oppry12102/WIFI7-TX/06_layout_design_notes/deckfix_备料报告_2026-10-18.md

# deck-fix 备料报告 — 我侧端子锚定同源 bug 修复 + 六判据审计台

**b7e7** · 2026-10-18 12:2x 本地 · 状态：备料完成，候 deck 修复版（备而不发）

## 一、deck bug 第四受害面实锤：我侧提取链端子锚定同源 bug（已修）

**诊断**（diag_terminal_anchor.py，31/31 全查）：
pex_extract.py 旧端子 attach 循环对**所有**端子按固定层序 (M2,M1,M3,M4,M5,TOPM1,TOPM2)
取第一个命中域——npn13G2 的 C/B pin 在 M1、E pin 在 M2，但循环 M2 优先：只要上覆金属
（E 回流条带/馈电塔）几何覆盖 C/B pin 块，C/B 就被抢进上层域 → b=e/c=b=e 粘连。
**实测修复前 15/31 粘连**（mix 8 / drv1 1 / drv2 6）——与 deck 的 31/31 b=e 同机制
（不按端子自身 pin 层归属，按「谁盖住锚点谁收」），属组长信 89 行 §三「同一机制」的第四受害面。

**修法**（已落 pex_extract.py）：端子按 pin 自身层固定挂域
`{C:M1, B:M1, E:M2, P1/P2:M1, TOP:TOPM1, BOT:M5}`，首选层未命中才回落跨层搜索并记 warn。
**修复后 13/31**（mix 8→8? 实为 mix 8、drv1 1、drv2 4→见下）——残留逐管证据
（diag_stuck_v2.py）：**全部落在在案三网异常域，非新伤**：
- mix 8 只：镜像区落 `gnd|nsens|ntaila` 65 域、gm dummy 落 `lond|lopd|nswa|rfon|rfop` 42 域
- drv1 1 只（参考管 $2）：`nref|gnd` 27 域（C=B=nref 二极管接法为意图，E=gnd 被并为伤）
- drv2 4 只：ccas1 五名域（v19 修复实证，裁定②不动）
- 另 3 只 nx=1/6 小管：**顶层板级 0.3µm M1 竖条真压过其 B/C/E 三条 M1 引脚带**
  （例：mix $2@(52,118)，重叠 0.4665/0.072/0.036µm²，桥孔 2×2 @(51.8~52.2,121.1)）
  ——这是**版图几何真连**候选，与 deck「修复后 b==e 仍在 = 版图真短 → 回改流程」的
  验尸判据直接相关：deck 修复重提后若这 3 只 b=e 仍在，即版图回改项（数量少、坐标已定位）。

## 二、六判据审计台建成（pex_cdl_audit.py，重提自检可对表）

判据①②③④⑤⑥全部机检：cdl 层查 ①b≠e ②R 零自环 ③WARNING 清零 ⑥端口序（逐字锚
v015.1）；+pex JSON 查 ③gnd 独立专项 ④被并没网回归（mix 8/drv1 2/drv2 4 名单内置）
⑤nref 溯源（nref 域须带 XBI*/nref 原名——实测 nref 域名单=`[XBI1/nref, gnd]`，改名可溯 ✓）。

**对当前 GDS 的演练结果**（deckfix_rehearsal/ 三件，未动在册）：
- ①：mix 6/15 b≠e（违例 Q5-Q10/Q15=ntaila 域呈现 + Q11/Q12=lond 域呈现）；
  drv1 2/4（Q3/Q4=nref|gnd 域呈现）；drv2 10/12（ccas 域呈现）
- ②：零自环 ✓（三件全过——粘连只在 Q）
- ③：mix 2 条 WARNING（在案）；drv1/drv2 0 条 ✓
- ④：三件全 FAIL=在案三网异常如实呈现（正是 deck 修复要消散的对象）
- ⑤：nref 溯源三件全 ✓
- ⑥：端口序三件全 ✓

## 三、deck 修复版到货后的我侧动作（顺序与耗时）

1. GDS 重提（8510 新 GDS×3 或×2）→ pex_extract 修复版全链复跑（~21s/件）
2. pex_cdl_audit 对表：①违例若仅剩 3 只板级 M1 竖条真压管 → 转版图回改流程；
   三网异常若消散 → ④PASS → 与你侧 LVS×v3 PASS 互为印证，双线闸门同闭
3. cdl 重出升版 + 层次1声明 v1.1 刷表（连裁定四 perim 一并随窗）→ 投 8510

## 五、修复副产物：R P2 端子孤域 = deck 修复版将暴露的新断路点（版图回改候选）

端子层序修复后 diff 三件 cdl：mix Q1-Q4 的 B 端子修回原理图真值名
（na1p/nb1p/nb2n/na2n——对照 `XQ1a nswa na1p e1a` 逐字吻合）、mix R1-R4 P2 修回
ntaila/ntailb ✓；**但 drv1/drv2 各 2 条 R 的 P2 显出无名孤域**（`R1 e1  rsil` 空网名）。
**本节已升全档（13:2x），详见《R_P2_断路根因与普查报告_2026-10-18.md》（同批投 8510）**：

- **根因**：emitpath 的 P2 引脚距公式 `y_p1+1.56` 只对 rppd 档成立；rsil 档 PCell
  实测 1.40 → stub 锚点高 0.16、悬在焊盘顶上方 **0.03µm**。gen 调用序先 chain 后
  mkres，PCell 真值从未回填（emitpath.py L200/L205）。
- **坐标/缝宽**：drv1 ±(14.15, y144.56 stub 底 / 144.53 盘顶)；drv2 ±(24.15, y172.56/172.53)。
- **原理图对照行**：`RRe1 e1 ntail 4` / `RRe2 e2 ntail 4`（drv1 LVS输入_v1）+
  `RRe1 e1 ntail 1.5` / `RRe2 e2 ntail 1.5`（drv2 v3）——P2 应 ntail，版图实际断。
- **普查结果**：三件全部 R 逐只对原理图——缺陷面=emitpath 公式锚定，**唯一受害=
  Re1/Re2 ×2 件共 4 条**；Rin/Rb/RL/mix 全部 R 物理连通（凡 mkres 真值画线的零缺陷）。
  ⚠ 连带发现：drv2 v3 原理图 `RRin1 inp XBI1/nref` / `RRin2 inn XBI2/nref` 两行是
  真短并域化石，v20 修真短后须回改 `inp 0`（v1 原稿正确）。
- **与 E 回流 0.085µm 缝**：同族不同根因（同为 emitpath 对 PCell 几何的预估偏差型
  断路；0.085=via 焊盘 enclose 认知差、**v19 已修**；0.03=P2 引脚距档位错、**未修进 v20**）。
- **DRC 归属**：0.03µm 缝=M1.b（5.16 space/notch 0.18µm）桶内成员，v14/v13 轮
  坐标逐位在案（DRC明细 L307/309/L378/380），已在备案残留。
- **旧 cdl `R1 e1 e1` 自环**=双错相抵：P2 真断 + M2 抢层把 P2 错挂 e1 的 M2 域。

**含义**：deck 幻影焊修复版重提后，LVS 侧也会看到这批 R 断路（如 deck 端子识别同样
修复）——届时「R 自环消散但出现悬空/分网 FAIL」是预期现象，属版图回改项，非修复版
回归。建议与 E 断路（0.085µm）一并进 place_emit_chain/电阻出脚的几何修复单。

## 六、件清单（本侧，未投 8510，候窗）

- `dryrun/pex/pex_extract.py` — 端子锚定修复版（TERM_LAYER）
- `dryrun/pex/pex_cdl_audit.py` — 六判据审计台
- `dryrun/pex/diag_terminal_anchor.py` / `diag_stuck_v2.py` / `diag_intra_bridge.py` — 诊断三件
- `dryrun/pex/deckfix_rehearsal/` — 演练件（cdl×3 + json×3；sha 与在册不同 =
  端子修复可见效应，属重提窗预期；在册 v1.0 三 sha 未动复核：33e9e754/ae4feb76/1f5e0cd8）
- 补充（§五）：drv1/drv2 的 R P2 断路 0.03µm 缝（各 2 条，坐标已定位）——**版图回改候选**，
  与 E 断路同族，候 deck 修复版重提后一并定谳

—— b7e7 · 2026-10-18
