oppry12102/WIFI7-TX/06_layout_design_notes/drv1_pwell接地tap回改纪要_v21_2026-10-19.md

# drv1 偏置支路 pwell 接地 tap 回改 · v2.1 出件纪要

**b7e7** · 2026-10-18 23:3xZ / 本地 07:3x · 响应 **裁定二十七 §三 交办第 ① 项**（组长 #206）
并**顺带结清**同件 §一② 交办的「顶层名随下一版改正」。

---

## 一、交办原文与我的兑现对照

| 组长要求（裁定二十七 §三） | 本件兑现 | 证据 |
|---|---|---|
| 在 **XQo / XQr 所在 pwell 岛内**放 `ptap1` | 两只，各一岛一只 | §三 落点表 |
| 以**金属通路**并入既有 gnd 干线 | M1 垫 → via_stack → M4 立管 → 同层压 gnd 干线 | §四 逐环取证 |
| **禁止**依赖 label 命名代替电学连接 | label 只作命名，接通靠金属；走线形态与 §7 的 E 脚下引**同款** | §四 |
| **禁区** `M1 (-39,121)-(39,136)` 不得落 tap | 两只 tap 距板下沿 **21µm**；且写成硬断言 | §五 断言④ |
| 随件给：**落点坐标** | `XQo (14.0,100.0)` / `XQr (42.0,100.0)` | §三 |
| 随件给：**gnd 接入的 via 链证据** | 三环逐环 bbox 实测 | §四 |
| 随件给：**DRC（M1.b/e、cont 密度）自检** | 间距本机可测项已测；cont 密度/tap 密度须代跑终裁（如实标注） | §六 |
| 随件给：**「每块每岛均有接地 tap」自检断言**（零断言即停线） | 5 条 × 2 岛 = 10 条断言，**已做断链测试证明有牙** | §五 |

§一② 另一条交办：「你的 v2 网表名滞后于你 v19 版图……**请把顶层名随下一版改正**」
⇒ 版图顶层 cell `V20 → V21`，网表 `.subckt/.ends` `V16 → V21`，两处逐字一致（§七）。

---

## 二、根因复述（为什么是「加 tap」而不是「改线」）

组长定谳的三块对照表里，**只有 drv1 的 `40/0 substrate_drw` = 0、`ptap1` 实例 = 0**：

| 块 | `40/0` | `ptap1` | 衬底 |
|---|---|---|---|
| mix v29 | 16 | 有 | 已接地 |
| drv2 v20 | 16 | 有（6） | 已接地 |
| **drv1 v20** | **0** | **0** | **XQo/XQr 岛浮空** |

`pwell_allowed = CHIP.not(pwell_block)` 被 `npn_exclude`（trans_drw / res_drw / salblock_drw…）
切成多岛，**每岛各自需要接地通路**。drv1 的四只 HBT + 九只电阻衬底端子同挂孤立网 `$1`
（E0 实测 8M/8X）。

**为什么 §7 的 E 脚下引救不了它**：§7 把 E 脚（M2）经 via_stack 拉到 M4 gnd 干线，
但那只是**金属**的接通；deck 的接地链是
`pwell ─connect(pwell,ptap)─ ptap=pactiv∩pwell ─cont_drw─ metal1_con─ M1`，
缺了 **ptap 接触**这一环，浮空岛照样浮空。Q2/Q3 所在岛之所以接地，靠的是 npn13G2
**PCell 自带**的 pwell/ptap 图形恰好与该岛连通；drv1 这两只管的岛没有这条路。

---

## 三、落点与选点依据

| 岛 | 器件 | tap 落点 | 到管身 | 到 ntail 禁区板 | 到最近异处 M1 |
|---|---|---|---|---|---|
| XQo | `XBI_XQo` Nx=8，管身 x∈[−7.45,+7.45] | **(14.0, 100.0)** | 出管身 6.55µm | 21.0µm | **16.649µm** |
| XQr | `XBI_XQr` Nx=1，管身 x∈[33.05,34.95] | **(42.0, 100.0)** | 出管身 7.05µm | 21.0µm | **9.553µm** |

选点三原则（逐条对真值核过，非拍脑袋）：

1. **禁区零距离** — y=100 距 ntail 汇集板下沿 121 有 21µm。
   E3 实测 ptap 落 (−39.5,127.6) ⇒ `gnd–ntail` 短路，本件不重蹈。
2. **不落 HBT 排除区、且同属该 pwell 岛** — y∈[86,126] 带内我逐层点过
   （顶层自画 M1/M2/M3/M4/M5 + 全部嵌套实例）：x∈[8,20] 与 x∈[36,48] 两块**全空**，
   且其间无任何 `npn_exclude` 图形。两点都落在两只管**同一片 pwell** 内，
   一只 tap 即足以把该岛接出去；放两只是为了对冲「万一被切成两岛」。
3. **柱下中空层无异网** — 走 `cross()` 的 **M1→M4 单 via_stack**，焊盘只在两端层，
   M2/M3 不留盘。nref 的 M3 立管在 x=0 与 x=34，本件落点 x=14/42 远在两处之外。

---

## 四、gnd 接入的 via 链证据（逐环 bbox 实测，非声明）

deck 的接地链一环不缺：

```
pwell ──[ptap1 PCell: 1/0 Activ + 14/0 pSD + 4×6/0 cont + 40/0 substrate_drw]──
      ──cont_drw↔metal1_con── 8/0 M1 垫 ──via_stack── M4 立管 ──同层相接── M4 gnd 干线
```

本机实测（仿真层逐环 dump）：

| 环 | XQo 岛 | XQr 岛 |
|---|---|---|
| ① M1 接地垫 | `DBox(13.600, 99.600, 14.400, 100.400)` | `DBox(41.600, 99.600, 42.400, 100.400)` |
| ② via_stack 实例 | `DTrans(d=(14,100))` ✓ 在图 | `DTrans(d=(42,100))` ✓ 在图 |
| ③ M4 立管 | `DBox(13.850, 82.000, 14.150, 100.000)` | `DBox(41.850, 82.000, 42.150, 100.000)` |
| ④ 与干线相接 | 干线 `DBox(−56,80,56,84)`，立管 y=82 起 ⇒ **重叠 2µm** | 同左 |
| ⑤ 网名标注 | M4 `labels(8/25)` = `gnd` | 同左 |

> **环① 的形状说明**：本机仿真层不建 `ptap1` PCell（塞假体会污染间距判定），
> 故我在**仅仿真层**补了 0.80µm 见方的 M1 替身，好让自检台第⑳项能验完整条链。
> **真跑不进 GDS** —— 真几何由 ptap1 自带的 `8/0 M1 tie` 承担（那才是 PDK 的正规图形）。
> 代码里以 `_SIM_ONLY_TIE` + `PTAP_SKIPPED` 一行 NOTES 明示，不靠注释暗示。

---

## 五、自检断言「每块每岛均有接地 tap」（交办：零断言即停线）

本机跑不了 deck 的 pwell 连通域分析，所以断言**不落在「连通域」这种跑不动的判据上**，
而落在五条**可证伪的几何事实上**。任一条为假即 `AssertionError` 停线：

| # | 断言 | 判据 |
|---|---|---|
| ① | tap 在「能下引到 gnd 干线、又没进禁区」的区间里 | `−56 ≤ x ≤ 56`（干线跨度） ∧ `GND_Y ≤ y ≤ NT_Y0` |
| ② | tap 处**有 M1 接地垫** | 顶层 M1 形状命中 `(x,y)` |
| ③ | tap 处**有 via_stack 实例** | 实例原点逐位命中 `(x,y)` |
| ④ | tap 处**有 M4 立管**，且立管**真压** gnd 干线 | 两条独立 bbox 命中判定 |
| ⑤ | **禁区内零 tap** | 不落 `M1(−39,121)-(39,136)` |

**有牙验证**（在临时副本上做故意破坏，断言逐条当场抓住）：

| 破坏动作 | 断言反应 |
|---|---|
| `XQr` 的 y 改 100 → **125**（落进禁区） | `AssertionError: TAP-ASSERT ①：XQr 的 tap y=125.0 不在 (GND_Y=82.0, NT_Y0=121.0) 下引区间内` |
| `XQr` 的 x 改 42 → **100**（超出干线跨度） | `AssertionError: TAP-ASSERT ①：XQr 的 tap x=100.0 在 gnd 干线跨度 [-56,56] 之外` |
| 删掉 `b.wire_v(GND_LAYER, …)`（接地链断在第三环） | `AssertionError: TAP-ASSERT ③：XQo 的 tap (14.0,100.0) 处没有 M4 立管金属` |

断言取图助手（`_inst_origins` / `_iter_shapes`）**仿真层与真 KLayout 双通**
（仿真层 `Trans.dx/dy` vs 真 KLayout `DTrans.x/y` 都取）——
写死仿真层 API 会让组长的真 KLayout 代跑当场 `AttributeError` 停线。

---

## 六、DRC 自检：本机能测的与不能测的（如实分开）

**本机已测（全绿）**：

- **M1 间距**：两只 tap 落点处**只有自垫一块 M1**，到最近异处 M1 净距
  **16.649µm / 9.553µm**，对 PDK `M1.b 0.18` / `M1.e 0.22` 与我自设保守 0.63 都有
  **两个数量级余量**。
- **M4 立管**：与既有 E 脚下引同款（W=0.30 竖线），同层无异网；中空层 M2/M3 该处无金属。
- **自检台全 21 项**：`check_layout_gen(gen_M3_drv1_v21.py)` → **ok=true，issues=[]**。
- **网名闭合**：版图 13 / 网表 13，幽灵名 0、漏标 0 —— 加 tap **未新增任何网名**。
- **净距/带金属**：⑮ 两两最小边缘净距 2.80µm；㉒ 余量 +16.17µm；㉓ 异网 6 处中
  疑似 DRC 违规 **0** —— 与 v20 **逐位相同**。

**本机测不了、须代跑终裁的**（与 mix v27 / drv2 v18 同款，本机无 PDK）：

- `cont_drw` **密度**（两只 tap 各 4 个 cont）；
- `psd` **间距**条款（ptap 的 Activ/pSD 对邻图形）；
- ptap1 PDK 默认参数自身的合规性（drv2 v18 代跑已终裁「全绿」，同款参数）。

---

## 七、顶层名对齐（裁定二十七 §一② 交办）

| | 原 | 现 |
|---|---|---|
| 版图顶层 cell | `TX5G_M3_DRV1_V20` | **`TX5G_M3_DRV1_V21`** |
| 网表 `.subckt` / `.ends` | `TX5G_M3_DRV1_V16` | **`TX5G_M3_DRV1_V21`** |

网表 `drv1_subckt_LVS输入_v3.sp` 相对 v2 **正文仅 2 行改动**（`.subckt` / `.ends`），
拓扑与 D1–D4 形态逐字零改动。形态体检：
`lvs_source_audit(audit=v3)` → **ok，issues 0**（R9/Q4）；
`pair(v2,v3)` **拓扑等价断言 PASS**；`check_netlist_dc` → **ok**。

---

## 八、v20 → v21 变更清单（逐位，便于你 gdsdiff 对拍）

| 项 | v20 | v21 |
|---|---|---|
| `ptap1` PCell 实例 | 0 | **+2**（(14,100) / (42,100)；真跑才落） |
| via_stack 实例 | 19 | **21**（+2，M1→M4） |
| M4 矩形 | — | **+2** 立管（0.30 宽） |
| 顶层 M1 标注 | 32 | **34**（+2 个 M4 `gnd`） |
| 顶层 cell 名 | `…_V20` | **`…_V21`** |
| 其余全部几何 | — | **零改动** |

自检台输出逐行对拍：⑮ / ㉒ / ㉓ / 网名闭合 / 引脚极性 / 过孔短路嫌疑
**与 v20 逐位一致**，唯一 delta 就是上表这 5 行。

---

## 九、请你代跑时**先看这一条**（本件唯一的真实未知）

**`ptap1` 的 `8/0 M1 tie` 是否以实例原点为中心。**

我的 via_stack 打在实例原点上，依据是 mix v27 / drv2 v18 的既成用法 ——
两件都把 tap 中心摆在**自己画的 M1 圈中心线**上，注释明写「中心线正落 M1 圈上」，
说明 tie 就在原点。若真 PDK 的 tie 带偏移，代跑会出现「via 底端 M1 档无金属」，
**一眼可见**，改落点即可（§五 断言②③ 就是为这条准备的）。

**LVS 预期**：E0 的 8M/8X 应收敛 —— `Q$1/Q$4`（= XQo/XQr）衬底由 `$1` 变 `gnd`，
九只电阻的衬底端子随之并入 gnd。**若仍出 `gnd$1`，就是 tap 没真正落在浮空岛内**
（而非命名问题），请把 dump 的 MK 层给我，我按岛重选落点。

**另请注意（我方主动提示，非你交办）**：在飞的 27 角提取若用的是 drv1 **v20** 的 GDS，
则**不含**本次 tap 的接地效果；加 tap 会改变衬底网提取结果，
`pex_drv1_v2x.cdl` 需要按新 GDS 重提。这是回改的固有代价，不是回归。

---

## 十、件与 sha

| 件 | sha256 | 说明 |
|---|---|---|
| `gen_M3_drv1_v21.py` | `0b0eb034174a99865077c58597f65366926bab1057d690bb76fc026e0afe6b95` | 1153 行（v20 1015 行） |
| `drv1_subckt_LVS输入_v3.sp` | `44a7615c5928122b836ada3deeff4ddaadf5c4e20f9003e53681baf1e475973d` | 正文仅 2 行改动 |
| `gen_M3_drv1_v20.py` | `7f978a29c4d0ad456df1d149685e7868a55a9fb392b86268e27aa69bc81fb33e` | 旧件，仅作 gdsdiff 基准 |
