oppry12102/WIFI7-TX/06_layout_design_notes/drv2_sch_v4_证据三件套_2026-10-18.md

# drv2 sch v4 随件证据三件套（裁定十六 ③④）· b7e7 · 2026-10-18

**裁定十六执行件**：`drv2_subckt_LVS输入_v4.sp`（486f6558，已随 v20 gen 三件同批投 8510）。
时机说明：裁定十六 ② 说「v20 GDS 到货同批出 v4」——本件与 v20 gen **同批先走**（GDS 待你侧
代跑），LVS 标准输入对「v20 GDS + v4 sch」在 GDS 到货后即成立，不违时机本意。

## ① v1→v3 两行演化对照（证化石非新意图）

| 版本 | RRin1 | RRin2 | 依据 |
|---|---|---|---|
| v1（2026-10-17 午） | `Rin1 inp 0 1k` | `Rin2 inn 0 1k` | 源锚 chain_top_tb_v015_1.sp 行 242-243 逐字（`Rin1 inp 0 1k $ v015[2]`）|
| v2 | `inp 0`（未动） | `inn 0`（未动） | v2 行 27/28 = `RRin1 inp 0` / `RRin2 inn 0` **实存** |
| v3（正式件化） | `inp XBI1/nref` | `inn XBI2/nref` | v3 头 §变更2「版图真值，照 v2 §2 nref 独立网口径」——**把并域呈现当版图真值烙进原理图，即化石点** |
| v4（本件） | `inp 0` | `inn 0` | 回 v1 原稿口径；裁定十六 ② 批准 |

演化链自证：v2 行 27/28 在案（`inp 0`/`inn 0`），v3 才改成 nref——**改动方向是 v1→v3，
不是 v1 原意**；v4 = 恢复 v1。

## ② v3 全量并域化石普查（涉并域名呈现行全列）

v3 全部含 `/` 并域名形态（`XBI<k>/nref`）的器件行 14 行，逐行定性：

| 行 | 内容 | 定性 |
|---|---|---|
| **38** | `RRin1 inp XBI1/nref` | **化石**（Rin.P2 版图真值=gnd 轨，nref 是真短并域呈现；v20 修真短后二网分离）|
| **39** | `RRin2 inn XBI2/nref` | **化石**（同上）|
| 56/59/62/65 | `QXBIk_XQr XBIk/nref XBIk/nref 0 0` | 合法（XQr C=B 二极管接法，原理图网本来就是 nref，与真短无关——真短是它**多连到了 gnd**，修真短不改变原理图）|
| 57/60/63/66 | `QXBIk_XQo ntail XBIk/nref 0 0` | 合法（XQo.B=nref 镜像管本意）|
| 58/61/64/67 | `RXBIk_Rref vcc XBIk/nref` | 合法（Rref.P2=nref 本意）|

**结论：化石恰为 2 行（38/39），与裁定十六预期「仅此两行」一致**；其余 12 行的 nref 是
镜像组原理图本意，不动。全文再无其他并域形态网名（`gnd|xx`、`ntail|xx` 之类 v3 本就没有）。

## ③ 电路意图注记（Rin 端接 = gnd 依据）

`Rin1 inp 0 / Rin2 inn 0`：源锚 `design/chain_top_tb_v015_1.sp` 行 242-243
`Rin1 inp 0 1k  $ v015[2]: 50->1k (M1 实测锚; 隐藏 DC 负载 50mA->2.5mA)`——spec v015[2]
明文输入端接 1k 到 **0**（gnd），1k 即 SOW 的 M1 实测锚链级 +8.1dB 那条；版图侧 gen §8
「inp/inn → gnd」同口径。v4 恢复的正是这条 spec 意图，未引入任何新语义。

## ④ drv1 侧核对声明（裁定十六 ④）

`drv1_subckt_LVS输入_v1.sp` 行 25-26 现值 = `RRin1 inp 0 1000 rhigh l=1.000u w=1.360u` /
`RRin2 inn 0 1000 …`——**v1 已是 inp/inn 0**，声明即毕，无需修。

## ⑤ 附：收敛纲领一处精化建议（v2.0 实操所得）

裁定十六纲领「①一律 pin 真值锚定（**mkpc_at 返回值**，禁公式预估）」——方向完全正确，
但实操发现 **mkpc_at 的 P2 返回值本身就是公式锚点**（resgeom 真值表 §2 拟合式
0.72+0.84·l），它不是焊盘：rsil l=1 时锚点比盘顶高 0.03µm（Re 断路死法）、l=4.2857 时
在盘下方 0.236µm（ntaila 断路死法）。v2.0 的锚定对象是**焊盘真值**
（`resgeom.res_pad2(model,l)`，锚相对系，pex 五点逐位验证）——即纲领①的「真值」落到
焊盘层而非引脚标记层。建议纲领①精化为：「一律**焊盘真值**锚定（resgeom.RES_PAD*，
禁公式预估、禁引脚标记盒）」；M4 设计输入收录时用精化版。盘真值表全文见
`v20回改执行报告_2026-10-18.md` §四。

## ⑥ v20 判读预期对接（裁定十六 + DRC 增列）

- DRC M1.b 桶 **−4**（drv1 ±14.15,144.56 / drv2 ±24.15,172.56 四条 0.03µm 缝随 R P2
  出脚缝合）——对拍时按你侧增列核销 ✓。
- sim 侧预期修复项全收：Rin.P2 网名 nref→gnd 归位、Re P2 接 ntail、真短 8 案断开、
  **另加**：ccas↔nbcas/e 断开（N1/N2）、rfop↔lopd/lond 断开（N3）、Re1a/Re2a.P2 接
  ntaila（N4）——pex 五名域若仍现 = 对应 N 项未生效信号。

—— b7e7 · 2026-10-18
