oppry12102/WIFI7-TX/06_layout_design_notes/drv2_子电路对拍报告_2026-10-17.md

# drv2 子电路网表抽取 · LVS 配套 · 对拍报告 · 2026-10-17

**抽取人**：b7e7 · 对应组长 Q12 闭环信「LVS 配套（候你 drv2 子电路网表抽取）」+ Q11 纪要裁定③（LVS 候办）

## 交付件

| 件 | 说明 |
|---|---|
| `design/sow6/drv2_subckt_LVS输入_v1.sp`（2708B sha d221226f3fd804ec） | `.subckt hbt_mirror` + `.subckt drv2` 两段**逐字拷贝**自 chain_top_tb_v015_1.sp（sha 16 前缀见件头锚注），零改动、零删注 |

## 三层对拍（schematic 抽取件 ↔ gen_M3_drv2_v17.py 的 DEV_NETS/NET_DECL）

**全 PASS**：

1. **器件逐只**：12 HBT（XQ1~4 nx=10 + XBI1~4 展开 XQr nx=1/XQo nx=8）+ 12 R（8 顶层 + 4 Rref rr=1.62k）+ 4 C（Cin1/2 10p + Ct1/2 1.2p）+ 2 L（Lt1/2 0.7n）——两侧一致。
2. **引脚↔网名逐条**：HBT 按 C/B/E、两针按 P1/P2，逐只一致；版图 `gnd` ↔ schematic `0` 映射已计。
3. **网连通性逐网**：NET_DECL 全 15 网（outp/outn/ccas1/ccas2/bin/bb1/e1/e2/ntail/XBIk__nref×4/vcc/nbias/nbcas/inp/inn/gnd）与 schematic 网成员集合逐一相等。

## 边界注记（LVS 跑前须知）

- **独立源 Vb(nbias 0 1.25V) / Vbcas(nbcas 0 2.05V)**：版图不画（理想偏置源非器件），LVS deck 口径应忽略；忽略后 `nbias`/`nbcas` 网两侧成员一致（Rb1/Rb2 P2；XQ3/XQ4 B）。
- **hbt_mirror 参数**：XBI1~4 调用未传参 → 缺省 nx=8 rr=1.62k（与 DEV_NETS 展开口径一致）。
- **vcc 网预查（裁定①口径）**：vcc 网两侧成员一致 = RL1/RL2 P1 + XBI1~4_Rref P1 + Lt1/Lt2 p1 共 8 引脚 + 端口。**无任何 M5 馈电桶（via_stack17）残留引用**——桶本就从未在网表/DEV_NETS 注册（版图自愿冗余非器件），v17 撤除即净，版图侧悬空 0（㉑）与 gdsdiff 唯一 delta=桶消失已证。
- **自检**：抽取件经 check_netlist_dc（借临时 tb `.include` + X1 实例化）DC 拓扑静态自检 **fail=0**。

## 与 fde9 PEX 双门的衔接

CG 锚 `+17.4465 dB` 对应 v015.1 仿真基线 = 本抽取件同源网表跑出（chain_top_tb_v015_1.sp 未因桶撤改动——桶不在网表）。PEX 后双门（A0′≤1e-5 + |CG−17.4465|≤0.05）可比性成立。

—— b7e7 · 2026-10-17
