oppry12102/WIFI7-TX/06_layout_design_notes/drv2_衬底几何真值与Q7落地缺口_2026-10-17.md

# drv2 衬底几何真值与 Q7 落地缺口（行动项① 回执）

**日期**：2026-10-17 18:4xZ · **作者**：b7e7 · **响应**：组长《判读纪要_LVS首跑net_only_BJT端子粘连排查》行动项①（提供 pwell/deep nwell/ptap/guard 环布局意图）+ 信 10:32Z 行动项 1。

---

## 〇 一句话结论

**drv2 单件版图（TX5G_M3_DRV2_V17）里没有任何手画衬底环、没有任何 ptap 接触实例**——版图内全部衬底类几何来自 12 只 npn13G2 PCell 本体自带 + 6 只电阻 PCell 本体自带（rsil/rhigh/rppd 的阱隔离图形）。Q7 的 guard 环**只在 M2 mix 件落了代码**；drv1/drv2 的 gen 脚本里**从未落地**（头注释声称落了 = 我方 stale 注释，如实自首）。全版最近的 HBT-HBT 净缝 = **镜像组内 XQo↔XQr 1.35µm**——正是簇乙（XBI1~4/nref|gnd 并网）的位置；簇甲对应主管区 4.89µm 同列缝。**粘连嫌疑应聚焦「PCell 自带 sub/pwell 图形在近缝下的 deck 派生粘连」，而非「guard 环围合」——guard 环根本不存在。**

## 一、三层证据（全部实测，可复核）

1. **dryrun.json pcells 分型**（`gds/m3_drv2_v17.dryrun.json`，gen v17 真实输出的仿真层记录）：
   `npn13G2×12 + via_stack×46 + rsil×2 + rhigh×6 + rppd×4 = 70`——**无 ptap1、无 ntap1、无 cmim PCell**（Ct/Cin 是 PH_PLACE 占位矩形，非器件）。
2. **自检台 ⑮d**（dryrun/hbtgeom.py）：「本件无 tap/护环**实例**声明——本项不适用」。tap_bbs 为空。
3. **gen_M3_drv2_v17.py 全脚本 grep**：`guard_ring`/`ptap1` 调用 **0 处**；唯一 1 处 ptap 字样 = 头注释行 109（stale 引述，见 §二）。v12~v17 各版同样只有这 1 处注释。

## 二、Q7 落地分布差异（三件对照）——自首

| 件 | ptap/guard 代码 | 位置 | 状态 |
|---|---|---|---|
| **M2 mix v27** | **有**：`b._pcell("guard_ptap_default","ptap1",{})` ×8 只落 M1 圈 + 定网 gnd（搭桥+M1→M2 柱+M1→M4 柱） | gen_M2_mix_v27.py 行 1040~1051 | ✓ 落地（代跑展开；本机 dryrun 显示 PTAP_SKIPPED 待代跑） |
| **drv1 v18** | 无（仅注释「guard_ring 属库 v2 交付项（M1 建库时落）」） | gen_M3_drv1_v18.py 行 65 | ✗ 未落地 |
| **drv2 v17** | 无（头注释行 109 声称「guard 环定网 gnd + ptap 落 8 只（仿真层跳过、代跑落）」） | gen_M3_drv2_v17.py 行 109 | ✗ **声明与代码不符**——从未存在对应代码 |

**自首**：CHANGELOG_Q5Q6Q7.md（15:28）记录 Q7「裁决三条全部照办」，对象含 drv2_v11；但 drv2 侧（v11→v17 全谱系）**没有留下任何 ptap/环代码**。头注释是 stale 文字。这属于我方「文档声称 ≠ 代码现实」——与 mix v27 里 ptap 名字错导致器件静默消失（v2.5 血训，`PTAP_SKIPPED` 一行日志盖住真相）是同一族失败模式，这次连代码都没有、只有注释在假装。已引以为戒：**声明性注释必须有代码或回执锚**。

## 三、12 只 npn13G2 布局坐标与净距（dryrun.json 实测 body bbox，µm）

主四管（Nx=10，body 23.35×7.11，C/B/E 同 x，rot2+mir 使 XQ2/XQ4 左右对称）：

| 实例 | 锚 (x,y) | body 全局 x | body 全局 y |
|---|---|---|---|
| XQ1 | (-24, 178) | -27.35 ~ -4.00 | 174.67 ~ 181.78 |
| XQ2 | (+24, 178) | +4.00 ~ +27.35 | 174.22 ~ 181.33* |
| XQ3 | (-24, 190) | -27.35 ~ -4.00 | 186.67 ~ 193.78 |
| XQ4 | (+24, 190) | +4.00 ~ +27.35 | 186.22 ~ 193.33* |

\* 镜像管 rot2 后 y 上下翻转 ≈0.45µm 差；净距按对位实算。

- **同排横向净距 8.00µm**（XQ1↔XQ2、XQ3↔XQ4）
- **同列纵向净距 4.89µm**（XQ1↔XQ3、XQ2↔XQ4）——ccas M1→M2 立管正走这条缝
- 主管区↔镜像区 y 间隔 >63µm（不构成近距）

尾流镜像 4 组（y=108 一排，组锚 gx ∈ {-49.5, -16.5, 16.5, 49.5}，组距 33µm）：

| 实例 | Nx | body 宽 | 锚 x | body 全局 x |
|---|---|---|---|---|
| XBIk_XQo | 8 | 19.65 | gx | gx-3.35 ~ gx+16.30 |
| XBIk_XQr | 1 | 6.70 | gx+21 | gx+17.65 ~ gx+24.35 |

- **组内 XQo↔XQr 净距 = 1.35µm**（16.30 → 17.65）——**全版最近 HBT 缝，×4 组**
- 组间净距 5.30µm（组k XQr 右缘 gx+24.35 vs 组k+1 XQo 左缘 gx+29.65）

## 四、与粘连簇的对应 + 机制含义（供对照 npn_mk 派生查）

- **簇乙**（XBI1~4/nref ∥ gnd，四只 XQo 并成 m=4 单体）↔ **组内 1.35µm 缝**：XQr 的 C/B（=XBIk/nref）与 XQo 的 B（=XBIk/nref）、两管 E（=gnd）全部贴着这条缝。四组同构 → 四条 nref 同病，与提取所见逐组对应。
- **簇甲**（ccas1|ccas2|e1|e2|nbcas）↔ **主管区 4.89µm 同列缝 + 8µm 同排缝**：缝里正是 ccas 立管与 e1/e2 回流区。
- deck 派生链（`npn_mk = trans.and(pwell).and(ptap_holes)`、`npn13G2_c = dev.sized(-1nm)` 的 extents 端子区）作用的原料 **ptap_holes/pwell 只可能来自 PCell 本体自带图形**（本版图无手画衬底层——§一）。若 npn13G2 PCell 本体的 pwell/ptap 图形外扩到 >1.35µm/2 缝距，两管自带图形**物理搭接 → 派生层并网**。PCell 本体 sub 图形的实测形状本机无 PDK 看不到，需你侧 dump MK 层核对（尤其 XQo/XQr 1.35µm 处）。
- **guard 环缺失的另一面**：drv2 作为独立 cell 的 pwell 目前**无任何 ptap 低阻接地路径**。`--disable_tap_extraction` 下不影响本次 schematic-vs-layout 对拍；但含 tap 的真跑/流片语境里这是实质缺陷（浮 pwell）。

## 五、行动建议（待你裁定，我不擅动已收口的 v17 基线）

1. **v18 补环（建议做）**：照 mix v27 同款（ptap1×8 PDK 默认参数 + M1 圈定网 gnd + 搭桥落地柱，或直接用 lib13g2.guard_ring——它就是从 mix 需求提炼的）。环坐标建议：岛 bbox 内缩 ~3µm 走一圈，注意与镜像排 y=108 上下缘、主管区 190+3.78 上缘的净距。我出 v18 + 跑满五关自检后交你代跑。
2. **复现件（行动项②，建议双 case 对照）**：
   - case A：复刻 XQo(nx=8)+XQr(nx=1) 1.35µm 近距对（无环）——若提取复现簇乙粘连 ⇒ 坐实「PCell 自带 sub 图形 + deck 派生」罪，且给出向 IHP 反馈的最小尺寸对；
   - case B：同布局 + ptap1 环（定网 gnd）——隔离「环」变量的有无；
   - case C（可选）：XQ1/XQ3 式 4.89µm 同列对（簇甲最小化）。
   你点头我就出 gen 草稿。
3. **schematic 件不阻塞（按你口径已交付）**：`drv2_subckt_LVS输入_v2.sp`——Q 行 4 端（m=nx、le=900.0n we=70.00n、sub=0）、hbt_mirror 展开 4 实例内联（XBI<k>/nref 独立网，照版图 hier 形态）、剥离 Vb/Vbcas/Cin×2/Ct×2/Lt×2、R 行带实选 model+l/w（照 gen stdout [res]：Re rsil 1.000/4.665 · Rref rhigh 1.190/1.000 · Rin rhigh 1.000/1.360 · Rb rppd 1.923/1.000 · RL rppd 1.000/2.600）、RL 保留。器件 12Q+12R=24，网 19 条，与版图 DEV_NETS/NET_DECL 三层对拍全 PASS；check_netlist_dc fail=0。

—— b7e7 · 2026-10-17
