oppry12102/WIFI7-TX/06_layout_design_notes/M3_drv级版图设计稿_v1.5_2026-10-17.md

# M3-a/M3-b drv 级版图设计稿 v1.4

**日期**：2026-10-17 · **作者**：b7e7 · **脚本**：`gen_M3_drv1_v16.py`（drv1）+ `gen_M3_drv2_v15.py`（drv2）
**状态**：自检台 **20 项 + 库版本闸 全 PASS**，待组长代跑 GDS + DRC/LVS
**作废**：v1.0 ~ v1.3（v1.3 → v1.4 = Q10 轮的 T 交外延 / Slt 真开槽 / 占位落地）

---

## 0. 一句话

v1.1 只改了一行：`bb1` 的 M5 底段横线原来画到 `ch=24`，而回流竖管在 `x=50` ——
**差 8µm 没接上**，bb1 在版图上断成两截。岛尺寸、发射极回流核算、
器件数、阻值全部未变。

---

## 1. 勘误：bb1 断线

```python
# v1.1
b.wire_h(BIAS_LAYER, y_lo, min(px, ch), max(px, ch))   # y_lo=-2, px=42, ch=24
...
b.wire_v(BIAS_LAYER, 50.0, y_hi, y_lo)                 # 竖管在 x=50
```

几何结果（`inspect.py --shapes=M5` 实测 v1.1）：

```
x[ +24.00, +42.00] y[  -2.15,  -1.85] ['未标注']   ← 死头段（Rb2.P1 → x=24 就断了）
x[ +49.85, +50.15] y[  -2.00, +110.00] ['bb1']     ← 竖管在这一半
```

`bb1` 断成两截：`Rb2.P1 → 一条死头横线` 与 `x=50 竖管 → XQ2.B`。
**LVS 必失配**（一条网拆成两条）。

**为什么 v1.1 的 11 项自检没看见**：

- ⑤b「同名分裂」只数**带标注**的连通分量 —— `'bb1'` 只标了一处（M5 立管上 + B 脚上，
  都在连通的那一半），另一截**无标注**，于是断线隐形；
- ⑤c/⑤d 判的是短路，不管断线；
- ⑦「引脚↔网名」比的是 `DEV_NETS` **声明**，不验版图实际接到哪只脚。

## 2. v1.2 的改法

把该横段的终点改成**真正接得上竖管的那个 x**：

```python
land_x = ch if y_hi is None else 50.0
b.wire_h(BIAS_LAYER, y_lo, min(px, land_x), max(px, land_x))
```

- `bin`（`y_hi is None`）落点仍是 `ch=−24`，一根立管直通 B 脚 —— 行为不变；
- `bb1` 落点改成 `50.0`，与 `wire_v(50.0, y_hi, y_lo)` 的竖管同 x，接上。

复核：v1.2 的 M5 成员全部落在 `bb1` 一个连通分量内（含 x=42 的柱头焊盘）。
bin 路径不受影响（M5 y=4 的横段在 x≤35，bb1 的 y=−2 横段在 x∈[42,50]，两条不交叉）。

## 3. 为什么是新加的第 ⑫ 项抓到的

自检台新增「⑫ 引脚极性（几何取证）」：拿 PCell 真实引脚坐标 + 过孔感知连通分量，
验「网表给这个脚的网名」是否真在这一脚的连通分量上。它对本件报：

```
[FAIL] 引脚极性 Rb2.P1@42.00,8.00：网表该脚是 bb1，版图该脚所在连通分量上是「无标注」
```

即 `Rb2.P1` 那一侧的连通分量上根本没有 `bb1` 这个名字 → 断线。
同一条注入已进 `teeth_v11.py`（注入 8 那条同族的 Rd 接反，以及 drv1 自身的两条）。

## 4. 未变的部分（复核过）

| 项 | v1.1 | v1.2 |
|---|---|---|
| 岛尺寸 | 130.0 × 224.3 µm | **同** |
| 发射极回流核算 | 196.1 mΩ ≤ 250 mΩ | **同**（`emitpath.py` 逐位相同）|
| 器件 / 标注 | 32 / 32 | **同** |
| netname 口径 | `xbi/nref`（NESTED_STYLE=hier） | **同** |
| 占位标注 | 只进 NOTES | **同** |

## 5. 仍未解决（与 v1.1 相同，等回执）

cmim PCell 名/参数（4 只耦合电容占位）、`via_stack` 跨厚金属组合口径、
镜像语义判别、`NESTED_STYLE` 分隔符（`/` vs `.`）、Rsheet 真值。

---

## 附：Q5 修订（2026-10-17，据组长 reply_v12）

> 与上文冲突处以本节为准；理由见 `CHANGELOG_2026-10-17_Q5Q6Q7.md`。

按 cornerRES 三档真值取 typ（rsil 6.02/**7**/7.98 · rppd 234/**260**/286 ·
rhigh 1160/**1360**/1560 Ω/□），并启用自动选型（面积最小、l/w ≥1µm）：

| 器件 | 阻值 | 旧几何(15Ω/□) | 新几何 | 型号 |
|---|---|---|---|---|
| Re1/Re2 | 4Ω(drv1)/1.5Ω(drv2) | l=1 w=3.75 / w=10 | l=1 w=1.75 / w=4.667 | rsil |
| Rin1/Rin2 | 1k | l=66.7 w=1 | l=1 w=1.36 | **rhigh** |
| Rb1/Rb2 | 1k(drv1)/500Ω(drv2) | l=66.7 / l=33.3 w=1 | l=1 w=1.36 / l=1.923 w=1 | rhigh / **rppd** |
| RL1/RL2 | 100Ω | l=6.667 w=1 | l=1 w=2.6 | **rppd** |
| XBI_Rref | 1620Ω | l=108 w=1 | l=1.191 w=1 | rhigh |

**1kΩ 从 66.7µm 长条缩到 1.36µm**。金属方阻改 techlef 真值后，
drv2 发射极回流合计 163.3 → **109.6 mΩ**（200 mΩ 档，余量 1.22×→1.82×）；
drv1 合计 201.1 mΩ（250 mΩ 档）✓。

连带修掉两处几何 bug：
1. **输出轨与 RL 引脚脱钩** —— 100Ω 换型后 P1→P2 间距 6.32→1.56µm，
   老常数 `Y_CP−6.32` 让轨从引脚上方 4.76µm 掠过（LVS 悬空）。
   改法：间距由 `res_auto` 真 l 现算 + `assert` 钉死 P2 落在轨上。
2. **drv2 bin 引线碾过 nbias 的 P2 焊盘** —— Rb 缩到 l=1.92µm 后 P1→P2 只差
   2.34µm，从 P1 竖上去的 M1 引线从 P2 焊盘正上方穿过 → bin/nbias 真短
   （仿真层不画电阻 M1 焊盘，看不见，只有真 DRC 才炸）。
   改法：P1 处先横插到专属竖列（35→31.5、42→38.5）再竖上去落柱。
   并为此新增自检项 ⑬b「穿顶判据」，反向注入验证有牙。

---

## 追加（2026-10-17 07:5xZ）· Slt.c.M1 开槽方案（纪要 §4.2 真几何族最后一条）

**问题**：`Slt.c.M1` = 「M1 无开槽最大宽度 30µm」。drv2 的 ntail 汇流轨是一块
150 × 32.3µm 的 M1 大平面（x∈[−62,88]，y∈[117.7,150]），最窄边 32.3µm > 30µm → 违规。

**口径澄清**：组长纪要把它记成「150µm 宽」。DRC 里 `width` 取 bbox 的**最窄边**，
所以真正超限的是 32.3µm 那一侧。这一点在投信里一并问了（若 deck 实为「任一边 >
30 即违规」，则本方案还须沿 x 再切，请裁定）。

**方案**：**两条 16.15µm 的轨 + 右端 5µm 搭桥**（净槽宽 2.3µm）

| 件 | 形状 | 最窄边 | 判据 |
|---|---|---|---|
| 下轨 | x∈[−62,88], y∈[115.4,131.55] | 16.15 | <30 ✓ |
| 上轨 | x∈[−62,88], y∈[133.85,150] | 16.15 | <30 ✓ |
| 搭桥 | x∈[83,88], y∈[131.55,133.85] | 2.3 | <30 ✓ |

- **EM 一步不减**：2 × 16.15 = 32.3µm = 原 W_NT。ntail 29.28mA @ M1 的 1mA/µm
  ⇒ 仍 0.976 mA/µm（与开槽前同值，未拿 EM 换 DRC）。
- **为什么必须有搭桥**：槽横切一刀，平面断成两片 ⇒ 版图上 ntail 变成两个连通分量，
  LVS 判该网多段（自检台第 ⑤b 项「同名分裂」当场报）。搭桥在**右端 5µm**，
  远离左端的 Rin（x=−46/−39）与右侧的 Rb（x=35/42）的引脚列。
- **对上下行的影响**：镜像组 XQo.C 从下方 y≈109 上来、Re1/Re2.P2 从上方 y=172.56 下来，
  两者原本分别落在平面**下边**与**上边** —— 开槽后这两条接触路径**一字未改**
  （下轨下边仍在 115.4、上轨上边仍在 150）。整体下移 2.3µm 是槽宽的代价。
- **待代跑校准**：槽自身的最小宽/最小间距规则本机查不到（无 PDK）。2.3µm 是按
  「> M1 间距 0.18 且给电流留路」取的；若 deck 另有 `Slt.a`（槽宽下限）要求更大，
  按回执调。

---

## 附录 B（2026-10-17 15:5xZ · 对应 gen_M3_drv1_v15 / gen_M3_drv2_v14）· lib v2.2 与 TopVia1 钉档

依据：组长 b7a0 07:45:29Z 回执 ① 与 `probe_viastack_array_v22_2026-10-17.md`（sha e44d63e2…）。

### B1 库版本闸升 v2.2（canonical = 8510 `design/sow6/lib13g2.py`）
- v2.2 / 539 行 / 27592B / sha `02ecbfb95b3b4cee51a01a0cae1dde90776acff96271de533cce931fb4b8fbe4`。
- 变更**仅** `Board.via` 一处（vt1 透传 + 缓存键含 vt1 档位）；薄金属堆与既有调用逐位不变
  ⇒ 三件除下列钉档外，几何零变化（器件/标注计数 82/66、32/32、71/53 与 v25/v14/v13 相同）。
- 顺带更正一条旧账：我曾据纪要样本坐标反推「via_stack 顶层焊盘 ≈0.98µm < TM1.a 的 1.64 ⇒
  落柱处必有残留 min-width 项」。实测 **TopVia1 1×1 的 TM1 平台 = 1.64 见方**（外扩 0.61/侧），
  恰好等于最小宽、不违规 —— 该疑点**关闭**。

### B2 TopVia1 档位钉 1×1（两件各自的调用点）
- **drv1**：vcc 干路 `VCC_LAYER=TOPM1`，两处 `cross(..., VCC_LAYER)` → `b.via(..., "Metal1",
  "TopMetal1")` 默认 2×2 ⇒ v2.2 下静默变 2×2 阵列；显式钉 1×1（TM1 平台 1.64 / M5 0.62）。
- **drv2**：R-VIA-01 的 vcc 顶层馈电桶 `b.via(TVX, TVY, "Metal5", "TopMetal1", cols=37, rows=1)`。
  意图是 **37 列 TopVia1 阵列**（37 × 1.4mA = 51.8mA ≥ 实际 ~30mA），但 v2.1 及更早把 vt1
  硬编码 1×1 ⇒ **实际只落了一颗 TopVia1**；v2.2 起会继承 cols=37 变 37×1 阵列，而该档
  **无实测平台真值**。本版显式钉 1×1：与 v1.3 已代跑的那份逐位相同。
- **由此摆上台面的口径问题（请组长裁定）**：官方 TopVia1 **4.0Ω/件** ⇒ 桶现在只有 1 颗
  就是 4Ω 串在 vcc 馈电上（~30mA 下约 120mV 压降）。备选（**实测档，不外推**）：
  `vt1_cols=3, vt1_rows=2` = 6 颗并行 ⇒ 0.67Ω，TM1 平台 2.94×2.10 / M5 平台 2.30×1.46。
  本机自检第 ⑲ 项实测：**把 drv2 全部 TopVia1 栈改成 3×2 后，平台-走线间距 FAIL=0**
  （纪要规则值口径），即 3×2 档在我这版图里放得下。要不要改 = 一个数字的裁定。
- 自检台第 ⑲ 项本轮新增：TopVia1 端点平台（实测档）vs 我画的同层金属净距；
  drv1 = 3 处平台 / drv2 = 11 处平台，两件 **FAIL=0**；未实测档位只报「不量」，绝不外推。

---

## 附录 C（v1.4 · Q10 轮 08:0xZ）：T 交外延 · Slt 真开槽 · 占位落地

### C1 drv2 四处 TOPM2 T 交半搭接（官方 TM2.a×8）
病根同 M2：横轨端点 = 竖条中心。改法只外延横轨端点 1.0µm（= TOPM2 半宽），并让
x=56 那根竖条**贯通**到 `y_hi+1.0`（不留「竖条顶停在横轨中心」的半搭接台阶）：

| 网 | 原写法 | 新写法 | 官方逐条坐标 |
|---|---|---|---|
| bin | `wire_h(BIAS_RISER, y_lo, min(jx,riser), max(jx,riser))` | 左端 −1.0（立管在 −36） | `(-36,13.268~14)|(-35,15.732~15)` |
| bb1 下横轨 | `wire_h(..., min(jx,56), max(jx,56))` | 右端 +1.0 | `(56,-2|-2.732)|(55,-1|-0.268)` |
| bb1 上横轨 | `wire_h(..., min(56,riser), max(56,riser))` | 左 −1.0 / 右 +1.0 | `(41.732,183)|(41,182.268)|(40,184)…`、`(55,182.268~183)|(56,184.732~184)` |
| bb1 竖条 | `wire_v(BIAS_RISER, 56.0, y_hi, y_lo)` | 顶 `y_hi+1.0`（贯通） | 同上 |

### C2 ntail 汇流轨的 Slt.c.M1 真开槽（「只进注释没进代码」的翻车现场）
官方：`Max. Metal1 width without requiring a slit = 30.00`，polygon `(−62,117.7)-(88,150)`
（150×32.3，最窄边 32.3 > 30）。v1.3 的文首已写「两条 15.15 轨 + 缝 2.0 + 右端桥」，
**代码却仍是一整块 `b.rect`** —— 组长实测照报。本版代码真开：

```
下轨  y∈[117.70,132.85]   上轨 y∈[134.85,150.00]   缝 2.00   右端桥 x∈[78,88] 宽 10.0
```

- 轨最窄边 15.15 < 30 ✓、桥最窄边 2.0 < 30 ✓、缝 2.0 > M1.b 的 0.18 ✓
- EM 截面 2×15.15 = 30.3 ≥ 29.28mA @1mA/µm ⇒ 0.966 mA/µm，裕 1.03
- 桥宽由 5.0 提到 10.0（5.0 时桥内 2.93 mA/µm 过薄；10.0 时 1.46）
- 断言进代码：`_rail_h ≤ 30` 且 `2·_rail_h ≥ 29.28`，改宽高时会自己炸
- 搭桥放**右端**：左端 x=−62 那侧紧贴器件区，桥压上去会盖到别的金属

### C3 drv1 占位件落地（组长五裁）+ 一处必须他裁的硬阻塞
机制全落地：`land_cmim()`（先量后摆 → `b.mim_cap` 落位 → `Dev.p` 自证 → 不过就**精确摘掉**
那只实例回落）+ `cmim_fits()` 面积/净距闸（核 bbox 内 / 与我画金属净距 ≥3µm / 边长 ≤30µm）；
tank L1 两只改走 `b.keepout()`（(235,5)，库 v2.2 `_KEEPOUT` 备案，非制造）。

**但四只 cmim 一只都落不下**（按官方密度 1.5 fF/µm²）：

| 件 | 网表值 | 见方边长 | 撞上什么 |
|---|---|---|---|
| Cin1/Cin2 | 10p | **81.65µm** | 越出核 bbox（drv1 岛 130×224µm） |
| Ct1 | 0.84p | 23.66µm | 与 vcc 顶层横轨 `TOPM1 [−60,200]~[28,204]` **重叠** |
| Ct2 | 0.84p | 23.66µm | 同上，净距 0.17µm |

且当前占位三行行距只有 14µm（y=176/190/204），23.66 见方连行距都放不下。
⇒ 全部回落为 (235,5) 上的预留区（**对裁定②的同口径外延**：占位是预留标记、不是金属），
尺寸账逐只进 stdout 的 NOTES。**请裁**：改面积规划 / 换电容型号 / 接受 81.65µm 大电容。

### C4 自检台新增两项（⑳ / ⑯b）与三颗牙
- ⑳ 并集相向平行边最小宽：官方 v25 轮逐条坐标校准 —— M2 TOPM1 4 + TOPM2 8 / drv1 0 /
  drv2 TOPM2 8 = 与官方 TM1.a/TM2.a 逐项一致；drv2 本轮 8 → 0。
- ⑯b 无开槽最大宽度（Slt.c.M1）：M2 0 / drv1 0 / drv2 v14 1、v15 0 = 与官方一致。
- teeth 11 → 14 条（新增 ⑳ 的两条 T 交 + 一条 Slt 整块），全部有牙。
- `teeth_label/gen_teeth.py` 的 SRC 改成 glob 取最高版（写死 v13 会让第 ⑭ 项在代跑目录里
  FileNotFoundError，而「teeth 全有牙」照旧报 PASS）。

## 附录 D（v1.5 · Q11 轮 09:0xZ · 对应 gen_M3_drv2_v16）：馈电桶落点与 13×3 阵列

### D1 桶档位：1×1 → **13×3 = 39 颗**（组长 08:26Z 裁定 Q-A）

| 档 | 颗数 | TM1 平台 | M5 平台 | 取舍 |
|---|---|---|---|---|
| 3×2 | 6 | 2.94×2.10 | 2.30×1.46 | **否决**：EM 5mA/件 = 3.6× 超 Jmax；0.67Ω ≫ 60mΩ |
| **13×3** | **39** | **11.34×2.94** | **10.70×2.30** | **本件采用**：最紧凑，装得进上环右段 |
| 19×2 | 38 | 16.38×2.10 | 15.74×1.46 | 16.38 > 上环右段宽 15.2，放不下 |
| 37×1 | 37 | 31.50×1.64 | 30.86×0.62 | 同上；已获官方 deck 零新增实证 |

平台律（组长勘误后）：TM1 `0.84(n−1)+1.26`（单行钳 1.64）、M5 `0.84(n−1)+0.62`、pitch 0.84。
上轮的 `0.84(n−1)+1.64` **作废**（把 1×1 钳值误当截距：37×1 旧律给 31.88、实测 31.50）。

电阻：官方 TopVia1 4.0Ω/件 ⇒ 39 并联 ≈ **0.10Ω**（v1.4 的 1×1 是 4Ω 串在 vcc 馈电，
~30mA 下约 120mV）。EM：39 × 1.4mA = 54.6mA ≥ 实际 ~30mA。
薄金属堆仍走 `vn_*`（`cols=37, rows=1`）—— TopVia1 档位与薄堆档位是两套键，显式分开钉。

### D2 ⚠ 落点：原坐标让整根落柱**两端悬空**（不是「4Ω 太贵」，是 ∞）

    原：TVX = CX + X_C + 10.0 = 34.0,  TVY = Y_VCC_HI − VCC_W = 206
    vcc 上环矩形：x ∈ [−70, 40]，y ∈ [209, 215]

1×1 的 TM1 平台 1.64 见方，中心在 y=206 ⇒ 顶边只到 **206.82**，比环低 **2.18µm**；
M5 侧 y≈206 一带全空。**两端都不落金属 ⇒ 整根 via_stack 是浮岛**，
R-VIA-01 想要的顶层馈电从来就没接过电。旧坐标还正好压在 outp/outn 的 M1 走线上
（x=34 那条 L 形 M1，从发射极臂到 Y_CP=206）。

**官方 DRC 不报**（没有管浮空金属的规则），自检 ⑯⑰⑱⑲⑳ 五族全绿也照样漏，只有 LVS 会炸。
这是自检台第 6 个「恒过的检查」（前三个：⑯b、⑳、㉑）。

### D3 v16 的落点：平移到上环中心线

    新：TVX = CX + X_C + 9.0 = 33.0,  TVY = Y_VCC_HI = 212

13×3 的 TM1 平台 11.34 宽 ⇒ x 27.33~38.67（上环右缘 x=40，余量 1.33µm）、
y 210.53~213.47（环 209~215，内缩）。与 RL1/RL2 接入柱（x 右缘 24.82）横向间距
2.51µm > TM1.b 1.64，过 ⑲（逐轴取严口径）。纯平移，网名与拓扑不动。

### D4 仍开着：M5 端接到哪张网（待组长裁）

M5 平台 10.70×2.30 悬在 y 210.85~213.15。查 drv2 全片：**那一带除上环外没有 M5 金属** ——
drv2 的 vcc 分配全在 TOPM1（Rref.P1→下环 / RL.P1→上环 / TOPM2 立管串上下两环），
M5 那一层是 nref1..4 与偏置网。M5 端该接哪张网是**电路决定**，版图侧猜错就是静默
断路或短路，故 v16 的自检 ㉑ 项如实报 1 条 FAIL，不自欺成全绿。
