oppry12102/WIFI7-TX/06_layout_design_notes/ntaila同域之争_三件套实测与丙案建议_2026-10-19.md

# ntaila / nref 同域之争 · 三件套第一手实测报告（裁定五十五 §四① 的裁决尺）

日期：2026-10-19（b7e7）　触发：裁定五十五 §四①「`XBI1/nref` 与 `ntaila` 同域，怎么收？甲案 / 乙案二择一」
口径：全部数字在**真 GDS** 上现量，工具与日志随件，**不引用官方提取结论、也不引用我方既有结论**。

---

## 一、争议的两把尺，结论相反

| 尺 | 谁 | 读数 |
|---|---|---|
| 官方 KLayout deckfix_v3 提取 | b7a0（真 KLayout 0.30.0 实跑） | v29 ≡ v31；`ntaila` 与 `XBI1/nref` **同一网**（端口名 `XBI1/nref\|ntaila`） |
| 我方端子锚定提取器 | b7e7（`pex_mix_v31.json`） | M1:6 = `XBI1/nref` **单标签** 15.77 µm²；M1:19 = `ntaila` **单标签** 34.81 µm² ⇒ **两域分离** |

同一 GDS（`m2_mix_v31.gds` `ef034d51`）、两种结论 ⇒ 必有一方把某个**非几何接触**的东西当成了连接。

---

## 二、三件套探针（随件，可复现）

| 探针 | 口径 | 作用 |
|---|---|---|
| `probe_m1_dom_b7e7.py` | M1(8/0) 单层，**含器件焊盘**（flatten 后 282 片），标注 8/25 | 单层尺：短接在不在 M1 上 |
| `probe_stack_dom_b7e7.py` | **提取忠实**全栈：同导电组相接才并；via cut 被某层包含才跨层桥；**跨层 XY 重叠不算连接** | 全栈尺：M1 之上有没有桥 |
| `ntaila同域三件套实测_v31_2026-10-19.log` | 两探针 × 三面（v28/v29/v31）全量输出 | 留痕 |

复现（注意：`dryrun/inspect.py` 会遮蔽标准库 `inspect`，numpy 必须先 import）：

```
python3 -c "import numpy,sys; sys.path.insert(0,'design/sow6/dryrun'); \
  import probe_stack_dom_b7e7 as P; P.probe('inbox_replies/m2_mix_v31.gds')"
```

---

## 三、实测结果（三面，真 GDS）

### 3.1 M1 单层尺（含焊盘）

| 面 | GDS sha | M1 多边形 | 连通域 | `ntaila` | `XBI1/nref` | 判定 |
|---|---|---|---|---|---|---|
| v28 | — | 282 | 119 | dom 2 | dom 2 | **同域（短接成立）** |
| v29 | `8f6da23d` | 282 | 119 | dom 2 | dom 2 | **同域（短接成立）** |
| v31 | `ef034d51` | 282 | **121** | dom 3 | dom 9 | **两域分离** |

v31 两域最近边到边间距 = **1.8250 µm**
（`ntaila` 侧 M1 多边形 bbox (−29.250, 31.020)−(−10.750, 31.460)，229 顶点；
　`nref` 侧 M1 多边形 bbox (−32.925, 31.010)−(−31.075, 31.250)，4 顶点）
1.825 µm ≫ M1.b 规则 0.22 µm ⇒ **净距充足，不是「勉强擦边」**。

### 3.2 提取忠实全栈尺

| 面 | 参与多边形 | 导电域 | `ntaila` | `XBI1/nref` | `XBI2/nref` | 判定 |
|---|---|---|---|---|---|---|
| v28 | 1842 | **36** | 域 0 | 域 0 | 域 17 | 同域 |
| v29 | 1842 | **36** | 域 0 | 域 0 | 域 17 | 同域 |
| v31 | 1848 | **43** | 域 0 | **域 7** | 域 17 | **分离** |

v28/v29 的合并域 = 30 片、只跨 `M1` + `M1.pin`（纯 M1 面接触）。
v31 多出 7 个域，正是短接断开后分裂出来的。**M1 之上经 via 也无桥。**

### 3.3 附一条：`XBI1/nref` 与 `XBI2/nref` 在三面上都是**两个独立域**

v31：dom 7 vs dom 17；v28/v29：域 0 vs 域 17。⇒ **版图侧不存在「两个参考网并在一起」的金属短。**

---

## 四、由此得到的四条事实（都可复算）

**事实 1**：裁定四十的修复 `QR_L 8.7→12.0` **在连接层真的生效了**——
v29→v31，`ntaila` 与 `XBI1/nref` 从同一金属域变成两个独立域，M1 净距 1.8250 µm。

**事实 2**：官方提取侧看到的「同网」**不是几何事实**。若官方那一网真是几何合并，
它的多边形集合必须与 `ntaila` 域有相接的两片；而 v31 的 M1 面上不存在这样的两片。

**事实 3（这一条在我侧，且是硬伤）**：**`pex_mix_v31.cdl`（`f6ba9560`）把两个参考网并成了一个节点。**
该件头写「网名策略: 原名·**众数优先**」，体内容器只有**一个** `nref`：

```
Q7  ntaila nref gnd npn13G2 NX=10      ← XBI1 簇
Q8  nref   nref gnd npn13G2 NX=1
R5  nvtop  nref    rhigh
Q9  ntailb nref gnd npn13G2 NX=10      ← XBI2 簇
Q10 nref   nref gnd npn13G2 NX=1
R6  nvtop  nref    rhigh
```

而 `pex_mix_v31.json`（同一提取的**域级原始输出**）里它们是两个独立域：
`net 22 = ['M1',69] ['XBI2/nref'] 19.77 µm²`、`net 25 = ['M1',6] ['XBI1/nref'] 15.77 µm²`。

⇒ **`json`（域级）正确、`cdl`（配名级）错误**：`_resolve_net` 的「众数优先」把
`XBI1/nref` 与 `XBI2/nref` 的共有尾词 `nref` 选成了网名，**两个独立域在 SPICE 层成了同一节点**。

**事实 4**：**我照抄 cdl 的 `mix_subckt_LVS输入_v1b.sp` 继承了这条并网**（v1b 里
`QXBI1_XQr` / `QXBI2_XQr` / `RXBI1_Rref` / `RXBI2_Rref` 全挂同一个 `nref`），
**这是我的网表缺陷，不是版图缺陷。** v1 / v2 / v3 未中此条（它们的 XBI1 簇用 `ntaila`）。

---

## 五、结论与建议（答 裁定五十五 §四①）

**甲案 / 乙案二择一的前提不成立** —— 版图已经把它们分开了（事实 1）。
所以我给的是**丙案**，并说明为什么它优于甲、乙：

- **甲案（改版图再拆一次）**：**不必要**。v31 的几何已分离（1.8250 µm），
  再动版图会把一个已解决的问题变成新的几何风险（且要重出 v32 面 + cdl + 网表，F14 重登记）。
- **乙案（改网表承认 `nref ≡ ntaila` 同网）**：**不可取**。它会把**我方命名缺陷**
  （事实 3/4）追认成设计意图，等于在台账上把两个不同参考网焊死；
  且官方那一网到底怎么并的仍未定位（事实 2），追认等于把一个**未定位的异常**写成结论。
- **丙案（我推荐）**：**先修 `_resolve_net` 的配名策略，再重生成 cdl 与网表，版图不动。**
  代价＝改一处命名规则 + 重生成 `pex_mix_v31.cdl` + 重出 `mix_subckt_LVS输入_v1c.sp`；
  好处＝版图零风险、F14 登记干净、并且顺手把 fde9 在 note227b §二 提的
  「A 版图短路 / B 命名并网」判别一次结清（**按本报告：读法 B 成立**）。

**同时向官方侧要一件东西（这是把事实 2 落地成结论的唯一路径）**：
请给出官方提取出的那一网（`XBI1/nref|ntaila`）的**多边形清单**
——哪几片、哪一层（layer/datatype）、世界坐标 bbox。
我这边两把尺已能定位到 ±0.001 µm，拿到清单即可逐片判定：
若清单里有一片真与 `ntaila` 域相接 ⇒ 官方对，我改我的尺（并交代我的盲区）；
若清单里没有 ⇒ 并网是提取/配置口径产物，请给那一条 `connect()` 的出处，我配合改正。

---

## 六、本报告的已知盲区（如实登记）

1. **我的尺不含 PCell 内部语义**：我把 HBT / via_stack 的 M1 pin（datatype 2）
   当作 M1 本体的一部分。若官方 npn 提取器对 C/B 焊盘另有并网规则（例如
   同一器件的 C、B 在某层被 tie），我的尺量不到。这正是「官方对、我错」的唯一可能路径。
2. **我的尺不含 keepout / 禁区层**（如 `235/5`），也不含 MIM 板；
   若某非导电层在官方 deck 里被误当连接，也会造成我量到分离、官方量到并网。
3. `probe_stack_dom_b7e7.py` 的 via 桥接判据是「via cut 被某层多边形**包含**」；
   若官方 deck 用的是「焊盘相接」而非「cut 包含」，边界情形可能差一片。
   —— 上述三条都指向同一个动作：**拿官方那一网的形状清单来对，而不是各自坚持尺子。**

---

## 七、入册建议

- **法 B 成立**：`XBI1/nref` 与 `XBI2/nref` 在 GDS 里是两个独立域，
  cdl 里的同节点是 `_resolve_net` 配名所致（首例：`pex_mix_v31.cdl` `f6ba9560`）。
- **待销的账**：`mix_subckt_LVS输入_v1b.sp`（`c7e107b5`）继承了那处并网，
  已由本口 `mix_subckt_LVS输入_v1c.sp`（`e3cb4a32`）修正。
