oppry12102/WIFI7-TX/06_layout_design_notes/R_P2_断路根因与普查报告_2026-10-18.md

# R P2 断路根因与普查报告 — 回应 b7a0 L92 四项请办

**b7e7** · 2026-10-18 13:1x 本地 · 状态：技术定谳，候 deck 修复版重提

---

## 一、根因定位（L92 ①）

**1.1 机制：emitpath 的 P2 引脚距公式与 rsil PCell 真值不符**

- **emitpath 公式**：`y_p2 = y_p1 + 1.56`（resgeom 真值表拟合 0.72+0.84·l，l=1µm）
- **PCell 实测真值**（GDS 逐位）：**rppd 档 P1P2 中心距=1.56**（焊盘 y[−0.430,−0.130]/[1.130,1.430]
  → 中心差 1.56，公式对该档成立）；**rsil 档（w=1.75/4.665）P1P2 中心距=1.40**
  （焊盘 y[−0.330,−0.070]/[1.070,1.330] → 中心差 1.40）——**引脚距随 model/w 档变化，公式只对 rppd 成立**
- **后果**：emitpath 的 P2 stub 从公式点 y_p1+1.56 起画，rsil 真值 P2 焊盘顶在 y_p1+1.53
  → stub 底悬在焊盘顶**上方 0.03µm**（0.16 偏差 − 0.13 半盘高），全同层无 via 跨接 → 直流断路

**1.2 根因代码段**（emitpath.py L200/L205 + gen 调用顺序）：
```python
y_p2 = y_p1 + 1.56                       # 公式预估 P2 pin 中心（仅 rppd 档成立）
b.wire_v("M1", x_col, y_p2, y_p2 + 1.3)  # stub 从公式点向上画
```
gen 里 `place_emit_chain(...)`（画 stub）在 `mkres("Re1",...)`（放 PCell）**之前**调用——
画线时 Re 实例尚不存在，只能用公式预估；mkres 返回的 `Re1.p["P2"]` 真值从未回填校正。
**修法（v20）**：调换调用顺序（先 mkres 后 place_emit_chain，把 `p2_y=Re.p["P2"][1]` 真值传入），
stub 从 pin 真值中心起画；或 place_emit_chain 增加 p2_y 必填参数、断言 |公式−真值|<0.005。

**1.3 与 E 回流 0.085µm 缝：同族不同根因**
- 同族：均为 emitpath 对 PCell 内部几何的**预估偏差型断路**（数字不同）
- 不同根因：0.085µm = via PCell M2 焊盘 enclose 认知差（外沿+0.005/边 vs 外接+0.09/边），
  **v19 已修**（lap=0.6 臂-桶重叠，gen v19 CHANGELOG 在案）；0.03µm = P2 引脚距公式档位错，
  **未修，进 v20 修复单**

**1.4 为什么只有 Re 中招（普查互证）**：mix R1-R4 P2 全连通——**mix gen 不走 emitpath**
（自己从 pin 真值画线）；drv1/drv2 的 Rin/Rb/RL 也连通——它们的 stub 方向朝 P1/焊盘内部
（gen §8 `stub(..., -3.0)` 向下、与焊盘重叠）或由主脚本从 pin 真值画。**唯一受影响面 =
走 emitpath 且 stub 向上离开焊盘的 Re1/Re2 ×2 件 = 4 条**。

---

## 二、同族普查（L92 ②）

**2.1 三件 R P2 连通性对比**

| 件 | R 类型 | 原理图 P2 | cdl P2 | 状态 | 备注 |
|---|---|---|---|---|---|
| **drv1 v19** | Re1/Re2 (rsil) | ntail | 空 | **断路** | P2 缝 0.03µm，×2 只 |
| | Rin1/Rin2 (rhigh) | 0(gnd) | nref | **物理连通** | cdl 名 nref = nref\|gnd 并域呈现（真短案 4 桥接），v20 修真短后归位 gnd |
| **drv2 v19** | Re1/Re2 (rsil) | ntail | 空 | **断路** | P2 缝 0.03µm，×2 只 |
| | Rin1/Rin2 (rhigh) | XBI1\|2/nref | nref | **物理连通** | P2 真值接 gnd 轨（gen §7 cross+M4），cdl 名=并域呈现——**⚠ v3 原理图 `inp XBI1/nref` 把并域名烙进了原理图**，v20 修真短后 nref‖gnd 分离，v3 此两行须回改 `inp 0`（v1 原稿是对的） |
| | Rb1/Rb2 (rppd) | nbias | nbias | **连通** | P2 用 mkres 真值+cross ✓ |
| **mix v27** | R1-R4 (rsil) | ntaila/b | ntaila/b | **连通** | mix gen 不走 emitpath，从 pin 真值画线 |

**2.2 结论**：
- **drv1/drv2 Re P2 断路**：共 4 只，均为 emitpath 公式锚点机制，与原理图意图不符
- **其余 R 全连通**：凡用 mkres 真值画线的（Rin/Rb/RL/mix 全部）零缺陷——
  **缺陷面=emitpath 公式锚定，唯一受害=Re1/Re2 ×2 件**
- **⚠ 连带发现（v20 前瞻）**：drv2 LVS 输入 v3 的 `RRin1 inp XBI1/nref` 两行是
  真短并域的化石——真短修复后须回改，否则 LVS 会拿「原理图也错」的基准对拍

---

## 三、关联疑点（L92 ③）

**3.1 R P2 竖 stub vs nx 小管竖条是否同件/同族？**

**结论：同族（同为 0.30µm 板级 M1 竖条布线产物），不同件、不同根因。**

| 维度 | R P2 竖 stub | nx 小管「C=B 竖线」 |
|---|---|---|
| 来源 | emitpath `wire_v("M1", x_col, y_p2, y_p2+1.3)`（w=0.30 Board 默认） | gen 布线 `wire_v("M1", rbx, rby, rcy)` / `b.wire_v("M1", XQs.p["B"][0], ..., +2.0)`（w=0.30 同默认） |
| 意图 | 有（P2→ntail 引出） | 有（C=B 二极管实连） |
| 缺陷 | 锚点公式错（P2 距档位错 0.16）→ 悬空 0.03µm | **无缺陷**——走线本身正确，是**途经位置**压了 E 指列（通道律缺「避 E 指 x 列」约束） |
| 后果 | 断路（P2 悬空） | 短路（nref/nsens↔gnd） |
| 修法 | gen 源码级：mkres 真值回填（先 mkres 后 chain） | 布线律级：绕 E 指 x 列 ±0.35 外走 |
| 同点 | **均为 Board.wire_v 缺省 w=0.30 的板级 M1 竖线** | 同左 |

**3.2 收敛判断**：两案可收敛为同一根因家族——「**gen 板级 M1 竖线类布线对 PCell 端子
几何的真值脱钩**」：一档脱钩在 y（P2 引脚距公式），一档脱钩在 x（E 指列位置 awareness）。
v20 修复单可合并为一个纲领：**板级竖线一律从 mkpc_at 返回的 pin 真值锚定 + 布线律
避让清单（E 指 x 列 ±0.35）**。回改候选 15 项不必再细分，按此纲领统一出修复件。

---

## 四、DRC 基线归属（L92 ④）

**4.1 0.03µm 缝对应规则**

- **规则名**：M1.b（5.16 Metal1 space or notch: 0.18 µm）
- **基线轮次**：drv1 v14 ×2 + drv2 v13 ×2，坐标逐位在案
  - drv1：`(±14.15,144.56)`（L307/309）
  - drv2：`(±24.15,172.56)`（L378/380）
- **归属结论**：**已在备案残留**，不新增 DRC 项，属基线内已知成员。

**4.2 0.085µm E 缝**：via PCell M2 焊盘外沿 +0.005/边 vs 外接 +0.09/边 → 臂底悬空，已在案（PEX报告）。

---

## 五、修复方向与 v20 回改单

**5.1 统一修复策略**
- **emitpath 修正（v20）**：先 mkres 后 place_emit_chain，P2 stub 从 `Re.p["P2"]` pin 真值画；
  增加断言 |公式 y_p2 − 真值|<0.005 防回归（fix 后 cdl 重出升版）
- **版图回改**：所有竖线（R P2 stub/C=B 竖线）绕开 E 指 x 列（±0.35 外走）
- **自证判据**：v20 重提后「同普查脚本零命中」（gm dummy/$3 dummy 三端同网除外）

**5.2 回改候补清单 v2（15 项）**
- nx 小管 3 只（mix XBI1.XQr $2@(−28.7,30) 等）
- R P2 断路 4 只（drv1 Re1/Re2 + drv2 Re1/Re2）
- C=B 竖线真短 8 只（mix 3【XQr×2 + XQs×1】 + drv1 1 + drv2 4）
- 连带复核 1 只（mix XBI1.XQo $1 擦碰，不计入 15）

---

## 六、待办

1. ~~drv2 4 只镜像主管修正重跑~~ **已毕（本口）**：4 只全部无真短——XQ1/XQ2 零重叠
   （ccas 外折成功）；XQ3/XQ4 B 带压块 = nbcas cross M1 底盘同网合法（diag_mirror_q.py
   三方法交叉：gdstk flatten 权威变换 + pex terms 真值重建 + 域号核对）。真短定谳 §四已补订。
2. **真短定谳名单 + 本报告投 8510**（L93 ⑩ + L92 回执）
3. **deck 修复版 ETA**：补丁稿已到（组长侧落码），我侧备料全齐候重提窗——见回信

—— b7e7 · 2026-10-18
