oppry12102/WIFI7-TX/06_layout_design_notes/判读纪要_nx展开面差直方账_2026-10-18.md

# 判读纪要 · nx 展开面差直方账（裁定四十二 §六 回填义务件）

- 出数时间：2026-10-18T13:11Z
- 出数人：fde9（仿真验证组）
- 授权依据：b7a0 **裁定四十二 §六**「nx 展开面差备案（直方账）」
- 性质：**只读静态分析，零仿真、零改件**（不占 ngspice 资源）
- 目录：`/data/workspace/sow6/m5/run_nxledger/`

## 〇、两件输入（sha 逐位核对过）

| 面 | 件 | sha256 |
|---|---|---|
| 前仿锚 | `pdk/sim/v015_1/chain_top_tb_v015_1_typ.sp` | `2d73c174f28fcc36377577ab31211f3dbff16b5a1eae3ff37ad0864d75cc1028` |
| PEX 锚 | `pdk/sim/v015_1/chain_top_tb_v015_1_pex_v34.sp` | `99307f4515eb986c67f8e7b712fd03a4a5b628fe88eabe63fd563f5d1ddcfb4f` |

## 一、方法上的三个坑（**初版结论作废的教训，记在此处**）

1. **`nx` 参数大小写两写**：前仿面用小写 `nx=`、PEX 面用大写 `Nx=`。
   正则若不 `re.I`，前仿 22/22 实例会全部误判成「无 Nx」——
   我第一版就踩了这个，得出的「前仿面零 nx 展开」结论**是错的，已作废**。
2. **`{nx}` 是子电路参数传递，不是常数**：前仿 `.subckt hbt_mirror … nx=8` 体内
   `XQo nout nref 0 0 npn13G2 nx={nx}` —— 每次实例化传参不同（`nx=8` / `nx=10` / 缺省 8）。
   按字面读会把它当成固定值。
3. **不展开 `hbt_mirror` 就比 nx，会把「封装 vs 展平」误读成「nx 面差」**：
   前仿把参考二极管封装在 `hbt_mirror` 子电路里（**9 处调用**），
   PEX 把其中 **7 处展平**成显式 `npn13G2` 对，只留 `lo_buf` 的 2 处（**PEX 仅 2 处调用**）。
   **必须先展开再比。**

另：**实例名在两面之间被重排**（前仿 `XQ1a/XQ2a…` ↔ PEX `XQ1/XQ2…`），
按实例名对齐会错配；须按 (subckt, 四端节点, nx) 三元组对。

## 二、逐 `.subckt` nx 直方（**未展开** 口径 — 会骗人，仅留档）

| subckt | 前仿 n/ΣNx | PEX n/ΣNx |
|---|---|---|
| hbt_mirror | 2 / 1 | 2 / 1 |
| lo_buf | 5 / 13 | 5 / 13 |
| gilbert_mix | 9 / 37 | 15 / 65 |
| drv1 | 2 / 12 | 4 / 21 |
| drv2 | 4 / 40 | 12 / 76 |
| **合计** | **22 / 103** | **38 / 176** |

## 三、**展开 `hbt_mirror` 后的真·nx 面差总账**（本纪要正题）

| subckt | 前仿 n/ΣNx | PEX n/ΣNx | Δ(n / ΣNx) |
|---|---|---|---|
| hbt_mirror | 2 / 1 | 2 / 1 | 0 / 0 |
| lo_buf | 9 / 31 | 9 / 31 | **0 / 0** |
| **gilbert_mix** | **13 / 59** | **15 / 65** | **+2 / +6** ← ★唯一有差 |
| drv1 | 4 / 21 | 4 / 21 | **0 / 0** |
| drv2 | 12 / 76 | 12 / 76 | **0 / 0** |
| **合计** | **40 / 188** | **42 / 194** | **+2 / +6** |

**结论（静态面，无仿真）**：

- 五个 `.subckt` 里 **四个的 nx 面逐子电路完全相同**（lo_buf / drv1 / drv2 / hbt_mirror）。
- **全部 nx 面差 = `gilbert_mix` 内 2 只三端全接地器件**：
  `XQ5 gnd gnd gnd 0 npn13G2 Nx=3` 与 `XQ6 gnd gnd gnd 0 npn13G2 Nx=3`（L199/L200），
  ΣNx=6，**前仿侧无对应物**（PEX 提取器的接地填充件）。
- 逐器件配对后，`front_only` 与 `pex_only` 的其余条目一一对应
  （`*ref*` 是前仿 `hbt_mirror` 私有内节点 `nref` 的占位名，PEX 把它拉平叫 `nref`），
  **nx 值全部相等**。

## 四、对「−2.93794 dB 归因」的影响（**不越权，只摆事实＋请示**）

1. **静态面上已无第二个 2.9 dB 量级候选**：格4 补 nrefa 后 `|格4 − 17.4465| = 0.00453 dB`
   （门的 0.05 的 **9%**），而 nx 面差已只剩 2 只接地填充件。
2. 两项**互相印证**：格4 的经验残差 0.00453 dB，从经验上把 nx 面差**上界在 0.00453 dB 以下**；
   nx 静态账从结构上说明它**没有承载 2.9 dB 的通路**（三端同接 gnd，不经信号路径）。
3. ⇒ **格5_nx 展开分离的先验收益极低**。请示 b7a0 三选一：
   - (a) 格5 降级为「可选/低优先」，把机器时间让给 v31 B 路闭环；
   - (b) 格5 缩到最小面：**只搬 `gilbert_mix` 的 XQ5/XQ6 两件**（单变量、ΔΣNx=6）；
   - (c) 维持原计划（整 `.subckt` 分块搬）。

## 五、附带实证：ntaila「版图真短」在我自己的 PEX 锚件上得到独立印证

PEX 锚件 `99307f45` 的 `gilbert_mix` 尾部参考对（L205–L209）：

| 实例 | 四端 | Nx | 判读 |
|---|---|---|---|
| XQ7 | `ntaila ntaila gnd 0` | 10 | **C=B=ntaila —— 基极未接独立参考网（短）** |
| XQ8 | `ntaila ntaila gnd 0` | 1 | 同上 |
| XQ9 | `ntailb nref gnd 0` | 10 | **b 侧正常：C=ntailb、B=nref** |
| XQ10 | `nref nref gnd 0` | 1 | b 侧二极管接法正常 |

⇒ **只有 a 侧短、b 侧不短**——与 b7e7 来信《ntaila＝版图真短》逐条对上，
且此结论出自**我方 PEX 锚件本身**，不依赖对方转述。
前仿侧对照：`XBI1 ntaila nvtop hbt_mirror nx=10` / `XBI2 ntailb nvtop hbt_mirror nx=10`
（两侧对称、均为 nx=10）⇒ **a/b 不对称只在 PEX 面出现**，前仿面无此不对称。

## 六、产出件

| 件 | 说明 |
|---|---|
| `nx_ledger.py` | 分析脚本（可复跑；模块 docstring 内含三个坑的纪律） |
| `nx_ledger.json` | 机器可读全量证据（实例台账/型号直方/展开后总账/差集） |
| `SHA256SUMS.txt` | 本目录 sha 存根 |

复跑：`cd /data/workspace/sow6/m5/run_nxledger && python3 nx_ledger.py`

—— fde9 2026-10-18
