oppry12102/WIFI7-TX/06_layout_design_notes/真短定谳_回改候补名单_2026-10-18.md

# 版图回改候补名单定谳 — 「C=B 竖线压 E 指」系统性真短（R2 回改候选）

**b7e7** · 2026-10-18 13:0x 本地（§四重查补订 13:2x）· 回应组长 91 行 §二（真短 vs 域呈现二分）

## 一、判据与验证方法（三方法一致）

- **方法**：顶层自画 M1 块（depth-0，排除器件 cell 内部）× 目标 HBT 全局 M1 pad
  **真多边形相交**（shapely 精确交 → gdstk boolean 官方复核 → 轴对齐矩形代数，三法一致）。
- **意图对照**：每只管的原理图端网（chain_top_tb_v015_1.sp）+ gen 源码布线段。
- 判真短标准（按组长 §二）：**同一块顶层 M1 压同一只管的 ≥2 个异网端子**。

## 二、机制（gen 源码级定位，非猜测）

npn13G2 的 C 带（y+1.13）/E 指底座（y±0.78）/B 带（y−1.14）**同 x 列、y 向堆叠**，
且 **E 指底座是 (8,0) M1 金属**（组长 74 行 dump：emwind_drw 直连 metal1_con，无需 cont）。
gen 的「C=B 实连」竖线走法：

```python
b.wire_v("M1", XQs.p["B"][0], XQs.p["B"][1], XQs.p["C"][1] + 2.0)   # C=B 实连（gen_M2_mix_v27 L937）
b.wire_v("M1", cxr, bref_y, y_join)                                  # Qr.C ↓ Qr.B（C-B 本就同网）（L528）
```

竖线从 B 带直拉 C 带，**中间必穿 E 指底座**（E 指 y 跨度覆盖两带之间的全部空隙）。
`wire_v` 缺省宽 W=0.30（Board 默认），与 E 指 x∈[锚±0.35] 交叠 0.30×1.557=**0.4665µm²**（满宽）。

**自检台为什么没抓到**：仿真层自建模型不画 PCell 内部 (8,0) E 指底座（与 gen_M3 v1.5
「仿真模型不画电阻 M1 焊盘 → 只有真 DRC 才炸」同款盲区）；deck 侧则因端子识别 bug
把 E 指拽进端子区而非金属连通（flood_full 的两件 knife 复现件=镜像区/主管区，
**不含 XQs 区**，故「发现场分离」与此结论不矛盾——验尸没扫到案发第二现场）。

## 三、定谳名单（refl=False/rot=0 实例，坐标变换无误，三方法实证）

| # | 件 | 实例 | 顶层块 bbox (cell 系) | 压端（面积µm²） | 短路网对 | 原理图端网 |
|---|---|---|---|---|---|---|
| 1 | mix v27 | XBI1.XQr $2@(−28.7,30) nx=1 | (−28.85,28.86)~(−28.55,32.63) | E0.4665+C0.072+B0.036 | **nref↔gnd** | Qr: C=B=nref, E=gnd |
| 2 | mix v27 | XBI2.XQr $2@(45.35,30) nx=1 | (45.2,28.86)~(45.5,32.63) | 同上 | **nref↔gnd** | 同上 |
| 3 | mix v27 | XQs $2@(52,118) nx=1 | (51.85,116.86)~(52.15,121.13) | E0.4665+C0.072+B0.036 | **nsens↔gnd** | XQs: C=B=nsens, E=gnd |
| 4 | drv1 v19 | XBI.Qr $2@(34,108) nx=1 | (33.85,106.86)~(34.15,109.13) | E0.4665+C0.036+B0.036 | **nref↔gnd** | Qr: C=B=nref, E=gnd |
| 5~8 | drv2 v19 | XBI1..4.Qr $2@{−28.5,4.5,37.5,70.5},108 nx=1 | 各 (x±0.15,106.86)~(x±0.15,109.13) | 各 E0.4665+C0.036+B0.036 | **nref↔gnd ×4** | 同上 |

- 桥孔层号：**无需桥孔**——这是 M1 同层重叠（组长 §二①类真短），via 只是 E 指向上引 M2 的常规连接。
- mix 另有 XBI1.XQo $1@(−28.32,30) nx=10 被同批竖线/横线擦碰（E0.1944+C0.132+B0.036），
  属 #1 的连带（nref 横段 Qr.B→XQo.B 压 XQo 脚带），修 #1 时一并复核。
- gm dummy（$3×4，C/B/E 三端全接 gnd=意图）不计入：单块压多端但三端同网=合法。

## 四、作废与待重跑

- **drv2 4 只镜像主管**（XQ1/XQ2@±24,179.24 + XQ3/XQ4@±24,191.24，rot=π+refl=True）：
  初判「E指+C/B 重叠」因坐标变换存疑**作废**，已于本口用无手工变换方法重查定谳：
  **4 只全部无真短**（diag_mirror_q.py，方法=gdstk flatten 权威变换 + pex terms 真值
  重建 C/B 带 + 板级窄竖条过滤 [w<1.0,h>0.5]）：
  - XQ1/XQ2：C 带 0.0000 / B 带 0.0000µm² —— ccas 外折 4µm 通道成功避开 B 脚头
  - XQ3/XQ4：C 带 0.0000；B 带压块 (±24,188.55~189.17) 0.168µm²×2 = **nbcas 的
    cross M1 底盘**（gen_M3_drv2_v19 L561 `cross(px,py,"Metal1","M5")`，B 脚跨层
    M1→M5 引出件）压自家 B 带 = **同网合法连接，非短**
  - pex 侧互证：XQ3/XQ4 B node=M1:29 五名域含 nbcas = 经 cross 底盘真连 nbcas
    （与 ccas1/e1 的并域是 deck 幻影焊呈现，非此底盘之过）
- mix $3@(±14.6/5.35,128.11) 等 dummy 类：三端同网，合法，不列。

## 五、全局含义（与在案异常的闭环）

1. **三网合并域的物理根因候选**：nref↔gnd 短（#1~#2/#4~#8，×6 只管）+ nsens↔gnd 短（#3）
   正是 cdl WARNING `['gnd','nsens','ntaila']` 65 域与 `['XBI*/nref','gnd']` 簇乙的
   **版图物理来源**——不只是 deck 端子识别 bug 的「呈现」，有真实几何桥。
2. **fde9 OP 无解（singular matrix: xmi.nsens）的物理解释候选**：nsens↔gnd 短使
   Vbe 感测支路对地短路 → 偏置方程奇异。deck 修复重提后若 OP 仍无解，此即主嫌。
3. **修复动作（v20 回改单）**：C=B/nref 竖线全部**绕开 E 指 x 列**（±0.35 之外走，
   或 B 带高度横移后上引），与既有的「C 外折 ∓15 / B 内折 ∓3±6 / E 保持」通道律合并执行。
4. **对主闸门**：这批真短在 deck 端子识别修复后会以「b↔gnd/c↔gnd 连通 FAIL」形式
   首次可见（现状被幻影焊淹没）——**预期中的重提期 FAIL**，非修复回归。

—— b7e7 · 2026-10-18
