oppry12102/WIFI7-TX/06_layout_design_notes/纪要_假管声明升级与CB标注互换勘误_2026-10-19.md

# 纪要 · 假管声明升级（裁定五十一 §五②）＋ 一处 C/B 标注互换的记录勘误

- 作者：b7e7（WiFi7-TX-电路设计）｜2026-09-19（本机 UTC 2026-10-19 00:2x）
- 起因：裁定五十一 §五②「四条 `gnd` 批准入册，**但建议把依据升级**——把这四只假管的 C/B 声明网
  补进 `NET_DECL`（或单列 `DUMMY_NET_DECL`），使它从「人工判读」变成「声明唯一解」。
  否则下一轮机械普查会反复把它们挑出来。**这是建议，不是门限。**」
- 结论先给：**升级做了，而且当场逮到一处真错**——v3.2 那四条标注的**依据文本 C/B 恰好互换**。
  标注本身仍在正确的 M1 簇上、网名仍是 `gnd` ⇒ **LVS/DRC 零影响，错的是「记录」**。
  本版把坐标与网名改为导出，这类错**结构上不可能再发生**。

---

## 一、实测证据（四条标注的落点究竟在哪）

`dd.p[pk]`（器件对象自报）与顶层 M1 连通簇归属回查，两条独立路径：

| 器件引脚 | 器件自报坐标 | 所属 M1 簇 bbox（µm） | 簇内 label | v3.2 依据文本 | 判定 |
|---|---|---|---|---|---|
| `d3L.C` | (−50.000, **+86.240**) | #39 `[−50.350,+85.929 ~ −49.650,+86.550]` | `gnd`@(−50, 86.24) | — | — |
| `d3L.B` | (−50.000, **+83.860**) | #38 `[−50.350,+83.550 ~ −49.650,+84.170]` | `gnd`@(−50, **83.87**) | 写着「假管 **d3L.C**」 | **Δ 2.37µm，且是 B 的垫** |
| `d3R.C` | (+50.000, **+86.240**) | #37 | `gnd`@(50, 86.24) | 写着「假管 **d3R.B**」 | **Δ 2.38µm，且是 C 的垫** |
| `d3R.B` | (+50.000, **+83.860**) | #36 | `gnd`@(50, 83.87) | 写着「假管 **d3R.C**」 | 同上 |

- 四个 C/B 焊盘各属**独立**的 M1 连通簇（0.70×0.62µm），每簇恰好一条 `gnd` 标注 ⇒
  补标在**覆盖上**是对的（㉓ 可判率 100%、异网对零硬档不变）。
- 错的是**记录**：任何人照 v3.2 的依据文本去查「d3L.C 的垫在哪」，会得到 83.87，
  而真值是 86.24。两条依据整体互换了一格。
- **为什么当年没被抓住**：自检台第 ⑦ 项比的是 `NET_DECL` **声明**（假管根本没声明），
  ⑬ 比的是「簇里有没有别的网名」（只有 `gnd`，通过），㉓ 比的是连通簇有无网名（有，通过）。
  **没有任何一项会去核对「依据文本说的是哪只脚」**——这正是「人工判读」的结构性盲区。

---

## 二、本版改动（`gen_M2_mix_v33.py`）

1. **新增 `DUMMY_NET_DECL`**（单列，不并进 `NET_DECL` 字典字面量）：

   ```python
   DUMMY_NET_DECL = {"gnd": [("d3L","C"),("d3L","B"),("d3L","E"),
                             ("d3R","C"),("d3R","B"),("d3R","E")]}
   for _net, _ts in DUMMY_NET_DECL.items():
       NET_DECL.setdefault(_net, []).extend(_ts)      # **按键**并入，不写死 gnd
   ```

   依据不是我的判断，是**网表逐字**：块级 LVS 输入网表里
   `QXd3L gnd gnd gnd 0 npn13G2 … $ cdl Q5` 与 `QXd3R … $ cdl Q6`。
   组长 2026-10-18 09:49Z §二已点名收编：「15Q（含 `QXd3L/QXd3R gnd gnd gnd` **补画**）…
   37/37 逐器件拓扑+参数全等」。

2. **`DEV_NETS` 增补 `"d3L"/"d3R": ("gnd","gnd","gnd")`** —— 让普查与 ⑬ 能给这六只脚定网。

3. **四条补标改为导出**：坐标取 `round(dd.p[pk], 3)`、网名取声明表，查不到唯一网名即 `assert`。

4. **新增 `_dummy_decl_assert()`**（三环）：
   ① 每脚声明网唯一且与 `NET_DECL` 一致；
   ② C/B 的补标坐标 **==** 器件自报引脚坐标；
   ③ 与**块级 LVS 输入网表**逐字对上（按 `.subckt` 行**内容**挑文件，不按文件名猜）。

5. **配套网表 `mix_subckt_LVS输入_v3.sp`**（`.subckt/.ends` 改 V33，余 83 行逐字不动）——
   律 F14：登记版本须同时登记配套 LVS 输入网表。**缺了它，第③环会当场报错**（已实测）。

---

## 三、零改动证明

| 项 | v3.2 | v3.3 | 判据 |
|---|---|---|---|
| 图形（drawing 矩形，含制造层/keepout） | 434 | 434 | 仅旧有 **0** / 仅新有 **0** ✅ |
| 文本（label，/1 与 /25 各一份） | 217 | 217 | 新增 4 / 删除 4 —— 全是同四条 `gnd` |
| 唯一位移 | — | y 83.87 → **83.86**（10nm） | 落回 B 引脚**真中心**（83.860） |
| `check_layout_gen` | ok=true | ok=true / issues=[] | 20 项全绿，㓂 82 标注 86 |
| `preflight` | PASS | PASS | 器件 82 / 标注 86，零短路、零悬空、零同名分裂 |
| `lvs_source_audit` v3 | — | ok / issues 0 | `pair(v2,v3)` 拓扑等价 PASS |
| ㉓ | 0 硬 / 2 软 / 0 不可判 | 同 | 带金属 30 × 顶层 M1 90 |

> 10nm 位移只影响**标注位置**，不涉及任何金属；两条 B 标注仍在本焊盘内（垫 y 83.550–84.170）。

**普查侧的独立印证**（`probe_nameless_m1_b7e7.py`，47 个 M1 簇）：

```
簇[-50.35,85.929,-49.65,86.55] names=['gnd'] pins=[['d3L.C', ['gnd'], -50.0, 86.24]]
簇[-50.35,83.550,-49.65,84.17] names=['gnd'] pins=[['d3L.B', ['gnd'], -50.0, 83.86]]
簇[ 50.35,85.929, 50.35,86.55] names=['gnd'] pins=[['d3R.C', ['gnd'],  50.0, 86.24]]
簇[ 50.35,83.550, 50.35,84.17] names=['gnd'] pins=[['d3R.B', ['gnd'],  50.0, 83.86]]
```

每簇的**标注网名**与**声明网**现已同源可查 —— 这就是「声明唯一解」的字面意思。

---

## 四、负向测试（断言有没有牙）

| # | 破坏方式 | 结果 |
|---|---|---|
| N1 | 把 `d3L.C` 的声明网改成 `nswa` | ✅ `AssertionError: d3L 与块级网表不符：网表 ('gnd','gnd','gnd') vs 声明 ('gnd','gnd','nswa')` |
| N2 | 复刻 v3.2 的手抄错（C 标注写到 83.87） | ✅ `AssertionError: d3L.C 补标坐标 (-50.0, 83.87) ≠ 引脚真坐标 (-50.0, 86.24)` |
| N3 | 删掉配套网表 v3（只剩 v1/v1b/v2） | ✅ 按内容挑不到 `.subckt == TX5G_M2_MIX_V33` ⇒ 大声 WARN 并跳过核对（不静默） |

**N2 就是本轮那个真错的复刻** —— 同样的手抄，在 v3.2 会静默通过，在 v3.3 当场炸。

### 自曝：合并时把键写死过一次

第一版我写成 `[t for _n, ts in DUMMY_NET_DECL.items() for t in ts]`（**丢掉了键**），
N1 立刻暴露：改 `DUMMY_NET_DECL` 的网名后两张表各说各话，而断言只在一边响。已改为按键并入。
教训与 v22 那次「静默兜底把错藏起来」同源：**能跑通 ≠ 口径对，负向测试才是判据。**

---

## 五、查实但**未**自行改动的一件事（只作提案）

`SP_ANCHOR = design/chain_top_tb_v015_1.sp :: gilbert_mix` 实测**只有 9 只 npn13G2**
（4 只 gm + XQs + XQ3..XQ6），**既无 `d3L/d3R`、也无 `XBI1/XBI2` 镜像组**，
且 `XQs` 的 B/E 写 `0`；而组长真跑 LVS 用的块级网表有 **15 只**。

⇒ `DUMMY_DEVICES = {"d3L","d3R"}` 这个排除**是锚的局限，不是声明缺失**（原注释只写「占位件」，
误导了本口一轮）。本版把理由查实写死在代码注释里，并另立 `DUMMY_NET_DECL` 补上声明缺口。

**提案（请裁定，本轮不动）**：把 ⑦ 的锚改到块级网表，即可让假管与镜像组也进 ⑦ 的逐器件核对。
**但我不自行做**，因为它同时会把下面第六节那条**已收编**的命名分歧翻成 FAIL。

---

## 六、留痕：一条**已收编**的命名分歧，请勿"顺手修"

对 15 只 npn 做三方对表（提取 cdl `pex_mix_v31.cdl` × 块级网表 × 版图 `DEV_NETS`）时，
只有 XBI1 组两行不一致：

| cdl Q | 器件 | 提取 cdl | 块级网表 | 版图声明 |
|---|---|---|---|---|
| Q7 | XBI1_XQo | `ntaila nref gnd` | `ntaila ntaila gnd` | `ntaila nref gnd` |
| Q8 | XBI1_XQr | `nref nref gnd` | `ntaila ntaila gnd` | `nref nref gnd` |

**这不是网表错**：版图上 XBI1 组 XQo/XQr 的 C=B 与 `ntaila` 同属**一个 M1 域**（域 M1:6 双标签），
sch 按轨名单名转录 = 组长 2026-10-18 09:49Z §二「**正确口径** · **不另开议题**」；
提取 cdl 取的是该域的局部名 `nref`。两者指的是**同一物理域**，不是拓扑分歧。
⇒ 我第一版对表脚本把它报成「网表行错」，**是我判据缺了这条已收编口径**；已撤销该判据，
并把口径写进 `gen_M2_mix_v33.py` 的 `NET_DECL` 注释里，**防止下一个人（包括我）去"修"它**。
（XBI2 组 Q9/Q10 三方全等，不在此列。）

---

## 七、件（sha256 前 16 位；已上 8510 `design/sow6/`，按名 GET 回读逐位一致）

| 件 | sha256 | 说明 |
|---|---|---|
| `gen_M2_mix_v33.py` | `159b316fb8adae49…` | 假管声明升级 + 导出补标 + 三环自证；取代 v32 |
| `mix_subckt_LVS输入_v3.sp` | `ffb1c9d17850d32a…` | `.subckt TX5G_M2_MIX_V33`；余 83 行与 v2 逐字相同 |

配套（不变）：`lib13g2` `3ab35cde…`（⓪ 库闸）、`resgeom`、`cbpath`、`emitpath`、`hbtgeom`。

## 八、请裁定/回件

1. **v33 无需单独跑**：图形零改动，只挪了 2 条标注 10nm ⇒ 可与下一轮 mix 复核合并跑。
2. **第五节提案**（⑦ 改锚到块级网表）：要不要做？我倾向做，但必须与第六节口径同时定。
3. mix v31/v32/v33 的**面锚**换不换（律 F14 配套登记已齐：v31→v1b、v32→v2、v33→v3）。
