oppry12102/WIFI7-TX/06_layout_design_notes/M5第六受害面真短判读分支_2026-10-18.md

# M5 第六受害面（版图系统性真短 8 案）· 判读分支立档 ＝ 裁定十二

- 立档人：fde9（WiFi7-TX-仿真验证）
- 立档时间：2026-10-18T04:57Z
- 来源：b7a0 来信 `2026-10-18T04:56:07Z`（inbox.jsonl 第 98 行）——知会件，**无请求项**
- 处置：**收讫落档，不回信**（知会无请求项；回信反成噪声）
- 性质：**过程件** ⇒ **不单独投 8510**，随下批夹具包同走（同 04:19Z 立档件处置口径）
- 前序：05 分钟前同源来信 `04:31:31Z`（第五受害面 R P2）已立档 → §3.1

## 一、对方原文要点（逐条留痕，不改写语义）

1. **定谳第六受害面 = 版图系统性真短 8 案**：C = B 竖线压 E 指底座，
   **M1 满宽 0.4665µm² 交叠 ×8**；对方已**独立复核 8/8 复现**。
2. **与我直接相关之一（物理释因）**：**nsens↔gnd 真短（mix `XQs @(52,118)`）**
   ＝ **我方 OP 无解 `xmi.nsens` 的物理解释候选**（nsens 对地短路 → 偏置奇异）。
   **M5 门 2 若因 nsens FAIL ＝ 物理真实，非链故障**，照常停线报告即可。
3. **与我直接相关之二（裁定十二 · deck 修复重提期判读增补）**：
   8 案真短会以 **b↔gnd / c↔gnd 连通 FAIL** 首次可见 ＝ **预期中间态，非回归**；
   门1/A0 FAIL 清单落在 **`nref`↔`gnd` ×7 + `nsens`↔`gnd` ×1 及 R P2 悬空** ＝ **预期项**。
4. **27 角点火顺延**：v19/v18 版图重提（deck 修复）双门 FAIL ＝ **预期不点火**；
   **v20 回改版（回改清单 15 项 ＝ nx3 + R P2×4 + 真短 8）重提后双门过才点火**；
   20:35:54Z 预授权**顺延至 v20**。
5. **判据器 ca38d0f3 仍不改**（真短不属六判据）；重提期 merged-domain 若现
   `nref|gnd`、`nsens|gnd` ＝ **真短呈现预期项**，判读记「**预期-真短**」**单独记账**。
6. **其余不变**：守候工人 `poll_pex_cdl_fix.py` 继续；cdl 到货流程（存锚 → 代入 → A0 → E）不变；
   九件包候窗随批投不变。

### 一.5 一致性自检（不推算，只核对对方明示数字）

- 回改清单：**上轮 7 项（nx3 + R P2×4）→ 本轮 15 项（nx3 + R P2×4 + 真短 8）**，差值 8 = 真短案数 ✅ 自洽。
- 真短 8 案 网别分布：`nref`↔`gnd` 7 条 + `nsens`↔`gnd` 1 条 ＝ **8 条** ✅ 自洽（无漏项/无计数歧义）。
- 五、八两案表述为 b↔gnd/c↔gnd 连通 FAIL，与 nref/nsens↔gnd 清单同族不矛盾 ✅。

## 二、我侧落档动作

| 项 | 动作 | 结果 |
|---|---|---|
| runbook | `runbook_v2.5.md` 新增 **§3.2 第六受害面·真短 8 案的判读分支**（含**预期 FAIL 分类表** 3 行）；版本抬头补 **v2.5.1** 行；§四 标题加点火版本门注 | ✅ 已落 |
| 点火门槛 | §3.2 内写死：**仅 v20 回改版**双门过才点火（取代「双门过即点火」）；v19/v18 **只取证不点火** | ✅ 已落 |
| 回执条款 | 预期项回执**单独记账**（「预期-真短」/「预期-R P2」）、附网名、**不写链故障措辞**；粘连案消散（判据①③④）**独立判定照常** | ✅ 已落 |
| 判据器 | **ca38d0f3 不改**（遵对方令；真短不属六判据） | ✅ 未动 |
| 现役脚本 | 本口**未改任何现役脚本**（轻活；停线期） | ✅ |
| 三 cdl | 只读，**未触碰** | ✅ |
| 回信 | **未回信** | ✅ |

## 三、我侧口径（两处我须自明的判断，均取保守侧）

1. **v19/v18 deck 修复版「即便双门意外 PASS 也不自点火」**——
   对方原文明写的条件是「双门 FAIL＝预期不点火」「v20 双门过才点火」，**未直写「v19 双门过如何」**。
   我按**预授权已顺延至 v20**这一明示事实取保守侧：**预授权只覆盖 v20**，
   v19/v18 即使双门过也属偏离预期 ⇒ **停线报 b7a0**，不由我自裁点火（不拿 6.3h/5.3GB 赌假设）。
2. **门2 nsens FAIL 的措辞**——对方定性为「物理真实非链故障」，
   回执据此写**物理真实**（并点明 nsens↔gnd 物理解释），**不写链故障措辞**，
   同时**不把它当作粘连案回归的证据**（粘连案消散独立判定）。

## 四、纪律对照（无歧义项自查）

- **不自行选口径**：真短处置（版图回改）由 b7e7/b7a0 走，我不预判、不自跑网表级短接 stub。
- **不调参**：真短/R P2 均不属参数面，27 角任何参数不动。
- **不自行点火**：点火顺延由对方明示，照办；我不提前、不并行、不抢窗口。
- **不自行扩归档范围**：本件与 §3.1 件同批投，不单投。
- **停线维持**：候件未到 ⇒ 门1/门2/27 角维持停线。

## 五、候件实查（本口 2026-10-18T04:56Z）

8510 `design/sow6/`：**602 件**（较上口 594 增 8 件，非 cdl）、**cdl 仍仅 3 件**，
三件 sha **全 = 基线冻结值**：
`pex_mix_v27.cdl` 2474B `33e9e754`｜`pex_drv1_v19.cdl` 939B `ae4feb76`｜`pex_drv2_v19.cdl` 1559B `1f5e0cd8`
⇒ **deck 修复版未到货**（v19/v18 与 v20 均未到）⇒ A0→E 不启动、27 角不点火。
守候工人 `poll_pex_cdl_fix.py` pid 4947 在跑 **1h50m**，3h 超时铃约 **06:06Z**。
资源：/data 余 **19 G**（29G/50G）；内存 available ≈ **2 G** ⇒ 点火期严禁并行重活（现为停线期）。

## 六、runbook 本次改动指纹

- 改后 `runbook_v2.5.md` = **21866 B**、sha256 `a7c278b6167595d18430e29da66e389c9b802a9fe02c897aa9931bbf484d2625`、275 行
- 改前 = 18420 B（§3.1 后）。本件与本 runbook 改动**随下批夹具包同投**，届时报前当场 sha256sum。
