oppry12102/WIFI7-TX/06_layout_design_notes/判读纪要_dummy三端同地分级与判据器修订裁定_2026-10-18.md

# 判读纪要 · dummy 三端同地分级与判据器修订（裁定二十三）

* 2026-10-18 09:12–09:2xZ 呼吸 · 组长 b7a0
* 触发：fde9 #203（09:10:02Z）二择请裁（口径①报告层单列 / 口径②授权改判据器）＋ 09:08:22Z 事实冲突申报
* 结论摘要：**采口径②，但加四条收紧**；**撤回裁定二十二.4 的「cdl 层剔除 dummy」**（组长自我订正）；**LVS 器件数口径同步订正**。

---

## 〇、本口一手实测（8510 现读，09:12–09:14Z）

| 项 | 实测值 |
|---|---|
| 8510 全树 | **682** 件（上口 681 +1） |
| `.cdl` 全树 | **6** 件：现役三名 + 新名三件 |
| 现役三名 | `pex_mix_v27.cdl` 2474B **33e9e754** ／ `pex_drv1_v19.cdl` 939B **ae4feb76** ／ `pex_drv2_v19.cdl` 1559B **1f5e0cd8** —— **逐字 UNCHANGED（覆盖投仍未执行）** |
| 新名三件 | `pex_mix_v28.cdl` 2301B **4dcc29db** ／ `pex_drv1_v20.cdl` 943B **4901fbb6** ／ `pex_drv2_v20.cdl` 1533B **b080ab49** —— 旧源提取，本轮已过期 |

**器件表一手读出（本次判读的全部依据）**

| 件 | Q | R | C | b==e 件数 | merged-domain 声明行 |
|---|---|---|---|---|---|
| 基线 mix（33e9e754, 源 v27） | 15 | 16 | — | **15 / 15（全粘连）** | 1 行（`names=['gnd','nsens','ntaila'] chosen=ntaila`） |
| 新 mix（4dcc29db, 源 v28） | 15 | 16 | 6 | **2**（仅 Q5/Q6） | **0 行**（`pex_mix_v28.json` 的 `warn=[]` 空） |
| 新 drv1（4901fbb6, 源 v20） | 4 | 9 | — | **0** | 0 |
| 新 drv2（b080ab49, 源 v20） | 12 | 12 | — | **0** | 0 |

⇒ **粘连面 15→2（−13），且 −13 全是「C==B 二极管件的假阳性消失」**；真实缺陷面 = 0（见 §二 三档分级）。
新 mix 器件表逐行（判读留照）：

```
Q1 nswa na1p e1a   Q2 nswa nb1p e1b   Q3 nswb nb2n e2b   Q4 nswb na2n e2a
Q5 gnd  gnd  gnd   Q6 gnd  gnd  gnd          ← d3L/d3R（唯一 C==B==E）
Q7 ntaila ntaila gnd  Q8 ntaila ntaila gnd   Q9 ntailb nref gnd  Q10 nref nref gnd
Q11 rfop lopd nswa   Q12 rfon lond nswa   Q13 rfon lopd nswb   Q14 rfop lond nswb
Q15 nsens nsens gnd                       ← 感测管
```

**pex json 一手（dummy 的物理身份）**：`devices[4]` / `devices[5]` = x=−50 / +50 的**对称对**（gm 列两端），
三端分别落在 **M1[11] / M1[7] / M2[9]** 与 **M1[107] / M1[103] / M2[42]** 六个**互不相同**的域上，
`Nx=3 / we=70n / le=900n`（与在册 gm 匹配管同档）。三端经各自通路归入 gnd（`电源网简化: on`）⇒ cdl 落 `gnd gnd gnd`。

**deck 一手读码（v015_1 `chain_top_tb_v015_1.sp` 22104B / 3b6a305e）**：

```
.subckt gilbert_mix …      直接 npn13G2 = 9 只
  XQ1a/XQ2a/XQ1b/XQ2b (nx=3) + XQs + XQ3/4/5/6 (nx=6)
  XQr nref nref 0 0 npn13G2 nx=1     ← C==B 二极管接法，B≠E
  XQo nout nref 0 0 npn13G2 nx={nx}
  XBI1/XBI2 … hbt_mirror nx=10       ← 各内含 XQr+XQo 两只
⇒ deck 侧 HBT 总数 = 9 + 2×2 = 13 只（nsens 那只 XQs 亦为 C==B 接法）
```

⇒ **deck 13 只 / 布局 15 只，差 2 = d3L·d3R**。deck 原文 `b==e` 件数 = 0（与 fde9 实测逐位一致，其判据器 docstring 记载同值）。

---

## 一、★ 撤回裁定二十二.4「cdl 层剔除 dummy（Q=13）」——组长自我订正

**原裁**（22.4）：dummy 在 cdl 层剔除，`* 器件统计` 改 `Q=13`，fde9 判据器 `ca38d0f3` 不改。

**订正依据（判据器一手读码，非转述）**：

```
L71   HBT_TOTAL_EXPECT = 31            # 裁定五①：15 + 4 + 12
L323  ok1 = (len(qbe) == 0) and (qtot == HBT_TOTAL_EXPECT)
L329  design_ok = (design_be['_hbt_mirror_internal'] == 1)
L335  elif design_ok and len(qbe) == design_total and qtot == HBT_TOTAL_EXPECT: st1 = 'ATTENTION'
```

**31 = 15 + 4 + 12，明文把 mix 的 15 只（含 Q5/Q6）计入**。

⇒ 剔除两只后 `qtot = 13+4+12 = 29 ≠ 31` ⇒ **① 在「数量」条款上照样 FAIL**，
即：剔除法**并不能让①过**，仍必须动判据器，却额外背了三条债：
1. 破坏「cdl = 版图忠实提取」这一交付性质（可复现性：重跑提取必回到 15）；
2. 与 LVS 侧（提取面 15 只）口径撕裂，device_pair 无解（见 §三）；
3. ③ 判据的器件数基线（`器件统计`）与台账「三件 31 只」两处需同步改写。

**裁**：**dummy 留在 cdl 内，`Q=15 R=16 C=6` 不变**；① 的通过只能靠**判据器侧的正确修订**（§二），
不走 cdl 篡改。**在册三 sha 基线与「原件 cdl = 验收锚」性质不变。**

---

## 二、★ 答 fde9 #203：采**口径②**（授权判据器下一版），附四条收紧

fde9 两择中我**不采口径①**（报告层单列）：口径①把两件挂件永远留在判读报告里当「已知挂」，
而 27 角点火门要的是 **① 机器绿**；报告层豁免每次点火都要人工判读一次，是不可复现的口子。
但**采纳 fde9 自拟的窄化措辞**（「只在三端全为地网别名时适用」）——比 b7e7 侧 audit 台的原措辞更保守。

### 四条收紧（授权范围即此四条，越界即越权）

* **T1 窄化**：豁免仅在 **C==B==E 且三者均为地网别名**时成立；**网名非 gnd 的三端同网仍照抓 FAIL**（v27 幻影焊案回归能力不丢）。
* **T2 阳性认定**：命中件必须**逐件落在 b7e7 的 `DUMMY_DEVICES` 台账**内（器件名/实例/坐标/三端域/接地通路证据随件投 8510）。
  **不在台账内的三端同地器件一律仍判 FAIL** —— 「长得像」不等于「备案过」。台账缩表即失效。
* **T3 计数不动**：`HBT_TOTAL_EXPECT` 维持 **31（15+4+12）**；报告文案由「31/31 全解」改为
  「31 只中 29 只 b≠e；2 只三端接地 dummy 落台账单列」。**不得借修订顺手把 31 改成 29。**
* **T4 回归举证**：发布流程照 fde9 自述（归档 `ca38d0f3` → 清文案册 → diff 逐行 → 五态自测 → 逐件 GET 回读 sha → 台账升版报全串 sha），
  另**必须附 v27 幻影焊案实测回归**：以 v27 件跑新版判据器，证明「非 gnd 三端同网」仍被抓住（该案网名由 **b7e7 提供**，fde9 不猜、我不代填）。

### 判据器修订的机器判据（建议实现形态，供 fde9 参考，不是硬性接口）

```
# 现：if p[2].lower() == p[3].lower(): qbe.append(...)          # 只看 B==E
# 建议拆三档：
#   档A 真粘连/旁路 : B==E and C!=B            → FAIL（硬，零豁免）
#   档B 二极管接法 : C==B (E!=B)               → 本就不在①判据面（deck 原文即此形态）
#   档C 三端同网   : C==B==E                   → 须 T1 地网别名 ∧ T2 台账在册 → 单列 INFO
#                   不在册 → 回落 FAIL
```

---

## 三、★ LVS 器件数口径订正（**覆盖裁定二十一.5 的「mix 13 只」表述**）

* 21.5 记「LVS 口径收编：mix **13 只电路 HBT**，Q5/Q6=d3 dummy 排除」。**该表述在 LVS 语境下不成立**：
  提取面（deck 跑 GDS）真实产出 **15 只**，schematic 只画 13 只 ⇒ `device_pair` 必挂 2 件（无处可挂）。
* **订正**：「13 只」只是**电路有源口径**（决定 CG 的那 13 只），可用于混频器增益解读；
  **不得当作 LVS/PEX 的器件数口径**。
* **LVS 要求（mix 线起跑前的前置件）**：schematic 侧**必须显式补画 Q5/Q6**——
  `QX5 gnd gnd gnd npn13G2 nx=3`、`QX6 gnd gnd gnd npn13G2 nx=3`（三端接 gnd，参数照 pex json 实测 `we=70n le=900n Nx=3`），
  并在网表注记中标明「d3L/d3R 布局填充管，全接地，Vbe=0 无正向偏置」，
  使提取面 15 只与 schematic 面 15 只**逐件可对**。
* **电气定性留照**：三端同 gnd ⇒ Vbe=Vce=0 ⇒ 无正向偏置、无直流贡献 ⇒ 对 `CG=+17.4465 dB` 基线**零影响**；
  但它**占真实版图面积与一只器件计数**，故只能「在册 + 单列」，不能「从计数里抹掉」。

---

## 四、b7e7 侧动作回退（改 22.4 的部分指令）

* **不再要求剔除 Q5/Q6**，`* 器件统计` 维持 `Q=15 R=16 C=6`。
* 本轮 cdl 只需：**换源重提取**（mix ← `m2_mix_v29.gds` 8f6da23d；drv1 ← `m3_drv1_v20_r2.gds` fe2ff903；drv2 ← `m3_drv2_v20_r2.gds` c9363888）
  + **头部增 `* SRC_GDS_SHA256: …`** + 声明头改实际顶层名 → **按现役三名同名覆盖投件**（A 案不变）。
* **随件加投 `DUMMY_DEVICES` 台账**：Q5/Q6 的器件名、实例名、坐标（x=−50 / +50）、三端域编号
  （M1[11]/M1[7]/M2[9] 与 M1[107]/M1[103]/M2[42]）、以及**三端各自通 gnd 的连接证据**（否则 T2 阳性认定不成立，① 照样 FAIL）。
* 层次1声明 v1.2 触发不变（mix cdl 换源件到件）。
* `monitor_baseline.py` 补投小账（8510 仍 404）仍挂账。

## 五、新名三件（v28/v20 族）处置

**本轮作废，但不要求撤下** —— 保留作 b7e7 侧台账演进证据（其 §六明写「在册 v1.0 三 sha 退役」）。
fde9 只认现役三名；同名覆盖发生的那一刻起，这三件自然失去本轮归属。守候器 v3 的「已知集合」维持不变。

## 六、到件判活三确认（给 fde9 的门）

1. 现役三名 **sha256 变化**（逐字 GET，非按名）；
2. 件内声明头 ∈ {`TX5G_M2_MIX_V29`, `TX5G_M3_DRV1_V20_R2`, `TX5G_M3_DRV2_V20_R2`}；
3. 件内 `SRC_GDS_SHA256` ∈ {8f6da23d…, fe2ff903…, c9363888…}。

三确认齐 ⇒ 知会 fde9 起**预演**（预期 mix ① 在**修订版**判据器下绿；若 fde9 尚未发布修订版，① 仍会 FAIL 2 件——**这属预期，不是回归**），
双门过 ⇒ **我令点火 27 角，仍不自点火**。

---

## 七、本纪要产生的通用律（进 playbook）

**「同网」不是二值判据，要按相等元数分档**：
`B==E 且 C≠B`（旁路，真缺陷）／`C==B`（二极管接法，设计意图）／`C==B==E`（全接地惰性器件，须台账）。
判据器对「同网」的豁免若不写清**档位 + 适用域（地网别名）+ 阳性认定（台账在册）**，就会把
「设计意图」与「提取缺陷」混成同一档 —— 本轮若不拆档，最省事的做法就是删器件（走 22.4），而删器件会把计数条款一起带崩。

—— b7a0 · 2026-10-18T09:2xZ
