oppry12102/WIFI7-TX/06_layout_design_notes/判读纪要_RP2根因定谳_镜像定谳收编_2026-10-18.md

# 判读纪要 · R P2 根因定谳 + 镜像定谳收编（裁定十六随附）

**b7a0（组长）** · 2026-10-18 06:4xZ · 收编来源：b7e7 #190 信三件（R_P2_断路根因与普查报告 a900d902 / 真短定谳_回改候补名单 §四补订版 19b46caa / deckfix_备料报告 67f39fc6＝上口同版重投，diff 空）· 组长侧独立细读后裁定

---

## 一、R P2 断路根因定谳（第五受害面收口）

- **机制**：emitpath P2 引脚距公式 `y_p2 = y_p1 + 1.56` 只对 rppd 档成立（GDS 逐位实测：rppd=1.56 / rsil=1.40）；rsil 件 stub 从公式点起画 → 悬在焊盘顶上方 **0.03µm**，同层无 via 跨接 → 直流断路。
- **调用序佐证**：place_emit_chain（画 stub）先于 mkres（放 PCell），`Re.p["P2"]` 真值从未回填——**公式锚定，非 enclose 漏算**（与上口疑点③「gen 电阻出脚漏算?」对上：是引脚距档位错，更precise的答案）。
- **修法（v20）**：先 mkres 后 place_emit_chain，stub 从 pin 真值锚定 + 断言 |公式−真值|<0.005 防回归。
- 与 E 回流 0.085µm 缝**同族不同根因**（同＝emitpath 预估偏差型断路；异＝0.085 是 via 焊盘 enclose 认知差、v19 已修；0.03 是 P2 引脚距档位错、进 v20）。
- **普查定谳：受害面＝Re1/Re2 ×2 件共 4 条，显形即全部**（mix 不走 emitpath 从 pin 真值画线＝天然免疫，反向印证；Rin/Rb/RL/mix 其余全连通）。

## 二、裁定十六：drv2 v3 网表 RRin 化石回改案

- **案情**：drv2 LVS 输入 v3 两行 `RRin1 inp XBI1/nref` / `RRin2 inn XBI2/nref` ＝ 真短并域化石——版图真值 Rin P2 接 gnd 轨（gen §7 cross+M4 直下，有意画到地）；并域时代 cdl 提取名 nref＝nref|gnd 同域呈现，v3 把并域名烙进了原理图。v1 原稿 `inp 0`（端接到地）＝设计意图正确。
- **裁定：批准回改，时机绑定 v20**——
  1. **现役 v3 不动**（v18/v19 并域现实下对拍自洽；v20 前擅动＝破坏对拍基准一致性）。
  2. **v20 GDS 到货同批出 drv2 sch v4**：两行回改 `inp 0`；LVS 标准输入对升「**v20 GDS + v4 sch**」。
  3. **随件证据三件套**：①v1→v3 两行演化对照（证 v3＝化石非新意图）；②v3 全量并域化石普查（涉 nref/并域名呈现的行全列，预期仅此两行）；③电路意图注记一行（Rin 端接＝gnd 设计依据：v1 原稿引文 + spec 对应节）。
  4. **drv1 侧核对**现役 sch 该两行当前值，随件声明（v1 已是 inp 0 则声明即毕；若 v3 也动过则同批修）。
  5. **sim 侧不受影响**：pex 提取件（验收锚三件）Rin P2 网名 nref→gnd 归位、Re P2 接上 ntail、真短 8 案断开——全部列入 **v20 重提判读预期（预期修复项）**，非判据器故障；A0→E 链与六判据不动。
- **理由**：原理图是对拍基准，基准回改必须全链路留痕；「原理图迁就版图」仅限**化石订正（恢复 v1 意图）**，不得引入新语义。

## 三、收敛纲领认可（v20 合并执行）

板级 M1 竖线（Board.wire_v 缺省 w=0.30 族）两律：
1. **pin 真值锚定**：一律从 mkpc_at 返回真值锚定，禁公式预估（P2 档位错教训）；
2. **避让清单**：布线律带 E 指 x 列 ±0.35 避让（C=B 竖线教训；一断路一短路，同一真值脱钩家族）。

15 项回改候选按纲领统一出修复件，不按案分修。**此律即日写入 M4 设计输入**（M4 顶层板级连线直接适用）。

## 四、镜像 4 只定谳收编（真短定谳 §四补订版 19b46caa）

- XQ1/XQ2 @±24,179.24：C/B 带 0.0000µm²——ccas 外折 4µm 通道避开 B 脚头，初判作废维持。
- XQ3/XQ4 @±24,191.24：C 带 0；B 带压块 0.168µm²×2 ＝ **nbcas cross M1 底盘**（gen L561 cross 件）压自家 B 带＝**同网合法连接非短**；pex 域号互证（B node=M1:29 五名域含 nbcas）。
- 方法论点名：diag_mirror_q.py 三重交叉（gdstk flatten 权威变换 + pex terms 真值重建 C/B 带 + 域号核对），规避手工变换——**镜像/旋转变换类检查一律照此配方**。
- **裁定十二清单 v2 维持 15 项数目不变**。

## 五、DRC 归属收编 + v20 判读预期增列

- 0.03µm 缝＝**M1.b（Metal1 space/notch 0.18）桶内成员**，基线 drv1 v14 ×2 + drv2 v13 ×2 坐标逐位在案，**非新增**；0.085µm E 缝同桶。组长上口「三疑点核」之 DRC 疑点就此销账。
- **v20 判读预期增列：DRC M1.b 桶 −4**（两缝缝合 ×2 件）——v20 DRC 对拍时核销。

## 六、现状同步（组内对表）

- **deckfix_v3 已落码现役**（05:3xZ，五局回归零 delta；PDK 原件 03fa1f8a 不动，patched 584ab4ea）——v20 GDS 到即跑 deckfix_v3 LVS×v4 对拍，粘连闭环判读＝合并域归零 + bulk 对上 v3/v4 + R$13/14 归位 + 六判据过 +（增列）M1.b −4。
- b7e7 待交三件：①重提 cdl 三件（pex_extract TERM_LAYER 修复版跑现有 GDS，主闸门）②v20 回改 GDS（15 项纲领统一出件）③cell 名升版计划（⑨承诺下一信附）。

—— b7a0 · 2026-10-18（本纪要即裁定十六正文载体）
