oppry12102/WIFI7-TX/06_layout_design_notes/判读纪要_裁定五十三_ntaila短接拓扑谱系断层_2026-10-19.md

# 判读纪要 · 裁定五十三 —— 「ntaila 短接拓扑」谱系断层（deck 内嵌副本与 mix LVS 网表都落后一面）

* 日期：2026-10-19 00:16–00:2xZ（UTC）
* 触发：我方在**执行律 F14（补 mix v31 的 LVS 配套网表）**时，撞上一个比「缺件」严重得多的问题
* 裁定人：b7a0（WiFi7-TX 组长）
* 一句话：**v31 面已修好 ntaila 短接，但链级 deck 的内嵌 mix 副本、以及 mix 的 LVS 输入网表，都还是修复前的 v29 拓扑。**

---

## 〇、结论（三层，逐层都要说清）

1. **正面确认**：裁定四十/四十二的「ntaila 修复」**在 v31 面上确已生效**——我方独立复核两份 cdl 的镜像簇节点：
   * v29 面（`8f6da23d` / cdl `ce97750b`）：`Q7 (ntaila ntaila gnd)`、`Q8 (ntaila ntaila gnd)`、`R5 (nvtop ntaila)`
     ⇒ **B=C=ntaila，真短接**
   * **v31 面（`ef034d51` / cdl `f6ba9560`）**：`Q7 (ntaila nref gnd)`、`Q8 (nref nref gnd)`、`R5 (nvtop nref)`
     ⇒ **短接解除、nref 独立成网** ✓ **修复确认生效**（与 `QR_L=12.0` 入 v31 的备案对得上）
2. **断层**：**链级 deck（`chain_top_tb_v015_1_pex_v34_wu_gate2_run.sp` `cb694761`，27 角族用的就是它）
   内嵌的 `gilbert_mix` 副本仍是 v29 面的短接拓扑。**
3. **连带**：mix 的 **LVS 输入网表 v1/v2 也是照 v29 面写的**（其头部自述：「版图真值 `m2_mix_v29.gds`
   （sha `8f6da23d`）→ `pex_mix_v29.json` → 换源件 `pex_mix_v27.cdl`」）⇒ **对 v31 版图跑 LVS 必然成片失配**。

---

## 一、我方实测（器件签名多重集比对，忽略器件名，只比 模型＋参数＋节点组）

| 比对 | 差异 | 差异内容 |
|---|---|---|
| deck 内嵌 mix vs **v29 面 cdl** | **6 条 / 39** | 全是 deck **保留件**替换：`RL1/RL2 45Ω`、`Lt1/Lt2 1nH`（及其 cdl 原件 `rsil l=6.429u`）⇒ **器件级同源** |
| deck 内嵌 mix vs **v31 面 cdl** | **12 条 / 39** | 上述 6 条 **＋ 镜像簇 6 条**：`Q7/Q8` 的 `(gnd,ntaila,ntaila)`↔`(gnd,nref,ntaila)`/`(gnd,nref,nref)`、`R5` 的 `(ntaila,nvtop)`↔`(nref,nvtop)` |

deck 关键行（`chain_top_tb_v015_1_pex_v34_wu_gate2_run.sp` 199–200 行区）：
```
XQ7 ntaila ntaila gnd 0 npn13G2 we=70n le=900n Nx=10     ← 短接拓扑（v29 面）
XQ8 ntaila ntaila gnd 0 npn13G2 we=70n le=900n Nx=1      ← 同上
```

---

## 二、mix v31 的 LVS：**首次真跑，且 FAIL**（附根因，不是 22 个独立缺陷）

### 2.1 先发现的**交付件缺陷**：mix 的 LVS 输入网表**从未通过官方 reader**

* 我方派生 `mix_subckt_LVS输入_v1b.sp`（V32→V31，其余不动）对 `m2_mix_v31.gds` 跑官方 deckfix_v3 配方 ⇒
  **报错**：`'Q' element must have three or four nodes … line 36`
* 逐行定位 ⇒ **根因不是节点数，是行尾注记**：该网表**每条器件行都带 `$ cdl QN` 行尾注记**，
  而 **KLayout 的 `Netlist::read` 不把 `$` 当行注释**（SPICE 行注释是 `*` / `;` / `//`）
  ⇒ `$ cdl Q1` 被当成**额外节点** ⇒ 报「节点数非法」。
* ⇒ **mix 的 LVS 输入网表（v1 与 v2）在官方 reader 下从未跑通过**。
  他的自检台（`lvs_source_audit` / `pair()` 拓扑等价）走的是**他自己写的 Python 解析器**，
  不经过官方 reader ⇒ 这类缺陷天然漏网。
  **⇒ 这是律 F15「交付件真跑背书」的网表版首例：有牙 ≠ 咬得着真件。**
* 派生件（我方，**未改他原件**）：`verify/mix_v31_lvs/v1b_nodollar.sp` —— 仅做两件事：
  **删 `$` 行尾注记（37 行）** ＋ **V32→V31**（`.subckt`/`.ends`）；器件行内容一字未改。

### 2.2 删 `$` 后：**官方 reader 解析通过，判读 FAIL**

| 项 | 值 |
|---|---|
| Status / Outcome | **FAIL**（`netlists do not match`） |
| net_pair | **34**：`Match 12` / **`Mismatch 22`** |
| device_pair | **36**：非 Match **23** |
| 版图侧提取 | `m2_mix_v31_extracted.cir` sha `c97aa381` |

### 2.3 失配主体已归因，**不是 22 个独立缺陷**

版图侧（v31 面）提取网表把 **`XBI1/nref`、`gnd`、`ntaila` 判为同一个电气节点**，
网名写成 `XBI1/nref|gnd|ntaila`（`/` 是 SPICE 层次分隔符）。
对照 schematic 侧（他的网表，写的是 **v29 面**）：

| 器件 | v31 面（版图侧，已修） | 网表侧（v29 面，未修） |
|---|---|---|
| Q7 | `(ntaila, nref, gnd)` | `(ntaila, ntaila, gnd)` |
| Q8 | `(nref, nref, gnd)` | `(ntaila, ntaila, gnd)` |
| R5 | `(nvtop, nref)` | `(nvtop, ntaila)` |

⇒ **22 条 Mismatch 的主体就是这一个结构性成因（镜像簇拓扑代差）＋ 网名/端口映射口径差**，
不是 22 处独立版图缺陷。**下一步应做 lvsdb 逐项归因，而不是按「22 个错」立案。**

---

## 三、影响界定（分清哪些结论不受影响、哪些不能混用）

| 结论 | 是否受影响 | 理由 |
|---|---|---|
| **裁定五十二：27 角族收口成立** | **不受影响** ✓ | 收口判据是**族内残差** `r = CG(corner) − CG(typ_t27_v2500)`，同族·同 deck·同拓扑 ⇒ 属同框架相减（律 F10 合规）。拓扑是全族共有的常量，在相减中消掉 |
| 27 角**族内相对结论**（温度/电压单调性、bcs 反向单调、中间温下陷） | **不受影响** ✓ | 同上 |
| **族内绝对值**（`CG_mix −27.38732467601408`、`CG_chain −6.77508964414243` 等） | **⚠ 对应「ntaila 短接」拓扑** | 它们是 deck 跑出来的，deck 用 v29 面副本 ⇒ **不得当作「v31 面锚（已修复拓扑）的链级性能」引用** |
| A1 基线 / B 批 / M5 各档 | **同上一行** | 同一 deck 家族 ⇒ 同属短接拓扑口径 |
| 现役 v31 面锚的**版图级**结论（DRC 225、cmim 全 775.202fF 等） | **不受影响** ✓ | 与拓扑无关 |

**⇒ 一句话**：**拓扑代差是全族共有的系统偏置，它不破坏「族内比较」，但会让任何「绝对值＝v31 面性能」的引用出错。**
**引用纪律（补入）**：凡引 deck 链级绝对值，必须写明「**ntaila 短接拓扑（v29 面副本）**」；
与 v31 面锚的数值**禁止跨拓扑相减**（律 F11 的面帽二维坐标要再加一维：**拓扑代**）。

---

## 四、裁定与交办

**裁定**：
1. **ntaila 修复在 v31 面确认生效**（正面结论，入册）。
2. **谱系断层登记入册**：链级 deck 内嵌 mix 副本 ＝ **v29 面（短接拓扑）**，落后现役面锚一面。
   **deck 不改**（它是 27 角族与各档基线的**装配凭据**，改了整族不可比）——
   **处置与裁定五十 A 档同型：冻结不换、补登记依赖**。
3. **mix LVS 输入网表族须按 v31 面重出**（不是补个名字就够）：
   请 b7e7 出一份**内容取自 v31 面**的 `mix_subckt_LVS输入_v1b.sp`（并**去掉全部 `$` 行尾注记**，
   或改用 `*` 独立注释行）。**在那之前 mix v31 的 LVS 状态如实标「未通过」**，不得引用任何 mix LVS 结论。
4. **M5 主基线**：若要代表**修复后**设计，须先把 deck 的 mix 副本更新到 v31 拓扑（Q7/Q8/R5 三只）
   并**重跑 A1 档**；**在此之前 M5 链件一概不动**（口径不变，本轮再次确认）。

**交办**：
* **b7e7**：①按 v31 面重出 mix LVS 网表（去 `$`）；②确认 deck 内嵌副本用 v29 面副本是**有意**还是**遗留**
  ——这是**意图问题**，我不替他裁；③`ptap1`/面锚等其余不变。
* **fde9**：①27 角族**收口不受影响**，照裁定五十二执行即可；②凡引族内**绝对值**，回执与报告加注
  「**ntaila 短接拓扑**」；③mix LVS 现状标「未通过」，勿引用。
* **配套登记（律 F13 的第三种形态）**：**deck 内嵌副本的源面必须随 deck 登记**——
  本轮若非我逐器件比对，`cb694761` 这个 deck 的「mix 段来自哪一面」在台账上是空白。

---

## 五、产出与留痕

| 件 | 说明 |
|---|---|
| 本纪要 | 已上 8510 `design/sow6/` |
| `verify/mix_v31_lvs/v1b_nodollar.sp` | 我方派生件（删 `$` ＋ V31 名），**他原件零改** |
| `run_v2/lvs/deckfix_v1/out_drv2v20_mixv31nodollar/` | mix v31 首次官方 LVS rundir（FAIL 留痕，`extracted.cir` sha `c97aa381`） |
| `run_v2/lvs/deckfix_v1/out_drv2v20_mixv31lvs/` | 首次尝试 rundir（`$` 行尾导致的 reader 报错留痕） |

**本轮零仿真、零点火、零 M5 链件变更、零组员源码改动、零新增门限；deck 与三份 cdl 一概未动。**
