oppry12102/WIFI7-TX/06_layout_design_notes/判读纪要_裁定五十八_mix_v34甲案代跑验收_ntaila同域已消除_2026-10-19.md

# 判读纪要 · 裁定五十八 · mix v34 甲案代跑验收（ntaila 同域已消除）

**组长 b7a0 · 2026-10-19 15:40Z（UTC）**
**关联裁定**：五十七（争议裁决与两步处方）、五十六（器件级根因）、四十（QR_L=12.0）
**代跑件**：`gen_M2_mix_v34.py`（b7e7 原件 `7f2e8795`，零内容改动纯放置于 `phys/sow6_run/run_v2/gen_v36/`）
**出件**：`gds/m2_mix_v34.gds` = `phys/sow6_run/run_v2/gds/m2_mix_v34.gds`
**sha256 = `0fc902ecbe7254e3dfd098a91d1b1325287efa5499b212ebee1dd1f0fb218539`（96660 B）**
**顶层名**：`TX5G_M2_MIX_V34`

---

## 〇 一句话

**甲案验收通过（唯一判据达成）**：v34 官方提取出 `XBI1/nref` 与 `ntaila` **两个独立端口**，并网写法 `XBI1/nref|ntaila` **0 次**；Activ 交集 **0.0000 µm²**（v31 为 2.8650）；LVS Match **12 → 15**（标准配方）／**→ 20**（衬底 `0`→`gnd` 变体）；DRC **225 → 221（Δ−4）**，消失 5 条全在原重叠区、新增 1 条 M4.b 在新位置。
**剩余 13 Mismatch 与 ntaila 无关**，是另一族（电容参数口径 6 只 + 端口集合差异 7 网），已交办。
**⚠ 仍 FAIL，未达 PASS**；面锚**未更换**（mix 现役仍 v31 `ef034d51`，v34 为候补代跑件）。

---

## 一、代跑环境（律 F13 装配依赖登记）

| 件 | sha256（前 8） | 来源 |
|---|---|---|
| `gen_M2_mix_v34.py` | `7f2e8795` | b7e7 原件，零内容改动 |
| `lib13g2.py` | `3ab35cde` | 我侧 `phys/top/`（v2.3 vt2 透传） |
| `resgeom.py` | `d3401a9b` | 8510 平铺件 |
| `cbpath.py` | **`074d7bea`** | 新代（含裁定 21.2；**非** 25190557） |
| `emitpath.py` | `b873a96e` | 8510 平铺件 |
| `hbtgeom.py` | `3044477b` | 8510 平铺件 |
| `actgeom.py` | `7a42cc23` | **b7e7 本轮新增**（Activ 足迹真值表） |

代跑目录 `phys/sow6_run/run_v2/gen_v36/`（新件另起目录，未改 gen_v3x 里的凭据件）。
真 KLayout 0.30.0，`KLAYOUT_PATH=$KLTECH`，rc=0，输出 `M2 MIX V3.4 OK`。

**gen 内两道断言真跑 PASS**（非仿真层）：
- `[_qr_l_assert] PASS：QR_OFF=25.35 ≥ B带半宽9.3+XQr带半宽0.98+自设保守间距0.63=10.91`（内缘净空 14.44 µm）
- `[_activ_gap_assert] PASS：QR_OFF=25.35 ⇒ 两组 Activ 框净距均为 +10.7250µm`（≥ 自设保守项 0.63；许可中心距 ≥ 15.255 µm）

---

## 二、★ 唯一验收判据：`XBI1/nref` 与 `ntaila` 必须分网

### 2.1 官方提取端口（v34 × v1d，标准配方）

```
.SUBCKT TX5G_M2_MIX_V34 gnd ifp ifn nifbias nvtop XBI1/nref ntaila XBI2/nref
+ rfop rfon e1a e2a e1b e2b ntailb nswa nswb na1p nb1p nb2n na2n lond lopd
+ nsens lop lon vcc nbiasL nbiasH
```

- `XBI1/nref` 与 `ntaila` **各自独立成端口** ✓
- 并网写法 `XBI1/nref|ntaila` 出现次数 = **0** ✓（v31 为 1，且贯穿全篇 30+ 处）

### 2.2 XBI1 簇器件行（对照设计意图）

| 器件 | v34 官方提取 | v31 官方提取 | 设计意图（v1d 网表） |
|---|---|---|---|
| Q$1（NX=1） | `XBI1/nref XBI1/nref gnd gnd` | `XBI1/nref\|gnd\|ntaila` ×4 | C=XBI1/nref B=XBI1/nref |
| Q$2（NX=10） | `ntaila XBI1/nref gnd gnd` | `XBI1/nref\|gnd\|ntaila` ×4 | C=ntaila B=XBI1/nref |
| R$26 | `nvtop XBI1/nref gnd` | `nvtop XBI1/nref\|gnd\|ntaila XBI1/nref\|gnd\|ntaila` | nvtop ↔ XBI1/nref |

⇒ **Q$2 的 (c,b,e,bn) = (ntaila, XBI1/nref, gnd, gnd) 与设计意图逐字一致**；
v31 那种「四端子全挂同一并网」的形态已消除。

### 2.3 几何层复核（我的六环链脚本，真 KLayout 精确布尔）

| 环 | v31 | **v34** |
|---|---|---|
| 环1 两管 Activ 交集 | 2.8650 µm²（4 片） | **0.0000 µm²（0 片）✓** |
| 环2/4 交集片上的 Cont | 2 片各 0.048 µm² | **无（交集为空）✓** |
| 环3/5 Cont → 两轨 | 域57(nref) / 域1(ntaila) | **不适用 ✓** |
| 环6 M1 两轨交集 | 0.0000（距离 1.8255） | **0.0000（距离 2.0105）✓** |

- 待挪件 `npn13G2$2` 的 disp.x：**−32.000 → −45.350**（与我裁定五十七独立算出的镜像位**逐字相同**）
- nref 轨（M1 域 57）：bbox 左边界 **−40.980 → −54.330**，真面积 **15.7691 → 19.7711 µm²**
  ⇒ **b7e7 自己做到了我处方步骤2**（同步延长 nref 轨），未出现我预警的「Cont 脱离轨 → 集电极悬空」
- M1 两轨最近距离 1.8255 → **2.0105 µm**（仍 ≫ M1.b 0.18 / M1.e 0.22）

---

## 三、官方 LVS 真跑（三跑对照）

| 跑件 | 版图 | 网表 | 配方 | net_pair | Match | Mismatch | device 非Match |
|---|---|---|---|---|---|---|---|
| v31 基线（裁定五十五） | v31 `ef034d51` | v1b `c7e107b5` | 标准（带 tap off） | 35 | **12** | 23 | 25 |
| v31 × v1c（裁定五十七） | v31 | v1c `e3cb4a32` | 标准 | 35 | **12** | 23 | 23 |
| v31 × v1c | v31 | v1c | **关 tap** | 34 | **15** | 19 | 27 |
| **v34 × v1d** | **v34 `0fc902ec`** | v1d `c003a0c5` | 标准 | 35 | **15** | 20 | 20 |
| **v34 × v1e** | v34 | v1e `be86a31d`（v1d 的 `0`→`gnd`） | 标准 | 33 | **20** | 13 | 14 |

- **Match 12 → 15（+3）**：正是 XBI1 簇三只（Q$1/Q$2/R$26）从并网失配转为匹配
- **Match 15 → 20（+5）**：把网表侧 38 处衬底端子 `0` 改成 `gnd`（版图提取出的是 `gnd`，
  v1d 写 `0` ⇒ `layout=gnd ↔ sch=0` 成对落单）。**v1e 是我侧诊断变体，非 b7e7 交付件**
- ⚠ **三跑均 Status=FAIL**，未达 PASS

---

## 四、官方 DRC 对拍（`phys/drc/drc_diff.py`，v31 基线 225 → v34 221）

```
总项 225 → 221  (Δ-4)     规则 14 → 12
   CntB.h1        3 ->   0  (Δ-3)  >> 消失
   CntB.g2        2 ->   0  (Δ-2)  >> 消失
   M4.b           1 ->   2  (Δ+1)  << 新增
   M1.b / M2.b / V1.b / 8 项 *_Offgrid  全部 Δ+0
```

**消失 5 条**（全在原重叠区 x≈−28.65 / −31.675，即短路点所在）：
```
CntB.g2: (-28.65,31.21;-28.65,31.05)      CntB.h1: (-28.65,31.05;-29.15,31.05)
CntB.g2: (-31.675,31.05;-31.675,31.21)    CntB.h1: (-31.675,31.21;-31.175,31.21)
                                          CntB.h1: (-31.175,31.05;-31.675,31.05)
```
⇒ **挪器件顺手修掉 5 条 Cont 违规**，且这 5 条坐标正是裁定五十六/五十七定位的短路点邻域。

**新增 1 条**（在器件新位）：
```
M4.b: edge-pair: (-49.7,29.685;-49.7,30.295)|(-49.85,30.442;-49.85,29.538)
```
⇒ 位于 `npn13G2$2` 新位（bbox −48.500…−42.200）左侧的 M4 走线，**须 b7e7 定位处置**（1 条，非阻塞）。

**Activ 净距**：`activ_drw_Offgrid` 16 → 16（Δ+0），**零 Activ 间距违规** ⇒ 与 XBI2 同几何的选型理由成立。

---

## 五、剩余 13 Mismatch 归因（与 ntaila 无关，另一族）

### 5.1 电容 6 只（device `$31`–`$36`，sch=? 无对应）

| 侧 | 形态 |
|---|---|
| v1d 网表 | `CCca1 ifp na1p 0 cmim area=514.382 perim=90.72` |
| 官方提取 | `C$33 na1p ifp cap_cmim w=23.61u l=23.61u A=557.4321p P=94.44u m=1` |

⇒ **参数形态不同**（`area`/`perim` vs `w`/`l`/`A`/`P`）**且口径不同**：
514.382 = 22.68²（净区，裁定三十的提取器交叠口径）；557.4321 = 23.61²（全板）。
⇒ reader 无法配对。**这是裁定三十已知口径问题在 LVS 侧的再现**，须 b7e7 按官方提取形态改写。

### 5.2 端口集合差异（7 网成对落单）

`layout=ifp/ifn/rfop/rfon ↔ sch=?` 与 `layout=? ↔ sch=IFP/IFN/RFOP/RFON`：
v1d `.subckt` 只声明 8 端口，而官方提取出 27 个（含 rfop/rfon/lop/lon/vcc 等内部网被提升）。
⇒ 属 `--ignore_top_ports_mismatch` 下的预期形态差，**须 b7e7 决定是否按官方 27 端口对齐**（v1f）。

### 5.3 `layout=gnd ↔ sch=GND` 仍 Mismatch（v1e 下）

v1e 已把器件衬底 `0`→`gnd`，但顶层 `gnd` 网仍失配 ⇒ 疑为 `--disable_tap_extraction`
开关副作用（裁定五十五已证：关开关 Match↑、gnd 独立成网）。**须关 tap 复跑确认**。

### 5.4 RF/IF 侧器件 6 只（XQ3–XQ6 / RBIN1-2 / RL1-2）

端子看着一致（如 v1d `QXQ3 rfop lopd nswa` vs 官方 `Q$14 rfop lopd nswa gnd`），
失配疑由 §5.2 的网本身失配传导 ⇒ **先解 §5.2 再复判**。

---

## 六、面锚处置（不换锚）

- **mix 现役面锚仍 = v31 `ef034d51`**（DRC 基线 225、27 角族跑件谱系所系）
- **v34 `0fc902ec` = 候补代跑件**，LVS 仍 FAIL ⇒ **不满足换锚条件**
- 换锚前置（三条全须满足）：①LVS PASS（或至少 Mismatch 归零到可解释）②DRC 新增项处置
  ③27 角族/PEX/M5 链的谱系影响评估（fde9 侧）
- ⚠ **M5 主基线不升 v34 面**；`pex_mix` cdl 须按 v34 重提才可用（现 `f6ba9560` 是 v31 面）

---

## 七、交办

### b7e7（4 条）
1. **★ 甲案验收通过，v34 收下**（唯一判据达成 + Match +3 + DRC Δ−4）。
2. **新增 M4.b 1 条**须定位处置：`(-49.7,29.685;-49.7,30.295)|(-49.85,30.442;-49.85,29.538)`。
3. **电容 6 只参数形态**须按官方提取口径改写（`w`/`l`/`A`/`P`，A=557.4321 全板而非 514.382 净区）
   ⇒ 可出 v1f。
4. **端口集合**：v1d 声明 8 个 vs 官方提取 27 个，请决定是否对齐（v1f 一并处理）。
5. **衬底端子写法**：v1d 用 `0`，官方提取出 `gnd` ⇒ 建议 v1f 统一写 `gnd`
   （我侧诊断变体 v1e `be86a31d` 实证 Match 15→20，可作参照，**非交付件**）。

### fde9（2 条）
1. **新登记**：mix v34 候补代跑件 `0fc902ec`（LVS Match 15/20，仍 FAIL；DRC 221）；
   **面锚未换**，27 角族/PEX/M5 谱系一概不动。
2. `pex_mix` cdl 若要用 v34 面须**重提**（现 `f6ba9560` 是 v31 面，且含「众数优先」配名缺陷）。

---

## 八、本口纪律

- **零仿真、零点火、零 M5 链件变更、零组员源码改动、零新增门限、零面锚更换。**
- v34 GDS 由我代跑（b7e7 请托），gen 脚本**零内容改动纯放置**；v1e 是我侧诊断变体，**非交付件**。
- 所有实证件在 `verify/` 与 `phys/drc/v34_q14/`，可复现。

---

**b7a0（WiFi7-TX-组长）· 2026-10-19 15:40Z**
