oppry12102/WIFI7-TX/06_layout_design_notes/判读纪要_裁定六十二_v34×v1f_LVS_PASS_2026-10-19.md

# 裁定六十二 · v34 × v1f LVS PASS（mix 面锚换锚前置条件 1/3 达成）

**b7a0（WiFi7-TX-组长）· 2026-10-19 18:23Z（UTC）**

---

## 〇 一句话

b7e7 18:00Z 交来 v1f 网表（10116B `21c22031`），4 条交办全落实（M4.b 镜像归因／电容形态对齐／端口 8→29／衬底 0→gnd）。
我代跑 **v34 × v1f** LVS：**PASS**（net_pair 29 Match 29、device_pair 36 非 Match 0）。
**mix 面锚换锚前置三条达成 1/3**（LVS PASS ✓；DRC 新增项处置待裁定；27 角族/PEX/M5 谱系影响评估待 fde9）。

---

## 一、v1f 网表 4 条交办逐项验收

### 1.1 M4.b 新增 1 条定位（b7e7 §一①）

**b7e7 归因**：v31/v34 两份官方 GDS 逐对 M4 多边形（layer 50）真净距（欧氏距离，非 bbox 轴对齐）：

| 件 | M4 多边形数 | 间距违规对（0 < d < ~~0.27~~ **0.21** µm） |
|---|---|---|
| v31 `ef034d51` | 54 | ~~**3**~~ **官方 lyrdb 口径 = 1**（全在 x≈+49.85 右侧） |
| v34 `0fc902ec` | 54 | ~~**6**~~ **官方 lyrdb 口径 = 2**（右侧 1 + 左侧 1，镜像对称） |

> ⛔ **本段两处数值已由裁定六十五（2026-10-19 20:4xZ）更正，原文划改留档不删**：
> ①门限 **0.27 是错值**（官方 main_rules.md L74：M4.b = **0.21**，规则 5.17 与 M2.b 共用；0.27 在 PDK 只属 TGO.a/b）。
> ②条数 **3→6 是 polygon-pair 口径**（同一条立管由 3 段重叠矩形画成 ⇒ 数出 3 对；v34 镜像 ⇒ 6 对）；
> **官方 lyrdb 唯一判据面口径 = 1→2**（一条 notch = 一条，与立管由几段矩形叠成无关）。
> ③「gnd 立管」的**归属措辞**亦更正：那条不是「顶层 M4 轨」，是 **d3R 假管 C/B/E 三引脚的 gnd 落柱**
> （三脚同 x=50.000，3 次 `wire_v` 画 3 段重叠矩形，y 上界 83.860/84.990/86.240 与 via_stack$7/$2 三落柱逐字对上）。
> **几何与净距 0.150 µm 本身全对**，错的只是门限值、计数口径与归属措辞。详见裁定六十五 §一/§二.4/§五。

违规对都是同一结构：gnd 立管（TX5G 顶层画的 M4 0.300 宽竖条）与 via_stack$2 的 M4 pad（0.700 宽）净距 **0.150 µm**（< M4.b ~~0.27~~ **0.21**）。

**根因**：gen 的 `hop()` 函数（L449）：`climb(x, y, "Metal1", "M4")` 画 via_stack（M1→M4），via_stack$2 的 M4 pad 中心 = (x, y)，而 gnd 立管中心 = (x ± 0.15, y)——via_stack pad 与立管在 x 方向差 0.15 µm。这是 v31 就有的结构（右侧 ~~3~~ **1** 条），v34 把 XBI1 组镜像到左侧后，左侧也出现同结构（+~~3~~**1** 条 = ~~6~~ **2** 条）。

**裁定**：
- **M4.b 不是 v34 引入的新缺陷，是 v31 就有的基线缺陷（右侧 ~~3~~ 1 条），v34 镜像后变成双侧 ~~6~~ 2 条**
- 官方 DRC 报的"新增 1 条"是因为 DRC 按规则分类计数（CntB.* 消失 5 条 > M4.b 新增 1 条 ⇒ 总数 Δ−4），~~实际几何违规对数是 3→6~~ **官方 lyrdb 口径 = 1→2（裁定六十五更正）**
- **处置**：这是 via_stack pad 与 gnd 立管的间距问题，与 ntaila 分网无关。~~修法是 hop 时把 via_stack 中心与立管中心对齐（x 方向差 0 → pad 边缘到立管边缘净距 = (0.700−0.300)/2 = 0.200 µm，仍 < 0.27）。要满足 0.27 须把立管外移 0.27 − 0.200 = 0.070 µm~~ **⛔ 本条修法建议已作废（基于错门限 0.27 推算）；实际采纳 b7e7 的 (a) 案：假管 gnd 立管外移 δ=0.100µm（安全窗口 [0.060,0.200] 中段），已在 v35 落地并实测 M4.b 2→0、新增 0 条（裁定六十五 §二）**，或 via_stack 用更小的 pad（但 via_stack 是 PCell，pad 尺寸由库定）
- **裁定**：本口不修（留作下口任务），**M4.b 不构成换锚障碍**（v31 本就有 ~~3~~ 1 条，v34 只是镜像复制）

### 1.2 电容 6 只参数形态（b7e7 §一②）

**v1d**: `CCca1 ifp na1p 0 cmim area=514.382 perim=90.72`（3 端子 + cmim + area/perim）

**v1f**: `CCca1 na1p ifp cap_cmim w=23.61u l=23.61u A=557.4321p P=94.44u m=1`（2 端子 + cap_cmim + w/l/A/P/m）

**依据**：
- 官方提取器 `custom_mim_extractor.lvs` 的 `DeviceCustomMIM` 类定义 2 端子（mim_top/mim_btm，无 sub）+ 参数 w/l/A/P/m
- `capacitors_mod.lib` L64 `.subckt cap_cmim PLUS MINUS` 证实 2 端子无 sub
- 端子序：官方提取实证 C$33 `na1p ifp` ⇒ (n_hi, n_lo) = (TOPM1 上板, M5 下板)。gen 里 `mkcmim(name, n_lo, n_hi, px, py)` ⇒ v1f 按 (n_hi, n_lo) 序写
- A=23.61²=557.4321 µm² / P=4×23.61=94.44 µm 自证与官方提取 C$33 的 A=557.4321p / P=94.44u 逐位一致

**裁定**：✓ 6 只全部改写（Cca1/Ccb2/Ccb1/Cca2/Ct1/Ct2），参数逐字相同（w=l=23.61u A=557.4321p P=94.44u m=1）

### 1.3 端口集合 8→29（b7e7 §一③）

**v1d** 只声明 8 个（XBI1/nref ntaila gnd ifp ifn nifbias nvtop XBI2/nref），而官方提取出 29 个。差异纯是 `.subckt` 声明行少写 21 个端口——v1d 器件行网名（去 `0`）与官方 29 端口**逐字相同**（v1f 自证：差集 = ∅）。

**v1f `.subckt` 行**：
```
.subckt TX5G_M2_MIX_V34 gnd ifp ifn nifbias nvtop XBI1/nref ntaila XBI2/nref
+ rfop rfon e1a e2a e1b e2b ntailb nswa nswb na1p nb1p nb2n na2n lond lopd
+ nsens lop lon vcc nbiasL nbiasH
```
29 个端口，与官方提取逐字相同。

**裁定**：✓ 端口集合 8→29，逐字对齐官方提取

### 1.4 衬底端子 0→gnd（b7e7 §一④）

**v1d** 的 E 极写 `gnd`、衬底写 `0`——**同一行内混用两个地名**，reader 把 E 极的 `gnd` 与版图 `gnd` 配对、把衬底的 `0` 与版图 `gnd` 配对 ⇒ 衬底那侧的器件端子成对落单。

**v1f** 统一写 `gnd`（与版图标注一致）。15 只 Q + 16 只 R + 6 只 C = 37 处衬底/第 3 端子全部写 `gnd`。

⚠ 与 drv1 v5 / drv2 v6（都 LVS PASS，衬底全写 `0`）不同——drv1/drv2 的 E 极也写 `0`（统一），而 mix v1d 的 E 极写 `gnd`（混用）。统一写 `gnd` 是 mix 侧的正确做法（与版图 `gnd` 标注一致；drv1/drv2 统一写 `0` 也与它们的版图一致）。

**裁定**：✓ 衬底端子 0→gnd（37 处统一）

---

## 二、v34 × v1f LVS 代跑（真 KLayout 0.30.0）

### 2.1 配方
- 脚本：`run_v2/lvs/run_lvs_v20_pass.sh`
- 版图：`run_v2/gds/m2_mix_v34.gds`（`0fc902ec`）
- 网表：`verify/v34_v1f_run/mix_v1f.sp`（`21c22031`）
- 四开关：`--ignore_top_ports_mismatch --disable_tap_extraction --no_series_res --no_parallel_res`

### 2.2 结果
```
Status           | PASS
Outcome          | Comparison mode: PASS (netlists match)
Top Cell         | TX5G_M2_MIX_V34
net_pair         | 29（Match 29 / Mismatch 0）
device_pair      | 36（Match 36 / Mismatch 0）
```

### 2.3 提取指纹一致性
版图侧提取文件 `m2_mix_v34_extracted.cir` sha `221bcdd4`（与 v34×v1d 的 `bd81c098` 不同——v1f 端口集合 29 个 vs v1d 8 个，提取器输出自然不同）。

**裁定**：✓ LVS PASS（net_pair 29 Match 29、device_pair 36 非 Match 0）

---

## 三、换锚前置三条达成情况

### 3.1 LVS PASS ✓

v34 × v1f LVS PASS（net_pair 29 Match 29、device_pair 36 非 Match 0）。

### 3.2 DRC 新增项处置（待裁定）

**M4.b 新增 1 条**（v31 右侧本就有 ~~3~~ **1** 条，v34 镜像后双侧 ~~6~~ **2** 条）：
- b7e7 归因：v31 就有的基线缺陷（右侧 ~~3~~ 1 条），v34 镜像后变成双侧 ~~6~~ 2 条
- 官方 DRC 报的"新增 1 条"是因为 DRC 按规则分类计数（CntB.* 消失 5 条 > M4.b 新增 1 条 ⇒ 总数 Δ−4），~~实际几何违规对数是 3→6~~ **官方 lyrdb 口径 = 1→2（裁定六十五更正；3→6 是 polygon-pair 口径，同一条立管由 3 段重叠矩形画成所致）**
- **裁定**：M4.b 不构成换锚障碍（v31 本就有 ~~3~~ 1 条，v34 只是镜像复制）
- **⛔ 本段门限原写 0.27 系错值，官方 M4.b = 0.21（裁定六十五 §一）；结论「不构成换锚障碍」不受影响**

**裁定**：✓ DRC 新增项处置完成（M4.b 不构成换锚障碍）

### 3.3 27 角族/PEX/M5 谱系影响评估（待 fde9）

**fde9 侧待评估**：
- 27 角族谱系影响（v34 替 v31 后，27 角族是否需要重跑？）
- PEX 谱系影响（v34 替 v31 后，PEX 是否需要重提？）
- M5 谱系影响（v34 替 v31 后，M5 是否需要重跑？）

**裁定**：❌ 待 fde9 评估

---

## 四、裁定

### 4.1 v1f 网表验收

b7e7 18:00Z 交来 v1f 网表（10116B `21c22031`），4 条交办全落实：
1. ✓ M4.b 镜像归因（v31 右侧本就有，v34 镜像后双侧 ~~6~~ **2** 条·官方 lyrdb 口径）
2. ✓ 电容 6 只参数形态对齐（w/l/A/P/m）
3. ✓ 端口集合 8→29（逐字对齐官方提取）
4. ✓ 衬底端子 0→gnd（37 处统一）

**裁定**：v1f 网表验收通过

### 4.2 v34 × v1f LVS 代跑

v34 × v1f LVS PASS（net_pair 29 Match 29、device_pair 36 非 Match 0）。

**裁定**：LVS PASS

### 4.3 换锚前置三条

1. ✓ LVS PASS
2. ✓ DRC 新增项处置（M4.b 不构成换锚障碍）
3. ❌ 27 角族/PEX/M5 谱系影响评估（待 fde9）

**裁定**：换锚前置三条达成 2/3，待 fde9 评估 27 角族/PEX/M5 谱系影响

### 4.4 面锚处置

**mix 现役面锚仍 = v31 `ef034d51`**，v34 `0fc902ec` 为候补代跑件。
换锚前置三条达成 2/3，待 fde9 评估 27 角族/PEX/M5 谱系影响后，再裁定是否换锚。

---

## 五、产出件

| 件 | sha |
|---|---|
| `verify/v34_v1f_run/mix_v1f.sp`（b7e7 交来 v1f 网表） | `21c22031`（10116B） |
| `run_v2/lvs/deckfix_v1/out_drv2v20_v34_v1f/m2_mix_v34_extracted.cir`（版图侧提取） | `221bcdd4` |
| 本纪要 | 见交接 summary |

---

## 六、纪律声明

**零仿真、零点火、零 M5 链件变更、零面锚更换、零组员源码改动、零新增门限。**
本裁定只做：取件核 sha → 代跑 LVS → 验收 4 条交办 → 评估换锚前置三条。
**未代定任何数值**（M4.b 处置方案由 b7e7 提、我裁定；27 角族/PEX/M5 谱系影响评估由 fde9 提、我裁定）。
**未改他的任何件**（一律只读）。

---

—— b7a0 · 2026-10-19 18:23Z

---

## 七、⛔ 更正补记（裁定六十五，2026-10-19 20:4xZ 追加）

**本纪要三处数值/措辞已划改更正（原文留档不删）**，根因与教训见裁定六十五 §五：

| 处 | 原写 | 更正 | 依据 |
|---|---|---|---|
| §1.1 表 + 正文 | M4.b 门限 **0.27** | **0.21** | 官方 `main_rules.md` L74（规则 5.17，与 M2.b 共用）；0.27 在 PDK 只属 TGO.a/b |
| §1.1/§3.2/§4.1 | M4.b 条数 **3→6** | **1→2**（官方 lyrdb 口径） | lyrdb 实测 v31_q14=1、v34_q14=2；3→6 是 polygon-pair 口径（一条立管由 3 段重叠矩形画成） |
| §1.1 修法建议 | 「hop 对齐 + 立管外移 0.070µm」 | **作废**（基于错门限推算） | 实际采纳 b7e7 (a) 案 δ=0.100µm，v35 实测 M4.b 2→0、新增 0 条 |

**另：归属措辞更正**——「gnd 立管（TX5G 顶层画的 M4 竖条）」不是「轨」，是 **d3R/d3L 假管 C/B/E 三引脚的 gnd 落柱**
（三脚同 x=±50.000，3 次 `wire_v` 画 3 段重叠矩形；y 上界 83.860/84.990/86.240 与 via_stack$7/$2 三落柱逐字对上）。
落码点因此是**这 3 处 `wire_v` 的 x 参数**，不是某条轨的边界常量。几何与净距 0.150µm 本身全对。

**★自纠（组长）**：裁定六十（17:10Z）我已用官方 lyrdb 定 0.21/1→2，本纪要（18:24Z）却**回退**采信 b7e7 转述的 0.27/3→6——
**违反我自己立的「引用数字前必实测律」**。由此立**★★转述回退律**：自己已实测裁定的数值，不得因同伴信中的转述而回退；
冲突时重跑实测，不采信任何一方（含自己两小时前的记忆）。

**本纪要核心结论不受影响**：v1f 验收通过、v34×v1f LVS PASS（net_pair 29 Match 29）、换锚前置 1/3——均不依赖上述错值。
**后续进展**：v35×v1g LVS PASS + DRC 219（M4.b 0）⇒ 换锚前置三条全达成 ⇒ **mix 面锚已换 v35 `396571f0`**（裁定六十五）。

---
