oppry12102/WIFI7-TX/04_netlists/behavior_tb_sow2/design_notes_v092.md

# SOW-2 · TX 链晶体管化（IHP SG13G2，5GHz 频段优先）— 设计说明

**b7e7 电路设计组员 · 2026-10-16 v0.91（组长 DC 诊断修正版，待代跑 tran+four）**

对应组长 SOW-2 派工信（2026-10-15 17:21Z）：Gilbert 混频器 + PA 驱动级 + LO 缓冲，
5.15–5.85 GHz 优先（设计中心 **5.5 GHz**），2.4G 复用架构说明，文本网表交付、组长 sg13g2_sim 代跑。

---

## 0.1 v0.91 变更记录（组长 2026-10-16 02:1xZ DC 诊断信四问逐条落实）

**原则：只动偏置数值，拓扑不动（唯一例外 lobuf B 项修复，组长批准路径）。**
校准基准（组长实测）：Vbe=0.88V@nx=6/Vce=1.2V→Ic=6.9mA，β≈570；**工作点 β 一律按 550–650 修正**（v0.9 用的 820 是 0.5mA 量级峰区值）。

| # | 组长诊断 | v0.91 动作 | 闭合核算（校准外推） |
|---|---|---|---|
| A1 | mixer Vifb=0.88V → ntail≈−0.11V 镜像塌 | Vifb 0.88→**1.2 V**（IF 源共模同步） | ntail=1.2−0.884−0.12≈**+0.20V**；gm Vce≈1.25V ✓ |
| A2 | LO CM=0.9V 撑不开开关对 | LO CM 0.9→**2.35 V**（mixer/lobuf 输出口/chain Vbcm 同步） | 开关基极 2.35→nswa≈1.46V，开关 Vce≈1.04V，gm Vce≈1.25V ✓（组长闭合点 1.5/0.95/1.2 同域） |
| B | lobuf EF 射极(~0.03V)直驱限幅对→常关、输出顶轨 | **EF 集电极改接 vcc**（v0.9 误接输出节点，Vbc 正偏饱和=B 项深层根因）+ EF 射极 **10pF 交流耦合** → 限幅对基极**独立偏置 1.25V**；EF 基极偏置 0.88→**1.05V**；输入源共模 0.9→1.05V | EF：efp≈0.18V、ntaila≈+0.12V 合规；限幅对：基极 1.25→ntailb≈+0.31V 合规；10p@5.5G≈2.9Ω 不衰摆，1k 低频角 16MHz |
| C | drv2 Vbcas=1.7V → ccas≈0.85V<CE 基极 → CE 饱和 | Vbcas 1.7→**2.05 V** | ccas≈1.16V，CE Vbc 反偏≈−0.2V，CB Vcb≈0.45V ✓，CB Vce≈1.34V |
| 自主 | （组长未列，偏置数值范畴）DRV1/DRV2 CE 基极 0.88V 在尾流/Re 下 ntail 贴地（DRV2 −0.03V、DRV1 ≈0） | CE 基极偏置 0.88→**0.95 V**（drv1/drv2） | DRV1 ntail≈+0.07V、DRV2 ntail≈+0.04V 合规；DRV2 CE Vbc 反偏 −0.2V ✓。**请代跑复核 ntail 实测** |
| D | （风险非阻塞）drv1 单管 Vce≈2.35V>1.6V | 数值不动，**带声明跑**（组长已批）；抬基极至 0.95V 后 Vce≈2.42V，裕量口径不变 | 基极经 1k 注入+50Ω 源=中低阻口径，有效击穿趋 BVCBO≈4.5V，裕≈2.1V；第二轮 cascode 化或降轨 |

**限幅对/EF 管 Vce 声明（同 D 项口径，首版带声明跑）**：lobuf 限幅管 Vce≈2.13V、EF 管 Vce≈2.32V（集电极接轨后）——均为单管无 cascode，>BVCEO 1.6V，基极偏置低阻（1k→理想源），有效击穿趋 BVCBO≈4.5V，裕 2.2–2.4V。第二轮处理（降轨/ cascode）。

## 0.2 v0.92 变更记录（组长 2026-10-16 02:4xZ op 实测反馈·结构修复）

**原则：只修结构，偏置一律不动。** v0.91 四板 op 实测：mixer/lobuf 偏置闭合全部成立（偏差 ≤40mV，ntail 全正合规）；
drv2/drv1 各一处**绘制遗漏级**结构问题（v0.91「只动偏置」未触到的存量错误，诊断与闭合表早已按正确拓扑做，网表漏画）：

| # | 组长 op 实测 | 根因 | v0.92 动作 |
|---|---|---|---|
| S1 | drv2 ccas 直流悬空（实测 0.015V），主管 vbc=+0.884 深饱和、ic≈0.01mA、尾流塌 0.2mA | **网表漏画共基管 XQ3/XQ4**（v0.9→v0.91 诊断/闭合表均按 CB 存在核算，绘制时遗漏；Vbcas 2.05V 只经 Cbc 10p 交流耦合） | 补 `XQ3/XQ4 vcc nbcas ccas1/2 0 npn13G2 nx=10`（组长四行案原样落）；修复后 ccas≈1.16V、主管 Vbc≈−0.2V 反偏、CB Vcb≈−0.45V/Vce≈1.34V，与闭合表一致 |
| S2 | drv1 outp/outn 端口悬空 → drv_tb na/nan、chain nd1p/nd1n 恒 0V，级联断 | tank 挂内部 cop/con，端口名在子电路 body 内零引用 | **端口直改 cop/con**（组长案 a）；tb 侧调用按位置映射零改动；drv_tb 与 chain_top_tb 同步 |

**尾流 quasi-sat 税全链备案（v0.92 不动，第二轮统一标定）**：镜像输出管 Vce=ntail 贴地（mixer +0.21V / lobuf +0.16~0.34V / drv1 +0.145V / drv2 +0.05V）→ 电流打折是系统性的：mixer 尾 14.09/16mA（−12%）、lobuf EF −6%/限幅 −10%、drv1 6.05/8mA（−24%）、drv2 预测 20–25/32mA。
**第二轮预案**（等全链 tran/four 实测定夺，候选按代价排序）：① 逐块抬偏置 Vb +0.10~0.15V（ntail→0.2V+， mixer Vifb 1.2→1.35V 等）；② 镜像拓扑改造（输出管加 cascode / PNP 高边）；③ nx 阵列精确配流（drv2 4 组 nx=8=32mA→精确 30mA）。电流税同步压 CG/OP1dB 预算，实测回来后与 §4 表一起对账。

**出厂自检补丁（流程沉淀）**：本次两 bug 均为直流拓扑级，已沉淀 `check_netlist_dc` 静态自检技能（电容开路口径：连通悬浮 / 端口零引用 / 单管脚节点三级 FATAL）。
回归验证：v0.91 备份两板 FAIL 精确复现 4 处（与组长 op 实测一致），v0.92 四板全 PASS（mixer/lobuf 顺带复查无同类问题）。**此后每版交组长前必跑。**

---

## 0. 交付物清单

| 文件 | 内容 |
|---|---|
| `sow2_tx5g/mixer_tb.sp` | Gilbert double-balanced 上变频混频器 子电路 + tb（CG / OIP3 双音 / LOFT） |
| `sow2_tx5g/drv_tb.sp` | PA 驱动级（2 级：CE 简并 → CASCODE）+ tb（.ac 增益 + foreach 扫 P1dB） |
| `sow2_tx5g/lobuf_tb.sp` | LO 缓冲（EF + 限幅差分对）+ tb（摆幅/限幅扫描） |
| `sow2_tx5g/chain_top_tb.sp` | MIX→DRV 链级联 top（含 LO_BUF），全链 CG 验证 |
| `sow2_tx5g/design_notes.md` | 本文档 |

**网表口径（组长实测核 verified，v0.91 已按此写死）：**
- 有源器件全部 PDK 模型：HBT 实例 `XQ… c b e bn npn13G2 Nx=N`（**第 4 端=埋层 bn，接 0，非衬底**；参数名 Nx，大小写不敏感，有效域 1–10）；偏置 HBT 电流镜 + 理想电压基准，**不引入 MOS**（第二轮评估）。
- 无源 R/L/C 首版理想元件，注释标材料与版图建议（rsil/rppd、cmim、电感版图阶段）。
- corner 引用 `.lib '../models/cornerHBT.lib' hbt_typ`（**段名 hbt_typ 实测确认**，七段无温度段，温度走 .temp；路径为网表落 pdk/sim/sow2/ 的相对口径——v0.9 曾写 '../../' 组长已代改，v0.91 出厂即对）。VBIC 模型含自热节点（内部，无需外部连接）。

---

## 1. 系统链路衔接（与 design_circuit v1.4 预算表的映射）

旧链口径（40nm CMOS，v1.4 §2）：链入 −5 dBm → VGA 0dB 档 → 混频器净 0dB → 驱动 +6dB → PA 输入 +1dBm → PA +17dB → 6G 输出 +18 dBm。

组长指定 **Gilbert 有源混频**（替代原「gm 级+25% 无源正交」），典型 CG +2~+6 dB。增益重分配两案（首版网表按**模块最优**做，链路定案等代跑数据）：

| 方案 | MIX CG | DRV 增益 | 说明 |
|---|---|---|---|
| A（默认） | +2 dB（gm 对大简并换取 OIP3，RL 压低） | +4 dB（DRV1 +8 → 级间 π 衰减 4dB → DRV2 +6，或 DRV1 直接做 +2dB 缓冲档） | 链路总增益与旧链一致，VGA 档位/分配表**零改动** |
| B | +4 dB（模块 CG 最优） | DRV 需求降为 +2 dB；级间衰减器加 2dB | 多 2dB 混频线性度压力换驱动电流 |

**判据**：混频器带内 IM3 直接入 EVM（IF 双音 9/11 MHz → IM3 落 LO±(7,13) MHz，信道内），按旧分配 VGAMIX −46 dB 反推要求 **OIP3 ≥ +15 dBm**（三次方口径近似，双音每音 S=−8 dBm）。这是 gm 对尺寸的主导约束——**OIP3 优先于 CG**，缺的增益由 DRV1 补（HBT 高 gm，代价小）。

## 2. 供电轨声明（**已裁决，组长 2026-10-16 02:1xZ 信**）

- **裁决：2.5V 内部轨 = v0.9/首版收敛口径（架构决定）**——1.8V 下双 Vbe 堆叠无解。来源 3.3V IO→LDO→2.5V 记 architecture §0。
- **功耗按 201 mW 包络（含双 LO buf）入账**。1.8V 双轨省 21 mW **第二轮再议**（等 tran 实测 + PA 落地一起对账）。
- 3.3V IO 轨只给偏置 LDO/带隙（版图阶段）。
- npn13G2 BVCEO≈1.6V；开关对/限幅对截止管 Vce 瞬时高，基极低阻驱动下有效击穿趋 BVCBO≈4.5V（安全口径），tb 复核 Vce(t) max。

## 3. 模块设计

### 3.1 上变频混频器 MIX（Gilbert double-balanced）

```
         VCC 2.5V
      ┌───┬───┐
     RL   RL   (45Ω/边 + L tank 5.5G，首版 R+tank 简化)
      out+ │  out−   ← RF 差分输出（LO+IF 边带）
   ┌──swQ3┬swQ4┐      开关对 Q3-Q6 nx=4，LO 差分驱动
   └──┬───────┬──┘
   gmQ1═gmQ2           跨导差分对 nx=6，Re=15Ω/边（8/15/22Ω 三档预留）
      │  IF+ / IF−（0–160MHz，基极偏置 1.2V 经高阻）
     I_tail 16mA（HBT 电流镜，Vbe 基准）
```

| 项 | 值 | 说明 |
|---|---|---|
| gm 对 | npn13G2 nx=6，Ic_pair=16 mA（8mA/边），Re=15 Ω/边（rsil） | 简并系数 1+gm0·Re≈4.6 → IIP3 半电路单音 ~+15 dBm 量级；gm_eff≈50 mS/边 |
| 开关对 | Q3–Q6 nx=4，LO 差分 0.4 Vpp | 全切换需 ~4Vt=103 mV/管，裕量足；Vce 稳态 ~0.8 V |
| 负载 | R=45 Ω/边 + L(1 nH 理想)//C(0.8 pF) tank @5.5 GHz | 抑制 LO 泄漏/IF 谐波；电感版图阶段换 PDK 电感（Q~15） |
| 偏置 | 尾流 16 mA HBT 镜像；gm 对基极 **1.2 V** 高阻注入（理想 V 源+2 kΩ）——ntail≈+0.20V 镜像合规 | 版图阶段换带隙+温度补偿 |
| **目标** | **CG +2 dB（方案 A）/ OIP3 ≥ +15 dBm / LO-RF 隔离 ≥ 35 dB / LOFT ≤ −40 dBc** | tb 双音 IF 9/11 MHz @ −8 dBm/音 |
| 功耗 | 16 mA × 2.5 V = **40 mW**（旧预算 33 mW，超 7 mW 换 OIP3，待对账） | |

### 3.2 PA 驱动级 DRV（2 级）

| 项 | DRV1（CE+简并） | DRV2（CASCODE 输出级） |
|---|---|---|
| 结构 | npn13G2 CE，Re=4 Ω/边；级间 π 衰减 4 dB（预留） | CE(nx=10) + 共基 CB(nx=10)，Re=1.5 Ω/边 |
| 偏置 | Ic=8 mA（4mA/边，1.33mA/unit），基极 **0.95 V** 经镜像（v0.91：0.88V 时 ntail 贴地）；单管 Vce≈2.4V 声明口径 | Ic=30 mA（15mA/边，3mA/unit 近 fT 峰区），CE 基极 **0.95V**；**Vbcas=2.05V**→ccas≈1.16V，CE Vbc 反偏 ✓ |
| 负载 | tank @5.5G，RL 差分 50 Ω 口（半电路 25 Ω） | tank @5.5G（L~0.7 nH 理想）→ 输出差分 50 Ω（tb 口；版图阶段换变压器 1:1） |
| 增益 | ~+8 dB（gm_eff 96 mS × 25 Ω） | ~+6~8 dB（30 mA 强驱动） |
| **目标** | OP1dB ≥ −4 dBm，OIP3 ≥ +8 dBm | **OP1dB ≥ +10 dBm**（PA 输入 +1 dBm 留 9 dB 回退），OIP3 ≥ +18 dBm |
| 功耗 | 20 mW | **75 mW**（1.8V 轨可降到 ~54 mW） |

fT 富余：全链工作频率 5.5 GHz 仅为 fT（>380 GHz）的 **1.4%**——电流密度可自由偏向线性度/效率，不构成约束。关键参数是 fmax 与击穿（cascode 后 C-B 反偏最大 ~2.3V < BVCBO 4.5V ✓，tb 复核）。

### 3.3 LO 缓冲 LO_BUF（v0.91 B 项修复后定案）

| 项 | 值 |
|---|---|
| 结构 | 输入射随（EF nx=2, 3 mA, **集电极接 vcc**, 基极偏置 1.05V）→ 射极 **10pF 交流耦合** → 差分限幅对（nx=4, 10 mA, **基极独立偏置 1.25V**, tank @LO 频点）→ 输出 |
| 输入 | 50 Ω 口，源共模 **1.05V**（=EF 基极偏置）；0.1–0.6 Vpp 差分均可（限幅→输出恒定） |
| 输出 | tank 经 L 直流挂 2.5V（输出共模 2.5V），驱动开关对经隔直 + 2.35V 共模拉偏置（=mix 开关对基极闭合点） |
| **数量定案** | **I/Q 两路各一只（LO_BUF×2）**——正交上变频（VCO÷2 正交→I/Q 单边带调制，镜像抑制口径）需要 I/Q 两路 LO；§4 功耗 201 mW 包络即按 ×2 计（66 mW）。chain_top_tb 为单路复用 tb 口径，板上两路相同 |
| **目标** | 输出差分 0.4 Vpp 恒定（隔直后直驱开关对基极）；反隔离 ≥40 dB；相位噪声恶化 ≤1 dB（限幅对噪声） |
| 功耗 | 13 mA × 2.5 V = 33 mW/路，两路 **66 mW** |
| 声明 | 限幅管 Vce≈2.13V、EF 管 Vce≈2.32V（单管无 cascode，低阻基极口径→BVCBO 4.5V 裕 2.2V+，第二轮处理） |

## 4. 每级指标预算表（首版目标，代跑后回填实测列）

| 级 | 增益/dB | OIP3/dBm | OP1dB/dBm | 电流/mA | 功耗/mW@2.5V | NF/dB(参考) |
|---|---|---|---|---|---|---|
| MIX | +2（方案A） | ≥+15 | —（上变频口径双音测） | 16 | 40 | ≤12（SSB，TX 参考不进 EVM） |
| DRV1 | +8 | ≥+8 | ≥−4 | 8 | 20 | ≤6 |
| （级间衰减） | −4 | — | — | — | — | — |
| DRV2 | +6~8 | ≥+18 | **≥+10** | 30 | 75 | ≤5 |
| LO_BUF×2 | —（限幅） | — | — | 13×2 | 66 | — |
| **合计（方案A链）** | +12~14（MIX→DRV2 输出） | 级联受 MIX 主导 | 链 OP1dB=+10（DRV2 限制） | 80 | **201 mW（含双 LO buf）/ 135 mW（单 LO 分配）** | |

链路验证点（chain_top_tb）：−5 dBm 进 → MIX+2 → DRV1+8 → π衰4 → DRV2+7 ≈ **+8 dBm 输出**（比 PA 输入需求 +1 dBm 高 7 dB——级间衰减改 10 dB 或 DRV1 降档即对齐；首版 tb 按模块最优，链路定案在代跑数据回来后做）。

## 5. tb 说明（组长代跑指引）

| tb | 仿真类型 | 看什么 |
|---|---|---|
| mixer_tb | tran 200 ns（稳态后 50 ns 起窗）+ `.four` | ① 单音 IF=10 MHz：CG = Pout@5.51G − Pin；② 双音 9/11 MHz：OIP3（IM3@LO±7/13 MHz）；③ 不加 IF：LOFT/LO-RF 隔离 |
| drv_tb | `.ac` 1–20 G（增益/带宽/稳定性）+ foreach 幅度扫描 tran → P1dB | OP1dB @5.5G（50Ω 差分口）；Vce(t) max 复核击穿 |
| lobuf_tb | tran，扫输入摆幅 0.1–0.8 Vpp | 输出摆幅平坦度、限幅起点 |
| chain_top | tran + `.four` | 全链 CG、带内平坦度（5.15/5.5/5.85 三点）、级间摆幅衔接 |

所有 tb 输入源均为**理想差分源**（首版不做片外匹配网络，接口 50Ω 口径）；偏置理想源+HBT 镜像。

## 6. 组长确认闭环记录（v0.9 §6 四问 → 2026-10-16 02:1xZ 信全部答复）

1. ~~模型引用写法~~ **已答**：`.lib '../models/cornerHBT.lib' hbt_typ`；`XQ1 c b e bn npn13G2 Nx=4`（第 4 端=埋层 bn 接 0 正确）；Nx 大小写不敏感、域 1–10；v0.91 已写死。
2. ~~corner 段名~~ **已答**：`hbt_typ` 即组长环境段名（七段无温度段，温度走 .temp）。
3. ~~电源树裁决~~ **已裁**：2.5V 直供=首版收敛口径（见 §2）。
4. corner 顺序 **已批**：typ 先行、corner 第二轮（fde9 三层栈 V2；我第二轮挂 HBT 三段全网格+MOS corner）。

**当前待代跑**：v0.91 全四板 op（应真解收敛）→ tran+four，数据按 §4 表回填。
第二轮既有清单：PDK 无源替换（电感 Q~15、cmim、rsil）、DRV1 cascode 化/降轨、lobuf 限幅管 Vce 处理、2.4G tank 切换 tb、MOS 偏置链（如需）、corner 全网格。

## 7. 2.4G 复用架构说明（任务书要求，简要）

- **同一模拟链路复用**，分带靠三处切换：① LO 频率（6G 直通 5.5G / 2.4G 由 VCO 4.8G÷2，沿用 architecture 方案）；② 各级 tank 电容阵列切换（5.5G：L 1nH/C 0.8pF；2.4G：L 1nH 需 C≈4.2pF，cmim 开关位 4 bit 覆盖 0.8–5 pF）；③ DRV2 电流档位（2.4G 增益需求高 5dB → 电流 +20% 或 tank Q 提升补偿）。
- HBT 器件本身 2.4–5.85 GHz 宽带可用（fT 比 5.5G 高 70 倍），无需双链路。带宽切换的 S 参数/平坦度在第二轮网表加 2.4G tb 验证。

## 8. 风险与边界

| 风险 | 缓解 |
|---|---|
| OIP3 +15 dBm 目标对 16 mA Gilbert 偏紧（经验公式边界） | Re 三档 8/15/22Ω 预留 + 尾流可加到 24 mA；代跑双音数据回来定案 |
| 理想电感/无源 → 首版指标系统性偏乐观（Q 无限） | 定性明确：首版看**拓扑正确性+工作点+相对比较**，绝对指标第二轮（PDK 电感 Q~15、cmim）收敛 |
| HBT 击穿裕量（BVCEO 瞬时） | drv_tb/mixer_tb 加 Vce(t) max 测量点 |
| MOS 模型未用 → 偏置全 HBT+理想源 | 第二版按组长模型卡确认后补 MOS 偏置链（如需） |
