oppry12102/WIFI7-TX/04_netlists/behavior_tb_sow2/task_v011_brief.md

# v0.11 轮任务书（组长 b7a0 发布 · 2026-10-16）

**收件**：b7e7（出图投件）/ fde9（判据与 M8 复验备查）
**授权依据**：fde9 B1 硬验收（2026-10-16 06:46Z）：L8 PASS / M8 有条件 PASS（混合模 Sdd 口径为准）
/ M1-M7+L1+L7 全收 → L2 块级稳定性正式闭环。本任务书即 v0.11 出稿授权。
**出图基线**：mixer_tb_v011_draft.sp（b7e7 勘误信 2026-10-16T07:00 为准，sha256 14f58be5…4c30，
A 案镜像 nx=10 rr=718、尾流 44.6 mA、Vifb 1.50 V 整套基准）+ mixer_v011_预案.md。

---

## 1. 变体表（一板三臂 + 一对照，同轮同网格同激励同探针）

| 臂 | 内容 | 判别目的 | 仿真负荷 |
|----|---|---|---|
| **A** | 勘误 A 案：44.6 mA 尾流，Vifb 1.50 V，其余=v0.10 | 45 mA 净收益（读数①，含 Cπ 负载打折） | 重型 tran 2.5µs ×typ + OP 27 角 + sp 27 角 |
| **B** | A + LO 斜率三件套（lobuf Re12→4Ω + 尾流 16 mA + EF Re 40→20 Ω） | LO 斜率找回量（读数②） | 同 A |
| **C** | A + **LO 口平衡去耦**：开关对基极走线每边串联阻尼 **10 Ω**（中值单点） | **M8 复验臂**：全口径稳定性 vs 线性度代价 | sp 27 角 + 600n 双音对照（免重型） |
| **v010p** | v0.10 + 探针行 + tran 2.5µs（镜像 nx=8 rr=1.62k、Vifb 1.35 不动） | 16 mA 锚（ntail@2MHz 基准、IM3 基准） | 重型 tran ×typ |

**纪律**：
- 三臂各自 diff 相对 v0.10 仅允许本臂结构变更，无夹带；每臂附 diff 清单（行级）。
- 判别臂 A/B 与 C 严格分离：C 的去耦件不得混入 A/B（fde9「去耦并入 v0.11」由 C 臂独立承担，
  b7e7「第三重压负载线」关切由「C 独立臂」消解——归因不受污染）。
- C 臂首版 10 Ω 不达（M8 复验仍字面 FAIL 或 IM3 恶化 >0.5 dB）→ 备选 5/15 Ω 两点补扫或
  RC snubber（R20~50Ω+C≤1pF），**默认留 v0.12**，本轮不自动扩臂。

## 2. 仿真矩阵（组长代跑，管线复用 ml_batch B1 批 gen/run/extract）

| 项 | 网格 | 臂 | 说明 |
|----|---|----|---|
| OP | 27 角全 | A/B/C | 三臂全角；A 臂 OP 回填后 rr 微调一次机会（44.6→45.0），微调后 OP 复跑 A 臂 |
| tran 重型 | typ（t27/v2500） | A/B/v010p | `.tran 1p 2.5u 60n`（maxstep 1p 不变），稳态窗 [60n, 2.5µ]≈4.9 个包络周期；探针 wrdata 全程（ntaila/ntailb 必选；vifb/lo 口摆幅/vce3_max 建议同存）；IM3 双音从稳态后段窗提取，窗位由 extract 定、报告注明 |
| tran 对照 | typ | C | 600n 双音对照（IM3 vs A 同窗对比，查去耦线性度代价） |
| sp 稳定性 | 27 角 × 61 点（与 L8 同网格） | A/B/C | M8 复验：混合模 Sdd 口径为主判，单端口对全口径并报（C 臂关注 LO 对改善量） |

磁盘预算：重型 3 版 ×~250 万点，wrdata 抽样后单版 <300 MB（33 G 充足）；跑批 cwd=pdk/sim，
.lib "models/cornerHBT.lib"，重型版手动跑落 logs/。

## 3. 投件包清单（b7e7 → 组长，/files 投递附 list=1 核过的精确 name）

1. `mixer_tb_v011_A.sp` / `_B.sp` / `_C.sp` / `v010p.sp`（各附 .sha256）
2. 每臂 diff 清单（vs v0.10 行级）+ check_netlist_dc 自检输出
3. OP 预填表更新（若有，mixer_v011_预案.md 增补）
4. 参考支路口径声明（hbt_mirror 2 路 2.26 mA 是否已含；若改共享 subckt 须前置声明）

## 4. 判读字段（extract 输出约定，三方共用）

- **M3 双字段**（§8 审计口径）：①测试点直读（IF −23 dBm/音 OIP3 / IM3 低边 dBc）②斜率标定
  （三点电平 s 值 dB/dB，禁压缩区外推）。
- **ntail@2MHz 幅度**：A/B/v010p 三方对比（判据：缩 ~2.8×≈−9 dB 且 IM3 同步降 → 尾流包络坐实；
  本在噪声底 → 证伪 → LO 斜率 lever 优先级升）。
- **IM3 低边 dBc 同窗对比**：A/B/C/v010p。
- **重锚字段**：链内 LO 口摆幅实测（lo_in_amp=113m ↔ Vpp），45mA/解挂后锚漂修正。
- **vce3_max**：A/B 盯 45 mA 摆幅 ×2.81。
- **OP 回填表**：每臂 ntail / Vifb / i_vcc / rr 微调建议。
- **M7 若复测**：extract 脚本补 `onoise_total` 字段（fde9 审计缺口；本轮准入档以信文 4.02e-7 V²）。

## 5. 判读决策树（组长 + fde9 双签，出 v0.11 判读纪要）

- 读数①（A vs v010p IM3 降幅）≥7 dB 且 ntail@2MHz 缩 ≥2× 且 IM3 同步降 ≥3 dB → **尾流包络坐实**，
  v0.12 视读数②决定是否叠加 LO 斜率三件套（叠加则按「换向窗口缩短」口径重判 tank RL）。
- 读数① <5 dB → Cπ 负载打折严重 → 读数②（B 找回量）为 v0.12 主依据；若读数② ≥3 dB 则三件套
  进 v0.12，否则 tank RL（drv 轮）优先级最高。
- C 臂：M8 复验**全口径过**且 IM3 恶化 ≤0.5 dB → v0.12 采 LO 去耦（全口径绝对稳定达标）；
  否则 M8 维持「混合模口径有条件 PASS」归档，去耦作罢（留痕）。
- 45 mA 线本身：标称点合规仍走 §8 三级闭环（①45 mA + ②v0.12 drv 轮电平重配 + ③fde9 波形级终审），
  本轮判读不替代标称点合规结论。

## 6. 节奏

b7e7 出图 3+1 版投件 → 组长代跑（重型 ×3 + C 对照 + sp 批）→ extract → 判读双签 →
fde9 M8 复验（挂新 sha）→ v0.12 定方向（LO 斜率 / tank RL / 收口）。

—— 组长 b7a0，2026-10-16（UTC 23:0x）
