oppry12102/WIFI7-TX/06_layout_design_notes/README.md

# 墟寻射频知识库 · README

> 生成：2026-10-17 ｜ 作者：墟寻（LLM 子代理起草 + 墟寻审核）
> 用途：射频（RF）工程知识体系，面向 Wi-Fi/物联网射频工程师与项目协作（当前对接 b7a0「Wi-Fi 7 TX 模组」项目）。
> 篇幅：九篇共约 10 万字 ｜ 全部 status=completed，已过结构完整性与坏损扫描。

## 目录

| 篇 | 文件 | 内容 | 字数 |
|---|---|---|---|
| 01 | 01_基础_频段与单位.md | 电磁波与射频、dB/dBm/dBc 单位体系、频段划分、噪声底 | ~12k |
| 02 | 02_传输线与S参数.md | 传输线思维、Z₀ 与 50 Ω、反射/驻波/回损、S 参数与史密斯圆图 | ~8k |
| 03 | 03_阻抗匹配与无源器件.md | 匹配原理、寄生模型、L/T/π 网络、巴伦/耦合器/滤波器 | ~14k |
| 04 | 04_有源射频电路.md | LNA（NF/Friis/K 因子）、PA（P1dB/IP3/AM-AM/AM-PM）、混频器、PLL/VCO | ~10k |
| 05 | 05_收发机架构与链路预算.md | 超外差/零中频/低中频、镜像抑制、级联 NF/IP3、EVM 预算 RSS | ~8.5k |
| 06 | 06_天线.md | 方向图/增益/效率制约、极化、带宽-Q 天花板、匹配与净空 | ~8k |
| 07 | 07_无线标准与协议速览.md | 802.11 家族演进、Wi-Fi 6/6E/7 增量、蓝牙/蜂窝底座、SEM 掩模 | ~9.5k |
| 08 | 08_测试测量与EMC.md | VNA/SOL(R) 校准、频谱仪/RBW、EVM/ACPR 测量、EMC 整改 | ~10k |
| 09 | 09_工程实战问答手册.md | 13 问 PCB/选型/排障 FAQ（50 Ω、地平面、净空、谐波、调试第一小时…）+ 快问快答 | ~13k |

## 阅读建议

- **入门**：01 → 02 → 06，建立"波与阻抗"的物理直觉。
- **电路设计**：03 → 04 → 05，匹配、有源、架构三连。
- **项目落地**：07（标准约束）→ 08（怎么测）→ 09（实战坑）。
- **速查**：09 篇按问题索引，快问快答 10 条覆盖高频疑问。

## 项目对接

- `对表_b7a0_WiFi7TX项目.md`：九篇知识 ↔ b7a0 Wi-Fi 7 TX 模组项目的落点映射（含数字锚点、方法论、三问作答）。
- 本知识库随 b7a0 的把关邀约投递至其共享盘 `design/sow6/`，供校验其 DPD/EVM/相噪工程典型值。

## 版本

- v1.0（2026-10-17）：首版九篇。01–08 一次生成通过审核；09 篇首生成遇长文截断（长文生成上限），已拆两半重生成合并修复。
