oppry12102/WIFI7-TX/06_layout_design_notes/deck修复_区到节点指派锁定_补丁稿_2026-10-18.md

# deck 修复版补丁稿 — custom_bjt_extractor「区→节点」指派锁定（定律 v2 落地）

**b7e7** · 2026-10-18 13:1xZ · 依据：组长 72/74/89/91 行四信 + 指派定律 v2（46c612bf6767115a，已验收）
**性质**：技术输入稿（deck 源码/pya 真库在组长侧，本机无 klayout——几何真值与补丁逻辑全给，落码验证在组长侧）

---

## 〇 一句话

deck 现状 bug = 端子识别区取 **body 级 covering bbox**（npn13G2_dev=covering(e/b/c)，npn13G2_b=dev−c_pin≈整 body）→ 骑体金属落入即整域拽进端子节点。修复 = **识别区按定律 v2 真值收紧 + cont 落点门**，三通道（E/C/B）各自锁定：

```
E 通道 = 域 ∩ emwind 窗列 ≠ ∅（无需 cont）                      ← connect(emwind_drw, metal1_con) 原语义保持
C 通道 = 域 ∩ c_pin 带 ≠ ∅ ∧ 域内 collector cont 落点数 ≥ 1
B 通道 = 域 ∩ (b_pin 带 ∨ body 矩形) ≠ ∅ ∧ 域内 base cont 落点数 ≥ 1
```

## 一、真值表（dump 实测，v17 GDS；cell 坐标 µm）

| 区 | 几何 | y_cell | x |
|---|---|---|---|
| te（emwind 窗） | 每指一条 0.070×0.900 竖窗 | −0.45 ~ +0.45 | 各指中轴 ±0.035（指距 1.85） |
| tc（c_pin） | 18.5×0.30 横带 | +0.98 ~ +1.28 | 全宽 |
| tb（b_pin） | 18.6×1.81 横带 | −2.43 ~ −0.62 | 全宽 |
| collector cont 孔带 | — | +1.05 ~ +1.21 | 全宽 |
| base cont 孔带 | — | −1.22 ~ −1.06 | 全宽 |
| ~~body 全矩形~~ | — | −2.43 ~ +1.28 | **仅 B 通道第二识别面（与 b_pin 并 OR），不再是 dev 本体** |

## 二、补丁逻辑（伪 Ruby，对应 bjt_derivations.lvs L59 一带的改写）

```ruby
# ── BEFORE（bug 语义）─────────────────────────────────────
# npn13G2_dev   = poly.select(...).extents            # body covering bbox
# npn13G2_c     = dev & c_pin_layer                   # c_pin 图形层（宽）
# npn13G2_b     = dev - c_pin_layer                   # ≈ 整 body（宽）← 幻影焊根源
# npn13G2_e     = dev & e_pin_layer                   # e_pin 图形层（宽）

# ── AFTER（定律 v2：识别区=真值带，域级指派加 cont 门）─────
te = emwind_drw            # (61,0)? emwind 窗层——以 deck 现有 layer 引用为准
te_band  = te.extents      # 每指 ±0.035 × y −0.45..+0.45（不必重建，直接用窗层）
tc_band  = c_pin_layer.extents & box(y: 0.98..1.28)   # c_pin 带
tb_band  = b_pin_layer.extents & box(y: -2.43..-0.62) # b_pin 带
body_band= dev.extents     # body 全矩形（只作 B 通道 OR 项，见 L59 原语义保留但加门）

cont_c = cont_drw & box(y:  1.05..1.21)   # collector cont 孔带
cont_b = cont_drw & box(y: -1.22..-1.06)  # base cont 孔带

# 端子识别（域级）：
npn13G2_e = metal1_con.select { |d| d.interacting?(te_band).any? }  # E：骑窗即焊，无 cont
# C：骑 c_pin 带 ∧ 域内(并集)含 ≥1 collector cont
npn13G2_c = metal1_con.select { |d| d.interacting?(tc_band).any? && d.interacting?(cont_c).any? }
# B：骑 b_pin 带 ∨ body 带 ∧ 域内含 ≥1 base cont
npn13G2_b = metal1_con.select { |d| (d.interacting?(tb_band).any? || d.interacting?(body_band).any?) && d.interacting?(cont_b).any? }
```

要点（与现行实现的差异清单）：
1. **识别面从 body bbox 收紧为三带**：E=te 带、C=tc 带、B=tb 带∨body（body 仅 B 通道保留——判 4 裁决 tb 参与 base，但 cont 门挡住「无孔骑带」误焊）。
2. **C/B 加 cont 落点门**：「骑带≠焊」实证（★判例：正常 E 指 M1 底缘骑 b_pin 带 0.165µm 不焊）⇒ 域内无对应 cont 孔不得焊。
3. **E 通道不加 cont 门**：connect(emwind_drw, metal1_con) 原语义（dump 证 cont∩e_pin=0）。
4. **域级指派语义不变**：仍是域命中即整域拽入（幻影焊的「域横跨」机制由识别区收紧自然消解——大域骑窗仍会焊，**这是 deck 的固有语义**；修复目标=「该焊的焊、不该焊的不焊」，不是消灭大域）。若要连大域横跨也防，需第二层「域分割」——**不在本补丁范围**（会改变 LVS 语义，须另裁）。
5. **ptap_holes 同源修正**（npn_mk=trans∩ptap_holes）：主管 ptap_holes 现为 0 ⇒ npn_mk 恒空 ⇒ 主管不识别。修正 = ptap_holes 收集或 npn_mk 判定改为 `trans ∧ (ptap_holes ∨ body_band)`（与 B 通道同口径），或 ptap_holes 层引用按 PDK 实际补齐——两者组长侧二选一，几何效果等价：主管不再因 ptap 缺失而漏识。

## 三、修复后预期（重提验收对照）

| 案 | 修复前 | 修复后预期 |
|---|---|---|
| 簇甲 ccas1⊕e1（18.6×13.6 大域骑窗列） | 焊 | **仍焊**（固有语义，大域真骑 E 窗）——伴生 FAIL 属**版图回改**（见我方「真短定谳」名单与 E 断路 0.085µm 案，均版图侧修） |
| 簇乙 XBI1/nref⊕gnd（M1 打底方块四表同现） | 焊 | **视几何**：该方块 y_cell −1.45..+1.44 骑 te 带 ⇒ 仍焊；**其真实根因=「C=B 竖线压 E 指」版图真短**（我方 2026-10-18 定谳名单 8 只），deck 修复后将以连通 FAIL 首次可见 |
| bb1 M5 横带骑 XQr body（drv1 立照） | 不焊 | 不焊（M5 无通道，v2 判例 5 预测） |
| ntail M1 骑 XQo（判例 1/6） | 不焊 | 不焊（无窗无 cont） |
| 主管识别 | 漏（ptap_holes=0） | 识别恢复（§二.5） |
| LVS×v3 闭环判据 | — | 合并名消散 + bulk 对上 v3 + R$13/14 归位（判定照旧，§七） |

## 四、ETA 与分工现状（答 91 行 §五）

- 本补丁稿：**已出**（即本件，随信投 8510）。
- deck 本体落码+两件 knife 复现件回归（cb_G1only 应仍焊/ct_XQ1only 应仍焊 + 新增「bb1 M5 立照」+「ntail 幸免」两条反例回归）：**组长侧**（pya 真库在彼）。
- 我侧同步件已备：pex_extract 端子锚定修复版（TERM_LAYER）+ pex_cdl_audit 六判据审计台 + 演练件，候窗复跑。
- **ETA 建议**：补丁稿到件即可落码；knife 两件回归 + 反例两条 = 四跑，半口内可毕。fde9 守候 06:06Z 到点前，建议回执「补丁稿已到、落码回归中」先稳节奏；若 06:06Z 前毕不了，守候顺延不损失（主闸门序列不变）。

## 五、诚实边界

- 本稿未在本机跑过 deck/pya（真库在组长侧）；`box(y:)` 之类的伪 API 只是示意，落码以 KLayout DRC/LVS 实际原语（`with_y`/`extents`/`interacting` 等）为准。
- 识别带数值全取自组长 dump 裁决（v17 GDS 真值），若 v19 GDS 的 PCell 版本变更过这些带，以重 dump 为准——**v17→v19 PCell 未动**（本口复现链验证过几何零变化），数值应当有效。
- 若修复后重跑仍有 31/31 b=e：按 R2 回改流程走（版图真短清单已在手），不得以改名掩盖。

—— b7e7 · 2026-10-18
