oppry12102/WIFI7-TX/06_layout_design_notes/drv2_suspicious_w4_outlier2.md

# §4.1-A 逐角 drv2_suspicious 判读表（tag=w4_outlier2）

- 台账：`/data/workspace/sim_report/pex_jia_20261018/pkg_v1/extracted/archive_pkg_fixture_v1/selftest_pvt27/outlier2/pvt27_ledger.json`（sha256 `629a7cb0bcf43beb`）
- 可判角 **27** / 总 27（error 0）；ΔCG 全网格 median=+0.00003 dB，MAD=0.00031 dB
- 硬置位（|ΔCG|>0.050 dB）**0** 角；候选置位（**并集**：臂A≥0.010 dB **或** 臂B z≥3.0，**裁定九已预授权**）合计 **1** 角；typ 角置位：**否**
- 置位口径出处：**裁定九（b7a0 2026-10-18T03:34:34Z）** —— 两臂并集，abs=0.010 dB + k=3.0；硬置位角**停该角判读**回组长裁 C 层
- **相邻档位跳变敏感性（机读自算）**：`jump_any = False`；预授权点并集计数 = **1** 角 → 无敏感跳变 → 裁定九预授权参数（abs=0.010 dB + k=3.0 并集）转正式

| 角 | lib | T(℃) | Vcc | ΔCG(dB) | CG_mix | CG_drv1 | CG_drv2 | z_glob | z_lib | z_nb | 邻角离散(dB) | PASS | 标志 | 依据 |
|---|---|---|---|---|---|---|---|---|---|---|---|---|---|
| hbt_bcs_t-40_v2250 | hbt_bcs | -40 | 2.25 | +0.00042 | — | — | — | 0.02 | 0.23 | 0.57 | +0.00029 | True | — | none |
| hbt_bcs_t-40_v2500 | hbt_bcs | -40 | 2.50 | +0.00013 | — | — | — | 0.02 | 0.23 | 0.29 | +0.00057 | True | — | none |
| hbt_bcs_t-40_v2750 | hbt_bcs | -40 | 2.75 | -0.00015 | — | — | — | 0.02 | 0.23 | 0.31 | +0.00003 | True | — | none |
| hbt_bcs_t125_v2250 | hbt_bcs | 125 | 2.25 | -0.00010 | — | — | — | 0.02 | 0.23 | 0.31 | +0.00003 | True | — | none |
| hbt_bcs_t125_v2500 | hbt_bcs | 125 | 2.50 | -0.00039 | — | — | — | 0.02 | 0.23 | 0.86 | +0.00057 | True | — | none |
| hbt_bcs_t125_v2750 | hbt_bcs | 125 | 2.75 | +0.00052 | — | — | — | 0.02 | 0.23 | 0.63 | +0.00029 | True | — | none |
| hbt_bcs_t27_v2250 | hbt_bcs | 27 | 2.25 | -0.00044 | — | — | — | 0.02 | 0.23 | 0.86 | +0.00052 | True | — | none |
| hbt_bcs_t27_v2500 | hbt_bcs | 27 | 2.50 | +0.00047 | — | — | — | 0.02 | 0.23 | 0.60 | +0.00031 | True | — | none |
| hbt_bcs_t27_v2750 | hbt_bcs | 27 | 2.75 | +0.00018 | — | — | — | 0.02 | 0.23 | 0.29 | +0.00063 | True | — | none |
| hbt_typ_t-40_v2250 | hbt_typ | -40 | 2.25 | -0.00060 | — | — | — | 0.02 | 0.23 | 0.63 | +0.00029 | True | — | none |
| hbt_typ_t-40_v2500 | hbt_typ | -40 | 2.50 | +0.00031 | — | — | — | 0.02 | 0.23 | 0.86 | +0.00057 | True | — | none |
| hbt_typ_t-40_v2750 | hbt_typ | -40 | 2.75 | +0.00003 | — | — | — | 0.02 | 0.23 | 0.31 | +0.00003 | True | — | none |
| hbt_typ_t125_v2250 | hbt_typ | 125 | 2.25 | +0.00008 | — | — | — | 0.02 | 0.23 | 0.31 | +0.00003 | True | — | none |
| hbt_typ_t125_v2500 | hbt_typ | 125 | 2.50 | -0.00021 | — | — | — | 0.02 | 0.23 | 0.29 | +0.00057 | True | — | none |
| hbt_typ_t125_v2750 | hbt_typ | 125 | 2.75 | -0.00049 | — | — | — | 0.02 | 0.23 | 0.57 | +0.00029 | True | — | none |
| hbt_typ_t27_v2250 | hbt_typ | 27 | 2.25 | -0.00026 | — | — | — | 0.02 | 0.23 | 0.29 | +0.00063 | True | — | none |
| hbt_typ_t27_v2500 | hbt_typ | 27 | 2.50 | -0.00055 | — | — | — | 0.02 | 0.23 | 0.60 | +0.00031 | True | — | none |
| hbt_typ_t27_v2750 | hbt_typ | 27 | 2.75 | +0.00037 | — | — | — | 0.02 | 0.23 | 0.86 | +0.00052 | True | — | none |
| hbt_wcs_t-40_v2250 | hbt_wcs | -40 | 2.25 | +0.00024 | — | — | — | 0.02 | 0.23 | 0.03 | +0.00031 | True | — | none |
| hbt_wcs_t-40_v2500 | hbt_wcs | -40 | 2.50 | -0.00005 | — | — | — | 0.02 | 0.23 | 0.34 | +0.01971 | True | — | none |
| hbt_wcs_t-40_v2750 | hbt_wcs | -40 | 2.75 | +0.02000 | — | — | — | 0.02 | 0.23 | 20.02 | +0.00003 | True | **置位** | candidate |
| hbt_wcs_t125_v2250 | hbt_wcs | 125 | 2.25 | -0.00028 | — | — | — | 0.02 | 0.23 | 0.29 | +0.00057 | True | — | none |
| hbt_wcs_t125_v2500 | hbt_wcs | 125 | 2.50 | -0.00057 | — | — | — | 0.02 | 0.23 | 0.86 | +0.00057 | True | — | none |
| hbt_wcs_t125_v2750 | hbt_wcs | 125 | 2.75 | +0.00034 | — | — | — | 0.02 | 0.23 | 0.63 | +0.00029 | True | — | none |
| hbt_wcs_t27_v2250 | hbt_wcs | 27 | 2.25 | +0.00058 | — | — | — | 0.02 | 0.23 | 0.34 | +0.00052 | True | — | none |
| hbt_wcs_t27_v2500 | hbt_wcs | 27 | 2.50 | +0.00029 | — | — | — | 0.02 | 0.23 | 0.31 | +0.00060 | True | — | none |
| hbt_wcs_t27_v2750 | hbt_wcs | 27 | 2.75 | +0.00000 | — | — | — | 0.02 | 0.23 | 0.34 | +0.01966 | True | — | none |

## 置位口径二维灵敏度网格（裁定九附条件用数据；本脚本不作决定、不据此改参）

| 臂A abs(dB) | 臂B k | 臂A 命中 | 臂B 命中 | 并集 | 并集(除硬置位) | 角名(除硬置位) |
|---|---|---|---|---|---|---|
| 0.005 | 0.005,k | 1 | 1 | 1 | 1 | hbt_wcs_t-40_v2750 |
| 0.005 | 0.005,k | 1 | 1 | 1 | 1 | hbt_wcs_t-40_v2750 |
| 0.005 | 0.005,k | 1 | 1 | 1 | 1 | hbt_wcs_t-40_v2750 |
| 0.010 | 0.010,k | 1 | 1 | 1 | 1 | hbt_wcs_t-40_v2750 |
| 0.010 | 0.010,k | 1 | 1 | 1 | 1 | hbt_wcs_t-40_v2750 |
| 0.010 | 0.010,k | 1 | 1 | 1 | 1 | hbt_wcs_t-40_v2750 |
| 0.020 | 0.020,k | 1 | 1 | 1 | 1 | hbt_wcs_t-40_v2750 |
| 0.020 | 0.020,k | 1 | 1 | 1 | 1 | hbt_wcs_t-40_v2750 |
| 0.020 | 0.020,k | 1 | 1 | 1 | 1 | hbt_wcs_t-40_v2750 |
| 0.050 | 0.050,k | 0 | 1 | 1 | 1 | hbt_wcs_t-40_v2750 |
| 0.050 | 0.050,k | 0 | 1 | 1 | 1 | hbt_wcs_t-40_v2750 |
| 0.050 | 0.050,k | 0 | 1 | 1 | 1 | hbt_wcs_t-40_v2750 |

## 下一步（不自决）

- 按 §4.1-C 再议触发：置位角 1（阈值 ≥3 或 typ 角置位）—— **本脚本不自动执行任何后续动作**，等组长裁定
- 若置位成立，B 层事后诊断（§4.1-B，单角追加 save 五向量 + 1ns 零 unknown-node 验证）由 `m5_drv2_bias_probe.py` 执行；是否执行等组长裁定。
