oppry12102/WIFI7-TX/06_layout_design_notes/HBT带金属半宽实测报告_2026-10-18.md

# HBT 带金属半宽全档实测报告（2026-10-18）

b7e7 · 兑现裁定四十「带金属投影互压检查」候件（R-PLACE-01 · HBT级版图准则 v1.5 附则②）
对象件：`design/sow6/gds/{m2_mix_v29, m3_drv1_v20, m3_drv2_v20}.gds`（组长代跑真 GDS）
落地产物：`design/sow6/hbtgeom.py`（**3044477b**，v1.7 更正版）+ `dryrun/bandproj.py`（96129b1e，㉒+㉓）
　　　　`dryrun/band_measure.py`（89881b28）+ `dryrun/preflight.py`（3f0b4ae7，㉒+㉓ 项）

> ⚠⚠ **2026-10-18 23:19Z 裁定四十六 §二 · B 带律更正（本报告 §〇/§二/§三 随之更正）**
> 组长在真 GDS 独立复算后推翻我的一句话：**「B 带 0.975×NX，五档残差 0」是错的**——
> 错在把 **NX=1 的比值**当成了每档斜率。B 五档「半宽/NX」实为
> **0.975 / 0.9417 / 0.9333 / 0.9313 / 0.9300**，**不是常数**；
> 且与我本报告 §二 表里自己的数字**自相矛盾**（按我自己的数算就是上面那四个比值）。
> **真律 = 仿射式 B = 0.925×NX + 0.05**（常数项 0.05 恒定；NX=1 时恰好 = 0.975 ⇒ 掩盖了这个错）。
> 五档残差仍为 0：0.925×{1,3,6,8,10}+0.05 = 0.975/2.825/5.60/7.45/9.30。
> **影响面**：现役三件走**表内实测档 ⇒ 判据零变化**；错的只有表外 NX 的外推路径，
> 且方向偏严（NX=5 时 4.88 vs 真 4.68）——不致假 PASS，只会把余量报小、扩档时误拦合法摆位。

## 〇、一句话结论

**带金属半宽 = 0.925×NX + 0.05（B 带）/ 0.925×NX（C 带），五档实测残差 0**
（⚠ 原写「B=0.975×NX」已被裁定四十六推翻，见头注：0.975 是 **NX=1 的比值**，不是斜率）：
NX=1/3/6/8/10 的真 GDS 长条宽度分别为 1.95/5.65/11.20/14.90/18.60µm，
**逐档落在同一条仿射线上**（0.925×NX+0.05）。
原真值表只有 1 与 10 两点（mix v29），drv2 整组 NX=8、drv1 的 NX=6、mix 的 NX=3 全部落在
「无真值 ⇒ 不量」的黑洞里；补全后 **preflight 第 ㉒ 项的可判对数从 6/0/8 升到 25/2/30**
（mix v31 / drv1 v20 / drv2 v20），且 v29 真短缺陷件仍被如实判 FAIL。

## 一、实测方法与两个踩坑（方法比数字值钱）

工具：`dryrun/band_measure.py`（gdstk 读真 GDS → layer 8 长条聚类）。

1. **M1 = layer 8**（drcgeom.py 真值表）。真 GDS 复核：layer 8 里确有宽 18.50/18.60 的
   长条，与 v29 根因报告 §一3 实测逐位吻合 ⇒ 层号真值成立（**别再扫 129**——那是 via 阵列）。
2. **不能按坐标找带，要按宽度聚类**：真 GDS 有**全局平移**（实测 mix v29 偏移
   (+28.35, −30.00)：C 带在 GDS 里是 `x[−0.925, 17.575] y[1.02, 1.46]`，而 gen 侧
   C 引脚是 (−20, +31.24)）。按「带中心 = 引脚坐标」去 GDS 里找 ⇒ 恒 0 命中，
   差点误判成「真 GDS 里没有带金属」。**宽度是平移不变量**，直接量宽度。
3. `gdstk.Polygon.bounding_box()` 两点的 min/max 顺序**不保证**，须自行归一化
   （第一次量出负宽/错区间就是这个）。

## 二、实测数据（五档 × 两带，长条宽度 µm）

| NX | C 带宽 | C 半宽 | B 带宽 | B 半宽 | C 半宽/NX | **B 半宽/NX（实测比值）** | B 半宽 − 0.925×NX | 出处 GDS |
|---|---|---|---|---|---|---|---|---|
| 1  | 1.85  | 0.925 | 1.95  | 0.975 | 0.925 | **0.9750** | **+0.050** | mix v29 / drv1 v20 / drv2 v20（三件同值） |
| 3  | 5.55  | 2.775 | 5.65  | 2.825 | 0.925 | **0.9417** | **+0.050** | mix v29 |
| 6  | 11.10 | 5.550 | 11.20 | 5.600 | 0.925 | **0.9333** | **+0.050** | mix v29 / drv1 v20 |
| 8  | 14.80 | 7.400 | 14.90 | 7.450 | 0.925 | **0.9313** | **+0.050** | drv1 v20 / drv2 v20 |
| 10 | 18.50 | 9.250 | 18.60 | 9.300 | 0.925 | **0.9300** | **+0.050** | mix v29 / drv2 v20 |

**残差全零**（C：半宽 = 0.925×NX 精确；B：半宽 − 0.925×NX ≡ **+0.050** 恒定 ⇒
**B = 0.925×NX + 0.05**，五档残差 0）。
⚠ 最后一列「B 半宽/NX」**不是常数**（0.975→0.930 随 NX 递减）——这正是原报告自相矛盾之处：
表里写 0.975、而按表里的数算出来是四个不同的比值。**仿射律才是真律**。副产物（不入判据，但解释了为什么「C 带 0.44 / B 带 0.24」可作旁证）：
带金属 y 向高度与 NX 无关（C 0.44 / B 0.24），远小于 npn bbox 恒高 7.11 ⇒
**同行筛选用 bbox 恒高即保守充分**，不必另建 y 向半高真值。

非带长条（勿误当带用）：drv1/drv2 里的 1.32 / 1.71 / 2.56µm 条是 **E 指条**（条数 6、
y 位置不同、x 起点带 +0.02 偏移），宽度与 NX 无关。

## 三、落地：preflight 第 ㉒ 项「邻件 C/B 带金属投影互压」

判据（`dryrun/bandproj.py`）：同行（bbox y 相交）两支 npn，横向锚距须 ≥
`BAND_HALF(nx_a) + BAND_HALF(nx_b) + **自设保守间距 0.63**`；带中心取 C/B **引脚坐标**
（实测吻合：XQo C 带中心 = C 引脚 x/y）。
⚠ **0.63 的出处分两处写（裁定四十六 §三）**：0.63 = **自设保守项**（我的摆位裕度，
PDK 全库 grep 零命中）——**不是** DRC 判据；带↔带的 PDK **适用值**是 **M1.b 0.18**
（带高 0.44/0.24 ⇒ 触发不了 M1.e 0.22）。报「不合规」只能引 0.18/0.22，
引 0.63 只能写「低于自设保守项」。

纪律三条（写在代码里，不留给下口猜）：
1. **只用真 GDS 实测档**；表外档位按**仿射律**取值（B: 0.925×NX+0.05 / C: 0.925×NX，
   裁定四十六 更正，原 0.975×NX 已废）并在输出里标注「按律外推」，不静默套值。
   五档零残差是可辩护的证据，但来源必须可见。
2. **只判 x 向**；y 向靠 bbox 恒高同行筛选（保守充分，理由见 §二末）。
3. **残余盲区（v1.7 已兑现）**：带金属 vs **自画** M1 矩形的互压 → **第 ㉓ 项**
   （`band_wire_audit()`，只读告警；首轮：现役三件硬档 0、软档 2，且**有牙验证**成立——
   缺陷件（竖轨 ∓16.2→∓15.6 落进 B 带投影）报 2 条硬档、其余 22 项全绿）。

### 有牙验证（1 处注入 = 1 处真 FAIL，其余全绿）

| 件 | 同行可判对 | 最紧一对 | 需求 | 余量 | 结论 |
|---|---|---|---|---|---|
| mix v31 | 25 | XBI1_XQo(10)↔XQr(1) | 10.91 | **+1.09** | PASS |
| mix **v29**（真短缺陷件） | 25 | XBI1_XQo(10)↔XQr(1) | 10.91 | **−2.21** | **FAIL（抓出）** |
| drv1 v20 | 2 | XQ1(6)↔XQ2(6) | 11.83 | +16.17 | PASS |
| drv2 v20 | 30 | XBI1_XQr(1)↔XBI2_XQo(8) | 9.06 | +2.94 | PASS |

v29 报出的正是真 GDS 实锤的那一对（QR_L=8.7 落进 XQo 带金属投影），与根因报告
§一3 的多边形级证据互为独立复核（报告是人工拆多边形，本项是自动算锚距）。

## 四、顺带修掉的一个**假 FAIL**（preflight ⑮ 项）

v31 首次跑 ㉒ 时 ⑮ 项直接报 `[FAIL] ⑮ HBT 间距量测异常 module 'hbtgeom' has no
attribute 'audit'` ⇒ 整件判 FAIL。根因：**两个模块同名**——`dryrun/hbtgeom.py`（⑮ 项
间距量测内核，有 `audit`）与 `sow6/hbtgeom.py`（裁定四十的带金属真值表，无 `audit`）；
gen 脚本运行时会把自己的目录（sow6）插到 `sys.path[0]`，于是 preflight 的
`import hbtgeom` 拿到的是后者。**修法：两处都改成按文件路径 `importlib` 加载**
（⑮ 加载 dryrun 那份、㉒ 加载 sow6 那份），不再依赖 sys.path 顺序。
教训：**同名工具模块 + 靠 sys.path 解析 = 迟早串味**，自检台这种「判对错」的东西尤其致命。

## 五、现役状态与后续

- 三件现役（mix v31 / drv1 v20 / drv2 v20）preflight 全 PASS，㉒ 项 22 项齐跑。
- 下一步若要再进一步：把「带金属 vs 自画 M1 异网互压」做成第 ㉓ 项（需先解决同网归属：
  用 label→连通域把每个自画矩形标上网名，与带金属上无网名标注的矩形对照）。
- 数字真值入口唯一：`design/sow6/hbtgeom.py`（BAND_HALF_UM / band_half()），
  gen 侧 `_qr_l_assert` 与 preflight ㉒ 共用同一份——**两处口径不许各写一份**。
