oppry12102/WIFI7-TX/06_layout_design_notes/HBT档位设计依据_we70n_le900n与Nx配比_2026-10-18.md

# HBT 档位设计依据：we=70n / le=900n 与 Nx 配比（组长裁定四十 §三 形式补档）

b7e7 · 2026-10-18 12:4xZ · 承裁定四十「请补一段设计文档依据（为何 HBT 按 70n/900n 设计、Nx 配比意图），形式补档不阻塞，随下版交付」

> **〔v1.1 修订 2026-10-18 · 裁定四十二收编（纪要 9806c534）〕**：本文写于裁定四十二之前，三处口径按下修订（原文保留，档案完整性）：
> ① 「不是疏漏/缺口闭合」——档位**电学惰性**成立后，显式写档与裸挂默认档**电学等价**（fde9 (i) 单变量跑 136MB 载荷逐字节恒等、Δ=0.000000 dB）；「补显式参数」的价值=**网表忠实记录版图实物（忠实性/审计面）**，非电学修正。裁定四十「前仿裸挂默认档=疏漏」**作废**。
> ② 「17.4465 降级『默认档前仿基线』留档」——**作废**：17.4465 **恢复为基线 v2 正锚**（语义=档位恒等已实证：显式 70/900 与默认档数值恒等）。
> ③ 本文三锤依据（官方 PCell 默认档/全链只传 Nx/PEX 实证）与 Nx 配比表**全部照旧成立**——版图侧纪律不受裁定四十二影响（XQ 显式写 70/900 仍正确）。

## 〇、结论一句话

**设计档位 = we 70nm × le 900nm，出处 = SG13G2 官方 npn13G2 PCell 默认档**：全链 gen 只传 `Nx`、从不传 `we/le`，器件几何保持官方原语默认——这是**设计纪律**（版图侧器件几何零自由化），不是疏漏；前仿裸挂落 120/960 是 PDK 两处默认**不同源**造成的缺口，补显式参数即闭合（裁定四十 §三已定谳：版图实物=设计真理）。

## 一、三锤依据

1. **官方 PCell 默认值（源头实证）**：`npn13G2_code.py`（IHP-Open-PDK@main，`ihp-sg13g2/libs.tech/klayout/python/sg13g2_pycell_lib/ihp/`，git blob sha `81f643366f8e39949a6e8da4290933ba0f070569`，Apache-2.0）：
   ```python
   specs('Nx', 1, 'x-Multiplier', RangeConstraint(1, 10))
   specs('le', '0.9u', "Emitter Length")
   specs('we', '0.07u', "Emitter Width")
   ```
   默认 **we=70n / le=900n**，且 `Nx` 是官方唯一的倍乘自由度（上限 10）。
   官方件已留档：`design/pdk_sg13g2_ref/official_klayout/ihp/npn13G2_code.py`（留档说明 sha `cd7b9ce9…`，全文按路径+blob sha 可复取）。
2. **全链代码事实**：`gen_M2_mix_v31.py / gen_M3_drv1_v20.py / gen_M3_drv2_v20.py` 的 `mkhbt` 全部只传 `{"Nx": nx}`（lib13g2 `mkpc_at(name, "npn13G2", params, …)` 同），we/le 从未出现在任何 gen 交付件——版图实物档由官方默认唯一决定。
3. **PEX 实证**：pex cdl 全部 31 条 XQ 行 `we=70n le=900n`（fde9 note / 组长裁定三十八、四十 均已独立核）——提取器忠实反映版图实物，三方自洽。

## 二、与前仿默认 120/960 的关系（缺口定责）

- 前仿网表（`chain_top_tb_v015_1.sp` 等）XQ 裸挂 `npn13G2 nx=N` → 落 `sg13g2_hbt_mod.lib` subckt 默认 `le=960n we=120n`（组长实锤 lib:43）。
- **PDK 内部两处默认不同源**（PCell 70/900 vs 模型卡 subckt 120/960，发射极面积比 54.5%）。这是 PDK 层面的事实，不是设计错误；缺口在「前仿未显式声明档位」——**前仿 deck 补显式 `we=70n le=900n`**（组长已令 fde9 跑格2 ⇒ `CG_typ_baseline_v2`），17.4465 降级「默认档前仿基线」留档。
- 设计文档自此记录：**TX5G 链全部 HBT 的器件档位 = 官方 npn13G2 PCell 默认档（70/900），Nx 为唯一设计变量**。

## 三、Nx 配比表与意图（TX5G 全链，版图 gen 现役版逐一登记）

| 级 | 器件 | Nx | 意图 |
|---|---|---|---|
| gilbert_mix | XQ1a/XQ1b/XQ2a/XQ2b | 3 | IF 跨导对（gm 块 4 管，差分对称）；d3L/d3R Nx=3 为**在册有意填充管**（台账 DUMMY_DEVICES_mix_Q5Q6，电学惰性） |
| gilbert_mix | XQ3~XQ6 | 6 | LO 开关对（4 管；v015 前仿「开关对 nx 4→6」EVM −1.1dB 优化后的定案档） |
| gilbert_mix | XBI1/XBI2 镜组 | XQo **10** / XQr **1** | 尾电流镜 10:1（XQr 参考支路 Rref 680Ω 定基准，XQo 输出 10 份给 ntail）——10 恰为官方 Nx 上限，10:1 是上限内最大镜比 |
| gilbert_mix | XQs | 1 | 感测支路（Is0=400µA，1 份=参考支路同型） |
| drv1 | XQ1/XQ2 | 6 | 共发驱动对 |
| drv1 | XBI 镜组 | XQo **8** / XQr **1** | 尾镜 8:1 |
| drv2 | XQ1/XQ2 + XQ3/XQ4 | 各 **10** | 共发+共基 cascode（本级电流最大，取上限档） |
| drv2 | XBI1~XBI4 镜组 | XQo **8** / XQr **1** ×4 路 | 尾镜 8:1 四路共用 nref（同型并联，等效 32:4=8:1 不变） |

配比设计规则（入档）：
- **参考管恒 Nx=1**（与 XQs 同型——基准电流一份），输出管 Nx=输出/参考电流比；
- **电流比 >10 时并联多路镜组**（官方 `RangeConstraint(1,10)` 上限所迫），各路同型（drv2 四路范式）；
- **开关/跨导对取偶数大档**（6/3）兼顾 gm、开关 Rp 与版图指列排布；PA 级电流需求最大处顶格 Nx=10。

## 四、单位量纲备忘

- 单指发射极面积 Ae = 0.07 × 0.9 = **0.063 µm²**；版图任一 HBT 实物发射极面积 = Nx × 0.063 µm²。
- 前仿默认档 Ae′ = 0.1152 µm²（1.829 倍）——CG_typ_baseline_v2 补显式参数后，仿真/版图两面的「电路」才重新是同一个。

—— b7e7（WiFi7-TX-组员）2026-10-18 · 形式补档完，随 v31 交付
