oppry12102/WIFI7-TX/06_layout_design_notes/HBT级版图准则_v1.8_b7e7.md

# HBT 级版图准则 · 发射极路径与地轨回流（v1.8 裁定六十补充追记版）

> **执笔**：WiFi7-TX-组员 b7e7　**日期**：2026-10-16（v1.5 修订 2026-10-18；v1.6 补录 2026-10-18；v1.7 裁定四十六更正 2026-10-18 23:19Z；**v1.8 裁定六十补充追记 2026-10-19**）　**状态**：**v1.8 现行版**
>
> ⚠ **版本号说明（组长 2026-10-18 23:20Z §二.2 律：取件请认准版本号）**：同版本号两份不同 sha 是本组明文点过的高危形态。
> v1.7（**414c3e73**）已被组长登记 ⇒ 本版**另立 v1.8**，是 v1.7 的**超集**（v1.7 全文逐字保留 + 本版追记段 〇·O），
> 无删改、无回退风险。取件请以本件 sha 为准；v1.6（dcd7c368）已加「⛔ 历史件」横幅（含 0.975 错律，不得作设计依据）。
> ⚠ **v1.8 追记的五件事（全部来自裁定六十/六十补充 + 本口实测自曝）**：
> ① **律 F15 条款正文**（交付件真跑背书）——组长两次交办（裁定五十一立律、裁定六十补充 §一 维持），本版落地；
> ② **DRC 门限真值回填**：M2.b/M4.b = **0.21**（官方原文 5.17），我 drcgeom 表里原写 0.27 是**凭同族类推编的**；
> ③ **DRC 计数按并集域、不按 polygon**（裁定四十六 §六.2 去重律的升级）——M4.b 我数 3/6、官方 1/2 的根因；
> ④ **㉓ 已升硬闸**（前置对表完成：官方 8 条 M1.b 全归 PCell 内部，㉓ 抓不到 ⇒ 不假报）；
> ⑤ **LVS 源网表三条形态律**：衬底写法一致性（D2）/ cap_cmim 官方 2T 形态（D1-C）/ 端口集合逐字对齐。
> ⚠ **v1.7 三处实质更正（全部来自裁定四十六，本版照留）**：① B 带律 0.975×NX → **0.925×NX+0.05**（真 GDS 独立复算推翻，原写法把 NX=1 的比值当成了斜率）；② 间距 0.63 **标源**＝自设保守项，PDK 适用值是 M1.b 0.18（0.63 与 0.18 分两处写，不许混写）；③ 新增第 ㉓ 项（带金属 × 顶层自画 M1，v1.7 时为只读告警，**v1.8 已升硬闸**）。
> **升版依据**：组长 2026-10-16T14:12Z 信裁决点——① via_stack 按层分别给出升硬要求；② R-EMIT-02 修订；**③ 2026-10-17 E 回流链断路案（v18 物理断路实锤）→ 新增 R-VIA-01 族准则：凡按 PCell 外接尺寸推内部形状位置一律禁止，必须用实际块坐标。**
> **数据源**：SG13G2 PDK 官方文档真值（回填纪要 `design/回填_SG13G2_via_EM_20261016.md`，
> 原件落盘 `design/pdk_sg13g2_ref/` 4 文件、blob sha 在案，可复现；IHP-Open-PDK-docs main@f79c1aa6，取数 2026-10-16T12:00Z）。
> **证据链**（沿 v1.1 不变）：① SOW-3 v2.0/v2.1 版图实证；② v2.2 v014 定稿板 .op 实测工作点（`phys/gilbert/sim/opcheck_drv2.py`）；
> ③ DRV2 发射极回流电阻全链 tran 扫描（`emit_scan_drv2.py`）。
> **适用范围**：本项目所有 npn13G2 HBT 共射/共基级（混频 gm 对、LO BUF、DRV1/DRV2、PA）。

## 〇、v1.2 的四处修订（先把话说清楚）

| # | v1.1 的说法 | v1.2 实测后（SG13G2 PDK 真值） | 性质 |
|---|---|---|---|
| 1 | R-VIA-01 单 via 电阻用**假设值** 0.15~1Ω 一张表（7 倍跨度），阵列 5×5~13×13 | 真值分层：**contact 17Ω/件、Via1~4 9Ω/件（target）、TopVia1 2.2Ω、TopVia2 1.1Ω**——假设值与真值差 **7~60 倍**，原表阵列规模结论反转（13×13 → 千级；或改 stack 减层结构，见 R-VIA-01 v1.2 表） | **数据回填 + 结论改写** |
| 2 | R-EMIT-02 用 **1 A/µm 保守工程值**（「Black 方程参数待 b7e7 版图侧确认后回填」） | PDK **Jmax 真值（基准 = 11 年寿命 @105°C 结温，Black 已内化）**：M1 1 mA/µm、M2~M5 2 mA/µm、TM1 15、TM2 16 mA/µm；Contact 0.3 mA/件、Via1~4 0.4 mA/件、TV1 1.4、TV2 10 mA/件。双层并联处方改为 **M2+M3 各 ≥8µm**；M1 段若在回流链 **≥15µm** | **参数回填 + 条款改写** |
| 3 | 「gm 实测比 Ic/VT 小 → 预算**放宽** ~15~20%」（§〇.2 因果表述） | gm 高估 → 1/gm **低估** → Ze **低估** → 预算**更紧**。与「签核取小」最终结论一致，但方向照抄会误导后人 | **勘误** |
| 4 | R-VIA-01 表行「1.0Ω → 24 个（5×5）」 | 按 23mΩ 预算应为 **44 个**（该行整体随 #1 新表作废） | **勘误 + 表替换** |

## 〇·5 v1.4（2026-10-17，E 回流链断路案）

| # | 修订项 | 内容 | 性质 |
|---|---|---|---|
| 1 | **R-VIA-01 族新增：PCell 外接尺寸禁令** | 凡按 PCell 外接尺寸推内部形状位置一律禁止，必须用**实际块坐标**（同 R-VIA-01 族教训）。根因：v18 place_emit_chain 的 arm_bot 按 via 外接高（+0.09/边）推，而 via_stack PCell 的 M2 焊盘实际只外沿 +0.005/边 → 臂底悬在焊盘顶之上 0.085µm → **直流断路**（v18 实锤：e1/e2 各裂两簇，四方独立验证闭合）。修复：emitpath.place_emit_chain 新增 `lap` 参数（默认 0.6µm），臂底延伸使臂与桶 M2 焊盘重叠 ≥0.5µm（验收线）。只延 0.09 剩 5nm 形同虚设，不收。 | **新准则** |
| 2 | R-VIA-01 补充：焊盘顶 = 孔阵顶 + 0.005/边（实测），非外接高 + 0.09/边 | via_extent 返回的是孔阵+0.09/边的"外接"尺寸，不是真实焊盘平台。真实平台按层分别量取（TopVia1 七档实测：1×1→TM1 1.64/M5 0.62、3×2→2.94×2.10、13×3→11.34×2.94、37×1→31.50×1.64，平台律 TM1=0.84(n−1)+1.26 单行钳 1.64、M5=0.84(n−1)+0.62）。 | **数据回填** |

> 机制层面的结论（33.5dB 落差来自发射极小信号阻抗失配，而非直流漂移）**不变**，仍由 v2.0/v2.1 的
> 归零实验与单因子实验支撑。v1.2 只把「via 与 EM 两块最后的不确定项」换成 PDK 真值口径。
> v1.1 的三处修订（Re=1.5Ω/边、gm 实测口径、M2 可做性）继续有效。

## 〇·6 v1.5 附则三件套（2026-10-18，ntaila 塌陷案＋Q 档位案；裁定四十/四十二收编）

> **升版依据**：组长 2026-10-18T12:32Z 信（M4 v3 收口信 §二）「HBT级版图准则 v1.5 附则请一并写入：①档位 70/900 入册 ②裁定四十新律 ③preflight 三盲区备案」；口径按裁定四十二（Q 档位证伪收编，纪要 8510 `design/sow6/判读纪要_裁定四十二_Q档位证伪收编_2026-10-18.md`，4506B sha 9806c534）。

### R-NX-01（v1.5 新增）　HBT 版图档位入册与档位电学惰性

> **npn13G2 版图实物档位 = we=70nm / le=900nm（官方 PCell 默认档），gen/网表/文档三面对齐、显式写档；镜像比一律由 Nx 表达（参考管恒 1、输出管=电流比、Nx>10 并联多路），we/le 不作设计变量。**
> **档位电学惰性（裁定四十二）**：we/le 在 `sg13g2_hbt_mod.lib` L41–49 `.subckt npn13G2` 内为**哑参数**（声明后零引用；模型唯一电学尺寸旋钮 = Nx，cbeo='8.00E-16·(Nx·0.25)^0.975'）。fde9 (i) 单变量跑实证：31 条 XQ 行 70n/900n ↔ 120n/960n 回填，136MB 载荷**逐字节恒等**、CG 16 位有效数字恒等、**Δ=0.000000 dB**。

- **XQ 显式写 70/900 属版图忠实性要求**（PEX 提取忠实记录版图实物，tank 结案同款方法论），**非电学变量**；
- 前仿裸挂默认档（120/960）与显式 70/900 **电学等价**——裁定四十「前仿裸挂默认档=疏漏」**作废**；PCell 默认（70/900）与模型卡 subckt 默认（120/960）不同源仍是 PDK 层面事实，但无电学后果；
- **基线 v2 = typ＋显式 70/900，数值 ≡ 17.4465 dB**（「17.4465 降级留档」说法作废，17.4465 恢复为基线 v2 正锚）；
- 依据件：官方 `npn13G2_code.py` specs 默认 `we=0.07u/le=0.9u`＋`Nx` RangeConstraint(1,10)（blob sha 81f64336，留档说明 cd7b9ce9）；全链 gen `mkhbt` 只传 Nx（we/le 零出现）；PEX 31 条 XQ 实证；设计依据全文 `design/sow6/HBT档位设计依据_we70n_le900n与Nx配比_2026-10-18.md`（6b70f66a，v1.1 已按裁定四十二加修订注记）。

### R-PLACE-01（v1.5 新增）　邻管摆位按带金属实测半宽验距（裁定四十新律①②）

> **镜像/邻管摆位按「邻件带金属实测半宽」验距，不得按 PCell bbox 锚距；带金属半宽入 hbtgeom 真值表（NX=1: 0.98µm / NX=10: 9.30µm，真 GDS 实测）；gen 侧 `_qr_l_assert` 类运行时断言必检、触发即打 PASS 自证。**

- **案例（mix v29 XBI1 镜组真短）**：npn13G2 的 C/B 带金属是横跨全管宽的长条（NX=10 实测 B 带半宽 9.30µm，XQo C 带 x[−29.25,−10.75] w=18.5 / B 带 x[−29.30,−10.70] w=18.6）；旧 QR_L=8.7 < 9.30+0.98 ⇒ XQr(NX=1) 整管落进 XQo(NX=10) C/B 带金属投影 ⇒ 参考网与尾轨 M1 真短、ntaila 二极管化塌陷（PEX 双标签面积账 49.18≈19.77+29.4µm²，XBI2 干净 19.77 对照）——CG −2.93794 dB 的 PEX 面差头号候选（v1 起就在，版图设计缺陷，裁定四十定责）。
- **修复处方**：QR_L=12.0（v31 起，内缘净空 1.72µm ≥ M1 同层净距 0.63 富余）；`_qr_l_assert`：QR_L ≥ 9.30＋0.98＋0.63=10.91。
> 术语脚注（v1.6，组长 §一.3）：1.72µm＝**带端净距**（XQr C/B 带金属边到 XQo 带金属边的内缘间隙）；
> 1.09µm＝1.72−0.63，即减 M1 同层净距后的**实际富余**——与 hbtgeom `assert_neighbor_clear()` margin 口径（返回 1.09）一致。
- **反面教训同源**：PCell bbox 是外接框，不反映带金属真实投影——与 R-VIA-01 族「按外接尺寸推内部位置」教训（v18 断路案）同根，此处升格为**摆位正律**。
- **hbtgeom 真值表实体**：`design/sow6/hbtgeom.py`（**3044477b**，v1.7 更正版；原 fcea395c 含 0.975 错律）：
  `BAND_HALF_UM={1:0.98, 3:2.83, 6:5.60, 8:7.45, 10:9.30}`＝**B 带 0.925×NX + 0.05**、
  C 带 0.925×NX，**五档残差 0**（0.925×{1,3,6,8,10}+0.05 = 0.975/2.825/5.60/7.45/9.30）；
  `band_half(nx)` 对表外档按律取值并标「按律外推」；另 `assert_neighbor_clear()` 供 gen 侧复用。
  ⚠ **B 带律更正（裁定四十六 §二）**：我原写「B 带 0.975×NX，五档残差 0」——错在把 **NX=1 的比值**当成了每档斜率
  （B 五档「半宽/NX」实为 0.975/0.9417/0.9333/0.9313/0.9300，非常数），且与同报告 §二 表内自己的数字自相矛盾。
  真律是仿射式 **B = 0.925×NX + 0.05**（常数项 0.05 恒定；NX=1 时恰好 = 0.975 ⇒ 掩盖了这个错）。
  影响面：现役三件走**表内实测档 ⇒ 判据零变化**；错的只有表外 NX 的外推路径，且方向偏严（NX=5 时 4.88 vs 真 4.68）。

### preflight 三盲区备案（v1.5；裁定四十收档）

check_layout_gen 现行 21 项对「邻件带金属投影互压」存在三处盲区（均抓不到 R-PLACE-01 案例）：

1. **e-pad 审计**——只审计引脚 pad 自身覆盖/极性/金属覆盖，不查邻件带金属投影；
2. **⑱ 同层间距（自画矩形）**——只对 gen 显式画的独立矩形按同层间距规则查，PCell 内部长条带金属不展开成独立图形；
3. **真值表 bbox 建模粗筛（器件间距）**——按 bbox 验距，bbox 相邻≠带金属投影相交；真凶恰是「bbox 相距不远不近、带金属长条伸出实体投影压到邻件」。

⇒ **备案收档**；「带金属投影互压检查」候件补进 preflight 清单（**不设期限**，裁定四十备案；下版 gen 一并交）。

### ✅ 收档后续（2026-10-18 兑现：三盲区的检查已落地为 preflight 第 ㉒ 项）

- **第 ㉒ 项「邻件 C/B 带金属投影互压」**已进 `dryrun/preflight.py`（**3f0b4ae7**，v1.7 版：㉒+㉓），内核
  `dryrun/bandproj.py`（**96129b1e**，v1.7 版：㉒+㉓ 内核）＋真值 `sow6/hbtgeom.py`（**3044477b**，v1.7 更正版）。
  判据：同行（bbox y 相交）两 npn 横向锚距 ≥ `band_half(nx_a)+band_half(nx_b)+M1 净距 0.63`，
  带中心取 C/B 引脚坐标（真 GDS 实测吻合）。
- **半宽真值全档补全**（原表仅 1/10 两点）：从真 GDS layer 8 长条聚类量得
  NX=1/3/6/8/10 的 B 带宽 1.95/5.65/11.20/14.90/18.60 ⇒ **B=0.925×NX+0.05（v1.7 更正，见上）**。
  量测工具 `dryrun/band_measure.py`（**89881b28**，v1.7 版：加 TX5G_ 顶层点名 + 形状去重），报告
  `design/sow6/HBT带金属半宽实测报告_2026-10-18.md`。**方法坑两条**：真 GDS 有全局平移
  （mix v29 偏移 (+28.35, −30.00)）⇒ 按坐标找带恒 0 命中，须按宽度聚类；
  `gdstk.bounding_box()` 两点 min/max 顺序不保证，须自行归一化。
- **有牙验证**：mix **v29** 真短缺陷件被判 FAIL（横向 8.70 vs 需 10.91，互压 2.21µm，
  与根因报告 §一3 多边形级证据互为独立复核）；mix v31 / drv1 v20 / drv2 v20 全 PASS，
  同行可判对数 25/2/30（补全前只有 6/0/8）。
- **顺带修掉一个假 FAIL**：preflight ⑮ 项曾因 `dryrun/hbtgeom.py` 与 `sow6/hbtgeom.py`
  **同名**、gen 脚本把 sow6 插到 `sys.path[0]` 而串味（`no attribute 'audit'` ⇒ 整件判 FAIL）。
  现两处均改为按文件路径 `importlib` 加载。教训：同名工具模块 + 靠 sys.path 解析 = 迟早出事。
- **残余盲区（v1.7 已兑现）**：带金属 vs **自画** M1 矩形的互压 → **第 ㉓ 项**（见 〇·N）。

## 〇·7 v1.6 补录说明（2026-10-18，版本分叉事故修复）

> **升版依据**：组长 b7a0 2026-10-18T13:09Z 信 §二令——结构对账（v1.5 vs design_circuit/HBT级版图准则_v1.3_b7a0注记.md）发现 **v1.4 从 v1.2 底稿出发，未收编 v1.3 注记版（2026-10-17 Q1/Q4 裁决收编）的新增内容**（协作版本管理事故，非内容问题）：R-RES-01/R-ANNO-01 在 v1.5 全文零命中（连正文引用都没有）、变更史从 v1.2 直接跳 v1.4。**知识不能丢**，令补录升 v1.6。
> **补录范围（组长令）**：① R-RES-01、R-ANNO-01 两节**以 v1.3 注记版为真值源原文收回**（一字未动；真值源 design_circuit/HBT级版图准则_v1.3_b7a0注记.md，8510 `design/sow6/HBT_layout_guideline_v1.3_b7a0_annotated.md` 同文）；② 变更史补 v1.3 条目＋本补录说明；③ R-PLACE-01 加内缘净空术语脚注（组长 §一.3）。
> **补录执行者追加（报组长追认）**：执行对账另发现 v1.3 注记版还有**两处注记块**在 v1.5 同样零命中——R-EMIT-02 后「回流金属 Rsheet 真值收编」注记（M1 0.135/M2-M5 0.103/TM1 0.021/TM2 0.0145 Ω/□，15Ω/□ 旧假设作废）与 R-VIA-01 后「via_stack 拓扑口径（Q1 实测定案）」注记（全栈单颗 pycell＋柱下零异网 keepout 必需＋逐层铺栈禁用）——同属 v1.3 新增真值，已按同一「原文收回」原则一并收回至 v1.3 原位；§四 旧估值处方**原文未动**（注记已声明方向安全）。如组长判读补录范围仅限点名两条款，此两块可回退。
> **裁定链**（v1.6 时点）：R-PLACE-01 案例归因已由**裁定四十三落槌收口**（格4 单变量补丁 CG 17.45103071，+2.94247 dB 全额回、残余 +0.00453 门内，ntaila 全额唯一主因；纪要 8510 phys/top/ 双发）；R-NX-01 档位惰性口径不变（裁定四十二）；R-VIA-01 拓扑口径即 Q1 实测定案（收回块在位）。

---

## 一、为什么要有这条准则（不变）

TX5G_AMP2（两级 HBT 放大级，39×21µm，DRC 零违规、LVS PASS）实测：前仿真 **+30.43 dB** / 后仿真 **−3.04 dB**，落差 **33.5 dB**；
把 PEX 网表所有串联电阻归零后增益**逐位回到 +30.43 dB**。机理 = **发射极节点的小信号阻抗 Ze 只有零点几欧姆，
版图回流路径的几欧姆金属电阻直接进分母**；直流只漂 3.4%、Vce 全程 >1.2V，不是直流偏置问题。

> **在 HBT 共射级里，「几欧姆」不是小数目。**

## 二、六条强制准则

### R-EMIT-01（v1.1 沿用）　发射极路径电阻预算

> **发射极回流路径的串联电阻总和（金属 + via + 地轨）≤ 0.1 × Ze，其中 Ze = Re ∥ 1/gm，
> gm 取模型实测小信号值；签核按最冷角（−40℃）并与理想公式口径取小。**

实测曲线背书（`emit_scan_drv2.py`，v014 网表，AC@5.51GHz 测 DRV1→DRV2 级联增益 Gdd，每边发射极支路串入 Rp）：

| Rp/边 | 0 | 0.05 | **0.078（签核线）** | 0.2 | 0.35 | 0.6 | 1.0 | 2.0 Ω |
|---|---|---|---|---|---|---|---|---|
| **ΔGdd** | 0 | −0.060 | **−0.093 dB** | −0.236 | −0.409 | −0.690 | −1.122 | −2.118 dB |
| drv2 Ic | 14.643 | 14.640 | 14.639 | 14.634 | 14.628 | 14.617 | 14.600 | 14.553 mA |

- **0.078Ω 的实测代价只有 −0.093 dB**（链级无损）；按 −0.5dB 判据可用到 **0.35Ω**，余量 4.5 倍。
- **直流侧几乎不动**：Rp 从 0 加到 2Ω（4000 倍），Ic 只掉 0.6%、gm 掉 0.5%、Vce 不变 → 「小信号分压，非直流漂移」再次坐实。
- **反例换算**：amp2 实测那种 1.75Ω/边的发射极 M2 长线，放到 drv2 尺度约值 **−1.7dB**。

实测表（`opcheck_drv2.md`，v014 定稿板 .op 实测）——v1.1 沿用，零变更：

| 级 | Ic/边 | Re | gm 实测 | Ze(27℃) | **预算 27℃** | **预算 −40℃** | 签核取严 |
|---|---|---|---|---|---|---|---|
| **DRV2 / PA**（cascode nx=10） | 14.64 mA | 1.5 Ω | 385.5 mS | 0.950 Ω | ≤0.095 Ω | ≤0.087 Ω | **≤0.078 Ω** |
| **LO_BUF 限幅对**（nx=4） | 7.99 mA | 4 Ω | 176.5 mS | 2.344 Ω | ≤0.234 Ω | ≤0.212 Ω | **≤0.160 Ω** |
| **DRV1**（nx=6） | 3.72 mA | 4 Ω | 110.4 mS | 2.774 Ω | ≤0.277 Ω | ≤0.259 Ω | **≤0.250 Ω** |
| MIXER gm 对（nx=3） | 9.52 mA | 15 Ω | 209.6 mS | 3.620 Ω | ≤0.362 Ω | ≤0.300 Ω | ≤0.300 Ω |
| LO_BUF EF 输入级（nx=2） | 1.72 mA | 20 Ω | 48.2 mS | 10.180 Ω | ≤1.018 Ω | ≤0.898 Ω | ≤0.898 Ω |

- 「签核取严」= 本表实测 gm 口径与 `gm=Ic/VT` 口径**取小者**（后者偏保守）。
  因果方向（v1.2 勘误）：Ic/VT **高估** gm → 1/gm 低估 → **Ze 低估 → 预算更紧**，故取小。
- 限幅对若按导通相单边电流（≈2× 对称点）折算，预算再紧一档 —— PA 级按导通相校核。
- 预算公式对 Re 不敏感（Re≥5/gm 时 Ze≈0.83~0.9×1/gm），**对 gm 极其敏感**（实测 gm 比 Ic/VT 小 15~45%）。

### R-EMIT-02（v1.2 修订）　发射极回流金属的 EM 承载

> **DRV2/PA 级发射极回流金属按 SG13G2 Jmax 真值（基准 = 11 年寿命 @105°C）核算：
> 双层并联推荐 M2+M3（各 2 mA/µm），单层宽度 ≥ 8µm
> （14.64 mA 需 7.32µm/层——**按单层独立承载全电流的保守口径，不依赖双层数流**；
> 理想均流口径仅 3.66µm/层，但版图不承诺均流、且须覆盖单层失效模式，签核一律按保守口径；7.32 × 1.1 裕量 → 8µm）；
> 若回流链含 M1 段（1 mA/µm），M1 段 ≥ 15µm 或与 M2 并联分流后各自核算；
> TM1/TM2（15/16 mA/µm）对 PA 电流天然富余，仅作汇流平面使用。**

- v1.1 的「1 A/µm 保守工程值」作废：对 M1 恰好等于真值，对 M2~TM **系统性偏严 2~16 倍**（双重保守）。
- **Black 温度外推缺省不做**：PDK 表已按 11y@105°C 反推，105°C 覆盖本组全温区工况角；
  如需外推（如 27°C 放宽），按 J(T2)=J(T1)·[exp(Ea/k·(1/T2−1/T1))]^(1/n) 且**标注假设**
  （Al-Cu 文献典型 n=2、Ea=0.5 eV，**非 PDK 数据**；105→27°C 约 ×7.4 载流）。
- 层厚（Target，周长/截面换算用）：M1 0.42µm、M2~M5 0.49µm、TM1 2.0µm、TM2 3.0µm。

> **v1.3 注记（组长，2026-10-17）——回流金属 Rsheet 真值收编**：方阻按 techlef 真值
> （libs.ref/sg13g2_stdcell/lef/sg13g2_tech.lef，开源 PDK 唯一金属 RC 出处）：
> **M1 0.135 / M2-M5 0.103 / TM1 0.021 / TM2 0.0145 Ω/□**；过孔单件 22/20/4.0/2.2 Ω（max 档，见 R-VIA-01 表）。
> 版图侧旧假设 Rsheet=15Ω/□（A1）**作废**（非 poly 亦非金属，两头皆非）；
> 回流电阻核算一律按上列真值重算归档——方向安全：真值≪15，既有 199.3/162.0 mΩ 数字系大幅保守高估，
> 门（250/200 mΩ）与宽度条款不动。

### R-VIA-01（v1.2 修订）　via_stack 按层分别抽出、按层分别签核

> **PA 级与限幅对的 via_stack：PEX/版图侧按 stack 实际层级分别给出各层单层电阻与件数，逐层签核；
> 每层并联件数 N_layer = R_layer单件 / R_layer预算；stack 各层对齐时全桶 N ≥ ΣR_layer / R_预算。**

**SG13G2 单件电阻真值（target / max，V=1V 大链实测）**：

| 层级 | 符号 | Min | **Target** | Max | Jmax（件级，11y@105°C） |
|---|---|---|---|---|---|
| M1→有源硅化物 | RCM1NSD/PSD | 8 | **17 Ω** | 22 Ω | 0.3 mA/件 |
| Via1（M2−M1） | RVIA1 | 5 | **9 Ω** | 20 Ω | 0.4 mA/件 |
| Via2（M3−M2） | RVIA2 | 5 | **9 Ω** | 20 Ω | 0.4 mA/件 |
| Via3（M4−M3） | RVIA3 | 5 | **9 Ω** | 20 Ω | 0.4 mA/件 |
| Via4（M5−M4） | RVIA4 | 5 | **9 Ω** | 20 Ω | 0.4 mA/件 |
| TopVia1（TM1−M5） | RTV1 | 1 | **2.2 Ω** | 4 Ω | 1.4 mA/件 |
| TopVia2（TM2−TM1） | RTV2 | 0.5 | **1.1 Ω** | 2.2 Ω | 10 mA/件 |

**阵列规模换算（drv2 每边 via 桶预算：签核档 23mΩ / 0.2Ω 档 60mΩ / 0.35Ω 档 105mΩ，均按金属 55%·via 30%·地轨 15% 分配）**：

| 方案（target/max） | 23mΩ（签核档） | 60mΩ（0.2Ω 档） | 105mΩ（0.35Ω 档） |
|---|---|---|---|
| Via1 单层 | 392 / 870 | 150 / 334 | 86 / 191 |
| TopVia1 单层 | 96 / 174 | 37 / 67 | 21 / 39 |
| TopVia2 单层 | 48 / 96 | 19 / 37 | 11 / 21 |
| **全 stack（Via1~4+TV1 五层串联 Σ=38.2Ω t / 84Ω max）** | **1661 / 3653** | **637 / 1400** | **364 / 800** |
| **减层 stack（M1/M2 横向汇流，仅 Via1+TV1 两层 Σ=11.2Ω t）** | **487 / 1080** | **187 / 411** | **107 / 236** |

- v1.1 假设表（0.15Ω→13×13 等）作废：真值是假设值的 **7~60 倍**，签核档在真值下需**千级阵列**——
  这不是版图努力问题，是 PDK 单件电阻量级问题。
- **收口裁决（组长 b7a0 2026-10-16T14:5xZ 信：拍板方案 2）**：
  1. 签核档（23mΩ）硬扛——千级 via 阵列，面积代价大（**未采纳**）；
  2. **【已采纳】放宽到 0.2Ω 档**（实测背书：Rp=0.2Ω→−0.236dB，距 −0.5dB 判据仍留 2× 余量）+ 减层 stack → **187 件/边**；
  3. 保持签核档但减层（487 件/边）+ M1 段 ≥15µm（**未采纳**，保留为回退终点）。
  **执行条款（随裁决生效）**：① PA/DRV2 版图落图后 PEX 实测 ≤0.2Ω 方可签核（R-CHK-01 逐网纪律覆盖 via 桶）；
  ② 实测超 0.2Ω 的回退预案：先局部加密到 0.105Ω 档（107 件/边），仍超则回方案 3（487 件/边）；
  ③ 三档换算表在本准则中保留（即上表）。
- EM 校核永远并行做一遍：电阻是主导约束时 EM 全被覆盖（如 Via1~4 需 ≥37 件/层 ≪ 电阻需求），
  但 M1 段是例外（EM 需 15µm 宽 ≫ 电阻需求宽度），见 R-EMIT-02。

> **v1.3 注记（组长，2026-10-17）——via_stack 拓扑口径（Q1 实测定案）**：
> 官方 via_stack(lo,hi) = **全栈单颗 pycell，中间层焊盘全留**（五组合 KLayout pycell 实跑互证，
> 见 8510 design/sow6/probe_viastack_truth_2026-10-17.md）；「焊盘只在两端层」不成立。
> 连带纪律：①**逐层铺栈（旧 cross()/climb()）禁用**——中间层焊盘压他网即真短路（组自检 ⑤c 跨层短路）；
> ②柱下中间层零异网 keepout **必需非保守**（真根因面；组自检 ⑤d 过孔柱压异网，逐柱点名）；
> ③拍板方案 2（0.2Ω 档 + 减层 stack = 187 件/边）与 PEX ≤0.2Ω 签核门**维持不变**。

### R-GND-01（不变）　地轨回流压降预算

> **每一级的地轨回流压降 I×R ≤ 5mV**（发射极电位抬升改 Vbe→Ic；各发射极电位不齐引入共模误差）。

TX5G_AMP2 反例：vss 网 4 个引脚各 R/2=3.82Ω → 两级发射极合计抬高 **35mV**；只把这一条地轨归零，增益回收 **12.2 dB**。
- 就近打地，不要用一条细长地轨串起全块；
- 回流电流按 **max(I_peak)×2** 估（正弦峰值可达均值 2 倍以上，PA 级尤其）；
- 地轨过孔阵列 ≥ 发射极过孔阵列。
- **对 DRV2 的换算**：14.64 mA 下地轨电阻上限 = **341 mΩ**（≈0.34 □ @0.125Ω/□），
  分配给地轨的 12 mΩ 只产生 0.18 mV —— **地轨不是 DRV2 的瓶颈，via 才是。**

### R-CHK-01（不变）　PEX 敏感度必须逐网实测

> **任何多级有源块，PEX 提取后必须做逐网归零敏感度扫描，并入设计签核。禁止用「几欧姆可以忽略」推断。**

v2.1 实测的非单调性：在「地轨+发射极已归零」的基础上**继续**归零集电极 `rc`/供电 `vcc` 的串联电阻，
增益**反而再掉 5dB**。即：增益由**发射极退化 + 级间耦合 + 共用供电**的反馈环路支配，
**各网贡献不可相加，渐进归零的顺序会改变结论**。这条对任何多级有源电路都成立，不限于 HBT。

### R-PEX-01（不变）　周长法 PEX 不得用于评估宽金属

> **评估厚金属/宽金属方案时，电阻一律按 R = RSH × L/W 计算；第一阶「周长法」提取脚本只适用于窄线。**

| 线宽 | 长度 | 真值 RSH·L/W | 周长法 | 高估 |
|---|---|---|---|---|
| 0.5 µm | 14 µm | 3.50 Ω | 3.63 Ω | 1.04×（v2.0/v2.1 结论有效） |
| 6 µm | 7.5 µm | 0.156 Ω | 1.69 Ω | **10.8×** |
| 10 µm | 5 µm | 0.063 Ω | 1.88 Ω | **30×** |

### R-RES-01（v1.3 新增）　器件 poly 电阻真值（cornerRES.lib 官方三档）

| 类型 | bcs | typ | wcs | 局部 1σ(mismatch) |
|---|---|---|---|---|
| **rhigh（高阻 poly）** | 1160 | **1360 Ω/□** | 1560 | 5.0% |
| rppd（精密 poly） | 234 | 260 | 286 | 2.0% |
| rsil（硅化 poly） | 6.02 | 7.0 | 7.98 | 1.7% |

- 本组 2k 器件电阻一律 **rhigh typ 1360 Ω/□** 落图与核算（bcs/wcs 按 27 角跑角自动代入）。
- cmim：PCell 名 **"cmim"+Calculate=w&l**；0.84pF→23.66µm 见方（M2 回执判定口径）。
> v1.6 注（防混读）：本组 mix cmim 实落 **w=l=23.610µm**（Offgrid 5nm 硬纪律，组长 2026-10-18 批准；
> PEX/cdl 口径 w=l=23.610、六只 C=775.202fF 各）；上表「0.84pF→23.66µm 见方」为 M2 回执判定口径，留档。

### R-ANNO-01（v1.3 新增）　注释层纪律（Q4 裁决：官方 deck 无自由注释层）

> 实证（lvs/rule_decks/）：**/25 文本层被 connect(metal*_con, metal*_text) 接进金属网络=次级 label
> 通道**，写非网名必生幽灵网名；**63/0（TEXT.drawing）被器件模式匹配使用**
> （varicap 端口 / ntap·ptap well_patt / isolbox / rfnmos / IND 匹配），任意注释有误识别风险。
> 条款：①占位件/说明类文本**只进 stdout + 设计稿，不回 GDS**；②网名 label 一律打官方 label purpose **/1**
> 层；③金属 drawing /0 禁非网标注；④确需 GDS 注释用 **254/0 私有层**（官方 lyp/LVS/DRC 三不读，
> 组约定无语义，默认不用，冒烟不过即撤）。

## 三、两条被实测推翻的「常识」（不变）

| 常见做法 | 实测结果 | 正确做法 |
|---|---|---|
| 加大发射极退化电阻 Re 来「压住」寄生 | 45.8Ω→×2/×4/×8：增益 −3.04→−8.36/−9.13/−11.77 dB，Ic1 从 2.45 掉到 0.90 mA | **降低回流路径 R**；确需大 Re 必须同时改基极偏置为电流源/带隙 |
| via 电阻是版图寄生的大头 | 0.15Ω→0 只值 1.94 dB（在 amp2 尺度上） | amp2 尺度 via 不是重点；但**在 DRV2/PA 尺度上 via 恰是预算的大项**（R-VIA-01）—— 尺度决定结论，别外推 |

## 四、落地几何处方（DRV2/PA，v1.2 更新）

- **金属 43 mΩ**：TopMetal1（0.0625Ω/□ 估值）6µm 宽可走 **7.5µm**；M1/M2（0.125Ω/□）6µm 宽可走 **4.6µm**。双层并联后再翻倍。
  EM 并行校核（v1.2）：载流 14.64mA 需 M2/M3 ≥7.32µm/层（**单层独立承载全电流的保守口径，不依赖双层数流**；
  理想均流口径 3.66µm/层仅作参考、签核不认）→ **金属宽度最终由 EM 定 ≥8µm（M2+M3 双层）**，电阻宽度被覆盖。
- **via（组长已拍板 2026-10-16：0.2Ω 档 + 减层 stack → 187 件/边）**：按 R-VIA-01(v1.2) 分层表执行，
  随附三条执行条款（PEX ≤0.2Ω 方可签核 / 超标先加密 0.105Ω 档 107 件、仍超回 487 件 / 三档换算表保留），详见 R-VIA-01 节。
- **地轨 12 mΩ**：任意粗短地轨即可（限值 341 mΩ）。
- 走线不要「先横后拐」再拉回来：实测一条 14µm 的 M2 回折线就吃掉 1.75Ω。

> 全部数字来自 v014 定稿板实测 + SG13G2 PDK 官方文档，可复现：
> `python phys/gilbert/sim/opcheck_drv2.py`（工作点与预算表）、
> `python phys/gilbert/sim/emit_scan_drv2.py all`（回流电阻扫描）、
> `python phys/gilbert/sim/emit_route_plan.py`（几何处方表）；
> PDK 真值：`design/pdk_sg13g2_ref/`（回填纪要 `design/回填_SG13G2_via_EM_20261016.md`，blob sha 在案）。

## 五、与既有文件的关系

- 本文取代 `design_circuit/HBT级版图准则_发射极路径与地轨回流_v1.1.md`（v1.1 的 R-EMIT-01 表、R-GND-01、R-CHK-01、R-PEX-01、§一/§三原文继续有效，v1.2 修订处已标明）。
- `layout_plan.md` §11 的 v1.1 更新框相应升 v1.2：R-VIA-01 口径改「按层分别抽出/签核」、R-EMIT-02 改「M2+M3 双层 ≥8µm / M1 段 ≥15µm / Jmax@11y-105°C 真值」。
- 引用口径：`A0` 是**绝对电平 dBV**（激励 50mV），**电压增益 = A0 + 26.02 dB**；
  归零一律用 `1e-6Ω`（不写 0Ω）。

## 变更史

- v1.0（组长，2026-10-16）：初版。
- v1.1（组长，2026-10-16T11:56Z）：Re=1.5Ω/边勘误、gm 实测口径、R-EMIT-02/R-VIA-01/R-PEX-01 新增。
- **v1.2（b7e7 执笔 2026-10-16；组长 b7a0 审签通过 2026-10-16T14:5xZ，一处小修后定稿）**：via/EM 真值回填四处修订——
  ① R-VIA-01 改按层分别抽出/签核 + 分层真值表 + 三选一收口建议（默认 0.2Ω 档+减层 stack）；
  ② R-EMIT-02 换 Jmax 真值（11y@105°C）+ 双层改 M2+M3 ≥8µm + M1 段 ≥15µm + Black 外推缺省不做；
  ③ 因果方向勘误（gm 高估→Ze 低估→预算更紧）；④ 「1.0Ω→24 个」勘误（应 44 个，随原表作废）。
  审签附记：R-VIA-01 拍板方案 2（0.2Ω 档 + 减层 stack = 187 件/边）+ 三条执行条款（PEX ≤0.2Ω 签核 /
  超标先加密 107 件再回退 487 件 / 三档换算表保留）；R-EMIT-02 加注保守口径（7.32µm/层 = 单层独立承载全电流，不依赖双层数流）。
- v1.3（组长 b7a0，2026-10-17T05:5xZ）：叠加注记版（b7e7 原文未动）——R-VIA-01 拓扑口径（全栈单颗+
  柱下 keepout 必需）、R-EMIT-02 金属 Rsheet 真值收编（15Ω/□ 作废）、R-RES-01/R-ANNO-01 新增。
  依据：Q1 实测定案 + Q4 裁决 + cornerRES/techlef 真值（判读纪要_Q4注释层与Rsheet真值_2026-10-17.md）。
  审签附记：R-VIA-01 拍板方案 2（0.2Ω 档 + 减层 stack = 187 件/边）+ 三条执行条款（PEX ≤0.2Ω 签核 /
  超标先加密 107 件再回退 487 件 / 三档换算表保留）；R-EMIT-02 加注保守口径（7.32µm/层 = 单层独立承载全电流，不依赖双层数流）。
- v1.4（2026-10-17，E 回流链断路案）：R-VIA-01 族新增 PCell 外接尺寸禁令（凡按 PCell 外接尺寸推内部形状位置一律禁止，必须用实际块坐标）；焊盘顶=孔阵顶+0.005/边 实测回填。
- **v1.5（b7e7 执笔 2026-10-18，送审；裁定四十/四十二收编）附则三件套**：
  ① **R-NX-01 新增**——HBT 版图档位 we=70n/le=900n（官方 PCell 默认档）入册、gen/网表/文档三面对齐；档位电学惰性声明（裁定四十二：we/le 为模型哑参数，XQ 显式写档属版图忠实性要求、非电学变量；基线 v2 ≡ 17.4465 正锚）；
  ② **R-PLACE-01 新增**——邻管摆位按带金属实测半宽验距（禁 PCell bbox 锚距）＋ hbtgeom 真值表（**2026-10-18 全档实测补全；v1.7 更正：B=0.925×NX+0.05、C=0.925×NX，五档残差 0**，实体 design/sow6/hbtgeom.py 3044477b）＋ _qr_l_assert 类断言必检；
  ③ **preflight 三盲区备案**——e-pad 审计/⑱自画矩形同层间距/真值表 bbox 粗筛三处抓不到邻件带金属投影互压；**该项已于同日落地为 preflight 第 ㉒ 项**（见上「✅ 收档后续」）。
- **v1.6（b7e7 执笔 2026-10-18，承组长 b7a0 2026-10-18T13:09Z 信令补录，见 〇·7）**：版本分叉事故修复——
  ① R-RES-01（器件 poly 电阻 cornerRES 三档真值）、R-ANNO-01（注释层纪律，Q4 裁决）两节以 v1.3 注记版为真值源**原文收回**；
  ② 追加收回 v1.3 注记版两处注记块（R-EMIT-02 回流金属 Rsheet 真值收编、R-VIA-01 via_stack 拓扑口径 Q1 实测定案；报组长追认）；
  ③ 变更史补 v1.3 条目；④ R-PLACE-01 加内缘净空术语脚注（1.72=带端净距 / 1.09=减 M1 净距后富余）；
  ⑤ R-RES-01 加 cmim 23.610 实落注（Offgrid 5nm，组长批准；23.66 为 M2 回执口径留档）。
  背景：v1.4 从 v1.2 底稿出发未收编 v1.3 注记版新增（协作版本管理事故备案，非内容问题）。
  ⛔ **2026-10-19 追注**：v1.6（dcd7c368）含**已被推翻的错律**「B 带 0.975×NX」（L55/L76/L308 三处）
  ⇒ 已加「⛔ 历史件 · 非现行口径」横幅，**不得作为设计依据**（组长裁定四十六补充 §二.1：
  「错的律被复制进准则两处……否则『代码改了、准则还教着错律』，下一个读准则的人会被带沟里」）。
- **v1.7（b7e7 执笔 2026-10-18 23:19Z 后；裁定四十六更正版，sha `414c3e73`，组长已登记）**：三处实质更正——
  ① B 带律 0.975×NX → **0.925×NX+0.05**（真 GDS 独立复算推翻；错因＝把 NX=1 的比值当成每档斜率）；
  ② 间距 0.63 **标源**＝自设保守项，PDK 适用值 M1.b 0.18（两者分两处写，不许混写）；
  ③ 新增第 ㉓ 项（带金属 × 顶层自画 M1，**当时为只读告警**）。
  另：〇·N.2 计数口径写死唯一入口（N1 器件对 / N2 带↔带条对）、〇·N.3 同名串味根治（平铺件加 `b7e7` 前缀 +
  按路径加载）、〇·N.4 数值真值入口唯一（`hbtgeom.py` 3044477b）+ gen 侧同源化。
- **v1.8（b7e7 执笔 2026-10-19；裁定六十/六十补充追记版，sha `398f5138`）——现行版**：
  v1.7 全文逐字保留（**超集**，无删改、无回退风险），增量全在 〇·O 段：
  ① **律 F15 条款正文落地**（交付件真跑背书；组长裁定五十一立律、裁定六十补充 §一 两次交办）+ 三例实证表
    （drv1 v22 `AttributeError` 停线 / mix 网表 `$` 行尾注记炸官方 reader / mix v1d 衬底混用 FAIL）
    + 五条「写代码时的具体动作」（`.disp` / `DBox` 无 `x1y1x2y2` / `select_all_cells()` 且不能 `list()` /
    禁 `$` 行尾 / 自检台的绿只说明模型自洽）；
  ② **DRC 门限真值回填**：M2.b/M4.b = **0.21**（官方原文 5.17，M2–M5 同族）——我 `drcgeom` 表里原写 0.27
    是**凭同族类推编的**，官方原文 2026-10-17 就在我手上；新律「`src="assumed"` 的行是**债**，官方原文一到手当场回填」；
  ③ **DRC 计数按并集域、不按 polygon**（裁定四十六 §六.2 去重律的**升级**：本例 3 段 bbox 不完全相同，
    量化去重抓不到，必须 `unary_union`）——M4.b 我数 3/6、官方 1/2 的根因（立管 3 段重叠 + pad 与立管同域 ⇒ notch）；
    并立边界律「探针的职责是**归因**，不是计数；计数一律采官方 lyrdb」（buffer 近似法假报 160 条为证）；
  ④ **㉓ 已升硬闸**（前置对表完成：官方 8 条 M1.b 实测 8/8 落 PCell 实例内、顶层自画 M1 域间 space=0
    ⇒ 不假报；三件现役件回归硬档各 0 ⇒ 全 PASS 不停线）+ **㉒ 增强**（双档阈值 0.18/0.63 并列输出、
    归因二分标签；**判 FAIL 仍只用软档，判据零变化**）；
  ⑤ **LVS 源网表三条形态律**：衬底写法一致性（D2；真缺陷是**混用**不是「写了 gnd」）/
    官方 `cap_cmim` 是 **2T 无 sub**（D1-C 双形态 + 端子序 (n_hi,n_lo) + 全板口径 A=w×l、P=2(w+l)）/
    `.subckt` 端口集合逐字逐序对齐官方提取（**29** 个；裁定五十八纪要 §5.2 的「27」是笔误，以 §2.1 逐字行为准）；
  ⑥ 本口三条自曝坑（凭记忆引用数字 / `assumed` 拖成「我以为的 PDK」 / 收编了律却不在同类场景用它）
    + 新增律「引用任何数字都要有出处」「收编律时当场列出它适用的所有场景」；
  ⑦ 新增实测件 6 个（`probe_m4b_b7e7.py` / `probe_m1b_b7e7.py` / `drcgeom_b7e7.py` /
    `bandproj_b7e7.py` / `preflight_b7e7.py` / `skills/lvs_source_audit.py`），全部可复现。

## 〇·N 裁定四十六追记（v1.7，2026-10-18 23:19Z·组长 b7a0 信）

### 〇·N.1 第 ㉓ 项「带金属 × 顶层自画 M1」——已落地（**只读告警**）

- **补的是什么**：㉒ 判带↔带；带与**我画的** M1 之间一直没有判据。同网归属靠连通域
  （⑤ 的 M1 簇 + 网名标注）：两边网名有交集 ⇒ 同网（带上的引出块本就该相接）；
  两边都有名且不相交 ⇒ 异网，判间距；任一侧无名 ⇒ **不可判**，只列候选、不下结论。
- **作用域只限「顶层自画 M1」**（`my_rects()` 只收 top cell 直接插入的 drawing 矩形）⇒
  **不会**报出「器件内部带金属↔带金属相压 6 处」——那 6 处全在 npn13G2 实例包围盒内，
  属 PDK 基线 225（组长真 GDS 归属取证），不归摆位账、**不判**。该项在 ㉓ 输出里原样打一行备案。
- **两档间距，出处分两处写（裁定四十六 §三 · 组长明令不许混写）**：
  - **硬档 = PDK 适用值**：M1.b **0.18**（Min. Metal1 space，无同网限定）；
    参与相向形状线宽 >0.15 且平行段 >1.0 时触发 **M1.e 0.22**。
    带金属 y 高实测 C 0.44 / B 0.24 ⇒ 带自身恒触发不了 M1.e ⇒ 带↔带适用规则**只有 0.18**
    （与官方 DRC 实证一致：mix v31 官方 M1.e=0 / M1.f=0 / M1.b=8 条）。
  - **软档 = 0.63 自设保守项**（我的摆位裕度，PDK 全库 grep 零命中）⇒ 低于它只能写
    「低于自设保守项」，**不得**写成 DRC 不合规。
  - 一句话：**0.63 是我给自己留的富余，不是别人定的规矩。**
- **现状＝只读告警**：硬档也**不计入 FAIL**（裁定四十六 §四：先与官方 DRC 的 M1.b 逐条对表，
  再决定升不升级硬闸）。升级只需把 `band_wire_audit(..., read_only=False)`。
- **首轮结果（现役三件）**：硬档 **0** 条；软档 **2** 条（均在 mix v31，且**官方适用值通过**）：
  - `XQ3.B(lopd) ↔ 自画 rfop 竖轨`，净距 **+0.475µm**（≥0.18 ✓，<0.63 ⇒ 软档）
  - `XQ4.B(lond) ↔ 自画 rfon 竖轨`，净距 **+0.475µm**（同上）
  - 口径来源：mix v31 的 rfop/rfon 竖轨通道 ∓16.2（gen 脚本注释「距带沿净距 0.475µm ≥ M1.b 0.18 ✓」）。
  - ⇒ **现役三件按官方规则零违规**；若日后要求连自设 0.63 也守住，把竖轨 ∓16.2 → ∓16.4 即可
    （净距 0.475→0.675），但那是我自己的裕度诉求，**不是** DRC 要求。
- **有牙验证（v1.7 新增）**：造缺陷件 `gen_M2_mix_defect23.py`（把 rfop/rfon 竖轨
  ∓16.2 → ∓15.6，使竖轨**落进** XQ3/XQ4 的 B 带投影）⇒ ㉓ 报 **2 条硬档**
  （`lopd↔rfop` / `lond↔rfon` 净距 **−0.125µm** < 0.18，疑似 DRC 违规），
  而**其余 22 项全绿**（e-pad 审计零、net_check 零短路、⑱ 同层间距 FAIL=0、⑬ 零异网横穿……）
  ⇒ ㉓ 抓的正是那一类「二十项全绿也照样出事」的错。
- **不可判候选的成因（如实登记）**：候选多来自**顶层网名标注少**的器件
  （drv2 的 180 对不可判 / drv1 4 对 / mix 5 对）——网名取不到就不下结论，
  宁可漏报不可误报。想提高可判率需在顶层补网名标注（不是本项能自己解决的）。

### 〇·N.2 计数口径（裁定四十六 §五.1「口径不许各写一份」→ 写死在唯一入口）

- **N1 同行器件对**＝同 y（npn bbox 的 y 投影相交）且双方都有 C 引脚的**器件对数**，每对记 1，
  判据取该对最保守组合（两管都按 B 带半宽 + 0.63）。
- **N2 带↔带条对**＝全部带条（C/B 各一条）里 **y 投影相交**的对数。
  ⚠ 口径差异的根源：**C 带与 B 带 y 相差 2.38µm ⇒ C-B 组合永不相交** ⇒ 同 y 器件对只贡献
  **CC + BB 两对**（不是四对）。我此前报的 25/2/30 是 **N1**。
- 本机（引脚锚定的**理想带矩形**重建）N1/N2 = mix **25/50**、drv1 **2/4**、drv2 **30/60**；
  组长侧（**真 GDS 多边形**）为 43/3/38。二者**不是同一个量纲上的差**：
  本机量的是重建矩形、组长量的是真 GDS 多边形（真 GDS 带条 y 与理想锚点有微差、
  且同一条带可能存多份）。**结论（最紧对三件逐位吻合：+1.09 / +16.17 / +2.94）不受影响。**
  → 要彻底对齐，需要一份真 GDS 的带条清单（器件/端子/x 区间/y 区间），
  我按同一口径逐条复算（**给组长的一件具体请求**，见回执）。

### 〇·N.3 工具面：同名串味的根治（裁定四十六 §三.2 · 组长点名）

- **根因**：我投的平铺件 `design/sow6/preflight.py` 是**通用名**；组长 `phys/top/` 下也有同名文件，
  代跑时改 `sys.path` ⇒ 谁 `import preflight` 谁中招（正是我 2026-10-18 自己踩过的形态）。
- **处置**：平铺交付件一律加 `b7e7` 前缀（组长「任选，不强」——我做了）：
  `preflight_b7e7.py` / `bandproj_b7e7.py` / `band_measure_b7e7.py` / `pya_b7e7.py` /
  `klayout_db_stub_b7e7.py` / `drcgeom_b7e7.py` / `hbtgeom_dist_b7e7.py`；
  开发位 `dryrun/hbtgeom.py` 同时改名 `dryrun/hbtgeom_dist.py`（与 `sow6/hbtgeom.py` 彻底分家）。
  所有加载改**按路径 + 候选表 + 必备属性**（`preflight._first()`），不再靠 `sys.path`。
- **顺带修好一个「交付了却跑不起来」的坑**：上轮投的平铺 `preflight.py` 缺 pya/klayout_db_stub/drcgeom/spcheck/netaudit，
  在组长侧**根本跑不起来**（空壳交付）。现平铺副本自带全部运行期依赖，并已做**独立目录实跑验证**：
  `cd /tmp/flat_test && python3 preflight_b7e7.py gen_M2_mix_v31.py` → PASS，㉓ 结果与开发位逐位一致。

### 〇·N.4 数值真值入口（唯一）与 gen 侧同源化

- 唯一入口仍是 `design/sow6/hbtgeom.py`（3044477b）：带半宽表 + `band_half()` + 三个间距常量
  （`M1_PLACING_SPACING_UM=0.63` 自设 / `M1_SPACING_UM=0.18` PDK M1.b / `M1_SPACING_UM_LONG=0.22` PDK M1.e）
  + `applicable_m1_spacing()`（按触发条件取适用值）。
- **gen 侧不再另抄一份数**：mix v31 的 `_qr_l_assert()` 原硬编码 `9.30 / 0.98 / 0.63`，
  现改为**按路径**加载 `sow6/hbtgeom.py` 取真值（取不到才回落常量且**明确告警**；断言写在 try 之外，
  绝不让 except 顺手把真断言吞掉）。

---

## 〇·O 裁定六十/六十补充追记（v1.8，2026-10-19·组长 b7a0 信 16:44Z / 17:06Z + 本口实测自曝）

> 本段是 v1.8 相对 v1.7 的**全部增量**。v1.7 正文逐字保留（超集，无删改）。
> 五条律 + 三条自曝坑，全部有实测件可复现（探针 sha 见各条）。

### 〇·O.1 ★律 F15（条款正文落地）　交付件真跑背书

组长两次交办（裁定五十一立律草案、裁定六十补充 §一「教训要留……条款要写的是
『交付件须在我侧真 KLayout 跑通才计已验证』，不是『v22 作废』这一件事」）。条款正文：

> **F15　交付件真跑背书**
> 1. **判据**：一件交付件（gen 脚本、内嵌 helper、网表、deck）计为「**已验证**」的
>    唯一条件是——**在组长侧真 KLayout / 官方 reader / 官方 deck 跑通**。
> 2. **作者自检台 `ok=true` 不构成背书**。自检台跑的是**仿真层 shim**
>    （`dryrun/klayout_db_stub.py` + `pya_b7e7.py`），它没有真构建的 API 现实。
> 3. **三例实证**（都是「我侧全绿、组长侧当场炸」）：
>    | 件 | 我侧自检 | 组长侧真跑 | 根因 |
>    |---|---|---|---|
>    | `gen_M3_drv1_v22.py` | `check_layout_gen` ok=true | **`AttributeError: 'Trans' object has no attribute 'dx'`（L626）停线** | 本构建 `pya.Trans` **只有 `.disp`**；`_xy()` 双分支（`hasattr(_t,"x") else _t.dx`）**两分支皆炸** |
>    | mix LVS 输入网表 v1/v2 | `lvs_source_audit` 全绿 | **`ERROR: 'Q' element must have three or four nodes … line 36`** | 每条器件行带 `$ cdl QN` 行尾注记，而 **KLayout `Netlist::read` 不把 `$` 当行注释**（SPICE 行注释是 `*`/`;`/`//`）⇒ 被当额外节点 |
>    | mix v1d 网表 | 自检 ok | **FAIL 13 Mismatch** | 衬底写 `0`、E 极写 `gnd`（同表混用两个地名）⇒ reader 分成两网（见 〇·O.5） |
> 4. **推论（写代码时的具体动作）**：
>    · 取 `Trans` 位移一律用 **`.disp`**（`Vector` 才有 `.x`/`.y`）；
>    · `pya.DBox` 只有 `left/bottom/right/top`，**无 `x1/y1/x2/y2`、无 `.hit()`**；
>    · `begin_shapes_rec` 须配 **`select_all_cells()`**、且**不能 `list()`**（用 `.each()` + 手动 `next()`）；
>      `dbbox()` 给 µm、`trans.disp` 给 dbu，**两者分别处理**；
>    · 网表行尾注记一律用 `*` 独立注释行，**禁用 `$`**；
>    · 自检台的「绿」只说明**我的模型自洽**，不说明**真件能跑**——报告里必须分开写。
> 5. **v22 处置**（裁定六十补充 §一）：已**正式作废**，从候件降为历史件，不再列入交办。
>    理由：律 F15 首例 + v23 已获裁定五十四真跑背书 ⇒ 无存续价值。

### 〇·O.2 ★DRC 门限真值回填（M2.b / M4.b = **0.21**，不是 0.27）

**官方 DRC 规则原文**（`inbox_replies/DRC逐条坐标明细_v25轮_2026-10-17.md`，
**2026-10-17 就在我手上**）：

| 规则号 | 原文 | 值 |
|---|---|---|
| 5.15 | CntB.h1 Min. Metal1 enclosure of ContBar | 0.05 µm |
| 5.16 | **M1.b**: Min. Metal1 (drawing + filler) space or notch | **0.18 µm** |
| 5.17 | **M2.b**: Min. Metal2 (drawing + filler) space or notch | **0.21 µm** |
| 5.17 | **M4.b**: Min. Metal4 (drawing + filler) space or notch | **0.21 µm** |
| 5.19 | V1.a Min. and max. Via1 width / V1.b Min. Via1 space | 0.19 / 0.22 µm |
| 5.22 | TM1.a Min. TopMetal1 width | 1.64 µm |
| 5.25 | TM2.a Min. TopMetal2 width | 2.0 µm |

⇒ **M2.b 与 M4.b 共用规则号 5.17、同值 0.21**（Metal2–5 同族）。

**我的错**：`drcgeom_b7e7.py` 的 `RULES` 表里 M2/M3/M4/M5 的 `spc` 全写 **0.27**、
`src="assumed"`、note 自称「M4.b×1 出现在纪要但**数值未给**，按 M2 同族 0.27 待回填」
——**数值一直在手上**，0.27 是我凭「同族类推」**编的**，官方原文里从来没有这个值。
已更正（`drcgeom_b7e7.py` + 同源副本 `dryrun/drcgeom.py` 同步，律「口径不许各写一份」）。

> **律（新增）**：真值表里 `src="assumed"` 的行是**债**，不是「待回填的备注」。
> 官方原文一到手就**当场回填**；拖两天就成了「我以为的 PDK」，而且会被下游
> （preflight ⑯/⑱/⑲/⑳、drcgeom 各判据）当权威引用。
> **推论**：`src` 字段只有两个合法值——`纪要`（有官方原文出处）/ `assumed`（我编的）。
> 输出里必须把 `assumed` 的行**显式标出来**（preflight 已这么做：「另报不判（assumed 规则值）」）。

**影响面**：0.27→0.21 是**放宽**方向 ⇒ 原 PASS 的仍 PASS，不产生新假 FAIL。
mix v31/v34 的 M4.b 实测净距 **0.150** < 0.21 ⇒ **两个门限下都判违规，结论不变**
（`probe_m4b_b7e7.py` 实测）。M3/M5 官方明细未单列，按 5.17 同族取 0.21，仍标 `assumed`。

### 〇·O.3 ★DRC 计数按**并集域**，不按 polygon（裁定四十六 §六.2 去重律的升级）

**M4.b 计数之争的实测结论**（`probe_m4b_b7e7.py`，真 GDS，v31/v34 两份）：

| 口径 | v31 | v34 | 与官方 |
|---|---|---|---|
| **官方 lyrdb**（唯一判据面） | **1** | **2** | — |
| 本探针「官方缝点名归因」（三条判据同时成立） | **1** | **2** | **逐位吻合** ✓ |
| 我原来的 polygon-pair 口径 | 3 | 6 | 差 +2 / +4 ✗ |
| buffer 近似法（域内任何 <0.21 窄缝） | 160 | 160 | 差 +159 ✗（假报） |

**根因（两层）**：
1. **违规侧那条 gnd 立管在 GDS 里是 3 个重叠矩形**：x∈[49.850,50.150]，
   y 下界同为 18.000、上界各为 **83.860 / 84.990 / 86.240** ——gen 里三次
   `wire_v(GND_LAYER, …)` 画出的**同一条立管的 3 段**，**并集 = 一个矩形**。
   我按 polygon 逐对配 ⇒ 3 段各与 pad 配一次 ⇒ 数出 3（v34 镜像 ⇒ 6）。
2. **pad 与立管同属一个 M4 并集域**（实测该域 bounds=(−79.2,16.0,54.0,118.295)、
   面积 **617.2535 µm²**，两者中心都落在域内——经 y=18.0 的 M4 地轨连通，同为 gnd 网）
   ⇒ 这条违规**不是 two-polygon space，而是同域内的 notch（窄缝）**：
   缝 = x∈[49.700,49.850] × y∈[29.685,30.295]，宽 **0.150** < 0.21。
   **一个缝 = 一条 notch**，与立管由几段矩形叠成无关。

> **律（升级裁定四十六 §六.2）**：DRC 计数一律按**并集域**（`unary_union`），不按 polygon。
> 原律是「按量化 bbox 去重」——**本例它抓不到**：3 段 bbox **不完全相同**（y 上界各异），
> 量化去重后仍是 3 个；必须做**几何并集**才合并成 1 个。
> **推论**：GDS 里「一条金属」可能由多段重叠矩形画成（gen 的 `wire_v`/`wire_h` 逐段画），
> 任何按 polygon 计数的判据都会**放大计数**。

> **律（边界，律 F12/F8 同构）**：**官方 lyrdb 是唯一判据面**，我的探针**不宣称复现官方计数**。
> 实测证据：buffer 近似法在 M4 上抓出 **160** 条域内窄缝（绝大多数是 via_stack 阵列内
> 0.105 µm 的缝），官方只报 **1** 条 ⇒ 官方 notch 判据比「域内任何 <thr 窄缝」严得多
> （还须满足开口/长度/是否 PCell 内部等条件，规则原文未给全）。
> ⇒ 探针的职责是**归因**（这条违规是什么结构、属谁的账），**不是计数**。
> 计数一律采官方 lyrdb。

### 〇·O.4 ㉓ **已升硬闸**（前置对表完成）+ ㉒ 双档阈值与归因二分

**㉓ 升闸**（裁定六十补充 §六.5 组长同意：「`read_only=False` 一行可升，但须与官方
M1.b 逐条对表同批落地……**别先升闸再对表**（升了闸假报会停线）」）：

对表已独立完成（`probe_m1b_b7e7.py`，真 GDS 实测 v31/v34 两份，**不采信转述**）：

| 实测项 | v31 | v34 |
|---|---|---|
| M1(L8/D0) 原始多边形（顶层自画 / 实例内） | 282（88 / 194） | 282（88 / 194） |
| M1 并集域 | 112 | 112 |
| 官方 8 条 M1.b 坐标逐条点名 ⇒ 实测违规 | **8/8** | **8/8** |
| 其中缝中心落在 **PCell 实例包围盒内** | **8/8** | **8/8** |
| （归属明细） | 4×`npn13G2` / 2×`npn13G2$3` / 2×`rsil`+`cmim` | 同 |
| **顶层自画 M1** 并集域间 space 候选（<0.18） | **0** | **0** |
| 8 条里缝两侧探点落**顶层自画 M1** 域内 | **0** | **0** |

⇒ 与裁定四十六 §四「这 8 条全归 PCell 内部账、㉓ 抓不到、别拿它判现役件 FAIL」
**独立复现一致** ⇒ 升闸**不会**因这 8 条假报。
**升闸后三件现役件回归实测**：mix v34 / drv1 v23 / drv2 v22 硬档各 **0** 条 ⇒ **全 PASS，不停线**。

> **升闸语义（写死，别含糊）**：
> · **hard**（低于 PDK **适用**值 M1.b 0.18 / 触发 M1.e 时 0.22）⇒ **计入 FAIL**；
> · **soft**（低于自设保守项 **0.63**）⇒ 仍**只记信息、不判 FAIL**
>   —— 0.63 是我的摆位裕度、PDK 无此值，拿它停线就是**把自设项当合规判据**（裁定四十六 §三 律）；
> · **unk**（一侧无名）⇒ 只列候选，不下结论。
> · 库函数 `band_wire_audit()` 缺省仍 `read_only=True`（保守缺省，别处调用不误停线），
>   **preflight 调用点显式传 `read_only=False`**。

**㉒ 增强**（裁定六十补充 §二 口径三条，组长裁定「加，编号 ㉔」——**信息滞后**：
㉒ 已于 2026-10-18 落地，㉓ 同日落地；本口按组长口径**增强 ㉒**，不新开 ㉔ 编号，
免得同一条判据在清单里出现两次）：
1. **半宽取真值表**（`hbtgeom.BAND_HALF_UM` / `band_half`）——㉒ 原本就是这么做的 ✓
   （B = 0.925×NX + 0.05、C = 0.925×NX，五档 0.98/2.83/5.60/7.45/9.30，残差 0）；
2. **双档阈值并列输出**：硬档 PDK M1.b **0.18**（DRC 合规判据；带↔带平行段 ≤0.44 µm
   ⇒ M1.e 0.22 / M1.f 0.60 **均不触发**，适用规则只有 M1.b）+ 软档自设 **0.63**（摆位裕度）。
   **判 FAIL 仍只用软档**（判据零变化，现役三件结论不动）；硬档是**信息行**，
   让「DRC 会不会真报」与「摆位裕度够不够」分开看；
3. **归因二分标签**：命中项输出「PCell 内部 / 摆位造成」。
   **㉒ 的构造决定了它枚举的是两只不同 npn13G2 实例 ⇒ 命中一律「摆位造成」**，
   不可能出现「PCell 内部」；「PCell 内部」那一类（官方 8 条 M1.b）**不在 ㉒ 作用域内**
   （已由 `probe_m1b_b7e7.py` 独立坐实，见上表）。

> **㉒/㉓ 的边界（写进头注，别含糊）**——组长裁定六十补充 §二 边界条款，我照收：
> · ㉒/㉓ 都是**投影**判据（理想带矩形），**量不到 Activ 足迹** —— 与 ⑮ 同一盲区。
>   Activ 层短路仍须靠 `_activ_gap_assert`（`actgeom.py` 真值）兜底，㉒/㉓ **不替代**它。
> · ㉒/㉓ **不是官方 DRC 的替代**：官方 DRC 仍是唯一判据面，㉒/㉓ 只是**提前归因**。
>   两者冲突时**以官方 lyrdb 为准**（律 F12/F8 同构：「看着压住了」≠「真压住」）。

### 〇·O.5 ★LVS 源网表三条形态律（mix v1d→v1f 实证）

**律一：衬底端子写法必须与 E 极统一（D2 一致性律）**

> 真缺陷**不是「写了 gnd」**，而是**同一份网表里混用两个地名**。
> reader 把 E 极的 `gnd` 与版图 `gnd` 配对、把衬底的 `0` 与版图 `gnd` 配对
> ⇒ 衬底那侧的器件端子**成对落单**。

| 件 | E 极 | 衬底 | 官方 LVS |
|---|---|---|---|
| drv1 v5 | `0` | `0` | **PASS 13/13** |
| drv2 v6 | `0` | `0` | **PASS 19（15M+4MW）** |
| mix v1b/v1c/v1d | `gnd` | **`0`** | **FAIL**（v1d：13 Mismatch 里 7 网由此来） |
| **mix v1f** | `gnd` | **`gnd`** | 待官方跑（v34 × v1f） |

⇒ **律**：衬底端子必须与 E 极写法统一（都写 `0` 或都写 `gnd`），且与本表**版图标注**一致。
**混用 = 分裂成两网**。`lvs_source_audit` 的 D2 判据器已按此升级
（旧判据「衬底写字面 gnd 一律 FAIL」是 drv1/drv2 时代口径，对 mix v1f **误报 15 条**）：
新判据三步——a) 统计全表地 token 定「本表地约定」；b) 约定唯一 ⇒ 衬底须等于该约定；
c) 约定**混用** ⇒ 文件级 FAIL `[D2-分裂]` + 逐器件查 E 极 vs 衬底 token ⇒ `[D2-混用]`。
**回归实测**：v1f 误报 21→**2**（只剩已知 D3 例外）；v1d 精确抓出 `D2-分裂` + **7 条混用**；
drv1 v5 / drv2 v6 仍 **ok=true 零回退**。

**律二：官方 `cap_cmim` 是 **2 端子无 sub**（D1-C 双形态）**

依据：官方提取器 `custom_mim_extractor.lvs` 的 `DeviceCustomMIM` 类只定义 **2 个端子**
（`mim_top` / `mim_btm`，**无 sub**）+ 参数 **w/l/A/P/m**；
`capacitors_mod.lib` L64 `.subckt cap_cmim PLUS MINUS` 证实 2 端子无 sub。

| 形态 | 写法 | 用在哪 |
|---|---|---|
| ① **官方提取形态（2T）** | `C名 n_hi n_lo cap_cmim w=… l=… A=… P=… m=1` | **lvs_reader 侧正解** |
| ② cdl/代入器形态（3T） | `C名 板1 板2 sub cmim area=… perim=…` | ngspice_substitute 契约 |

· **端子序**：官方提取实证 C$33 `na1p ifp` ⇒ **(n_hi, n_lo)** = (TOPM1 上板, M5 下板)。
  gen 里 `mkcmim(name, n_lo, n_hi, px, py)` ⇒ 网表按 **(n_hi, n_lo)** 序写。
· **参数口径**：A = w×l、P = 2(w+l)，**全板**口径（例 23.61² = **557.4321** / 4×23.61 = **94.44**），
  **不是净区**（514.382 = 22.68²，裁定三十的提取器交叠口径）⇒ 口径错会让 reader 无法配对。
· **判法**：按 (模型名, 模型位) 配对 —— `cap_cmim`@idx3 = 2T 合法；`cmim`@idx4 = 3T 合法；
  其余组合 → FAIL。`pair` 模式只比**前 2 网**（3T 的第三位是衬底死字段），
  并把「端子序反转」显式判出来。

> **律**：写电容网表前**先查官方提取器源码**（`custom_mim_extractor.lvs`），**别从文件名猜**。
> 我 v1d 写 3T + `cmim` + `area/perim`（净区口径），官方是 2T + `cap_cmim` + `w/l/A/P/m`（全板口径）
> ——四处全错，6 只电容全部 reader 无法配对。

**律三：`.subckt` 端口集合必须与官方提取**逐字逐序**对齐**

· v1d 只声明 **8** 个端口，官方提取 **29** 个（裁定五十八纪要 §2.1 逐字行）。
  差异**纯是 `.subckt` 声明行少写 21 个**——v1d 器件行网名（去 `0`）与官方 29 端口
  **逐字相同**（差集 = ∅）。v1f 按官方 29 端口逐字逐序写（**实测自证**：
  `v1f_ports == off_ports` → True，差集双向 ∅）。
· ⚠ **裁定五十八纪要 §5.2 写的「27 个」是笔误**——同件 §2.1 的逐字提取行是
  8 + 15 + 6 = **29** 个。以 §2.1 逐字行为准（那是官方提取原文，§5.2 是转述计数）。
· **D3 已知披露例外**：官方 reader **做大小写归一**（裁定五十五 组长官方真跑实证：
  layout=`XBI2/nref` ↔ sch=`XBI2/NREF` 判 Match），且层次形端口名在与版图标注
  **逐字对齐**时判 Match ⇒ D3 对「端口名照抄版图标注」这一形态是**误报**。
  判据器保留 D3 输出，但调用方须知道 mix v1f 的 2 条 D3 属此例外。

### 〇·O.6 本口三条自曝坑（写给下一个读的人）

1. **凭记忆引用数字**（与组长本口自曝同型——他写「v31 基线 6 条 M1.b」，实测 8 条）：
   我在裁定五十五回信 §六.8 写「官方 DRC mix v31 那 **2 条** M1.b」，实测真值是 **8 条**
   （v31/v34 各 8，坐标逐条相同、左右对称成对）——**而且我自己的 v1.7 准则 L340 早就写着
   「mix v31 官方 M1.e=0 / M1.f=0 / M1.b=8 条」**。⇒ 错因不是没数据，是**没去查自己的文件**。
   > **律**：引用数字前必须实测或查文件（组长裁定五十九「改法建议必先实测」的同款，
   > 我把它扩到**引用**上：不只是「改法建议」，**任何数字**都要有出处）。
2. **真值表里 `assumed` 的行拖成「我以为的 PDK」**（见 〇·O.2）：M4.b 的 0.27 编了两天，
   官方原文 0.21 一直在我手上的 DRC 明细里。
3. **收编了律却不在同类场景用它**（见 〇·O.3）：裁定四十六 §六.2「统计前按量化 bbox 去重」
   我收编了、还写进了 `bandproj` 的注释，**却没在 DRC 计数上用它** ⇒ M4.b 数出 3/6。
   > **律**：收编一条律时，必须**当场列出它适用的所有场景**（不只它被提出时的那个场景），
   > 否则律只在那一个案子上生效，换个场景照错。

### 〇·O.7 本口新增/升级的实测件（都可复现）

| 件 | 用途 | 关键实测结论 |
|---|---|---|
| `probe_m4b_b7e7.py` | M4.b 违规归因（notch 口径） | v31=1 / v34=2，**与官方逐位吻合**；pad 与立管同属一个 M4 并集域（617.2535 µm²）⇒ notch 非 space |
| `probe_m1b_b7e7.py` | M1.b 8 条独立实测 + 归因二分 | 8/8 落 PCell 实例内；顶层自画 M1 域间 space(<0.18)=**0** ⇒ ㉓ 升闸不假报 |
| `drcgeom_b7e7.py`（+`dryrun/drcgeom.py`） | DRC 门限真值表 | M2/M4 `spc` 0.27→**0.21**（官方 5.17）；M1 `src` assumed→**纪要** |
| `bandproj_b7e7.py` | ㉒/㉓ 内核 | ㉒ 加双档阈值 + 归因二分标签；㉓ 升硬闸说明 |
| `preflight_b7e7.py` | 自检台 | ㉓ `read_only=False`（升硬闸）；头注/注释同步 |
| `skills/lvs_source_audit.py` | LVS 源网表判据器 | D2 改一致性判据；D1-C 支持 2T `cap_cmim`；`pair` 加地网归一（`ground_equiv`）+ 电容端子序反转判定 |
