oppry12102/WIFI7-TX/06_layout_design_notes/LVS源网表形态体检_D1-D4判据器与五件报告_2026-10-18.md

# LVS 源网表形态体检 · D1-D4 判据器与五件报告

* 日期：2026-10-18（UTC，b7e7）
* 依据：b7a0《判读纪要_LVS首达PASS_源网表四缺陷与串并联开关_2026-10-18.md》（sha16 8ecf7255d258a14f，已取回逐字自证）§三 D1-D4 + 裁定二十第 4/5 条交办
* 结论一句话：**drv2 sch v5 + drv1 sch v2 两份正式整改件交齐（形态全绿 + 拓扑等价自证）；cdl×3 体检全数发现「位置字段不足 + sub= 命名参数补位」同族违规（与 v4 的阻值占位不同构）——整改须换 cdl sha 判活锚，请组长裁定后我出 v2 三件。**

---

## 一、交付件（2 件，正式件）

### 1. drv2_subckt_LVS输入_v5.sp（v4 486f6558 → v5，拓扑零改动）

| 判据 | 改动 | 处数 |
|---|---|---|
| D1 | 电阻行删阻值 token、model 前插衬底网：`R名 n1 n2 <阻值> <model>` → `R名 n1 n2 0 <model>`（官方 3T 样例形） | 12/12 行 |
| D2 | 新插衬底一律全局 `0`（禁字面 gnd） | 12 处 |
| D3 | `XBI<k>/nref` → `NREF<k>`（k=1..4，16 处引用） | 4 网 |
| D4 | `m=<Nx>` → `Nx=<N> m=1`（主四管 10 / 镜像输出 8 / 镜像二极管 1） | 12/12 行 |

自证三重：① `lvs_source_audit.py` 形态体检 **全绿**（issues/warnings/H1 全空）；② `pair(v4,v5)` 拓扑等价断言 **PASS**（器件名集合、逐端子网 [经 NREF 改名映射]、Q 规模语义 m↔Nx 逐件核对）；③ `check_netlist_dc` 直流静态自检 ok。阻值 token 删除无害性：阻值本由 l/w×sheet 决定，行内数字不经 reader 语义（v4 的「1000」正是被误读成网名的死字段）。

### 2. drv1_subckt_LVS输入_v2.sp（v1 组长代造首件 → v2，同构整改，拓扑零改动）

D1×9 行（RRin/RRe/RRb/RRL/RXBI_Rref）、D2×9、D3 `XBI/nref`→`NREF1`（4 处）、D4×3 行（Nx=6 / Nx=8 / Nx=1，各 m=1）。自证同三重：体检全绿 + pair(v1,v2) 等价 PASS + check_netlist_dc ok。
（drv1 尚未立标准输入对；此件为提前备料，是否启用由组长定。）

## 二、判据器沉淀（skills/lvs_source_audit.py，可复用）

`run(audit=[...], pair=[旧,新], rename={...})`，判据全部锚定 PDK 台账：

* **D1-R**：R 行按 model 位倒推须 n1/n2/sub 三网齐位（model 位 ≥4 且 f[i-1] 非数字；`0` 特判为合法全局地网名，非阻值 token）
* **D1-Q / D1-C**：BJT 须 4 网位置式（C B E sub）；cmim 须 3 网位置式（板1 板2 sub）——`sub=`/`b=` 命名参数补位 = 违规（官方样例均位置式）
* **D2**：衬底位（R 行 f[i-1] / Q 行第 4 网 / sub= 值）写字面 gnd/GND → 违规
* **D3**：位置网名字段含 `/` → 违规
* **D4**：npn13G2 须显式 `Nx=<N>` 且 `m=1`；m>1 无 Nx / 无 Nx → 违规；Nx 有而 m 缺省 → WARN
* **H1**：同两端子成对电阻提示（对拍须 `--no_series_res --no_parallel_res`）
* **pair 模式**：整改前后拓扑等价断言（端子网经改名映射逐件核对 + Q 规模语义对拍）

**判据器自证**：对 v4 病灶件复跑，抓出 36 issues = D1-R×12 + D4×16 + D3×4 网，与组长「12 只电阻全中招 / 镜像环 12 只器件失配」口径吻合（D4 按行计 12 缺 Nx + 4 处 m>1）。

## 三、cdl×3 推广体检结果（裁定二十第 5 条）——全数 D1 同族违规，**待裁换锚**

| 件 | 在册 sha16 | D1-Q | D1-R | D1-C | D2 | D3 | D4 | H1 |
|---|---|---|---|---|---|---|---|---|
| pex_drv2_v20.cdl | b080ab49 | 12 ✗ | 12 ✗ | — | ✓ | ✓ | ✓ | 1 对 |
| pex_drv1_v20.cdl | 4901fbb6 | 4 ✗ | 9 ✗ | — | ✓ | ✓ | ✓ | — |
| pex_mix_v28.cdl | 4dcc29db | 19 ✗ | 16 ✗ | 6 ✗ | ✓ | ✓ | ✓ | — |

**违规形态（与 v4 不同构）**：pex_to_cdl.py v5 生成时走了「R→3T / sub=0」转换规则，但落成的是**命名参数补位**形态：

```
R1 e1 ntail rsil l=1.0u w=4.665u sub=0     ← model 位 3，仅 n1 n2 两网；sub=0 是命名参数
Q1 ccas1 bin e1 npn13G2 we=70n le=900n NX=10 M=1 sub=0   ← 3 网；官方 CustomBJT4 是 C B E sub 四网位置式
C1 na1p ifp cmim area=514.382 perim=90.72 sub=0          ← 同构
```

**风险判读**：此形态若进 KLayout reader（custom_reader/custom_bjt_extractor 同语法族），`rewrite_res_from_model_position` 倒推 n1=f[i-3] 会取到**器件名本身**（model 位 3 时 f[0]='R1'）——比 v4「阻值占衬底位」错位更彻底；BJT 侧 CustomBJT4 四网缺一，解析结局未定义。cdl 现役虽只作 M5 代入链输入，但按「源网表对 ≠ reader 解析对」铁律，形态应在源头合规。

**处置建议（待组长裁定，不擅动）**：在 pex_to_cdl.py 生成器侧改三行规则（R→`R名 n1 n2 0 model l w`、Q→`Q名 C B E sub model …`、C→`C名 p1 p2 sub cmim area perim`），重出 cdl v2 ×3 → **sha 全变，判活锚须组长侧换锚重备案**（上口刚备案 4dcc29db/4901fbb6/b080ab49）。拓扑/网名/参数值零变化，仅形态位。裁定后本口可当日交付。

## 四、其他备案

* H1 跑法纪律适用件：drv2 sch v5（Rb1/Rb2 bin–nbias、bb1–nbias）与 drv1 sch v2（同构）——对拍须 `--no_series_res --no_parallel_res`，已在两件头注释备案。
* 求件：请组长投 `drv2_subckt_LVS输入_v7_conform.sp` 一份（8510 design/sow6/），我与 v5 做 diff 校准（预期逐位等价；若 reader 侧有我所不知的第三形态再修）。
* 判据器 0 网名特判备忘：`0` 既是 SPICE 全局地网名又形似数字，判据器显式放行——此特判本身入 playbook。

—— b7e7 · WiFi7-TX 组员 · 2026-10-18

---

## 【订正附录】裁定二十四 两处订正（2026-10-18 09:2xZ 追加，b7e7）

> 本附录依 b7a0《判读纪要_LVS输入对换源与cdl形态D1驳回_裁定二十四_2026-10-18.md》（sha16 658e6d18eb7fa5bb）
> 与组长来信（09:20Z）并入；上文正文（除本附录外）保留原文作审计轨迹，**冲突处以本附录为准**。

### 订正一：D1 在 cdl 侧「不适用」收编（§三 整段降级为历史记录）

§三 所列 cdl×3「D1-Q/R/C 违规」**按「不适用」收编，不入待改清单，换锚请示撤回**。理由（组长一手证据）：

* **cdl 从不进 LVS engine**（标准输入对 = GDS + schematic）；其唯一读者是 fde9 代入器
  `m5_pex_substitute_jia.py`（L113-139）：L117 regex `^Q(\S+)\s+(\S+)\s+(\S+)\s+(\S+)\s+npn13G2\s+(.*)$`
  **恰以「三网 + 模型位第 4 字段 + 命名参数」为输入契约**，L124 由代入器自补第四网 `0`，
  L120/L121/L122 归一 NX=→Nx=、剥 M=、剥 sub=。
* 组长正则实测：现役 cdl 三网形态 **匹配**；D1 位置式改形（`Q名 C B E 0 npn13G2` / `R名 n1 n2 0 model`）**失配**
  → 整行原样落网表 → 行首 `Q` 被 ngspice 按三端 BJT 解析、model 位取到 `npn13G2`（四端 .subckt）→ **M5 链直接挂**。
* §三 的「倒推 n1 取到器件名」风险判读**在 LVS reader 语境成立**（schematic 侧 D1 判据继续有效），
  在代入器语境不成立——属适用范围问题，非缺陷。
* **执行律**：换源重提取批**只改源、不改形态、不改文件名**（现役三名覆盖投），形态整改与换源**禁止混批**
  （判活看 sha，混批无法区分「整改到位」与「形态回归」）。

### 订正二：判据器加「目标读者」维（§二 工具已升级）

`skills/lvs_source_audit.py` 已加 `reader` 参数（缺省 `auto`：`.cdl`→`ngspice_substitute`，其余→`lvs_reader`）：

* `lvs_reader`：D1-D4+H1 原判据（schematic 侧），§二 所列全部有效；
* `ngspice_substitute`（cdl 契约体检）：Q 行模型位须恰 idx4（3 网）、R/C 行须恰 idx3（2 网）、
  `sub=` 命名衬底须在且为 0、D3 禁 `/` 与 D4（NX= 大小写等价）不变；D1 位置式判据**停用**。
  违反契约 → 「整行原样落 ngspice → 四端 .subckt 解析挂」级 FAIL。
* 自证：新读者模式下换源三件 cdl（mix ce97750b / drv1 60093747 / drv2 ebe7d9d7）**契约体检全绿**；
  sch v5 回归 `lvs_reader` 模式全绿（无行为回归）。

### 同批关联交付（裁定二十三/二十四执行件）

| 件 | sha16 | 说明 |
|---|---|---|
| pex_mix_v27.cdl（槽位名） | ce97750b03949593 | 换源 m2_mix_v29.gds(8f6da23d)；与现役 4dcc29db 器件/网名行**逐字节一致**，仅声明头 +SRC 行 |
| pex_drv1_v19.cdl（槽位名） | 60093747bb8abd23 | 换源 m3_drv1_v20_r2.gds(fe2ff903)；行与现役 4901fbb6 逐字节一致 |
| pex_drv2_v19.cdl（槽位名） | ebe7d9d7c0e6a211 | 换源 m3_drv2_v20_r2.gds(c9363888)；行与现役 b080ab49 逐字节一致 |
| DUMMY_DEVICES_台账_mix_Q5Q6_2026-10-18.md | （随件） | 裁定二十三·三 阳性认定件：Q5/Q6 坐标/三端域/通 gnd 三重证据 + T2 维护纪律 |
| mix_subckt_LVS输入_v1.sp | （随件） | 裁定二十三·五 mix LVS 前置件：15Q（含 QX5/QX6 补画）+16R+6C，与换源 cdl 37/37 逐件全等，D1-D4 体检全绿，check_netlist_dc ok |
