oppry12102/WIFI7-TX/06_layout_design_notes/M2_mix级版图设计稿_v2.5_2026-10-17.md

# M2 gilbert_mix 级版图设计稿 v2.5

**日期**：2026-10-17 · **作者**：b7e7 · **脚本**：`gen_M2_mix_v27.py`
**状态**：自检台 **20 项 + 库版本闸 全 PASS**，待组长代跑 GDS + DRC/LVS
**作废**：v2.0 ~ v2.6（v2.6 已由 Q10 轮的 v27 取代：T 交半搭接三处外延）

---

## 0. 一句话

v2.2 自检台 ⑤c/⑤d 抓出 **15 处 FAIL**（4 处跨层短路 + 11 处过孔柱压异网金属），
返工后清零；返工过程中又挖出 **3 处 v2.2 一直存在的结构性 bug**（Rd 两端接反、
nbiasH/nbiasL 够不到竖条、guard 环压核），其中两处是**电气断线**，
一组要靠新加的自检台第 ⑫ 项才看得见。

---

## 1. 15 处 FAIL 的病根：npn13G2 的 C/B/E **同 x**

实测（`inspect.py` 取 PCell 真实引脚）：

| 器件 | C | B | E |
|---|---|---|---|
| npn13G2（任意 Nx） | y **+1.13** | y **−1.14** | y **−0.01**（居中） |

**C/B/E 全在同一个 x**。于是：只要某条网的竖直干路还走在这个 x 上，它必然竖穿同器件
的另外两只脚 —— 轻则过孔柱压住异网金属（⑤d），重则 M1/M2 直接短接（⑤c）。
**v2.2 的 15 处 FAIL 无一例外全是这一类**，所以本版不逐个打补丁，而是给三类脚
各划一条专属通道。

| 脚 | 原走法（v2.2） | v2.3 走法 | 通道 |
|---|---|---|---|
| 集电极 C | 竖轨直接走器件 x（∓9.975） | M1 上**向外**折，再上竖轨 | x = ∓15 |
| 基极 B | 过孔柱**直接压在 B 脚上** | M1 上**向岛心**内折，再上竖管 | x = ∓3 / ±6（四条立管四条通道）|
| 发射极 E | M2 竖线走器件 x | 保持不动（本来就在 M2 上） | — |

三条通道互不同 x；C/B 的插头都在 **M1**，E 的干路在 **M2** → 层与 x 双重错开。
柱头只落在自己的通道上，通道里 M2/M3/M4/M5 全空。

### 15 处 → 15 处处置对照

| 原 FAIL | 位置 | 处置 |
|---|---|---|
| 跨层短路 | M1→M3@(−21.98,136.67) lop vs lopd | 勘误 ②：Rd 两端接反改正 |
| 跨层短路 | M1→M3@(−9.98,126.97) rfop vs lopd | 集电极外折 ∓15 |
| 跨层短路 | M1→M5@(+9.98,126.97) rfon vs lond | 集电极外折 ±15 |
| 跨层短路 | M1→M5@(+21.98,136.67) lon vs lond | 勘误 ② |
| 柱压异网 | M1→M3@(∓10,64.20) M2 e1b/e2b | 勘误 ④：ntailb 柱向岛心插 5µm |
| 柱压异网 | M1→M3@(−9.98,126.97) M2 nswa | 基极内折 ∓3 |
| 柱压异网 | M1→M3@(+9.98,116.86) M2 nswb | 基极内折 +6 |
| 柱压异网 | M1→M5@(+9.98,126.97) M2 nswa | 基极内折 +3 |
| 柱压异网 | M1→M5@(−9.98,116.86) M2 nswb + M3 lopd | 基极内折 −6（lopd/lond 两条立管不同 x）|
| 柱压异网 | M1→TOPM1@(∓30/±10,83.86) M2 e1a/e1b/e2a/e2b | gm 基极柱挪到 RBA_X（竖条自己的 x），B 脚加 M1 插头 |

---

## 2. 三处结构性 bug（返工时挖出）

### 勘误 ②：Rd1/Rd2 两端接反（**电气错**）

网表：`Rd1 lop lopd 10` → **P1 = lop、P2 = lopd**。
v2.2 把 lopd 的 M3 立管接在 **P1**、把 `'lop'` 标注画在 **P2** 的 M1 短脚上
—— 版图上叫 "lop" 的那条网其实是网表的 lopd。

**为什么没人看见**（这才是要点）：

- 第 ⑦ 项「引脚↔网名」比的是 `DEV_NETS` **声明**，而声明是对的（比的是声明不是版图）；
- `NET_DECL` 只比**网名集合**，不比「哪个脚」，`lop=[(Rd1,P2)]` 与集合口径自洽；
- ⑤b 同名分裂看的是连通；⑤c 跨层短路看的是短路 —— 都管不了「接到了另一条网的脚上」。

处置：改正极性（P2→lopd 立管、P1→lop 下引），`NET_DECL` 同步改正；
并新增自检台**第 ⑫ 项「引脚极性（几何取证）」**：拿 PCell 真实引脚坐标 +
过孔感知连通分量，直接验「网表给这个脚的网名」是否真的在这一脚的连通分量上。
它当场复现了本 bug，也当场抓出了我在 v2.3 首版里改漏的一处（见 §4）。

### 勘误 ③：`RB_H` 算式套错 → nbiasH/nbiasL 够不到竖条（**电气断**）

```python
RB_H = 0.72 + 0.84 * RG.res_params(2000, "rhigh")["_geom"][0]   # v2.2
```

`_geom[0]` **已经是算式求出的长度**（112.69µm），再套一次 `0.72+0.84·L` 得 95.38；
而 PCell 的真实 P2 高度是 `0.72 + 0.84·133.3 = 112.69`。

后果：nbiasH/nbiasL 的 TOPM1/TOPM2 立管从 y=330.38（**电阻腰上**）起，
永远够不到 P2 引脚 y=347.692 —— 两条偏置网在版图上是断的。
⑤b 看不见（同一条网只标了一个名字，无标注的另一截隐形），⑫ 看得见。

处置：全岛一律用 `res.p["P2"][1]` 真引脚 y，不再用算式推。顺带修好
`NIF_Y`（原来也是 `IF_Y + RB_H + 14`）。

### 勘误 ⑤：guard 环几何骑在核内容上（**潜在真短**）

```python
RING_M = 6.0                       # 环到核边界
ring_w = 4.0
for (ly_name, inset) in (("M1", 0.0), ("M2", ring_w + 1.0)):   # M2 环 inset=5
```

M2 环落在 `x∈[CORE_X0−1, CORE_X0+3]`，而 CORE bbox **正是由最外侧那只器件定义的**
→ M2 环必然压在最外侧器件上。实测两处真碰：Rb1 的 M1→M3 柱脚整个踩在 M2 环上；
XBI2 的 nvtop 柱差 0.05µm 压上。

处置：环宽收到 2µm、`RING_M` 提到 8µm，M1 环贴 guard 边、M2 环嵌其内侧 1µm，
两环都退到核外 ≥3µm。岛宽 143.4 → 143.4µm（高 379.9 → 383.8µm）。
岛框从「环骑内容」变成「环在外、离核 3µm」。

---

## 3. 层分配（不变，但通道变了）

| 网 | 层 | 备注 |
|---|---|---|
| e1a/e1b/e2a/e2b | M2 | 器件 x 上竖下引到 Re.P1，M2→M1 柱 |
| ntaila | M1 | y=57.4 横轨 |
| ntailb | M3 | Re.P2 → M1 向岛心插 5µm → 柱在 (∓5,68) → M3 轨 y=65.4 |
| lopd | M3 | Rd1.**P2** → 柱；B 脚 M1 插头到 x=−3 / +6；轨 y=113.86 |
| lond | M5 | Rd2.**P2** → 柱；B 脚 M1 插头到 x=+3 / −6；轨 y=113.86 |
| lop/lon | M1 | Rd.**P1** 直接向下出岛 6µm |
| nswa/nswb | M2 | E 脚竖线下到轨，M2→M1 柱在 (∓20,124.11) / (±20,114) |
| rfop/rfon | M1 | C 脚外折到 x=∓15，竖轨上行到 Y_RF=164.665，再折到 RL.P2 |
| na1p/nb1p/nb2n/na2n | TOPM1 | B 脚 M1 插头到 RBA_X，柱在竖条自己的 x |
| nbiasH | TOPM1 | 竖条真 P2 → 立管 → y=359.7 横轨 |
| nbiasL | TOPM2 | 同上，y=369.7 |
| nifbias | M3 | Rb.P2 → 柱 → y=132.7 横轨 |
| gnd | M4 | 地轨 y=18 + 全部 E/C/B 立管；E 脚一律**外折 4µm** 再落柱 |
| nvtop | TOPM2 | Rref.P1 **横插 1.5µm** 再落柱（避 M2 环）|
| nsens | TOPM2 | XQs C=B |
| vcc | M1 | RL.P1 → 下折到 ∓30 通道 → 顶上横轨 |

---

## 4. 自检台第 ⑫ 项：引脚极性（几何取证）

```python
# netaudit.audit_pin_nets()
#   网表 pin 次序 → 每个脚的连通分量上的实际网名集合
```

不是比声明，是比**几何**：拿 PCell 实例的真实引脚坐标、在**该脚自己的金属层**上
取连通簇，再用**过孔感知的并查集**求电气连通分量，看网名在不在里面。
两个判据：

- 分量上**没有**该网名 → 接错脚 / 断线；
- 该脚所在层**没有金属** → 悬空脚。

**它当场抓出了我在 v2.3 首版里改漏的一处**：重写 gm 基极段时把竖条**底端**的
`climb(rx, RB_Y-1.2, …)` 漏掉了 → `Rba1.P1 所在连通分量「无标注」`（底端没接上 na1p）。
补回即 PASS。这条注入已进 `teeth_v11.py`（注入 9）。

---

## 5. 有牙验证（`teeth_v11.py`，11 注入 11 真 FAIL）

**先说一件必须说的事**：第三轮那版「7 注入 7 FAIL」是**假通过** ——
探针脚本放在 `dryrun/tmp_probes/` 下，gen 脚本里的 `import resgeom` 直接
`ModuleNotFoundError`，于是每条注入都是**崩**出来的 FAIL，不是被注入的缺陷抓到的。
已修：探针走 `PYTHONPATH`，且判 FAIL 前先确认输出里没有「执行异常」。

| # | 注入 | 抓到它的项 |
|---|---|---|
| 1 | bin 立柱回到 vcc 下环 | ⑤d |
| 2 | gnd 不外折（压自己的 nref 立柱） | ⑤d |
| 3 | ccas 沿引脚列直上 | ⑤c |
| 4 | 嵌套网名退回裸 nref | ⑧ |
| 5 | 占位件标注放回金属层 | ⑧ 幽灵名 |
| 6 | drv1 gnd 不外折 | ⑤d |
| 7 | drv1 nref 退回裸名 | ⑧ |
| 8 | **Rd1 两端接反**（v2.2 原样） | ⑫ |
| 9 | **gm 竖条底端漏过孔**（v2.3 首版我自己漏的） | ⑫ |
| 10 | **ntailb 插头横插到岛外**（柱头落出 M3 轨跨度） | ⑫ |
| 11 | gm 发射极竖线回到引脚列 | ⑤d |

---

## 6. 发射极回流核算（**一点没动**）

`emitpath.py` 三档全部重算，与 v2.2 逐位相同（路由返工不碰回流几何）：

| 档 | 单边电流 | 合计 | 档位 | 余量 |
|---|---|---|---|---|
| drv1 做法 A | 3.72 mA | 196.1 mΩ | ≤250 mΩ | 21.6% |
| drv2 做法 A | 14.64 mA | 155.9 mΩ | ≤200 mΩ | 22.1% |
| drv2 做法 B | 14.64 mA | 108.7 mΩ | ≤200 mΩ | 45.7% |

---

## 7. 假设与回执依赖（沿用 v2.0/v2.2，新增一条）

**假设 A1**：`R_SHEET = {rsil: 15, rhigh: 15} Ω/□`，`R = Rsheet·l/w`。
真值回执后只改 `resgeom.py` 一行，全岛几何自动重算。

**新增 Q5（块级岛 guard 环）**：环已按 §2⑤ 修正几何（不再压核），但
**它是什么网、要不要接 gnd、以及要不要放进块级岛**都没定 —— SOW-6 把
`pad ring / seal ring` 列在 **M4 顶层拼接**（组长职责）。现状：M1+M2 双金属环、
**无标注**（因此自检台报 5 处「柱下无标注金属」注记，均为**同一器件自己的 E 脚焊盘**
或 gnd 走线，不是短路）。等回执：① 标 gnd；② 独立 ring 网；③ 删掉，交给顶层。

其余回执依赖项同 v2.0 §6（镜像语义 / via_stack 跨厚金属组合 / cmim PCell /
Rsheet 真值 / hbt_mirror 落图口径 / 理想源端口化）。

---

## 8. 未做/挂起项（明说，不假装已实现）

- **6 只电容全部是占位矩形**，非 cmim（cmim PCell 名/参数待回执）。
- **2 只电感 Lt1/Lt2（1nH）**：按 SOW-6 备案为版图禁区，本版未画任何图形，
  **顶层拼接时需在此处留禁区**。
- **guard 环命名/归属**：见 §7 Q5。
- **2k 电阻未折叠**（单根直条 = 单只器件，折叠 = 多只 = 与网表实例数不符）。
- 本版**不含 DRC/EM/PEX 实测** —— 工具链在组长侧；自检台只查我能犯的结构错。

---

## 9. 岛尺寸

核 bbox = [−70.3, 2.0 ~ 57.0, 369.8] µm → **岛 143.4 × 383.8 µm**
（v2.2 为 143.4 × 379.9；Rb1 内移 4µm 抵消、环参数变化净高 +3.9µm）。

---

## 附：Q5/Q6/Q7 修订（2026-10-17，据组长 reply_v12）

> 本节与上文冲突处**以本节为准**；逐条理由见 `CHANGELOG_2026-10-17_Q5Q6Q7.md`。

### 电阻几何全部重算（Q5）
上文所有按「Rsheet=15Ω/□」反推的长宽**作废**，改 cornerRES 三档真值取 typ：
rsil 6.02/**7.00**/7.98 · rppd 234/**260**/286 · rhigh 1160/**1360**/1560 Ω/□。
新增自动选型 `resgeom.res_auto()`（面积最小、l/w 均 ≥1µm 实测下限）：

| 器件 | 阻值 | 旧几何 | 新几何 | 型号 |
|---|---|---|---|---|
| Re1a/Re2a/Re1b/Re2b | 30Ω | l=2 w=1 | l=4.286 w=1 | rsil |
| Rd1/Rd2 | 10Ω | l=1 w=1.5 | l=1.429 w=1 | rsil |
| RL1/RL2 | 45Ω | l=3 w=1 | l=6.429 w=1 | rsil（钉住，走线便利优先） |
| XBI1/2_Rref | 680Ω | l=45.33 w=1 | l=1 w=2 | **rhigh** |
| Rba1/Rbb1/Rbb2/Rba2 | 2k | l=133.33 w=1 | l=1.471 w=1 | rhigh |
| Rb1/Rb2（IF 偏置） | 2k | l=133.33 w=1 | l=1.471 w=1 | rhigh |

**2k 电阻从 133.3µm 长条缩到 1.47µm** —— 顺带消掉一个 DRC 长宽比隐患。
金属方阻亦改 techlef 真值（M1 0.135 / M2-5 0.103 / TM1 0.021 / TM2 0.0145），
发射极回流预算随之放宽。corner 区间：rsil ±14.0%、rppd/rhigh ±14.7%。

### nref 布线重做（几何缩小暴露的断线）
Rref 缩到 l=1.0µm 后，旧写法「从 Rref.P2 的 y 横拉到 Qr.C 再竖下」的竖线
够不到 Qr.C（15.6 vs 31.13），nref 断成两截。改法：不假设相对高低，
显式取 `y_join = max(P2.y, Qr.C.y) + 1.5` 再三段直连。

### cmim 六只换真件（Q6）
PCell `cmim`、参数 w&l、0.84p → 23.66µm 见方。引脚层**运行时自适应**（取 cell 里
恰有 2 pin 的金属层），`create_cell` 失败非致命回落占位。
**缺口如实记账**：两端落线待代跑回读真引脚坐标后接，本版只把真件放入 + 两端标网名。

### guard 环定网 + 补 tap（Q7）
事实题答案：v2.3 的环是**纯金属、无任何 tap 接触**。
现按裁决：环不删、标 `gnd`（M1 四边中点 + M2 上下边，datatype=25 只写网名）；
M2 内圈与 M1 外圈用 M1 搭桥 + M1→M2 柱短接，M4 地轨延到环边再落 M1→M4 柱
—— 环**真接进 gnd 网**（否则仍是浮空金属）；ptap 以 PDK 默认参数落 8 只，
`TAP_ENABLE` 可一键关。

### 自检
三件 12 项全 PASS（新增 ⑬ 引脚异网横穿 / ⑬b 穿顶判据，有牙已证）；
teeth 11 注入 11 真 FAIL；网名 29/13/19 全闭合、幽灵名 0、漏标 0。

---

## 附录 A（2026-10-17 15:5xZ · 对应 gen_M2_mix_v26）· mim_cap 化 + TopVia1 钉档

依据：组长 b7a0 07:45:29Z 回执 ②（cmim 改用 `mim_cap`，「确认，改」）与新投盘
`probe_viastack_array_v22_2026-10-17.md`（sha e44d63e2…）。

### A1 六只 cmim 的落位改为「库解 W/L + 端子锚定」
- **W/L 交给库**：`Board.mim_cap(name, C_fF, target)` 按官方密度 `cmim_caspec=1.5 fF/µm²`
  解方阵边长（840fF → **23.66 见方**）并做**相位 snap**（官方 cmim `generateVias`：
  `n=fix((w+0.12)/1.26)`、`xoffset=(w−(n·1.26−0.12))/2` 须落 0.005 网格；
  23.665 → 内部 Vmim 阵列 offgrid×1296、23.66 干净）。我在 v2.5 手算的 23.66 恰好
  落在干净相位，但相位规则应由库持有，不该在交付件里复刻。
- **锚定不变**：两端引脚（`Metal5.pin(67/2)` 与 `TopMetal1.pin(126/2)`，每层 1 枚、同心）
  与 **cell bbox 中心**重合 ⇒ `target` 直接给**顶层端子坐标**，§6 的四条通道约束
  （端子 y = 180/180/206/206，端子 x = 偏置通道 x / rfop·rfon 通道 x）一字不改。
- **先量后摆**：插入前先造一只同名 cell 量出「bbox 中心 − 引脚中心」真实偏移；若将来
  两者分离，用目标点反推 bbox 中心落点 —— 精确落位，且不留错位实例。落位后用 `Dev.p`
  自证端子坐标，偏差 > 1nm 即占位回落（不猜）。
- 口径勘误（组长 ②）：pin shape 的 datatype 是 **/2（pin purpose）**，**/1 是网名 label
  层（METAL_LNUM）**。本件一直按 `/2` 取脚（`Board.pin_centers` = DT_PIN），口径本就正确。
- 仿真层仍走占位（`hasattr(pya,"WARN")` 短路）⇒ 自检台第 ⑦b 项照旧核对 6 个占位件声明。

### A2 顶层柱的 TopVia1 档位钉 1×1（几何与 v2.5 逐位相同）
- lib v2.2 起 `Board.via(t_layer="TopMetal1")` 的 **vt1 阵列档位继承 cols/rows**
  （v2.1 及更早硬编码 1×1）。本件 §7 的 rfop/rfon 顶层柱默认 cols=2,rows=2 ⇒ 会静默
  变成 2×2 阵列，而 TM1 平台**非线性**（实测 1×1 = 1.64 见方、3×2 = 2.94×2.10；
  组长明令「按实测值取用，**勿自行外推**」）⇒ 2×2 无真值可依。
- 故所有 `t_layer=TopMetal1` 的 via 显式 `vt1_cols=1, vt1_rows=1`：M5 端平台 0.62、
  TM1 端平台 1.64（**实测档**），与我已代跑过的那份**逐位相同**。
- 自检台新增第 **⑲** 项（TopVia1 端点平台 vs 我画的同层金属）：本件 11 处 TopVia1 跨接栈
  （12 个端点平台）**FAIL=0**（纪要规则值口径；M5 的 assumed 规则值只报不判）。

---

## 附录 C（v2.5 · Q10 轮 08:0xZ）：T 交半搭接外延 + ⑳ 项

### C1 三处横轨端点的「外延半宽」改法（官方 TM1.a×4 / TM2.a×8 全部由此消除）

病根是**横轨端点正落在竖条中心**（半搭接）：两条各自恰好等于该层最小宽（**逐矩形量 ⑯ 全绿**），
并集却在端头留下一段半宽的台阶，官方 width 类规则按「同一形状两条**相向**平行边距离
< minw」判 FAIL。本轮一律只**外延横轨端点**，不挪网、不改拓扑、不动竖条：

| 轨 | 层/最小宽 | 原端点 | 新端点 | 官方逐条坐标（v25 轮） |
|---|---|---|---|---|
| nbiasH 横轨 | TOPM1 / 1.64 | `RBA_X["Rbb1"]`, `RBA_X["Rba2"]` | 各 **±0.82**（= 半宽） | `(1.42,254.21;0.82,254.21)|(-0.6,255.03;0,255.03)` + 镜像 @34.18 |
| nbiasL 横轨 | TOPM2 / 2.0 | `RBA_X["Rba1"]`, `RBA_X["Rbb2"]` | 各 **±1.0** | `(-19,264.03)|(-20,265.03)` + 镜像 `(19,263.298)|(20,265.762)` |
| nvtop 横连 | TOPM2 / 2.0 | `NVT_X["XBI1"][0]`, `NVT_X["XBI2"][0]` | 各 **±1.0** | `(-38.2,9.268~10)|(-37.2,11.732~11)`、`(55.582,10)|(53.118,11)` |

外延量写成 `MINW["TOPM1"]/2` / `MINW["TOPM2"]/2`（跟着层最小宽走，改规则值自动跟）。
外延端离最近异网金属 >4µm，⑱ 间距 FAIL=0；器件数 82、标注 66 与 v2.6 逐位相同（零拓扑改动）。

### C2 附录用的话：为什么「任意两条平行边 < minw」是错的
先按那个口径写过一版，drv1 的 vcc 直角拐角（两条**同侧**平行边相距 1.18µm）假报 1 条；
官方对那一处**不报**。同侧 = 材料不在两条边中间 ⇒ 是台阶不是窄腰。改成**相向**后为 0。
另：形态学开运算（W×W 正方）那套把官方报的这些判成**合格**，与 deck 口径不符 ⇒ 只留作对照打印。
详见 `drcgeom.facing_width_violations()` / `morph_width_violations()` 的注释与
`CHANGELOG_2026-10-17_Q10.md` §3。
