oppry12102/WIFI7-TX/06_layout_design_notes/M4顶层_v2走线定稿_2026-10-18.md

# M4 顶层 · v2 走线定稿（gen_M4_top_v2.py）

**b7e7** · 2026-10-18 19:3x 本地 · **状态：本机双形态自检通过（gdstk 断言 A1~A9 全 PASS + 自检台 20 项仅剩预期误报 ㉑×7），投 8510 候组长代跑 DRC + 全层 bbox/净距复核（裁定十九⑤d）**
依据：裁定十九五项①②③⑤ + 裁定 21.6 摆位候选值；草案 `M4顶层_v2走线草案_2026-10-18.md` 大部分被采纳，**两处拓扑错误被本版机检抓出并修正**（见 §2）——裁定⑤(c)「gen 内置断言治本」当场兑现。

---

## 1. 件与自检结论

- `gen_M4_top_v2.py`（30427B，sha `6cbf4972…`）：双形态。真环境（klayout+lib13g2）read_gds 三件进 Board → 核定摆位插入 → Board API 画走线/官方 via_stack PCell/label（含 R-ANNO-01② 官方 /1 补打）→ `gds/m4_top_v2.out.gds`（顶层 M4_TOP_V2）；本机仿真层 gdstk 全层断言 A1~A9 → `gds/m4_top_v2.dryrun.json`（sha `890a3949…`）。
- **A1 摆位 bbox 逐位** = 裁定十九甲核定值（±0.005）：mix (0,0)~(145.55,281.34)、drv1 (185.2,0)~(572.84,221.25)、drv2 (612.84,0)~(801.84,261.0)；envelope 801.84×281.34（**候选**，裁定 21.6——mix v29 gen 已投 `52959dc3` 候代跑定版）。
- **A4 岛内净空**（比 body keepout 更强）：走线 vs 三岛 GDS 全层既有图形，交叠=连接点窗口外一律 FAIL、近邻 <规则值 FAIL——全过。
- 自检台 20 项：短路嫌疑 0 / 间距违规 0 / ⑳ 并集小舌 0 / 官方 label 6 处 / 岛界 ✓。**剩 ㉑×7 全部为「stub 端框在走线-only Layout 无对端金属」预期误报**（落柱 M1 端对核内焊盘、下钻 M1 端对 cop/con 横条、转接 TOPM1 端对立管——走线-only 形态无三件核图形，真环境代跑即消）。

## 2. ★ 草案两处拓扑错误（机检抓出，gen v2 已修正）

1. **「同带+翻越段」存在同层重叠**：草案通道 1 的 rfop 出线带（x58→165）与 rfon 横段（x99→172）同 y 带，重叠区 x[99,165]；草案的翻越段只覆盖其右段——**左半仍短路**。gen v2 定案：**nmixn 立管顶即转 TopMetal2**（TopVia2 1×1 骑立管顶），TOPM2 段 x[99.2,172] y[241.13,243.5] 全程与 rfop 带（TOPM1）**异层**平行——交叉物理消除，比翻越更短更稳。转接1 TOPM1 端平台顶 243.13 对 rfop 带底 244.97 净距 1.84 ≥ TM1.a；TOPM2 段对既有 TOPM2 净距 6.84 ≥ TM2.b；段宽 2.37<5 ⇒ TM2.bR 不触发。
2. **nd1n 竖拐穿 nd1p 底横 / 岛内 gnd 干路**：草案 nd1n 竖拐 x596.34 下行必横穿 nd1p 底横（y[16,19] x→647.84）；若右移进岛又必穿 drv2 岛内 M4 gnd 干路（y[109,113] 横贯 631.84~781.84）。gen v2 定案：**nd1p 升上位** y172.81（错层净距 1.5 ≥ M4.e）、竖拐 x603.34（在 nd1n 横0 右端 597.84 右侧 4.0 下拐，交叉消除）；两竖拐均在通道 2 空地内（x572.84~612.84，无干路）。

## 3. 通道定稿几何（顶层系）

**通道 1** nmixp（deck 顶层网名，mix.rfop→drv1.inp）：
TOPM1 立管顶接竖线 x[58.38,60.02] y[242.31,247.34]（贯穿）→ 出线带 x[58.38,166.185] **y[244.97,247.34]**（裁定②窗口，宽 2.37）→ 下拐竖线 x[163.815,166.185] y[8.81,247.34] → via_stack(M2↔TOPM1) 下钻 (165,8.81) → M2 横段 y[7.31,10.31] x[165,205.3] → via1 2×2 落柱 inp (205.3,8.81)。

**通道 1** nmixn（mix.rfon→drv1.inn）：立管顶 TopVia2 转接 (99.2,242.20) → TOPM2 段 x[99.2,172] y[241.13,243.5] → TopVia2 转接 (172,242.315) → TOPM1 竖线 x[170.815,173.185] y[14.31,243.2] → 下钻 (172,14.31) → M2 错层横段 y[12.31,15.31] x[172,212.3]（对 nmixp 横段净距 2.0 ≥ M2.e）→ M2 竖 x[210.8,213.8] y[8.81,15.31] → 落柱 inn (212.3,8.81)。

**通道 2** nd1p（drv1.cop→drv2.inp）：via_stack(M1↔M4) 下钻 (228.2,168.31) → 竖连段 y[168.31,172.81] → 横1 y[171.31,174.31] x[228.2,603.34] → 竖拐 x[601.84,604.84] y[17.5,174.31] → 底横 y[16,19] x[603.34,647.84]（对 gnd M4 轨 y[20.56,111] 净距 1.56、对根部 pad 1.255 ≥ M4.e 0.24——组长③已核口径）→ 落柱 inp (647.84,17.5)。

**通道 2** nd1n（drv1.con→drv2.inn）：下钻 (266.2,168.31) → 横0 y[166.81,169.81] x[266.2,597.84] → 竖拐 x[594.84,597.84] y[12.5,168.31] → 底横 y[11,14] x[596.34,654.84]（对 nd1p 底横净距 2.0；对 gnd 轨 6.56）→ 竖升 x[653.34,656.34] y[12.5,17.5] → 落柱 inn (654.84,17.5)。

**净距要点**（全部规则真值复核，gdstk 实测）：M4 异网最小净距 1.5（nd1p 横1/nd1n 横0 错层）≫ 0.24；TOPM1 异网最小 1.84（转接1 平台/带）；M2 错层 2.0；nd1n 竖拐对 nd1p 底横 x 净距 4.0/2.66；对 gnd 轨 2.51。通道几何 gap 实测 39.65/40.0（名义 40 口径，组长甲条已核）。

## 4. label 与标注

级间四网名用 **deck 顶层真名**（`XMI/XD1/XD2` 端口映射）：nmixp/nmixn（Metal2+TOPM1/TOPM2 各一）、nd1p/nd1n（Metal4）——防网名分裂；官方 label purpose /1 补打（R-ANNO-01②，同 drv gen `relabel_official` 惯例），/25 次级同步。

## 5. 待组长代跑（⑤d）

1. DRC 全套（走线宽/间距/⑳ 并集/via 平台——TopVia2 1×1 平台为**未实测档**，官方 PCell 自洽，以代跑为准）。
2. 全层 bbox/净距复核（gdstk 全层口径）。
3. LVS（顶层 vs chain_top_tb_v015_1.sp XMI/XD1 级间——候 deck 修复闭环签核条款不变）。
4. envelope 定版仍候 mix gen v29（`52959dc3`，本口已投）代跑；mix bbox 若变 ⇒ A1 断言即抓，摆位随动重投。

## 6. 边界声明

本口未点火、未改任何链件/库件；三件核 GDS 逐字节未动（read-only）；走线全部在顶层坐标（未进子 cell 改几何）；sub 块 label 未重打。

—— b7e7 · WiFi7-TX 组员 · 2026-10-18
