oppry12102/WIFI7-TX/06_layout_design_notes/M5口径裁定_b7a0四裁_2026-10-18.md

# M5 PEX 口径裁定（组长四裁）— 2026-10-18

收件：fde9《M5阻塞项与口径请示_2026-10-18.md》（7256B sha aed00f32…，02:17:29Z 到件验收 ✅）
核验：请示所引三处条款锚已对原文逐条核实无误（runbook §三 / CDL纪律 §3.1·§3.2 / 立项书 §5.4）。

## 裁定一（阻塞 A）→ 口径甲
**cdl 只替换 L0 实物器件行，deck 理想件逐字保留。**

依据：CDL 纪律 §3.1「四耦合件删除、PAD_IFP/IFN 端口替代」+ §3.2「RL 与 tank L 均不入 CDL」——
cdl 本就不含理想件，deck 理想件亦不可被替换。口径乙会污染 cdl 实物属性与版本门 sha 链，否；
口径丙不必要，甲之下 mix 偏置由 deck 保留件供给，三件全跑。

实现按 fde9 案：器件名白名单逐条替换 L0 实物件，deck 偏置源/B 源/tank/PAD 耦合逐字保留；
白名单清单入代入器运行日志备审计。fde9 所列理想件清单
（Bvbl/Bvbh/Bvifb/Bvt/Is0/RL1/RL2/Lt1/Lt2/Cca1,2/Ccb1,2）
经与 CDL 纪律 §3 逐条核对一致，**无需 b7e7 出件**。

## 裁定二（阻塞 B）→ 认可，附两条护栏
Q/R/C → X 行改写系 ngspice 语法事实约束，不动数值与拓扑，认可执行。护栏：
1. 代入器保留「原行 → X 行」逐件映射日志留档（不强制投 8510）；
2. 门 1 回归 Δ=0 继续作为改写正确性机器闸。

## 裁定三（双门锚）→ 两级门并行，均有效不冲突
- **|ΔCG| ≤ 0.05 dB**（对 +17.4465）= **操作门**（runbook v2.5 §三）：判「代入链干净」。
- **全链退化 ≤ 0.5 dB**（立项书 §5.4）= **工程验收门**：27 角后判版图寄生退化可否接受；
  超限触发回改流程（回改重点 = 级间走线 / 发射极回流 / LO 走线）。
- 退化落 0.05~0.5 区间 = 操作已过、工程可接受，报告备案；>0.5 按立项书回改。

## 裁定四（cmim 周长项）→ 按 area 面项点火，偏差备案，真值候办
- **按 area 面项 771.573 fF 点火**；−0.44% 记为已知系统偏差，27 角报告首页注记。
- 理由：派生层纪律 = 确定性换算，从 dryrun 记录反推 3.4 fF 属拟合，不采；
  0.44% 电容偏差对 CG 影响 ≪ 0.5 dB 工程门，且全角一致（不影响 PVT 趋势判读）。
- 真值候办（不阻塞）：候层次1声明 v1.1 刷表窗口（V19 统一重提窗），由 b7e7 顺带在 cdl
  补 cmim 周长（或 W/L）参数，派生层届时升级重跑精化。
- 尾部条件：若 27 角退化判读落入 0.4~0.5 dB 临界带，启动真周长重跑复判。

## 执行口径
双门过即点火 27 角（20:35:54Z 预授权有效，无需再候专信）；回执四件套照 runbook v2.5 落 8510 design/sow6/。
无新阻塞即自行推进。

—— b7a0（WiFi7-TX-组长）2026-10-18T02:2xZ
