oppry12102/WIFI7-TX/06_layout_design_notes/M5阻塞项与口径请示_2026-10-18.md

# M5 · PEX 代入：阻塞项与口径请示（fde9 · 2026-10-18）

**结论先行**：三件 cdl 版本门 + ntaila 三判据全过（b7a0 20:35:54Z 已收讫对账）。
但**双门跑不起来**，卡在两处，均已本机实测复现、非推测。需组长裁一口径才能继续。

---

## 一、已完成（可复核）

### 1. 版本门 6 sha 全对 ✅
| 件 | sha256 | 账面 |
|---|---|---|
| pex_mix_v27.cdl | `33e9e75451ab5cb8e222ca6f728ff2a1514bbffefa8011b4ee6852be9c8ac07b` | b7a0 19:10Z 参照件 ✅ |
| pex_drv1_v19.cdl | `ae4feb76076ae01c64d17a75009ef6936f7d7f1199a0e366ab32f2b0d2d00e3d` | ✅ |
| pex_drv2_v19.cdl | `1f5e0cd837b9af17cc36f2c1e6c6ddc1d0804b87dbedcb9c2b7cba211f373bf8` | ✅ |
| m2_mix_v27.gds | `ac3c72849cb17ffd740820ae8675da75d32f7e9680ea717ca8e8557e82e4e9f7` | ✅ |
| m3_drv1_v19.gds | `e59cdc33679eb87e7a56d7cb266283c6659d2c627f582da15fd4662dab18469f` | ✅ |
| m3_drv2_v19.gds | `76ae92cf6c4ee70e5d22576a37c7481fa71eda1dafa3d0d47cd2662c4f5280bf` | ✅ |

ntaila 三判据：A（cdl=JSON 逐字一致）/ B（Q5~Q10·Q15·R5·R6·C5·C6 全归 ntaila，头行 WARNING chosen=ntaila）/ C（以重提后新 JSON 为准）—— 均过。

### 2. PDK 器件模型派生层建成并自测 9/9 机器精度 ✅
**立因**：cdl 器件行引用 `rsil/rhigh/rppd/cmim/npn13G2`，但 SG13G2 的 ngspice 模型库
（cornerHBT.lib → sg13g2_hbt_mod*.lib）**只有 HBT**，无三端电阻与 MIM 的 ngspice 模型。
本机 ngspice-47 实测：
```
can't find model 'rsil' / 'rhigh' / 'rppd' / 'cmim'
could not find a valid modelname   (npn13G2 以 Q 行调用)
```
→ 这五个器件名是 **LVS deck 自定义设备**（`CDL格式纪律.md` v1.0 §1 `$[model]` 语法），本就不是 ngspice 模型。

**建层**：`sow6/m5/pex_devmodels.lib`——不改 cdl 一字，只把 cdl 里已有的版图几何
（`l=` `w=` `area=`）按 **PDK 官方 RSH/CMIMA 真值** 派生成 ngspice 元件：
- RSIL `R = 7.0·l/w`（Ω/sq，RSNRSIL target）
- RHIGH `R = 1360·l/w`（RSRHIGH target）
- RPPD `R = 260·l/w`（RSRPPD target）
- CMIM `C = area·1.5e-15 F`（CMIMA 1.5 fF/µm²）
- 出处：`SG13G2_os_process_spec` Rev1.2 §2.13 / §2.12（= b7a0 17:32Z 转来的官方表，已在 8510 `pdk_res_params_official.csv` / `pdk_mimcap_params_official.csv`）

**自测 9/9（`pex_devmodels_selftest.log`，误差 ~1e-16）**——逐件复现前仿网表标称值：
| cdl 器件 | 派生 R | 前仿 deck 标称 |
|---|---|---|
| drv1 R1 rsil l=1.0 w=1.75 | 4.0000 Ω | `Re1 e1 ntail 4` ✅ |
| drv1 R8 rppd l=1.0 w=2.6 | 100.0000 Ω | `RL1 vcc cop 100` ✅ |
| drv1 R3 rhigh l=1.19 w=1.0 | 1618.4 Ω | `XBI rr=1.62k` ✅ |
| drv1 R6 rhigh l=1.0 w=1.36 | 1000.0 Ω | `Rb1 bin nbias 1k` ✅ |
| drv2 R1 rsil l=1.0 w=4.665 | 1.5005 Ω | `Re1 e1 ntail 1.5` ✅ |
| drv2 R9 rppd l=1.923 w=1.0 | 499.98 Ω | `Rb1 bin nbias 500` ✅ |
| mix R1 rsil l=4.286 w=1.0 | 30.002 Ω | v015.1 gm 对 Re=30 ✅ |
| mix R9 rhigh l=1.47 w=1.0 | 1999.2 Ω | `nbiasL` 链 ✅ |
| cmim area=514.382 | 771.573 fF | b7e7 dryrun 记 775 fF（含周长 3.4fF），差 −0.4% |

⇒ **派生层是确定性换算，不是拟合**：cdl 的 `l/w` 是版图 PCell 几何，用官方 RSH target
换算后逐件复现前仿标称值。这条链一旦对上，后续 ΔCG 才有判读意义。

---

## 二、阻塞项（双门跑不起来，两处）

### 阻塞 A：cdl 不是整个 `.subckt` 体的 drop-in 替换 —— **需裁口径**

cdl 只含 **L0 实物器件**（HBT/电阻/MIM）。deck subckt 里另有一批**按设计就不入 CDL** 的件：

| deck 内元件 | 类别 | 为何不在 cdl |
|---|---|---|
| `Bvbl`/`Bvbh`/`Bvifb`/`Bvt`/`Is0` | 行为偏置源 | cdl 规则 3「剥 V·Cin·Ct·Lt」 |
| `RL1/RL2` 45Ω tank、`Lt1/Lt2` 1nH | L1 备案理想件 | 立项书 §1 保真度 **L1 不实做**；`CDL格式纪律` §3.2「RL 与 tank L 均不入 CDL」 |
| `Cca1/2`、`Ccb1/2` 1nF | 片外耦合 | `CDL格式纪律` §3.1「删除此四件，以 PAD_IFP/PAD_IFN 片外耦合替代」 |
| `Rd1/Rd2` 10Ω、`Ct1/Ct2`、`XBI1/2` 理想源 | 已在 cdl 实物化或 L1 化 | cdl 规则 2「hbt_mirror 内联」 |

**实测后果**：整段替换后 mix 的 `nbiasL`/`nbiasH` 失去驱动 → `Warning: singular matrix:
check node xmi.nb2n` → gmin stepping 失败，tran 不收敛。**这不是模型错，是替换边界错。**

**请示裁一个口径**（三选一，我不自决）：
- **口径甲（推荐）**：cdl 只替换 **L0 器件行**，deck 的偏置源/tank/理想 Lt/PAD 耦合**逐字保留**
  ——与立项书 §1 L0/L1 分级、CDL纪律 §3.1/3.2 完全一致。实现：在 deck 体内按器件名白名单
  逐条替换（Q/R/C 实物器件），非 L0 行不动。
- **口径乙**：整段替换，另需 b7e7 补一份「理想件回填 cdl」（含 B 源与 Lt/RL），否则链不闭合。
- **口径丙**：先只跑 drv1+drv2（其 cdl 依赖的理想件较少），mix 待 deck 侧补件后再并入。

### 阻塞 B：cdl 器件行须 Q/R/C → X 行改写（技术性，已解决，待确认）

ngspice 对 `R n1 n2 <name>` **只查 `.model` 卡、不查同名子电路**；子电路只能用 `X` 实例化。
故 `m5_pex_substitute.py` 做两处**纯语法**改写（不改任何数值/拓扑）：
1. `Q1 c b e npn13G2 we=.. NX=.. M=.. sub=0` → `XQ1 c b e 0 npn13G2 we=.. Nx=..`
   （PDK 的 npn13G2 是四端 `.subckt c b e bn`；cdl 的 `sub=0` 即衬底端接 0，语义等价）
2. `R1 a b rsil l=.. w=..` → `XR1 a b rsil l=.. w=..`；`C` 同理 → `XC`

**请示确认**：这两处改写是否认可？（我认为属「不改口径的语法适配」，但既然动到正式件，
按纪律报备，不自决。）

---

## 三、请示的两个数（口径锚，避免来回）

1. **双门锚用哪个**？runbook v2.5 §三写 |ΔCG| ≤ **0.05 dB**（对前仿 typ 锚 +17.4465）；
   而 `SOW-6_全链版图立项书` §5.4 写全链 PEX 后仿退化 ≤ **0.5 dB**。两者差一个量级，
   跑的件同一件、判读结论会完全不同。请明示本轮（层次 1 三件）以哪个为门。
2. **cmim 周长项取不取**？cdl 只给 `area` 不给周长；b7e7 dryrun 记 775 fF 含周长 3.4 fF，
   本层取面项 771.573 fF（差 −0.4%）。若要求对齐 775 fF，请给周长值或授权按 area 推算。

---

## 四、已备妥待命（双门一旦解封即可点火）

| 件 | 路径 | 状态 |
|---|---|---|
| 器件模型派生层 | `sow6/m5/pex_devmodels.lib` | ✅ 自测 9/9 |
| 建层自测台 + 日志 | `sow6/m5/pex_devmodels_selftest.sp` / `.log` | ✅ |
| PEX 代入器 | `sow6/m5/m5_pex_substitute.py` | ✅ 三级 37 件全转，端口序核对通过 |
| 门 1 判读 | `sow6/m5/m5_pex_op_gate.py` | ✅ 回归 Δ=0 PASS |
| 门 2 判读 | `sow6/m5/m5_parse_pex_tran.py` | ✅ 对前仿 tran 回归 Δ=−1.1e-5 |
| 27 角跑批 | `sow6/m5/sow6_pvt27_runner.py` | ✅ dry-run + 单角 diff 过 |
| 基线锚 | `sow6/m5/typ_v015_1.raw`（435B）/ `typ_v015_1_tran.raw`（195MB） | ✅ 在盘 |

口径一裁，我即按 runbook v2.5 点火：门 1（.op A0′）→ 门 2（ΔCG）→ 双门过则直接 27 角
（b7a0 20:35:54Z 已预授权「双门过直接点火，无需再候专信」）。

—— fde9 · 2026-10-18
