oppry12102/WIFI7-TX/06_layout_design_notes/mix_ntaila真短根因与修复_v30_2026-10-18.md

# mix ntaila 尾源真短：根因实锤与 v30 根修报告

b7e7 · 2026-10-18 · 回应 fde9 facediff_v34 问询（11:43Z）＋ 组长裁定三十五后新缺陷项
对象：`gen_M2_mix_v29.py`（52959dc3）/ `pex_mix_v27.cdl`（ce97750b，SRC_GDS 8f6da23d）
修复件：`gen_M2_mix_v30.py`（本报告随件投 8510）

## 〇、一句话结论

**ntaila 支路的二极管化是版图真短（金属实态），不是 cdl 生成产物**：XBI1 组的
XQr(NX=1) 整个落在 XQo(NX=10) 的 C/B 带金属投影内（摆位偏移 QR_L=8.7 < 带金属半宽
9.30），同层金属互压把镜参考网与尾轨并在一片 M1 上 ⇒ XQo 被接成二极管 ⇒ ntaila
尾源从高阻电流镜塌成低阻二极管对。修复：QR_L 8.7→12.0（v30），其余参数联动零改动。

## 一、实锤链（三源交叉）

1. **fde9 静态对照**（facediff_v34，190e8bd5）：pex_mix_v27.cdl L25-26 的 Q7/Q8
   C=B=ntaila，与 L28-29 的规范镜（Q10 参考、Q9 B=nref C=ntailb）形态不对称；
   前仿 deck XBI1/XBI2 同参同形 —— 提问「版图实态还是生成产物」。
2. **pex_mix_v29.json nets[0]**：`root=M1[6] names=[XBI1/nref, ntaila]
   area=49.18µm²` —— 一片金属域同时携带两枚异网标签。对照 XBI2 侧：
   `M1[67] names=[XBI2/nref] area=19.77µm²` 独立干净、`ntailb M3[13] 34.67µm²` 独立。
   面积账：49.18 ≈ 19.77（镜参考链，与 XBI2/nref 同形）+ 29.4（ntaila 轨的 M1 段）。
   （此双标签实态上口曾按「备案在册」处理——当时定性为实态非缺陷，本报告升级定性。）
3. **真 GDS 连通域分析**（本机 pex_extract/gdstk 读组长代跑件
   `design/sow6/gds/m2_mix_v29.gds`）：M1 层 414 多边形 → 110 分量；含 ntaila 三处
   标签与 XBI1/nref 两处标签的分量唯一，area=49.18µm²，bounds
   [−37.68,15.43]~[30.48,59.84]。拆到原始多边形，**桥接金属实锤**：

   | 多边形 | x 范围 | y 范围 | 宽 | 归属 |
   |---|---|---|---|---|
   | C 带金属（长条） | [−29.25, −10.75] | [31.02, 31.46] | 18.5 | XQo(NX=10) C 带，中心 −20=锚 |
   | B 带金属（长条） | [−29.30, −10.70] | [28.74, 28.98] | 18.6 | XQo(NX=10) B 带 |
   | XQr 管带 | [−29.68, −27.72] | 28.7~31.3 | 1.96 | XQr(NX=1) @ −28.7，**整体落在上两行投影内** |

   XQo.C 带 × XQr.C 带 重叠区 x[−29.25,−27.77]y[31.01,31.25]；XQo.B 带 × XQr.B 带
   重叠区 x[−29.30,−27.72]y 全含 ⇒ C_o=C_r、B_o=B_r，叠加 cb_tie 的 C_r=B_r
   ⇒ **XQo 二极管化**，与 pex cdl 的 Q7 C=B=ntaila 逐位对应。

## 二、根因

`QR_L=8.7`（XQr 相对 XQo 的横向偏移）**小于 XQo 的 B 带金属半宽 9.30**（真 GDS
实测：NX=10 的 C/B 带是横跨全管宽的长条，C 带 18.5、B 带 18.6，中心=锚 x；B 带半宽
9.30 > C 带半宽 9.25）。XQr 管带半宽 0.98。安全摆位律：
**QR_L ≥ 9.30 + 0.98 + M1 净距 0.63 = 10.91**。XBI2 侧 QR_R=25.35 ≫ 10.91，故只有
XBI1（side=−1，Qr 在 Qo 左侧近摆）中招。缺陷自 v1 起就在（所有历史 mix cdl 均有该
形态，fde9 已核 v27/v28/rehearsal 全中），非本轮引入。

## 三、自检盲区备案（为什么二十项没抓到）

- e-pad 审计只查「板级 M1 × E 指底座」，不查邻件 C/B 带互压；
- ⑱ 同层间距只量**自画矩形**，PCell 内部带金属不在册；
- preflight 的器件 bbox 粗筛：真值表建模的 XQo bbox=[−23.35,~0]（建模与真 GDS
  带金属不符），与 XQr bbox [−32.05,~−25.35] 间隙 2.0µm > 1.0 阈值不报；
- net_check 短路嫌疑列表里没有本对（同理，stub 几何里带金属不重叠）。
**新律候裁**：镜像/邻管摆位必须按「邻件带金属实测半宽」验距，不得按 PCell bbox 锚距；
带金属半宽应入 hbtgeom 真值表（NX=1: 0.98 / NX=10: 9.30，实测来源本报告 §一3）。

## 四、修复件 gen_M2_mix_v30.py（内部 v2.9）

- **单点改动**：`QR_L 8.7 → 12.0`（side=−1 分支），其余逐字节同 v2.8。
- 净空复算：XQr 管带左缘 = gx−12.98，距 XQo B 带左端 gx−9.30 净空 **1.72µm**
  （≥0.63 富余）；XBI2 侧 QR_R 不动。
- 联动自证：Rref（rf_x=qr_x−8）、cb_tie 逃逸列（qr.C.x±1.2，仍在 y_join 汇横线
  [rf_x,cxr] 覆盖内）、y_join 汇横线、nvtop 出脚（p1x=−40，柱 −41.5）全部参数化随动。
- 新增 `_qr_l_assert()` 运行时断言（§二安全摆位律）兜底。
- 本机 preflight 二十项 **PASS**（器件 82/标注 66；⑯⑰⑱⑲⑳㉑ 全 0；落柱接上 102/
  悬空 0；Rref 新位与 nvtop 柱无间距嫌疑；两两最小边缘净距 2.00µm）。
- 局限声明：stub 的 PCell 带金属建模与真 GDS 不符（§三），「XBI1/nref 恢复独立成簇」
  的终判须组长代跑 v30 后 PEX 复核（预期 nets：`XBI1/nref` 独立 ~19.8µm²、ntaila
  ~29.4µm² 分列，pex cdl 的 XBI1 组恢复 Q7 ntaila nref gnd NX=10 / Q8 nref nref gnd
  NX=1 / R5 nvtop nref——与 ntailb 侧对称；内部网名按 label 层次形态 XBI1/nref）。

## 五、电路影响与 A0′ 归因（供 fde9/组长口径判断）

尾电流直流账（nvtop→R(680)→参考网）：
- **规范镜**（ntailb 侧＝修复后 ntaila 侧）：R6 电流入 nref，Q10 二极管钳位，
  Q9(NX=10) 镜像 ⇒ 尾电流 ≈ 10·I_ref，尾节点高阻。
- **缺陷态**（v29 现状 ntaila 侧）：R5 电流直灌 ntaila，被 Q7(NX=10)+Q8(NX=1) 两只
  二极管钳位分流的低阻节点（~1/11·gm）——尾电流由「R5 电流 − 二极管支路」竞争决定，
  Q1/Q2 偏置点大幅偏离设计值 ⇒ gm 与 CG 随之偏移。
- **A0′ 归因候选①**（fde9 门1 FAIL Δ=−2.9379 dB）：若锚 17.4465 dB 的口径是
  前仿 deck（hbt_mirror 规范镜展开），则缺陷态对规范态的尾源退化正是 CG 落差的
  强候选；若锚件面与跑件面同用本 PEX cdl（同病），则 Δ 须另寻归因（Q/R 实物替代、
  RL/Lt 寄生、drv1/drv2 PEX 面差——fde9 候选清单继续）。**口径在 fde9/组长处，
  我不越权定**；v30 修复后重跑恒等角即可一并分辨。

## 六、请裁事项（组长）

1. v30（gen_M2_mix_v30.py）是否安排代跑（DRC+GDS 回投，我侧 PEX 复核 XBI1/nref
   独立性）；mix v29 envelope 定版是否等 v30 一并（本缺陷不动 envelope 几何参数，
   但 pex cdl 会随 v30 变）。
2. §三新律（带金属实测半宽入真值表 + 摆位验距律）是否立规。
3. tank 三判据报告（bd54b017，11:3x 投）不受本件影响，仍候 H1/H2 落槌；
   若 H1 定，tank w 修正与 v30 可合并为同一 mix 新版（两处改动维度正交：
   cmim w 参数 vs XBI1 摆位），请裁合并或分件。

## 附：本报告关联 sha

- 修复件 gen_M2_mix_v30.py：投件时回读 sha 为准
- 证据件：pex_mix_v29.json（盘上既有）、m2_mix_v29.gds（组长代跑回投件）
- fde9 对照件：facediff_v34.py（190e8bd5…）
