oppry12102/WIFI7-TX/06_layout_design_notes/PEX复核_v31_判读纪要_2026-10-18.md

# PEX 复核判读纪要 — m2_mix_v31（b7e7 · 2026-10-18）

对象：`m2_mix_v31.gds`（组长代跑出件，95028B，sha256 `ef034d51202c2db8ebc8f78c74c798c55b90f984870181839d885d39985837c1`，GET 回读 MATCH）
产出：`pex_mix_v31.json` / `pex_mix_v31.seg.json` / `pex_mix_v31.cdl`（sha256 `f6ba956041d997bd4714fa3042a65c619d275a776d6851f7feae3ccda560bd77`）
工具链：`dryrun/pex/pex_extract.py`（现役版，产 dnode_net）→ `dryrun/pex/pex_to_cdl.py`（v5，revised _resolve_net）

## 一、工具链备案（先说坑）

`design/sow6/pex_extract.py`（2026-10-17 21:59，375 行）是**旧版**，不产 `dnode_net`——用它产 cdl 会得到**全部节点空白**的废件。现役版是 `dryrun/pex/pex_extract.py`（产 dnode_net，v29 json 即它所出）。本次首跑误踩旧版，已用现役版重跑；旧版已改名 `pex_extract.py.old_nodnode.bak` 防再踩。

## 二、结构性验证（ntaila 塌陷修复兑现）

几何域三分列（pex json nets，v29 → v31）：

| 网 | v29 | v31 | R_seg_sum |
|---|---|---|---|
| XBI1/nref + ntaila | **合并域 49.18µm²**（真短） | — | 0.1688Ω |
| XBI1/nref | — | **独立 15.77µm²** | 0.1920Ω |
| ntaila | — | **独立 34.81µm²** | 0.2327Ω |
| XBI2/nref | 19.77µm² | **19.77µm²（逐位同）** | 0.2766Ω（逐位同） |

- **修复兑现**：v29 的 A 侧合并域（塌陷病灶）在 v31 分裂为 XBI1/nref 与 ntaila 两个独立域。
- **零 collateral**：B 侧 XBI2/nref 面积与 R 与 v29 逐位同——改动严格限于 A 侧根修区（与 DRC「消失 33 条全落根修区」互证）。
- 面积对账：15.77+34.81=50.58 vs v29 合并 49.18，Δ+1.40µm² = XBI1 左移 3.3µm 后 nref/ntaila 布线再分布。
- **面积不对称备案**：A 侧 XBI1/nref 15.77 vs B 侧 19.77（−4.00µm²）。组长预期 ~19.8/~29.4 是「对称拆分假设」（49.18−19.77）；实测拆分不是对称的——A 侧 nref 走线域本就比 B 侧小。**R 级影响估算**：R5 馈电链 rhigh 本体 ~500Ω 量级（1.0×2.0µm），寄生 R 差 0.192 vs 0.277Ω 仅 ~0.085Ω ≈ 0.02%，远小于门2 判据 0.05dB 对应的电学分辨率 → **预期 B 批 CG 落回 17.4465±0.05 判据内**。

## 三、cdl 逐行 diff（v27 基线 → v31）

**全部差异恰三行**（其余逐字节一致，diff 铁证）：

```
Q7  ntaila ntaila gnd  →  Q7  ntaila nref  gnd   (NX=10)
Q8  ntaila ntaila gnd  →  Q8  nref   nref  gnd   (NX=1)
R5  nvtop  ntaila     →  R5  nvtop  nref  rhigh l=1.0u w=2.0u
```

- 与组长预期「Q7 ntaila nref／Q8 nref nref／R5 nvtop nref」**三条逐字兑现**。
- 与 fde9 gen 侧 hier 答复（XQ7=ntaila XBI1/nref 0 / Q8=XBI1/nref XBI1/nref 0 / R5=nvtop XBI1/nref，剥层名归一后即上表）一致。
- **= 乙 3 行补丁预测形态**：修复后 A 侧回挂 nref 网 → 与 fde9 格4 源网表实验互证，归因闭环的几何侧证据到手。
- cdl 六判据审计（pex_cdl_audit.py）：全 PASS（①b≠e 13/15 dummy 豁免 Q5/Q6 ②R 零自环 16 ③WARNING 0 ⑥端口序）。

## 四、cmim 口径（w=l=23.610 落格生效）

六只 cmim 全部 area=514.382µm² / C=775.202fF / perim=90.72，**与 v29 逐位同**。
口径备案：bbox 口径 w×l=23.610²=557.45µm²；提取交叠口径（上板∩下板）=514.382µm²——差值=上板周缘缩进，提取口径自 v27 以来一贯（非 v31 新差异）。C 按 pex 实物报 775.202fF（组长 128 信：以提取实物为准）。

## 五、监测

monitor_baseline 9 件×4 类网轮间对比：**报警 0 条**（v31 seg 已入监测）。

## 六、待办与移交

1. **B 批全链闭环**：v31 PEX cdl + typ 单角——tb 口径待与 fde9 对齐（其格点实验台为准）；断言器 check_v30_cdl_symmetry（fde9 侧 64ae84a4）对 pex_mix_v31.cdl 预期 4/4。
2. 双 sha 已报 fde9；本纪要＋四件（cdl/json/seg.json/extract.log）投 8510。
