oppry12102/WIFI7-TX/06_layout_design_notes/PEX提取链_dryrun报告_2026-10-17.md

# PEX 提取链 dryrun 报告（v0）· 2026-10-17

**b7e7** · SOW-6 PEX 备料（组长裁定「dryrun 备料可先行」当日产出）
脚本：`design/sow6/dryrun/pex/pex_extract.py`
几何源：8510 投件 GDS（sha 锁定：mix ac3c7284… / drv1 353e5a56… / drv2 d5747e44…），
与组长真 klayout 出品件零重建误差；层映射=lib13g2 LG 表同源。

---

## 一、提取链 v0 建成（三件全通）

| 件 | 顶层 cell | 器件 | 连通域 | via 连接 | 器件参数对拍 |
|---|---|---|---|---|---|
| mix v27 | TX5G_M2_MIX_V27 | 45（Q 14 / R 19 / C 6 / body 7…） | 21 | 1110 | rsil 4.286/1.429/6.429 ✓ rhigh 2.0/1.0·1.0/1.47 ✓ cmim 514.4µm²→775fF |
| drv1 v18 | TX5G_M3_DRV1_V16 | 13（Q4 R9） | 16 | 627 | **Q4 只全对**（Nx 8/6/6/1，we70n le900n 自 Ae 文本）；rsil 1.75/1.0 ✓ rhigh 1.0/1.19·1.36/1.0 ✓ rppd 2.6/1.0 ✓✓ 全对 LVS |
| drv2 v18 | TX5G_M3_DRV2_V14 | 32（Q 18 / R 8 / ptap 8） | 21 | 1504 | rsil 4.665/1.0 ✓（v3 真值）rppd 1.0/1.923·2.6/1.0 ✓ |

判定规则（本口实测钉死）：VIA1-4=0.19²孔、TOPVIA1(1×1)=0.42²；本批 GDS **无显式 contact
孔层** → 端电阻不单列（LVS 器件参数口径已含），端子=PCell pin 块锚定（(63,0) 文本只是
标记点不能当锚——本口踩过即改）；电阻 w=(5,0) 宽 / l=底盘内边距（合并相邻块后算）；
HBT we/le/Nx 直接解析 `Ae=Nx*m*we*le` 文本；本批 GDS 无 8/2 以外的 CNT 形孔。

## 二、重大发现 A：drv1 v18 E 回流链物理断路（实锤）

**XQ1.E/XQ2.E（M2 出脚）→ Via1 桶 → M1 焊盘 → Re1.P1 的链路在 M2 层断开**：

- 板级 M2 宽臂（e1）：bbox y∈[**142.470**, 149.99]，x∈[-19.7,-8.3]
- Via1 桶（via_stack 实例 @(-14.0,140.44)，50 孔）M2 焊盘块：y∈[138.495, **142.385**]
- **缝 = 0.085 µm，全同层、无任何 via 跨接** → e1 分裂两簇（臂+管 7 域 ∥ 桶焊盘 2 域），
  e2 对称同病（y 142.470/142.385）。XQ1.E 到 Re1.P1 直流断路。

**根因**（emitpath.place_emit_chain 公式）：
`arm_bot = y_b + VH/2` 且 `y_b = y_p1 − res_bot − VH/2` ⇒ `arm_bot = y_p1 − res_bot = 142.47`，
即臂底按 via **外接高** VH≈4.07 的半高推到 y_b；但 via PCell 的 M2 焊盘块只有
VH−2×0.09（**VIA1 的 M2 enclose=0.09/边**），块顶实为 142.385。漏了 enclose 的 0.09。

**三方对撞**：
1. 我方纯几何提取：断（0.085µm 缝）；
2. 组长 LVS deck（独立工具链）：e1 与 e1$1 **分家两网**——KLayout 也看到断口；
3. gen 源码公式：arm_bot 推导漏 enclose——断口可解析复现。

⇒ **LVS 判读修正建议**：drv1 立照信判读③「物理同一 E 回流网被 deck covering-bbox 切成
孤立小网」应改判为「**版图真断，deck 如实提取**」。deck 修复验证点若含「e1$1 并回 e1」，
修复版重跑**仍会 FAIL 且该 FAIL 是真的**。

## 三、发现 B：drv2 v18 同型断 + 大合并网形态

1. **同型断**：e1/e2 各有孤立 2 域小簇（桶焊盘，面积 102.2µm²，与 drv1 同构）——
   drv2 走同一 `place_emit_chain`，同根因。
2. **大网五名合并**：`ccas1|ccas2|e1|e2|nbcas` 43 域（M1×32…M5×1）——E 宽臂主段与
   cascode 管网拽通。LVS drv2 判决「E 拽进簇甲」与此同型，但**是真物理还是真断的另一
   投影，需对照 drv2 设计稿意图复判**（cascode 下管 C=cas 管 E 本是同节点，五名全并
   仍超出该节点的合理范围——nbcas 是 cas 管基极偏置，不该进回流网）。

## 四、发现 C：mix v27 三网异常（备案待判读）

1. `XBI1/nref|XBI2/nref|gnd|nsens|ntaila` 65 域——**ntaila（gm 对尾流）进 gnd 合并网**，
   超出已知「XBI/nref|gnd」簇乙形态；
2. `lond|lopd|nswa|rfon|rfop` 42 域 M1~TOPM1——**RF/LO 域大合并**，开关共源点若真与
   RF 输入/LO 驱动同网即 tank 失谐级 bug；
3. `vcc` 仅 1 域（76.7µm² M1）——mix 供电平面疑似在合并大网里或标签未落域，需对
   M2 设计稿供电架构复判。
（mix 的 e1a/e2a/e1b/e2b 五域小网各自独立 ✓ 未受 E 链断型影响；ifp/ifn 全栈 ✓）

## 五、PEX 时序影响与建议

- 层次 1 的门 1（.op A0′≤1e-5）在 E 断路直流下**必炸**（断路网 .op 无解/大偏离）；
  门 2（ΔCG）也无从谈起。
- **deck 修复版 LVS 重跑全绿救不了这个**：e1$1 分家是版图真断的如实呈现，全绿的前提
  本身包含「e1 并回」——而它不该并回（断是真的）。建议时序改为：
  **先修 place_emit_chain（臂底延伸 0.09 或臂底下移）出 v19/v28 → 再走 LVS → 再启 PEX**。
- 层次 1 口径已备好：RSH target M1 0.110 / M2~M5 0.088 / TM1 0.018 / TM2 0.011 Ω/□，
  via typ 9/9/9/9/2.2/1.1 Ω（PDK 官方表已入链）；层次 2 平行板估算口径备妥
  （ILD1-4 67.2 aF/µm² 等，声明注 estimate）。宽金属 R 用 RSH·L/W 禁周长法 ✓ 组长裁定口径。

## 六、提取设置声明（随件口径，层次 1 启闸时正式化）

- 几何源：8510 GDS（sha 锁）+ lib13g2 LG 层映射；端子=PCell pin 块锚定；无 CNT 层 ⇒
  端电阻不单列（器件参数口径）。
- 网名：datatype 25 文本落域；多网名同域如实双名（如 XBI/nref|gnd）。
- 电源网简化开关 on（组长裁定）；IR-drop 附注不入门。
- 层次 1 金属 R：域内逐段 RSH·L/W（bbox 口径，凸正交准确、L 形保守误差，声明注明），
  via 按只并联 typ；段间图=最短路聚合到锚点。
