oppry12102/WIFI7-TX/06_layout_design_notes/tank三判据实验报告_官方口径实证_2026-10-18.md

# tank −7.714% 三判据实验报告：官方全链路=参数口径，H1 成立，H2 数学不可行

b7e7 · 2026-10-18 11:5xZ · 裁定三十五 §二 交办件（三判据实验）

## 〇、结论先行

1. **三判据全部指向 H1（参数口径）**：官方 PCell 几何、模型卡、LVS 提取器三层证据一致——cmim 的官方电容口径是**用户参数 w&l（=MIM 层 36/0 全尺寸）**，非上板交叠净区。w=23.66 模型真值 **843.479 fF（vs 840 名义 +0.41%，良性）**。
2. **−7.714% 是自研提取器口径伪影**：775.202 fF 系把规格密度套在**上板交叠净区**（22.68²）上的估算口径；官方任何工具都不产这个数。
3. **「0.98 内缩」不是线性规则**：上板宽 = via 阵列量化值 `1.26·floor((w+0.12)/1.26+ε)`（xanz 只取整数档）。w=23.66 档内缩恰 0.98 是**巧合**；w=24.591 档内缩变 0.651。判据③问的线性性外推：**不成立，不可外推**。
4. **H2 数学不可行（新证据）**：交叠口径下 C 只能取 1.26 µm 档位值——n=18→775.20（−7.71%）、n=19→863.52（+2.80%），**840 fF 无档可达**。A 案及其变体（含 +0.98 回加）在交叠口径下永远落不进规格。
5. **H1 的 gen v30 影响面极小**：w 23.66→23.6110 后 xanz 仍=18，上板/下板 GDS **零变化**；仅 MIM 层框缩 0.049 µm + label 数值变。选型公式补周边项 `1.5w²+0.16w=840 → w=23.611046` 精确回 840.000。

## 一、判据① PCell 源码（`cmim_code.py` sha `53e19656`，Apache-2.0 官方件）

```python
caplayerBBox   = Box(0, 0, self.w, self.l)                    # MIM 层(36/0)＝参数 w×l 全尺寸
topMetalBBox   = Box(x1, y1, x2, y2)                           # TopMetal1 上板＝via 阵列包络外扩 TV1_d
bottomMetalBBox= Box(-Mim_c, -Mim_c, w+Mim_c, l+Mim_c)         # Metal5 下板＝四边外扩 Mim_c=0.6
```

via 阵列（pitch=cont_size+cont_dist=TV1_a+0.84=**1.26**）：
`xanz = fix((w−2·Mim_d+cont_dist)/1.26+ε)`，`Mim_d=0.36`，`TV1_a=TV1_d=0.42`（`sg13g2_tech.json` sha `193f2af3`）。
代数化简（GridFix 无损时）：

> **上板宽 = 1.26·xanz**，xanz = ⌊(w+0.12)/1.26+0.001⌋（整数档）

| w（µm） | xanz | 上板宽 | 内缩 | 名义 1.5w² | 模型卡口径 | 上板交叠口径 |
|---|---|---|---|---|---|---|
| 23.66（现役） | 18 | 22.680 | **0.980** | 839.693 | **843.479** | 775.202 |
| 23.6110（H1 参数） | 18 | 22.680 | 0.931 | 836.219 | **839.997** | 775.202 |
| 24.5910（H2 参数） | 19 | 23.940 | 0.651 | 907.076 | 911.010 | 863.516 |

- w=23.66：上板 22.68、内缩 0.98——与提取实测 area_um2=514.382 **逐位吻合**（提取器量的就是上板）；
- **MIM 层（=官方 LVS 识别层）=参数 23.66²，与 w 无量化、连续可调**。

## 二、判据② 模型卡（`capacitors_mod.lib` sha `ff9eb4cc` / `cornerCAP.lib` sha `4fc4a0f1`）

```spice
.model cmim_core C (TC1=3.6E-6 TC2=2E-9 TNOM=27 CJ=cap_carea CJSW=40E-18)
.subckt cap_cmim PLUS MINUS
  C1 1 MINUS cmim_core l=l/sf w=w/sf scale=1     ; w/l 为用户参数直传
```

- **C = CJ·w·l + CJSW·2(w+l)**，CJ=cap_carea=**1.5E-15**（typ corner，cornerCAP.lib L22）、CJSW=**40E-18**——**含周边项，且用参数 w/l**（非几何交叠）；
- w=23.66 ⇒ C = 1.5×559.7956 + 0.04×94.64 = **843.479 fF**；
- PCell UI 显示口径（`utility_functions.py` sha `49917455` CbCapCalc）再带 lwd=0.01 µm：`C=(w+lwd)²·caspec+2(w+lwd)·cpspec·2` ⇒ 844.191 fF——同族，差 0.08%；
- 工艺规范旁证（`pdk_mimcap_params_official.csv` sha `181a6256`，出自 os_process_spec §2.12）：CMIMA target=1.5 fF/µm²、**CMIMP=40 aF/µm（perimeter 项规格在案）**。

## 三、判据③ 官方 LVS 提取器（`custom_mim_extractor.lvs` sha `2e4a47be`；派生链 sha `2122ca99`/`ae5cd874`/`866c32c8`）

```ruby
# cap_derivations.lvs L36-45：
mim_drw  = polygons(36/0)                        # MIM 层
mim_top  = mim_drw.overlapping(topmetal1_con)    # ★ overlapping＝选择语义（整多边形选出，非交集）
cmim_top = mim_top.not(rf 排除)
# cap_extraction.lvs：'core' => cmim_top
# custom_mim_extractor.lvs calc_cmim_params：
dev_edges = dev.edges                            # dev＝core＝cmim_top
width  = get_uniq_length(水平边)                  # ＝ 23.66
length = get_uniq_length(垂直边)                  # ＝ 23.66
device.set_parameter('A', width*length)          # A＝559.7956 µm²
device.set_parameter('P', (width+length)*2)      # P＝94.64 µm
```

- **klayout pip 包（0.30.12）实证 overlapping 选择语义**：MIM(0,0,23.66,23.66).overlapping(TM1(0.49,0.49,23.17,23.17)).bbox() = **(0,0;23.66,23.66) 全框**（交集才是上板框 (490,490;23170,23170)）；
- ⇒ 官方 LVS 识别的 cmim 器件 **w=l=23.66、A=559.7956、P=94.64（参数口径）** → 传 cap_cmim 模型 ⇒ **843.479 fF**；
- **可证伪预言**：组长侧真环境官方 LVS 跑 mix v29 GDS，cmim 器件参数应报 w=l=23.66（非 22.68）；若报 22.68 则本报告判据③推翻，H2 重开。

## 四、H2 不可行证明（交叠口径量化档位）

交叠口径 C(s)=1.5s²+0.16s，s 只能取 1.26 的整数倍（上板=via 阵列量化）：

| 档 n | s（µm） | C（fF） | vs 840 |
|---|---|---|---|
| 17 | 21.42 | 691.65 | −148.35 |
| **18** | **22.68** | **775.20** | **−64.80（−7.71%）** |
| 19 | 23.94 | 863.52 | +23.52（+2.80%） |
| 20 | 25.20 | 956.59 | +116.59 |

840 落在 n=18/19 之间的空档，**任何 w 都无法使交叠口径=840**。H2（含 A 案 +0.98 回加变体——24.591 实际内缩 0.651、交叠 23.94、提取 863.52 ≠ 840）在数学上不可达。

## 五、判据实验对处置预案的落点（候组长落槌）

1. **H1 成立 ⇒ tank 规格偏离销案**：官方口径链（规格→模型卡→LVS→PCell 显示）全为参数口径，w=23.66 真值 843.479（+0.41%）；775.202 系自研提取器口径伪影。
2. **pex_extract.py cmim 段口径声明**（H1 预案原文）：建议措辞——「c_ff 系上板交叠净区估算（真实平行板重叠面），器件真值以参数 w&l 模型口径为准（×1.5 fF/µm²+40 aF/µm·周长）；两者差随 via 量化档位变化，w=23.66 档恒为 0.98 位移项」。
3. **gen v30 选型公式补周边项**（H1 预案原文，候裁）：`1.5w²+0.16w=840 → w=23.611046`；**GDS 上板/下板零变化**（xanz=18 不变），仅 MIM 层框 23.66→23.611（缩 0.049）+ label 数值——影响面极小，混净空地图/走线无扰动。
4. deck Ct=0.84p 不动；双计剔除照旧；门2 档乙 A0″=775.2018 fF（fde9 侧已裁）不回流——注意 A0″ 用的是提取实物值，若组长认 H1，门2 是否改用模型口径值 843.479 请一并裁定（个人建议：门2 档乙维持 A0″ 提取值不动，它测的是「提取器与版图的一致性」不是规格符合性）。

## 六、官方件留档（`design/pdk_sg13g2_ref/`，GitHub IHP-GmbH/IHP-Open-PDK@main 2026-10-18 抓取）

| sha256 前 8 | 文件 |
|---|---|
| 53e19656 | official_klayout/ihp/cmim_code.py（PCell 源码） |
| e9a45c12 | official_klayout/ihp/rfcmim_code.py |
| 49917455 | official_klayout/ihp/utility_functions.py（CbCapCalc） |
| 193f2af3 | official_klayout/sg13g2_tech.json（Mim_d/caspec/cpspec 等全参数） |
| ff9eb4cc | official_models/capacitors_mod.lib（cmim_core CJ/CJSW） |
| 4fc4a0f1 | official_models/cornerCAP.lib（cap_carea=1.5E-15 typ） |
| 2e4a47be | official_klayout/custom_mim_extractor.lvs（MIMCAPExtractor） |
| 2122ca99 | official_klayout/cap_derivations.lvs |
| ae5cd874 | official_klayout/cap_extraction.lvs |
| 866c32c8 | official_klayout/sg13g2.lvs |
| 09e1b004 | official_klayout/sg13_tech_info.py |
| adba1f9e | official_klayout/cap_connections.lvs |
| 050d57c9 | official_models/sg13g2_typ.itf |
| 181a6256 | pdk_mimcap_params_official.csv（既有档，§2.12 规格旁证） |

## 七、Appendix：本侧复现脚本（全部数值可一键复算）

```python
def cmodel(w, cj=1.5, cjsw=0.04): return cj*w*w + cjsw*4*w      # fF（正方形）
xanz = lambda w: int((w + 0.12)/1.26 + 0.001)                    # via 阵列档位
top  = lambda w: xanz(w)*1.26                                    # 上板宽（量化）
assert abs(cmodel(23.66) - 843.479) < 1e-2                       # 判据②参数口径
assert abs(cmodel(top(23.66)) - 775.202) < 1e-2                  # 提取器=上板口径（=pex_mix_v29.json 实测）
assert abs(cmodel(23.611046) - 840.0) < 1e-2                     # H1 gen v30 解
assert top(24.591) == 23.94 and abs(cmodel(23.94) - 863.516) < 1e-2   # H2 档位跳变
# klayout pip 实证（判据③语义）：
# Region(Box(0,0,23660,23660)).overlapping(Region(Box(490,490,23170,23170))).bbox()
#   = (0,0;23660,23660)  <- 选择语义，cmim_top=MIM 全框
```

—— b7e7（WiFi7-TX-组员）2026-10-18 · 三判据实验完，候组长落槌
