oppry12102/WIFI7-TX/06_layout_design_notes/tank规格偏离_口径链核查与裁决请求_2026-10-18.md

# tank 规格偏离 −7.714%：口径链核查与裁决请求（裁定三十 §一 / 裁定三十一 §六 回执）

b7e7 · 2026-10-18 18:4x 本地 · 回应裁定三十 §一「二选一落文字」

## 〇、结论先行

1. **认账**：提取口径 775.202 fF 属实（本侧三方数值链精确复现，见 §二）。
2. **拦截**：A 案**字面执行**（PCell 参数 w 23.66 → 23.6110 µm）会使提取口径**更小**（775.20 → 771.86 fF）——因为 514.382 µm² 不是 PCell 板面积，而是**上下板交叠净区**＝(w−0.98)²。数字证明见 §四⑦。
3. **新发现**：−7.714% 极可能是**提取口径伪影**而非实物缺陷——真件 w=23.66 µm 恰好＝mim_cap(840 fF) 的库解（组长真环境 NOTES 可查 `CMIM_REAL … w=23.66u 名义839.7fF`），板没有画小。
4. **二选一暂缓，先口径裁决**：两条出路在两个口径假说下动作相反，0.49 µm 内缩规则的官方出处本地无 PDK 无法单方确证。给三判据实验（§六），两组处置预案（§七），裁决后一版落地。

## 一、口径链全景（三方数值，全部精确闭合）

| 口径 | 公式 | 当前件（w=23.66） | 840 fF 对应参数 |
|---|---|---|---|
| ① 库选型/名义 | C = 1.5·w² | 839.69 fF | w = 23.664（库解 23.66，相位 snap） |
| ② PDK 模型（若含周边项） | C = 1.5·w² + 0.16·w | 843.48 fF（+0.41%） | **w = 23.6110** |
| ③ 提取器（交叠净区） | C = 1.5·(w−0.98)² + 0.16·(w−0.98) | **775.202 fF（−7.71%）** | w = 24.5910 |

几何关系（本侧复现，Appendix 脚本可跑）：
- 提取 area_um2=514.382 ⇒ 完美正方形 22.6800 µm，周长 90.72=4×22.68；
- 22.68 = **23.66 − 0.98**（每边内缩 0.49 µm）——即官方 cmim PCell 的 TOPM1 上板与 M5 下板交叠净区比参数 w 每边小 0.49；
- c_ff=775.202 = 1.5×514.382 + 0.04×90.72 精确（提取器系数即官方 1.5 fF/µm² + 40 aF/µm，乘的是交叠净区）。

## 二、认账部分（与裁定三十 §一 对齐）

- 提取器自算 c_ff=775.202 fF ✓（pex_mix_v29.json 六只 cmim 同值同参）；
- deck 标称 Ct1/Ct2 = 0.84p ✓；
- 比值 0.922860 ⇒ 谐振 5.4914 → 5.7163 GHz（+4.096%）、5.51 GHz 取点落左侧 3.6% ✓（Lt=1 nH 复算一致）；
- 双计（Ct1/Ct2 ↔ 片上 C5/C6 同一件两表述）与规格偏离是两件事，不合并 ✓。

## 三、为什么说「板没有画小」（H1 论据）

1. **w=23.66 不是任意值**：mim_cap(840 fF) 库解＝√(840/1.5)=23.664 → 相位 snap 23.66（组长实测 23.665 offgrid×1296、23.66 干净）。gen 的 CMIM_W/L 自查基准与库解一致 ⇒ 落图即 CMIM_REAL 真件（NOTES 行可查，真环境 run 日志第四条路径）。
2. 若实物板真画小了 7.7%，其边长不该**恰好**等于库解 23.66、交叠又恰好=23.66−0.98。
3. 提取器量的是 (126,0)∩(67,0) 交叠**图形**——PDK 官方 rcx 对 mim 器件通常按器件参数/模型提取，不按图形交叠。775.202 是**自研提取器的口径**，不是（尚未证明是）官方后仿口径。

## 四、对 A 案反解的校核意见

组长的 557.481 µm² / 23.6110 µm 反解算术完全正确，但它解的其实是**口径②**（1.5w²+0.16w=840 ⇒ w=23.611046，本侧复现 23.611046 精确）——即「让 PDK 模型值=840」的参数。把它套进口径③（交叠边长）则：

- ⑦ 字面执行 w→23.6110 ⇒ 交叠=(23.6110−0.98)²=512.162 µm² ⇒ 提取 771.86 fF（**更小，方向反了**）；
- ⑧ 若目的=提取口径=840（H2 世界观）⇒ 参数 w=23.6110+0.98=**24.5910** ⇒ 交叠 557.479 ⇒ 提取 839.997 ✓——但名义/模型口径冲到 907.1/911.0 fF（+8.0%），deck 标称反而失配。

**两个口径假说下，字面执行都达不到目的**——这是请求暂缓的直接原因。

## 五、还须注意：0.98 内缩规则本身待确证

「交叠=参数 w−0.98」目前是**单点数值反推**（一只尺寸档）。判据③实验同时可验证其线性性（换一只 w 提取，内缩仍 0.98 才可外推）。

## 六、三判据实验（请组长以 PDK 真值裁决）

| # | 实验 | 判什么 | 结果指向 |
|---|---|---|---|
| ① | 读官方 cmim PCell 源码：TOPM1/M5 板尺寸 vs 参数 w | 内缩 0.49 是否官方几何规则 | 有 ⇒ 提取口径伪影坐实（H1） |
| ② | 读 PDK 器件模型卡 cmim 段的 C 公式 | w/l 参数怎么进 C、含不含周边项 | 含周边且按 w ⇒ 真值 843.48，偏离=+0.41% 良性（H1） |
| ③ | 官方 rcx/klayout 提取跑同一 GDS 的 cmim 值 | 官方后仿口径=参数口径还是交叠口径 | =843 ⇒ H1 销案；=775 ⇒ H2 成立 |

## 七、裁决后的两组预案（一版落地）

- **H1（三判据任一指向参数口径）**：tank 规格偏离**销案**；pex_extract.py cmim 段加口径声明（「c_ff 系交叠净区估算，器件真值以 w&l 模型口径为准，两者恒差 0.98 位移项」）；deck Ct=0.84p 不动；5.51 GHz 取点不动。模型口径 843.48（+0.41%）若要精确压 840，可下版把选型公式补周边项（w 23.66→23.6110，**这才是 23.6110 的正确用法**）——列入 gen v30 候选项，由组长裁。
- **H2（官方 rcx 同为交叠口径）**：A 案变体执行——gen `CMIM_C_FF` 选型公式改 `1.5w²+0.16w=840` 解出 w=23.6110 后**加回 0.98**（参数 w=24.5910，交叠=23.6110）；重提取六只 c_ff=840.0；版图占位 +8%（23.66²→24.591²，电容区 bbox 复核随件）；deck 标称 0.84p 不动。
- 共通：双计剔除照裁定执行（Ct1/Ct2 与 C5/C6 只留一只），与本裁决无耦合。

## 八、Appendix：可复现数值脚本

```python
import math
A, P, c = 514.382, 90.72, 775.202          # pex_mix_v29.json 实测
assert round(1.5*A + 0.04*P, 3) == c       # 提取口径复现
s = math.sqrt(A)                            # 22.68 完美正方形
assert abs(4*s - P) < 1e-9                  # 周长自洽
w = 23.66                                   # mim_cap(840) 库解
assert abs((w - 0.98) - s) < 1e-9           # 0.98 内缩关系
D = 0.16**2 + 4*1.5*840
wm = (-0.16 + math.sqrt(D)) / 3             # 23.611046 = 口径②之解（=组长反解数）
wn = 23.6110 + 0.98                         # H2 正解 24.5910
print(1.5*wn**2 + 0.16*wn)                  # 口径② = 911.0（H2 副作用）
```

—— b7e7（WiFi7-TX-组员）2026-10-18
