oppry12102/WIFI7-TX/06_layout_design_notes/v20v28_cdl重提_M1e修复v29_补丁折进_执行报告_2026-10-18.md

# v20/v28 cdl 重提 + M1.e 修复(v29) + 补丁折进 执行报告

**b7e7** · 2026-10-18 17:0x 本地（08:5x~09:0xZ）· 对应组长 L96（裁定十七 + 代跑判读收编）

---

## 一、cdl 重提×3（GDS 到件即提，TERM_LAYER 链）

GDS ×3 fetch 回读 expect 全对（f4f59077 / b0670f4d / 87d41dba）→ `pex_extract.py` 三件重提 → `pex_to_cdl.py` 出件：

| 件 | cdl | sha256 前 8 | 器件 | 匿名网 |
|---|---|---|---|---|
| mix v28 | pex_mix_v28.cdl | 4dcc29db | Q15(含 dummy2) R16 C6 | 0 |
| drv1 v20 | pex_drv1_v20.cdl | 4901fbb6 | Q4 R9 | 0 |
| drv2 v20 | pex_drv2_v20.cdl | b080ab49 | Q12 R12 | 6（§7 备案形态同 v19） |

**判读预期的 cdl 级证据全部落袋**：
- v19→v20：`Q1 cop e1 e1`（B=C 短路假象）→ `Q1 cop bin e1`（三端异网）；`R4 inp nref` → `R4 inp gnd`（输入端接电阻回主 gnd）；net 14→13 匿名 2→0。
- v27→v28：merged-domain WARNING 2 条 → **0 条**；`Q5~Q8 ntaila ntaila ntaila`（幻影焊形态）拆解为真身；R1~R4 e1a→ntaila 异网。
- **六判据三件全 PASS**（pex_cdl_audit 全量复核，详见层次1声明 v1.1 §8）。

## 二、★Q5/Q6 定谳：d3L/d3R dummy，非缺陷

六判据①首跑曾 FAIL（Q5/Q6 B=E=gnd）。逐位核查：
- pex JSON：Q5/Q6 = x=∓50 的 Nx=3 管，C/B/E 三端**不同域**（M1[11]/M1[7]/M2[9]），解析后全进 gnd 网。
- gen_M2_mix_v28.py L505/506 `d3L/d3R = mkhbt(...,3, CX∓2.5*GM_COL, GM_Y)` + L1023~1029 **逐端子 hop+wire_v 落 GND_RAIL** + L1157 `DUMMY_DEVICES={"d3L","d3R"}` 台账 —— **设计意图：gm 列两端匹配 dummy 全接地**。
- v27 同款提取器复核：同域号模式 ⇒ **v27 已有几何**，v27 cdl 显示 ntaila 系 merged-domain 假象，v28 拆开后显真身。
- 处置：pex_cdl_audit 判据①加 dummy 口径（三端全 gnd → 豁免单列；网名非 gnd 的三端同网仍抓，v27 幻影焊案回归能力不丢；防呆=同层重叠判据兜底）。**LVS 对拍侧请按 DUMMY_DEVICES 排除 Q5/Q6**（mix 应 13 只 HBT 参与对拍）。

## 三、M1.e 修复（裁定十七）→ gen_M2_mix_v29.py

cbpath.py 内核三件套（非 gen 侧打点，普适回改）：
1. **cb_tie 下横线自动退让**：e_pad 给出时，净距 `ey0−(yb+w/2) ∈ [0,0.22)` 即沿 −y 退到 **0.225**（M1E_GAP 0.22 + M1E_MARGIN 0.005），带连接自证（退后仍与 B 带重叠）。mix 案落点 **28.86→28.84 = 组长给的「B 带心−0.02」逐位一致**；不触发案保持带心（复现实测）。
2. **assert_m1e_gap（盲区第五例）**：cb_tie 落线后自证全 segs × E 底座：触发条件（线宽>0.15 且平行段>1.0）成立时净距 ≥0.22。
3. **audit_board_e_pads 全板 M1.e 间距桶**：不重叠但净距 <0.22 且触发的板级 M1×E 窗 → FAIL 明细。

**gen_M2_mix_v29.py** = v28 唯一几何 delta：XQr/XQs 下横线 y −0.02（内核自动），其余逐位不动。本机自检：
- preflight PASS 器件=82 标注=66；pad-audit 16 只 ✓；e-pad-audit 15 HBT × **90 块**板级 M1 零真短 + **M1.e 桶零命中** ✓。
- drv1/drv2 v20 gen 复跑 PASS（32/32、73/59）——补丁零回归。

## 四、组长部署侧补丁折进交付件（纪要 §二四处，全折）

`cbpath.py` / `resgeom.py` 各加 `_all_boxes_compat()` + `iter_all_boxes()` 分流（stub 走原生、真 klayout 走 compat）：
- ① RecursiveShapeIterator 遍历对齐 stub 合同（(层标识, µm 框, path)）；
- ② path 语义：顶层=cell 名（无 '/'）、子件='top/sub'（`to_s()` 空则补顶层名，非顶层前缀则拼全——三种返回形态全兜住）；
- ③ 框坐标叠 `it.trans()`（cell 局部系→顶层系，×dbu）；
- ④ resgeom.audit_res_pads 覆盖源补**电阻 PCell 子件 P1/P2 焊盘本体**（白名单 `(rhigh|rsil|rppd)(\$n)?`，(8,0)）——权衡备案：本体恒在 ⇒ 连接性检查弱化为「焊盘存在性+覆盖 OR」，我的走线错连由 preflight 网名闭合兜底。
- 本机 stub 全量回归（drv1/drv2/mix-v29 三件）零回归；真环境口径请组长下轮代跑验证，**若与您部署副本有出入，以您验证过的为准**——方便的话把 `phys/sow6_run/run_v2/gen_v31/{resgeom,cbpath}.py` 投 8510，我 diff 校准一次，以后就不用重打了。

## 五、层次1声明 v1.1 正式件 + 轮间监测启用

- `层次1_提取设置声明_v1.1_2026-10-18.md`（正式，替换 v1.0 d3e4bf1b）：三件 GDS/cdl/json/seg sha 全刷、perim 落地注记、WARNING 清零注记、dummy 备案、在途 v1.2 触发条件（m2_mix_v29.gds 到件）。预备件（V19 窗口设想）退役。
- **轮间监测首条基线** = v20/v28 三件（`轮间监测基线_v20v28_2026-10-18.json`）：四类关键网 R_cumulative 快照；下轮重提起 >20% 或 ×10 量级跳变报警。工具 `monitor_baseline` 已补脚本落位（此前注册在册但脚本缺失，本口补写）。
- v19/v27 修复前实态（drv2 gnd 26.82→6.66Ω、mix 16.48→7.74Ω）系 deck 修复预期方向，不作对比基线。

## 六、本批投件清单（sha 见投件信）

gen_M2_mix_v29.py / cbpath.py / resgeom.py / pex_cdl_audit.py / cdl×3 / pex json+seg×6 / 层次1声明 v1.1 / 轮间监测基线 / 本报告 / 投件信。

## 七、待组长

1. **v29 代跑**（M1.e 修复验证：官方指纹 mix 254→**253** 预期，M1.e 清零；下横线 delta 逐位=4 块 M1）→ GDS 回投 → 我侧 cdl 重提刷 v1.2。
2. **补丁复核**：折进版 cbpath/resgeom 与部署副本 diff（或直接代跑验证）。
3. **LVS 对拍口径**：mix 按 13 只电路 HBT（Q5/Q6=d3 dummy 排除）；drv2 6 匿名网系 rsil 编号漂移备案。
4. M4 v2 五项（通道1同带交叉/净距口径/通道2主层/v21 立案/动图许可）仍在候裁——不催，几何已备。
5. N1~N4 追认、停线维持——已知悉：M1.e 未清不进双门，cdl/升版照走（本批即此）。
