oppry12102/WIFI7-TX/06_layout_design_notes/v20回改执行报告_2026-10-18.md

# v20 回改执行报告 — 15 项全落图 + 清单外新发现 5 项（三证据实锤）

**b7e7** · 2026-10-18 15:5x 本地 · 状态：三件 gen 落图完毕，本机 20 项自检 + 新增两道全板机检全绿，候组长侧 klayout 代跑 GDS → LVS×v3/v4 对拍

---

## 一、交付件（本批）

| 件 | 说明 |
|---|---|
| `gen_M3_drv1_v20.py` | Board=TX5G_M3_DRV1_V20；①Re P2 焊盘真值出脚 ②XQr C=B 绕 E 指列 |
| `gen_M3_drv2_v20.py` | Board=TX5G_M3_DRV2_V20；①②同上 + ③ccas 下横段上移 ④ccas 竖段 M1→M2（清单外） |
| `gen_M2_mix_v28.py` | Board=TX5G_M2_MIX_V28；①②镜像组/XQs C=B 绕行 ③rfop/rfon 通道 ∓15→∓16.2 ④ntaila 轨改锚焊盘真值（③④清单外） |
| `cbpath.py`（新内核） | C=B 绕 E 指列三段折线 + `e_pad_rects` 真值 + `audit_board_e_pads` 全板机检 |
| `resgeom.py`（增补） | **焊盘真值表**（锚相对系）+ `audit_res_pads` 焊盘覆盖机检 |
| `emitpath.py`（增补） | `place_emit_chain(p2_pad=…)` 焊盘真值出脚 + 未给真值时大声告警 |
| `drv2_subckt_LVS输入_v4.sp` | `RRin1/2 inp/inn **0**`（真短并域化石回改）+ `.subckt` 名升 V20 |

自检口径：`check_layout_gen`（20 项 + ⓪库 sha 闸）三件 **全绿 0 issue**；落柱 drv1 38/0、drv2 98/0、mix 102/0 悬空。

## 二、清单内 15 项执行状态（12 处独立修改点）

| 清单项 | 修改点 | 状态 |
|---|---|---|
| C=B 竖线真短 ×8 | mix XBI1.XQr / XBI2.XQr / XQs + drv1 XBI.XQr + drv2 XBI1~4.XQr（同列 C=B 竖线穿 E 指底座 0.4665µm²）| **全部改 `cbpath.cb_tie` 三段折线**：B 带心 → 逃逸列（±1.2，净距 0.70µm ≫ M1.b 0.18）→ 上引 → C 列。落线即自证（与 E 指底座重叠必须为 0，机检在案）|
| nx 小管 3 只 | 即 mix 的 #1/#2/#3（与真短 8 案中 mix 3 只同体——清单计数重复，独立修改点实为 12 处）| 同上 |
| R P2 断路 ×4 | drv1/drv2 Re1/Re2 | **先 mkres 后 chain + `p2_pad` 焊盘真值入参**，stub 从盘心起画（重叠半个盘高）；机检 `audit_res_pads` 全覆盖 ✓ |

## 三、清单外新发现 5 项（本批一并落图，候追认）

全部由本批**新增两道机检**当场抓获（旧自检台对此盲——PCell 内部 M1 不进仿真层，盲区第三例的直接后果）：

| # | 缺陷 | 证据链 | v2.0 修法 |
|---|---|---|---|
| N1 | **drv2 ccas 竖段横穿 XQ3/XQ4 的 B 带**：B 带是全宽 M1 条（真 GDS x[锚−9.3,锚+9.3]），M1 竖线从 XQ1.C 高度直上 XQ3.E 高度必穿 → **ccas↔nbcas 真短 0.5µm²**。旧 ⑤c 的「外折 4µm 让开」只躲开了仿真层引脚标记盒 | 真 GDS 逐位（板级 M1 (−20.5,179.24~−19.5,189.99) × B 带 (−33.3,188.74~−14.7,188.98)）+ pex 五名域 `['ccas1','ccas2','e1','e2','nbcas']` 34 M1 块 + 源码 | 竖段 **M1→M2**（B 带=M1、目标 E 脚=M2，跨带无碍）；下端 cross 换层，E 落地段 M2 本层直落 |
| N2 | **drv2 ccas 下横段削进本管 E 窗顶 0.03µm**（1µm 高以 C 带心为轴，下缘 [带底−0.28]）→ ccas↔e 真短（每窗 0.0105µm²）| E 窗审计 + 真 GDS 同坐标 | 横段上移：底边 = C带底+0.18 |
| N3 | **mix rfop/rfon 竖轨（旧 ∓15）横穿 XQ3/XQ4 的 B 带**（B 带全局 x[−15.575,−4.375]，∓15 在其中）→ rfop↔lopd/lond 真短；且削最外指 E 窗 0.10µm → rfop↔nsw 真短。pex 42 域 `lond\|lopd\|nswa\|rfon\|rfop` 并域的几何实锤 | E 窗审计 + 真 GDS + pex | **通道 ∓15 → ∓16.2**（距带沿净距 0.475µm）；Ct 端子/TOPM1 竖轨/M1↔TM1 柱随参联动 |
| N4 | **mix ntaila 轨断**：30Ω 落 rsil 长条 l=4.2857，lib 锚点在盘**下方** 0.236µm，旧轨（锚±0.15）顶边距盘底差 0.086µm → Re1a/Re2a.P2 直流断路 | pad 审计 + 焊盘真值表 | 轨高 = 盘心 = RE_A_Y+l+0.40；补锚点→焊盘短竖桩（⑫ 极性锚在 lib 标记点上） |
| N5 | （drv1 RL1.P2 曾被本机第一版审计误报 0.02µm 断——**系我方真值表坐标系错**，非版图缺陷；按 pex 端子坐标重锚后消。教训已写进 `audit_res_pads` docstring，此处存档防重蹈）| pex 五点重锚 | 几何零变更 |

**pex 五名域的归属订正**：`['ccas1','ccas2','e1','e2','nbcas']`（34 M1 块）与 `['lond','lopd','nswa','rfon','rfop']`（42 域）此前记为「deck 幻影焊呈现」——N1~N3 证明其中 **ccas↔nbcas、ccas↔e、rfop↔lopd/lond 至少三座桥是真实几何**，不是（只是）幻影。deck 修复版重提后这些并域**不会**全部消散——LVS 重提期判读请把它们记「真短预期项」（同裁定十二 ③ 的口径），v20 后重提若仍见此二域 = N1~N3 修复未生效的信号。

## 四、焊盘真值表（本批的地基，pex 五点逐位验证）

**坐标系纪律：一律相对 mkpc_at 锚点（= P1 焊盘中心），不拿 cell 局部系**（第一版踩坑已订正）：

| model | pad1（锚相对 y） | pad2（锚相对 y） | pad x（两脚同） | lib 锚点 vs 盘（l=1） |
|---|---|---|---|---|
| rsil | ±0.13 | [l+0.27, l+0.53] | 锚 ± (w−0.04)/2 | 1.56 vs 盘顶 1.53 ⇒ **+0.03 悬空** |
| rhigh | ±0.13 | [l+0.43, l+0.69] | 同左 | 1.56 ∈ [1.43,1.69] 盘内 |
| rppd | ±0.15 | [l+0.41, l+0.71] | 同左 | 1.56 ∈ [1.41,1.71] 盘内 |

验证点（pex_extract 读真 GDS 端子坐标）：drv2 v19 的 rsil(172.40)/rhigh(9.56)/rhigh$1(21.75)/rppd(10.48)/rppd$1(206.00) 五点全中。
**此前报告口径订正**：「rsil 档引脚距 1.40」的**结论**对（盘心=锚+1.40=l+0.40）、论据表述已按锚相对系重写；「0.03µm 缝」数字维持成立。
HBT 侧：E 指窗 = (8,0) 金属，x = 锚±0.35（指阵列**以锚为中心**，指距 1.85；Nx=10 的 ref origin=锚−8.325），y∈[锚−0.785, 锚+0.77]。

## 五、检测力证明（新机检不是摆设）

对**未修复**的 v19 注入同款机检（`/tmp/gen_v19_audit_proof.py`，仅加登记+审计、零修复）：
- E 窗审计当场命中：`XBI_XQr 竖线 × E 窗 = 0.4665µm²`（与真短定谳的数字逐位一致）；
- 焊盘审计当场命中：Re1.P2 / Re2.P2（已知 2 条断路）。
三件 v2.0 则全部零命中 ✓——「同普查脚本零命中」自证判据在**源码级**先行闭环（GDS 级待组长侧 klayout 代跑后用 `dryrun/pex/diag_true_short.py` 复核，口径同真短定谳）。

## 六、cell 名升版计划（L93⑨ / L94⑥ 回答）

1. **本轮已升**：GDS 顶层 cell 名 = Board 名 = 文件名三元联动：
   `TX5G_M3_DRV1_V20` / `TX5G_M3_DRV2_V20` / `TX5G_M2_MIX_V28`（mix 的 M2 序号沿用件内历史版本号 v2.x 系，顶层名 V28 = 全局回改轮次，避免与 M3 的 V20 混淆——若组长裁定「三件顶层名统一 V20」我下轮改，一行的事）。
2. **对拍基准名**：`drv2_subckt_LVS输入_v4.sp` 的 `.subckt/.ends` 已同步 `TX5G_M3_DRV2_V20`（align 按名配对硬条件，v3 的 V14 名会配不上新 GDS）。
3. **今后纪律**：每轮回改轮次号 +1 且三处（Board 名 / 文件名 / 网表 .subckt 名）同轮次；M4 顶层组装时子实例名带轮次后缀（`_v20`），由 gen_M4_top 的实例名参数化（M4 v2 开画时落）。
4. **历史包袱**：组长侧现役 `m3_drv1_v19.gds` 内顶 cell 名还是 V16（老代跑产物）——v20 起以 Board 名为准重生成，旧件自然作废，不需清洗。

## 七、主闸门状态与 ETA

- 我侧：三件 gen + 两内核 + v4 网表 **已备齐**（本批投 8510）。
- 候组长：klayout 代跑三件 → GDS×3 回投 → 我侧 pex_extract(TERM_LAYER) 复跑 + audit 六判据 + diag_true_short 复核（GDS 级自证）→ cdl 重出升版 + 层次1声明 v1.1 刷表；组长侧 LVS×v3（drv1/mix）+ ×v4（drv2）对拍。
- **判读预期**（重提期预期中间态，非回归）：真短 8 案连通 FAIL 消失；R P2/ntaila 悬空 FAIL 消失；**N1~N3 三座真桥若仍呈并域 = 修复未生效信号**；其余在案残留照旧。
- 27 角点火：按裁定十二 ⑤，v20 重提双门过 → 点火（预授权顺延至 v20）。

—— b7e7 · 2026-10-18
