oppry12102/WIFI7-TX/06_layout_design_notes/出数纪要_B批_v31双门全过_2026-10-18.md

# 出数纪要 · B 批（v31 PEX cdl ＋ typ 单角全链闭环）＝**双门全过**

- 出数：2026-10-18T13:42Z（跑 13:26:52Z → 13:42:50Z，全量程 2.5 µs）
- 授权：b7a0 **裁定四十四 §三 B 批启动令**（＋ 裁定四十三 §四 收编断言器为验收件）
- 目录：`/data/workspace/sow6/m5/run_b_v31/`
- 结论：**门1 A0′ PASS（但该门在本 deck 上无鉴别力，见 §四）＋ 门2 |CG| PASS；与格4 双路互证至 2.1e-07 dB**

## 一、读数（判读单源 `m5_parse_pex_tran.py`，sha `e2d8ec12…`）

| 量 | 值 |
|---|---|
| **CG_chain_dB** | **17.45103049525866** |
| 锚 | 17.4465 |
| **Δ vs 锚** | **+0.0045304952586597835 dB** |
| 门 | 0.05 dB（Δ/门 = 0.0906） |
| **判定** | **PASS — 门内** |
| CG_mix / CG_drv1 / CG_drv2 | −3.225490417189409 / 11.955420362854731 / 8.721100549593338 |
| sum_check_dB | 17.45103049525866（与 CG_chain 逐位一致） |
| chainout_tail_pp_V | **0.9250643128616063**（全量程 ⇒ 尾段值**可得**；格4 短窗为 `null`） |
| points_in_window / raw_points_total | 500000 / 2440001 |
| raw | `tran.raw` 136,640,458 B，sha `ba5226d7d23e248248a57f9a27af63a967c66c0bd1f55c86084790e53af48f99` |
| deck | sha `a87d3704da0813681dc042dc80ccdc9c9e47e4eda19eb6104471a26d45169a26` |

**落点与预期一致**：裁定四十四 §三 预期 ≈ 17.4510 ± 噪声 → **实测 17.451030495**，正中预期。

## 二、双门

- **门2 动态对拍**：`|CG − 17.4465| = 0.0045305 ≤ 0.05` ⇒ **PASS**。
- **门1 A0′（.op 对基线 v2）**：六接口探针 `noutp/noutn/nmixp/nmixn/nd1p/nd1n`
  两侧读数**均 2.5 V**，`|Δ| = 0.000e+00` ⇒ `A0′ = 0 ≤ 1e-5` ⇒ **PASS**。

## 三、与格4 的双路互证（本批最重要的一条）

| | 格4（PEX＋**自造网** `nrefa`，短窗） | B（PEX＋**真件网** `nref`，全量程） | 差 |
|---|---|---|---|
| CG_chain_dB | 17.451030705340 | **17.451030495259** | **2.101e-07 dB** |
| CG_mix_dB | −3.225490190 | −3.225490417 | −2.27e-07 |
| CG_drv1_dB | 11.955420365 | 11.955420363 | −1.75e-09 |
| CG_drv2_dB | 8.721100531 | 8.721100550 | +1.85e-08 |
| 窗内点数 | 500001 | 500000 | 1（端点） |

⇒ **两条独立路径（我自造网的格4 vs 提取器真网的 B）在 CG 上互证到 2.1e-07 dB（相对 1.2e-08）**。
`B − 格3 = +2.942468022 dB`（格4 的 `+2.9424682316`），同样互证到 2.1e-07 dB。

**这一条同时否掉了 b7e7 预估的「非对称 R 微差 0.085Ω ≈ 0.02%」在 CG 上的可见性**：
若 R 级差真按 0.02% 出现在 CG 上，两路差应在 1e-3 dB 量级；实测 2.1e-07 dB，比 0.02% 小约 **5 个数量级** ⇒ 该微差对 CG **不可见**（不构成判据风险）。

## 四、★ 一条必须上报的门限观察（我未改门限）

**门1 A0′ 在本 deck 的 `.op` 上没有鉴别力**：

- 六个接口探针在**四个跑件里全部读 2.5 V**（B、格3 未修、格4、基线 v2 前仿）——四者完全一致。
- 激励/电源侧节点 `nvcc` / `nifp_t` / `nlop_t` / `nlon_t` 也**逐位 Δ = 0**。
- 真正有差异的是**器件内部结温节点** `xmi.xq5.t`、`xmi.xq6.t` 等：B 读 `7.07e-22 °C`、基线 v2 读 `21.94 °C`（\|Δ\| ≈ 21.94）。
  这是**每指自热**差异（PEX 面器件指数量/nx 与前仿不同），不是直流工作点漂移。

⇒ **A0′ = 0 是「真 PASS」，但它通过的原因是 `.op` 下这些节点本来就被源/轨钳住**，不是「修复把扰动压下去了」。
**我没有改门限、没有改探针口径**，只把这条事实报上来，请你判断 A0′ 是否需要换更细的探针集（如 `xmi.ntaila`、`xmi.ntailb` 之类尾源电位）。

## 五、断言器（前置硬门）

- 对 `pex_mix_v31.cdl`（sha `f6ba9560…`）：**4/4 全过**。
- **首次跑只过 2/4**（报「0 条与尾源相关器件」）。查明**是我的断言器两处形态假设错**，非 b7e7 的件有问题：
  **T8** 提取器 cdl 走「X→Q / R→3T」规则 ⇒ 行首是 `Q7…`／`R5…`，而我的取件按 `^X[QR]` 过滤 ⇒ **静默取到 0 条**；
  **T9** v31 起两侧**共用字面网 `nref`** ⇒ 侧器件集互相污染、`normalize()` 只替换本侧尾源名 ⇒ **A3 假未过**。
- 两处已修（**A1–A4 判据定义一字未动**，只改取件与归一化）；
  **回归自测双向仍可用**（v34 缺陷件判未过、合成修复件判 4/4）。
- 脚本 sha `64ae84a4…` → **`46d14d51d782ace2…`**（已向 b7a0 报备）。两条已入 runbook v2.15 §3.3。

## 六、跑件构成与收尾

- 跑件 `chain_top_tb_v015_1_pex_v31_b.sp` sha `b0c9795efde937025511fa8eb9a9ced454828ec80b7a39108ad203d2c838f5dd`
  ＝ PEX 锚 `99307f45…` ＋ `gilbert_mix` 内 **3 行乙补丁**（`XQ7/XQ8/XR5` 的 `ntaila`→`nref`，逐字取自 cdl 实件）
  ＋ **1 处 `write` 重定向**；**变更行恰 8，无第四处**；**`save`/`tran` 一字未改（全量程）**。
- **现役件逐字未动**：跑后复核 PEX 锚 `99307f45…`、前仿锚 `2d73c174…` 均未变。
- **收尾已做**：`pdk/sim/v015_1/` 的跑输入副本**已删**（deck sha 现命中恰 1 个文件，溯源闸满足）；
  `run_b_v31/SHA256SUMS.txt` **已写**（8 件）。

—— fde9 2026-10-18
