oppry12102/WIFI7-TX/06_layout_design_notes/出数纪要_基线v2_惰性第四路坐实_2026-10-18.md

# 出数纪要 · 基线 v2（裁定四十二 §三 A1「坐实跑」）＝**惰性第四路坐实**

- 出数：2026-10-18T13:16Z（跑 13:00:56Z → 13:16Z，全量程 2.5 µs，约 15 min）
- 目录：`/data/workspace/sow6/m5/run_basev2/`
- 性质：**PASS（门内）**。本件只报数，不下结论之外的动作。

## 一、读数（判读单源 `m5_parse_pex_tran.py`，sha `e2d8ec1200b0580d930af13759c5218f0f74b92f13803ee90db1e441d5d6f3a5`）

| 量 | 值 |
|---|---|
| **CG_chain_dB** | **17.4464891235082** |
| 锚 `anchor_dB` | 17.4465 |
| **Δ vs 锚** | **−1.0876491799649557e-05 dB** |
| 门 | 0.05 dB（Δ/门 = 2.175e-04） |
| **判定** | **PASS — 门内** |
| CG_mix / CG_drv1 / CG_drv2 | −3.2247401138165577 / 11.95235643869994 / 8.718872798624815 |
| sum_check_dB | 17.446489123508197（与 CG_chain 逐位自洽） |
| chainout_tail_pp_V | 0.9245487867630922 |
| points_in_window / raw_points_total | 500000 / 2440001 |

**单源复算**：runner 自带 parse.json 与我另跑 `m5_parse_pex_tran.py` 得到的
`parse_single.json`，**七个字段逐位一致**（CG 同为 `17.4464891235082`）⇒ **parse 确由单源产出，无薄封装介入**。

## 二、这跑的构成（逐条核对，无第四处）

| 项 | 值 |
|---|---|
| 源 | 前仿锚 `chain_top_tb_v015_1_typ.sp` sha `2d73c174f28fcc36377577ab31211f3dbff16b5a1eae3ff37ad0864d75cc1028` |
| 跑件 | `run_basev2/chain_top_tb_v015_1_typ_basev2_70n900n.sp` sha `17784f4be970126cbaff8d8fa97482a5c88e69d842152ae4b046fbb9d03bed28` |
| 变更 | **增 23 / 删 23**，恰为 **22 条 npn13G2 实例 in-place 追加 `we=70n le=900n`** ＋ **1 处 `write` 重定向** |
| 现役前仿件 | **逐字未动**（跑后复核 sha 仍 `2d73c174…`） |
| raw | `tran.raw` 195,200,525 B，sha `9a613ad9ebabaa4d2994f9081ff656c4e333b87396e07f4fae9feb812af56ab4` |
| deck | sha `7016dd4b990b0992db716b8566932a12066ef2330c2f8092799bb66c64a3839c` |

**收尾动作已完成**：① `pdk/sim/v015_1/` 里的跑输入副本**已删**（该 sha 现全 workspace **命中恰 1 个文件**，溯源闸满足；canonical 在 `run_basev2/`）；② `run_basev2/SHA256SUMS.txt` **已写**（7 件）。

## 三、明写的备否证：**≡ 锚 ⇒ 惰性第四路实证落档**

预先在 note230/233 写死的判读：等 17.4465 ⇒ 惰性论证成立；≠ ⇒ 惰性论证有漏、我重审。
**实测 17.4464891235，≡ 锚（门内）⇒ 备否证未触发，惰性第四路坐实。**

## 四、三点如实交代（不粉饰）

1. **锚是 4 位小数存值**：`17.4465` 还原区间 `[17.44645, 17.44655)`，实测值落在区间内。
   ⇒ **Δ = −1.09e-05 dB 主要是锚自身的舍入残差**（4 位小数最大舍入残差 5e-05），
   **本跑无法在 1e-4 dB 以下与锚分辨**。这是锚的存值精度所限，不是电学差。
   *Q 档位惰性的更硬证据仍是 (i)*：PEX 面 136 MB 载荷**逐字节恒等、Δ_Q档位 = 0.000000 dB**。
2. **窗口径复核（已查实，结论：可比）**：判读单源第 39 行 `t0w, t1w = 60e-9, 560e-9`，
   CG 一律在 **[60,560] ns 稳态窗**上算；`tail = (t >= 2.4e-6)` **只喂 `chainout_tail_pp_V`**。
   ⇒ 全量程件与短窗件的 **CG 口径完全一致**，格4 与锚可直接比。
   （短窗 raw 无 2.4 µs 段 ⇒ `chainout_tail_pp_V = None`，如实记 null，未编造。）
3. **1 个端点样本的口径微差**：格4（短窗）窗内点数 **500001**、本跑（全量程）**500000**，
   差的是 t=60 ns 端点那一个样本。量级 ≪ 门限，但**格4−锚 = +0.00454 dB 里含这一项**，
   记此备查（不影响 ≤0.05 的闭环判定）。

## 五、我侧五格总账（同一判读单源、同一锚 17.4465）

| 格 | 面 | CG (dB) | Δ vs 锚 | raw 点数 |
|---|---|---|---|---|
| 格1/锚 | 前仿 typ | 17.44650000 | 0 | 2,440,001 |
| **基线 v2** | **前仿 ＋ 22 条 we/le 注入** | **17.44648912** | **−1.09e-05（PASS）** | 2,440,001 |
| 格2 | 预测（惰性等价，非实跑） | 17.44650000 | 0 | — |
| 格3 | PEX 99307f45 原样 | 14.50856247 | −2.93793753 | 2,440,001 |
| (i) | PEX ＋ we/le 120/960 | 14.50856247 | −2.93793753 | 2,440,001 |
| 格4 | PEX ＋ 3 行 nrefa 补丁 | 17.45103071 | +0.00453071（门内 PASS） | 500,001 |

⇒ **惰性第四路（基线 v2）已落档**：Q 档位面差 Δ = 0.000000 dB（PEX 面逐字节恒等）
且 **前仿面显式写档同样不动 CG（|Δ| = 1.09e-05，门内）** —— 两条独立路径同向。

—— fde9 2026-10-18
