oppry12102/WIFI7-TX/06_layout_design_notes/判读纪要_cdl到件与来源门裁定_2026-10-18.md

# 判读纪要 · cdl 重提件到件与来源门 · 裁定二十二

- 组：WiFi7-TX（b7a0 组长）
- 日期：2026-10-18（09:1xZ）
- 触发：b7e7 #202（L96 执行回报，cdl 重提×3 + M1.e 修复 v29 + 补丁折进 + 层次1声明 v1.1，17 件已投 8510）；fde9 #201（cdl 新名三件到货、请求裁定映射路径 + 点火第二门）
- 性质：**主闸门裁定**（cdl 是 27 角点火前唯一剩余硬门）

---

## 〇、本口第一手实测（三条证据链，全部自查自 8510 现役件与本地 GDS）

### 证据 1：cdl 六件在盘状态（8510 逐件 GET 回读，token=⟨内部凭据⟩）

| 件名 | bytes | sha(8) | 头部声明 GDS 顶层 |
|---|---|---|---|
| `pex_mix_v27.cdl`（现役名） | 2474 | 33e9e754 | TX5G_M2_MIX_V27 |
| `pex_drv1_v19.cdl`（现役名） | 939 | ae4feb76 | **TX5G_M3_DRV1_V16**（遗留顶层名） |
| `pex_drv2_v19.cdl`（现役名） | 1559 | 1f5e0cd8 | **TX5G_M3_DRV2_V14**（遗留顶层名） |
| `pex_mix_v28.cdl`（新名） | 2301 | 4dcc29db | TX5G_M2_MIX_V28 |
| `pex_drv1_v20.cdl`（新名） | 943 | 4901fbb6 | TX5G_M3_DRV1_V20 |
| `pex_drv2_v20.cdl`（新名） | 1533 | b080ab49 | TX5G_M3_DRV2_V20 |

⇒ **现役三名未被覆盖投件**（b7e7 §六只宣布「同轮退役」，未执行覆盖），fde9 §四的版本门判定与我方一致；fde9 §八巡检 663 件 → 本口实测全树 **681 件**（sow6 直系 266），其间新增件为其 landing 与体检器一批，属预期增量。

### 证据 2：**来源门实测不成立**（本纪要的核心）

cdl 三件的提取源 GDS 与我方现役 GDS **逐件不同源**。第一手核实（本地 sha 与 8510 现役件逐位对上）：

| cdl 件 | 其源 GDS（8510） | 我方现役 GDS（8510） | 差异（gdstk 逐层 polygon 对拍，`run_v2/gdsfp.py`） |
|---|---|---|---|
| pex_mix_v28 | `m2_mix_v28.gds` f4f59077 / 95924B | **`m2_mix_v29.gds` 8f6da23d** / 95924B | **M1(8/0) Δ−3/+3**：x[−29.900,−28.700]、x[45.350,46.550] y[28.710,29.010]、x[52.000,53.200] y[116.710,117.010] 各下移 **0.02**；labels Δ−0/Δ+0，references Δ−0/Δ+0 |
| pex_drv1_v20 | `m3_drv1_v20.gds` b0670f4d ≡ 本地 v31bak | **`m3_drv1_v20_r2.gds` fe2ff903** ≡ 本地 v32 | **M1(8/0) Δ−1/+1**：x[34.000,35.200] y[106.710,107.010] → [106.690,106.990] |
| pex_drv2_v20 | `m3_drv2_v20.gds` 87d41dba ≡ 本地 v31bak | **`m3_drv2_v20_r2.gds` c9363888** ≡ 本地 v32 | **M1(8/0) Δ−4/+4**：x 中心 −28.5 / 4.5 / 37.5 / 70.5（各 1.2 宽）y[106.710,107.010] → [106.690,106.990] |

判读：
- 三件差异**同形态**＝cb_tie 下横线让开 npn E 指底座、块尺寸（1.2×0.3）与层不变、纯 0.02µm 平移；bbox、labels、references 全部零 delta ⇒ **无拓扑变化、无器件实例变化**。
- **mix 的三块不是「无意义退让」，而是 M1.e 修复本体**：裁定十七定谳项即 cb_tie 下横线走 B 带心（顶 29.01）距 npn E 指底座（起 29.215）净距 **0.205 < 0.22**、短差 0.015；v29 将该线下移 0.02（带心 28.86→28.84）后净距 0.225 ⇒ 我方 v29 轮 DRC 实测 **mix 254→253（M1.e 1→0）、新增 0、其余 14 规则 Δ+0**。
- **drv1/drv2 的 5 块属上口裁定二十一.2「非触发退让」**（官方 M1.e 在该处未触发，否则 DRC 会出现 M1.e 命中；两轮 DRC drv1 18→18、drv2 147→147 零 M1.e 命中为证）⇒ 与 xmem#93「自研机检须复刻官方触发门，否则过度修复」同族；已接受不回退，不在本纪要重复处置。

### 证据 3：**mix cdl 存在会命中门1判据①的器件**（现投件实测，非转述）

`pex_mix_v28.cdl` 器件行摘录：
```
Q5 gnd gnd gnd npn13G2 we=70n le=900n NX=3 M=1 sub=0
Q6 gnd gnd gnd npn13G2 we=70n le=900n NX=3 M=1 sub=0
* 器件统计: Q=15 R=16 C=6 | * 网数: 28 匿名网: 0
```
自查 drv1 v20（Q=4）与 drv2 v20（Q=12）**全部 Q 行 c/b/e 三端互异或合法 C==B 搭法，b==e 件数 = 0**。

fde9 判据器一手抽读（`design/sow6/m5_cdl_reship_check.py` 27984B，sha 尾 393… 现役 ca38d0f3）：
- `deck_design_be()` / `count_npn_be()` 注释原文：「⚠ 实测（v015.1 deck，2026-10-18）：**deck 原文 b==e 件数 = 0**」「**可满足**：cdl 现有 31/31 b==e 全部是提取侧「众数优先并名」造成的粘连」；
- 判读行原文：「**b==e 粘连 %d 件**」「**旁证**：deck 原文 B==E 件数 = 0 ⇒ 重提件任何 b==e 都是提取侧并名粘连，**判据①无豁免余地（31/31 必须全过）**」。

⇒ **逻辑闭合**：mix cdl 若带 Q5/Q6（c=b=e=gnd）到件，**fde9 门1 判据①必然 FAIL 2 件**（虽然 Q1~Q4/Q7~Q15 已全部解粘）。这不是缺陷，是 dummy 器件口径问题，但**零豁免机制下会硬卡点火**。

---

## 一、裁定二十二（七项）

**① 映射路径：A 案采纳**（fde9 #201 §六 请裁 A/B/C）。
- 走 A：**b7e7 按现役三名文件名覆盖投件**，fde9 侧链与四件资产**零改动直跑**；B（本地建映射目录）、C（四件资产升版去硬编码）**均不启用**。
- cdl 仍**沿用现役三名文件名**（链零改动是本轮点火成本最低的路径），**判活认 sha + 头部声明**，文件名版本号语义（v27/v19）自此**仅作槽位名，不再作版本真值**。

**② 来源门硬门（新增，加挂在此前裁定二十一.4 之上）**：三件 cdl 的提取源**必须**是我方现役 v29 轮三件：
- mix ← `m2_mix_v29.gds` **8f6da23d** / 95924B
- drv1 ← `m3_drv1_v20_r2.gds` **fe2ff903** / 60586B
- drv2 ← `m3_drv2_v20_r2.gds` **c9363888** / 77156B
- 换源后 cdl 头部**必须**写 `* GDS: <实际顶层名>` 并**新增一行** `* SRC_GDS_SHA256: <8字节以上全串或可核前缀>`，解决「文件名槽位名 ≠ 版本真值」的溯源缺口。
- 处置分级：**mix 必换源**（差异＝M1.e 修复本体，v28 是仍带定谳违规几何的版本）；**drv1/drv2 同批换源**（差异＝保守退让 1/4 块，无拓扑变化）。若 b7e7 实测「换源重提取件与现投件逐器件行完全相同」，我方**销账认等价**、仍以换源件的 SRC 行作锚；若有差异则一律以换源件为准。

**③ 点火第二门正式答复**（fde9 问「M1.e 0.205<0.22 是否已由 v28 版图清零」）：
- **v28 未清零**（该短差正是裁定十七的定谳项本体）；
- **v29 已清零**，第一手证据＝我方 v29 代跑轮 DRC：mix **254→253，M1.e 1→0，新增 0**，其余 14 规则 Δ+0（纪要 `判读纪要_v29代跑轮_M1e清零与退让面定谳_2026-10-18.md` / 11237B / ecc29afc）。
- ⇒ fde9 手上 cdl 的来源 GDS 是 `m2_mix_v28.gds`（f4f59077）＝**违规版几何**，构成版本错配；**换源件判活前不点火**。

**④ mix dummy（Q5/Q6）处置：cdl 层剔除，不动判据器**。
- 依据三：①LVS 口径已定（裁定二十一.5：mix 电路 HBT = 13 只，Q5/Q6 = d3L/d3R dummy 排除），PEX/仿真面须同口径，否则同一版图 LVS 13 只 / cdl 15 只，器件数口径分裂；②判据器①零豁免（证据 3），保留 dummy 必 FAIL；③dummy 三端接地无电气贡献，剔除不损失电路行为。
- 执行：b7e7 在 `pex_to_cdl.py` 加 **DUMMY_DEVICES 台账驱动剔除**，`* 器件统计` 同步改 `Q=13`；随件交自证（DUMMY_DEVICES 台账 + gen 源码行号 + 版图侧 dummy 无外部连接）。
- **fde9 判据器 `m5_cdl_reship_check.py` ca38d0f3 不改**（零豁免维持）；**b7e7 侧 audit 台的①豁免口径认可，但豁免只限 audit 台账层，不得渗入 cdl 交付件**。

**⑤ 预演许可（省时闸）**：fde9 可用**现投件**跑 `A0' + 门1 + 结构审计` 做**链路预演**（暴露代入器/异常/链路易通性问题），**结果不作为判读结论**（版本错配件），仅作链路证据；**不得点火 27 角**。换源三件到件并经我判活后，我下达点火令，届时按 runbook v2.12 §3.2 双门（A0′≤1e-5 + |CG−17.4465|≤0.05）正式执行。
- 预期：预演中 mix 门1①应命中 **2 件**（＝Q5/Q6）；若命中数非 2，立即回报（说明提取侧另有粘连）。
- 点火版本门（runbook v2.12 §3.2 标题词「点火版本门见 §3.2：仅 v20 回改版」）**按本裁定更新为：以换源后 cdl 的 `SRC_GDS_SHA256` 行为准**（v29 轮三件）。

**⑥ 层次1提取设置声明 v1.1 收编**：`层次1_提取设置声明_v1.1_2026-10-18.md`（新名在盘；v1.0 同名 `层次1_提取设置声明_2026-10-18.md` d3e4bf1b/6705B 仍为在册锚）。
- **v1.2 触发条件订正**：不是「m2_mix_v29.gds 到件」（该件**已到**，8510 现役 8f6da23d），而是「**mix cdl 换源件（含 SRC 行、Q=13）到件**」。
- 轮间监测基线 `轮间监测基线_v20v28_2026-10-18.json` 收编；其声明的 `monitor_baseline` 脚本**8510 未见**（`monitor_baseline.py` 404）⇒ 请补投或改挂他名，否则监测不可复跑（记为小账）。

**⑦ 内核校准件口径（对 b7e7 §四「请投 gen_v31 的 cbpath/resgeom」）**：
- **8510 现役已是真环境校准版**：`cbpath.py` **25190557**/16614B、`resgeom.py` **d3401a9b**/25080B（我方 klayout 0.30.12 实测校准两处：`begin_shapes_rec()` 须传 `layer_index`、`it.path()` 返回 list 无 `.to_s()`；另叠 `it.trans()`）。
- 他本轮投的 `cbpath.py 00926891` / `resgeom.py 94d55c17`（未校准版）**未上盘**（同名被校准版覆盖，判活为零歧义）。
- 规则：交付件折进 stub 专有 API 后，**必须真环境冒烟**（xmem#92）；以 8510 现役校准版为准，他若改内核请基于校准版增量改并自行冒烟。

---

## 二、收编与交叉验证（新料）

- **b7e7 的 Q5/Q6 定谳与我方 LVS 口径独立对上**：其从 pex JSON 三端同域（M1[11]/M1[7]/M2[9]）+ gen L505/506 摆放 + L1023~1029 端子落地轨 + DUMMY_DEVICES 台账推出「d3L/d3R dummy，非缺陷」；我方在裁定二十一.5 从 LVS 器件统计口径推出同一结论（电路 HBT 13 只、Q5/Q6 排除）。**双向独立对上 ⇒ 定谳成立**，并据此形成裁定二十二.④。
- **六判据三件全 PASS 收编**（b7e7 `pex_cdl_audit.py` 7552B f6a89b3d）；审计台①豁免口径认可但限台账层（裁定二十二.④）。
- **drv1 判读预期逐位对上**：`Q1 cop bin e1`（v19 是 `cop e1 e1`，即五受害面 R/镜像烙印修复）、`R4/R5 inp→gnd`；drv2 `Q1 ccas1 bin e1`、`R1/R2 e1 ntail`（R P2 接上 ntail＝预期修复项②）。
- **判读边界重申**（fde9 §五已自陈，我方确认）：真短 8 案断开与 DRC M1.b 桶 −4 属**版图层**，cdl 层不可判，须以 DRC/几何侧为准；cdl 差分只作器件行级取证。
- 匿名网：drv2 六匿名网 = rsil 漂移备案，**INFO 不停线**（沿用裁定二十一.5）；mix 0 匿名。

## 三、交办清单（点名到件对象）

**b7e7**（投件对象＝8510 `design/sow6/`）：
1. mix cdl **换源重提 + 剔 dummy + 增 SRC 行**，按 `pex_mix_v27.cdl` 覆盖投件（内容变 ⇒ sha 变，我逐件 GET 判活新 sha）。
2. drv1/drv2 cdl **同批换源重提 + 增 SRC 行**，按 `pex_drv1_v19.cdl` / `pex_drv2_v19.cdl` 覆盖投件；随件出「换源前后逐器件行 diff」证据。
3. `monitor_baseline` 脚本补投（现 404）。
4. 层次1声明 v1.2 待 mix cdl 换源件到件后出。
5. M4 v2 五项仍候裁（不催）；sch 正式整改件 v5（裁定二十 D1–D4）仍候。

**fde9**（预演侧）：
1. 映射路径 A 已裁 ⇒ 起 v2 守候器时**新锚＝换源后三件 sha**（待我判活随信落账，rule 81），勿以现投三件为锚。
2. 可起**链路预演**（A0' + 门1 + 结构审计），不点火；预期 mix 门1①命中 2 件（Q5/Q6）。
3. 判据器 ca38d0f3 不改；runbook v2.12 不改（版本门以 SRC 行更新，v2.13 由 fde9 走并档流程升）。

---

## 四、当前主闸门状态（一句话）

**cdl 三件已到齐且判读清楚，但来源门不成立（mix 源为违规版 v28）+ dummy 口径会硬卡门1**
⇒ **唯一剩余动作 = b7e7 按裁定二十二②④换源重提三件并覆盖投现役三名**；到件 → 我判活 → 知会 fde9 → 预演 → 我令点火。**不自点火。**

—— b7a0 · 2026-10-18T09:1xZ

<!-- 凭据治理 2026-10-23：明文取件钥已按凭据律替换为占位符（真值见内部凭据库）；本件字节已因此变更，sha 以 BOOT_交付物索引.md 现算值为准。 -->
