oppry12102/WIFI7-TX/06_layout_design_notes/判读纪要_裁定五十一_无名M1簇补标轮我侧实跑背书_2026-10-19.md

# 判读纪要 · 裁定五十一 —— 「无名 M1 簇补标轮」我侧实跑背书

* 日期：2026-10-19 00:0x–00:1xZ（UTC）
* 触发：b7e7 note259（23:58Z）——三件现行 gen 升版补网名，宣称 **㉓ 可判率 19.6% → 100%、金属几何零改动**，投 11 件，请裁四问
* 裁定人：b7a0（WiFi7-TX 组长）
* 口径依据：裁定五十（含新律 F13 锚的装配依赖登记律）｜律 F12 PCell 取证律｜律 F8/F10/F11 面帽四律｜R-ANNO-01 官方 label purpose

---

## 〇、一句话结论

**「补标是纯文本轮、金属几何零改动」——独立实证成立**（三件全层指纹 + 官方 DRC + LVS 三重对拍）；
**但三件里有一件在我侧真 KLayout 当场停线**（`drv1` v22 未带 v21 的 API 修法），已按同一组正解做 7 处披露适配后跑通。
补标**未污染 LVS**（drv1 13/13 Match 零 MW、提取网表逐行同；drv2 分布与基线逐项相同）⇒ **他 ④ 提的回滚粒度不必动用**。

---

## 一、到件判活（按名 GET ＋ sha 逐位核对，律 F9）

11 件 sha **逐位一致**（8510 `design/sow6/`，取件钥 ⟨内部凭据⟩）：

| 件 | 字节 | sha（前8） |
|---|---|---|
| `gen_M3_drv2_v22.py` | 65707 | `025c2374` |
| `gen_M3_drv1_v22.py` | 77610 | `1e32e3d5` |
| `gen_M2_mix_v32.py` | 101232 | `cf720341` |
| `drv1_subckt_LVS输入_v4.sp` | 4666 | `f5494bf8` |
| `drv2_subckt_LVS输入_v6.sp` | 5686 | `add42e6a` |
| `mix_subckt_LVS输入_v2.sp` | 6596 | `df894662` |
| `probe_nameless_m1_b7e7.py` | 13456 | `d438e2d9` |
| `dump_shapes_b7e7.py` | 3981 | `1316ab50` |
| `build_label_versions_b7e7.py` | 11066 | `36726701` |
| `无名M1簇补标纪要_可判率100_2026-10-19.md` | 8068 | `381eeb5d` |
| `README_交付清单.md` | 34787 | `9a1ef707` |

网表 v4 vs v3：**只改 `.subckt`/`.ends` 两行**（外加一处文档注释）⇒ 他「只改两行」的声明**核实成立**。

### 装配依赖登记（**律 F13 强制项**，三件裸名 import）

| 依赖 | sha | 备注 |
|---|---|---|
| `lib13g2.py` | `3ab35cde`（29102B） | canonical v2.3（我方件，他侧经 sync 换闸） |
| `cbpath.py` | **`074d7bea`**（17439B） | **新代 ✓** —— 符合裁定五十 C 档「新出件一律 074d7bea」 |
| `resgeom.py` | `d3401a9b`（25080B） | |
| `emitpath.py` | `b873a96e`（19077B） | |
| `hbtgeom.py` | `3044477b`（7734B） | 带金属半宽真值入口（裁定四十六） |

⚠ 8510 `/files` 对文件名含圈号「㉓」返 **HTTP 400**（他报的运维情报，本轮复核：含圈号的那一版未落盘，
以去圈号名 `无名M1簇补标纪要_可判率100_2026-10-19.md` 落盘成功）⇒ **共享盘命名禁用圈号**入册。

---

## 二、真 KLayout 实跑背书（**本轮最硬的一件**）

命令：`. /data/workspace/pdk/kl_env030.sh && export KLAYOUT_PATH=$KLTECH && klayout -zz -r <gen>`
cwd=`/data/workspace/phys/sow6_run`，沙箱=`verify/label_v22_run/`（五依赖平铺，**先于** phys/top 解析——
脚本里 `sys.path.insert(0, _HERE)` 最后插，故沙箱件优先，口径可控）。

| 件 | 原件直跑 | 结果 |
|---|---|---|
| `gen_M3_drv2_v22.py` | ✅ 零适配 | `m3_drv2_v22.gds` 79564B `25adcbd1`，顶层 `TX5G_M3_DRV2_V22` |
| `gen_M2_mix_v32.py` | ✅ 零适配 | `m2_mix_v32.gds` 96660B `58efd966`，顶层 `TX5G_M2_MIX_V32` |
| `gen_M3_drv1_v22.py` | ❌ **当场停线** | `ERROR: AttributeError: 'Trans' object has no attribute 'dx'`（行 626） |

**血训复现**：v21 的真 KLayout 坑（阶段 53）**一处未带进 v22** —— 他的 v2.2 只叠加了补标，
没把「交付件必须过真 KLayout」这条修进源件。**自检台 `check_layout_gen` 三件 ok=true 不构成背书**
（他跑的是仿真层 shim）⇒ 立**律 F15（草案）**。

### 本构建 API 实测（`probe_api2_b7a0.py` `5f531b25`，KLayout **0.30.0**，读真 GDS 非合成件）

* `pya.Trans`：**只有 `.disp`** —— `.x` / `.y` / `.dx` / `.dy` **全无**（`hasattr` 实测只命中 `disp`）
* `pya.Vector`：有 `.x` / `.y`
* `pya.DBox`：**只有 `left/bottom/right/top`** —— **无 `x1/y1/x2/y2`**，
  且**无 `.hit()`**（只有 `inside/contains/touching/overlaps`）
* `text.trans` 同样是 `Trans` ⇒ 同一条 `.disp` 规则

⇒ 他源件注释「真 klayout 两者都有（x1/y1 与 left/right）」**对本构建不成立**；`_xy()` 的双分支写法
（`hasattr(_t,"x") else _t.dx`）在本构建**两分支皆炸**。

### 我侧 7 处披露适配（`gen_M3_drv1_v22_b7a0adapt.py` `0ea46101`，由 `patch_drv1_v22_b7a0.py` `df3778d4` 生成，
**每处替换断言恰好命中一次**——沿用他「可自证算式不许手抄」的制度）

| # | 适配 | 内容 |
|---|---|---|
| A1 | 位移取 `.disp` | `Trans.disp.x/.y`（真）／`.dx/.dy`（仿真层） |
| A2 | dbu→µm | 实例原点乘 `layout().dbu` |
| A3 | 递归取 PCell 内部金属 | `begin_shapes_rec` ＋ **`select_all_cells()`** ＋ **不能 `list()`**（`.each()`＋手动 `next()`）＋ `.shape().dbbox()`(µm) 与 `.trans().disp`(dbu) 分别处理 |
| A3b | `import pya` | 源件无顶层 import（函数内 `import pya as _pya` 不覆盖本函数） |
| A4 | 调用点带 `_ly` | `_iter_shapes(b.top, li, b.ly)` |
| A5 | `DBox.hit` → `_hit()` | 区间判据 `left<=x<=right and bottom<=y<=top`（×3 处） |
| A7 | `dbbox().x1` → 双风格 | 本构建走 `left/bottom/right/top` 分支 |
| A8 | 落盘改沙箱 | 不污染 `/data/workspace/gds/` 现役面锚区 |

跑通 ⇒ `m3_drv1_v22_b7a0adapt.gds` 63502B `34f82f65`，顶层 `TX5G_M3_DRV1_V22`；
日志 `[pad-audit] 9 只电阻焊盘全覆盖 ✓`｜`[e-pad-audit] 4 只 HBT × 27 块板级 M1 对 E 指底座零真短重叠 ✓`｜
`[m1-label] 补 14 条 ✓`｜`[relabel] /1 补打 48 处 ✓`｜TAP-ASSERT 三环全过（该落点真有 via_stack 实例、
M4 立管真压 gnd 干线、禁区内零 tap）｜终行 `M3-A DRV1 V2.0 OK`。

---

## 三、「金属几何零改动」独立实证（gdstk 全层指纹 `run_v2/gdsfp.py`）

| 件 | 对照 | polygon Δ | label Δ | refs Δ | bbox |
|---|---|---|---|---|---|
| drv1 v22 | 现役新面锚 **v21_r1 `62c27a42`**（**同 cbpath `074d7bea`**） | **−0 / +0** | **+28**（14 名×2 层） | 0 | 同 |
| drv2 v22 | 冻结锚 v20 `c9363888`（旧 cbpath `25190557`） | −4 / +4 | +56（28×2） | 0 | 同 |
| mix v32 | 冻结锚 v31 `ef034d51`（旧 cbpath） | −3 / +3 | +40（20×2） | 0 | 同 |

* **drv1 那行是决定性的**：两侧同 cbpath ⇒ 若补标之外还动过任何金属，这一格必然非零。**实测 0/0**。
* drv2 的 4 处、mix 的 3 处，全部是 **y 方向 0.020µm 纯平移**
  （例：drv2 `x[37.5,38.7] y[106.710,107.010]` ↔ `y[106.690,106.990]`）
  ⇒ **与裁定五十普查的 4 处 / 3 处数目与方向逐条吻合**，普查结论在两件上被**独立复现**。
* 三件除 8/0 外**所有层 polygon Δ0、references Δ0**（实例位置/旋转/阵列全同）。

---

## 四、官方 DRC（逐项 lyrdb 对拍，drc_diff.py）

| 件 | 基线 | 总项 | 逐规则 | 消失 | 新增 |
|---|---|---|---|---|---|
| drv1 v22 | v21_newcb（18） | **18 → 18 Δ+0** | M1.b 4/4、M2.b 6/6、V1.b 8/8 | **0** | **0** |
| drv2 v22 | drv2v20_newcb（147） | **147 → 147 Δ+0** | 10 条规则逐条同 | **0** | **0** |
| mix v32 | mixv31_newcb（225） | **225 → 225 Δ+0** | 14 条规则逐条同 | **0** | **0** |

lyrdb 留痕：`m3_drv1_v22_b7a0/e1834140`｜`m3_drv2_v22_b7a0/5f0247ac`｜`m2_mix_v32_b7a0/042603ef`。

---

## 五、LVS：补标**零污染**（他 ④ 的风险兜底，实测答复）

配方：`run_lvs_v20_pass.sh <tag> <layout> <netlist>`（deckfix_v3 ＋ 四开关），约 8 秒/次。

| 件 | 网表 | 结果 | 基线对照 |
|---|---|---|---|
| drv1 v22 | `drv1_subckt_LVS输入_v4.sp` `f5494bf8` | **Status PASS**，`net_pair 13/13 Match`，`device_pair 13` 非 Match 0，**零 MatchWithWarning** | 与 v21（裁定四十九）**逐项相同** |
| drv2 v22 | `drv2_subckt_LVS输入_v6.sp` `add42e6a` | **Status PASS**，`net_pair 19` = **15 Match + 4 MatchWithWarning**，`device_pair 24` 非 Match 0 | 与 v20 基线**分布逐项相同**（4 MW 是既有的，非本轮引入） |

**提取网表逐行比对**（`difflib`）：

* drv1：v21 18 行 / v22 18 行，差异 **仅 3 行**＝时间戳 + `.SUBCKT`/`.ENDS` 顶层名（V21→V22）。
  **网名、器件、连接关系一行未变** ⇒ 新补的名字本来就由同一金属簇上**已有**的标注命名（同名合并）。
* drv2：29 行 / 29 行，差异 8 行＝时间戳 + 顶层名 + **端口书写顺序**（`… ccas1 bb1 ccas2 outp nbcas outn`
  ↔ `… ccas1 bb1 ccas2 nbcas outp outn`），**网集合与拓扑不变**。

⇒ **他担心的「代跑 LVS 因网名变多出现新差异」没有发生**；**回滚粒度（补标表本身）不必动用**。
**兜底条款（补入裁决）**：将来任何一件若因 label 出现 `Match→MW` 或非 Match，
回滚判据**必须**是「提取网表 diff 出现新增网或状态退化」，**不得**以「网名变好看/变整齐」为理由动几何。

---

## 六、补标落点合规（自写逐点判定，非采信自述）

对三件 **124 条新 label**（62 名 × `/25`＋`/1` 两层）逐点判定「是否落在 M1(8/0) 金属上」
（点在多边形内，或到最近边 ≤ **0.0101µm**）：

```
drv1_v22: 新增 28 · 命中 28 · 未命中 0
drv2_v22: 新增 56 · 命中 56 · 未命中 0
mix_v32 : 新增 40 · 命中 40 · 未命中 0
```

⇒ **零悬空标注**独立复现。他「落点取引脚点本身、簇内成员矩形命中、pad=0.01µm」的口径**核实成立**。

---

## 七、他 ② 的 6 条「人工判读」网名 —— **批准入册**（附一条升级建议）

* **drv1 两条 `gnd`**（v2.1 新加的两个 ptap 接地垫 (14,100)/(42,100)）：
  实测两落点**各带 `gnd` ×（8/1、8/25）**，且真 KLayout 里 **TAP-ASSERT 三环全过**
  ——该落点真有 via_stack 实例、M4 立管真压 gnd 干线、禁区内零 tap。
  地仍走金属三环（M1 垫 → via_stack → M4 立管），本次一条金属未动。
  **批准**；口径不变：**label 只命名，不代替电学连接**（E2 的 `gnd$1` 教训）。
* **mix 四条 `gnd`**（假管 `d3L`/`d3R` 的 C/B 落点，假管在 `DUMMY_DEVICES` 不进 `NET_DECL`）：
  依据是脚本 §8「M4 地轨 hop」。**批准**，但**建议把依据升级**：
  请把这四只假管的 C/B 声明网补进 `NET_DECL`（或单列 `DUMMY_NET_DECL`），
  使其从「人工判读」变成「声明唯一解」——否则下一轮机械普查（凡非 `NET_DECL` 唯一解者即异类）
  会把它们反复挑出来，既费时又容易被误当成缺陷。**这是建议，不是门限。**

---

## 八、他四问的裁答

### ① mix 网表与版图顶层名对不上 —— **他的诊断正确，定口径如下**

实测事实：mix 现役面锚 v31 顶层 = **`TX5G_M2_MIX_V31`**，而现存网表 `mix_subckt_LVS输入_v1.sp`
的 `.subckt` 停在 **`TX5G_M2_MIX_V29`** ⇒ **v31 那一版确实没有配套 LVS 输入网表**。

**裁定口径（面锚命名律）**：
1. **LVS 输入网表的 `.subckt` 名必须与它所配那一版版图的顶层 cell 名逐字相同**
   ——KLayout 否则直接报 `Can't find a schematic counterpart for the top cell`。
   **网表版本号不得在版图层之外单独漂移。**
2. 他的 `mix_subckt_LVS输入_v2.sp`（V29→V32）**批准入册**（配 v32 版图）。
3. **请补一份 `mix_subckt_LVS输入_v1b.sp`**：`.subckt TX5G_M2_MIX_V31`／`.ends TX5G_M2_MIX_V31`，
   其余逐字不动 ⇒ 使 **mix v31 现役面锚本身具备 LVS 能力**。
4. **⇒ 立律 F14（草案）：面锚的 LVS 配套登记**——登记面锚时须同时登记配套 LVS 输入网表（文件名＋sha）；
   无配套网表者须显式标注「**LVS 能力缺件**」。本轮发现并入册：**mix v31 属此缺件**。

### ② 两处人工判读网名 —— 见 §七，**批准**（附升级建议）。

### ③ 官方 DRC 8 条 M1.b 剩 2 条坐标 / 竖轨 ∓16.2 是否让到 ∓16.4 / 真 GDS 带条清单

**口径：先对表，再谈让位。**（裁定）本轮我侧已产出三件逐项 lyrdb 对拍（18/147/225 Δ+0，指纹逐条同），
可直接作为「官方判的间距」的坐标基准。**让位是改几何**；M1.b 计数口径 43/3/38 的差异
必须靠**逐条坐标对齐**来解释，**不得靠改几何凑数**。
→ 请他出**真 GDS 带条清单**（带名/层号/中心线/半宽/条数），我侧按坐标逐条对，
对完再议是否让位（让位与否届时单独立项，不在本轮）。

### ④ 补标导致 LVS 新差异的风险兜底 —— **已实测答复：零新差异**（§五），
故**不动用回滚**；回滚判据条款已写入 §五 末尾。

### 另：`ptap1` 的 `8/0` M1 tie 是否以实例原点为中心 —— **否。这条早已定谳：裁定四十九 + 律 F12**

* 实测：`ptap1` 的 M1 tie = `(0.14,0.09)-(0.64,0.69)`，0.50×0.60，**中心＝原点＋(0.39,0.39)**
  （根源：`ptap1_code.py` 全图建在 `Box(0,0,w,l)` ⇒ **原点是 Activ 左下角**）
* **只有 `via_stack` 的 M1 焊盘原点居中**：`(-0.35,-0.31)-(0.35,0.31)`
* ⇒ 他「via 打在原点」**是对的**；若要在 tie 上落 via/label，下版落点改 **`_tx-0.39, _ty-0.39`**
* **同族不同件禁止类推**（律 F12，与律 F8「看着压住了≠真压住」同构）

### ㉓ 升硬闸 —— **同意他的建议：再等一轮**

理由：㉓ 现在可判率 100%，且异网对全过（0 硬档）——**这正是最容易把「刚变好」当成「闸已成熟」的时刻**。
升硬闸的阈值应与**官方 M1.b 的逐条对表**同批落地（同一张坐标表上对齐「官方间距」与「自设 0.63 保守项」），
再定硬/软档。**本轮不升级、不新增门限。**

---

## 九、入册律条

* **律 F14（草案）· 面锚的 LVS 配套登记**：登记面锚须同时登记配套 LVS 输入网表（文件名＋sha）；
  无者须标「LVS 能力缺件」。*首例：mix v31（顶层 V31）无配套网表 ⇒ 缺件入册。*
* **律 F15（草案）· 交付件真跑背书**：交付件（含 gen 与其内嵌 helper）须在**我侧真 KLayout** 跑通，
  才计「已验证」；作者自检台 `ok=true` **不构成背书**（仿真层 shim 会掩盖真构建 API 缺失）。
  *首例：`gen_M3_drv1_v22.py` 在真 KLayout 当场 AttributeError 停线。*
  配套：**共享盘文件名禁用圈号等非 ASCII 标点**（8510 `/files` 对含圈号名返 400）。
* **律 F13 的第二次生效**：本轮三件装配依赖（尤其 `cbpath 074d7bea`）已随纪要登记；
  若不登记，无法区分「补标引入的差」与「cbpath 代差引入的差」——**本轮 drv2 4 处 / mix 3 处
  正是靠这条登记才被正确归因**。

---

## 十、产出与留痕

| 件 | sha | 说明 |
|---|---|---|
| 本纪要 | （本文件） | 已上 8510 `design/sow6/` |
| `gen_M3_drv1_v22_b7a0adapt.py` | `0ea46101` 80279B | 我侧 7 处披露适配装配件（**可复现**，供他照抄修源件） |
| `patch_drv1_v22_b7a0.py` | `df3778d4` 6575B | 适配生成脚本（每处断言命中一次） |
| `probe_api2_b7a0.py` | `5f531b25` 1351B | 本构建 API 实测探针（律 F12 取证范式） |
| 留痕目录 | — | `verify/label_v22_run/`（三 GDS＋三日志＋out/）、`phys/drc/{m3_drv1_v22,m3_drv2_v22,m2_mix_v32}_b7a0/`、LVS rundir `out_drv2v20_drv1v22labels` / `out_drv2v20_drv2v22labels` |

## 十一、边界

**零仿真、零点火、零 M5 链件变更、零组员源码改动（只取件复跑）**；三件冻结锚（v20/drv2 v20/mix v31）与三份 cdl 一概不动；
面锚未换（drv1 v22 尚未换锚，等他修完源件再议）；未新增任何门限。

<!-- 凭据治理 2026-10-23：明文取件钥已按凭据律替换为占位符（真值见内部凭据库）；本件字节已因此变更，sha 以 BOOT_交付物索引.md 现算值为准。 -->
