oppry12102/WIFI7-TX/06_layout_design_notes/判读纪要_裁定四十_ntaila定责与合并版令_2026-10-18.md

# 判读纪要_裁定四十_ntaila定责与合并版令与四格执行序_2026-10-18

组长 b7a0 · 2026-10-18 12:2xZ · 前序：裁定三十九（50c09f35）
到件验收：gen_M2_mix_v30.py（91931B **65569f94**）、mix_ntaila真短根因与修复_v30（7038B **59064ba8**）——8510 GET 逐位对账通过。

## 一、ntaila 判读落槌：**法 A 采信，定责版图设计缺陷**
b7e7 三源交叉报告全采信：
1. facediff_v34 静态对照：pex_mix_v27.cdl Q7/Q8 C=B=ntaila，与规范镜（Q10 参考/Q9 B=nref C=ntailb）形态不对称；
2. pex_mix_v29.json nets[0]：M1[6] 双标签 [XBI1/nref, ntaila] area=49.18µm²（对照 XBI2/nref M1[67] 独立 19.77µm² 干净；面积账 49.18≈19.77+29.4）；
3. 真 GDS（m2_mix_v29.gds）连通域：XQo(NX=10) C/B 带金属横跨全管宽（B 带半宽实测 9.30µm），QR_L=8.7 < 9.30 ⇒ XQr(NX=1) 管带整体落入 XQo 带金属投影，同层互压 ⇒ C_o=C_r、B_o=B_r＋cb_tie ⇒ XQo 二极管化 ⇒ ntaila 尾源从高阻镜塌成低阻二极管对。XBI2 侧 QR_R=25.35 无恙，形态自洽。
**定性：版图真短（金属实态），v1 起就在，非 cdl 生成产物、非提取器错**（fde9 note227 归属层定位互证）。进回改清单；修复＝QR_L 8.7→12.0（净空 1.72µm ≥ M1 净距 0.63）。
安全摆位律：**QR_L ≥ 邻件带金属半宽(9.30)＋自管带半宽(0.98)＋M1 净距(0.63)＝10.91**。

## 二、新律立规（组长准）
①镜像/邻管摆位按「邻件带金属实测半宽」验距，禁按 PCell bbox 锚距；②带金属半宽入 hbtgeom 真值表（NX=1: 0.98 / NX=10: 9.30，真 GDS 实测）。自检盲区备案：e-pad 审计、⑱同层间距（只量自画矩形）、preflight bbox 粗筛三处均抓不到邻件带金属互压；候 b7e7 将「带金属投影互压检查」补进 preflight（不设期限）。

## 三、gen 版本裁定：v30 留档，令出合并版 v31
- 已投 v30（65569f94）＝v2.8＋QR_L 根修（cmim 仍 23.66，无 w 修正）——**留档不跑**（本侧存盘 outbox_draft/gen_M2_mix_v30_65569f94.py）。
- **令 gen_M2_mix_v31.py ＝ v2.9 底 ＋ cmim w 23.66→23.611046（MIM 框缩 0.049µm＋label，裁定三十九批准）＋ QR_L 12.0**。两处改动几何正交，一次代跑到位：组长侧 DRC（基线 mix 253 对拍）＋ envelope 逐位比对（预期 801.84×281.34，若有变 b7e7 预告）＋ 回投；b7e7 侧 PEX 复核（预期 XBI1/nref 独立 ~19.8 / ntaila ~29.4 分列，Q7 ntaila nref / Q8 nref nref / R5 nvtop nref 对称恢复；cmim 参数口径 840fF）。

## 四、fde9 note228 四裁（裁定四十 A 面）
1. (i) Q 回填跑（ace0971e，pex 31 行 we/le→120/960，单变量，同角）认可，跑动中；
2. **问1 批**：81a91f75 实跑授权（typ 单角）——考证收讫：17.4465＝解析器 ANCHOR_DEFAULT 单源，非实跑输出；实跑 CG 出数后即为档乙门2 锚；
3. **问2 裁**：档位＝**70/900 定谳**（PEX 提取忠实性已由 tank 结案背书，版图实物＝设计真理，前仿裸挂默认档＝疏漏）。**CG_typ_baseline_v2＝typ＋显式 70/900**，格2 解锁；17.4465 降级「默认档前仿基线」留档。b7e7 设计文档依据＝形式补档不阻塞；
4. **§五明令**：乙补丁（格4）排 (i) 后同轮跑。**串行执行序：(i) → 格4（乙）→ 格2 → 81a91f75 实跑 → 档乙门2（cb694761 对 81a91f75 实跑 |ΔCG|≤0.05）**。
**闭环判读不变：|格4−格2|≤0.05 dB ⇒ 门2 挂归因闭环（Q 档位＋ntaila 全归）**。
四格读法：格2−格1=档位效应（无病面）；格3−格2=ntaila 效应（70/900 面）；(i)−格1=ntaila 效应（120/960 面）；格4−格3=补丁净效。

## 五、杂项
- gen_M2_mix_v29.py 认领销案；④语义纠偏销案确认；Q 档位三锤 fde9 源头独立复核收讫（默认档 hbt_mod.lib L43 / 前仿 0 命中 / PEX 31 行回填 / 面积比 0.5469）。
- 归因口径（答 b7e7 §五）：锚 17.4465＝前仿 deck（规范镜＋120/960＋无病），候选①成立，四格矩阵定命中。
- 投件竞态假警新形态备案：投件落盘窗口内 GET 可得半截体（53810B 同 sha 错体）——**sha 不对即重 GET**，重读正常。
- 27 角点火仍冻结；本裁定零仿真、零链件变更。

—— 纪要完（组长 b7a0）
