oppry12102/WIFI7-TX/06_layout_design_notes/层次1_提取设置声明_2026-10-18.md

# 层次 1 提取设置声明（正式交付件）

**b7e7** · 2026-10-18 · 随层次 1 cdl 三件交付（mix→drv1→drv2）
**状态**：备料线已启闸（组长四裁 2026-10-18 01:35 裁定④）；联仿线不启闸（候 deck 修复重提干净 JSON）。
**裁定 A 注记**（b7a0 2026-10-18 03:4x 来信）：本声明 §1 的 GDS 顶层 cell 名（drv1=V16 / drv2=V14）是 **8510 现行 GDS 的如实记载**（legacy 名），基线先行入册；裁定 A（cell 名统一升 V19）落地后（deck 修复闭环重提窗口）本声明升 v1.1 刷 sha 表（届时 cell 名=V19、GDS sha 变、cdl 只第 2 行 `* GDS:` 变）。

---

## 1. 几何源与层映射

- **几何源**：8510 投件 GDS（sha 锁定，组长真 klayout 出品，零重建误差）：
  | 件 | GDS 文件 | sha256（前 8） | 顶层 cell |
  |---|---|---|---|
  | mix v27 | `gds/m2_mix_v27.gds` | `ac3c7284` | TX5G_M2_MIX_V27 |
  | drv1 v19 | `gds/m3_drv1_v19.gds` | `e59cdc33` | TX5G_M3_DRV1_V16 |
  | drv2 v19 | `gds/m3_drv2_v19.gds` | `76ae92cf` | TX5G_M3_DRV2_V14 |
- **层映射**：lib13g2 LG 表（与 GDS 出品库同源）：
  M1=(8,0) VIA1=(19,0) M2=(10,0) VIA2=(29,0) M3=(30,0) VIA3=(49,0)
  M4=(50,0) VIA4=(66,0) M5=(67,0) TOPVIA1=(125,0) TOPM1=(126,0)
  TOPVIA2=(133,0) TOPM2=(134,0)；pin datatype=2，网名文本 datatype=25。
  (235,5)=L1 禁区标注（非制造层，跳过）。

## 2. 器件识别与参数

- **HBT (npn13G2)**：cell 内 (63,0) 文本 C/B/E 锚 pin（C=(8,2) y>0 侧、B=(8,2) y<0 侧、E=(10,2) M2 pin）；`Ae=Nx*multi*we*le` 文本直接给参数（Nx/m/we/le）。
  **端子锚定 = pin 块金属实际位置**（(63,0) 文本只是标记点，非锚——本口踩过即改）。
- **电阻 (rsil/rhigh/rppd)**：材料名=(52,0) 文本；w=(5,0) 底盘宽；l=上下底盘内边距（rsil 1.75/1.0、rhigh 1.0/1.19 已对拍 LVS ✓）。
- **cmim**：上板 (126,0) ∩ 下板 (67,0) 交叠面积 × 1.5 fF/µm²（CMIMA target）+ 周长项 40aF/µm。
- **ptap1**：body tap，不生成器件行（substrate contact）。
- **本批 GDS 无显式 contact 孔层** → 器件端电阻不单列（LVS 器件参数口径已含）。

## 3. 连通域与网名

- **连通域**：每金属层 unary_union → 连通域；via 连接=孔中心落域内 → 连上下两层域（union-find）。
- **网名**：datatype 25 文本落域；多网名同域如实双名（如 XBI/nref|gnd）。
- **网名优选策略**（裁定①②，2026-10-18 01:35 终裁）：
  - **mix（revised 模式）**：映射名只作归一参与计数，候选=无映射原名，取域内器件 dnode 挂靠计数最大者；并列时专用网（ntaila/nsens 类）优先于全局网（gnd/vdd 类）。
  - **drv1/drv2（legacy 模式）**：映射名优先（XBI*/nref→nref 优先于原名）；无映射名时取列表首项。
  - **同函数同策略**：cdl 与 R 分段网同函数（`_resolve_net`）同策略，禁止两套（裁定②）。
- **异常留痕**（裁定③）：域内原名数≥2 加 WARNING merged-domain 头行（仅 mix 出；drv2 大域是 v19 修复实证，裁定②「不动」）。

## 4. 层次 1 金属 R 口径（tier-1，bbox 近似 · 保守）

- **逐段 R**：`R = RSH[layer] × L / W`，L/W 取域 bbox 长/短边（凸正交近似；L 形真实路径偏长 → 低估，视为保守下界；周长法上界未启用）。
- **RSH target**（PDK 官方表，已入链）：M1 0.110 / M2~M5 0.088 / TOPM1 0.018 / TOPM2 0.011 Ω/□。
- **via 并联**：`R_via = R_typ / n_vias`（n_vias 缺省按 VIA_PADS 估计；VIA1-4=50 pads，TOPVIA1/2=1 pad）。
- **via typ**（PDK 官方表）：VIA1-4 9.0 / TOPVIA1 2.2 / TOPVIA2 1.1 Ω/只。
- **锚点最短路**：以 M1 为锚，域级图 BFS（边=via 连接，权重=层间 via 典型电阻），累计 R_cumulative。
- **局限**：bbox 口径对 L 形/蛇形金属低估真实路径电阻；via 数按估计非逐只计数；未含寄生电容（tier-1 R-only）。正式化前需与组长确认口径闸值。

## 5. 电源网与 IR-drop

- **电源网简化开关 on**（组长裁定）：vcc 网保留，IR-drop 附注不入门。

## 6. 转换五规则（cdl 生成，组长 2026-10-17 裁定，同 LVS sch 对拍口径）

1. X→Q 行（we=70n le=900n NX=M）
2. hbt_mirror 内联展开（XBIk__nref 独立网）
3. 剥 V·Cin·Ct·Lt（12 项，清单注记在件头）
4. R→3T 带模型+版图实态几何
5. sub=0

## 7. 已知差异（LVS deck-bug，对拍时备案，非我方错误）

- e1$1/e2$1 端子分家（drv1/drv2 E 回流链物理断路，已修 v19/v28 闭环）
- XBI/nref|gnd 合并网（簇乙形态，已知）
- rsil 远端 $29/30 编号漂移

## 8. 文件清单与 sha

| 件 | cdl 文件 | sha256（前 8） | seg JSON | pex JSON |
|---|---|---|---|---|
| mix v27 | `pex_mix_v27.cdl` | **33e9e754** | `pex_mix_v27.seg.json` | `pex_mix_v27.json` |
| drv1 v19 | `pex_drv1_v19.cdl` | **ae4feb76** | `pex_drv1_v19.seg.json` | `pex_drv1_v19.json` |
| drv2 v19 | `pex_drv2_v19.cdl` | **1f5e0cd8** | `pex_drv2_v19.seg.json` | `pex_drv2_v19.json` |

- **mix cdl 头行 WARNING**（裁定③）：`* WARNING merged-domain: names=['gnd','nsens','ntaila'] chosen=ntaila pending-deck-fix-re-extract`
- **42 域 WARNING**（lond/lopd/nswa/rfon/rfop）：`chosen=lond`
- **ntaila 域**：Q5-Q10/Q15/R5/R6/C5/C6 全归 ntaila（头/器件一致，同函数同策略）。
- **上一版存档**：`pex_mix_v27.cdl.prev-1fd54f1e.bak`（上口 1fd54f1e 版，头/器件不一致）。

## 9. 提取链脚本

- `pex_extract.py`（GDS → pex JSON + seg JSON）
- `pex_to_cdl.py`（pex JSON → cdl，v5 双模式：legacy/revised）

## 10. 复现步骤

```bash
# 1. 提取（GDS → JSON + seg JSON）
python3 design/sow6/dryrun/pex/pex_extract.py gds/m2_mix_v27.gds design/sow6/dryrun/pex/pex_mix_v27.json
python3 design/sow6/dryrun/pex/pex_extract.py gds/m3_drv1_v19.gds design/sow6/dryrun/pex/pex_drv1_v19.json
python3 design/sow6/dryrun/pex/pex_extract.py gds/m3_drv2_v19.gds design/sow6/dryrun/pex/pex_drv2_v19.json

# 2. 生成 cdl（JSON → cdl）
python3 design/sow6/dryrun/pex/pex_to_cdl.py design/sow6/dryrun/pex/pex_mix_v27.json design/sow6/dryrun/pex/pex_mix_v27.cdl
python3 design/sow6/dryrun/pex/pex_to_cdl.py design/sow6/dryrun/pex/pex_drv1_v19.json design/sow6/dryrun/pex/pex_drv1_v19.cdl
python3 design/sow6/dryrun/pex/pex_to_cdl.py design/sow6/dryrun/pex/pex_drv2_v19.json design/sow6/dryrun/pex/pex_drv2_v19.cdl

# 3. 核验 sha
sha256sum design/sow6/dryrun/pex/pex_mix_v27.cdl   # 应 = 33e9e754...
sha256sum design/sow6/dryrun/pex/pex_drv1_v19.cdl  # 应 = ae4feb76...
sha256sum design/sow6/dryrun/pex/pex_drv2_v19.cdl  # 应 = 1f5e0cd8...
```
