oppry12102/WIFI7-TX/06_layout_design_notes/层次1_提取设置声明_v1.3_2026-10-18.md

# 层次 1 提取设置声明 v1.3（正式 · 换源轮刷表）

**v1.3 变更（裁定三十 §二 / 裁定三十一 §四2）**：提取层次口径改 **R + cmim**——v1.1 及以前「未含寄生电容（tier-1 R-only）」局限句**作废**（同批 json 六只 cmim 带完整 area/perim/c_ff，内容为真、旧句为伪）。生成器头行同步（pex_to_cdl.py v5 →「R + cmim」，drv2 现役件先行，mix/drv1 随下版重提对齐）。

**b7e7** · 2026-10-18 17:4x 本地 · **状态：正式件（本批投 8510，替换 v1.1 sha 2b8f5bc3）**
**落地轮**：换源重提取轮（裁定二十二/二十三/二十四：三 cdl 按现役三名槽位覆盖投、头部加 SRC_GDS_SHA256 行、Q5/Q6 保留）。
**v1.1 替换说明**：v1.1（2b8f5bc3）所述「v1.2 触发 = m2_mix_v29.gds 代跑到件」已由裁定二十二⑥/二十三·四.5 订正为「mix cdl 换源件到件」——**本件即该触发产物**。

---

## v1.2 变更注记（相对 v1.1）

1. **三件全换源**（裁定二十二②/二十三·四.1）：mix ← `m2_mix_v29.gds`（8f6da23d，M1.e 清零件）；
   drv1 ← `m3_drv1_v20_r2.gds`（fe2ff903）；drv2 ← `m3_drv2_v20_r2.gds`（c9363888，r2=真环境 5 处非触发保守退让件）。
2. **槽位名纪律生效**（裁定二十二①）：三 cdl 沿用现役三名 `pex_mix_v27.cdl` / `pex_drv1_v19.cdl` / `pex_drv2_v19.cdl`
   同名覆盖投——**文件名自此仅作槽位名，判活认 sha + 头部声明**。新 sha：mix **ce97750b** / drv1 **60093747** / drv2 **ebe7d9d7**。
3. **cdl 头部增 `* SRC_GDS_SHA256:` 行**（裁定二十二②）：逐件写实际源 GDS 全 sha；`* GDS:` 行 = 实际顶层名。
   **备案一处与裁定文本的偏差**：裁定二十三·四.2 预设声明头 `TX5G_M3_DRV1_V20_R2`/`TX5G_M3_DRV2_V20_R2`，
   但 **r2 GDS 的实际顶层 cell 名不带 _R2**（= `TX5G_M3_DRV1_V20` / `TX5G_M3_DRV2_V20`，与 v20 同名——r2 区分仅在文件名与 SRC 行）。
   本件按「实际顶层名」原则如实写（mix 侧无此问题，实际名即 TX5G_M2_MIX_V29）。请组长按此口径判活。
4. **器件/网名行零 delta 自证**：三件换源 cdl 与现役批（4dcc29db/4901fbb6/b080ab49）**逐器件行逐字节一致**
   （全文件 diff 仅声明头 2→3 行），即裁定二十四·三「只改源、不改形态、禁混批」的实证，drv1/drv2 销账认等价条件满足。
5. **Q5/Q6 保留不剔**（裁定二十三·一 撤回二十二·四）：`Q=15 R=16 C=6` 不变；**DUMMY_DEVICES 台账**随批投
   （`DUMMY_DEVICES_台账_mix_Q5Q6_2026-10-18.md`，Q5/Q6 坐标/三端域/通 gnd 三重证据 + T2 维护纪律）——
   判据器①「三端同网豁免」自此以台账在册为阳性前提（fde9 T2 收紧口径）。
6. **cdl 形态定谳为代入器契约**（裁定二十四·三）：三网+模型位第4字段+命名 sub=0/M=1 = fde9 代入器输入契约，
   **D1 位置式判据对 cdl 不适用**（收编，不入待改清单）；`lvs_source_audit.py` 已加「目标读者」维
   （lvs_reader / ngspice_substitute，缺省 auto 按扩展名），换源三件契约体检全绿。
7. **轮间监测**：v28→v29 / v20→v20_r2 对拍四类关键网 R_cumulative **零报警**（无 >20% 变化、无量级跳变），
   与器件行零 delta 互证（M1.e 修复 + 5 处退让对寄生面零影响）。新基线 = `轮间监测基线_v29r2_2026-10-18.json`（c26f3e25）。
   `monitor_baseline.py` 已补投 8510（原 404 清账，裁定二十一/二十四 小账）。
8. **mix LVS 前置件到件**（裁定二十三·五）：`mix_subckt_LVS输入_v1.sp`（15Q 含 QX5/QX6 补画 + 16R + 6C，
   与换源 cdl 37/37 逐件拓扑+参数全等；D1-D4 体检全绿；check_netlist_dc ok）。
   同批 `drv2_subckt_LVS输入_v5.sp` 已由裁定二十四·二实测三跑 PASS 收编为**标准件**（覆盖现役几何）。

---

## 1. 几何源与层映射

- **几何源**：8510 现役 GDS（sha 锁定，组长真 klayout 出品，零重建误差）：
  | 件 | GDS 文件 | sha256（前 8） | 实际顶层 cell |
  |---|---|---|---|
  | mix v29 | `m2_mix_v29.gds` | `8f6da23d` | TX5G_M2_MIX_V29 |
  | drv1 v20_r2 | `m3_drv1_v20_r2.gds` | `fe2ff903` | TX5G_M3_DRV1_V20（无 _R2，见注记 3） |
  | drv2 v20_r2 | `m3_drv2_v20_r2.gds` | `c9363888` | TX5G_M3_DRV2_V20（同上） |
- **层映射**（与 v1.1 逐字不变）：M1=(8,0) VIA1=(19,0) M2=(10,0) VIA2=(29,0) M3=(30,0) VIA3=(49,0)
  M4=(50,0) VIA4=(66,0) M5=(67,0) TOPVIA1=(125,0) TOPM1=(126,0) TOPVIA2=(133,0) TOPM2=(134,0)；
  pin datatype=2，网名文本 datatype=25，(235,5)=禁区标注跳过。

## 2. 器件识别与参数（与 v1.1 逐字不变，摘要）

- HBT：C/B/E 端子锚 = pin 块金属实际位置（TERM_LAYER 固定层序：C/B→M1、E→M2）；参数取 `Ae=Nx*multi*we*le` 文本。
- **dummy 台账（T2 口径）**：mix Q5/Q6（gen d3L/d3R，Nx=3，x=∓50）三端接地 = 设计意图，
  **豁免以台账在册为阳性前提**，台账缩表即豁免失效；不在台账内的三端同地器件一律仍判 FAIL。
- 电阻：材料=(52,0) 文本；w=(5,0) 底盘宽；l=上下底盘内边距。
- cmim：上板∩下板交叠面积×1.5fF/µm² + 周长项 40aF/µm（`area=<A> perim=<P> sub=0`，mix 6 件 perim=90.72µm）。
- **提取层次口径：R + cmim**（v5 起 MIM 面入提取；mix 块另含 6 只 cmim——C1–C4 输入耦合 na1p/nb2n/nb1p/na2n↔ifp/ifn、C5/C6 tank 旁路 rfop/rfon↔gnd；drv1/drv2 无 cmim 件 C=0）。
- ptap1：body tap 不生成器件行；本批 GDS 无显式 contact 孔层。

## 3. 连通域与网名（与 v1.1 同策略）

- 连通域：逐层 unary_union → via 中心落域连上下层（union-find）。
- 网名：datatype 25 文本落域；多网名同域如实双名。
- 优选策略：mix=revised（原名候选、器件挂靠计数最大、专用网优先），drv1/drv2=legacy（映射名优先）——同函数 `_resolve_net` 同策略。
- 异常留痕：域内原名≥2 出 WARNING 头行——**本版三件 0 条**。
  **备案（非 WARNING）**：XBI1 组 C/B 域为双标签域（XBI1/nref + ntaila，同一金属域物理实态），
  mix 侧 LVS 输入 v1 按轨名 `ntaila` 单名转录（拓扑同一域）。

## 4. 层次 1 金属 R 口径（与 v1.1 逐字不变）

bbox 近似保守下界；RSH target M1 0.110 / M2~M5 0.088 / TOPM1 0.018 / TOPM2 0.011 Ω/□；
via 并联 R_typ/n（VIA1-4=50 pads、TOPVIA1/2=1）；via typ 9.0/2.2/1.1 Ω；M1 锚 BFS 最短路。
**轮间监测（v1.2 基线滚动）**：四类关键网（E 回流/gnd 主干/ntaila/vcc 馈电）>20% 或 ×10 报警；
**本轮 v29r2 基线零报警**；新基线文件 sha c26f3e25，随批投 8510。

## 5. 电源网与 IR-drop

电源网简化开关 on（组长裁定）：vcc 网保留，IR-drop 附注不入门。

## 6. 转换五规则（cdl 生成）+ 契约定谳

1. X→Q 行（we=70n le=900n NX=M）2. hbt_mirror 内联展开 3. 剥 V·Cin·Ct·Lt 4. R→3T 带模型+版图实态几何 5. sub=0。
**形态契约（裁定二十四·三）**：上述产物 = fde9 代入器输入契约（三网+模型位第4字段+命名 sub=0/M=1），
**不得改为 LVS reader 四网位置式**（会使代入器 regex 失配 → 整行落 ngspice → 四端 .subckt 解析挂）。

## 7. 已知差异备案

- rsil 远端 $29/30 编号漂移：仍在（drv2 6 匿名网，形态与 v19/v20 同）——INFO，不参与网名定谳（裁定二十一收编）。
- mix Q5/Q6 三端 gnd：设计意图（台账阳性认定件在册）。
- nvtop / nsens / nifbias 提取面无额外驱动（deck 行为源 Bv*/Is0 不在版图）：两侧同构即可，LVS 不受影响。

## 8. 文件清单与 sha（全部本口实测）

| 件 | cdl（槽位名，sha 前 8） | pex JSON | seg JSON |
|---|---|---|---|
| mix v29 | `pex_mix_v27.cdl` **ce97750b** | `pex_mix_v29.json` 8efbedd1 | `pex_mix_v29.seg.json` 89728a6e |
| drv1 v20_r2 | `pex_drv1_v19.cdl` **60093747** | `pex_drv1_v20_r2.json` 784a493d（与 v20 件同 sha——json 面零 delta 实证） | `pex_drv1_v20_r2.seg.json` 8f89190c |
| drv2 v20_r2 | `pex_drv2_v19.cdl` **ebe7d9d7** | `pex_drv2_v20_r2.json` a3646631 | `pex_drv2_v20_r2.seg.json` aaafdffc |

- cdl 器件统计：mix Q=15（含台账 dummy×2）R=16 C=6 / drv1 Q=4 R=9 / drv2 Q=12 R=12；匿名网 mix 0 / drv1 0 / drv2 6。
- 头部三确认：sha 变（上表）+ `* GDS:` 实际顶层名 + `* SRC_GDS_SHA256:` 全 sha（8f6da23d…/fe2ff903…/c9363888…）。
- 附：`轮间监测基线_v29r2_2026-10-18.json`（c26f3e25）。
- **fde9 知会**：三 cdl 槽位名不变、sha 全变（4dcc29db/4901fbb6/b080ab49 → ce97750b/60093747/ebe7d9d7）；
  判据器①自本轮起以 DUMMY_DEVICES 台账为阳性前提（T2）；SRC_GDS_SHA256 行为点火版本门新锚（runbook §3.2 判据改锚）。

## 9. 提取链脚本（本口变更点）

- `pex_extract.py`：TERM_LAYER 端子层锚定版（未再改动）。
- `pex_to_cdl.py`：**加第 4 参 src_gds_sha256**（头部 `* SRC_GDS_SHA256:` 注释行；器件/网名生成逻辑零改动）。
- `pex_cdl_audit.py`：未改动（六判据 + dummy 台账豁免口径）。
- `lvs_source_audit.py`（skills）：**加目标读者维**（auto/lvs_reader/ngspice_substitute），已投 8510。
- `monitor_baseline.py`：补投 8510（404 清账）。

## 10. 复现步骤

```bash
# 1. 提取（GDS → JSON + seg JSON）
python3 design/sow6/dryrun/pex/pex_extract.py gds/m2_mix_v29.gds      design/sow6/dryrun/pex/pex_mix_v29.json
python3 design/sow6/dryrun/pex/pex_extract.py gds/m3_drv1_v20_r2.gds  design/sow6/dryrun/pex/pex_drv1_v20_r2.json
python3 design/sow6/dryrun/pex/pex_extract.py gds/m3_drv2_v20_r2.gds  design/sow6/dryrun/pex/pex_drv2_v20_r2.json

# 2. 生成 cdl（JSON → cdl；第 4 参 = 源 GDS sha256 → 头部 SRC 行）
python3 design/sow6/dryrun/pex/pex_to_cdl.py design/sow6/dryrun/pex/pex_mix_v29.json \
        design/sow6/pex_mix_v27.cdl gilbert_mix 8f6da23dd5ec85bcc31f85ffe3887a25831b9761d7ff1065e415611ff93a9b34
python3 design/sow6/dryrun/pex/pex_to_cdl.py design/sow6/dryrun/pex/pex_drv1_v20_r2.json \
        design/sow6/pex_drv1_v19.cdl drv1 fe2ff9039241c98067fde669bc9b6a32e2b2f94b9f21767f8facdf5d583a8716
python3 design/sow6/dryrun/pex/pex_to_cdl.py design/sow6/dryrun/pex/pex_drv2_v20_r2.json \
        design/sow6/pex_drv2_v19.cdl drv2 c93638889f8fbf295a7633cfc0a557646fe8f658d39f82ded5c0b7a2c8f24631

# 3. 核验 sha（应逐位一致）
sha256sum design/sow6/pex_mix_v27.cdl   # ce97750b...
sha256sum design/sow6/pex_drv1_v19.cdl  # 60093747...
sha256sum design/sow6/pex_drv2_v19.cdl  # ebe7d9d7...

# 4. 契约体检（cdl→代入器读者）+ 六判据审计
python3 -c "import sys; sys.path.insert(0,'skills'); import lvs_source_audit as A; \
print(A.run(audit=['design/sow6/pex_mix_v27.cdl','design/sow6/pex_drv1_v19.cdl','design/sow6/pex_drv2_v19.cdl'])['ok'])"
python3 -c "import sys; sys.path.insert(0,'design/sow6/dryrun/pex'); import pex_cdl_audit as A; \
print(A.run(cdl=['design/sow6/pex_mix_v27.cdl','design/sow6/pex_drv1_v19.cdl','design/sow6/pex_drv2_v19.cdl'])['ok'])"

# 5. 轮间监测（应零报警）
python3 -c "import sys; sys.path.insert(0,'skills'); import monitor_baseline as M; \
print(M.run(baseline='design/sow6/轮间监测基线_v20v28_2026-10-18.json', seg_dir='design/sow6/dryrun/pex')['alarms'])"
```

---

**本件替换 8510 基线 v1.1（2b8f5bc3）。下一版 v1.3 触发候 = drv1 标准输入对立项轮 / M4 v2 出件轮（任一引起三件任一重提时刷表）。**
