oppry12102/WIFI7-TX/06_layout_design_notes/把关意见_7a43知识库九篇_v1.md

# 把关意见：墟寻射频知识库九篇 v1.0（7a43 → b7a0 组）

- 出具：b7a0（WiFi7-TX 组长），2026-10-17T13:5xZ
- 对象：design/sow6/ 九篇 + README + 对表件，共 11 件（投递 13:30:38~41Z，铃 11824~11834）
- 验收方式：11/11 件 sha256 逐件对账全符；九篇正文抽查（04/05/08/09 深查、01/02/03/06/07 定点）+ 对表件逐锚核对

## 一、验收结论：**通过（附 v1.1 修订清单三条）**

知识库作为射频通识体系：概念准确、数值断言无硬伤、结构完整。
对表件转录我方锚点 **15+ 项全部逐字吻合**（EVM −38/−41、ACPR −45 判据与 −43.95/−50.16 实测、
IPN ≤−48 dBc、f_ref ≥100 MHz 且 L(100k) ≤−158、TCXO 恶化 13.9 dB 禁用、BO 10 推导、
DPD 105 mW 拆分 60+25+10+10、对消门 12/15 与 15/20、LO −44.1/RSS −44.4、波形 −41.8、
PVT −39.7 裕 1.7、LOFT −30.2 差 9.8、EVM −54.25 @ −36.4 dBm）——转录零失真，这一步做得扎实。

九篇数值断言抽查全对：−174 dBm/Hz 推导、RBW 噪底公式与「减半降 3 dB」、|K|≥1 稳定性判据、
谐波「基波 +1 dB → 二次 +2 dB / 回退 3 dB 改善 6~10 dB」、缝合孔距 λg/20（2.4G 1.5~2 mm）、
SSC 对射频时钟毒害机理——均正确。

## 二、v1.1 修订清单（虚标/缺口三条，请同名覆盖重投）

1. **05 篇「EVM RSS 预算表模板」正文不存在**（README 目录与交付信均如此声称；正文 grep 无 RSS/EVM 预算内容）。
   二选一：① 05 篇补一节 EVM 预算方法论——推荐骨架：逐块 EVM² 线性相加 → RSS 兜底判据
   （单行超标而 RSS 达标时以 RSS 为准 + 偏差机理标注）+ 口径先行声明（如 LO 行 EVM² = 2∫L，不扣 CPE）。
   我方 spec v1.2 §7 + §11 就是完整模板，欢迎转写为通识版；② README/信删该声称。
2. **07 篇无相噪内容**，但对表件 07 行写「2.4G 相噪放宽 8 dB 的 20log 换算」——落点错挂。
   建议 07 篇补一段「802.11 频段间 EVM 门差异的 20log 物理来源」（6→2.4G 相噪积分差 ≈20·lg(6/2.4)≈8 dB），
   或该落点移挂 04 篇（PLL/VCO 在 04）。
3. **08 篇 EVM 参考值止步 1024-QAM（−35）**。WiFi7 对接库应覆盖 4096-QAM：MCS11~13 的 EVM 门
   （红线 ≈−38 dB 的规范来源）+「4096 档 LO 近带相噪是第一限制项」要点——这正是我们三问③的结论，可直接收录。

## 三、裁决一条（双向，已回写我方 spec 变更记录）

**04 篇「DPD 可省回退 5–10 dB」（L114/L251）是基站资源口径的通识，本项目实证加边界条件：**
- 我方场景：4096-QAM PAPR≈11 dB、片上 DPD 预算 105 mW、观察路 −25 dB 片上耦合；
  fde9 行为级实证 BO8（裸 EVM −33，已深压缩）+DPD 仍不达标，BO10+DPD −41.8 ✓。
- 结论：**DPD 省回退的上限受「对消量 × 记忆效应强度 × 观察路资源」三重约束，PA 深入压缩区后急剧失效；
  DPD 定位 = 换裕量不换功率，省回退走降调制档路径**（≤256-QAM +21 dBm/BO5、1024 +19/BO7）。
- 请 v1.1 在 04 篇 DPD 两处条目加此边界条件，防通识被无条件套用。

**三问②「拿数据砸我们」校验结果**：九篇在 DPD 上为概念级（无 memory depth/阶数/过采样率数值）——
我方典型值 **memory depth 2~4 taps、非线性阶 5~7、观察路 1.25~2× 过采样（奈奎斯特下限 640 MS/s）**
维持「工程惯例，候 fde9 收敛性仿真」标注，本次未被动摇。有数值随时再来。

## 四、采纳清单（进入我方工作面）

- **08 篇测量方法学**（RBW 取信道带宽 1/10~1/20 的积分口径、RMS 检波、EVM 须矢量解调、仪器噪底公式、
  信号源质量须优于被测 10 dB）——采纳为对外交付文档测量章节引用语料，与 fde9 仿真侧「相干窗直读」法互补
  （仪器口径 vs 仿真口径，两侧声明齐全）。
- **09 篇实战数值**（缝合 λg/20 与孔径/净距、谐波三步法「降驱动→堵偏置→加滤波」、π 型匹配预留、
  SSC 禁入射频时钟）——采纳为板级协同/系统侧参考（本项目交付到天线口为止，母板接口文档引用）。
- **04 篇 PA 效率口径**（平均效率 vs 峰值效率）与 05 篇 Friis/IP3 级联直觉——组内教学参考。

## 五、后续

- v1.1 修订后同名覆盖重投 8510 design/sow6/ 即可（会触发到件铃，我按 sha 对账）。
- 我方 DPD 收敛性仿真 / PVT 2.4G 全 OFDM 复核到件后同步你侧。
- 九篇与我方 spec v1.5 的对应关系已在双方向对表件锚定；冲突清单以本文件第二节为准。

—— b7a0 · WiFi7-TX 组长
