oppry12102/WIFI7-TX/06_layout_design_notes/无名M1簇补标纪要_可判率100_2026-10-19.md

# 无名 M1 簇补标 · 纪要（2026-10-19）

> 文件名去掉了圈号「㉓」：8510 `/files` 对带该字符的文件名返 **HTTP 400**
> （2026-10-19 实测，其余 10 件同批全过）——正文的判据号照旧写 ㉓。

**一句话**：三块（HBT 混频 mix / drv1 / drv2）的**器件引脚落点那一小块 M1 焊盘**历来
只有几何、没有网名标注，把自检台第 ㉓ 项（带金属 × 顶层自画 M1 互压）打成"一侧无名
⇒ 不可判"。本次给这些簇补上标注（**纯网名文本，金属几何零改动**），㉓ 可判率
**19.6% / 59.1% / 73.2% → 三件全部 100%**，且异网对全部 ≥ 自设保守项 ⇒ **零硬档、零软档**
（mix 原有 2 条软档不变）。

---

## 一、病灶（可复现）

㉓ 项判同网/异网靠「顶层 M1 连通簇上有没有网名标注」。器件引脚焊盘所在簇**一个 label
都没有**，于是带金属对着**自己的**焊盘一律落进"不可判"：

| 件 | 带金属×M1 y 相交对 | 同网 | 异网 | 不可判 | 可判率 |
|---|---|---|---|---|---|
| gen_M3_drv2_v20 | 224 | 22 | 22 | **180** | 19.6% |
| gen_M3_drv1_v21 | 22 | 7 | 6 | **9** | 59.1% |
| gen_M2_mix_v31 | 231 | 49 | 120 | **62** | 73.2% |

drv2 最严重：八成对数处在盲区。原先报出的 12 条"负净距不可判候选"（如
`XBI1_XQr.B ↔ M1@-28.50,+106.71 净距 -0.980µm`）看着吓人，实际就是**器件自己的焊盘**，
本该相接——盲区把"该相接"和"真短路"混在一堆 indistinguishable 的候选里。

**可判率低 = 这一格基本是瞎的。** 这正是 v29 XBI1 镜组真短那一类事故藏身的地方
（那次 ㉒ 也是因为 PCell 带金属不在任何在册矩形里才漏网）。

## 二、为什么能机械补（不是猜网名）

新写的只读探针 `dryrun/probe_nameless_m1.py` 逐簇核：

1. **每个无名簇里所有器件引脚的 NET_DECL 声明网一致** ⇒ 网名**唯一解**。
   逐件结果：drv2 28 簇 addable / **0 簇「一簇多网」**；drv1 12 / 0；mix 16 / 0（drv1 另 2 个 ptap 垫属 `dead`，人工判读，见下）。
   （"一簇多网"若非零，就是真短路嫌疑——这次三件**都是零**。）
2. 声明网来自脚本自报 NET_DECL，而 NET_DECL 被自检台第 ⑦ 项与网表锚 SP_ANCHOR
   交叉核对过 ⇒ 不是我的口述。
3. 落点坐标取**引脚点本身**（簇内成员矩形命中，pad=0.01µm）⇒ label 必在金属上，
   不会触发"标注悬空"。

**两处人工判读**（请复核）：

① **mix 的 4 条 gnd** —— 假管 `d3L/d3R` 的 C/B 落点。它们在 `DUMMY_DEVICES` 里，
**不进** NET_DECL/DEV_NETS，探针判为 `dead`（无名无引脚）。网名依据是脚本自己把这
四只假管的 C/B 都 `hop → M4 地轨`，地轨标 gnd（见 gen 脚本 §8 `for dd in (d3L, d3R)`）。
这 4 条**不属"声明唯一解"**，是我按走线读出来的，请裁。

② **drv1 的 2 条 gnd** —— v2.1 新加的两个 `ptap` 接地垫（(14,100) 与 (42,100)）。
`ptap` 接触**非器件**、按本方纪律不进 NET_DECL，故探针也判 `dead`；网名依据同样是
金属路径（`ptap` M1 tie 垫 → `via_stack` M1→M4 → M4 立管 → 地轨 gnd，见 v2.1 纪要
§三），**label 只是给这块无名垫命名，不代替电学连接**。

## 三、交付件（补标数 / sha 前 8）

| 件 | 补标 | sha |
|---|---|---|
| `gen_M3_drv2_v22.py` | 28 | `025c2374` |
| `gen_M3_drv1_v22.py` | 14（含 v2.1 两个 ptap 垫） | `1e32e3d5` |
| `gen_M2_mix_v32.py` | 20（含假管 4 条 gnd） | `cf720341` |
| `drv1_subckt_LVS输入_v4.sp` | 顶层名 V21→V22 | `f5494bf8` |
| `drv2_subckt_LVS输入_v6.sp` | 顶层名 V20→V22 | `add42e6a` |
| `mix_subckt_LVS输入_v2.sp` | 顶层名 V29→**V32** | `df894662` |

三个 .sp 各自**只改 `.subckt`/`.ends` 两行**（头注里的旧名同步），`lvs_source_audit`
形态 ok 且 `pair()` 拓扑等价 PASS；`check_netlist_dc` ok。

⚠ **顺带发现，请裁定**：mix 的 LVS 输入网表一直停在 `mix_subckt_LVS输入_v1.sp`
（`.subckt TX5G_M2_MIX_V29`），而版图 v30/v31 顶层 cell 已升到 V29/V31 ⇒ **网表与版图
顶层名对不上**（v30 是我有意不改名，v31 忘了提网表）。本次补 v2（V29→V32）把这条线接上，
但**如果 V30/V31 的 cell 名你那边另有安排**，请回件，我按你的口径重出。

## 四、效果（补标前 → 补标后，全部本机实跑）

| 件 | 可判率 | 同网 | 异网 | 不可判 | 硬档 | 软档 |
|---|---|---|---|---|---|---|
| drv2 v20→v22 | 19.6% → **100%** | 22→48 | 22→176 | 180→**0** | 0→0 | 0→0 |
| drv1 v21→v22 | 59.1% → **100%** | 7→13 | 6→9 | 9→**0** | 0→0 | 0→0 |
| mix v31→v32 | 73.2% → **100%** | 49→62 | 120→169 | 62→**0** | 0→0 | 2→2 |

- 异网 176 / 9 / 169 对**全部 ≥ 自设保守项 0.63** ⇒ 补名之后才第一次真正看清
  "带金属与我画的 M1 之间有没有压线"，答案是**没有**。
- `check_layout_gen` 三件 **ok=true / issues=[]**（含 ⓪ 库版本闸 sha 3ab35cde 对齐、
  网名闭合 19/19 · 13/13 · 29/29、幽灵名 0、漏标 0、引脚极性逐脚过）。
- ⑤d keepout ⚠ 条目**逐条相同**（drv2 12 / drv1 3 / mix 5，坐标全同），无新增。

**补标的真正大头在别处**：⑤b 同名分裂 与 ⑬ 引脚异网横穿 这两项此前在"无名"区
基本空转（判据要用网名，无名即无结论）。补完标注它们**被激活**，结果是
**零短路嫌疑 / 零悬空标注 / 零同名分裂 / 零异网横穿 / 零穿顶**（三件全绿）——
即 28/14/20 条标注没有把任何一簇标错。若标错，这两项会当场报出来。

## 五、「金属几何零改动」是可证伪的，不是口号

`dryrun/dump_shapes.py` 真跑两版并逐条比 drawing 矩形：

```
drv2 v20→v22  图 358/358  仅旧有 0  仅新有 0  文本 +56（28 条 × /25+/1）
drv1 v21→v22  图 201/201  仅旧有 0  仅新有 0  文本 +28（14 条 × 2）
mix  v31→v32  图 434/434  仅旧有 0  仅新有 0  文本 +40（20 条 × 2）
判定：金属图形零改动 + 无删除文本 → PASS（三件）
```

**断链测试**（证明比对器不是恒真）：把 drv2 v22 的一条 label 从 `(−24.00,+179.24)`
挪到 `(−24.00,+179.34)` → 比对器报"新增文本 2 / 删除文本 2"→ **FAIL**。已做。

## 六、口径不变 / 残余

1. **label 只命名，不代替电学连接**（E2 的 `gnd$1` 教训）。地仍走金属三环
   （M1 垫 → via_stack → M4 立管），本次**一条金属都没动**。
2. 新增标注只会让顶层网名更多。若代跑 LVS 的"网名比对"因此出现新差异，请回件，
   我按你的口径调（最坏就是把某几条撤掉，回滚粒度就是补标表本身）。
3. mix 那 2 条软档（`XQ3.B ↔ M1@-16.35 净距 +0.475`、`XQ4.B ↔ M1@+16.05 净距 +0.475`，
   lopd/lond）**未变**，仍是上口候的三问之一（竖轨 ∓16.2 要否让到 ∓16.4）。
4. drv1 v22 落盘名 `m3_drv1_v22.gds`（v21 沿用了 v20 的落盘名 `m3_drv1_v20.gds`，
   是我上一口的疏漏，本口顺手纠正）。
5. cont 密度 / psd 间距仍须官方 DRC 终裁 —— 本机无 PDK，**我不替它担保**。

## 七、怎么复算

```bash
# 只读普查：哪些簇无名、能不能唯一解、补完可判率多少
python design/sow6/dryrun/probe_nameless_m1.py design/sow6/gen_M3_drv2_v22.py
# 「几何零改动」比对器（也可当通用件差分器）
python design/sow6/dryrun/dump_shapes.py design/sow6/gen_M3_drv2_v20.py /tmp/a.json
python design/sow6/dryrun/dump_shapes.py design/sow6/gen_M3_drv2_v22.py /tmp/b.json
python design/sow6/dryrun/dump_shapes.py --cmp /tmp/a.json /tmp/b.json
# 三件平铺自足性（/tmp 空目录实跑）：探针 + 比对器 + 三件 gen 全 PASS
```

三件工具均按**内容**定位 sow6 根（本层 → 上一层 → 上层/dryrun），平铺到 8510
（只收 `design/sow6/` 一层）后仍自足，已实跑验证。
