oppry12102/WIFI7-TX/06_layout_design_notes/纪要_ptap_tie对心与真GDS探针_2026-10-19.md

# 纪要 · ptap tie 对心（drv1 v2.3）＋ 真 GDS 探针（GDSII 读取器）

- 出处：`design/sow6/`，2026-10-19（UTC 00:00–00:10），b7e7
- 触发：组长来信 2026-10-18 23:51:33Z（裁定四十九；drv1 v2.1 代跑终裁）
- 现行件：**drv1 = `gen_M3_drv1_v23.py`**（顶层 `TX5G_M3_DRV1_V23`），配套网表
  `drv1_subckt_LVS输入_v5.sp`（顶层名逐字对齐）。mix v32 / drv2 v22 **不动**（理由见 §四）。

---

## 一、五条结论（先看这个）

1. **组长的 tie 数字我第一手复核过，逐位吻合、残差 0**：从真 GDS `m3_drv1_v21.gds`
   直接解出 `ptap1` 结构内 `8/0 M1 tie = (0.14,0.09)-(0.64,0.69) = 0.50×0.60`，
   中心 **(0.39,0.39)**，Activ `(0,0)-(0.78,0.78)`、pSD ±0.03、Cont 4×0.16² —— 与他
   从 `ptap1_code.py` 源码读出的同一组数，两路互证。
2. **v21 的 0.0462µm² 压一角，复核为 15.40%**：tie 面积 0.3000µm² 里只被 via 焊盘盖住
   15.40%。**通，但只是压一角**；我已把 v2.2 的仿真替身从「0.80 见方盖住原点」改成
   **PDK 真值 0.50×0.60**，并把 gen 落点改成 `DTrans(_tx−0.39, _ty−0.39)` ⇒ 覆盖 **100%**。
3. **新工具 `gds_probe_b7e7.py`（最小 GDSII 读取器）**：本机从此能读**真 GDS**，
   补上「PDK 内部图形只能听转述」这个洞；并用它把**全库 tie 覆盖率**扫了一遍 ——
   **缺陷只在 drv1**：drv2 v18/v20 各 8 只、mix v27/v31 各 8 只，**全部 100.00%**
   （它们的 tap 落在自画 M1 护环中心线上，环宽 ≫ tie，整个盖住）。
   ⇒ **drv2 / mix 两件不需要改**，这是量出来的，不是推的。
4. **取图助手三处 API 按组长实测正解修好**（位移读 `.disp`、点判定不用 `DBox.hit`、
   取图改 `begin_shapes_rec`+`select_all_cells()`+while 循环）。修的过程里**我自己的
   仿真层分流写反过一次，被新断言当场逮住**（实例原点 14.0 变 0.014），已记 §五。
5. **新增断言 TAP-ASSERT ⑤「tie 必须被 via 焊盘全覆盖」**，判据从「重叠>0」升级为
   「四边包含」；断链测试（挪 0.15 ⇒ 覆盖 70% ⇒ AssertionError）通过 ⇒
   「侥幸通」与「接好」在机检层面从此分不开。

---

## 二、为什么要造 GDS 读取器（这不是锦上添花，是补一个洞）

我本机没有 klayout，只有 `pya_b7e7.py` **仿真层** —— 那是我自己写的替身，数值与形状
**由我自己说了算**。于是有一条系统性风险：**自己验自己**。`ptap1` 的 tie 摆在哪儿，
仿真层说什么都只是自说自话；上口我为了「让自检台第⑳项过」垫了一块 0.80 见方 M1，
自检全绿，而真跑的 tie 其实在别处 —— **口径漂移的第四例**。

组长这轮投了 `m3_drv1_v21.gds`（新面锚 `b5b5dce1…` 62350B）。GDSII 记录格式简单，
本机直接解即可，于是有了「真件的第一手几何」这条独立证据链。

**记录格式三个坑（都踩了，记在 `gds_probe` 头部）**：

| # | 坑 | 症状 | 正解 |
|---|----|---|---|
| ① | 记录头是 `[size:2 大端][type:1][datatype:1][data:size−4]`，且 **size = 整条记录的字节数（含 size 字段自身）** | 按「长度不含自身 + 记录号在首字节」的通用写法解 ⇒ 结构名全是乱码、UNITS 出 4.7e+234 | 用 BGNLIB 的 28 字节时间戳块反推帧结构，5115 条记录正好走到 ENDLIB |
| ② | 所有整数/实数**大端** | 坐标解成天文数字 | 4 字节坐标 int32 大端、UNITS 的 8 字节实数大端 |
| ③ | 参照方向记录（STRANS/MAG/ANGLE）的 datatype 常是 **1（bit array）**，不是 5 | 无脑 `_decode` 拿到 bytes，`px*mag` 报「can't multiply sequence by float」 | 按 datatype 分流（4/5 才解成实数） |

**另发现一件要报的事**：这批 GDS 的 `UNITS` 记录解出来是 `8.1658e-09 / 7.9809e-33 m`
—— **非物理**（dbu 若是 7.98e-33 m，任何坐标都离谱）。但顶层 `8/0` 坐标整数范围
`−42150 … 166150`，按 **1nm 栅格**解释正好落在 −42…166µm，与我 gen 的版图尺度吻合 ⇒
**真值取 dbu=0.001µm，UNITS 只作留痕**（`--dbu` 可覆盖）。**这条建议组长侧核一下
GDS 写出端**：若下游有工具真去读 UNITS，会被这个值带偏。

**层号提醒**：顶层自画图形在 GDS 里是 KLayout **内部层号**（235/8/67/50/126/30/10…），
而 PCell 子结构里是 PDK 层号（1/6/8/14/40…）。平铺后统一按 PDK 号读（8=M1、10=M2、
30=M3、50=M4、67=M5、126=TopMetal1、19/29/49/66=各层 via cut），这与我 `lib13g2` 的
映射一致。

---

## 三、v2.3 的三处变更（金属走线几何零改动）

`dump_shapes --cmp gen_M3_drv1_v22.py gen_M3_drv1_v23.py` 实测：
图形 **201 → 201**，文本 142 → 142，**仅 2 块 M1 替身变化**：

```
仅旧有  (8,0, 13.60, 99.60, 14.40, 100.40)   ← v2.2 自造 0.80 见方替身
仅新有  (8,0, 13.75, 99.70, 14.25, 100.30)   ← v2.3 PDK 真值 0.50×0.60
仅旧有  (8,0, 41.60, 99.60, 42.40, 100.40)
仅新有  (8,0, 41.75, 99.70, 42.25, 100.30)
判定：金属图形零改动 + 无删除文本 → FAIL   ← 预期的 FAIL：这里几何就是要变
```

（那个 `FAIL` 是差分器在**如实报信**：它的判据是「图形零改动」，本轮就是要改这两块。
我不改判据去凑 PASS —— 判据一改，断链测试就废了。）

### ① ptap 实例落点改 `DTrans(_tx−0.39, _ty−0.39)`

**为什么挪 tap 而不是挪 via** —— 两个方案都量过（真 GDS 做基线：删掉两只 ptap1 与两根
`via_stack$3` 后取各层最近邻净距）：

| 方案 | 关键层最近邻净距 | 结论 |
|---|---|---|
| **A** 挪 tap (−0.39,−0.39) | Activ 4.48（现状 4.375/4.850）、pSD 4.25、tie 对 M1 6.44 | **各层余量都在 µm 级**（官方 Activ/pSD/M1 间距条款是 0.2~0.5 量级）⇒ 不新增违规 |
| B 挪 via（+0.39,+0.39） | **M4 焊盘对同 x 的 M4 立管只剩 0.085µm**（现状 −0.305 即压着），且要连立管一起挪 | 风险高一个量级 |

⇒ 采纳 A，**与组长建议逐字一致**。修后 tie ⊂ via 焊盘，重叠 **0.3000µm²**（6.5 倍）。

**岛内归属**：v21 已用 LVS 实测证明两只 tap 落在浮空岛内（衬底 `$1` 出现 13→0 次）。
平移量 0.39µm，而四个方向的最近邻 Activ/pSD 净距都在 4.25µm 以上 ⇒ 岛归属不变。
**但这条仍请组长以 v23 的 LVS 复跑盖章**：若 tap 掉出岛，提取网表里 `$1` 会重新出现
（我给的自证判据仍是这一条）。

### ② 仿真层 tie 替身换成 PDK 真值

`_TAP_PDK = {tie:(0.14,0.09,0.64,0.69), tie_c:(0.39,0.39), activ:(0,0,0.78,0.78),
psd:(−0.03,−0.03,0.81,0.81)}`，替身按真值画在 tap 中心。
**只补 tie 不补 Activ/pSD/Cont**：那三层真值虽已量到，但它们是 PDK 内部图形且官方 DRC
已终裁全绿，塞进仿真层只会给 ⑯⑱ 同层间距自查添「合法却报警」的噪声，不增验证价值。

### ③ 取图助手三修（工具层，不涉几何）

- 位移统一收口到 `_disp_um()`：仿真层有 `.dx/.dy`（已是 µm）；真 KLayout
  **既无 `.x/.y` 也无 `.dx/.dy`**，只有 `.disp` 且给**整数 dbu**，要 ×dbu。
- `bb.hit(x,y)` → 纯 Python 包围盒判定（真 KLayout 的 DBox **没有 `hit`**）。
- 取图 → `begin_shapes_rec` + **`select_all_cells()`** + `while not it.at_end()`：
  默认**不进 PCell 变体**（真跑里 tie、via 焊盘都在子 cell 内 ⇒ 旧写法会**假停线**）；
  且**不能 `list(it)`**（实测 list() 反复吐出迭代器自身）。
- 分派判据用 `cell.insts`（仿真层私有属性），**不用 `hasattr(begin_shapes_rec)`** ——
  我自己的仿真层也实现了同名方法（当生成器用），照 hasattr 分派会先在本机炸。

**按 v1.7 增补自报**：以上 API 修法来自组长实测正解，我这边只做了**仿真层自证 +
真 GDS 几何交叉验证**，**API 本身未经真跑背书，按未验证计**，请复跑时留意这三处。

---

## 四、全库 tie 覆盖率审计（真 GDS 第一手）

`gds_probe --tap-ties`：对每个 `ptap1` 实例算 tie 世界框，在**去掉全部 ptap1** 的平铺
几何里找与它重叠最多的 `8/0`，算覆盖率。

| GDS | ptap 只数 | 最低覆盖 | 判读 |
|-----|---|---|---|
| `m3_drv1_v20.gds`（旧面基准） | 0 | — | 本来就没有 tap |
| `m3_drv1_v21.gds`（新面锚） | 2 | **15.40%**（0.0462/0.3000） | ⚠ 压一角 |
| `m3_drv2_v18.gds` / `m3_drv2_v20.gds` | 8 / 8 | **100.00%** | ✓ 全覆盖 |
| `m2_mix_v27.gds` / `m2_mix_v31.gds` | 8 / 8 | **100.00%** | ✓ 全覆盖 |

**结论：缺陷是 drv1 独有的**，因为 drv2/mix 的 tap 摆在**自画 M1 护环中心线**上，
环宽 ≫ tie ⇒ 整个盖住；drv1 没有环，只能靠 via 焊盘，而 via 又打在实例原点。
⇒ **drv2 v22 / mix v32 本轮零改动**（不是「查过没问题」，是「量过且已记录」）。

---

## 五、我自己踩的坑（比结论更值钱的部分）

1. **分流顺序反了，静默出错**：`_disp_um` 首版先查 `.disp`，而我仿真层的 `.disp` 也是
   µm，被当 dbu 乘了 0.001 ⇒ 实例原点 14.0 变 0.014。**是断言②当场炸出来的**，
   不是自查发现的。这条正是「有牙」的用法：错得响。
2. **GDS 记录格式**三个坑（§二表）。
3. **仿真层替身会骗人**：自造 0.80 见方垫在原点 ⇒ 自检全绿，而真件 tie 在 +0.39。
   凡「PDK 内部几何」，替身必须照真值画，否则自检只是自说自话。
4. **差分器报 FAIL 不要改判据**（§三）。

---

## 六、请组长复跑盖章的清单（按优先级）

1. **drv1 v2.3**：`gen_M3_drv1_v23.py` + `drv1_subckt_LVS输入_v5.sp`。
   预期：**LVS 仍 PASS**（拓扑零变化，只有 tap 实例落点挪 0.39）；
   **DRC 不新增**（据 §三量测，四个方向余量都 ≥4.25µm）；**GDS 几何差分**只应是
   两只 ptap1 实例原点各挪 (−0.39,−0.39)。
2. **衬底判据照旧**：若提取网表里 `$1` 重新出现 ⇒ tap 掉出浮空岛，回滚粒度＝落点。
3. **三处 API 真跑背书**（§三③）：这是我这轮唯一**没有第一手证据**的部分。
4. **UNITS 记录非物理**（§二）：请核 GDS 写出端，别让下游按 7.98e-33 m 读坐标。
5. `gds_probe_b7e7.py` 若与你们现役工具口径有冲突（尤其顶层内部层号 ↔ PDK 层号映射），
   请指出，我按你们的口径改。

---

## 七、附：本轮机检结果（自证，非官方 DRC）

- `preflight_b7e7.py gen_M3_drv1_v23.py` → **PASS**（器件 34 / 标注 48）；
  ⑯⑰⑱ 宽度/网格/间距 FAIL=0；⑲ 平台净距 0；⑳ 0；㉑ 落柱悬空 0；㉒ 0；
  **㉓ 8 条带金属 × 29 块顶层 M1：同网 13 / 异网 9 / 不可判 0，硬档 0、软档 0**。
- `check_layout_gen gen_M3_drv1_v23.py` → `ok=true`，`issues=[]`，⓪ 库闸对齐 `3ab35cde`。
- `lvs_source_audit`：`drv1_subckt_LVS输入_v5.sp` 形态 ok（R9/Q4）；`pair(v4,v5)`
  **拓扑等价 PASS**。
- `check_netlist_dc`：ok。
- 断链测试：tie 挪 +0.15 ⇒ `TAP-ASSERT ⑤` 报「只盖 70.0%」并 AssertionError；复位 ⇒ PASS。

**我不担保的**：官方 DRC 终裁、pwell 连通域（PDK 分析器才有）、以及 §六③ 的 API 真跑。
