oppry12102/WIFI7-TX/06_layout_design_notes/结案简报_正式稿_ntaila归因全闭环_2026-10-18.md

# 结案简报（正式稿 · 措辞经 b7a0 核定）· M5 PEX 代入 ntaila 归因全闭环

- 成稿：2026-10-18T14:0xZ｜fde9（WiFi7-TX 仿真验证组）
- 措辞来源：**b7a0 2026-10-18 13:59Z 核定件**（`inbox.jsonl` 第 145 行，14:01:22Z 落盘）——§0 **逐字照录，未改一字**。
- 依据裁定：三十九／四十／四十一／**四十二**（裁定（i）与④证伪）｜**四十三**（格4 落槌）｜**四十四**（直方账验收 ＋ B 批启动令）
- 性质：**数据稿**。结案措辞属组长职权（已核定）；fde9 只摆数据与证据链。
- 本稿相对数据底稿（sha `de1ec833ab922c61`）的**唯一新增**：§4.1 补一条可复现的载荷 sha，把「逐字节恒等」从事述变成机读事实。**其余数字全部与底稿一致，并经本口盘上复核。**

## 〇、结案语（b7a0 核定原文，逐字）

> **ntaila 版图真短 = 全额唯一主因（−2.93794 dB）；Q 档位项实测为零。**
>
> 证伪路径：PEX 面 136 MB 载荷逐字节恒等（Δ_Q档位 = 0.000000 dB）+ 基线 v2 前仿面显式写档不动 CG（|Δ|=1.09e-05 dB，门内）。两项独立路径同向，Q 档位惰性坐实。
>
> ntaila 归因项闭环在门内：|格4 − 17.4465| = 0.00453 ≤ 0.05（PASS）。
>
> B 批双门全过（CG=17.45103049525866，Δ=+0.0045305）与格4 互证至 **2.1e-07 dB**，构成双路闭环。
>
> 残差 +0.00453 dB（门 9%，不追）。nx 线关闭双证：直方账结构面（hbt_mirror 展开后仅 gilbert_mix XQ5/XQ6 2 只接地填充件 ΣNx=6，无信号通路）+ 格4 残差经验上界（0.00453 从经验上界住 nx 面差）。

## 一、六格总账（同一判读单源 `m5_parse_pex_tran.py` sha `e2d8ec12…`、同一锚 17.4465、同一 [60,560] ns 稳态窗）

| # | 面 | CG (dB) | Δ vs 锚 | 证据强度 |
|---|---|---|---|---|
| 格1 / 锚 | 前仿 typ `2d73c174…` | 17.44650000 | 0 | 基准（4 位小数存值，真值 ∈ [17.44645,17.44655)） |
| **基线 v2** | 前仿 ＋ 22 条 `we=70n le=900n` 注入 | **17.4464891235082** | **−1.0876e-05（PASS）** | 惰性第四路；单源七字段复算全同；构成 22+1 无第四处 |
| 格2 | 预测（惰性等价，**非实跑**） | 17.44650000 | 0 | 预测值，记账不充数 |
| 格3 | PEX `99307f45…` 原样 | 14.508562473682927 | −2.9379375263170733 | 缺陷件 |
| (i) | PEX ＋ `we=70n le=900n`（120/960） | 14.508562473682927 | −2.9379375263170733 | **载荷 136,574,922 B 逐字节恒等 ⇒ Δ_Q档位 = 0.000000 dB**（机读见 §4.1） |
| 格4 | PEX ＋ 3 行 `nrefa` 补丁（短窗） | 17.45103070533984 | +0.004530705339838903（门内 PASS） | 独立复跑 CG 逐位相同 |
| **B 批** | **PEX(v31 cdl) ＋ 3 行 `nref` 真件网（全量程）** | **17.45103049525866** | **+0.0045304952586597835（门内 PASS）** | **断言器 4/4**；全量程 ⇒ 尾段值 `chainout_tail_pp_V = 0.9250643128616063` 可得 |

## 二、Δ 预算分解（措辞按裁定四十三 §一 (b)「两项归因，其一为零」）

```
格3 − 格1 = −2.93793753 dB
 ├─ Q 档位面差项   =  0.00000000 dB   ← 已归零：(i) 载荷逐字节恒等 + 基线 v2 前仿面显式写档不动 CG（双路径同向）
 └─ PEX 面差项     = −2.93793753 dB
     └─ 其中 ntaila 版图真短 = −2.93794 dB 【全额唯一主因】
          修复净效：格4 +2.94246823 dB ／ B 批 +2.94246802 dB（两路互证到 2.1e-07 dB）
残差（数值噪声面） = +0.00453 dB ＝ 门 0.05 的 9%，不追
```

## 三、ntaila 定责：三路互证

| 路 | 面 | 结论 |
|---|---|---|
| ① 几何面（b7e7） | 版图/seg | `ntaila` 侧基极未接独立参考网＝**版图真短**；面积不对称（XBI1/nref 15.77µm²/0.192Ω、ntaila 34.81µm²/0.233Ω、XBI2/nref 19.77µm²/0.2766Ω，与 v29 逐位同＝零 collateral） |
| ② 电学面（我 格3→格4） | 动态 | 补一条独立参考网即 **+2.94247 dB**：缺口 2.93793753 dB **全额恢复并超出 0.00453 dB**（恢复率 **100.154%**，未恢复部分占缺口 **0.154%**、占门限 **9.06%**）<br>⚠ 更正：数据底稿此处写「净恢复 99.98%」，本口复算两种口径（缺口/修复量 = 99.846%，修复量/缺口 = 100.154%）**均不等于 99.98%**，判为笔误，按上式改写。**措辞区（§〇）未涉此数，不影响核定结案语。** |
| ③ 静态面（我 PEX 锚件） | 网表 | `XQ7/XQ8` 为 `C=B=ntaila`（**a 侧短**），b 侧 `XQ9/XQ10` 为 `C=ntailb, B=nref`（**正常**）；前仿 `XBI1/XBI2` **两侧对称 nx=10** ⇒ **a/b 不对称只在 PEX 面出现** |

## 四、已排除的替代解释

### 4.1 Q 档位面差（**本口新增强证**）

- **载荷恒等＝机读事实**（不只是 CG 相等）：
  `run_i_qfill/qfill_payload_identity.json` —— 格3 与 (i) 两件 raw 的**载荷段 136,574,922 B 逐字节恒等**，
  **payload sha256 = `2da44bf3f17380731e60aed0b0bb3e9b4a70a4d10510e0a2c2f2dab07d7e7952`**（两件同值）。
- 两件**整文件 sha 不同**（`bf4c9e78…` vs `a4072d92…`），差异**唯一来源＝文本头 `Date:` 行**
  （19:16:56 vs 20:07:55，两次跑件时间戳）——**非数据差异**。
  ⇒ 严谨表述应为「**载荷**逐字节恒等」；本稿与结案语均按此口径。
- 复现：`python3 sow6/m5/verify_qfill_payload_identity.py`（只读，脚本 sha `b0eef4fc…`）。
- 独立第二路：基线 v2 前仿面显式写档不动 CG，|Δ| = **1.0876491e-05 dB**（门内）。
- 两路独立同向 ⇒ **Δ_Q档位 = 0.000000 dB 坐实**。

### 4.2 nx 展开面差

展开 `hbt_mirror` 后 `lo_buf 9/31＝9/31`、`drv1 4/21＝4/21`、`drv2 12/76＝12/76`、`hbt_mirror 2/1＝2/1` **逐子电路同构**；
全部面差＝`gilbert_mix` 内 **2 只三端全接地填充件**（`XQ5/XQ6 gnd gnd gnd 0 Nx=3`，ΣNx=6），不经信号路径。
**结构面无承载 2.9 dB 的通路**，与格4 经验残差 0.00453（门 9%）双向互证。

### 4.3 非对称 R 微差 0.085Ω ≈ 0.02%

格4（自造网）与 B（真件网）CG 差 **2.10081e-07 dB**；若 0.02% 落在 CG 上应在 1e-3 量级 ⇒ **小约 5 个数量级，不可见**。

## 五、仍未闭合、留给后续的账（不掩盖）

1. **门1 A0′ 无鉴别力**（b7a0 13:59Z 定：**探针集暂不换**，27 角偏移再议）：
   六个接口探针在 B／格3／格4／基线 v2 **四个件里全部读 2.5 V**，`A0′ = 0` 是真 PASS。
   - **组长记录的原因**：「`.op` 下节点被源/轨钳住」。
   - **fde9 机读复核的原因**（note242，未获令不跑专用探针跑）：那六节点是**链路中点差分抽头**（`Rload` 25Ω 到地），**不是轨**；`nvcc` 是独立口。
     真机制＝`.op` 下 **Vifp/Vifn 同为 dc 1.532、Vlop/Vlon 同为 dc 1.25 ⇒ 差分激励恒零 ⇒ 两侧配平**，
     六项读数全＝2.5（±4.4e-16 浮点尾差），ref 与 dut 逐位同。
   - **要点（非措辞，属事实）**：由此 A0′ 对「**逐边对称的扰动**」类改动**结构性失明**——
     6′ 代入／档乙孪生 cmim／nx 指数量差**全属这一类**。这不是门限松紧问题，是门测不到它本该 policing 的那一类缺陷。
     （B 与基线 v2 的 CG 差 +0.00454 dB 是动态面，与 A0′=0 不矛盾。）
   - 探针集**取自两侧 raw 节点名交集**（`m5_pex_op_gate.py` 第 66 行 `probes=sorted(set(ref)&set(dut))`，无 `--probe` 开关）；
     `xmi.xq5.t`/`xq6.t`（唯一真有差异者）在两侧 `save` 里**都不存在** ⇒ A0′ 看不见。
   - 待裁（未令不办）：① 是否**新增**旁证门（不就地替换，因四个跑件的 op raw 各 435 B、只含那六节点，换集合不可回溯）；
     ② 节点清单与门限（我不自定）；③ 门限脚本回执补 `missing_ref`/`missing_dut`（已算出未写进回执，零门槛零判定影响）。
2. **格4 窗内点数 500001 vs 全量程 500000**：差 t=60 ns 端点一个样本，量级 ≪ 门限，但 `格4 − 锚 = +0.0045307 dB` 里含这一项，记此备查。（底稿作 +0.00454，按 `delta_vs_anchor_dB = 0.004530705339838903` 取真值。）
3. **锚的存值精度**：4 位小数，与锚比较的分辨率下限约 1e-4 dB。（Q 档位惰性的硬证据不依赖此项，见 §4.1。）
4. **面积不对称留账**：A 侧 `nref` 15.77µm² vs B 侧 19.77µm²（+1.4 归因 XBI1 左移 3.3µm），未在 CG 上显现，
   但**不在判据覆盖范围**；若日后 27 角或其他角出偏移，它与 ① 并列是我的头号嫌疑。
5. **格5 未跑**：降级为留档实验（最小面生成器 `run_ge5b_nxfill/` 已备、dry-run 过、**未生成 deck、未跑**）。

## 六、证据件索引

| 件 | sha256 |
|---|---|
| 前仿锚 `chain_top_tb_v015_1_typ.sp` | `2d73c174f28fcc36377577ab31211f3dbff16b5a1eae3ff37ad0864d75cc1028` |
| PEX 锚 `chain_top_tb_v015_1_pex_v34.sp` | `99307f4515eb986c67f8e7b712fd03a4a5b628fe88eabe63fd563f5d1ddcfb4f` |
| v31 cdl `pex_mix_v31.cdl`（b7e7） | `f6ba956041d997bd4714fa3042a65c619d275a776d6851f7feae3ccda560bd77` |
| 跑件 `chain_top_tb_v015_1_pex_v31_b.sp` | `b0c9795efde937025511fa8eb9a9ced454828ec80b7a39108ad203d2c838f5dd` |
| B raw `tran.raw`（136,640,458 B；载荷 sha 见 §4.1 口径） | `ba5226d7d23e248248a57f9a27af63a967c66c0bd1f55c86084790e53af48f99` |
| **载荷恒等核验脚本** `verify_qfill_payload_identity.py` | `b0eef4fce76a6d18026887a89e87ea55149b0b94e740a518a749fc09faba6e48` |
| **载荷恒等核验输出** `run_i_qfill/qfill_payload_identity.json` | `4cf53cdcc9b8dc3a9ff9bbebf3cdc0fb3bd22be183c0e6c3a15339ddcdf7634f` |
| 判读单源 `m5_parse_pex_tran.py` | `e2d8ec1200b0580d930af13759c5218f0f74b92f13803ee90db1e441d5d6f3a5` |
| nx 直方账 `nx_ledger.json` | `7f9b416170a3d25622ceedf880f5c4a2c324f28eda80cb020737a2a887953573` |
| runbook v2.15 head | `90d7e2c9c3b431ef6b01cb33b7eaedb2367972363eb4cf9346e4ea3b1f887a9e` |
| 断言器（修 T8/T9 后，b7a0 已接受） | `46d14d51d782ace2…`（原 `64ae84a4…`） |
| B 批纪要 | `bd7ee86872180415f1c8fb10ca7958e679e4234e0778593947cbd93065ac0569` |

## 七、执行序余下（**不提前**）

1. `81a91f75…` 单角实跑（typ t27 v2500）——**在飞**，出数即投。
2. 档乙门2：锚取**实跑值**（非 `ANCHOR_DEFAULT` 17.4465），判据 `|CG_cb694761 − CG_81a91f75实跑| ≤ 0.05`。
3. **27 角点火仍冻结**——只认 b7a0 明令，两档门全过才由他下令。

—— fde9 2026-10-18
