oppry12102/WIFI7-TX/02_spec_and_reports/integration_review.md

# 集成评审工作底稿（integration_review.md）

- 主持：组长 b7a0 | 开始：2026-10-15T10:41Z | 状态：**主体裁决完成**（R-01~R-10 全落），
  待 fde9 终版材料（OFDM/PVT 复核、LO 标定、全文）与 b7e7 文档 v1.2 同步后进入终稿集成
- 输入：spec v1.1→**v1.2（冻结）**、architecture v1.0、design_circuit/*（b7e7，v1.1 已复现 PASS）、
  b7e7 统一口径复算信（10:49Z，含 5 项裁决请求）、fde9 SOW-2 摘要
- 评审纪律：一切关键数字独立验算，不轻信自报；口径冲突当场裁决并记录在案。

---

## R-01【已闭环·待 fde9 标定交叉验证】LO 相噪 → EVM 换算（口径 B 采纳）
- 标准小角推导：EVM² = 2∫L（1k–100M，不扣 CPE）；**EVM_LO = IPN_dBc + 3.0 dB**。
- 裁决：spec v1.2 全链预算统一按 B 口径；分配行 LO_IPN = **−45 dB**（= spec §8 IPN ≤ −48 dBc 的 B 口径等价，
  消除 v1.0「IPN 直接当 EVM」的源头含混，责任记组长）。
- b7e7 设计值 6G −44.1 / 2.4G −45.1 → 6G 违分配 0.9 dB，**RSS 判据兜底**（见 R-05 判据声明）。
- CPE 跟踪（导频扣共模相位，可回 3–6 dB）列为数字前端可选增益，不进验收基线。
- 闭环剩项：fde9 LO 行单独标定值（与 b7e7 交叉）；b7e7 B 口径参考源敏感性结论（R-01 信件条件②④）。

## R-02【已闭环】+16 dBm 档与 PA 统一口径（P1dB=+26、Rapp p=3 + AM-PM 3°）
- 6G/320M/4096-QAM 档 +16 dBm（BO 10）：PA 块裸 −38.7 dB → DPD20 后 −57.2；
  6G 全链 RSS **−44.4**（目标 −41，裕 3.4）；功耗 864 mW < 1000 ✓。
- ~~P1dB=+26 反推 Psat=+32.9 dBm，落 architecture 的 +32(6G)/+33(2.4G) 之间——OQ-2 与架构自洽，关闭~~
  **【v0.95 挂起重开 → R-11】**：fde9 11:11Z 对照质疑——该反推仅对 Rapp **p=1** 形状成立
  （p=1 时 P1dB−Psat=6.9 dB）；p=3 下 P1dB−Psat≈1.0 dB → Psat≈+27，与 arch 假设差 ~5 dB。
  BO=8 交叉验证 0.2 dB 强烈提示代码实际 p=3、b7e7 文字公式漏写 2p 指数。等 b7e7 查代码后处置（R-11）。
- fde9 波形级 −41.8（+DPD+成形+16）与解析 −44.4 之差在模型保真度预期内（记录，不改判）。

## R-03【已升级 v1.2】DPD 纳入架构 · 门限按频段分级
- v1.1 单一门限 15 dB 作废（S13 v1.2）：**6G 验收 ≥12 / 目标 ≥15；2.4G 验收 ≥15 / 目标 ≥20 dB**。
- 依据（组长按调制分级口径独立验算）：6G 红线仅需求 1.9 dB（LO 行主导，DPD12 后 RSS ≈ −43 仍过目标）；
  2.4G 满功率档目标 −38 需 DPD ≈15.3 dB（VGAMIX+LO 地板已占 −41.1 能头的反向推算），
  验收 15 保红线、目标 20 稳过（DPD20 → PA −44.5，RSS −39.6）。
- DPD 预算口径改 **105 mW**（60 + 反馈 ADC 25 + RF 反馈 10 + 训练 10；功控复用反馈 ADC 省 ~10 mW 列优化项，预算仍按 105 保守）。

## R-04【已裁决，结果待收】SEM 掩模授权：fde9 按公开文献完整折点复核 320 MHz 掩模。

## R-05【已裁决·v1.2 判据声明】（功控校准 1.42 dB PASS、2.0 V 厚氧批准——沿用）
- **验收判据 = 全链 RSS**（含 PA，各档各自口径）；块级分配表为**设计引导值**——单行不达标而 RSS 达标
  时以 RSS 为准，但须在文档标注偏差与机理（b7e7 VGAMIX 2.4G −45.3 vs −46 即此情形）。
- **EVM 口径按调制分级**（v1.2 §2 新增 S3a）：红线 256/1024-QAM = −35、4096-QAM = −38（规范）；
  目标 256/1024 = −38、4096 = −41(6G/5G) / **−40(2.4G)**。
  依据：b7e7 复算信把 −38/−41 直接用于 +23 dBm 档属口径错位（+23 档为 ≤256-QAM）；
  2.4G 4096 目标 −40 落 OQ-6 允许区间（−38~−41），依据 = LO 相噪频段差 8 dB + VGA 变形项 + 静态模型局限。

## R-06【已闭环·头条】12.7 dB 口径差定位与三口径统一
- 根因：旧三次方口径只统计三次互调产物，**漏增益变形项**（基波增益误差 ≈ 3×IM3，叠 AM-PM）。
- 三口径对照（BO=8, Pout=+18, P1dB=+26）：仅IM3 −53.7 → +变形 −31.7 → Rapp+AM-PM **−33.1**
  vs fde9 行为级 **−33.3**（差 0.2 dB，交叉验证成立）。旧「PA 分配 −46」确认物理不可达（数错项，非设计错）。
- 裁决：PA 行 v1.2 分配 **−43 dB（含 DRV）**；行为级 −44.5@DPD20 留 1.5 裕量。
- 局限声明（必读）：Rapp+AM-PM 静态无记忆模型，OFDM PAPR 峰值压缩与记忆效应未显式建模
  ——2.4G 裕量最大不确定项，fde9 全 OFDM+PVT MC 复核中（§8.7）。

## R-07【已裁决】2.4G 分档修订（EVM/功率/功耗三联动）
- **2.4G 4096-QAM 满档 +20 → +19 dBm**（v1.2 §4）：多 1 dB 回退换 EVM/功耗双裕量；
  2.4G 4096 本为短距用例，+19 无产品定义损失。全链 RSS @+19 预计 ≈ −40.3~−40.6（待 fde9 复核定案）。
- **S8：2.4G 功耗上限 0.8 → 1.0 W**（与 6G 同域一致）：β=0.6（Class-AB 保守基线，非 β=1 乐观假设）
  下 +23 档 944 mW < 1000 ✓；全局热包络 1.0 W；β=1.0（恒定 PAE）列优化路线不进基线。
- 2.4G 满功率档（+23，≤256-QAM）EVM：红线 −35 裕 5.7 / 目标 −38 裕 1.6（@DPD20）——PASS。
  功耗若将来须回 0.8 W，降档路径：+23→+22（822 mW）→+21（716 mW），写入 §4 注记。

## R-08【已裁决】VGAMIX 分配重议 −48 → −46
- 依据：VGA 自身 AM-AM/AM-PM 变形为新发现项（b7e7 §8）；6G 实际 −49.3 裕 3.3 ✓；
  2.4G 实际 −45.3 违 0.7 dB → RSS 判据兜底（R-05 声明）+ 设计引导改善 0.7 dB。
- 配套：LO_IPN 分配 −45（R-01）；DAC −50 / LPF −55 / IQ_MM / LOFT −52 不变；PA −43（R-06）。

## R-09【已裁决·采纳 → v0.95 位宽修订令】数字资源方案
- 谱成形 FIR 911 tap：全速 1.28GS/s 6b = 350 mW / 2.83 mm² **否决**（占整链 35%）；
  **对称折叠 + 4b = 88 mW / 0.91 mm² 采纳**（params 130 tap 折算留裕量）；2.4G 多速率 160MS/s = 11~22 mW。
- 数字合计 6G ~290 / 2.4G ~136 mW，面积 ~2.0 mm² ——已并入 v1.2 功耗账（R-07 验算自洽：864−290=574 模拟/PA；944−136=808 ✓）。
- **【v0.95 修订令】**：fde9 行为级位宽硬数据（s6_fir_bits.py / §5B）——数据通路 4b→ACLR 仅 15.5 dBc（需求 45，FAIL），
  5b→21.4 / 6b→27.3 / 8b→38.5 全 FAIL，每 +1bit≈+6 dB → **数据通路 ≥10b** 才够；系数 8b 阻带噪底 −24 dB、
  10b→−35.6、12b→−48 → **系数 ≥12b** 才保 60 dB 阻带。据此「折叠+4b=88 mW」**作废**（折叠结构保留——线性时不变
  等价实现零行为级影响；死穴在位宽）。令 b7e7：①按 ≥10b 通路 + ≥12b 系数重估功耗/面积（乘累加代价随位宽超线性，
  勿线性外推）；②对比方案 B：数字粗成形（低阶 FIR）+ 高选择性模拟滤波重新选型（现 4 阶 fc=176M 在 ±320M 仅 ~21 dB）。
  数字合计与 v1.2 功耗账随重估联动改写。2.4G 多速率 160MS/s 思路不变。

## R-11【v0.95 立项·b7e7 必答】PA 模型标定链疑点（Psat 反推挂起）
- fde9 11:11Z：b7e7 信中 Rapp 写法 A(r)=r/(1+(r/r_sat)²)^½ 是 **p=1 形状**（p=1 时 (1+r^{2p})^{1/(2p)} ≡ (1+r²)^½）；
  p=1 下 P1dB−Psat=6.9 dB → Psat=+32.9 反推自洽；**p=3 下 P1dB−Psat≈1.0 dB → Psat≈+27**，
  与 arch 假设 +32(6G)/+33(2.4G) 差 ~5 dB。BO=8 交叉验证两岗仅差 0.2 dB → 强烈提示代码实际用 p=3、
  文字公式漏写 2p 指数（若如此仅勘误即可）。
- 裁决：①b7e7 查 budget_check.py **代码实际指数**（1/2 还是 1/(2p)）——查代码不查注释，必答；
  若真是 1/2（p=1）：标定链重推，0.2 dB 巧合不得蒙混，立即通报两岗。②R-02 的 Psat=+32.9 自洽结论挂起。
  ③若证实 p=3：arch PA 能力假设（+32/+33）与行为级（+27）的 gap 列开放项，处置二选一
  （arch 收紧 Psat 假设 / 行为级加软压缩参数对齐 arch），b7e7 给技术意见。
- **结论边界**：两岗全部工作点以 P1dB=+26 锚定（BO 相对 P1dB 定义），EVM/ACLR/RSS/功耗结论一概不受影响；
  动的只是「距饱和多远」的叙述与 arch PA 尺寸假设。

## R-10【待收】终稿前开放项（不阻塞冻结，阻塞 final_report 定稿）
- [ ] fde9：2.4G 全 OFDM 波形 + PVT MC 复核（4096 档 **+19 新档**、DPD15/20 两点、静态模型局限量化）
- [ ] fde9：LO 行单独标定值（vs b7e7 −44.1/−45.1）；SEM 复核结果（R-04）；终版报告全文
      （v0.95 起其已开 /files 只读面，file-key 分发中；SOW-2b=2.4G OFDM+PVT 已立项，参数单已批）
- [ ] b7e7：design_circuit 文档按 v1.2 同步（§0/§4/§6/§8：分级口径、+19、S8 1.0W、DPD 105、分配表 v1.2、FIR 折叠结论）
- [ ] b7e7：**FIR 位宽重估**（R-09 修订令：≥10b 通路+≥12b 系数，方案 B 对比）——params 数字行随之改写
- [ ] b7e7：**PA 模型代码自查**（R-11 必答）+ arch Psat gap 技术意见
- [ ] b7e7：参考源 B 口径敏感性终结论（维持 f_ref≥100M / L(100k)≤−158 与否）

---

## 设计 ↔ 仿真对账表（v1.2 口径，6G 320M 4096-QAM +16 dBm 档）

| 块 | v1.0 分配 | b7e7 设计(旧A口径) | fde9 波形级 | B 口径设计值 | **v1.2 分配** | 判定 |
|---|---|---|---|---|---|---|
| DAC | −50 | −53.0 | （等效加噪） | −53.0 | −50 | PASS 裕 3 |
| LPF | −55 | −58.0 | （等效加噪） | −58.0 | −55 | PASS 裕 3 |
| VGAMIX | −48 | −69.3 | （等效加噪） | −49.3 | **−46** | 6G PASS 裕 3.3；2.4G −45.3 违 0.7 → RSS 兜底（R-05/R-08） |
| LO_IPN | −48(含混) | −50.1(A)/−44.1(B) | **待标定** | −44.1(B) | **−45**(=IPN−48 B 等价) | 违 0.9 → RSS 兜底；fde9 标定交叉验证中 |
| IQ_MM | −52 | −55.0 | （等效加噪） | −55.0 | −52 | PASS 裕 3 |
| LOFT | −52 | −55.0 | （等效加噪） | −55.0 | −52 | PASS 裕 3 |
| PA(含DRV,DPD20) | −46 | −49.5(旧口径，作废) | −33.3(裸,+8回退) | −57.2(@BO10) | **−43** | PASS 裕 1.5（R-06） |
| **全链 RSS** | −40.8 | −44.69 | −41.8(+DPD+成形) | **−44.4** | ≤ −41(6G 4096) | **PASS 裕 3.4** |
| PVT MC max | 红线−38 | 未覆盖 | −39.7(6G,+16档) | 待 | 红线 −38 | PASS 裕 1.7（fde9 扩 2.4G 中） |

**2.4G 对账**（+23 满功率档，256-QAM 口径 −35/−38）：RSS −40.7（b7e7 解析）/ 4096 档 +19：预计 −40.3~−40.6 vs 目标 −40 —— fde9 OFDM+PVT 复核定案中。

---

## 待回收清单（按铃即办）
- [ ] fde9：OFDM/PVT 复核（R-10①）+ LO 标定 + SEM 结果 + 终版全文
- [ ] b7e7：文档 v1.2 同步（R-10③④）——完成后其交付冻结
- [ ] 回执齐 → final_report.md（集成 spec v1.2 + arch + 两岗交付 + 调研附录）→ send_mail 报备管理员
- [ ] v1.0→v1.2 变更已报备（本口 send_mail）

## R-12（v0.97 新增，2026-10-15T12:00Z）：PA 块预算锚定——解析 vs 波形级 10 dB 分歧终裁

**分歧**：b7e7 budget_check v1.2（标准 Rapp p=3 修复后）PA@BO8=−43.6 dB（AM-PM 主导）vs fde9 波形级
p3_ampm3deg@BO8=−33.3 dB（s1 sweep），差 10 dB。b7e7 params 注「AM-PM 参照点不同结果差 10 dB（§8.3）」。

**组长定位（数值复核）**：
1. AM-PM 统计口径：解析用 rms 相位 φ=φ_pk·(r_rms/a1)²；随机调制（瑞利场）正确口径为四阶矩
   E[θ²]=2φ_pk²·(r_rms/a1)⁴——BO8 下差约 3 dB。
2. 解析法无 AM/AM 峰值压缩项：p=3 压缩极陡（t_P1dB=0.9992，P1dB≈Psat）+ PAPR 10.5 dB，
   峰值样本（BO8 时 2.5σ 起）深入压缩区，波形级联合失真再差约 7 dB。

**裁决**：EVM 预算 PA 行以**波形级实测锚定**（6G@BO10 无DPD=−40.8 / @BO8=−33.3，fde9 s1 已声明
「预算 PA 行按实测重写」）；budget_check.py 引用锚值或实现 E[θ²]+压缩修正，解析值降级为趋势/敏感性参考。
推论修正：6G 无 DPD 全链≈−37.8 dB（FAIL 红线 −38 约 0.2 dB）→ **DPD15 必要性维持**
（fde9 DPD15 全链 −42.7 ✓ 目标）。AM/AM 形状修复的改善真实，但不据此免 DPD。

**同批裁项**：R-09 终裁 B′（127tap 12b/12b 折叠+模拟 6 阶，整链 805 mW；案 A 不可行、B″ 风险不成比例均成立）；
R-11 闭环（形状族写错+行为等效 p=1 判定成立；Psat=+27~+29 改器件声明口径——「p=3→P1dB−Psat=1.0 dB」
恒等式系 P1dB 定义的同义反复，标准 p=3 严格推论 Psat−P1dB=+0.003 dB）。

**连带挂起**：fde9 s7 记忆效应（ρ≥0.4 静态 DPD 崩）→ 2.4G EVM 判定挂起，转 b7e7/fde9 联合评估
（记忆模型合理性 + DPD 引擎 GMP 化预算）；fde9 s7 LO 行用旧 ∫L → 换 R-01 终裁值 −47.1/−48.1 重跑。

## R-13 §9.6 终版分配表收货（组长 b7a0，2026-10-15T12:10Z）

**背景**：11:25Z 八项终裁后，b7e7 11:53Z 信宣告 §9.6 落地（「②①③⑥⑦⑧」），12:00Z 组长评审包裹在途交叉。组长对 /files 取回的 design_circuit.md v1.2+§9.6、params.csv、scenario_24g.py 逐项核验。

**收货确认**：
1. **终裁③** +22 推荐工作点行 ✓（params L161 档位映射 + scenario S3 + §9.6-1 行：−45.6 dB / 868 mW β0.6 / 711 mW β1.0）。
2. **终裁④** β=1.0 ✓ 实质落地（预算按 β=1.0 收；β<1 降 +21 保留运行点、SOW-2b PVT MC 覆盖）；表头「规划/基线」措辞残留待正名。
3. **终裁⑧** VGAMIX 二选一 ✓ 采纳「修复后裕 23.3 ≥2 → 补足转 PVT 裕量池不启用」（实质=撤销授权，省 6 mW）。
4. **自查修正**（§9.6-4）：S3 标签 +22 实算 +17 dBm 的 K_G 错位——修正+全量复跑+透明记档，处置合格；+19 档数据出自 budget_check 直跑不受影响的申明，组长复核认可。

**残留两行（编号错位发现：b7e7 将终裁⑥误读为参考杂散注记落地）**：
- **① DPD gate 表未动**：params L30-33/L40-41 仍旧分级（6G 12/15、2.4G 15/20）→ 终裁①=6G 验收 20 / 2.4G 验收 22（21 底线注记），goal 行注「工程目标、不计验收」。
- **⑥ pll_bw_hz 未动**：params L129(g56)/L178(g24) 均 8e5 → 终裁⑥=两带 1.6e6（LO 6G 复算预期 −47.7）。
- 12:10Z 回执令已发：两行落地 + 全脚本回归 → v1.2 即完整，/files 静默更新即可。

**定位声明**：电路预算级 2.4G 判定转 **PASS**（§9.6 推荐工作点）；波形级 2.4G 判定仍挂 PA 记忆效应（R-12 连带挂起项），两层独立不互阻。final_report v0.98 已同步。

## R-14 b7e7 v1.3 收货复核 + R-12 措辞勘误（组长 b7a0，2026-10-15T12:40Z）

**收货**：12:30Z 信 + /files 五件（design_circuit.md / params.csv / budget_check.py / scenario_24g.py / mem_effect_study.py，
Content-Length 逐一核验无截断）归档 incoming/b7e7/。逐项核验：
1. 终裁① gate：g56 dpd_gate_db=20 / g24=22（21 底线注记），goal 行「工程目标不计验收」✓（params L41-44；sys 回退行 L56 取 max=22）。
2. 终裁③ p_out_db_rec=22 @DPD22@BW1.6M ✓（L61）；④ pdc_backoff_exp=1.0 基线/0.6 降档 ✓（L58）；⑥ pll_bw g56/g24 双 1.6e6 ✓（L146/L195）。
3. **g24 pll_bw 1.6e6 延伸——批准**：§9.6-1 2.4G 工作点口径本为 BW1.6M（LO −49.1），params 旧值 8e5 与文档不一致，同步正确。
4. Psat 再勘误三处同步 ✓（L47 note「+27~+29 器件声明口径」；「P1dB−Psat=1.01 dB 恒等式」已清除）；B′「待终裁」注记去除 ✓。
5. R-12 锚定实现 ✓（params L51-54 双锚 −40.8@BO10 / −33.3@BO8，斜率 3.75 dB/BO；2.4G 锚行挂空待 fde9）。
   本机复跑 budget_check v1.3：g56 --dpd 0 exit=1（无 DPD FAIL 预期证据）、--dpd 15 全链 −44.88 PASS——与信面数字一致。
6. S0「BW800k」标签实算 1.6M 自查修正合格（§9.6-5；S0=−45.35 / S1=−45.82，BW 收益 0.47 dB 正确显形）。

**R-12 措辞勘误（组长自查，透明记档）**：初稿「无 DPD 全链≈−37.8 FAIL 红线 0.2 dB」系快算块集（DAC−50/LPF−55/VGAMIX−46
分配值 + 旧 LO −47.1@800k + IQ/LOFT −52）。以 v1.3 锚定块表为准（设计值 −53/−58/−75.3 + LO −47.7@1.6M）：
**无 DPD 全链 −39.5 = 红线 −38 过（裕 1.5）/ 目标 −41 与 PA 分配 −43 FAIL**；DPD15 后 −44.9 双过。
**结论（PA 行锚定 + DPD15 必要性维持）不变**；1.7 dB 差异全额归因块集口径，无技术分歧。

**§9.8 记忆效应联合意见——采纳为 2.4G 仲裁协议**（final_report §6.2 已录）：M1/M2 拓扑区分、
mem_energy ≤−18.2/−21.6 dB 阈值（ρ≤0.061/0.041）、GMP 剪枝版 44 mW 备选（全交叉 114 mW 需专项批）、三层解挂条件。
2.4G EVM 判定挂起维持至 fde9 s7 拆分重跑。

**待办微注（不阻塞）**：①params L146 注「LO_IPN −47.1 终裁值按此口径」易误读（−47.1 为 800k 口径、1.6M 为 −47.7），请 b7e7 下版改写；
②budget_check 全链行 PASS/FAIL 按红线判定、margin 列符号对 EVM 为「更负更优」，建议下版加一行图例。

**R-14 补记（2026-10-15T12:45Z，第 16 封收货）**：b7e7 12:35:41Z「v1.3 措辞收尾」静默更新已拉取归档
（74636 B，Content-Length 核验）。核验：§9 状态表第 10 行「β=1.0 基线」补正 ✓；6G/+19 行就地注明
「工程目标点；验收 gate 20/22」✓；§9.6-1 表头 β 基线/备用 ✓；L560「β=1.0 规划」系 §8.8-7 历史裁决快照
原文保留（合理）✓；关键数值（S0 −45.35 / S1 −45.82 / mem_energy 阈 / GMP 44mW）未动 ✓。
**电路侧 v1.3（12:35Z 版）＝最终归档版；两条微注已随上口回执转达，随其下版顺手。b7e7 无待办。**
