oppry12102/WIFI7-TX/06_layout_design_notes/M5_cdl版本门_原件锚应变化_2026-10-18.md

# M5 · cdl 版本门（原件锚「应变化」）判读落地 — 2026-10-18

- **触发**：b7a0 → fde9《deck 侧进展知会（cdl 主闸门不变）》`2026-10-18T05:35:04Z`
- **收件路径**：`/data/workspace/inbox.jsonl` 第 **99** 行（98 → 99）
- **性质**：**知会，无请求项 ⇒ 未回信**；本口**零投递** 8510；落档件为**过程件**，随下批夹具包同走
- **本口性质**：停线期（候件未到），只做轻活（文档级），未跑任何电路/网表作业

---

## 一、来信要点（逐条留痕）

1. **b7e7 备料 9 件到货验收毕**（含补丁稿 / 六判据审计台 / pex_extract）；
   b7a0 侧 **LVS deck 修复已落码 = 零回归基线**（tb 识别面 body bbox → b_pin 真带；
   五局含 `drv2_v18×v3` 全部零 delta）；**纪要 + diff 已投 8510 `design/sow6/`**。
2. **我侧 A0→E 触发条件不变**：候 b7e7 **pex_extract TERM_LAYER 修复版重提三件 cdl**；
   **「原件锚 `pex_drv1_v19` `ae4feb76` / `pex_drv2_v19` `1f5e0cd8` / `pex_mix_v27` `33e9e754` 应变化」**。
   **守候工人 06:06Z 超时无果 = 预期，续守即可**。
3. **重提期判读口径重申（裁定十二）**：真短族（`nref|gnd`、`nsens|gnd`）/ R P2 悬空 FAIL
   ＝ **预期中间态，不点火**；**v20 回改 GDS 后双门过才 27 角**；**判据器 `ca38d0f3` 不改**。
4. **「合并名消散」旧判据对 deck fix 作废**（粘连 ＝ 真几何），
   **我侧不受影响 —— cdl 六判据照旧**。

## 二、对我侧的实际影响：**唯一新增 = 第 2 条的「原件锚应变化」**（其余三条均与现行 runbook 逐条一致）

这是本口唯一需要落口径的增量：此前我的验收锚口径是「**A0 跑【代入后网表】、验收锚 =【原件 cdl】指纹**」，
但**未写明「基线件本身即非修复版」这一反向判据**。若修复版迟未到、而有人重投**未改的基线件**，
旧口径下会被误判为「到货 → 直接跑 A0」。现补 **§一.0.5 cdl 版本门（先于 A0）**：

| 到货情形 | 判定 | 动作 |
|---|---|---|
| 三件 sha **逐字等于现基线**（`33e9e754` / `ae4feb76` / `1f5e0cd8`） | **非 TERM_LAYER 修复版** | **不跑 A0、不代入、不回执确认**，退回候件 |
| **任一件 sha 相对基线变化** | 修复版到货 | 取**新 sha 全串 + bytes 落账为新锚**；此后 §一.1 与 A0 验收锚**一律按新锚走** |
| **以新文件名投递**（`*_fix` / `*_v20` 等） | 版本归属未知 | **不自行认定**，先回信 b7a0 核归属再跑（守 §3.2 点火版本门） |

**我侧两处保守口径（自明不甩锅）**：
1. **新名件不自裁归属** —— §3.2 点火版本门只认 v20 回改版，cdl 归属若含糊（v19/v18/v20 混投）
   会连带污染点火资格 ⇒ 一律先请示，不自跑。
2. **「变化」以 sha256 为唯一凭据**，不凭文件名/时间戳/口头描述自证 —— 避免「以为改了其实没改」。

## 三、一致性自检

- 来信第 3 条（裁定十二：真短族/R P2＝预期中间态、不点火、v20 双门过才点火、判据器不改）
  与 runbook **§3.2 逐条一致**，无新增无修改 ⇒ 不动。
- 来信第 4 条（合并名消散作废）**只针对 LVS deck 侧**；我 §3.2「粘连案消散（判据①③④）独立判定、不受影响」
  **与之不冲突**（我判的是 cdl 六判据，不是 deck 侧合并名判据）⇒ 只作澄清留痕，不改判据器。
- 来信第 1 条（deck 修复零回归）＝ 对方侧进展，对我无操作项；**我不据此提前启动 A0**。
- 来信第 2 条「守候 06:06Z 超时无果 = 预期」⇒ 与我 runbook §3.2「守候工人继续在跑」一致；
  **铃响后按续守处理，不视为异常、不报障**。

## 四、候件实查（05:35Z 本口当场 GET 回读 8510 `design/sow6/`）

- 清单 **609 件**（上口 602，**+7 件均非 cdl**）；**cdl 仍仅 3 件**。
- 三件 sha256（GET 回读重算，与 b7a0 信内「原件锚」三值逐字对）：
  - `design/sow6/pex_mix_v27.cdl`　2474 B　`33e9e754…`　**MATCH 基线**
  - `design/sow6/pex_drv1_v19.cdl`　 939 B　`ae4feb76…`　**MATCH 基线**
  - `design/sow6/pex_drv2_v19.cdl`　1559 B　`1f5e0cd8…`　**MATCH 基线**
- ⇒ **按新增 §一.0.5 判定：现盘三件 ＝ 非 TERM_LAYER 修复版 ⇒ A0 不启动、27 角不点火**，停线维持。
- 守候工人 `poll_pex_cdl_fix.py` pid **4947** 在跑 **2h29m**（3 h 超时约 **06:06Z** 按铃，预期无果）。

## 五、落档表（runbook 改动指纹）

| 项 | 值 |
|---|---|
| 文件 | `sim_report/pex_v27/runbook_v2.5.md`（**文件名沿用不改**，避免断引用） |
| 版本 | 抬头 **v2.5.1 → v2.6**；正文新增 **§一.0.5 cdl 版本门**；抬头澄清合并名消散归属 |
| 改后 | **23716 B** / sha256 `e629bb283581bad3d2e6fbe0bc65bd0820aef1ac5c881d4779274cabc0c2cda1` / **291 行** |
| 改前 | 21866 B / sha256 `a7c278b6167595d18430e29da66e389c9b802a9fe02c897aa9931bbf484d2625` / 275 行 |
| diff 性质 | **纯增补**（0 处删改既有口径：§一.0/1/2/3、§二/三/四、§3.1/§3.2 全逐字未动） |

## 六、纪律对照

- **未回信**（知会无请求项）；**未投递** 8510；**未改任何现役脚本**（判据器 `ca38d0f3` 遵令不动）；
  **未触碰三件 cdl**（只读回读）；**未点火 27 角**；**未自行选口径/调参**。
- 本口唯一改动对象 = **我自己的 runbook 文档**（增补一条门），不动任何他方产出与判据实现。
