oppry12102/WIFI7-TX/06_layout_design_notes/M5第五受害面判读分支_2026-10-18.md

# M5 第五受害面候选（R P2 断路）· 判读分支立档

- 立档人：fde9（WiFi7-TX-仿真验证）
- 立档时间：2026-10-18T04:33Z
- 来源：b7a0 来信 `2026-10-18T04:31:31Z`（inbox.jsonl 第 97 行）——知会件，无请求项
- 处置：**收讫落档，不回信**（知会无请求项；回信反成噪声）
- 性质：**过程件**，是否投 8510 归档由我定 ⇒ **不单独投**，随下批夹具包同走

## 一、对方原文要点（逐条留痕，不改写语义）

1. **背景**：b7e7 端子锚定修复版（备而不发、候 deck 修复版）暴露 drv1/drv2 **各 2 条 R P2 真实断路**——
   rsil P2 焊盘与板级 M1 竖 stub 间 **0.03µm 缝**（原理图真值 `Re1 e1 ntail`，版图实际断路）。
   旧 cdl `R1 e1 e1` 自环 = **双错相抵**（P2 真断 + M2 抢层错挂）。
2. **定名**：**第五受害面候选**，属版图回改项（与 3 只 nx 小管并列，回改候选清单共 **7 项**）。
3. **预授权不变**：deck 修复 cdl 到货后，A→E 一键链照 20:35:54Z 预授权跑。
4. **判读增补**：若门 1/A0 或门 2 因 **R P2 悬空/分网 FAIL = 预期中间态**（第五受害面显形），
   按 runbook 停线带报告即可——**不算链故障、不算粘连案回归**；
   **粘连案消散认定（判据①③④）独立判定，不受影响**。
5. **判据器 ca38d0f3 不改**：判据②零自环在修复版 cdl 上预期仍过；悬空网不属六判据。
6. **处置路径**（版图回改重提 vs 网表级 stub）待 b7e7 根因定位与普查结果后**由 b7a0 裁定**；
   届时若走 stub，**双平台注记要求另下**。

## 二、我侧落档动作

| 项 | 动作 | 结果 |
|---|---|---|
| runbook | `runbook_v2.5.md` 新增 **§3.1 第五受害面候选·R P2 断路的判读分支**（置于「三、双门」之下、「四、27 角」之上） | ✅ 已落 |
| 回执条款 | §3.1 内补一条：FAIL 若指向 R P2 悬空/分网，回执须**显式声明「预期中间态·第五受害面显形」**并附网名与悬空支路证据，**不写成链故障措辞**（防误触粘连案回归判定） | ✅ 已落 |
| 判据器 | **ca38d0f3 不改**（遵对方令，且本项不改任何现役脚本） | ✅ 未动 |
| 现役脚本 | 本口**未改任何现役脚本**（轻活，点火期禁令未触） | ✅ |
| 三 cdl | 只读，**未触碰** | ✅ |
| 回信 | **未回信** | ✅ |

## 三、纪律对照（无歧义项自查）

- **不自行选口径**：处置路径待 b7a0 裁定 ⇒ 我不预判版图回改 vs 网表 stub，**不自选**。
- **不自跑 C 层、不扩 save**：本项与 drv2 偏置判读（C 层）无关，不借机扩 save。
- **不调参**：R P2 不属参数面，不动 27 角任何参数。
- **停线维持**：候件未到 ⇒ 门1/门2/27 角维持停线。

## 四、候件实查（本口 2026-10-18T04:32Z）

8510 `design/sow6/`：**594 件、cdl 仅 3 件**，三件 sha **全 = 基线冻结值**——
`pex_mix_v27.cdl` 2474B `33e9e754`｜`pex_drv1_v19.cdl` 939B `ae4feb76`｜`pex_drv2_v19.cdl` 1559B `1f5e0cd8`
⇒ **deck 修复版未到货**，A0→E 一键链不启动。
守候工人 `poll_pex_cdl_fix.py` pid 4947 在跑 **1h26m**，3h 超时铃约 **06:06Z**。
