oppry12102/WIFI7-TX/06_layout_design_notes/判读纪要_A0电容孪生逐件裁定与门2锚同源分档_裁定二十九_2026-10-18.md

# 判读纪要 · A0 电容孪生逐件裁定 ＋ 门2 锚同源分档（裁定二十九 · 2026-10-18）

**签发**：WiFi7-TX 组长 b7a0 ｜ **时点**：2026-10-18 09:53–09:57Z ｜ **事由**：换源批判活通过（裁定二十八）后，
我在等 fde9 门1 预演的空档里，把「PEX 代入网表到底替了谁」这件事**逐件算到底**，发现三件事：一件好消息、两件必须现在裁的坏事。

**性质声明**：本件是**组长侧独立自算**（我手上有三件换源 cdl ＋ deck v015.1 ＋ PDK 模型常量），不是交付件、不替代
fde9 的硬门乙两样（现役 KEEP/CDL_DROP 全量、A0 网表电容清单）。我这份是**交叉锚**：他交上来时逐格对。

---

## 一、机制先说清：谁替代谁**没有任何物理强制**（这是本次问题的根）

三件 cdl 头部都写着同一行：

```
* 转换五规则: X→Q / hbt_mirror 内联 / 剥 V·Cin·Ct·Lt / R→3T / sub=0
```

即：**deck 侧的全部理想电压源与 Cin/Ct/Lt 件，cdl 生成器一律不提取**；代入器再按两张名单决定去留——
`KEEP`（deck 侧逐字保留的理想件白名单）与 `CDL_DROP`（cdl 侧要剔的实物孪生）。
我从 8510 镜像 `m5_pex_substitute_jia.py`（ca74fd53，契约段与他现役 a93c0d2f 逐字节相同，见裁定二十六）读到的现役两表：

| 表 | 内容（`m5_pex_substitute_jia.py` 行号） | 后果 |
|---|---|---|
| `KEEP` (L37-49) | mix：`Is0, Bvbl, Bvbh, Bvifb, Bvt, Cca1, Cca2, Ccb1, Ccb2, RL1, RL2, Lt1, Lt2, Ct1, Ct2` | **deck 的 6 只理想电容全部保留** |
| `CDL_DROP` (L51-62) | mix：`{R15, R16}`；drv1：`{R8, R9}`；drv2：`{R11, R12}` | **cdl 的 6 只 cmim 一只不剔** |

⇒ **现役配置 = 理想件与实物件同节点对并存 ＝ 双计**，裁定二十六预警的 `tank 1.6152p` 就是这么来的。
更值得警惕的是：**这两张表都是纯名单，双计、漏替、名字对不上，全都不会报错**——
`build_stage_body`（L159-199）只做 `nm in drops` 判定，`CDL_DROP` 里写了一个 cdl 中不存在的名字，效果是**静默不剔**。
我已核对换源三件的器件编号未变（mix R15/R16、drv1 R8/R9、drv2 R11/R12 全在），所以现役不构成漏替；但这是运气，不是机制。

**定谳①（孪生三态）**：任何「deck 理想件 ↔ cdl 实物件」同节点对，只有三种合法终态——
**甲 实物替代理想**（KEEP 删该理想件）、**乙 理想替代实物**（CDL_DROP 增该实物件）、**丙 声明无孪生**（一方确无实物件，须写明依据）。
**并存＝缺陷，不是口径。**（现役落在「并存」，作废。）

---

## 二、好消息：电阻面 37 只逐只自算，**全部命中名义值，max |Δ| = 0.0988%**

常数取自 PDK 实读：`cornerRES.lib` L20-22 ⇒ `rsh_rsil=7.0`、`rsh_rppd=260.0`、`rsh_rhigh=1360`（typ 档）；
公式 `R = rsh·l/w`（已由三处独立命中反证：mix R1 30.002↔30、drv1 R1 4.000↔4、drv2 R1 1.5005↔1.5）。

| 件 | cdl 节点对 | model l/w | 自算值 | deck 名义 | Δ |
|---|---|---|---|---|---|
| mix R1–R4 | e1a/e2a/e1b/e2b–ntaila/b | rsil 4.286/1.0 | 30.0020 Ω | Re1a~Re2b = 30 | +0.0067% |
| mix R5/R6 | nvtop–ntaila / nvtop–nref | rhigh 1.0/2.0 | 680.0000 Ω | XBI1/2 rr=680 | 0.0000% |
| mix R7/R8 | lop/lon–lopd/lond | rsil 1.429/1.0 | 10.0030 Ω | Rd1/Rd2 = 10 | +0.0300% |
| mix R9–R14 | na1p/nb1p/nb2n/na2n–nbiasL/H、ifp/ifn–nifbias | rhigh 1.47/1.0 | 1999.2000 Ω | Rba/Rbb/Rb = 2k | −0.0400% |
| mix R15/R16 | vcc–rfop / vcc–rfon | rsil 6.429/1.0 | 45.0030 Ω | RL1/RL2 = 45 | +0.0067% |
| drv1 R1/R2 | e1/e2–ntail | rsil 1.0/1.75 | 4.0000 Ω | Re1/Re2 = 4 | 0.0000% |
| drv1 R3 | vcc–nref | rhigh 1.19/1.0 | 1618.4000 Ω | XBI rr=1.62k | −0.0988% |
| drv1 R4/R5 | inp/inn–gnd | rhigh 1.0/1.36 | 1000.0000 Ω | Rin1/Rin2 = 1k | 0.0000% |
| drv1 R6/R7 | bin/bb1–nbias | rhigh 1.0/1.36 | 1000.0000 Ω | Rb1/Rb2 = 1k | 0.0000% |
| drv1 R8/R9 | vcc–cop / vcc–con | rppd 1.0/2.6 | 100.0000 Ω | RL1/RL2 = 100 | 0.0000% |
| drv2 R1/R2 | e1/e2–ntail | rsil 1.0/4.665 | 1.5005 Ω | Re1/Re2 = 1.5 | +0.0357% |
| drv2 R3–R6 | vcc–nref ×4 | rhigh 1.19/1.0 | 1618.4000 Ω | XBI1~4 rr=1.62k | −0.0988% |
| drv2 R7/R8 | inp/inn–gnd | rhigh 1.0/1.36 | 1000.0000 Ω | Rin1/Rin2 = 1k | 0.0000% |
| drv2 R9/R10 | bin/bb1–nbias | rppd 1.923/1.0 | 499.9800 Ω | Rb1/Rb2 = 500 | −0.0040% |
| drv2 R11/R12 | vcc–outp / vcc–outn | rppd 1.0/2.6 | 100.0000 Ω | RL1/RL2 = 100 | 0.0000% |

**裁定：电阻面无须换档、无须换锚。** 这一面 PEX 是忠实的，双门噪声地板就定在这里（≤0.1%）。
**顺带实证两条化石**：drv1 `R4/R5 = inp/inn–gnd rhigh`、drv2 `R7/R8 = inp/inn–gnd rhigh`，即
**RRin 化石回改（裁定十六）在换源件里已落成实物**——这正是我上口自推的 nref 映射内容，b7e7 可直接照此出件；
另外 mix Q5/Q6 两只 dummy **反向多出**（deck 无对应物），三端同地零贡献，台账在册。

---

## 三、坏事一：电容面 mix 有 6 对孪生，且**门2 的锚与「物理替代」不相容**

mix 六只 cmim 逐只自算（area=514.382 µm²、perim=90.72 µm，`cap_cmomf` 面密度 1.5 fF/µm²、周长项 0.04 fF/µm）：

| cdl | 节点对 | 自算值 | deck 孪生 | deck 值 | 关系 |
|---|---|---|---|---|---|
| C1 | na1p–ifp | 775.202 fF | Cca1 ifp–na1p | 1 n | 理想比实物 **+29%** |
| C2 | nb2n–ifn | 775.202 fF | Ccb2 ifn–nb2n | 1 n | +29% |
| C3 | nb1p–ifp | 775.202 fF | Ccb1 ifp–nb1p | 1 n | +29% |
| C4 | na2n–ifn | 775.202 fF | Cca2 ifn–na2n | 1 n | +29% |
| C5 | rfop–gnd | 775.202 fF | Ct1 rfop–0 | 0.84 p | 理想比实物 **+8.3%** |
| C6 | rfon–gnd | 775.202 fF | Ct2 rfon–0 | 0.84 p | +8.3% |

> ⚠ **反推声明（诚实项）**：面密度 1.5 fF/µm² 与周长项 0.04 fF/µm **是我从 fde9 已公布的 771.573 fF（不含周长）/ 775.202 fF（含周长）反解出来的**，
> 不是我从 PDK 模型文件正面读到的（`CMIMP_F_PER_UM=0.04` 只见于他 §205 的差面清单）。请他用 `pex_devmodels.lib` 正面确认这两个常数后再落 A0。

**三条电路后果（Lt1/Lt2 = 1 nH，取点 f₀ = 5.51 GHz = runbook 门2 定义）：**

| 档 | rfop 并联容 | tank 谐振 | Xc@5.51 GHz | 说明 |
|---|---|---|---|---|
| 理想 Ct 0.84p | 0.840 p | **5.4914 GHz** | 34.387 Ω | 前仿锚建立时的状态 |
| 实物 cmim 0.7752p | 0.775 p | **5.7163 GHz**（+4.10%） | 37.261 Ω（+8.36%） | 物理真值 |
| 双计 | 1.6152 p | **3.9601 GHz**（−27.88%） | 17.883 Ω | 作废 |

耦合侧同理：`Cca*/Ccb* = 1 n` 与实物 0.7752p 差 **29%**，双计下实物被理想件以 **1290 : 1** 压过 ＝ 白提取。

**★定谳②（锚同源律）**：门2 是**链中性门**，不是「物理 vs 理想」门。锚必须与被测网表**同源**——
凡「实物替代理想」处，**锚也取实物值**。否则门2 必然 FAIL，而那个 FAIL 是口径错配、不是提取缺陷：
理想 0.84p → 实物 0.7752p 使并联点阻抗 **+8.36%**（34.39→37.26 Ω），CG@5.51 GHz 的漂移量级**远大于 ±0.05 dB**，
且方向确定（取点将落到谐振点左侧 3.6%，预期 CG 下移）。**fde9 若直接拿 +17.4465 去判档乙，会误判自己算错。**

---

## 四、坏事二：结项口径要分三档，**现役那档作废**

| 档 | CDL_DROP（cdl 侧剔） | KEEP（deck 侧保留） | 网表语义 | 门2 锚 |
|---|---|---|---|---|
| **档甲 · 链中性门** | 现役 ＋ **C1–C6** | 现役全留 | 理想电容全留、电容实物全剔 ⇒ 与 deck 逐件同构（电阻仍用实物，Δ≤0.1%） | **+17.4465 dB 现役锚直接可用** |
| **档乙 · 物理真值门（27 角用这档）** | 现役（R15/R16、R8/R9、R11/R12） | mix 删 **Cca1/Cca2/Ccb1/Ccb2/Ct1/Ct2**；**Lt1/Lt2 保留**（cdl 无 L 件，无实物可替） | 六只电容取实物 775.202 fF | **新锚 A0″**：deck 原文逐字不动、**只把这六只理想电容的值改为 0.775202 pF**，前仿实跑取 CG_A0″，门2 改判 \|CG_PEX − CG_A0″\| ≤ 0.05 |
| **作废 · 双计档** | 现役（只剔 4 只电阻） | 现役 | 理想＋实物同节点对并存 | 不得出任何 PEX 结论 |

**为什么 Lt1/Lt2 留理想**：三件 cdl 全无 L 件（生成器剥 Lt），无实物孪生 ⇒ 属孪生三态之**丙「声明无孪生」**，
且 A0″ 中同样保留，两侧口径一致。同理 drv1/drv2 的 `Cin1/Cin2 10p` 也属丙。
**为什么 drv1/drv2 不用换锚**：两件 cdl **C 件计数 = 0** ⇒ 无电容孪生 ⇒ A0″ 对它们**逐字等于 deck 原文** ⇒ 两级锚不变，只有 mix 变。

---

## 五、交办（三项，都要进代码，不靠人眼）

1. **节点对唯一律（硬不变式）**：代入完成后，对每个 stage 统计**无序节点对**出现次数，>1 即 `SystemExit` 干净停线。
   现役双计配置会被这一条当场抓住（`Cca1{ifp,na1p}` 与 `C1{na1p,ifp}` 同对）。
   *豁免*：若确有合法并联，须逐对登记理由后再放行；无登记即判缺陷。
2. **名单命中自检**：`CDL_DROP` / `KEEP` 里出现的名字若在该 stage 的 cdl/deck 中不存在 ⇒ 报错退出（现行为静默 no-op）。
3. **回执附逐件对照表**：每个 stage 一张「deck 理想 ↔ cdl 实物」表（元件名／节点对／值／处置 甲乙丙／Δ%），
   与我 §二/§三 的表同格式，便于逐格对账与结项留痕。

---

## 六、我不自点火（重申）与本件的效力

- 门1（A0′ DC ≤1e-5）**不受本裁定影响**：电容与 DC 无关，27 角前照原令预演。
- 门2 的锚**换档**只在档乙生效；档甲用现役锚。**两档都必须跑、都必须过**，才由我下 27 角点火令。
- 我不跑 ngspice、不改他任何链件、不改三件 cdl（形态/网名/参数零改动铁律照旧）。
- **硬门乙不解除**：fde9 仍须交①现役 KEEP/CDL_DROP 全量 ②A0 网表电容清单（逐只节点对＋值）；
  本件只是让他对账时有一份独立第三视角，且**新增一项确认责任**：用 `pex_devmodels.lib` 正面确认面密度与周长项两常数。

—— 组长 b7a0 · 逐格自算，未跑一次仿真
