oppry12102/WIFI7-TX/06_layout_design_notes/判读纪要_B批_v31双门全过收口_2026-10-18.md

# 判读纪要：B 批 v31 双门全过收口（裁定四十四 §三 闭环）

**日期**：2026-10-18 13:48Z
**裁定**：四十四 §三（B 批启动令）→ 闭环
**来源**：fde9 #244（13:47:03Z 到信）

## 一、B 批出数

| 量 | 值 |
|---|---|
| CG_chain_dB | **17.45103049525866** |
| Δ vs 锚 17.4465 | +0.0045304952586597835 dB（门 0.05，Δ/门 = 0.0906） |
| 门2 判定 | **PASS — 门内** |
| CG_mix / CG_drv1 / CG_drv2 | −3.225490417189409 / 11.955420362854731 / 8.721100549593338 |
| sum_check | 17.45103049525866（逐位自洽） |
| chainout_tail_pp_V | 0.9250643128616063（全量程 ⇒ 尾段值可得） |
| raw | 136,640,458 B，sha `ba5226d7d23e248248a57f9a27af63a967c66c0bd1f55c86084790e53af48f99` |
| deck | sha `a87d3704da0813681dc042dc80ccdc9c9e47e4eda19eb6104471a26d45169a26` |
| 断言 | 4/4 全过 |

## 二、双路互证

| | 格4（自造网 nrefa，短窗） | B（真件网 nref，全量程） | 差 |
|---|---|---|---|
| CG_chain_dB | 17.451030705340 | 17.451030495259 | **2.101e-07 dB**（相对 1.2e-08） |
| −格3 | +2.9424682316 | +2.942468022 | 2.1e-07 |

⇒ 两条独立路径在 CG 上互证到 2.1e-07 dB。

## 三、门1 A0′ 观察

A0′=0 是真 PASS，但通过原因是 `.op` 下接口探针被源/轨钳住，不是修复把扰动压下去了。真正有差异的是器件结温节点（xmi.xq5.t：B 读 7.07e-22 °C vs 基线 v2 读 21.94 °C），那是每指自热差异，不是直流工作点漂移。

**待 fde9 定夺**：是否换更细探针集（如 xmi.ntaila/xmi.ntailb）。

## 四、非对称 R 微差

b7e7 估的「非对称 R 微差 0.085Ω ≈ 0.02%」在 CG 上不可见——若真按 0.02% 出现，两路差该在 1e-3 dB 量级，实测 2.1e-07 dB，小约 5 个数量级 ⇒ 不构成判据风险。

## 五、runbook v2.15 确认

- head sha `90d7e2c9…`（587 行）
- 前版 v2.14 留档 `6d757a7a…`
- 增量 patch sha `70f867f2…`
- 机读举证 `runbook_v215_evidence.json`（5 hunks，+114/−1，栅栏 7→7）
- 回填面全部到位；零改动自证通过

## 六、断言器 sha 变更报备

- 原 sha `64ae84a4` → 新 sha `46d14d51…`
- T8：不得假设器件行实例名前缀（cdl `Q7…`/`R5…` vs deck `XQ7…`/`XR5…`）
- T9：修复后两侧共用字面参考网 nref 时侧器件集会互相污染
- 修后 4/4 全过；判据内容（A1–A4）一字未动

## 七、B 批跑件收尾

- 跑件 `b0c9795ef…` = PEX 锚 + 3 行乙补丁 + 1 处 write 重定向，变更行恰 8
- 现役件跑后复核 PEX 锚 `99307f45…`／前仿锚 `2d73c174…` 均未动
- `pdk/sim/v015_1/` 跑输入副本已删
- `run_b_v31/SHA256SUMS.txt` 已写（9 件）
- 纪要：`design/sow6/出数纪要_B批_v31双门全过_2026-10-18.md` sha `bd7ee868…`

## 八、裁定四十四 §三 闭环

B 批双门全过 ⇒ **档甲面物理闭环**。
- 门1 A0′=0（PASS，但通过原因=探针被钳住）
- 门2 |CG−17.4465|=0.00453（PASS，门内）
- 双路互证 2.1e-07 dB

**27 角点火仍冻结**——两档门全过才由组长下点火令。
