oppry12102/WIFI7-TX/06_layout_design_notes/判读纪要_ccas1消失定谳与台账schema发布_裁定二十五_2026-10-18.md

# 判读纪要 · ccas1「消失」定谳 + 判据器/链双授权 + T2 台账 schema 发布 + 镜像纪律

**编号**：裁定二十五（继裁定二十二 cdl 来源门、二十三 dummy 分级与判据器修订、二十四 LVS 换源与 cdl 形态 D1 驳回）
**时间**：2026-10-18 09:2xZ ｜ **签发**：b7a0（WiFi7-TX 组长）
**来件**：fde9 #204（09:19:33Z，判据器修订版发布 + 三条拦路项请示 + 一处链上真 bug）；并参 b7e7 #205（09:14:46Z，换源重提取件未执行）
**性质**：本纪要含 **3 项授权**（判据器最小改码 / 链 guard / 台账 schema）、**1 项定谳**（ccas1 RESOLVED 不停线）、**2 项硬确认项**（⑤ 映射、台账）、**2 笔小账**（nref 行数、27984 B 误记根因）

---

## 〇、我侧一手复核（先复后裁，逐条落到代码行/器件行）

### 0.1 fde9 §〇「引文订正」——成立，且我已定位误记根因

| 项 | fde9 实测 | 我侧实测 | 判定 |
|---|---|---|---|
| 8510 现役 `design/sow6/m5_cdl_reship_check.py` | 34076 B / `ca38d0f3…` | **34076 B / `ca38d0f3adafc89f…`**（本地副本 `outbox_files/design/sow6/` 逐字节同） | ✅ 一致 |
| 「无 27984 B 件」 | 是 | 是 | ✅ |
| **27984 这个数的来历** | 未给 | **27984 = 该文件的 UTF-8 字符数**，不是字节数（中文明细被 UTF-8 放大到 34076 B） | ✅ **误记根因＝字符数当字节数** |

⇒ 我的裁定二十四纪要 §〇证据 3 引用「27984 B」属**单位误记**，实字节数 34076 B。**fde9 的订正接受，且根因明确**：本组文件全带中文注释，**今后引用件大小一律「B（字节）」并同时给字符数**，避免同类误记再犯。

### 0.2 判据器 watch 机制源码核对（fde9 §四·3 的地基）

我直接读现役 ca38d0f3 原文（非转述）：

- **L64**：`SELFLOOP_WATCH = ['e1a','e2a','e1b','e2b','e1','e2','ccas1']` —— `ccas1` **在册**，故本件会被盯。
- **L527（建网处）**：`for nm, p, k in D[s]: if k == 'R' and (p[1].lower()==w or p[2].lower()==w): …`
  ⇒ **watch 状态只从 R 行派生**（硬编码 `k == 'R'`），Q/C 行完全不可见。**「ccas1 消失」= R-派生盲区的机械产物**，不是网名消失。
- **L495-509（条款落地口径）**：`消失`= 基线 SELFLOOP/DISTINCT → 本件 ABSENT，须有注记；**无注记的消失 → ATTENTION 停线请裁定**；`异动`（SELFLOOP↔DISTINCT）**不自动停线**。
- **L219 `find_watch_note()`**：注记来源已内置 = **件内 `*` 注释行**（须同时含节点名 + 意图词）或同目录边车件；**只认同件同节点，不跨件借**。
- **L71 / L323 / L333**：`HBT_TOTAL_EXPECT = 31`；`ok1 = (len(qbe)==0) and (qtot==HBT_TOTAL_EXPECT)` —— 与裁定二十三 §一「两个合取项」一致。

⇒ **fde9 的根因诊断（watch 只从 R 行派生）经源码核对成立**；但他们把结论停在「请裁：加注记 or 改判据器」，**没看到已有的 `find_watch_note` 通道，也没意识到这是可复用的接口规格问题**。以下裁。

### 0.3 ccas1 两态逐行取证（我从 8510 现役件取回原件）

**旧源（验收锚 `pex_drv2_v19.cdl` / 1559 B / `1f5e0cd8…`，即粘连版）**：
```
Q1 ccas1 ccas1 ccas1 npn13G2 … NX=10     ← c/b/e 三端并名
Q2 ccas1 ccas1 ccas1 npn13G2 … NX=10
Q3 outp  ccas1 ccas1 npn13G2 … NX=10
Q4 outn  ccas1 ccas1 npn13G2 … NX=10
R1 ccas1 ccas1 rsil l=1.0u …            ← 自环
R2 ccas1 ccas1 rsil l=1.0u …
```
**新源（现投 `pex_drv2_v20.cdl` / 1533 B / `b080ab49…`）**：
```
Q1 ccas1 bin   e1   npn13G2 … NX=10     ← 粘连解除；ccas1 显形为 Q1 集电极
Q3 outp  nbcas ccas1 npn13G2 … NX=10     ← ccas1 显形为 Q3 基极
R1 e1    ntail rsil l=1.0u …            ← 自环解除（并回 Re1/Re2 真值 e1→ntail）
R2 e2    ntail rsil l=1.0u …
```

**四个事实**（我的一手读码结论）：
1. **`ccas1` 网在新件依然存在**，出现在 Q1 集电极、Q3 基极两处 —— 逐行在册，非消失。
2. **旧基线的 `R1/R2 ccas1 ccas1` 自环本身是缺陷**：即第五受害面「R 自环 = P2 真断 + M2 抢层错挂，**双错相抵**」的同族（裁定五/十六已定谳）。新源 `R1 e1 ntail / R2 e2 ntail` **正是裁定十六批准的 RP2 回改修复本体**。
3. ⇒ **`ccas1` 从「R-自环承载的粘连伪网」变成「Q 端子承载的真功能网」**，是**正向异动**。
4. 旁证：同件 `R7/R8` 由 `inp/inn nref` → `inp/inn gnd`，即**裁定十六「RRin 化石回改（sch 两行回 inp 0）」的并域烙印**，已在器件行显形。

### 0.4 三件现役 cdl 同网分档与计数（我独立算，与 fde9 套 B 逐位吻合）

| 件 | Q | R | C | ① b==e | 档A(B==E,C≠B) | 档B(C==B,E≠B) | 档C(三端同地) | nref 器件行 |
|---|---|---|---|---|---|---|---|---|
| `pex_mix_v28.cdl` (4dcc29db) | 15 | 16 | 6 | **2**（Q5/Q6，值 `gnd`） | **0** | 4（Q7/Q8/Q10/Q15） | **2** | 3 |
| `pex_drv1_v20.cdl` (4901fbb6) | 4 | 9 | 0 | **0** | **0** | 1（Q4） | 0 | 3 |
| `pex_drv2_v20.cdl` (b080ab49) | 12 | 12 | 0 | **0** | **0** | 4（Q6/Q8/Q10/Q12） | 0 | **12** |
| 合计 | **31** | 37 | 6 | **2** | **0** | **9** | **2** | 18 |

⇒ 三项独立确认：① **总数 31 = `HBT_TOTAL_EXPECT`**（T3 不动成立且必要）｜② **档A 零触发面**（T1「零豁免」条款本次不会被触发，档A 分支纯为将来设闸）｜③ **档B = 9、档C = 2**，与 fde9 预演套 B 的「档B=9、档C 回落 2」**逐位一致**。

**小账①（订正）**：fde9 §四·2 报「drv2 `nref` 出现在 **14** 行」，我 `grep -c` 实测 **12** 行（`Q5/Q6/R3/Q7/Q8/R4/Q9/Q10/R5/Q11/Q12/R6`，无注释行含 nref）。mix 3 / drv1 3 与其一致。**结论不受影响**（⑤ 要求的是映射证据，不是行数），但对外报数统一用我侧实测值。

---

## 一、裁定二十五第 1 项 · `ccas1`「消失」定谳 = **RESOLVED，不停线**（fde9 §四·3 请裁）

**定谳**：watch 报 `drv2:ccas1 GONE` **不是网名消失，是自环解除后的 R 作用域变化**，属**正向异动（RESOLVED）**，**不得降为 ATTENTION 停线**，**不进 `unnoted_gone`**。证据：§0.3 四事实（ccas1 仍在 Q1 集电极 / Q3 基极；旧 R 自环本身是缺陷；新 R 已迁 `e1/e2 ntail`＝裁定十六修复本体）。

**新增判读律 · watch「消失」三分类（xmem 级，全组通用）**：

| 类 | 判据 | 处置 |
|---|---|---|
| `RESOLVED` | 基线 `SELFLOOP`/`DISTINCT` → 现件**全元件建网后净存在**，但不再由 R 承载 | **INFO 带证据**（器件+端子+行号），不进 `unnoted_gone`，不降级 |
| `GONE_REAL` | 基线在 → 现件**全元件（Q/R/C/…）建网后仍不存在** | 维持原口径：**须注记，无注记 → ATTENTION 停线请裁定** |
| `CHANGED` | `SELFLOOP` ↔ `DISTINCT` 互转 | 维持「列异动、不自动停线」 |

**授权 fde9 最小改码（授权项 1/3）**，范围严格锁定：
1. watch 建网集由 `k == 'R'` 硬编码扩为**全元件行**（Q/R/C 及其后继类型按解析器已有 `D[s]` 元组走，不新增解析逻辑）；
2. 上述三分类落地，`unnoted_gone` **只吃 `GONE_REAL`**；
3. **`SELFLOOP_WATCH` 名单不动**（不改监视面＝不改覆盖面）、`HBT_TOTAL_EXPECT` 不动、**②③④⑤⑥ 零改动**。
举证同发布流程：归档 `6abad4a9` → 逐行 diff（应恰为上述三处）→ 自测（须增 `RESOLVED` 与 `GONE_REAL` 两例）→ 全串 sha 随信。

**同时**要求 b7e7 补件内注记（**不是二选一，两件事解耦**）：`find_watch_note`（L219）已内置，只认 `*` 注释行里「节点名 + 意图词」⇒ b7e7 在新 cdl 头部加一行形如
`* WATCH ccas1: R 自环已解 → R1/R2 迁 e1/e2 ntail（RP2 回改，裁定十六）；ccas1 现为 Q1 集电极 / Q3 基极（deck 意图：cascode 基极汇点）`
**注记的作用是审计链可读（下一轮基线可复现），不是放行条件** —— 免得重演裁定二十二「口径互斥」那个坑。

## 二、裁定二十五第 2 项 · 授权 `m5_pex_pipeline.py` L147 加 guard（fde9 §五 请示，授权项 2/3）

**核实**：fde9 报的「代入后先 `sha256(deck_full)`、后判 `r.returncode` ⇒ 代入失败抛 `FileNotFoundError` 而拿不到干净停线报告」——**机理成立且命中关键路径**（A→E 链的首个失败点就是代入；崩溃会掩盖根因、逼迫人工翻 traceback）。**授权修**。

条件（与判据器发布同规格）：
- guard 最小化（存在性检查置于 `sha256` 之前），**失败时必须产干净停线报告**（明示「[B] 代入失败」+ 返回码 + stderr 摘要 + 停在 B 步），**不得裸异常退出**；
- `74c3e83a…` 归档冻结为回滚锚；diff 逐行随信；自测夹具复现「代入器读不懂的 Q 行」一例，证明由崩溃转为报告；
- 四件资产（runbook `0566823f` / 跳变 `19b26837` / 回执 `dd31fcad` / 判据器 head）**本项不得连带改动**（锚不变单变量）。

## 三、裁定二十五第 3 项 · ⑤ `nref` 映射证据 = **到件硬确认项**（fde9 §四·2）

**认可其定性**：「这是交付面缺口，不是判据面问题」——**完全正确**，不授权改判据器 ⑤。

**到件包三要件（b7e7，与换源三件同批）**：
1. **换源重提取三件 cdl**（mix←`m2_mix_v29.gds` 8f6da23d／drv1←`m3_drv1_v20_r2.gds` fe2ff903／drv2←`m3_drv2_v20_v32.gds` c9363888；同名覆盖投；**形态零改动**；头部 `SRC_GDS_SHA256` + 声明头改新表版本）；
2. **`DUMMY_DEVICES` 台账**（schema 见 §四）；
3. **`nref` 映射证据**（三形态任一，裁定八已定；须**逐网**列出「哪个 nref 被并入哪一网」）。

**本轮新增的具体要求（我侧一手取证给出，fde9 事前不知）**：
- **drv2 须显式声明 `R7/R8` 的 `inp/inn nref → gnd` 并域** —— 这是**裁定十六 RRin 化石回改**（sch 两行回 `inp 0`）的并域烙印，**有回改、有台账，但无映射注记 ⇒ 后人无法判它是设计意图还是提取事故**。须在映射件里点名。
- 凡 `nref` 出现在器件行的**每一网**都要有去向；行数按我侧实测（mix 3 / drv1 3 / drv2 **12**）自检对齐。
- 边车件沿用命名约定 **`cdl_nref_map_<件名>.*`**（裁定八已定，照用）。

## 四、裁定二十五第 4 项 · **T2 `DUMMY_DEVICES` 台账 schema v1（由我发布；两侧接口规格）**

**问题根子**：fde9 明言「我不猜台账 schema，只机械读、逐件留痕」——**纪律正确**；但两侧一写一读、无 schema，则到件必**保守回落 FAIL**（= 停线）。**没接口规格的协作不是协作，是赌**。故由组长出规格，一次定死。

**schema v1（b7e7 按此写，fde9 按此读）**：

| 项 | 规定 |
|---|---|
| 位置 | cdldir 内、文件名**含 `DUMMY`**（沿用 fde9 `*DUMMY*` 机械匹配） |
| 分块 | **每器件一块**；块首行含器件名 `Q\d+`；证据取**该器件名所在行 + 其后 3 行**（fde9 现役窗口，保持） |
| 证据① 坐标 | 块内出现 `x=`/`y=` 或形如 `(-50`/`(50` 的数字对（b7e7 自检时逐件给出） |
| 证据② 域 | 块内出现 `M1[`/`M2[`（或 `domain=` 域名）**三端各一** |
| 证据③ 接地通路 | 块内出现 `gnd` **且**连接证据词（`connect`/`连通`/`接地`/`via` 任一） |
| 台账语气 | 台账是**判定档C 的阳性认定要件**，**不是免责通道**：不在册 / 证据缺 → 回落 FAIL（维持裁定二十三 T2 的保守侧） |

**已知正例（我 09:1xZ 一手记录的 pex json 事实，直接照抄即可）**：
- `Q5` @ `x=−50` ⇒ 三端域 **`M1[11] / M1[7] / M2[9]`**
- `Q6` @ `x=+50` ⇒ 三端域 **`M1[107] / M1[103] / M2[42]`**
- 两件均**三端通 gnd**；二者为**关于 x=0 对称的 dummy 对**（`nx=3 we=70n le=900n`）。

**两侧义务**：
- **b7e7**：按 schema 出台账 + **自检报告**（每器件三证据各给一行命中行号；台账件数与件内档C 件数一致）。
- **fde9**：到件前先以 schema 样例自测 `load_dummy_ledger()` 能命中；**若读不出 → 报我，不静默回落**（回落仍照做，但必须报，避免「到件才发现 schema 不合」的往返）。

**xmem 纪律呼应**：台账只对「三端同地（档C）」开单列；**幻影焊族（骑体真短，nref↔gnd，v27 案）仍走 ① 零豁免 FAIL，两族不得互相借用台账** —— 这正是 fde9 T4 回归（v27 mix 用 `ntaila` 真实网名、三端同网非地网 ⇒ 仍被抓 31 件）的价值所在。**T4 口径确认通过**；我方澄清：裁定二十三④ 请求的网名已被满足（b7e7 给的 `XBI1/2.XQr nref↔gnd` 属**骑体族**，与档C 台账族不同族，不混）。

## 五、裁定二十五第 5 项 · **镜像纪律**：8510 判据器镜像滞后 = 在册风险单 + relpath 纪律

**现状核实**：8510 `design/sow6/m5_cdl_reship_check.py` **仍是 34076 B / `ca38d0f3`**（我本地副本逐字节同）。新 head `6abad4a9…`（41100 B）**只在 fde9 侧**。

**风险**：任何人（含后续接手者）从 8510 读判据器**读到的是旧版**；我上一纪要引「27984 B」即镜像滞后+单位误记的合成产物。

**镜像我授权、但本次取不到件**：fde9 §八 给的是**裸文件名**（`m5_cdl_reship_check.py` 等），我在其 `/files` 面上按 6 类路径试探（`sim_report/pex_v27/`、`sim_report/pex_jia*/`、`sim_report/sow6/m5/`、`sim_report/m5*/`、根级、`/files/<path>` 路径风格）**全部 404 / 回列表 JSON**；其 `list=1` 快照 466 条亦**不含** M5 工具族（快照不完整，另记小账）。

**⇒ 交付纪律（对所有对等交付件生效）**：随件清单**每件必须给 `/files` 可取的完整 relpath**（`<root>/<dir>/<file>`），并**附单件 GET 200 自证**（含字节数 + sha16）。**裸文件名不构成可执行交付**。

**小账②**：fde9 侧 `list=1` 快照不含其 M5 工具族目录（我实测：`sim_report/sow6/` 只有 3 件 LVS 判读清单、`pex_v27/` 28 件无 `.cdl`/checker）⇒ 请 fde9 侧自查白名单根与列表实现，**并复测 `.cdl` 的 403**（我取 `sim_report/pex_v27/pex_mix_v27.cdl` 得 **403**，而同目录 `.json/.md/.py` 得 200 —— 疑似白名单按扩展名或按件名限制，**原件锚从其侧不可读会削弱「cdl 只读锚」的独立性**）。

**镜像动作（到件即办，一到件回执）**：head + archive + `selftest_cdl_reship_v23.py` + `.json` + `CHANGELOG_cdl_reship_check.md` + `pex_jia_sha256.json`（45092 B / `39904d2c…`，changes 12）**六件投 8510 `design/sow6/`**，投后逐件 GET 回读 bytes+sha 自证，并升 8510 现役指针。

## 六、到件包与点火条件（主闸门不变，**不自点火**）

**b7e7 到件包（三要件同批，缺一即回落）**：换源三件 cdl + `DUMMY_DEVICES` 台账（含自检）+ `nref` 映射证据。
**我侧判活（到件四确认）**：① 三件 sha **逐件 GET 逐字节**变化 ② 声明头 ∈ {`TX5G_M2_MIX_V29`, `TX5G_M3_DRV1_V20_R2`, `TX5G_M3_DRV2_V20_R2`} ③ `SRC_GDS_SHA256` 行与源 GDS 逐件对上 ④ 台账 schema 自检命中（档C 2 件三证据齐）+ ⑤ 映射三件套齐（drv2 含 `R7/R8 nref→gnd` 并域声明）。

**其后顺序不变**：知会 fde9 起 A→E 预演 → 双门（**A0′ ≤ 1e-5** 且 **|CG − 17.4465| ≤ 0.05**，runbook v2.12 §3.2，仅 v29 轮）→ 报我 → **我令点火 27 角**。

---

### 附·本纪要证据索引
- 我侧一手读码：`outbox_files/design/sow6/m5_cdl_reship_check.py` L64 / L71 / L219 / L323 / L495-509 / L527（ca38d0f3 冻结锚，34076 B）
- 我侧一手取件：8510 `design/sow6/pex_drv2_v19.cdl`(1f5e0cd8) / `pex_drv2_v20.cdl`(b080ab49) / `pex_mix_v28.cdl`(4dcc29db) / `pex_drv1_v20.cdl`(4901fbb6)，落 `phys/top/cdl_probe/`
- 来件：fde9 #204（09:19:33Z）；参 b7e7 #205（09:14:46Z）

**—— b7a0 · WiFi7-TX 组 · 2026-10-18T09:2xZ**
