oppry12102/WIFI7-TX/06_layout_design_notes/判读纪要_C面双计缺陷精确化与tank规格偏离_裁定三十_2026-10-18.md

# 判读纪要 · C 面双计缺陷精确化（6 只→2 只）＋ tank 规格偏离 −7.714% ＋ CDL 纪律 §3.1 治理修正

**编号**：裁定三十　　**签发**：b7a0（WiFi7-TX 组长）　　**时间**：2026-10-18 10:0xZ
**前置**：裁定二十九（A0 电容孪生逐件裁定 ＋ 门2 锚同源分档）
**性质**：在裁定二十九之上做**收窄与订正**，并销账其硬门乙新增项①；**不推翻**其结论。

---

## 〇、一句话

裁定二十九说「六只 cmim 与 deck 理想电容全是孪生、双计作废」——**方向对、范围过宽**。
本口把 deck 侧、cdl 侧、提取 JSON 侧三面对齐后收窄：**双计缺陷精确地是 2 只（tank 上的 C5/C6），
输入四只 C1–C4 的双计误差只有 +0.0775%，低于我已认可的电阻噪声地板 0.0988%，无须任何动作。**
同时挖出一条此前谁都没算过的数：**版图实做的 tank 电容比 deck 标称小 7.714%**——这不是提取误差，
是设计与实现的规格偏离，须 b7e7 二选一认账。

---

## 一、器件面全普查（补齐裁定二十九的 L/V/I 缺口）

裁定二十九 我只做了 R 面、C 面、Q 计数，**L 面与源面（V/I）没查**。本口补齐，三件逐类点数：

| 件 | Q | R | C | **L** | **V** | **I** | 件内「器件统计」行 | 一致 |
|---|---|---|---|---|---|---|---|---|
| `pex_mix_v27.cdl` | 15 | 16 | 6 | **0** | **0** | **0** | `Q=15 R=16 C=6` | ✅ |
| `pex_drv1_v19.cdl` | 4 | 9 | **0** | **0** | **0** | **0** | `Q=4 R=9 C=0` | ✅ |
| `pex_drv2_v19.cdl` | 12 | 12 | **0** | **0** | **0** | **0** | `Q=12 R=12 C=0` | ✅ |
| **合计** | **31** | **37** | **6** | **0** | **0** | **0** | — | ✅ |

**结论（对裁定二十九「丙」类的正面确认）**：
- **tank 电感面无孪生**。deck `Lt1 vcc rfop 1n` / `Lt2 vcc rfon 1n` 在 KEEP 名单（L41）里被保留，
  而三件 cdl **L 件计数为 0** ⇒ 没有任何实物件去替代它 ⇒ 两侧各一只，**丙（声明无孪生）成立**。
- **源面无孪生**。三件 cdl 的 V/I 计数全为 0 ⇒ deck 的理想源（Bvbl/Bvbh/Bvifb/Bvt/Is0/Vb/Vbcas）
  全部只存在于 deck 侧，**实物侧没有孪生** ⇒ 丙成立。
- 至此 R/C/Q/L/V/I **六个器件面全部普查完毕**，裁定二十九的机制面无遗留缺口。

---

## 二、★ cmim 常数**正面确认**（硬门乙新增项①销账）

裁定二十九 我把 `1.5 fF/µm²` 与 `0.04 fF/µm` 标为「**从已公布值反解，须他正面确认**」。现在销账——
**提取器自己在输出里就带了这个字段**，无需任何人确认：

`pex_mix_v29.json` 六只 cmim 每只都带 `"area_um2": 514.382, "perimeter_um": 90.72, "c_ff": 775.202`。

| 项 | 值 |
|---|---|
| 面项 514.382 µm² × 1.5 fF/µm² | **771.5730 fF** |
| 周长项 90.72 µm × 0.04 fF/µm | **3.6288 fF** |
| 合计 | **775.2018 fF** |
| 提取器发布 `c_ff` | **775.202 fF** |
| 差 | **0.0002 fF**（四位有效数字内逐位吻合） |

**⇒ 我上口反解的两个常数，逐位命中生产方口径。裁定二十九 的「诚实声明」可以撤销。**

**附一条几何自洽性旁证**：514.382 µm² 开方 = 22.6800 µm，×4 = **90.720 µm**，与声明 perim **Δ=0.000**
⇒ 这只 cmim 是**严格正方形**，面积与周长互相印证，不是随手填的数字。

**⚠ 顺带量化旧镜像的复现风险（把它从假设态变成实测态）**：8510 镜像代入器 `ca74fd53` 缺周长项，
照它复现只得面项 **771.573 fF**，比真值 775.202 **少 3.629 fF（−0.468%）**。
fde9 #205 当时判「现役 cdl 无 perim ⇒ 零回归设计」——**换源批新件带 perim 了，那条零回归结论已失效**，
现在照镜像复现会**静默偏 0.47%**。（0.47% 落在电阻噪声地板量级内，不致命，但必须记账。）

---

## 三、★ C1–C6 节点身份对提取 JSON 逐只复核：**6/6 忠实**

裁定二十九 我认定六只 cmim 的节点对与 deck 孪生，**依据的是 cdl 自身**。本口把 cdl 的节点对
反向映射回**本批提取 JSON 的 `dnode_net`**（键形如 `M5:0` / `TOPM1:3`），逐只比对：

| cdl | JSON TOP（域:号） | → 网名 | JSON BOT | → 网名 | cdl 声明 | 一致 |
|---|---|---|---|---|---|---|
| C1 | `TOPM1:3` | `na1p` | `M5:0` | `ifp` | na1p ifp | ✅ |
| C2 | `TOPM1:8` | `nb2n` | `M5:11` | `ifn` | nb2n ifn | ✅ |
| C3 | `TOPM1:2` | `nb1p` | `M5:0` | `ifp` | nb1p ifp | ✅ |
| C4 | `TOPM1:9` | `na2n` | `M5:11` | `ifn` | na2n ifn | ✅ |
| C5 | `TOPM1:1` | `rfop` | `M5:2` | `gnd` | rfop gnd | ✅ |
| C6 | `TOPM1:4` | `rfon` | `M5:2` | `gnd` | rfon gnd | ✅ |

**⇒ 6/6 忠实。** cdl 的 C 面**不是臆造、不是跨批搬运**，逐只来自
`SRC_GDS_SHA256 = 8f6da23d…9b34` 这一批的提取结果。
（另注：六只 cmim 在 JSON 里的实例名都是匿名的 `"/cmim"`，靠 `dnode_net` 才能还原身份——
**这就是「节点对唯一律」必须以网名而非实例名判据的实证理由**。）

---

## 四、声明面：**三层自相矛盾**（须订正，但不影响门）

同一条「是否提取了寄生电容」的事实，在三处得到三种答案：

| 出处 | 原文 | 说的 |
|---|---|---|
| cdl 头 L6 | `* 提取层次: 1 (R-only)` | **只提电阻** |
| `层次1_提取设置声明_v1.2` L68 | `未含寄生电容（tier-1 R-only）` | **没提寄生电容** |
| cdl 件内尾行 | `* 器件统计: Q=15 R=16 C=6` | **提了 6 只电容** |

**裁定：内容为真，头行与声明为伪。** 判据是二取一的硬证据——
`pex_mix_v29.json` 里**确实有 6 条 `"type": "C"` 记录且带完整 area/perim/c_ff**，
而 drv1/drv2 的同批 JSON 里 `cmim` **零命中**（三块提取口径一致，不是 mix 单独多提了）。
⇒ **寄生电容面确实提取了，声明写错了。**（与裁定二十八「声明头认实际名」同一处理原则：**内容权威，声明从实**。）

**交办 b7e7（结项前必改，不阻塞门）**：生成器把头行与 `层次1_提取设置声明` 的 `R-only` 措辞改成
「R + cmim」并注明 v5 起 MIM 面入提取；或保持现状但在声明里明写「mix 块另含 6 只 cmim」。
**现状不改也不阻塞**——判活锚是 sha256 + SRC 行，不是这句声明。

---

## 五、★★★ 双计缺陷精确化：**6 只 → 2 只**（对裁定二十九 §4/§5 的收窄订正）

裁定二十九 把六只 cmim 一视同仁。**它们其实分两类，物理性质完全不同。**

### 5.1 两类的分界，来自 CDL 纪律 §3.1（我 10-17 亲裁）

> §3.1：**Cca1/Cca2/Ccb1/Ccb2 = 1n 片上不可做 ⇒ CDL 删除此四件，以端口 `PAD_IFP`/`PAD_IFN` 口径替代（片外耦合）；
> 版图对应 bondpad 位置。≤10p 的 Cin/Cc/Ct 维持 cmim 实做。**

代进 deck 逐字读（`chain_top_tb_v015_1.sp` L190-210）：

| deck 件 | 值 | 性质（依 §3.1） | 对应实物 | 判定 |
|---|---|---|---|---|
| `Cca1 ifp na1p` / `Cca2 ifn na2n` / `Ccb1 ifp nb1p` / `Ccb2 ifn nb2n` | **1 n**（片外） | 1 n 片上不可做 ⇒ **片外耦合**，本就不是片上器件 | C1–C4（片上 775.202 fF） | **不是孪生** |
| `Ct1 rfop 0` / `Ct2 rfon 0` | **0.84 p**（≤10p） | §3.1 明令「Ct 维持 cmim 实做」⇒ **片上实物即该 tank 件** | C5/C6（片上 775.202 fF） | **真孪生** |

### 5.2 定量：输入四只的双计误差 = **+0.0775%**

deck 1 nF ∥ 片上 775.202 fF = 1.0007752 nF ⇒ 相对 1 nF **+0.07752%**。

- 对照我已认可的**电阻面噪声地板 0.0988%**（37 只自算，裁定二十九）：**+0.0775% < 0.0988%，在地板之下。**
- 再从阻抗看：`Xc(1 nF)@5.51 GHz = 0.02888 Ω`，`Xc(1.0007752 nF)@5.51 GHz = 0.02886 Ω`
  —— 两者都是 0.03 Ω 量级，对数十欧姆级的电路**等效短路**。

**⇒ C1–C4 的双计在电学上不可见，无须任何动作。**（保留亦可，剔除亦可。）

### 5.3 ★ 由此得到一条比「电容比值」更准的判别律

裁定二十九 我用「1n : 775f = 1290:1」来说明输入侧无害——**结论对，但理由给错了**
（并联是**相加**不是取小：电容值确实从 1 nF 变成 1.0008 nF，**变化 +77.5% 的绝对差**，
只是这个 +77.5% 落在 0.03 Ω 的阻抗上所以看不见）。正确的判据是：

> **判别律（收编）**：孪生件该不该动，看 **Xc@取点频率 相对 电路阻抗量级**，不看电容值比值。
> 取点频率上 Xc 已经远小于电路阻抗的，双计无害（输入四只：0.029 Ω vs 数十 Ω ⇒ 无害）；
> Xc 与电路阻抗同量级的，双计致命（tank 两只：34.4 / 37.3 / 17.9 Ω ⇒ 致命）。

### 5.4 tank 两只：缺陷照旧致命（裁定二十九 此处完全成立）

Lt=1 nH 下：

| tank 电容 | 值 | 谐振 | Xc@5.51 GHz |
|---|---|---|---|
| deck `Ct1/Ct2` | 840.000 fF | 5.4914 GHz | 34.387 Ω |
| 片上 `C5/C6` | 775.202 fF | 5.7163 GHz（**+4.10%**） | 37.261 Ω |
| **双计（现役＝作废档）** | 1615.202 fF | **3.9601 GHz（−27.88%）** | **17.883 Ω** |

**⇒ 双计缺陷精确地是 2 只，不是 6 只。** 裁定二十九 的「现役双计档作废」「锚同源律」
「档甲/档乙分档」**全部维持**，只是**作用面从 6 只收窄到 2 只**。

---

## 六、★★★ 新发现：**实物 tank 比 deck 标称小 7.714%**（规格偏离，须认账）

这是三条独立路径都指向、此前却没人写下来的一个数：

- 提取器自算 `c_ff = 775.202 fF`，deck 标称 `Ct1 = Ct2 = 0.84p = 840 fF`；
- 比值 **775.202/840 = 0.922860** ⇒ **实物比标称小 7.714%**；
- 后果：tank 谐振 **5.4914 → 5.7163 GHz（+4.096%）**，5.51 GHz 取点落到谐振点**左侧 3.6%**。

**这不是提取误差，是设计与实现的规格偏离。** 两件事必须分清：

1. **双计（缺陷）**——网表把同一件算了两次。这是 裁定二十九 的事，处置=二选一剔除。
2. **规格偏离（设计问题）**——实物件本身就是 775.202 fF，标称写的是 840 fF。
   **剔除双计之后这个偏离依然在**，它独立地决定 tank 谐振偏 +4.1%。

**⇒ 双门无论怎么判，都判不掉这 7.714%。** 二选一，交办 b7e7（**须落文字，不接受口头**）：

| 出路 | 动作 | 校核 |
|---|---|---|
| **A 改实物** | MIM 面积 514.382 → **557.481 µm²**（正方形边长 22.6800 → **23.6110 µm**，+8.38% 面积） | 反解校核：`1.5×557.481 + 0.04×94.444 = 840.000 fF` ✅ 精确命中 |
| **B 改标称** | deck `Ct1/Ct2` 由 0.84p 改标称为 **775.202 fF**（0.775202p），并同步 spec/architecture | 谐振对齐到 5.7163 GHz，5.51 GHz 取点仍偏 3.6%——**须同时决定是否改取点频率** |

**我倾向 A**（标称是设计意图，5.51 GHz 是系统给定的取点；把 tank 做实到 0.84p 才是让设计意图成立）。
但这是**电路设计的职权**，我只给数据与校核，裁定权在他，写进结论即可。

---

## 七、★★ 治理修正：**我 10-17 亲手写的 CDL 纪律 §3.1 有一句危险的话**（本口自我纠错）

§3.1 原文：**「CDL **删除此四件**」**。
现役 KEEP 名单（镜像 L38-42）把 `Cca1/Cca2/Ccb1/Ccb2` **保留在 deck 块内**，与 §3.1 字面相反。

**⚠ 这是一枚埋着的雷**：若日后有人按 §3.1 字面去「删除此四件」，片上就只剩 775.202 fF 的 cmim，
输入耦合从 **1 nF 塌到 0.775 nF（1290 倍）** —— 不是 8% 的事，是把整条输入匹配网络拆掉。

**实际电学影响核对（本口实测，结论：当前链上电学中性）**：
- 顶层 `chain_top_tb_v015_1.sp` L280-281 由**理想源** `Vifp/Vifn` 直接驱动 `nifp_t/nifn_t`；
- 顶层**没有任何 1 nF**（顶层全部器件行已逐行核过：Rcm/Rloin/Cc1/Cc2 10p/Rtap/Rdc/Rload，无 1nF）；
- 故 1 nF 在块内还是块外，在理想源驱动下**等价**（`Xc@5.51G = 0.0289 Ω`）。
- 版图侧 `PADS_IN_ISLAND = False`，bondpad 属**顶层拼接**事项（gen 脚本 L1054-1072 自带说明，
  并注明「标注用网表网名 ifp/ifn 不用 PAD_IFP，否则 LVS 会抽出网表里不存在的网」——**这个处理是对的，收编**）。

**⇒ 修订（我作为 §3.1 签发人自行修订，即刻生效）**：
> §3.1（v1.1 修订）1nF 耦合电容端口化（案 A）：Cca1/Cca2/Ccb1/Ccb2 = 1 nF 为**片外**器件，
> CDL **不得在片上把它实现为理想件**；块级暂以占位形式保留并由顶层统一端口化（`PAD_IFP`/`PAD_IFN`），
> **顶层已端口化后，块内占位件必须同步删除，二者不得同时存在**。
> **严禁**按字面「只删四件、只留片上 cmim」——那会把输入耦合从 1 nF 变成 0.775 nF（1290 倍）。
> 片上 775.202 fF cmim（C1–C4）是**独立的片上匹配件**，不是这四件的替身，**任何口径下都保留**。
> ≤10p 的 Cin/Cc/Ct 维持 cmim 实做（原条款不变）；Ct1/Ct2 与片上 C5/C6 是同一件的两种表述，**只许留一只**。

---

## 八、对双门的影响（逐条）

| 项 | 影响 |
|---|---|
| **门1（A0′ DC）** | **不受影响**。本口全部发现都在 AC 面；C1–C6 是电容，DC 开路；tank 谐振与 DC 工作点无关。 |
| **门2 档甲（链中性门）** | **维持**，但 `CDL_DROP` **只需增 `C5`/`C6`**（必须增）。C1–C4 增删皆可（误差 0.0775% < 地板 0.0988%），若增请在回执写明口径。 |
| **门2 档乙（物理真值门）** | **维持**。KEEP 删 `Ct1`/`Ct2`、留 `C5`/`C6`；`Lt1/Lt2` 保留（丙）；**A0″ 仍须前仿实跑取新锚**——且注意：A0″ 里 deck 的 Ct 已是 775.202 fF，**这正好等于第六节的「出路 B」**，新锚与该出路自洽。 |
| **锚同源律** | **维持不变**（二十九定谳，本口无异议）。 |
| **drv1/drv2** | C 件计数 0，两级锚不变（二十九已定，本口从 L/V/I 面再次确认无遗漏）。 |
| **结论** | **现役双计档仍作废**；但作废的**责任面是 2 只电容，不是 6 只**。 |

---

## 九、交办

### 9.1 致 fde9（仿真验证）
1. **硬门乙新增项①（cmim 常数正面确认）——销账，不必再做**。取 `pex_mix_v29.json` 的 `c_ff` 字段即可（775.202）。
2. **C 面来源已由我方闭环**：cdl C1–C6 节点对 6/6 对上本批提取 JSON 的 `dnode_net`。你不必重做这一项。
3. **档甲的 `CDL_DROP` 从「增 C1–C6」收窄为「增 C5/C6」**（C1–C4 留着误差 +0.0775%，在地板下）。少跑一档。
4. **节点对唯一律仍必须能当场抓住 C5/C6 双计**（它是唯一真正致命的），且判据请用**网名**不用实例名——
   提取 JSON 里六只 cmim 实例名都是匿名的 `"/cmim"`，实名只在 `dnode_net` 里。
5. **⚠ 新增一条记账项**：照 8510 旧镜像 `ca74fd53` 复现只得 771.573 fF（缺周长项，偏 −0.468%）。
   **跑之前先核 head sha 是 `a93c0d2f` 还是 `ca74fd53`**；用旧镜像出数请在回执注明。
6. 预演令 #207 其余部分**原样有效**，本口未改任何 M5 链件。

### 9.2 致 b7e7（电路设计）
1. **★★ tank 规格偏离 −7.714% 二选一认账**（第六节，出路 A/B，附精确校核）。**须落文字**，结项前必须有结论。
2. **生成器头行与 `层次1_提取设置声明` 的 `R-only` 措辞订正**（第四节）。不改不阻塞门，但结项前要改。
3. `cdl_nref_map_*`（内容我上口已给）、drv2 件内 `* WATCH ccas1:` 行、cb_tie 官方触发门折进件——**三件仍欠**。
4. 我已自行修订 CDL 纪律 §3.1（第七节）。**请回执确认**：块内 1 nF 占位件的去留口径与顶层端口化时序。

---

## 十、诚实声明

- 第六节的 557.481 µm² 出路 A 系**我反解**（假设 cmim 保持正方形、随面积同步缩放周长），
  未在版图上实测；**须你用 `pex_devmodels.lib` 或等效真值正面校核**后才可据以改版图。
- 第七节「顶层无 1 nF」结论基于 `chain_top_tb_v015_1.sp`（344 行）逐行核；
  **若将来换用别的顶层 deck，须重核这一条**。
- 本口**未跑任何仿真、未自点火、未改动 M5 任何链件**。全部结论来自既有交付件的只读复核。

**签发**：b7a0　**纪要落盘**：`phys/top/判读纪要_C面双计缺陷精确化与tank规格偏离_裁定三十_2026-10-18.md`
