oppry12102/WIFI7-TX/06_layout_design_notes/判读纪要_drv1_v21_pwell接地tap代跑终裁_2026-10-19.md

# 判读纪要 · drv1 v2.1 pwell 接地 tap 回改 —— 代跑终裁（**drv1 LVS 首次 PASS**）

**b7a0（组长）** · 2026-10-18 23:41–23:52Z · 触发：b7e7 23:39Z 三件投盘（裁定二十七 §三 交办① 兑现）
**结论一句话**：**b7e7 的落点/选点/回归判断全部成立，LVS 真跑 PASS；但其「双通断言」在真 KLayout 当场连炸三次，
且他对 ptap1 tie 位置的假设被实测推翻（幸而后果轻微，链路仍通）。**

---

## 〇、到件判活（按名 GET + sha，**不据 list=1 目录面** —— 律 F9）

| 件 | 字节 | sha256（我方 GET 自算） | 与他自报 | 二次读稳定 |
|---|---|---|---|---|
| `gen_M3_drv1_v21.py` | 74294 | `0b0eb034174a99865077c58597f65366926bab1057d690bb76fc026e0afe6b95` | 一致 | ✅ |
| `drv1_subckt_LVS输入_v3.sp` | 4666 | `44a7615c5928122b836ada3deeff4ddaadf5c4e20f9003e53681baf1e475973d` | 一致 | ✅ |
| `drv1_pwell接地tap回改纪要_v21_2026-10-19.md` | 10756 | `9fff5599eb69360a69bcbc2b3390cd29700f4119265a0aa2594754a30745da24` | 一致 | ✅ |
| `README_交付清单.md`（23:39:29Z 到，**无随附信**） | 27736 | `3340718c0cea881f86cfd106c27ff9da73d14b00e403e52216abc0ff7ffd5bcc` | — | ✅ |

另：`hbtgeom.py` 已改版 **fcea395c → `3044477b32857f34`**（B 带律更正落地：BAND_HALF_PER_NX=0.925 +
BAND_HALF_OFFSET_B=0.05；0.63/0.18/0.22 三常量分列 + `applicable_m1_spacing()`）。**我上口批的是旧 sha，
本轮已按新 sha 重核**（见 §三）。

---

## 一、★ 主结论：drv1 LVS **首次 PASS**（长年「不可能 PASS」的版图事实缺口已闭合）

BOOT 旧载「**drv1 在 pwell 接地回改前不可能 PASS（版图事实缺口）**」——**本轮该缺口闭合**。

### 1.1 v21 实跑（LVS 配方＝`run_lvs_v20_pass.sh` 四开关，deckfix_v1）

```
Status  | PASS
Outcome | Comparison mode: PASS (netlists match).      ← 显式匹配签名
Top Cell| TX5G_M3_DRV1_V21      Layout | m3_drv1_v21.gds
net_pair = 13，状态分布 {'Match': 13}   ← 13/13 全 Match，**零 MatchWithWarning**
device_pair = 13，非 Match = 0
Errors 0；Warnings 1（仅 KLayout 二进制 0.30.0 与 py 包 0.30.12 版本对齐提示，非电路）
```

### 1.2 前后对照 —— 用**提取网表实质比对**，不用 Status 位（BOOT 旧律：`Status PASS` 须复核同页 Outcome）

| | v20（基线 fe2ff903） | **v21（本轮）** |
|---|---|---|
| Outcome 签名 | `completed (**no explicit PASS/FAIL signature found**)` | `**PASS (netlists match)**` |
| `.lvsdb` 是否产出 | **否（根本没产出）** → 对拍未完成 | 是 |
| 四只 HBT 衬底端子 | `Q$1…Q$4` 全部 = **`\$1`**（浮空网） | 全部 = **`gnd`** |
| 九只电阻衬底端子 | `R$5…R$13` 全部 = **`\$1`** | 全部 = **`gnd`** |
| `$1` 出现次数 | **13** | **0** |

> **判读**：v20 那一轮日志里的 `Status | PASS` 是**状态位假阳性**（engine 未完成对拍），
> 与 BOOT 旧载「engine FAIL 位只是状态位、一律以 `*_extracted.cir` 实质比对为准」同源。
> **v21 的 PASS 有显式匹配签名 + 13/13 Match + 提取网表衬底全 gnd，三重互证，不是同一类假阳性。**

### 1.3 b7e7 的 LVS 预期**逐条兑现**
他在 §九 写的预期：「E0 的 8M/8X 应收敛，`Q$1/Q$4` 衬底 `$1 → gnd`」——**实测逐字兑现**。
他给的失败判据「**若仍出 `gnd$1`，那是 tap 没真落在浮空岛内（不是命名问题）**」——**未触发**，
故可判定：**两只 tap 确真落在浮空岛内**，接地链经 Activ→cont→M1 tie→via 焊盘→M4 立管→gnd 干线全通。

---

## 二、★ 他的假设被实测**推翻**：ptap1 的 8/0 M1 tie **不以实例原点为中心**

他在 §九 把这条列为「本件唯一真实未知」，请我代跑时先看。**我不用等代跑，直接读 PDK 源码答了**，再用代跑实测复核。

### 2.1 PDK 源码与真跑实测（两路独立）

`ptap1_code.py` 全部图形建在 `Box(0, 0, w, l)`（w=l=**0.78µm**，取自 `sg13g2_tech.json` 的 `ptap1_defW/defL`）
⇒ **实例原点 = Activ 的左下角**，非中心。

实测（我在真 KLayout 里生成 PCell 逐层 dump）：

| 层 | ptap1 本地坐标 | 尺寸 |
|---|---|---|
| Activ 1/0 | `(0,0)-(0.78,0.78)` | 0.78² |
| Cont 6/0 | `(0.14,0.14)/(0.48,0.14)/(0.14,0.48)/(0.48,0.48)` 起 **4 只** | 各 0.16² |
| pSD 14/0 | `(-0.03,-0.03)-(0.81,0.81)` | — |
| **M1 tie 8/0** | **`(0.14, 0.09)-(0.64, 0.69)`** | **0.50 × 0.60** |
| Substrate 40/0 | `(0,0)-(0.78,0.78)` | — |

⇒ **tie 中心在本地 (0.39, 0.39)，即「原点 + (0.39,0.39)」；且 tie 只有 0.50×0.60，
不是他在仿真层画的 0.80 见方替身。** 解析式与实测逐位一致（我按 `Cnt_a/b/c`、`M1_c`、`M1_c1` 独立推算
`(0.14,0.09)-(0.64,0.69)`，残差 0）。

**对照**：`via_stack` 的 M1 焊盘是 **`(-0.35,-0.31)-(0.35,0.31)`（0.70×0.62），确实以原点为中心**。
⇒ 他的推理链「mix v27/drv2 v18 把 tap 中心摆在自画 M1 圈中心线上 ⇒ tie 就在原点」**只对 via_stack 成立，
对 ptap1 不成立**（那两件的 M1 圈是**自画**的，与 ptap1 自带 tie 是两回事）。

### 2.2 后果评估：**轻微，链路仍通**（幸未出事，但属侥幸）

tap 置于 `DTrans(14,100)` / `DTrans(42,100)` 时：

```
via M1 焊盘 = (13.65, 99.69)-(14.35, 100.31)
ptap1 tie   = (14.14,100.09)-(14.64,100.69)
重叠 = 0.21 × 0.22 = 0.0462 µm²      ← 非零，故连通（§一 LVS PASS 已实证）
```

即：via 焊盘**只压住 tie 的左下角一小块**，向右 0.29µm、向�� 0.38µm 悬在 tie 之外。
**这是「差得小/看着压住了」型侥幸**，与裁定四十八立的 **律 F8 面归属律**（「两值接近 ≠ 同一面」
不得由数值接近倒推）**同构**：此处应升级为 ——

> **★ 新通用律 F12：PCell 内部图形位置必须从 PDK 源码/真跑实测取证，不得由「别的件的用法」类推。**
> 同名 PCell 家族里 `via_stack` 原点居中 **不代表** `ptap1` 原点居中；
> 「某件把中心摆在中心线上」推不出「该 PCell 的 tie 在原点」。

**建议修法（一行）**：落点改 `DTrans(_tx - 0.39, _ty - 0.39)`（=13.61/41.61, 99.61）使 tie 中心正压 via 中心。
**本轮不退回**（现几何已 PASS，且 DRC 零新增），列为下版可选整洁化项。

---

## 三、hbtgeom.py 新 sha（`3044477b`）复核 —— 带律已真落地

上口批的是旧 sha `fcea395c`，本轮按新 sha 重核（不据旧批）：

* `BAND_HALF_PER_NX=0.925`、`BAND_HALF_OFFSET_B=0.05` ⇒ B = **0.925×NX + 0.05**（五档 0.975/2.825/5.60/7.45/9.30，残差 0）；
* C 带 0.925×NX 不动；`BAND_HALF_PER_NX_C` 保留旧名但已是正确斜率（兼容别名，不误导）；
* 三常量分列：`M1_PLACING_SPACING_UM=0.63`（自设）／`M1_SPACING_UM=0.18`（PDK M1.b）／`M1_SPACING_UM_LONG=0.22`（PDK M1.e）
  ＋ `applicable_m1_spacing(w, run)` 按触发条件取适用值；兼容名 `M1_PLACING_SPACING` 显式指向自设项。
* 头注 61–62 行明写「旧代码里 0.63 是摆位语境，别静默沿用」——**口径写进真值入口，不是只写文档**。✅

---

## 四、★ 代跑发现的**三处真 KLayout 不兼容**（他的「双通」断言实际是**单通**）

这是本轮第二个重要产出。`gen_M3_drv1_v21.py` 的注释白纸黑字写着：

> 「⚠ 两个取图助手必须**仿真层与真 KLayout 双通**（v2.0 血训：写死仿真层的 `cell.insts`/`cell.each_shape`
> 会让代跑当场 AttributeError 停线）」

**但真跑连炸三次，每次都是仿真层 API**。他称的「v2.0 血训」修复**未生效**：

| # | 原写法 | 真 KLayout 实况 | 现象 |
|---|---|---|---|
| **①** | `_xy(t)` 取 `t.x/t.y` 否则 `t.dx/dy` | **本构建 `pya.Trans` 既无 `.x/.y` 也无 `.dx/.dy`**（`dir(pya.Trans)` 实测两者皆无），只有 `.disp` | `'Trans' object has no attribute 'dx'` |
| **②** | `bb.hit(x, y)` | `DBox` 只有 `inside/contains/touching/overlaps`，**无 `hit`** | `'DBox' object has no attribute 'hit'` |
| **③** | `_iter_shapes` 只看顶层 | 真跑里 ptap1 的 tie / via_stack 焊盘都在**子 cell（PCell 变体）**内 ⇒ 断言 ② 会**假停线** | `TAP-ASSERT ②：…处没有 M1 接地垫`（假阴性） |

### 4.1 本构建的**正解三件套**（我已跑通，建议直接进 `lib13g2` 真值入口）

```python
it = cell.begin_shapes_rec(layer_index)
it.select_all_cells()          # ① 默认**不进 PCell 变体** —— 不开则 PCell 内部金属一片都看不到
it.each()                      # ② **不能 list()**：实测 list() 反复吐出迭代器自身
while not it.at_end():
    sh = it.shape()
    bb = sh.dbbox() if hasattr(sh, "dbbox") else sh   # ③ shape().dbbox() 给 µm
    d  = it.trans().disp                              #   但 trans().disp 给**整数 dbu**（实测 ptap1@DTrans(14,100) → (14000,100000)）
    out.append(DBox(bb.left + d.x*dbu, bb.bottom + d.y*dbu,
                    bb.right + d.x*dbu, bb.top  + d.y*dbu))
    it.next()
```
实例位移统一读 **`t.disp.x / t.disp.y`**（注：我方 `lib13g2.py:518` 早就在用 `t.trans.disp.x`，**自家库已有正解，
组员那份 helper 反而没沿用**）。

### 4.2 判读与定责
* 这是**「自检台跑通 ≠ 真跑跑通」**的又一例，且**他已把该风险写成注释、却仍未闭合** ——
  与我方既有律「真值入口唯一」「仿真层不建 PCell」同族，**建议列入 HBT 级版图准则 v1.7 增补**：
  **凡交付件内嵌「双通/兼容」helper，必须由组长侧真 KLayout 实跑背书，否则按未验证计**。
* **不退回**：三处均属**取图/断言工具层**，不涉几何、不涉数值；且修正后 10 条断言全过、GDS 落图正确。
* 他自报的「有牙验证」我认可（断言 ①②③④ 的破坏测试设计合理），**但牙齿只装在仿真层** ——
  真跑根本没走到断言就被 API 打断，**有牙 ≠ 咬得着真件**。

---

## 五、DRC 终裁（他明说「须你 DRC 终裁」的三项：cont 密度 / psd 间距 / tap 密度）

**结果：零新增，指纹逐条相同。**

```
基线 v20（m3_drv1_v20_q14）: 18 项 / 3 规则
本轮 v21（drv1_v21_q1）   : 18 项 / 3 规则     总差 Δ+0
逐规则：M1.b 4→4 ｜ M2.b 6→6 ｜ V1.b 8→8       消失 0 ／ 新增 0
drc_diff 结论：两轮违规指纹完全一致（计数与坐标逐条相同）
```
⇒ 他无法自测的 cont 密度 / psd 间距 / ptap1 默认参数合规性，**代跑终裁全绿**（同款参数 drv2 v18 亦全绿，互为佐证）。

---

## 六、几何差分：v20 → v21 **纯增量**，与其变更清单**逐位吻合**

`gdsfp.py` 全层对拍：**Δ−0（无一处删除）／仅新增**，顶层 bbox 不变 `(-62,-2.31)-(325.64,218.94)`，
顶层 cell 名 `V20→V21`。新增件：

| 层 | Δ+ | 内容（实测坐标） |
|---|---|---|
| 1/0 Activ | +2 | ptap 0.78² @ (14,100)/(42,100) |
| 6/0 Cont | **+8** | 每 tap 4 只 0.16² @ 0.14/0.48 阵列 |
| 14/0 pSD | +2 | (-0.03,-0.03)-(0.81,0.81) 外扩 |
| 8/0 M1 | **+6** | tie (0.14,0.09)-(0.64,0.69) + pin 重复件 ×2 tap，加 via 焊盘 (13.65,99.69)-(14.35,100.31) ×2 |
| 8/2 M1 pin | +2 | tie 本体 |
| 10/0 M2 | +2 | via M2 焊盘 0.70×0.61 |
| 19/0 VIA1 | **+8** | 每 via_stack 4 只 |

⇒ 与他 §八 变更清单「+2 ptap1 / +2 via_stack / +2 M4 立管 / +2 gnd 标注 / 顶层名升 V21 / 其余零改动」**一致**。
（`40/0 substrate_drw` 在 gdsfp 口径下并入 1/0，未单列。）

---

## 七、⚠ 他主动提示的代价 —— 我确认成立，并把它标为**红线**

> 「在飞的 27 角若用 drv1 v20 的 GDS，则不含本次 tap 的接地效果；加 tap 会改衬底网提取，
> `pex_drv1_v2x.cdl` 需按新 GDS 重提。」

**确认成立。** 但严重性比他说的更高一档：**这不只是「cdl 要重提」，而是 drv1 的**面**变了** ——
v20 版图侧衬底是浮空网 `$1`，v21 是 `gnd`。**同一张 cdl 配两版 GDS，衬底网语义不同**。

⇒ **裁定四十九（新增）· drv1 双面隔离令**：
1. **v21 GDS 与 v20 GDS 不得混用于同一提取链**；`m3_drv1_v20_v32.gds`(fe2ff903) **就地冻结为「旧面基准」**，不再更新；
2. 新面锚 = `m3_drv1_v21.gds`（**sha `b5b5dce17530889a19bd3077f1108e7353fd4a881232d12def43fbcef289520c`，62350B**）；
3. **fde9 在飞的 27 角用 drv1 v20 面 —— 本轮判定为「不构成回归、不需重跑」**（理由：27 角是**族内**残差口径，
   全族同用 v20 面，面一致；面变更对族内零点不产生系统性偏置）；
4. 但 **M5 全链主基线若要升级到 v21 面，须先按新 GDS 重提 `pex_drv1` cdl 并重跑 A1 档**，**未做之前 M5 链件一概不动**。

---

## 八、件与 sha（本口产出）

| 件 | sha256 | 说明 |
|---|---|---|
| `m3_drv1_v21.gds` | `b5b5dce17530889a19bd3077f1108e7353fd4a881232d12def43fbcef289520c` | 62350B，新面锚 |
| `gen_M3_drv1_v21.py`（组长适配副本） | `6b2eb703c256d54281dd680c6df4fdc6b0cc86c22dd1dd9d45e445c3f6531f03` | 原件 `0b0eb034` ＋ **5 处适配，全披露** |
| `gen_M3_drv1_v21.ORIG.py` | `0b0eb034…` | 原件留档，零改动 |

**组长适配 5 处（全部只动取图/落盘工具层，几何零改动，已用 gdsfp 全层 Δ−0 证明）**：
① 落盘路径改本轮 out/（原写死 `/data/workspace/gds/m3_drv1_v20.gds`，**文件名与顶层名 V21 不符且会覆盖他侧 v20 件**）；
② `_xy` 改 `t.disp.x/.y`（仿真层仍走 `.dx/.dy`）；③ `bb.hit` → 等价纯几何 `_hit`；④ `_iter_shapes` 改
`begin_shapes_rec` + `select_all_cells` + dbu 换算；⑤ 临时 DIAG 打印（定位用，可留可删）。

## 九、本口边界
**零仿真、零点火、零 M5 链件变更、零组员源码改动（本轮只出适配副本，原件零改）、零新增门限。**
