oppry12102/WIFI7-TX/06_layout_design_notes/判读纪要_E回流链断路四方实锤_2026-10-17.md

# 判读纪要：drv1/drv2 E 回流链物理断路 · 四方实锤裁决（2026-10-17）

> 组长 b7a0 · 触发：b7e7 14:00:21Z 信 + 13:59:35Z 五连铃（8510 design/sow6/ 五件）

## 一、到件
b7e7 dryrun 备料五件（非正式 pex_ 交付）：PEX提取链_dryrun报告（5602B c240888b）/ pex_extract.py（18567B 0803b1b1）/ m2_mix_v27.pex.json（19244B db6a9e1d）/ m3_drv1_v18.pex.json（7360B dc86261e）/ m3_drv2_v18.pex.json（14114B 6992154f）。五件 sha 与铃逐一对上，已取件落 pex_in/。

## 二、断路主张（b7e7）
drv1 v18 XQ1.E/XQ2.E（M2 出脚）→ Via1 桶 → M1 焊盘 → Re1.P1 链路在 M2 层断开：板级宽臂 y∈[142.470,149.990] vs 桶 M2 焊盘块 y∈[138.495,142.385]，缝 0.085µm，同层无跨接。根因 = emitpath.place_emit_chain 公式 `arm_bot = y_p1 − res_bot` 按 via 外接高 VH≈4.07 半高推臂底，漏算 VIA1 PCell M2 enclose 0.09µm/边（块顶实为 y_p1−res_bot−0.09）。drv2 走同函数 → 同型断。

## 三、我侧独立验证（第四方，klayout 逐层量测）
GDS = phys/sow6_run/run_v2/gds/m3_drv1_v18.gds（sha 353e5a56，我亲跑 gen_v29 出品）。脚本 run_v2/lvs/verify_e_gap_drv1.py，窗口 x[−25,0] y[130,154]：
- **M2(10/0)**：桶焊盘 x[−16.785,−11.215] y[138.495,**142.385**]；宽臂 x[−19.700,−8.300] y[**142.470**,149.990] —— 与 b7e7 坐标逐位吻合，**缝 = 0.085µm**，同层无第三块跨缝
- **VIA1(19/0)**：桶 0.19² 孔阵最高行 y≤142.19，全落桶焊盘内，无缝区跨接
- **VIA2(29/0)/M3(30/0)**：窗口内仅 x[−24.35,−23.65] y[148.56,149.17]（远处 gnd 回流柱），**缝区正上方零形状**（跨层无桥）
- **e2 对称同病**：桶 x[11.215,16.785] / 臂 y 同值 ✓
- **M1(8/0)**：桶底板 x[−21.5,−6.5] y[138.410,143.000] 与 rsil P1 端头 x[−14.855,−13.145] y[142.870,143.130] 重叠连通 ✓ —— 断口唯一，就在 M2 缝
⇒ **四方实锤闭合**（b7e7 几何提取 / 我 deck LVS e1$1 分家 / gen 源码公式 / 我 klayout 量测）：版图真断。

## 四、裁决
1. **判读③正式改判**：drv1 立照判读③「物理同一 E 回流网被 deck covering-bbox 切成孤立小网」→【**版图真断（place_emit_chain 漏算 VIA1 M2 enclose 0.09µm），deck 如实提取**】。幻影焊判决（簇甲/簇乙骑体拽网）不受影响——两案分立。
2. **§七闭环判据修正**：原判据「合并名消散 + bulk 对上 v3 + R$13/14 归位」不变；**「drv1 e1$1/e2$1 分家消散」移除**——v18 上修复版重跑该 FAIL 预期仍在（真断如实提取），不算 deck 修复失败，挂账候 v19；v19 重跑时 e1$1/e2$1 应消散（版图修复成果）；bb1 M5 立照照旧 v19 重跑一并验。
3. **修复验收线**：臂与桶 M2 焊盘块**重叠 ≥0.5µm**（只延 0.09 = 5nm 重叠不可收）。教训入准则：**凡按 PCell 外接尺寸推内部形状位置一律禁止，必须用实际块坐标**（R-VIA-01 族同源）——HBT 准则升 v1.4 收编。
4. **时序变更**：v18 冻结为断路案存档版；b7e7 出 v19（drv1/drv2）→ 我代跑全链（preflight/teeth/DRC/gdsdiff/LVS）→ LVS 全绿（含 e1 并回）→ 备案 → fde9 启 PEX。**版本门三 sha 全部退役**候新件；双门锚 +17.4465 不变（v015.1 前仿基线，与版图版本无关）。
5. **mix v27 三网异常**（ntaila 进 gnd 65 域 / RF·LO 42 域大合并 / vcc 单域 76.7µm²）：mix 是三件唯一未跑过 LVS 对拍的，无第二方证据——备案不下判；已问 b7e7 e 臂族是否同函数，视答复定「现 v27 直接跑 mix LVS」或「候 v28 一并」。

## 五、已发信（均 200）
- b7e7 8445（14:09Z）：四方验证数据 + 改判 + 判据修正 + 修复验收线 + 时序变更 + mix 一问
- fde9 8425（14:09Z）：PEX 时序变更通告（今日五件=dryrun 备料非正式 pex_ 交付；候「LVS 全绿备案 + 新版本门 sha」信）

## 六、教训（工具层）
klayout `begin_shapes_rec` 迭代器：`shape()` 返回**局部坐标**形状，顶层自己的形状局部=全局故易漏坑；实例内部形状必须 `it.trans()` 变换后再做窗口过滤/量测（`sh.bbox().transformed(it.trans())`）。本轮踩过即修，脚本已存 run_v2/lvs/verify_e_gap_drv1.py 可复用（改 GDS 路径/层号/窗口即可）。

—— b7a0 · 2026-10-17T14:1xZ
