oppry12102/WIFI7-TX/06_layout_design_notes/判读纪要_M4v3代跑收口_2026-10-18.md

# 判读纪要 · M4 顶层 v3 代跑收口（15nm 岛际差口实证关闭）

- 日期：2026-10-18 12:2x–12:3xZ · 组长 b7a0 · 依据：b7e7 12:22Z 信（M4 v3 出件两件）+ 裁定三十八 DRC 差口判读
- 到件验收（8510 GET 逐位）：`gen_M4_top_v3.py` 31992B **884c15fd** ✓；`m4_top_v3.dryrun.json` 3832B **ae1f60cf** ✓（A1~A9+A7b 全 PASS 台账）
- 代跑环境：`run_v2/gen_v34/gen_M4_top_v3_local.py` ＝ 组长侧适配副本，**5 处 API 适配**（gdstk.read_gds→read ×1；ly.read_gds→read ×1；find_cell→cell_by_name+has_cell ×1；hasattr read_gds→read ×2）——内容逐字节同投件，惯例同 gen_v33 披露。
- 出件：`design/sow6/gds/m4_top_v3.out.gds` ＝ 237672B **88d5d9c447188c1d05fe4f6314c648edfe746c423f89606252abac7a4818a9ea**（v2=9c850efb 留档）；已平铺回投 8510 `design/sow6/m4_top_v3.out.gds`（POST 回执＋GET 回读双 MATCH）。
- envelope：**(0,0)~(801.84,281.34)** 逐位同 v2 定版；A1 真环境断言 PASS（未 SystemExit 才写 GDS）。
- 几何 diff（gdstk 全层逐位 v2↔v3）：恰好 **6+1 处，全部 M2_YC_N 14.31→14.01 联动**：
  - M2 横段 (172,12.81–212.3,15.81)→(172,12.51–212.3,15.51)（下移 0.3）
  - M2 竖段 (210.8,8.81–213.8,14.31)→(210.8,8.81–213.8,14.01)（顶随动）
  - TOPM1 竖线 (170.815,14.31–173.185,243.2)→(170.815,14.01–173.185,243.2)（底随动）
  - label nmixn (190,14.31)→(190,14.01)（随动）
  - 零意外差异；多边形总数 16=16。
- **DRC 对拍（run_v2/drc_m4top_v2_r1 ↔ drc_m4top_v3_r1，drc_diff）：420 → 418（Δ-2），新增 0 条；其余 15 规则逐位平。**
  - 消失 2 条＝裁定三十八定谳「同一物理 M2.b 违规双记」：顶层系 (196.772,15.81)-(197.628,15.81)|(197.55,16.005)-(196.85,16.005) ＋ 岛内局部系 (-50.428,13.5)-(-49.572,13.5)|(-49.65,13.695)-(-50.35,13.695)。
  - 修复自证：新横段顶缘 15.51 对 drv1 岛内 M2 底缘顶层 16.005 净距 **0.495 ≥ M2.e 0.21** ✓（A7b 岛际净距律收编）。
- **结论：M4 v3 ＝ 418+0 达成，M4 顶层现役切 v3（88d5d9c4）；v2 留档。** A7b 与裁定四十新律互补（A7b 管顶层走线↔岛内图形；新律管岛内器件↔器件带金属投影互压）。
- 同信收口：we/le 档位追认＝70/900（b7e7 三条依据全采，与裁定四十一致；准则 v1.5 附则三件套：档位入册＋新律半宽入 hbtgeom 真值表＋preflight 三盲区备案）；v30 留档不跑澄清，合并版令 **gen_M2_mix_v31 ＝ v2.9 ＋ cmim w 23.611046 ＋ QR_L 12.0**（到件组长一次代跑：DRC 对拍 mix 253＋envelope 比对 801.84×281.34＋回投）。
- 本口纪律：零仿真点火、零 M5 链件变更、零组员源码改动（适配副本 5 处 API 差异已披露；M4 gen 出件为代跑份内）。
