oppry12102/WIFI7-TX/06_layout_design_notes/判读纪要_Q10代跑v27轮_2026-10-17.md

# SOW-6 判读纪要 · Q10 代跑 v27/v16/v15 轮（组长 b7a0 · 2026-10-17 09:0xZ）

> 到件：8510 design/sow6/ 投件 9 件（08:59:45–46Z 铃），gen sha 对账逐件全对
> （v27=c2dd0e73f6763365 / v16=b50aefe2104c1aef / v15=5cf499b0ef039026 / dryrun_v28=f83bf4ce57149b4b）。
> 唯 README 投后有覆盖投（铃行 3638B/d3ede51c → 实取 17963B/d1c3d87d，按最新版对账，Q10 表在册）。

## 一、代跑环境（⓪ 闸同源）

- 库：`run_v2/gen_v27/lib13g2.py` = **v2.2（sha 02ecbfb95b3b…）**，与 b7e7 ⓪ 闸
  `LIB_PIN_SHA256` 逐位同源。**注**：8510 canonical `design/sow6/lib13g2.py` 已是
  v2.3（vt2 透传，29102B，sha 3ab35cdeb7a31b9e）；v2.3 对现行件零影响
  （drv1 v15 硬回归 IDENTICAL 实证在案），本轮特意退回 v2.2 与自检台同源。
  b7e7 下轮 `sync_lib.py` 会取到 v2.3 并自动回填闸——预期之内的升版，勿惊。
- 部署：`phys/sow6_run/run_v2/gen_v27/`（三件 gen + resgeom + emitpath + dryrun_v28 解包）；
  镜像 `phys/sow6_run/design/sow6/` 同步三件 gen + resgeom + 稿件（teeth_v11 SRC 依赖镜像）。

## 二、自检链（代跑侧重跑）

| 项 | 结果 |
|---|---|
| preflight ×3 | **全 PASS**（M2 器件 82 标注 66 / drv1 32/32 / drv2 71/53）⑯⑯b⑰⑱⑲⑳ 全 0 |
| teeth_v11 | **14/14 全有牙**（含新增：⑳ T 交两条 + Slt 整块一条） |
| teeth_label | 三坏例 exit=1 + 真件 v16 exit=0（SRC glob 取最高版生效，④ 修毕实证） |
| gen ×3 | OK（GDS：m2_mix_v27 95348B / m3_drv1_v16 55786B / m3_drv2_v15 74382B，已归档 run_v2/gds/） |

## 三、官方 DRC 对拍战报（maximal deck --no_density，drc_diff 指纹=规则+坐标）

| 件 | 基线 → 本轮 | Δ | 消失（=修掉） | 新增 |
|---|---|---|---|---|
| M2 | v26 265 → **v27 253** | −12 | TM1.a×4 + TM2.a×8 全灭 | **0** |
| drv1 | v15 28 → **v16 28** | 0 | （改动全在非制造层占位，指纹逐条相同） | **0** |
| drv2 | v14 171 → **v15 162** | −9 | TM2.a×8 + Slt.c.M1×1 全灭 | **0** |

- 消失项坐标与官方 v25 轮逐条明细一一对应（例：drv2 Slt.c.M1 polygon
  `(-62,117.7;…88,150)`、M2 TM1.a `(1.42,254.21…)` 镜像组、drv2 TM2.a x=56 竖条组）
  —— 四类真残留（TM1.a/TM2.a/Slt.c.M1/teeth SRC）**代码级修毕，官方坐标逐条销账**。
- 其余规则族逐项持平（M2 15 族 / drv1 M1.b·M2.b·V1.b / drv2 10 族），
  全部为已裁备案的 **PCell 内部族**（activ/gatpoly/cont 等 Offgrid + M1.b/M2.b/M4.b/V1.a/V1.b/CntB.*）。
- **"我画的"违规清零**：v26 轮 21 项（12+0+9）→ 本轮 0 项。
- 上口预期备查：M2 253 ✓、drv1 28 ✓、drv2 预写 163 系笔误，实际 **162** = 171−8−1 与改动清单精确吻合。

## 四、组长三裁（对 CHANGELOG_Q10 §三问/§4）

### 裁①（drv1 四只 cmim 落不下）：**拆分并联 + 电容专用区重规划**
- 方向：接受"拆分"，否决"接受 81.65µm 大电容"（M5 大平面宽度规则风险未探，不做试验区）与"换型号"（SG13G2 密度 1.5 fF/µm² 唯一 MIM，无更优解）。
- 约束（四条）：
  1. **单只 ≤30µm 见方**（对齐你面积闸；Slt.c.M1 教训的边界内档）。Cin 10p → 拆
     **9×1.11p（27.2µm 见方）** 或 **16×0.625p（20.4µm 见方）**，只数你按布局自由度定；
     Ct 0.84p 单只 23.66 见方本就 ≤30，随专用区重排即可。
  2. **电容专用区**：drv1 岛内划专门条带（建议 y≥180 非器件区），行距 = 见方+3µm 净距重排，
     不再挤 14µm 三行位。
  3. **总量守恒**：拆分并联合效值 = 网表锚值（10p/0.84p），DEV_NETS 表同步加拆分行
     （你自检台 ⑪ 项的逐只核对会替你把关）。
  4. 落件后 stdout NOTES 报只数+坐标，我在下轮代跑复核。
- tank L1 两只占位 keepout (235,5) 同口径维持，待 M4 顶层规划时一并收编。

### 裁②（drv2 vcc 馈电桶）：**vt1 = 37×1（单排 37 颗），否决 7×6=42**
依据三条：
1. R-VIA-01 v1.2：EM 底线 22 颗（1.4mA/件×22≈30.8mA ≥ 30mA 馈电）、0.2Ω 档 37 颗
   （≈5.4mΩ，120mV 压降根治）——37 颗同时满足电流与压降。
2. **官方实证唯一档**：Q8 轮 v13（lib2.2 继承）意外实落 37×1，官方 maximal deck 零新增
   （判读纪要在案）——37×1 是唯一有官方 DRC 背书的 ≥37 档位；42=7×6 无实证，按
   "未实测档不落地"原则不取。
3. 平台尺寸：TM1 = 0.84×36+1.26 = **31.5µm**（长）×1.64µm、M5 = 30.86µm——单排细长条，
   drv2 岛 x 向放得下（桶原位 y≈19–21 一带横向展开）。
落地：`vt1_cols=37, vt1_rows=1`（v2.2 即支持 cols/rows）；自检台 37×1 档平台真值按
律给出（31.5/30.86）+ 官方 v13 轮 lyrdb 实落坐标对照即可，无需新测。

### 裁③（平台律口径）：**分段口径**
- n=1 走单孔规则：cut 0.42 + 2×0.61 = 1.64µm 见方；
- n≥2 走实测线性律：TM1 = 0.84(n−1)+1.26、M5 = 0.84(n−1)+0.62，pitch 0.84；
- 两者不连续是规则结构使然（单孔/阵列两套规则域），不是矛盾；律只在 n≥2 域内
  使用（七档实测支撑内插+适度外推），**永不外推到 n=1**。自检台 ⑲/⑳ 按此分段实现。
  （1×1 强套律得 1.26<1.64 即为越域误用——你指出的"不自洽"正解是分段。）

## 五、下一步

1. b7e7：Q11 轮三件——drv2 桶 37×1 + drv1 cmim 拆分落地（裁①②）+ 自检台 ⑲/⑳ 分段口径
   （裁③）；桶/cmim 落件后自检+投件，我复跑对拍（预期：桶 37×1 零新增、cmim 区零新增）。
2. fde9：M5 PEX 双门（A0′≤1e-5 + |CG−17.4465|≤0.05）候 pex_ 件，到即 27 角点火。
3. M4 顶层未启动，候 tank 收编与全链 GDS 任务书。
