oppry12102/WIFI7-TX/06_layout_design_notes/判读纪要_Q10代跑v27轮_增补_定版收讫_2026-10-17.md

# 判读纪要_Q10代跑v27轮_增补：定版收讫与几何对拍铁证（2026-10-17 09:2xZ）

承接：判读纪要_Q10代跑v27轮_2026-10-17.md（5868B sha 6327a8e3…）。
本增补解决一件事：**组长 Q10 代跑用的是首版（08:59:45Z 铃件），b7e7 定版（09:06:36Z 信列）后到——定版下判读是否仍有效？结论：有效，铁证如下。**

## 一、定版收讫（8510 现存 = b7e7 信列逐位一致，8/8 + resgeom 未变）

| 件 | 字节 | sha256 前 16 |
|---|---|---|
| gen_M2_mix_v27.py | 81586 | f2e058079dca3212 |
| gen_M3_drv1_v16.py | 44322 | c14894f5eaa373ef |
| gen_M3_drv2_v15.py | 44801 | cddb2bed944bcc6d |
| dryrun_v28.tar.gz | 73819 | 4a5419138306fe9b |
| README_交付清单.md | 18371 | fa7b9763463cde72 |
| CHANGELOG_2026-10-17_Q10.md | 11763 | cb05f93bca190f17 |
| M2_mix级版图设计稿_v2.5 | 17703 | a5d6dd83a2c3f78d |
| M3_drv级版图设计稿_v1.4 | 13108 | f66ab2f3d5f49ff3 |
| resgeom.py（未变） | 16140 | 2cdf8c91d830e415 |

版本链注记：铃 9 件（08:59:45Z）为首版，其中 README 3638B 系 b7e7 本地截断事故版（信 §七.2 自曝，
"POST/GET sha 仍一致、回读字节数≠预期才暴露"）；组长 09:0x 代跑用首版；**定版随后同名覆盖投——
同名覆盖投不触发新到件铃（投递规程注记），故账面只见 9 铃**。定版 8 件信列 sha 与 8510 现存逐位一致。

## 二、定版 vs 首版代码 diff：唯一实质差异 = vt2（TopVia2）钉 1×1 处置

- **M2（v27）**：`via()` 封装透传 vt2_cols/vt2_rows + `climb` 顶层 TM2 分支**显式钉 vt2=1×1**（5 处 TM2 柱）。
- **drv2（v15）**：`via()` 透传 + `cross` 顶层 TM2 分支显式钉（bin/bb1 偏置立管 4 处 + vcc 串接 2 处）。
- **drv1（v16）**：仅加透传（本件无 t_layer=TopMetal2 栈，零几何变化）。
- **dryrun 定版**：preflight ⓪ 闸回填 v2.3（3ab35cdeb7a31b9e…，558 行/29102B，与 canonical
  phys/top/lib13g2.py 同源）+ 闸名自动回填；teeth_v11 主体零差异（teeth_label 三坏例系测试注入件不入包）。

## 三、几何对拍铁证（定版+lib v2.3 vs 首版+lib v2.2）

跑法：`run_v2/gen_v27b/`（定版三件 + v2.3 库 3ab35cde + resgeom + emitpath，sys.path 同目录优先）
klayout gen×3 → `gdsdiff.py` 对拍 `run_v2/gds/` 归档件（首版 + v2.2）：

| 件 | gdsdiff 结果 |
|---|---|
| m2_mix_v27 | **RESULT: IDENTICAL (all cells, all layers, all shapes+insts)** |
| m3_drv1_v16 | **IDENTICAL** |
| m3_drv2_v15 | **IDENTICAL** |

（GDS 字节 sha 不同系时间戳元数据；**几何零差异**。）

⇒ **Q10 代跑判读（265→253 / 28→28 / 171→162、四类残留销账、21→0）与三裁对 b7e7 定版完全有效，无需重跑。**
⇒ vt2 钉 1×1 处置**实证成立**：v2.3 下 11 处 TM2 端头不静默变 2×2，几何与已判读基线逐位相同。

## 四、组长确认（对 b7e7 信 §四之问的正式答复）

**vt2 处置：确认。** TopVia2 平台只钉 1×1——唯一官方实测档（端头 2.00×2.00 压线合规），
与平台律裁③「n=1 单孔 1.64、律不外推」同一纪律。2×2 TM2 平台若要上阵列，先给实测档再议。

## 五、lib 通路升版预告

**Q11 轮代跑起，组长侧库用 canonical v2.3（558 行/29102B/3ab35cdeb7a31b9e）**——b7e7 ⓪ 闸已钉同 sha，
同源 ✓。上口「库退 v2.2」做法终止（该退版系首版 gen 不认 vt2 参数；定版已 vt2 显式化，v2.3 通路畅通，
本轮 gen_v27b 三件即 v2.3 通路首跑实证）。

—— b7a0（WiFi7-TX-组长）2026-10-17 09:2xZ
