oppry12102/WIFI7-TX/06_layout_design_notes/判读纪要_Q11代跑v16轮_2026-10-17.md

# 判读纪要 — SOW-6 Q11 代跑 v16 轮（drv2 桶 13×3 落地轮）

**轮次**：Q11（b7e7 09:06→09:24Z 交件，7 件 sha 全对收讫）
**代跑**：组长 b7a0，2026-10-17T09:32~09:36Z
**部署**：run_v2/gen_v28/（gen_M2_mix_v27 + gen_M3_drv1_v16 + gen_M3_drv2_v16 + resgeom + emitpath +
　lib13g2 **canonical v2.3** 558行/29102B/sha 3ab35cdeb7a31b9e + dryrun_v29 解包）
**投件 sha 锚**（8510 GET 回读 = 信列，7/7）：
　v27 f2e05807… / drv1_v16 c14894f5… / **drv2_v16 8af5caa6…（本轮唯一改件）** /
　dryrun_v29 a4fbaf76… / M3设计稿_v1.5 1c554818… / CHANGELOG_Q11 097cb1c7… / README 2b4e8a91…
**作废件**：gen_M3_drv2_v15（旧落点悬空）、dryrun_v28（pya Trans bug）——按 b7e7 宣告，不再代跑引用。

## 一、⓪ 闸与自检台复现（与 b7e7 报告逐位一致）

| 件 | ⓪ 闸 | 自检 | 器件/标注 | ⑯⑯b⑰⑱⑲⑳ | ㉑ |
|---|---|---|---|---|---|
| M2 v27 | v2.3 3ab35cde ✓ | PASS | 82/66 | 全 0 | 0（接上 102） |
| drv1 v16 | v2.3 3ab35cde ✓ | PASS | 32/32 | 全 0 | 0（接上 38） |
| drv2 v16 | v2.3 3ab35cde ✓ | **FAIL（唯一）** | 71/53 | 全 0 | **1** = via_stack17#68 底端 M5 pad (23.725,211.905)~(42.275,212.095) 浮空 |

teeth **16/16 全部有牙**（v29 包；三坏例注入逐条红、真件绿）。
㉑ 唯一 FAIL 即 b7e7 报告的桶 M5 端悬空——待裁项，见三之①。

## 二、DRC 战报：三件全持平基线，指纹逐条全同

| 件 | 基线轮 | 新轮（_q11） | 总差 | 指纹对拍（drc_diff） |
|---|---|---|---|---|
| M2 v27 | 253（run_v2/drc/m2_mix_v27） | **253**（m2_mix_v27_q11） | Δ+0 | **计数与坐标逐条相同** |
| drv1 v16 | 28 | **28** | Δ+0 | **计数与坐标逐条相同** |
| drv2 v15→v16 | 162（m3_drv2_v15） | **162**（m3_drv2_v16_q11） | Δ+0 | **计数与坐标逐条相同** |

M2/drv1 为未改件（脚本 sha 同 Q10），本轮重跑=DRC 级复现实锤
（GDS 文件字节差异仅头部时间戳；几何由 DRC 指纹 + gdsdiff 双重证实）。

## 三、四项裁定

### ① 桶 M5 端：**选②——整根撤除**（v17 落实 via_stack17 删除）

理由链（四条，均可查证）：
1. **电路拓扑已闭环，桶无源可接**：drv2 vcc 大电流路径 = RL.P1（~30mA 全量）注入上环 →
   TOPM2 立管串上下两环 → Rref.P1 偏置支路。M5 层=nref1..4+偏置网，**没有也不该有 vcc 网**
   （vcc 分配走 TopMetal 是正确层选：EM 15/16 mA/µm、Rsheet 全栈最低）。
2. **造 M5 干线=零收益负收益**：M5 在 TM1 之下，干线的源仍须从顶层打柱下来（+2.2Ω/件 TV1 转换）、
   顶层集成（M4）时还得再打柱回去——凭空多一层绕行、一段 DRC 面、一个模块端口规划依赖，无任何电功能。
3. **桶从未生效，删=回归已验证基线**：v13 起两端悬空，四轮代跑 DRC 全绿、M5 typ 前仿基线
   CG=+17.4465 dB 均为「无桶」状态跑出——撤除零风险。
4. **不违背准则**：R-VIA-01 强制对象是发射极回流桶（0.2Ω 档 187 件/边，已另行落地在册）；
   vcc 顶层馈电桶系版图侧按 R-VIA-01 精神自愿增设的冗余，非条款，撤除不违约。

配套两句（v17 落实时一并办）：
- **EM 复核留痕**：RL.P1 单点 30mA vs 上环 TM1 6µm 宽（15 mA/µm ⇒ 90mA 能力，裕 3×）；
  RL pycell pad 按官方规格，自检台补一行复核结论即可，不用画新金属。
- **将来预案（M4 顶层设计输入）**：若顶层集成时 IR/EM 复核要求给上环加独立馈电，
  用 **TM2→TM1 TopVia2 柱**（1.1Ω/件、10mA/件，Jmax 为 TV1 的 7 倍）从顶层环网垂直馈入——
  层序正确、无绕行。届时按 R-VIA-01 分层签核法报件数。

### ② drv1 四只 cmim 放不下：**改面积规划，metal-only**（c 为主、a 为形）

- 容值**不动**（Cin1/Cin2=10p、Ct1/Ct2=0.84p，spec 值）；换型号**排除**（cmim 1.5 fF/µm² 为全 PDK
  唯一 mim 密度；射频匹配电容不可换 moscap）。
- 拆分口径沿用 Q10 裁定：**单只 ≤30µm 见方**。Cin 10p 拆 **8×1.26p（28.97µm）**或
  **12×0.84p（23.66µm）**，按排布最优自选；Ct 0.84p 单只 23.66µm 已合规。
- 约束：**器件/HBT/电阻/通道约束不动**；电容区 + 关联 vcc 顶层横轨/地轨做 **metal-only 局部重排**
  （行距按规则表，落点自检 ⑯~㉑ 全绿为准）。
- 出口条款：metal-only 重排后仍放不下 → 允许电容区外扩到岛边空地（报备具体坐标）；
  仍不够 → 升级到我这里重议（那时才动器件）。代跑侧我按 drv1 基线 28 对拍兜底。

### ③ 代跑：本轮已办（战报见上）；LVS 列候办

- GDS+DRC+teeth+preflight 全链闭环如上；桶悬空由裁定①直接消解，LVS 不阻塞本件。
- LVS 环境本侧已确认在册（$KLTECH/tech/lvs/{run_lvs.py, sg13g2.lvs}），真跑需 schematic 网表对齐
  （drv2 子电路抽取，牵仿真侧）——**列候办，M4 立项前配套**，届时 drv2 vcc 网必查（本轮裁定①后应干净）。

### ④ TopVia2 阵列：维持全钉 1×1（重申既有裁定）

2×2 的 TM2 平台无实测档（TopVia2 仅 1×1=2.00 一个实测点）——不实测不上阵列。
将来拿到官方 2×2 平台实测（按 TopVia1 七档表同法），再议升档收编。

## 四、我侧部署备注

- design/sow6/m1_lib/lib13g2.py 镜像陈旧（v2.2 02ecbfb9）已升 **v2.3 3ab35cde**（与 ⓪ 闸同源）。
- emitpath.py/resgeom.py 从 gen_v27b 同步进 gen_v28（8510 白名单不含此二件，属代跑侧基建）。
- 新轮 DRC 目录：run_v2/drc/{m2_mix_v27_q11, m3_drv1_v16_q11, m3_drv2_v16_q11}；
  基线轮目录原样保留。

—— 组长 b7a0（WiFi7-TX-组长）2026-10-17T09:3xZ
