oppry12102/WIFI7-TX/06_layout_design_notes/判读纪要_Q12代跑v17轮_2026-10-17.md

# 判读纪要 · Q12 代跑轮（drv2_v17 撤桶 + drv1_v18 电容外置）· 2026-10-17

签发：b7a0（WiFi7-TX-组长）· 2026-10-17T10:1xZ · 对应裁定：Q11 四裁定之 ①（vcc 顶层馈电桶整根撤除）与 ⑤（drv1 cmim 外置独立电容区，b7e7 选出口条款③）

## 一、收件对账（3/3 sha 全对）

| 件 | bytes | sha256(前16) | 与信自报 |
|---|---|---|---|
| gen_M3_drv2_v17.py（撤桶版） | 48339 | 2922594018de1df7 | ✓ |
| gen_M3_drv1_v18.py（外置版） | 57438 | 2a305b68f69cac60 | ✓ |
| dryrun_v32.tar.gz | 141567 | 58d50cb5e3026d62 | ✓ |

部署：gen_v29 原地换件（v17/v18 落位，v16/v17 旧件退役；lib13g2 v2.3 3ab35cde / resgeom / emitpath / emitpath 不动）；镜像 design/sow6/ 同步 v17/v18。dryrun 升 v32（v30 归档 dryrun_v30_bak）。

## 二、代跑判读（每件：preflight → teeth → gen → DRC → gdsdiff）

### drv2_v17（裁定① 撤桶）——五关全绿
1. preflight **PASS 70/52**；㉑ 接上 92 / 悬空 **0**（桶撤后零悬空，v16 时代的 ㉑=1 FAIL 消失）；⑯⑯b⑰⑱⑲⑳ 全 0 —— 与 b7e7 自报逐字一致。
2. teeth **16/16 全有牙**：KNOWN 白名单按裁定清空（桶退役，v1.6 时代两条 ㉑ 桶牙随之退役），基线为真 PASS；新牙含「复活一颗两端全浮空 TopVia1（注入 (65,195) 空地）」+「裁定① 拆出并联单元两端网名接错」——新检查项自己有牙。
3. gen OK（`M3-B DRV2 V1.7 OK`）；**EM 复核行落 stdout**：`vcc 上环 TOPM1 6.0µm × 15mA/µm = 90mA 能力 ≥ RL.P1 注入 30mA（裕 3.0×）`，口径即 90mA@6µm；岛核 bbox 不变（185×257）。
4. DRC `_q13`：**162 → 162（Δ+0），指纹完全一致**（计数与坐标逐条相同）：M1.b 22 / M2.b 20 / V1.b 20 / cont_Offgrid 20 / extblock 14 / gatpoly 20 / metal1 32 / polyres 10 / psd 2 / salblock 2 —— 十规则零漂移，四类真残留族形态不变。
5. gdsdiff v16(37×1)→v17：**唯一差异 = cell `via_stack$9` 消失**（=被撤的桶），其余全层零 delta —— 撤桶干净、无附带变形，与 b7e7 预期「唯一 delta=桶族消失」吻合。

### drv1_v18（裁定⑤ cmim 外置）——三关全绿
1. preflight **PASS 32/32**；㉑ 接上 38 / 悬空 0；分段平台律七档实测全一致 —— 与自报一致。
2. gen OK（`M3-A DRV1 V1.8 OK`）；CMIM 外置台账：34 只全数外置、总量守恒 **21680fF**（20p+1.68p）、条带 4 列×9 行、列距/行距=见方+3、区约 91×214µm、全落 **(235,5) 非制造层**；核 bbox 制造层口径不变（118×206）；`_bb_mfg` 双口径打印（制造层口径 + 全 cell 口径并列，不可互比性已自注）。
3. DRC `_q13`：**28 → 28（Δ+0），指纹完全一致**：M1.b 11 / M2.b 9 / V1.b 8；gdsdiff v17→v18 **唯一 delta = 235/5 层（4→72 件，B-only 全在该层）** —— 真金属零变化实证，与「仅 235/5 动」的轻量口径吻合。

### dryrun_v32
teeth CASES = v27 / drv1_v18 / drv2_v17；preflight ④ 岛界豁免 235/5（裁定⑤口径同步）；新增 `freemap.py`（核内净空地图：净自由面积/最大净空矩形）——M4 顶层电容区布局规划直接可用，收。

## 三、与 b7e7 自报对照表（全一致）

| 项 | b7e7 自报 | 我实测 | 判 |
|---|---|---|---|
| drv2_v17 preflight | PASS 70/52、㉑=0（接上 92） | 同 | ✓ |
| drv2_v17 DRC | 162 指纹全同 | 162→162 Δ+0 | ✓ |
| drv2_v17 gdsdiff | 唯一 delta=桶族消失 | cell via_stack$9 消失 | ✓ |
| drv1_v18 preflight | PASS 32/32、㉑ 悬空 0 | 同 | ✓ |
| drv1_v18 DRC | 28 指纹全同 | 28→28 Δ+0 | ✓ |
| drv1_v18 gdsdiff | 唯一 delta=235/5 | 4→72 件全 235/5 | ✓ |
| teeth | 16/16（KNOWN 清空） | 16/16 全有牙 | ✓ |
| EM 复核行 | 90mA ≥ 30mA | stdout 逐字 | ✓ |

## 四、裁定与备注

1. **备询①（cell 名）裁定：维持不动。** 板/cell 名历史 strings（`TX5G_M3_DRV1_V16` / `TX5G_M3_DRV2_V14`）本轮不升——改名会添非几何 delta、损 gdsdiff 对拍语义；**M4 顶层立项时三件+顶层件统一升 M4 版名**，一并入清单。
2. **备询②（错账订正）：认可。** 「核被占满/缺 237µm」系条带自锁核顶之误（实测器件+过孔仅占核 2.4%），订正存档件已投盘；外置后台账作废口径以本纪要为准。
3. net_check 短路嫌疑簇（drv1 `['bb1','bin','e1','e2','ntail']` / drv2 `[…ccas1,ccas2…]`）与 v16 逐字同形——发射极回流网标注簇的历史备案形态，非本轮引入，继续挂 LVS 候办一并核。
4. 版图侧口径：R-VIA-01 台账回 **150 件/边**（发射极回流桶=强制对象；顶层馈电 37 件按裁系自愿冗余，随桶撤除不再计入）。

## 五、结论

**Q12 撤桶+外置轮代跑全绿收口**：DRC 三件 **253（m2 v27，本轮无新件，_q11 基线沿用）/ 28 / 162** 指纹全同、两件 gdsdiff 唯一 delta 均与声明吻合、teeth 白名单清零后真 PASS。SOW-6 版图侧剩余：**M4 顶层**（上环独立馈电 TM2→TM1 预案 + cmim 独立电容区落地，freemap 已备）与 **LVS 配套**（候 drv2 子电路网表）；仿真侧候 fde9 PEX 双门（A0′≤1e-5 + |CG−17.4465|≤0.05）。

—— b7a0 · 2026-10-17（墟寻）
