oppry12102/WIFI7-TX/06_layout_design_notes/判读纪要_Q8代跑v25轮_2026-10-17.md

# 判读纪要 · Q8 代跑 v25 轮全链（gen v25/v14/v13 + dryrun v26）

组长 b7a0 · 2026-10-17T08:0xZ · SOW-6 M2/M3 · 触发：b7e7 inbox 130（Q8 交付信 07:47:55Z）+ 到件铃 9857–9864

## §1 交件收讫（8510 /files 取件，sha 逐位对账 8/8 ✓）

| 件 | 文件 | 字节 | sha256 前 16 |
|---|---|---|---|
| M2 | gen_M2_mix_v25.py | 69573 | 1a6f91f42756cfa8 |
| drv1 | gen_M3_drv1_v14.py | 33118 | eea75ca2fd0986d0 |
| drv2 | gen_M3_drv2_v13.py | 35842 | 6144b91b08750852 |
| kit | dryrun_v26.tar.gz | 171164 | 348b291a66a10416 |
| 清单 | README_交付清单.md | 11897 | 46b9a1c5f01b5296 |
| 变更 | CHANGELOG_2026-10-17_Q8.md | 5446 | fe6d7f8d47fc7a28 |
| 设计稿 | M3_drv级版图设计稿_v1.2_2026-10-17.md | 6954 | 469895c83cd998f6 |
| 模块 | resgeom.py | 16140 | 2cdf8c91d830e415 |

部署：`run_v2/gen_v25/`（三件 gen + resgeom.py 新件 + **lib13g2.py v2.2** sha 02ecbfb9… 与 canonical 同 + emitpath.py + dryrun v26 解包）；teeth 符号链接 `phys/sow6_run/design/sow6 → ../run_v2/gen_v25` 已重指。GDS 落 `run_v2/gds/{m2_mix_v25,m3_drv1_v14,m3_drv2_v13}.gds`。

## §2 代跑全链

1. **gen×3（真 klayout 0.30.0）**：三件 OK。器件 82/32/71，官方 label purpose /1 补打 82/32/53 处。
   1/168 晶格修复实证：Rba1 2000Ω → l=1.470238（×168=247 整，旧 %.4g 的 1.471→离格 0.00014 那族已灭）。
2. **DRC×3（官方 maximal deck --no_density）**：M2 265 项 / drv1 28 项 / drv2 171 项（§3）。
3. **preflight×3（dryrun v26）**：三件 PASS（⑯⑰⑱ 自侧量测与 b7e7 自报一致）。
4. **teeth：11/11 全部有牙 ✓**。**label 3 牙跑不了**：`teeth_label/gen_teeth.py` 第 10 行
   `SRC = …/gen_M3_drv1_v13.py` 硬编码旧名 → FileNotFoundError。**正是 b7e7 自己总结的
   「旧名静默跑不到件」同类坑，这次漏改的是派生源头**。v14 锚点（relabel_official）在，改一行 SRC→v14 即愈。

## §3 官方 DRC 战报（v24 → v25）

| 件 | 官方总项 | 非 Offgrid 族 | Offgrid 族 | 主要消亡 |
|---|---|---|---|---|
| M2 | 1280 → **265** | 65 → 69（TM1.a 58→4、TM2.a 31→8 计入） | 1215 → 196 | via1-4/TM1-2/metal2-5 Offgrid **全灭** |
| drv1 | 175 → **28** | 37 → 28 | 138 → **0** | Offgrid 全灭、TM1.a 9→0 |
| drv2 | 825 → **171** | 103 → 71 | 722 → 100 | via1-4/metal2-5 Offgrid 全灭、TM1.a 18→0 |

（b7e7 信中「drv1 37/drv2 103」=非 Offgrid 口径，与本表一致。）

## §4 残留解剖与裁决

### 4.1 PCell 内部族 → **备案接受（b7e7 无责，修不了）**
- **Offgrid 残留 296 项（M2 196 + drv2 100）100% 离格实证**：三件 Offgrid 逐项验 5nm 对齐，
  drv1 对齐 0 离格 0（他画的清零方法实证有效）；M2/drv2 残留**全部离格**
  （activ 77.092/77.872、gatpoly −26.333 等 = npn13G2 PCell 本体特征坐标）。
- **M1.b / M2.b / M4.b / V1.a / V1.b / CntB.h1 / CntB.g2**：九个残留族对 v24/v25 坐标集合对比，
  **数量逐族守恒、坐标全部更新**（v24 残留于 v25 = 0）——PCell 内部来源铁证（b7e7 挪器件、PCell 内部相对几何随之平移）。
- 裁决：官方 PCell 实例自带几何与 maximal deck 的内生紧张，交付件不计违责；备案进结项报告，
  tapeout 前如需消除换 PCell 参数组合再议。

### 4.2 可修残留（→ b7e7 下一轮，坐标全在明细文件）
1. **TM1.a×4（M2）**：b7e7 自画 TM1 走线 **T 交半搭接凹角**（非 PCell！GDS 溯源）：
   - 35×1.64 横条 @(0,254.21) × 1.64×12 竖条 @(−0.82,243.03)（顶端 255.03 悬在横条 254.21–255.85 内部）
   - 同构镜像 @(34.18,243.03) 组。修法：竖条贯通横条（顶 ≥255.85）或退到横条外（顶 ≤254.21）。
   - 他的 drcgeom 只量矩形 minw，**并集后凹角是真盲区**（⑯⑰⑱ 全绿 ≠ 凹角合规，再添一条诚实边界）。
2. **TM2.a×8（M2）**：同构——93.05×2 横条 @(−38.2,9) 与 2×2.8 竖块 @(−39.2,10) 等 4 处 T 交（x=±对称）。
3. **Slt.c.M1×1（drv2）**：polygon 仍 150×32.3 实心 @(−62,117.7)。**开槽方案未落地**：
   gen_M3_drv2_v13.py 第 284 行仍 `b.rect("M1", NT_X0, NT_Y0, NT_X1, NT_Y1)` 一整块（注释 §三写了方案）。
   且方案要修正：**两条 16.15 轨紧贴并集=32.3 实心照报**；必须真缝——如两条 15.15 轨+中缝 2.0+右端搭桥
   （EM：29.28mA/2=14.64mA 每轨 @1mA/µm → 15.15 宽裕量 1.03 ✓；或保 16.15×2 但总跨 34.3，位置自核）。

## §5 b7e7 三问答复

1. **via_stack 焊盘尺寸**：无独立「焊盘尺寸」参数——焊盘=阵列外推，档位即参数。
   **v2.2 库 Board.via(cols=, rows=, vt1_cols=, vt1_rows=)**；t=TopMetal1 时 vt1 缺省继承 cols/rows。
   TM1 跨接堆（TopVia1）端头实测（本机 klayout 实跑，v2.2 库）：
   | vt1 档 | TM1 端头 | M5 端头 | TM1.a(≥1.64) |
   |---|---|---|---|
   | 1×1 | 1.64×1.64 | 0.62 | 压线合规 |
   | 2×2 | 2.10×2.10 | 1.46 | ✓ |
   | 3×2 | 2.94×2.10 | 2.30×1.46 | ✓ |
   | 4×4 | 3.78×3.78 | 3.14 | ✓ |
   | 5×5 | **4.62×4.62** | 3.98 | ✓（你猜的 2.23×1.91 证伪——那是 vn 0.41 pitch 的算法，TV1 实际 pitch 0.84） |
   | 6×6 | 5.46×5.46 | 4.82 | ✓ |
   线性律：**TM1 端头 = 0.84·(n−1)+1.64**（此前「非线性」结论修正：1x1/3x2 外扩/侧数字不同，
   但整体系数线性；上口 probe 纪要 §3 的「勿自行外推」解除，本表即外推依据）。
   **TopVia2 堆（M5↔TopMetal2）**：默认端头 TM2=2.00×2.00 压线合规；vt2_columns/vt2_rows 直连官方
   PCell 有效（3×3→5.82×5.82）——**v2.2 封装未透传 vt2，我升 v2.3 补**（与你的交付件零交集）。
   另：M2 现存 TM2.a×8 不是堆端头，是你自画 T 交（§4.2.2），放大阵列不解决它。
2. **逐条坐标明细**：三件全量 **464 条**（规则+官方描述+cell+坐标）已投盘
   `design/sow6/DRC逐条坐标明细_v25轮_2026-10-17.md`（run_v2/drc/ 三件 full.lyrdb 同源可复查）。
   PCell 内部族已按 §4.1 裁决备案；你只需按 §4.2 三处改。
3. **lib 版本**：代跑实际解析 = `run_v2/gen/lib13g2.py`（本轮 gen_v25/ 同 sha 副本）。
   **你信里 v1/v2.1 分歧已终结**：07:44Z 投盘 `design/sow6/lib13g2.py` = **v2.2**
   （sha 02ecbfb95b3b4cee…，含 vt1 透传修复）；phys/top/（v1 遗留）与 top/（v2.1 快照）均冻结弃用。
   你 ⓪ 库版本闸直接钉 **v2.2 / 02ecbfb95b3b4cee**；sync_lib.py CAND 指向 canonical
   （上口回执已给一行改法）。你本轮「改在交付件、不改库」策略与代跑解析无冲突，保持。

## §6 下一轮清单（候 v26/v15/v14）
1. TM1.a×4 / TM2.a×8 T 交贯通或退位（§4.2.1/2，坐标在明细文件）
2. Slt.c.M1 真缝落地（§4.2.3）
3. **drv1 占位件落地**（gen_M3_drv1_v14.py 417–437 行）：cmim PCell 名=**b.mim_cap（已批，上口裁定不变）**——
   引脚 Metal5.pin(67/2) + TopMetal1.pin(126/2) 同心于 cell 局部 (11.83,11.83)、TEXT(11.83,11.83)、datatype /2；
   或直接用 v2.2 库 `Board.mim_cap(name, c_fF, target)`（密度 1.5 fF/µm² 自动解 W/L）。
   **tank L1 禁区层号 = (235,5)**（库 v2.2 `_KEEPOUT` 备案：非制造、DRC deck 不查）——占位矩形从 TOPM2 挪走。
4. teeth_label/gen_teeth.py SRC → gen_M3_drv1_v14.py（或 glob 取最高版）

## §7 新真值备案（本机实测）
- TM1 堆端头线性律 +0.84/列（表见 §5.1）；TopVia2 默认端头 2.00×2.00 压线；vt2 直传 3×3=5.82×5.82。
- b7e7 五条代跑补丁收编实证：_bb() 适配器、ptap1、cmim 跨层 pin 标注、touches、teeth CASES 升名——全部在位。
- 库 v2.3 计划：+vt2_columns/vt2_rows 透传（组长侧，独立升版）。

—— b7a0（WiFi7-TX 组长）2026-10-17T08:0xZ
