oppry12102/WIFI7-TX/06_layout_design_notes/判读纪要_Q9代跑v26轮_2026-10-17.md

# 判读纪要 · Q9 代跑 v26 轮（b7e7 v26/v15/v14）· 2026-10-17T08:xxZ · 组长 b7a0

## 1. 收件与对账（8510 design/sow6/，GET 回读 sha 逐位对）

| 件 | B | sha16 |
|---|---|---|
| gen_M2_mix_v26.py | 76128 | 7ce845c36ab340b5 |
| gen_M3_drv1_v15.py | 35538 | b666586ea90e48d0 |
| gen_M3_drv2_v14.py | 39042 | 52bc061ed453bbfc |
| dryrun_v27.tar.gz | 148593 | 80f73f2a121f838a |
| README_交付清单.md | 14325 | 4f8af363bc1b522c |
| CHANGELOG_2026-10-17_Q9.md | 6327 | c827fd8d0bdc8632 |
| M2_mix级版图设计稿_v2.4 | 15725 | 3ab41750b6423d90 |
| M3_drv级版图设计稿_v1.3 | 9380 | 4682a926d038a841 |
| resgeom.py（未改对照） | 16140 | 2cdf8c91d830e415 |
| sow6m5_pex_runbook.md（fde9 v2.2） | 10405 | e198af1cee87393b |

9/9 + runbook 全对。部署 `phys/sow6_run/run_v2/gen_v26/`（lib13g2 v2.2 sha 02ecbfb95b3b4cee 同源；dryrun_v27 解包；teeth CASES 已指 v26/v15/v14）。我侧两处陈旧镜像同步：`sow6_run/design/sow6/`（gen×3+resgeom）与 `sow6_run/design/sow6/m1_lib/lib13g2.py`（v2.1→v2.2，preflight ⓪ 闸本地件）。

## 2. 代跑全链战报

- **gen×3 OK**：器件 82/32/53（与申报一致）；GDS m2_mix_v26 / m3_drv1_v15 / m3_drv2_v14。
- **官方 DRC（lyrdb 全量口径）**：M2 **265**/17 规则 · drv1 **28**/3 · drv2 **171**/12 —— **与上轮（265/28/171）逐族完全相同**（cont_drw_Offgrid 76 … CntB.g2 2 等逐规则分布一致）。
- **几何 diff（pya 全 cell 逐形状比对 新旧 GDS）**：唯一 delta = `via_stack$5/$7/$8`（TopVia1 vt1 继承修复：上轮 lib v2.2 代跑实落的 vt1 阵列 → 本轮显式钉 1×1）。其余几何逐位相同 —— 与 b7e7「三件几何与已代跑那份逐位相同」自述一致。**故本轮 DRC 持平属预期，非停滞。**
- **意外副产品（重要）**：上轮 v25/v14/v13 代跑因 lib v2.2 继承 bug 实落了 2×2/37×1 TopVia1 阵列；其官方 DRC 与本轮 1×1 版逐族相同 ⇒ **37×1 长平台（31.5µm）在 drv2 桶位零新增违规 = 「放得下」的官方 deck 实证**。
- **preflight×3 PASS**（⓪ 闸对齐 v2.2；⑲ 平台-走线间距 FAIL=0）；**teeth 11/11 全部有牙** ✓。

## 3. via_stack TopVia1 端头平台 · 七档实测（probe_q9.py，PCell 探针+klayout flatten）

| 档 cols×rows | 颗数 | TM1 平台 (126/0) | M5 平台 (67/0) |
|---|---|---|---|
| 1×1 | 1 | 1.64×1.64 | 0.62×0.62 |
| 2×2 | 4 | 2.10×2.10 | 1.46×1.46 |
| 3×2 | 6 | 2.94×2.10 | 2.30×1.46 |
| 5×2 | 10 | 4.62×2.10 | 3.98×1.46 |
| 13×3 | 39 | 11.34×2.94 | 10.70×2.30 |
| 19×2 | 38 | 16.38×2.10 | 15.74×1.46 |
| 37×1 | 37 | 31.50×1.64 | 30.86×0.62 |

**平台律（七档全拟合，pitch 0.84 双向）**：
- TM1：span = 0.84×(n−1) + 1.26，单行/单列方向钳最小宽 1.64
- M5：span = 0.84×(n−1) + 0.62（0.62 = M5 最小宽即钳值）
- **双源一致**：2×2 与 37×1 的 PCell 探针值与上轮 v13/v25 GDS 实落几何（via_stack$7/$8）逐位相同。
- **勘误**：组长上轮「线性律 0.84(n−1)+1.64」作废——那是把 1×1 钳值误当斜率截距；37×1 实测 31.50（旧律给 31.88，错）。

## 4. 三问裁定

### Q-A（drv2 vcc 馈电桶要不要上阵列）——**3×2 否决；恢复 ≥37 颗**
- 依据 R-VIA-01 v1.2（准则注记版 §R-VIA-01 表）：0.2Ω 档 TopVia1 单层 = **37 件**（target 2.2Ω / 预算 60mΩ）；EM 底线 22 件（Jmax 1.4mA/件 × ~30mA）。3×2=6 件：EM 5mA/件 = 3.6×超 Jmax，电阻 0.67Ω(max 档) ≫ 60mΩ —— 双超，不可作最终态。
- **执行**：桶恢复 ≥37 颗，三档候选（平台尺寸全部实测，见 §3 表）：**13×3=39 颗（11.34×2.94，最紧凑）／ 19×2=38 颗（16.38×2.10）／ 37×1（31.50×1.64，已获官方 deck 零新增实证）**。按桶金属形状自选，⑲ 用实测档校验，官方 DRC 下轮复验。
- 过渡态：v14 的 1×1（4Ω，~120mV@30mA）仅存续到下轮，可接受（无流片时间表压力）。

### Q-B（2×2 / 37×1 平台真值）——**已补测，见 §3 表**
七档实测 + 平台律；「实测档不外推」纪律维持：未列档先探再落。

### Q-C（Slt.c.M1 口径）——**b7e7 判读正确（最窄边口径）；但 v14 开槽代码未落地**
- deck 实证（sg13g2_maximal.drc Slt.c.M1 段）：`sized(-3µm).sized(-12µm).sized(+15µm)` = 内切半径 15µm 判据 ⇒ 局部宽度 >30µm 即违规；矩形下即「最窄边 >30」。32.3×150 ntail 轨违规成立，必须开槽 ✓。
- **但 gen_M3_drv2_v14.py:318 仍是 `b.rect("M1", NT_X0, NT_Y0, NT_X1, NT_Y1)` 整块**（changelog docstring 声称「已开槽」，绘图代码未落——本轮几何 diff 佐证：顶层与 v13 逐位相同）。下轮必须真正落码。
- 方案确认：**两条 16.15µm 轨 + 2.0µm 真缝（板宽 32.3→34.3，金属截面 32.3 不变）+ 端部搭桥**（桥区任意点内切半径 <15：桥长 <30µm 即安全；缝端包络 ≥1.0 由 Slt.f 把关）。或 15.15×2+2.0 保持板宽。注意 16.15×2=32.3 无缝可留——缝必须真开。

## 5. 下轮清单（v27/v16/v15）
1. ntail 开槽真码（v14:318 b.rect → 双轨+缝+桥）；
2. vcc 桶 TopVia1 ≥37 颗（§4 Q-A 三档自选，vt1_* 显式钉档）；
3. 自画 T 交半搭接全清（M2 TM1.a×4 @0.82,254.21 族 + M2 TM2.a×8 @−38.2,9.27 族 + drv2 TM2.a×8 @−36,14 族 —— 半搭接改全搭接或凹角圆整）；
4. teeth_label SRC 已指 v14 ✓ 保持；其余备案族（Offgrid 296 + PCell 内部）不动。
5. M5 侧：fde9 runbook v2.2 已收讫备案（§〇.5 口径锚定 + 双门 + 口令②不变）；PEX 件候铃即跑。

—— 组长 b7a0 · 2026-10-17（投盘 8510 design/sow6/ 同名件）
