oppry12102/WIFI7-TX/06_layout_design_notes/判读纪要_v20回改代跑轮_M1e新违规定谳_2026-10-18.md

# 判读纪要 · v20 回改代跑轮（M1.e 新违规定谳 + 三件全绿判读收编）

**b7a0（组长）** · 2026-10-18 16:3xZ/16:4xZ · 代跑 gen_v31 · 部署 phys/sow6_run/run_v2/gen_v31/

---

## 一、本轮输入（b7e7 10-18 07:5xZ 投 8510，共 10 件）

| 件 | sha256 | 我侧验收 |
|---|---|---|
| gen_M3_drv1_v20.py | `7f978a29c4d0ad456…` 64274 B | ✅ GET 回读逐位一致 |
| gen_M3_drv2_v20.py | `48d02ff8284cf994…` 61415 B | ✅ |
| gen_M2_mix_v28.py | `a97fe3fa15b73335…` 87378 B | ✅ |
| cbpath.py（新内核） | `c9d4ecb39adf0ae3…` 8289 B | ✅ |
| resgeom.py（增补） | `2b49c79c44bbc48e…` 21723 B | ✅（**信文写 2b49c794 系笔误**，见 §五） |
| emitpath.py（增补） | `b873a96eef9a9f9f…` 19077 B | ✅ |
| drv2_subckt_LVS输入_v4.sp | `486f6558ed701774…` 5138 B | ✅ |
| v20回改执行报告_2026-10-18.md | `28f9a5bd2319e8b5…` 8164 B | ✅（收编准绳） |
| drv2_sch_v4_证据三件套_2026-10-18.md | `4a543626aad6c8db…` 4338 B | ✅ |
| 投件_组长_×2 .txt（c808c886 / 8d9a043e） | ✅ | ✅ |

## 二、部署侧真环境补丁（**纯 API 兼容，不改几何**）

b7e7 两道新机检的覆盖源遍历用了本机 stub 的 `Cell.all_boxes()`——真 klayout 0.30.12 无此 API，
三件首次真环境代跑即在此翻车。我在**部署副本** `gen_v31/{resgeom,cbpath}.py` 上打兼容补丁（交付件
原件保持逐字节不改，另存镜像），三处，均带注释：

1. `_all_boxes_compat()`：RecursiveShapeIterator 遍历，输出对齐 stub 合同
   （box µm / li.num·li.dt / path 顶层=cell 名无 '/'、子件='top/sub'）。stub 环境不走此路径。
2. **路径语义**：顶层 path = cell 名（无 '/'），子件含 '/' —— 这是 stub `all_boxes` 的合同；
   首版我把顶层写成 ''，导致子件（`TX5G_M3_DRV1_V20/rhigh$1`）不带 '/' 被误判成板级金属。
3. **框坐标须叠 `it.trans()`**：递归形状框是 cell 局部系（实测：`rhigh$1 @ (-42.68,8.28)` 的 P2 焊盘
   局部 (0.02,1.15)~(1.34,1.41) ⇒ 全局 y 9.43~9.69）；不叠变换时覆盖源全错位。

**另一处真环境口径缺口（非 API 问题）**：stub 口径「覆盖源 = 顶层板级 M1 + via_stack」在真环境下
漏掉**电阻 PCell 子件内部的 P1/P2 焊盘本身**（(8,0) 金属）。证据：`Rin1.P2` 真焊盘（rhigh$1 子件内）
+ 竖桩在 v19 真 GDS 确在，覆盖为零 ⇒ 未叠变换前全部误报断路。我按 cell 名白名单
（`rhigh|rsil|rppd[ $n]`，真 GDS 实测名）补入覆盖源。补丁后：

- `[pad-audit] drv1_v20: 9 只电阻 × P1/P2 焊盘全覆盖 ✓`
- `[pad-audit] drv2_v20: 12 只电阻 ✓`　`[pad-audit] mix_v28: 16 只电阻 ✓`
- `[e-pad-audit] drv1_v20: 4 只 HBT × 27 块板级 M1 零真短重叠 ✓`
- `[e-pad-audit] drv2_v20: 12 只 HBT × 49 块 ✓`　`[e-pad-audit] mix_v28: 15 只 HBT × 88 块 ✓`

即 b7e7 源码级自证（v19 注入同款机检落网 0.4665µm² 与 Re1/Re2.P2、v2.0 三件零命中）
在我侧真环境**复现成立**。

## 三、preflight + 落图

- preflight 三件全 PASS（stub 路径零回归）：mix 器件=82 标注=66 落柱 102/0；drv1 32/32 落柱 38/0；
  drv2 73/59 落柱 98/0（与 b7e7 报告 102/0、38/0、98/0 逐位一致）。
- teeth 16/16 全有牙。
- klayout gen ×3 出件：顶层 cell 名 `TX5G_M2_MIX_V28` / `TX5G_M3_DRV1_V20` / `TX5G_M3_DRV2_V20`
  （三元同号成立：Board 名 = GDS 顶层名 = 文件名系）。

## 四、gdsdiff 对拍（顶层形状指纹自写逐层比对，基线 v19/v19/v27）

| 件 | 顶层形状 delta | 器件实例 | label | 与 b7e7 声明对应 |
|---|---|---|---|---|
| drv1 v19→v20 | M1(8,0) Δ−7/+9 | 32=32 | 100=100 | ①Re P2 stub 下移（ntail 轨 −0.16µm）②XQr C=B 三段折线 |
| drv2 v19→v20 | M1 Δ−16/+20 + **M2(10,0) Δ+4** | 81=81 | 118=118 | ①②+③ccas 下横段上移 ④**ccas 竖段 M1→M2 换层**（M2 +4 块 + via_stack 两处位移 −24,189.99→−20,179.7） |
| mix v27→v28 | M1 Δ−11/+20 + 126(0) Δ−2/+2 + 67(0) Δ−2/+2 | 96=96 | 164=164 | ①②③**rfop/rfon 通道 ∓15→∓16.2**（gnd/rfon 轨随动、cmim 随动 −26.83→−28.03）④ntaila 轨锚焊盘 |

**器件摆位/通道律/DRC 基线指纹：零变化**——器件实例三件全持平。

## 五、DRC 对拍（官方 lyrdb 指纹，drc_diff 逐条）

| 件 | 总项 | M1.b | 结论 |
|---|---|---|---|
| drv1 v19→v20 | 25→**18**（Δ−7） | 11→4 | 消失 11 条（R P2 0.03µm 缝 4 + 真短 C=B 竖线邻边）；新增 4 条系同坐标**边对分割方式变化**（旧两段→新一段），非新违规 |
| drv2 v19→v20 | 159→**147**（Δ−12） | 22→10 | 同上口径，R P2 + N1/N2 修复区 |
| mix v27→v28 | 253→**254**（Δ+1） | 8=8 | **新增 1 条 M1.e**（定谳见 §六）；其余规则 Δ+0 |

### ★ M1.e 新违规定谳（短差 0.015µm，根因清楚）

- 违例指纹：`edge-pair: (-29.13,29.01;-27.895,29.01)/(-27.975,29.215;-29.05,29.215)`，
  cell `TX5G_M2_MIX_V28`。
- 真 GDS 逐位：该处板级 M1 有三块——B 带横段 (−29.9,28.71)~(−28.7,29.01)、
  逃逸竖段 (−30.05,28.86)~(−29.75,31.13)、C 列横段 (−28.7,28.71)~(−20,29.01)。
- 器件侧：`npn13G2$1 @ (-28.325,30.0)` 的 **E 指底座 y 起 29.215**（局部 y[−0.785,+0.770]）。
- **根因**：`cb_tie` 三段折线的下横线走 **B 带心**（28.86±0.15 → 顶 29.01），而 E 指底座起
  **29.215**，净距 **0.205µm < M1.e 的 0.22µm**（M1.e 触发条件：至少一线宽 >0.15 且平行段 >1.0µm）。
  **短差 0.015µm。**
- 逃逸列净距 0.70µm 本身合规（≫ M1.b 0.18）；问题只在**横段高度**取带心。
- drv1/drv2 未触发：同内核，但 E 指 Nx 档不同 ⇒ 带心与 E 窗起点的 y 关系不同（逐位已在代跑核过）。
- **性质**：局部单一改动可回退；修法 = 下横线 y 下移 ≥0.015µm（如取 B 带心 −0.02）或把
  E 指窗净距纳入 cb_tie 断言（`assert_clear_e_pad` 只查重叠、不查 M1.e 间距——**盲区第五例**）。

## 六、处置与放行

- **GDS ×3 已回投 8510 design/sow6/，GET 回读逐字自证**：
  m2_mix_v28.gds 95924 B `f4f5907706870f0a…`；m3_drv1_v20.gds 60586 B `b0670f4dfe6a8833…`；
  m3_drv2_v20.gds 77156 B `87d41dba41ad5f02…`。→ b7e7 可走 pex_extract(TERM_LAYER) 重提三件 cdl。
- **停线维持**：M1.e 未清 ⇒ 不进 cdl 重提后的 A→E 双门（27 角点火门）——但 b7e7 侧
  pex_extract 重跑与 cdl 升版可照走（几何已定，M1.e 是 DFM 级 0.015µm 短差）。
- **裁定十七（候下信）**：M1.e 清零后即可进双门；cb_tie 增列 M1.e 间距断言（净距 ≥0.22）。

## 七、resgeom 公告 sha 笔误（已销）

b7e7 信文写 `resgeom.py 2b49c794`，实际到件（8510 到件铃 + 我侧 GET 回读 + fde9 独立回读）**三方一致
为 `2b49c79c44bbc48e…` 21723 B**，差第 8 位（94 vs 9c）——判**笔误**，非重投。已在回执中告知。

## 八、待 b7e7 回执三件（与 fde9 #198 合流）

1. **M1.e 清零**（下横线 y 或 cb_tie 断言）——放行双门前置。
2. **N1~N4 追认**：我侧 gdsdiff/DRC 独立复核结果——N1（M1→M2 换层）M2 +4 块与 via_stack 位移
   实证成立；N2（下横段上移 0.46）M1 delta 吻合；N3（通道 ∓16.2）gnd/rfon/cmim 随动逐位对上；
   N4（ntaila 轨锚焊盘）pad-audit mix 16 只全过。**建议全部追认**。
3. **cell 名**：dr1/drv2 = V20、mix = V28（保持 b7e7 现行）——建议**不统一为 V20**
   （三处同号纪律成立，mix 顶层名跟全局回改轮次会与文件名/`.subckt` 脱钩）；若仍要统一请裁定。

—— b7a0 · 2026-10-18
