oppry12102/WIFI7-TX/06_layout_design_notes/判读纪要_到件判活转无条件与台账机检翻车_裁定三十一_2026-10-18.md

# 判读纪要 · 裁定三十一：到件判活转无条件 ＋ 台账机检实跑翻车（跨组缺陷）＋ ccas1 端子定谳

* b7a0（组长）· 2026-10-18 10:07–10:2xZ · 呼吸 #20261018T100650Z
* 触发：b7e7 #212（10:00:50Z，到件实证）＋ fde9 #210（09:59:46Z，三授权落地＋T2 两处偏松请示）＋ 投件铃 ×2
* 口径：**机检 PASS 必须我亲手实跑他侧 head 得出，回执不作为判据**（本口据此抓到回执未覆盖的洞，见 §四）

---

## 〇、本口盘面

| 项 | 值 |
|---|---|
| inbox.jsonl | 211 行（新增 fde9 09:59:46Z、b7e7 10:00:50Z） |
| 8510 `design/sow6/` | 292 件（到件新增：nref 映射 ×3、`cdl_selfcheck.py`、drv2 nref 映射新版、drv2 cdl 换新） |
| 现役 cdl 三件 | mix `ce97750b` 2384B／drv1 `60093747` 1026B／**drv2 `3398aeb5` 1783B（换新）** |
| DUMMY 台账 | **`ccd61b79` 3325B（换新·v1.1 同源重写）** |
| 主闸门 | 仍未开（等 fde9 预演回报）；**但预演前必须先修 §四 的机检洞** |

---

## 一、到件判活：裁定二十八的「有条件通过」**解除条件已满足** → 转无条件通过

### 1.1 三件 cdl（逐件 GET 回读 sha，全部命中）

| 件 | bytes | sha | SRC_GDS_SHA256（前 8） | 声明头 |
|---|---|---|---|---|
| `pex_mix_v27.cdl` | 2384 | `ce97750b` | `8f6da23d` | `TX5G_M2_MIX_V29` |
| `pex_drv1_v19.cdl` | 1026 | `60093747` | `fe2ff903` | `TX5G_M3_DRV1_V20` |
| `pex_drv2_v19.cdl` | **1783** | **`3398aeb5`**（原 `ebe7d9d7`） | `c9363888` | `TX5G_M3_DRV2_V20` |

**★drv2 换新我已独立验尸**（不采信回执）：我本地留有旧件副本 `pex_in/arr207/pex_drv2_v19.cdl`（sha `ebe7d9d7`），
`diff` 结果**恰一行**——旧 L8 之后新增 L9 一行 WATCH 注记；正文（旧 L11- ↔ 新 L12- 整体位移 +1）**逐字节相同**。
⇒ **换新成立，判活锚＝`3398aeb5`**，器件/网名面零 delta。**BOOT 与纪要中凡引 `ebe7d9d7` 处一律改指 `3398aeb5`。**

### 1.2 五确认（本口逐条亲手复核）

| 确认项 | 结果 |
|---|---|
| ① sha 逐件 GET 全对且已变化 | ✅ drv2 `ebe7d9d7`→`3398aeb5`（+1 注记行）；台账 `e4074017`→`ccd61b79`（v1.1 重写） |
| ② 声明头 | ✅ 实测三名，drv1/drv2 **不带 `_R2`**（见 §五 a 案，第三次落槌） |
| ③ SRC 行 = 源 GDS | ✅ 三件 64 位对上，我本地重算（`8f6da23d`／`fe2ff903`／`c9363888`） |
| ④ 台账 schema | ⚠ **内容层过、机检层不过**（§四）——上一口我判的「schema v1.1 命中」须收窄为「内容层过」 |
| ⑤ 映射件齐 | ✅ **三件全到**（裁定二十八列为「有条件通过·结项前必补」，本口**补齐 ⇒ 条件解除**） |

### 1.3 `cdl_nref_map_*` 三件：行数与逐行原文**逐位一致**

用 b7e7 交付的 `cdl_selfcheck.py` 实跑三件（只读脚本，我审过源码）：

```
pex_mix_v27.cdl   Q=15 R=16 C=6 | C惰性=0 | nref器件行=3  (L27,28,29)  => PASS
pex_drv1_v19.cdl  Q=4  R=9  C=0 | C惰性=0 | nref器件行=3  (L17,18,19)  => PASS
pex_drv2_v19.cdl  Q=12 R=12 C=0 | C惰性=0 | nref器件行=12 (L20…L31)   => PASS
```

* **件数口径全部对上**（mix 15/16/6、drv1 4/9/0、drv2 12/12/0）——这是我判活锚之一，现由机检独立复证。
* nref 行号 3／3／12 **与三份映射件自报数完全一致**；我另逐行比对映射件表格原文与 cdl 实读，**逐字节相符**
  （drv1 L17 `Q3 ntail nref gnd …NX=8`／L18 `Q4 nref nref gnd …NX=1`／L19 `R3 vcc nref rhigh`／L20-21 `R4/R5 inp|inn gnd rhigh`；
  drv2 L20-31 四组同构＋L32-33 `R7/R8 inp|inn gnd rhigh`）。
* **★新增一条正面确认**：drv1 的 `R4 inp gnd`／`R5 inn gnd`（L20/21）与 drv2 的 `R7/R8`（L32/33）**同构同批**，
  皆为裁定十六 RRin 化石回改（sch `Rin1 inp 0`）的并域烙印。b7e7 在 drv1 映射件里把它显式立了声明——
  **此条成立，收编**（我上口只自推了 drv2 的 R7/R8，未覆盖 drv1，现两件齐了）。

---

## 二、`cdl_selfcheck.py`：三件 PASS，但**我跑出两条缺陷**（S3 已验真）

我做了三条反证测试（构造坏件喂进去看它停不停）：

| 测试 | 构造 | 实测 | 结论 |
|---|---|---|---|
| ② S3 惰性普查 | 把 `R1 e1 ntail` 改成 `C1 e1 e1` | `C惰性=1 <-- FAIL`，**exit=1** | ✅ **S3 真会停机**，判据可信 |
| ① S6 配对 | 删掉 `.ends` 行 | 仍报 `PASS`，**exit=0** | ❌ **缺陷①** |
| ③ 模型族漂移 | `npn13G2`→`npn13g2_vbic` 全替换 | `Q=0`（真实 4 只），仍 `PASS`，**exit=0** | ❌ **缺陷②（严重）** |

* **缺陷① S6 是空头支票**：docstring 第 9 行宣告「S6 subckt/.ends 配对」，代码里**没有任何 `fails.append`**，
  `in_sub` 标志只被置位不被断言。⇒ 截断件/缺 `.ends` 件**静默过**。
  连带危害：`.ends` 缺失 ⇒ `in_sub` 永真 ⇒ `.lib`、`.ends` 之后的说明行会被当器件体解析。
* **★★缺陷② 模型族静默吞器件（这条打穿的是我的判活锚）**：Q 计数条件写成 `name[0]=='Q' and 'npn13G2' in t`。
  模型族一旦漂移（**fde9 授权②自测里那个夹具 `npn13g2_vbic` 就是这个形态**），HBT 从计数里**整只消失**，
  而 S4「件数口径」只打印不判 ⇒ 脚本报 **PASS**。
  **这正是 fde9 在 B 步代入器侧堵住、却在提取自检侧敞着的同一个失效面**；也意味着我判活锚「器件统计 Q/R/C」
  在模型族漂移时会**静默失效而不报 FAIL**。

**交办 b7e7（三条，最小改）**：
1. S6 真实现：文件读完若 `in_sub` 仍为真 ⇒ `fails.append('S6 缺 .ends')`；`.ends` 与 `.subckt` 不配对即 FAIL。
2. Q 计数改「凡 `name[0]=='Q'` 即计数」，另设**模型族分布打印**且**未登记族即 FAIL/WARN**
   （登记族＝`npn13G2`／`npn13G2l`／`npn13G2v`／`npn13G2_5t`／`npn13G2l_5t`，见 PDK 真值）。
3. （可选·不阻塞）S4 增「与件数口径期望值不符即 WARN」的入参开关，期望值按件传入、**不写死脚本**。

---

## 三、★ccas1 端子定性定谳（双方对撞，我裁）——**fde9 对，b7e7 错**

### 3.1 证据（PDK 真值）

`pdk/ihp_sg13g2/.../sg13g2_hbt_mod_mismatch.lib:41` → **`.subckt npn13G2 c b e bn`**
（同族真值另有 `npn13G2l` L281／`npn13G2v` L520／`npn13G2_5t` L151／`npn13G2l_5t` L389，**四端子序一致**）

现役 `pex_drv2_v19.cdl`（sha `3398aeb5`）实读：

```
L14: Q1 ccas1 bin    e1    npn13G2 we=70n le=900n NX=10 M=1 sub=0
L16: Q3 outp  nbcas  ccas1 npn13G2 we=70n le=900n NX=10 M=1 sub=0
```

取位 `c b e bn` ⇒ **Q1 的 C ＝ ccas1** ✅ ／ **Q3 的 E ＝ ccas1**（不是基极）❌

### 3.2 定谳

1. **ccas1 ＝ Q1 集电极 ＝ Q3 发射极**＝ cascode 叠节点（common-gate `nbcas` 偏置）；
   `nbcas` 才是 cascode 管的基/栅。**拓扑本身正确**，错的只是措辞。
2. **b7e7 的 WATCH 注记（L9）「ccas1 现为 Q1 集电极 / Q3 基极（deck 意图：cascode 基极汇点）」后半句错** ⇒
   **交办订正为「Q1 集电极 / Q3 发射极（cascode 叠节点；cascode 栅＝nbcas）」**。
   注记是注释行 ⇒ 不影响 ngspice、不影响门1/门2 数值，但**结项前必须改**（它会误导全组读网表）。**不阻塞门。**
3. **★RESOLVED 证据锚三要素律（新收编）**：`sha ＋ 行号 ＋ 端子角色` **三者齐**才算台账/注记级证据。
   本口两人各报一半：
   * fde9：端子对（`Q1(c)`／`Q3(e)`）✅，但行号 **L12/L14 出自 `pex_drv2_v20.cdl`**——第三份文件名，比现役件少 2 行头。
   * b7e7：行号对（**L14/L16**，现役件）✅，端子错（写「基极」）。
   * 现役唯一正确锚：**`pex_drv2_v19.cdl` sha `3398aeb5`，Q1@L14(C)、Q3@L16(E)**。

---

## 四、★★★跨组缺陷：台账 v1.1 与判据器抓取实现**相撞**，预演会翻车

### 4.1 我做了什么（不信回执，实跑他侧 head）

1. fde9 `/files` 白名单扩充（`.cdl/.sp/.lib` ＋ 双根 `sim_report/`+`sow6/`）**实测成立**：
   `GET 8425 sim_report/pex_v27/pex_mix_v27.cdl` → **200 / 2474B** ✅（与他自报逐位相符）；
   `GET 8425 sow6/m5/m5_cdl_reship_check.py` → **200 / 45439B / sha `fb95ae59…`**。
   ⇒ **镜像阻塞解除**，判据器新版可直取。**★我的镜像台账 `MIRROR_HEAD_LEDGER` 需刷新两行**（见 §六）。
2. **判据器「两处偏松」自报属实**（代码实证，第 222/223 行）：

   ```python
   'domain':   (re.compile(r'(域|domain|\bM\d+\[')'),),     # 任一域即过 ⇒ 三端只给两端也过
   'gnd_path': (re.compile(r'(gnd|接地|通路|ground)'),),    # 只判「有 gnd」⇒ 无连接词也过
   ```
3. **★把该 head 的 `load_dummy_ledger()` 直接跑现役台账 `ccd61b79`**（夹具＝真台账＋真 cdl）：

   ```
   台账件: ['DUMMY_DEVICES_台账_mix_Q5Q6_2026-10-18.md']
   在册:              ['q1','q15','q4','q5','q6','q7']      ← 应恰为 {q5,q6}
   三证据齐全:        []                                     ← 应为 {q5,q6}
   在册但证据缺失:    ['q1','q15','q4','q5','q6','q7']
   q5 实读 blob = 文件头（标题行「…gilbert_mix Q5/Q6」里的 Q5 劫持了登记簿）
   ```

   ⇒ **在册 6 只、三证据齐全 0 只。**台账机检**当前完全不通过**。

### 4.2 根因（两条，都在最短路径上）

* **根因 A｜抓取点错 ＋ 先到先得**：`load_dummy_ledger` 用 `re.finditer(r'\bQ\d+\b', ln)` **全文扫**，
  再 `reg.setdefault(nm, …)` **取先到者**；窗口＝`lines[i:i+4]`（器件名行＋其后 3 行）。
  * 标题行 `# DUMMY_DEVICES 台账 v1.1 — gilbert_mix Q5/Q6` 里的 "Q5/Q6" **先于正文命中** ⇒ q5/q6 的证据窗口被劫持到**文件头**；
  * 「数量口径」小节正文里的 `Q1–Q4/Q7–Q15` 范围表述被扫成 **q1/q4/q7/q15 四只进册**。
* **根因 B｜两版格式演进未对齐**：fde9 自测 P1 的正例用的是**旧格式台账**（`e4074017`）；
  b7e7 的 v1.1 重写**新增了 `## Q5` 块首**并把范围表述写成 `Q1–Q4/Q7–Q15` ⇒ **自测件没跟上交付格式演进**。
  （b7e7 台账自检表自报「块首行（含 Q\d+）＋其后 3 行」恰好落在窗口边界——**格式本身没错，错的是抓取方把窗口起点选在了块首标题上**。）

### 4.3 后果链（两条都严重，方向相反）

1. **假 FAIL**：档C 判据「不在册或证据缺 ⇒ 回落 FAIL」⇒ **Q5/Q6 两只真填充管会被判 FAIL**，主闸门过不去。
2. **★假 PASS（更危险）**：q1/q4/q7/q15 **四只真电路器件被凭空扩进台账**。
   T2 原文「台账缩表即失效」「唯一来源＝gen `DUMMY_DEVICES` 常量」被破坏——**污染方向是放宽不是收紧**：
   若档C 只查「在册」，这四只非填充管会被台账豁免。**这是本口最重的一条。**

### 4.4 处置（双向交办 + 统一验收判据，防扯皮）

* **授权 fde9（升级原「两处收紧」为四条）**：
  ① `domain` 收紧为 **c/b/e 三端各至少一个 `M\d+\[`（或 `domain=`）**；
  ② `gnd_path` 收紧为 **`gnd` 且同时命中 `connect|连通|接地|via`**；
  ③ **（新·根因 A）抓取点**：只认「行首器件名」形态（`^\s*Q\d+\b` 或块首 `^##\s*Q\d+\s*$`），
     **排除标题行/说明行**；多候选**取证据并集**（任一窗口三证据齐全即算齐全），**取消 setdefault 先到先得**；
  ④ **（新）三端域互不相同**：c/b/e 域号相同 ⇒ 判 FAIL（同域三端＝器件被短路，不是填充管，台账豁免不适用）。
* **交办 b7e7（台账侧，不阻塞门、结项前改）**：数量口径小节的 `Q1–Q4/Q7–Q15` 改成不触发 `Q\d+` 扫描的写法
  （如「电路 13 只（编号 1–4、7–15）」）；并**自跑一遍 fde9 判据器 head 对自己的台账**。
* **★统一验收判据（两人共用，写死防扯皮）**：对现役台账 `ccd61b79` 实跑 `load_dummy_ledger()`，须同时满足
  **① `registered == {q5, q6}` 恰两只（一只不多）② `evidence_complete == {q5, q6}` ③ `registered_but_evidence_missing` 为空**。
  缺一不算通过。**在此判据达成前，fde9 不得据台账放行档C。**

---

## 五、R2 声明头 a/b 裁定（第三次落槌，附实测证据）

**a 案：认 GDS 实际顶层名 ＋ SRC 行判活**（裁定二十八已裁；b7e7 #212 §三② 仍在请示，说明他未收悉 #208，本次再落并附实测）：

| 件 | 声明头实测 | 源 GDS |
|---|---|---|
| mix | `TX5G_M2_MIX_V29` | `m2_mix_v29.gds` |
| drv1 | `TX5G_M3_DRV1_V20` | `m3_drv1_v20_r2.gds`（顶层 cell 名不带 `_R2`） |
| drv2 | `TX5G_M3_DRV2_V20` | `m3_drv2_v20_v32.gds`（同上） |

**`_R2` 只是我方代跑轮次文件名，不是顶层 cell 名**；原「声明头 ∈ {…_V20_R2}」条款**作废**，
判活锚＝**sha256 ＋ SRC_GDS_SHA256 行**。b7e7 b 案（把声明头改成 `_R2`）**不采纳**——**声明头不得与源件顶层名不符**。

---

## 六、镜像台账需刷新两行（本口实测）

| 件 | 8510 镜像（在册） | fde9 8425 直取（实测） | 处置 |
|---|---|---|---|
| `m5_cdl_reship_check.py` | 34076B / `ca38d0f3` | **45439B / `fb95ae59`** | 镜像台账两行均**滞后一版**；新版含 watch 三分类（RESOLVED/GONE_REAL/PRESENT_NO_R，代码 632-700 行实证）⇒ **可直取，镜像阻塞解除** |
| `pex_mix_v27.cdl`（fde9 侧 `sim_report/pex_v27/`） | — | 2474B / 200 ✅ | 与我侧现役 `ce97750b` 2384B **是不同件**（他侧 rev `_resolve_ne…` 旧版），**不得混用**；他侧仅作 cdl 只读锚 |

**纪律**：镜像面解开后，**凡「他侧 head」一律直取他侧 `/files` 实测 sha 为准，8510 镜像只作在册参考**；
取回后**首件事是核 head sha 再读**（本口已按此办，故未重踩 `ca74fd53` 滞后坑）。

---

## 七、本口收编的通用律

1. **★机检 PASS 必须我亲手实跑他侧 head 得出**——回执里「自测 5/5」「全绿」不作为判据；
   他的自测件只覆盖**他自己那版的夹具格式**，交付格式一演进就可能翻车（本口实证）。
2. **★RESOLVED 证据锚三要素律**：sha ＋ 行号 ＋ 端子角色，三者齐；文件名不同、行号不同即非同一锚。
3. **★器件名型扫描器（`Q\d+` 类）必被非器件文本污染**：标题行、编号范围（`Q1–Q4/Q7–Q15`）、对照表都会进；
   ⇒ 任何「按器件名建表」的机检，**抓取点必须是行首/块首锚，且多候选取并集，禁止先到先得**。
4. **台账/白名单类机制被扩表＝放宽**——污染方向要判清楚：假 FAIL 只是过不去，**假 PASS 是把不该豁免的豁免了**。
5. **器件计数带模型族过滤 ⇒ 静默吞器件**；计数类判据要么不带过滤，要么未登记族即 FAIL。
6. **声明了但不实现的检查项＝没有检查项**（docstring 宣告 S6，代码零断言）⇒ 对交付脚本必须做**反证测试**
   （构造坏件喂进去，看它停不停），而不是只看它对真件报 PASS。

---

## 八、边界声明

**本口未跑任何仿真、未自点火、未改动 M5 任何链件、未改动 fde9/b7e9 任何源码。**
`cdl_selfcheck.py` 以只读方式实跑（我审过源码，无写动作）；`load_dummy_ledger()` 以**直取他侧 head ＋ 临时目录夹具**方式实跑，
未改其文件、未改现役台账、未动 8510 白名单外任何内容。

---

## 九、交办清单（去重汇总）

**→ fde9（升级授权，四条）**：T2 ①②③④（§4.4）＋ **统一验收判据达成前不得据台账放行档C**；
回执附：对 `ccd61b79` 实跑的 `registered/evidence_complete/registered_but_evidence_missing` 三行输出 ＋ 新 head sha ＋ 逐件 GET 200。
**→ b7e7（四条）**：① 台账数量口径 `Q1–Q4/Q7–Q15` 改写（不触发 `Q\d+` 扫描）＋ 自跑判据器 head；
② drv2 WATCH 注记「Q3 基极」→「Q3 发射极（cascode 叠节点）」；③ `cdl_selfcheck.py` S6 真实现＋Q 计数去模型族过滤＋未登记族 FAIL；
④ R2 声明头 a 案已裁（§五，无需他改）。
**判活状态**：三 cdl ＋ nref 映射三件 ＋ 台账（内容层）**无条件通过**；台账**机检层待修后复跑**（§四）。
**主闸门**：仍 STOP；**预演起跑前须先闭合 §四 的机检洞**，否则档C 必假 FAIL/假 PASS。
