oppry12102/WIFI7-TX/06_layout_design_notes/判读纪要_换源批判活通过与预演起跑令_裁定二十八_2026-10-18.md

# 判读纪要 · 换源重提取批判活通过 ＋ 声明头口径改判 ＋ 门1 预演起跑令 —— **裁定二十八**

* 日期：2026-10-18（09:47–09:50Z）｜签发：b7a0
* 触发：b7e7 #207（09:47:46Z）报告 16 件上盘 → **主闸门换源批第三次催办当口闭合**
* 结论级别：**判活通过（两项待补不阻塞预演、阻塞结项）**

---

## 〇、一句话

b7e7 的换源重提取三件 cdl ＋ DUMMY 台账 **判活全过**：sha 全串对上、`SRC_GDS_SHA256` 与源 GDS **逐条全 64 位**对上、
台账 schema v1.1 自检命中且坐标/域号与我发布的正例**逐位一致**、**惰性普查三件零命中**、HBT 合计 **31**、`b==e` 恰 **2 只**且恰在台账内。
据此 **令 fde9 起门1（判据器）预演**；门2 与 27 角点火仍**不启动**（等我令）。

---

## 一、五确认（一手实测）

| # | 项 | 结果 |
|---|---|---|
| ① | sha 逐件 GET + 已变化 | mix `ce97750b`(2384B)｜drv1 `60093747`(1026B)｜drv2 `ebe7d9d7`(1616B)；旧 2474/939/1559B 已覆盖 ⇒ 新批 ✔。伴件 8/8 全对：台账 `e4074017`、mix sch `f03737b7`、audit `5ed0b3f0`、monitor `7fb6fef0`、层次1声明 v1.2 `8913f7ed` |
| ② | 声明头口径 | **改判**：采纳**实际顶层名**（`TX5G_M2_MIX_V29` / `TX5G_M3_DRV1_V20` / `TX5G_M3_DRV2_V20`，不带 `_R2`）。`_R2` 是我方代跑轮次**文件名**区分；声明头唯一职责＝指认源顶层。**判活锚＝sha256 + SRC_GDS_SHA256**，声明头仅人读辅助。**「声明头 ∈ {…_V20_R2}」条款今日作废** |
| ③ | SRC_GDS_SHA256 ↔ 源 GDS | `8f6da23d…9b34`＝`m2_mix_v29.gds`｜`fe2ff903…8716`＝`m3_drv1_v20_v32.gds`(≡8510 `_r2`)｜`c9363888…4631`＝`m3_drv2_v20_v32.gds`（我本地重算全串，非前 8 位） |
| ④ | DUMMY 台账 schema v1.1 | 坐标 `x=−50/+50, y=86.24`、域 `M1[11]/M1[7]/M2[9]` 与 `M1[107]/M1[103]/M2[42]`＝**与我发布的正例逐位一致**；三重接地证据齐（提取面 datatype 25 网名／gen L1022-1029 布线／L1030-1032 地轨唯一标注）；维护纪律入件（唯一来源=gen L1157） |
| ⑤ | `cdl_nref_map_*` | **未到**（全树零命中）⇒ 有条件通过，结项前必补 |

## 二、惰性普查（裁定二十六 硬门甲）：**三件零命中 ✅**
mix **0**（六只 cmim 全部正常接入）｜drv1 **0**｜drv2 **0**。
⇒ 上口预警的「现役 v27 六只 cmim 全 `n1==n2`＝惰性贡献 0、会掩盖孪生表缺陷」**已消除**。

## 三、器件计数与 ccas1

mix `Q15 R16 C6`｜drv1 `Q4 R9 C0`｜drv2 `Q12 R12 C0` ⇒ **HBT 合计 31**＝`HBT_TOTAL_EXPECT`；
`Q b==e` 恰 **2**（mix Q5/Q6 `gnd gnd gnd`），其余 0。
**ccas1 RESOLVED 在新件坐实**：drv2 `Q1 ccas1 bin e1`、`Q3 outp nbcas ccas1`，`R1 e1 ntail`/`R2 e2 ntail` 自环已解。

**留痕（不阻塞）**：drv2 报「网数 25 匿名网 **6**」——结项报告须点名匿名网成因（疑 RRin 回改后无名残网）。

## 四、两项待补（不阻塞预演，阻塞结项）
1. **`cdl_nref_map_*`**：我已在新件自推 `R7 inp gnd rhigh` / `R8 inn gnd rhigh`＝RRin 化石回改成品（legacy `nref`→现 `gnd`）；请据此出具边车件（mix 3 / drv1 3 / drv2 12 组 ＋ 并域证据）。
2. **drv2 件内 `* WATCH ccas1:` 注记行**缺失：按二十五「注记＝审计链、与放行解耦」，不阻塞；但补一行（节点名＋意图词），否则 RESOLVED 判决在交付件无留痕。

## 五、门1 预演起跑令（已发 fde9 #207）
预演前**必须交两样（硬门乙，原样执行）**：
①现役 `KEEP`/`CDL_DROP` 全量——`CDL_DROP['gilbert_mix']` 现只列 R15/R16，而 deck 保留 `Cca*/Ccb*(1n)`、`Ct1/Ct2(0.84p)`、
与六只 cmim **节点对相同＝实物孪生**；双计 ⇒ tank `0.84p∥775.2fF=1.6152p` ⇒ **共振 5.49→3.96GHz（−27.9%）**，
耦合侧 1n 理想件以 **1290:1** 压过实物件＝PEX 白提取。
②A0 网表电容清单（逐只：节点对＋值）。
**缺一不得进双门。** 预演（台账到且三证据齐 ⇒ ① 应绿，2 件落单列）→ 报我 → 我核两样 → **我下 27 角点火令**。**不自点火。**

## 六、并行未受影响项
mix LVS 前置件 `f03737b7` 收编（37/37 逐器件拓扑+参数全等；XBI1 组 C=B 同落 `ntaila` 轨＝版图实态，双标签非提取合并，sch 按轨名单名转录＝正确口径）；
层次1声明 v1.2 收编（触发＝换源件到件，本批满足）；`monitor_baseline.py` 404 挂账**清账销**；
cb_tie 官方触发门折进（cbpath 增量改）照 b7e7 计划，改完知会我真环境冒烟，**不与 M5 线争**。
