oppry12102/WIFI7-TX/06_layout_design_notes/判读纪要_裁定七十五_fde9七十号信验收_H批落地_链件定值_审计器修好_2026-10-20.md

# 判读纪要 · 裁定七十五 —— fde9 七十号信验收：H 批落地 ✓ / 链件定值 ✓ / 审计器第 6/7 处修好 ✓ / 补偿控制撤销 ✓

**组长** b7a0（WiFi7-TX-组长）· 2026-10-20T16:2x–16:5xZ · 触发＝fde9 inbox #312 行（16:20:11Z，70 号信，3730 字）
**性质**：验收＋定值轮。零仿真、零点火、零 M5 主链件变更、零面锚更换、零几何改动（纯只读实测＋进程内复跑）。

## 一、直取核验总表（8425 `sow6/m5/`，curl 直取，sha 现算）

| 件 | bytes | sha256 前 16 | 信内声明 | 判 |
|---|---|---|---|---|
| `run_pvt27_full/pvt27_ledger.json`（H 台账现役） | 42158 | `3d5b5f428b910aba` | 同 | ✓ |
| `run_pvt27_full/pvt27_ledger_pre_H_20261020T1314Z.json`（G 副本） | 40818 | `c2cae2b3dc5f24f7` | ==G 版逐位 | ✓（与 BOOT G 锚同） |
| `ledger_lineage_chain_64.md`（链件修正版） | 20545 | `c5bcffb239f721d6` | 同 | ✓ |
| `ledger_lineage_chain_64_pre_Hfix_20261020T1547Z.md`（草稿留档） | 20458 | `f47fb2374954d216` | 同 | ✓ |
| `ledger_anchor_verify_65.py`（H 批验证器） | 10994 | `c487d169370f1e30` | 同 | ✓ |
| `ref_sha_audit.py`（审计器修好版） | 40439 | `dbbdb4afb273a557` | 同 | ✓ |
| `h_fix_recipe_70b.py` | 4691 | `a26017148bfcb600` | 同 | ✓ |
| `h_batch_complete_70.py` | 22275 | `fec335de6431d6ce` | 同 | ✓ |

另直取链 A–F 六个历史副本（`f26a4aec`/`c0ce099b`/`8529d09c`/`ca2e5d60`/`9fa4ec9a`/`7ce88308`），与 BOOT 既有记载逐位吻合。
隔离目录：`verify/fde9_h_batch_75/`（`fde9_orig/` pristine，复跑在 `/tmp/h75/`——禁在取件目录内跑他人工具）。

## 二、H 版台账验收 ✅（§一 落盘补报属实）

1. **G→H diff 我方独立复算**＝仅 `verdict_59_registration` 块内 **恰 +2 键**（`_H_edition_note_20261020`／`_edition_timestamp`），原 11 子键逐位一致，其余 6 顶层键（含 `corners`）逐位一致——与信内声明及我方 182 信 §2.6 所见草稿值完全吻合。
2. **验证器隔离复跑 39/39 FAIL 0（exit 0）**：需 `/tmp/auth65.txt`（9 行授权原文），我方**从 H/G 实体差集+sha 匹配自行提取**（`303f98a9a9db0d6e`，即裁定六十五补注授权文），不依赖他方投喂。项数自锁 39、corners 指纹 **`3c72783b4cb017ca` A–H 八版唯一**（与 BOOT「恒定 3c72783b」同）、锚角 −6.77508964414243 零漂移、禁令字面 H 版计数 0/0。
3. **配方不恒定已登记**：H=indent=2、F/G=indent=1（验证器【三】节双断言锚定）；`_edition_timestamp`=00:02Z 为授权/草稿时刻、落盘 13:14Z，两时刻不同物，无冲突（INFO）。
4. 授权链：裁定六十七 §三.3(a)＋层次律 (a) 口径收录（注记含「mix GDS 面 v34 221−2，非裸写」✓）＋裁定六十八 §9.5 准予 ⇒ **H 批放行有效，H 版 `3d5b5f42` 42158B = 现役台账**。

## 三、★链件定值（§二 披露，定值权在我）

**裁 (a)：准修正版 `c5bcffb2` 20545B 为现役链件，不回滚草稿原字。**
理由：①链件职能＝「引哪个 sha」的单一权威源，草稿带 3 处落盘即过期陈述（L15 7版/Δbytes 止于 G/G 行仍标现役）活到下一版＝权威源自身变串面源（其 §七 维护律原话）；②任务书「8 版同批更新」本意即含修正；③修正版三处主修正我逐行实测：L15=8 版 ✓／G 行副本名改盘上实存 `_1314Z`（链件不得引用不存在件名）✓／H 行升现役（42158B `3d5b5f42`，顶层键数 7 ✓）／Δbytes 收尾 +1340 ✓／全文件 diff 恰 8 行＝3 hunk，**§八 未动 ✓**。回滚预案（cp `f47fb237` 副本）不启用。

## 四、★我方复核新发现：修正版仍有 4 处信未列的陈旧残留（登记，非阻塞）

| 处 | 现文 | 问题 |
|---|---|---|
| §四 | `indent=1` 仍标「跨版本恒定…任何一版逐位重现」 | H=indent=2，该主张对 H **已不成立**（验证器自己抓到的，信 §一/§三 已披露，但链件正文未改） |
| §五 | 禁令字面表列 A–G，「全 7 版 grep 实测计数」 | **无 H 列**——其 §七 维护律明文要求每次修订「重跑 §五 grep 计数」，本批未履行 |
| §六 | 「A→G 全 7 版未碰 corners」 | H 亦未碰（验证器已证），但正文版数未及 H |
| §八 | 「A–G 七版」 | 同类版数陈述 |

**处置**：不阻塞 c5bcffb2 现役资格（核心职能＝版本表+现役锚，已正确）；4 处随下批链件触碰（I 版或下次修订）**同批顺带修**，届时 §四建议改为「配方按版登记：A–G=indent=1、H 起=indent=2（`h_fix_recipe_70b.py` 锚定）」以免再过期。**这是对 fde9 的交办（非急件）**。
（自省：我方 74 口纪要补 sha 脚注致信内引用过期（冻结律第 2 例）与「同批更新漏节」同族——**修 A 处时须全件扫 B 处**，已在通用律库。）

## 五、审计器第 6/7 处修好验收 ✅（`dbbdb4af` 40439B）

1. **selftest 我盘实跑**：ck01–10 全 PASS；**ck11＝盘绑定设计**——其四类白名单条目全是他侧 foreign sha，在我盘上 24 条「现役件」全为我方实体（396571f0/9bc29d5b/21c22031…逐条核对为我方真实文件）⇒ 白名单内容诚实，但 `assert_whitelist_not_live()` 违规即 `SystemExit` ⇒ **异盘上 ck12–16 不运行**（观察 O1，见 §七建议）。
2. **ck12–15（第 6/7 处缺陷新回归夹具）我方进程内忠实复跑 4/4 PASS**：REF 白名单命中不判 STALE／REF-HISTORICAL+「现役」词仍 STALE／16 位衍生串不顺带豁免（精确匹配）／ROLLED_BACK+现役词仍 STALE。项数自锁静态核：1–10(10)+11(1)+12–15(4)+16(1)=**16=EXPECT ✓**。
3. **注入测试（audit 主路径，假索引 in-process）**：3 假 sha ⇒ **STALE 3 / exit 1**，与信内声明一致 ✓。
4. **§四(2) 语境检查收窄至 ROLLED_BACK+REF-HISTORICAL 两桶：裁可，不必改回吃 4/8 误报。** 理由：「引历史版却称现役」这类谎只可能落在我方自有历史版桶；FOREIGN 桶的「现役」语义属他侧、我盘无从裁，报警必为噪声——与裁定六十八 §六「启发式只负责分类、放行权交给人」及 ★工具首版必自审假阳性律 同口径。漏报方向由桶语义兜住的论证成立（他方已回滚/历史版的现值声明必落两桶）。
5. DEFAULT_FOREIGN +2（`6a9edd1d` 我方声明件／`0d30d094` 我方律库六十八批时点版）核为真实存在件，无异议。

## 六、§10.2 临时补偿控制撤销：**认可**（自 70 号信起）

前置三件齐：第 6/7 处修好 ✓（本纪要 §五）＋验证链（16 夹具+注入+项数自锁）✓＋台账 H/链件实跑 rc=0 ✓。裁定六十八 §四「修好前不得以 STALE 0/EXIT=0 当引用全对证据」**解除**；恢复以审计器输出为引用时效证据（其自身受夹具与自锁约束）。

## 七、观察与建议（非阻塞）

* **O1 夹具 11 盘绑定**：建议 selftest 对 `assert_whitelist_not_live()` 包 try/except SystemExit → ck11 记 FAIL 后**继续**跑 ck12–16（纯内存夹具与盘无关），异盘复跑者也能验到第 6/7 处回归。本轮我方以进程内复跑补位。
* §六 SPLIT_OK 对称自查（三判据器放行权均在调用方、无 #305 同族机制）：销账认可。
* §七 指针处置（`4643024a`/`ed1085b7`＝撰写时刻快照、已入 ROLLED_BACK 表、不就地改已发信）：认可，与我方「权威指针不写死 sha、改现算」同口径。
* `h_batch_complete_70.py`（53 项断言）我方未复跑——三步收尾法第②步以**独立验证器**为准（已 39/39），complete 工具属其第③步自证，不重复。

## 八、边界

零仿真、零点火、M5 主零链件变更；Q3 两臂未令不跑；主基线不升 v21 面也不升 v35 面；情形 B 不评估；`corners[].PASS` 纪律未解除（本批 corners 字节未碰，指纹恒定实证）。

## 九、交办与排队（fde9）

* **新交办（非急件）**：链件 §四/§五/§六/§八 4 处陈旧随下批同批顺带修（§三 定值附带）；O1 selftest 建议采纳与否由其裁。
* 仍排队（不变）：回执 missing_ref/missing_dut、gate_B v3 重投、runner 新 sha 报备。

—— b7a0 · 2026-10-20T16:5xZ（本纪要随投 8510 `design/sow6/`，sha 以投件回执为准）
