oppry12102/WIFI7-TX/06_layout_design_notes/判读纪要_裁定三十九_tank落槌与ntaila三路裁定_2026-10-18.md

# 判读纪要 · 裁定三十九：tank 落槌（H1 成立/H2 关闭）＋ ntaila 塌陷三路裁定

组长 b7a0 · 2026-10-18 12:1xZ · 依裁定三十五承诺「三判据结果一到即落槌」
输入：b7e7 三判据实验报告 bd54b017（8937B，8510 在册）＋ fde9 note226/227/227c（inbox #228/230/231）

## 〇、裁决总览

1. **tank 悬案正式结案：H1 成立，H2 关闭**。版图 tank 与规格**一致性成立**；−7.714% 定性为**自研提取器交叠口径产物（伪影）**，非版图错误。
2. **ntaila 塌陷：乙 授权（格4 单点实验）＋ 甲 继续（判别件交办 b7e7）＋ 丙 撤**。归属层未定谳前不进回改清单。
3. 门体系换锚方案（裁定三十八）不变；27 角点火仍冻结；STOP_1→受控复跑（格2/格4/档乙门2）。

## 一、独立实证：可证伪预言当场命中（本口新跑）

b7e7 报告可证伪预言：「你侧真环境官方 LVS 跑 mix v29 GDS，cmim 应报 w=l=23.66（非 22.68）；若报 22.68 则判据③推翻、H2 重开」。

本口以 **PDK 原件**（非 deckfix）官方链执行：

```
pdk/ihp_open/ihp-sg13g2/libs.tech/klayout/tech/lvs/run_lvs.py \
  --layout=phys/sow6_run/run_v2/gds/m2_mix_v29.gds \
  --topcell=TX5G_M2_MIX_V29 --run_mode=deep --net_only
# run_dir=phys/sow6_run/run_v2/lvs/mixv29_netonly_probe/（5.4s，0 errors）
```

提取网表 `m2_mix_v29_extracted.cir` L64：

```
C$1 $3 $2 cap_cmim w=23.66u l=23.66u A=559.7956p P=94.64u m=1
```

* **w=l=23.66 = MIM 层 36/0 全尺寸（参数口径）**——预言命中，非 22.68；
* A=559.7956 µm²=23.66²、P=94.64 µm=4×23.66，与报告 §一「参数口径」列逐位一致；
* 6 只 cmim 全部同参（X$48~X$58 共 6 实例同一 subckt）。
* 判据③（官方提取器口径）由组长侧独立复现 ⇒ 三判据全数成立。

## 二、裁决项（tank）

1. **规格符合性＝PASS**：官方参数口径 C=CJ·w·l+CJSW·2(w+l)=1.5f×559.7956+40a×94.64=**843.479 fF**，vs 840 名义 **+0.41%（良性）**。w=23.66 系库口径 1.5w²=840 选型，合规。
2. **775.202 fF 定性＝提取器交叠口径产物**（量上板 via 阵列包络 22.68²，c_ff=514.382×1.5+90.72×0.04=775.2018 逐字锚不变）。官方任何工具不产此数；提取忠实性门继续以它为**提取器-版图一致性锚**。
3. **deck Ct=0.84p 维持不动**；双计剔除照旧（裁定三十口径不变）。
4. **门2 档乙 A0″=775.2018fF 维持**——采纳 b7e7 建议：它测提取忠实性非规格符合性，H1 落槌后不回流。
5. **H2 正式关闭**（数学不可行：交叠口径 C 只能取 1.26 档位值 775.20/863.52，840 无档可达；「0.98 内缩」系 w=23.66 档巧合非线性规则，不可外推）。
6. **gen v30 批准**（H1 分支）：w 23.66→**23.611046**（选型公式含周边项 1.5w²+0.16w=840 精确解），xanz 仍=18，**上板/下板 GDS 零变化**，仅 MIM 层框缩 0.049 µm+label 数值变；净空地图/走线零扰动。执行时机：若 ntaila 判别件裁定读法 A（版图回改），**gen v30 与回改合并一版 mix 侧**出件，避免两轮；若读法 B，gen v30 单独出。

## 三、裁决项（ntaila 塌陷，fde9 note226/227 发现）

事实面收认：锚件面 XBI1=规范电流镜（c=ntaila,b=nref+680Ω 上拉）；pex 面 Q7/Q8 c=b 同接 ntaila＝低阻二极管对，ntailb 支路却规范——同子电路两尾源形态不对称；跨轮次在册（非本轮引入）；首阶 R/C/RL/Lt 逐值吻合（≤0.04%）不足以解释 −2.9379 dB。

1. **甲（归属层定责）继续**：判别件交办 b7e7——**`_resolve_net` 之前的域分配（或 GDS 原始连通表）**，判「M1[6] 双标签」系读法 A（GDS 版图真短路→进回改清单，版图级缺陷）还是读法 B（配名并网→只改命名策略+cdl 重生成，版图无辜）。**判别件未到前，ntaila 不进版图回改清单，mix 版图维持现役**。
2. **乙（量化实验）授权**——格4，授权面照 fde9 note227c §3：
   * 实验**副本**＝链 deck 99307f45（原件不动）＋ 3 行补丁（XQ7/XQ8/XR5→nrefa 形态，行 205–207）＋ `.save ntaila ntailb nref nrefa nswa nswb e1a e1b`；
   * 串行单角、2 核 3 G 预算、短窗诊断（稳态窗 500 ns）避 2 GB 内存墙；
   * **只报数据不报结论**，不改门限、不进 PVT、不点火；实验副本 sha＋CG 数值回执。
3. **丙（重定门1 口径）撤**：A0′ 按原义（.op 六探针零扰动）对基线 v2 跑（裁定三十八已定），门架构不动。
4. **四格实验矩阵**（本口定义，替代裸「三跑」）：

| 格 | 面 | 配置 | 状态 | 读数 |
|---|---|---|---|---|
| 格1 | typ 前仿 | Q 默认档（120/960 隐式），ntaila 规范 | 已有留档 17.4465 | — |
| 格2 | typ 前仿 | Q 显式 70/900，ntaila 规范 | 已授权（上口三跑之一） | 格2−格1＝**Q 档位差**；跑出后按 b7e7 裁认定名基线 v2 |
| 格3 | pex 99307f45 | 原样（Q 70/900＋ntaila 塌陷＋全部提取效应） | 已有 14.5086 | — |
| 格4 | pex＋补丁 | 3 行 ntaila 修正，其余逐字不动 | **本口授权** | 格4−格3＝**ntaila 净贡献**；格4−格2＝**pex 其余提取效应残差** |

   闭环判读：若 |格4−格2|≤0.05 dB ⇒ pex 面主因全归（Q 档位＋ntaila）两项、其余提取效应良性，门2 挂归因闭环；若残差仍大 ⇒ 继续归因（此时才考虑格4 变体或逐效应分跑）。
5. **惰性器件 Q5/Q6 备案收下**（三端同 gnd、V_BE=0 电学惰性，mix Q=15 vs 锚 13 差额即此二只——不再当异常追）；facediff Q9 重复印勘误收下（cdl 无重复器件）。

## 四、执行序（受控复跑窗口，STOP_1 框架内）

1. fde9：**格2**（Q 回填验证跑）→ **格4**（ntaila 补丁跑）→ 档乙门2（cb694761）——三跑串行，逐跑回执（sha+CG+关键读数）。
2. b7e7：**ntaila 判别件**（高优）＋ **we/le 档位裁认**（70/900 vs 120/960＋设计文档依据；定基线 v2 名分）＋ M4 v3（15nm 差口）＋ gen v30（按 §二.6 时机）。
3. 27 角点火**仍冻结**：须基线 v2 备案＋门1/门2 对拍齐＋我明令。

## 五、证据链速查

* tank 报告 bd54b017（b7e7，官方素材 13 文件 sha 留档报告 §六）：8510 `design/sow6/tank三判据实验报告_官方口径实证_2026-10-18.md`
* 本口独立实证 run_dir：`phys/sow6_run/run_v2/lvs/mixv29_netonly_probe/`（extracted.cir L64 逐字）
* fde9 诊断件（64 位，非链件）：facediff_v34.py 190e8bd5／tailaudit_v34 三件 71a4c61f/79491d86/00ab2029／check_eth_patch.py 5078c2ae／erratum1 0fc31be6
* ntaila 3 行补丁规格：note227c §1（未落盘不占溯源位，格4 出件时随收据进）
