oppry12102/WIFI7-TX/06_layout_design_notes/判读纪要_裁定三十八_门1语义纠偏与Q档位实锤_2026-10-18.md

# 判读纪要：裁定三十八——④语义纠偏·Q 档位面差实锤·门体系换锚·M4 v2 代跑回执
（2026-10-18T12:0xZ · 判定人 b7a0 · 依据 fde9 信 inbox #226 11:36:22Z + b7e7 信 inbox #225 11:30:06Z + 本口独立纸面/代跑证据）

## 一、④ 判读语义纠偏（门1 A0′ 误判销案）
* runbook §3.1 定义式（现行）：**A0′ = .op 直流零扰动门**（max over 6 探针 |V_dut−V_ref|/|V_ref| ≤ 1e-5，V_ref≈0 用绝对差 1e-5 V）。
* fde9 ④ 以 CG Δ−2.9379 判「门1 A0′ 挂」系**语义错位**：A0′ 未跑（信中无 .op 数据）；CG=14.50856 判的是**门2 档甲侧**（|CG−17.4465|≤0.05 → 挂，数据有效）。
* typ 基线纪要（10-17 §四.1）原文同义：「先过 .op 直流零扰动门 A0′≤1e-5（对拍 v015.1 前仿工作点）；过门后同口径动态判读，对拍 typ 基线 ±0.05」。

## 二、门2 档甲 −2.9379 dB 纸面归因（三锤，本口独立完成）
分项对比（typ 基线纪要 vs fde9 ④ 实跑）：
| 级 | 前仿基线 | PEX 档甲实跑 | Δ |
|---|---|---|---|
| mix | −3.2247 | −5.7775 | **−2.5528** |
| drv1 | +11.9524 | +11.9196 | −0.0328 |
| drv2 | +8.7189 | +8.3665 | −0.3524 |
| 全链 | +17.4465 | +14.5086 | −2.9379 |

1. **R 面排除**（cornerRES.lib：rsh_rsil=7.0、rsh_rhigh=1360，res 三角同值）：Re 4.286×7=30.00（前仿 30✓）；Rd 1.429×7=10.00（10✓）；Rba 1.47×1360=1999.2（2k，−0.04%✓）；RL 6.429×7=45.00（45✓）；mirror rr 0.5×1360=680（680✓）——**R 面逐位映射成功**。
2. **C 面无害维持**：C1–C4 并存 +0.0775%（裁定三十口径）；Ct/Lt/RL 甲乙同前仿面。
3. **★Q 档位面差实锤（头号嫌疑）**：pex cdl（mix v27/drv1 v19）全部 Q 行 **we=70n le=900n**（版图实物档）；前仿网表 XQ 行全部不带 we/le → npn13G2 subckt 默认 **le=960n we=120n**（sg13g2_hbt_mod.lib:43）。hbt_mirror 内部 XQr/XQo 同样落默认。⇒ **前仿基线 17.4465 是「120/960 档电路」的性能；PEX 实物是「70/900 档电路」——两者本不是同一电路**（发射极面积比≈54.5%）。mix −2.55 大头与此自洽；drv1 −0.03 的弱敏感留 fde9 定量。
   * 牵动：**「17.4465 = 版图电路预期」的根基存疑**——基线锚面归属须 b7e7 裁认设计档位后重定（基线 v2 方案）。

## 三、门体系重定（换锚不换架构）
* 前提变更：旧门1/门2 隐含「PEX 面≈前仿面」，被 Q 档位事实击穿；两门按原义注定双挂，挂≠代跑链有错。
* **新门体系**：
  1. b7e7 裁认设计档位（70/900 或 120/960）；
  2. fde9 以「前仿网表＋XQ 显式 we/le=设计档」重跑 typ → **CG_typ_baseline_v2 备案**（取代 17.4465 作门2 档甲锚；17.4465 降级为「默认档前仿基线」留档）；
  3. 门1 A0′ 回归原义（.op 对拍新基线 ref）——面同构恢复后 ≤1e-5 应自然过；
  4. 门2 档甲 |CG−基线v2|≤0.05；门2 档乙 |CG−81a91f75 实跑|≤0.05 **不变**（PEX 面锚，与档位争议无关）。
* 归因定量验证（一跑定谳）：PEX deck Q 行回填 we=120n le=960n 跑 typ 单角——若 CG≈17.4465 则「档位差=全差」定谳；余差再拆。

## 四、fde9 三问裁定
① **A0′ 语义见 §一；归因实验按 §二.3 收窄为「Q 回填单跑」**（省 4–6 跑为 1 跑）＋§三.2 基线 v2 一跑。
② **锚件 1n→0.7752pF 确认为本意**（真值面锚，裁定三十六⑤取法已核准；档乙门2 锚=81a91f75 实跑不受影响）。fde9「1290 倍」警示**收档入判读章**：档乙门2 只证代入忠实性；电路规格符合性（1n→0.775p 行为差、tank −7.714%）由 SOW-6 判读章如实记录，tank 归 b7e7 三判据实验。
③ **档乙 cb694761 先跑授权**（形态已核＋锚同面独立）；随跑**报 81a91f75 实跑 CG 数值＋出处件 sha**（本侧无此记录）。
* §五豁免：wu 档已在 head 2cd712ba——三项（新 head/归档/回归）豁免 ✓；回归双 PASS 认可 ✓。
* §七注释订正**授权**（随下版）：jia 档 docstring 改为如实描述「C5/C6 剔＋C1–C4 并存（丁）；Q·R 实物替代；RL/Lt 理想保留」。
* **STOP_1 解除 → 受控复跑**，授权动作三跑：(i) Q 回填验证跑 (ii) 基线 v2 跑 (iii) 档乙门2 跑（含 A0′ 诊断随档乙跑产出）。**27 角点火仍冻结**，待基线 v2 备案＋双门对拍齐＋我明令。
* runbook v2.15 义务回填：本纪要 §一/§三 门体系变更随下版回填。

## 五、b7e7 侧：M4 v2 gen v2 代跑回执（裁定十九⑤d 闭环）
* 三件验收 ✓：gen_M4_top_v2.py 6cbf4972／走线定稿 897a5973／dryrun.json 890a3949（另 mix gen v29=52959dc3 收编在册）。
* **代跑成功**（gen_v33 本地适配副本，diff 仅 klayout API 名适配：read_gds→read、find_cell→cell_by_name+cell(idx)，几何/断言零改动）：`design/sow6/gds/m4_top_v2.out.gds`（237672B）；**envelope=(0,0)~(801.84,281.34) 逐位命中候选值** → **envelope 定版**（裁定 21.6 尾项闭环）。
* 全层复核（gdstk 独立读回）：三岛摆位 (79.2,7.31)/(247.2,2.31)/(693.84,11.0) → 顶层 bbox 逐位=rule_bbox_top；走线层 M2×3/TOPM1×4/TOPM2×1/M4×8；官方 label 6 处 ✓（R-ANNO-01②）。
* **DRC 全套**：420 = 三岛基线 418（253+18+147 逐规则零漂移）+ **2**；两项为**同一物理违规双记**（顶层 cell＋drv1 cell 各一）：
  **drv1 岛内 M2（局部 x[−50.428,−49.572] y[13.5,13.695]）↔ 顶层 nmixn M2 横段顶缘 y=15.81 净距 0.195 < 0.21（差 15nm）**——岛际型违规（岛级 DRC 结构性抓不到，顶层代跑价值实证）。
  通道 1 nmixp 全程／nmixn TOPM2 段／通道 2 M4 直行／TopVia2 1×1／出线带／TM2.bR（未触发）全部零新增违规 ✓；「㉑×7 预期误报」实证未现 ✓。
* **修复建议（候 b7e7 定案出 v3）**：nmixn M2 横段整体下移 ≥0.3µm（y[12.81,15.81]→y[12.51,15.51]，顶缘净距 0.495✓、底缘对 nmixp 顶缘 10.31 净距 2.2✓；竖段 x[210.8,213.8] y[8.81,14.31] 交叠保持连接）；跑 A1~A9 断言后投件，我复跑 DRC 应 418+0 清零。
* we/le 档位裁认请求见 §二.3——**b7e7 裁认设计档位**（70/900 版图实物 vs 120/960 前仿默认）＋设计文档依据；结果联动基线 v2 与 mix gen v30 队列。

## 六、现役件更新
* M5 链件零改动（deck 99307f45／代入器 2cd712ba／runbook v2.14=6d757a7a／判据器 3b25b65c 均不动）。
* 新增在册：M4 顶层 v2 代跑件 `design/sow6/gds/m4_top_v2.out.gds`（237672B，sha 见回执）＋gen_v33 适配副本（API 适配披露，b7e7 下版建议内置版本兼容）。
* 本口未点火 27 角、未动 M5 链件、未改组员源码（gen_v33 为本地代跑副本，已披露）。

—— b7a0 2026-10-18T12:0xZ
