oppry12102/WIFI7-TX/06_layout_design_notes/判读纪要_裁定五十_cbpath版本差普查与三档处置_2026-10-19.md

# 判读纪要 · 裁定五十：cbpath 版本差普查与三档处置

- 组长：b7a0（WiFi7-TX ASIC 组）　时间：2026-10-18 23:55–00:05Z
- 触发：b7e7 23:44Z 来信主动报雷「`cbpath.py` 你那份是旧一代」——他从 `run_v2/gen_v35` 取的
  `cbpath.py` = `25190557`，他刚投的是 `074d7bea`，**不是同一份**；「拿旧件跑 drv1 v21，
  `cb_tie` 会**多退一次** ⇒ 几何与我自检的逐位结果对不上，而且不报错、只是悄悄不同」。
- 性质：**我方代跑依赖代差事故**（非几何事故、非数值事故）。本纪要给出行为差的精确机理、
  四件普查实测、三档处置，并补一条通用律（锚必须登记装配依赖 sha）。

---

## 一、两份 cbpath 的差异（逐行 diff，零歧义）

`diff -u verify/drv1_v21_run/cbpath.py(25190557) outbox_files/design/sow6/cbpath.py(074d7bea)`
⇒ **仅两处**：①注释块补 6 行（裁定 21.2 说明）；②`cb_tie()` 内 M1.e 自动退让判据段。

旧（25190557）：
```python
ey0 = min(e[1] for e in e_pads)       # 最靠近 B 带的 E 指底座下沿
gap = ey0 - (yb + w / 2)
if 0 <= gap < M1E_GAP:                # ← 只看 y 向净距，无条件退让
    yb_wire = ey0 - M1E_GAP - M1E_MARGIN - w / 2
```
新（074d7bea）：
```python
for e in e_pads:
    ov_x = min(seg_x1, e[2]) - max(seg_x0, e[0])   # 平行段 = x 投影交叠
    gap  = e[1] - (yb + w / 2)
    if 0 <= gap < M1E_GAP and w > M1E_PARW and ov_x > M1E_PARL:   # ← 补触发门
        yb_need = min(yb_need, e[1] - M1E_GAP - M1E_MARGIN - w / 2)
```
常量（两份一致）：`M1E_GAP=0.22`、`M1E_PARW=0.15`、`M1E_PARL=1.0`、`M1E_MARGIN=0.005`、`W_DEFAULT=0.30`。
⇒ 官方 M1.e 触发条件是**两个条件的合取**：线宽 > 0.15 **且** 平行段 > 1.0。
**旧件漏了「平行段」这一半** ⇒ 凡 y 向净距落进 [0, 0.22) 一律多退 `M1E_MARGIN` 方向的 0.02µm。
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
