oppry12102/WIFI7-TX/02_spec_and_reports/sow_reports/hbtdiff_layout.png

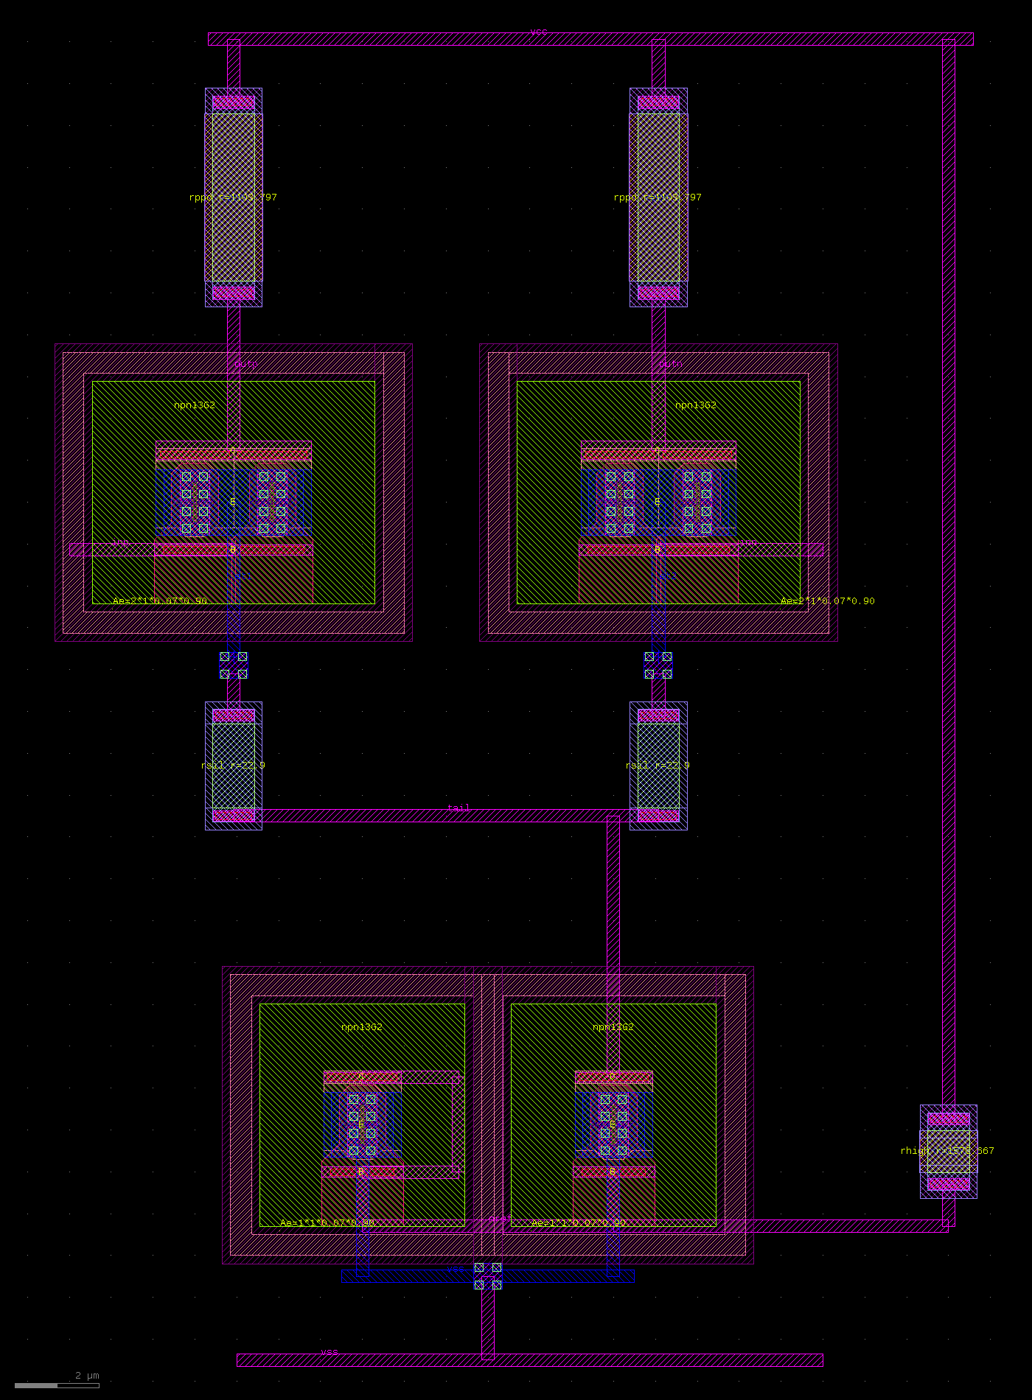
02_spec_and_reports/sow_reports/hbtdiff_layout.png
