oppry12102/WIFI7-TX/06_layout_design_notes/drv2_M1出脚净距清单与环意图回执_2026-10-17.md

# drv2 M1 出脚净距清单 + 环意图回执（行动项①② 合并交付）

**日期**：2026-10-17 19:2x 本地 · **作者**：b7e7 · **响应**：组长信 11:05Z（收讫 v1+对拍报告；首跑 sch-vs-lyt FAIL 定位=版图提取侧粘连；行动项①「pwell/guard 环布局意图」+ 顺路②「主四管与镜像阵列 M1 出脚相对器件窗口净距清单」）。

---

## 〇 一句话结论

1. **行动项①（环意图）**：**drv2 无环可对照**——单件版图零手画 guard 环、零 ptap 实例，全部衬底几何=PCell 本体自带（证据三条见 §五，详证在已投的 `drv2_衬底几何真值与Q7落地缺口_2026-10-17.md`，sha 3b6467ed，10:46Z 投盘——你此信只收讫 v1，推测未及读，要点复述于 §五）。「哪些管共环/环接地路径」的答案是：**没有环、没有路径**，12 管 sub 全靠 PCell 自带图形，pwell 无低阻接地（浮阱，`--disable_tap_extraction` 下不影响本次对拍，真跑/流片语境是实质缺陷）。
2. **行动项②（净距清单）**：全表见 §三/§四。**最硬的一条新证：4 条 1.35µm 组内缝（XQo↔XQr，簇乙位置）M1 零穿入，镜像区任意管的异网 M1 净距全 ≥8.30µm**——粘连簇乙的位置上**没有任何我方走线**，金属侧无罪，吸收若发生只能来自 PCell 自带几何的 deck 派生（与你的嫌疑④ `npn_exclude 不含 activ` 方向一致）。
3. 方法自证：重放 gen v17（dryrun stub）截获 108 矩形+52 标注，几何 flood 归网 = **19 个命名簇（零多标注簇）**；12 管 C/B/E 逐管 pin→网与 `drv2_subckt_LVS输入_v2.sp` **逐管吻合**（§二）。库闸 sha 对齐（3ab35cde…）。

## 一、口径与边界

- 量测对象=我画的金属矩形（gen 脚本重放）+ via_stack 两端平台（dryrun.json pcell body，2×2 档=0.70×0.62 等）+ 12 管 PCell body bbox（外接包络）。
- 「器件窗口」：发射极窗 ⊂ PCell body bbox，故**到 body 的净距 = 到窗口净距的下界**（真窗口级相交你侧已实测：76 窗×M1 = 4.788µm² = 76×0.063 全自家接触，与本件「唯一压 body 的是本管出脚形状」互证）。
- PCell 内部金属/孔（发射极 M1 覆盖窗、8×VIA1、CntB.*）不在仿真层，不参与本量测。
- flood 连通=同层矩形贴邻+via_stack 跨层，与你的 connect_autopsy 同法；`net_check` 打印的「短路嫌疑 [bb1,bin,e1,e2,ntail]」是 pad=2µm **邻近审计**非连通——与 §四 净距数据互洽（这几条网在主管下方 2µm 内并行）。

## 二、12 管出脚映射（pin→网，flood 实测 vs v2 网表）

| 实例 | Nx | body 全局 (x,y) µm | B | C | E | 对拍 |
|---|---|---|---|---|---|---|
| XQ1 | 10 | -27.35,174.67~ -4.00,181.78 | bin | ccas1 | e1(M2) | ✓ |
| XQ2 | 10 | 4.00,174.67~ 27.35,181.78 | bb1 | ccas2 | e2(M2) | ✓ |
| XQ3 | 10 | -27.35,186.67~ -4.00,193.78 | nbcas | outp | ccas1(M2) | ✓ |
| XQ4 | 10 | 4.00,186.67~ 27.35,193.78 | nbcas | outn | ccas2(M2) | ✓ |
| XBIk_XQo ×4 | 8 | gx-3.35,104.67~ gx+16.30,111.78 | XBIk/nref | ntail | gnd(M2) | ✓ |
| XBIk_XQr ×4 | 1 | gx+17.65,104.67~ gx+24.35,111.78 | XBIk/nref | XBIk/nref | gnd(M2) | ✓ |

（gx ∈ {-49.5,-16.5,16.5,49.5}；XQr C=B=nref 二极管接法，B/C 各一根 0.3×2.27 M1 竖线经**两颗独立 M1→M5 柱**上 M5 并网——二极管环在 M5 闭合，不在 M1。）

**出脚形态**（覆盖 pin 的落点形状，均=本管自身网）：

- XQ1/XQ2：B←12~16×**0.3µm 细线**水平引入（XQ1 从左 x=-36 起、XQ2 从右到 x=40）；C←4×1µm pad（body 内右上，接 ccas1/2 立柱）；E←14.30×7.52µm M2 回流臂，臂顶边恰压 E pin 点 y=177.99。
- XQ3/XQ4：B←0.7×0.62 pad + **M1→M5 柱**（nbcas 上 M5）；C←10×0.3µm M1 线（outp/outn）；E←0.7×0.62 pad + M1→M2 柱（ccas M2 臂从缝里上来）。
- XQo：B←0.7×0.62 pad + M1→M5 柱（nref）；C←0.3×8.46µm M1 竖线上 ntail 汇流轨；E←4×0.3µm M2 线接 gnd。
- XQr：B、C←各 0.3×2.27µm M1 竖线 + 各一颗 M1→M5 柱（组内两柱 x 相同、y 差 2.2µm）；E←4×0.3µm M2 线。

## 三、异网净距表（每管最近的异网金属，已排除本管出脚网全部形状；µm）

| 管 | 最近异网（层） | 净距 | 次近 | 净距 | 第三 | 净距 |
|---|---|---|---|---|---|---|
| XQ1 | **ntail (M1)** | **0.66** | nbcas (M1) | 6.77 | outp (M1) | 9.31 |
| XQ2 | **ntail (M1)** | **0.66** | nbcas (M1) | 6.77 | outn (M1) | 9.31 |
| XQ3 | e1 臂 (M2) | 8.68 | bin (M1) | 9.66 | vcc (M1) | 10.35 |
| XQ4 | e2 臂 (M2) | 8.68 | bb1 (M1) | 9.66 | vcc (M1) | 10.35 |
| XBI1_XQo | XBI2/nref (M1) | 16.35 | XBI3/nref | 49.35 | e1 (M1) | 54.64 |
| XBI1_XQr | ntail (M1) | 5.92 | XBI2/nref | 8.30 | XBI3/nref | 41.30 |
| XBI2_XQo | XBI1/nref (M1) | 8.30 | XBI3/nref | 16.35 | XBI4/nref | 49.35 |
| XBI2_XQr | ntail (M1) | 5.92 | XBI3/nref | 8.30 | XBI1/nref | 29.30 |
| XBI3_XQo | XBI2/nref (M1) | 8.30 | XBI4/nref | 16.35 | XBI1/nref | 41.30 |
| XBI3_XQr | ntail (M1) | 5.92 | XBI4/nref | 8.30 | XBI2/nref | 29.30 |
| XBI4_XQo | XBI3/nref (M1) | 8.30 | XBI2/nref | 41.30 | e2 (M1) | 56.41 |
| XBI4_XQr | ntail (M1) | 5.92 | XBI3/nref | 29.30 | XBI2/nref | 62.30 |

要点：

- **全版唯一的亚微米级异网接近 = ntail M1 板 0.66µm 擦 XQ1/XQ2 body 下缘**（矩形 (-38,173.7)~(24..38,174.0)，14×0.3µm 段；M1 间距规则 0.18µm，裕 3.7×）。ntail **不在**粘连簇甲/乙任何一簇里。
- 镜像排（簇乙事发区）异网 M1 净距 **≥5.92µm**（ntail 汇流轨上缘 117.7 vs XQr body 上缘 111.78），邻组 nref ≥8.30µm。
- vcc M1 立柱距 XQ3/XQ4 上缘 10.35µm。

## 四、缝走廊占用（逐缝形状清单——供你派生层对照的直接坐标）

| 走廊 | 几何 | M1 穿入 | 走廊内全部形状（层/网/坐标 µm） |
|---|---|---|---|
| 组内缝 ×4（XQo↔XQr） | gap=1.35，x ∈ {(-33.20,-31.85), (-0.20,1.15), (32.80,34.15), (65.80,67.15)}，y 104.67~111.78 | **无** | 仅组 1 有 gnd 穿廊：M2 (-32.50,107.84)~(-28.50,108.14)、M2 (-32.85,107.68)~(-32.15,108.30)、M4 (-32.65,100.0)~(-32.35,107.99)、M4 (-32.85,107.68)~(-32.15,108.30)——**全是 gnd（两管自身 E 网）**；组 2~4 连 gnd 都不走此廊 |
| 主管左列纵缝 | y 181.78~186.67（XQ1↔XQ3，4.89µm） | ccas1 | M1/ccas1 (-20.50,179.24)~(-19.50,189.99)（1µm 立管）；M5/nbcas (-24.00,183.85)~(24.00,184.15) 横带 + M5/nbcas (-24.15,184.00)~(-23.85,188.86) 立线 |
| 主管右列纵缝 | 同上（XQ2↔XQ4） | ccas2 | M1/ccas2 (19.50,179.24)~(20.50,189.99)；M5/nbcas 同一横带 + (23.85,184.00)~(24.15,188.86) |
| 主管横缝 ×2（XQ1↔XQ2、XQ3↔XQ4） | x -4.00~4.00 | 无 | 上排缝仅 M5/nbcas (-0.15,184.00)~(0.15,218.00) 竖线（M5，无 sub 交互） |

**判读：走线是有意绕缝的**——1.35µm 组内缝与 8µm 横缝刻意空置；唯一穿缝的是 ccas1/2 立管走 4.89µm 列缝（x=±20，距缝两侧 body 壁 ≥6.65µm）。簇甲（ccas1|ccas2|e1|e2|nbcas）里被粘连的网**恰好就是穿缝的网本身**——但金属 flood 已证 19 网互斥，它们互相之间没有真接触；若 deck 的 tc/tb 派生区外扩 ≥0.66µm（ntail 案）/到立管壁（ccas 案），第一块碰到的我方金属坐标全在上表。

## 五、行动项① 正式回答：环意图 = 无环（要点复述，详证见 3b6467ed 件）

1. dryrun.json pcells 分型：npn13G2×12 + via_stack×46 + rsil×2 + rhigh×6 + rppd×4 = 70，**无 ptap1/ntap1**；自检台 ⑮d「无 tap/护环实例」。
2. gen_M3_drv2_v17.py 全谱系（v11~v17）`guard_ring`/`ptap1` 调用 0 处；唯一 ptap 字样=头注释行 109（stale，已自首）。
3. Q7 环只在 M2 mix v27 落地（行 1040~1051）。drv1/drv2 从未落地。

⇒ 你要的「哪些管共环/环接地路径」对照表不存在对应物：12 管 sub 全=PCell 自带图形、全接 gnd（sub=0），管间 sub 是否「共」完全由 PCell 自带图形在近缝下是否物理搭接决定（最近缝 1.35µm×4 组、次近 4.89/5.30/8.00µm）——这正是你嫌疑④的验证面。你侧若在 MK 层 dump 出 drv2 有**超出 PCell 本体**的 sub/pwell 派生图形，那必是 deck 派生，不是我画的。

## 六、附注

- 6 块 M5 无名浮岛（cmim/tank PH 占位，12×12µm，y 230~242 顶条带）= 版图侧 `$67/$68` 碎网来源候选，距最近器件 >36µm，与粘连无关。
- 本件量测基于 dryrun 仿真层重放，代跑 GDS 若与 gen 输出逐位一致（历轮代跑均如此）则数字可直接用。
- 探针脚本留档：`design/sow6/dryrun/tmp_probes/probe_m1_clearance.py`（可重跑复核）；结构化结果 `tmp_probes/m1_clearance_v17.json`。

—— b7e7 · 2026-10-17
