oppry12102/WIFI7-TX/06_layout_design_notes/README_交付清单.md

# SOW-6 版图交付清单（b7e7 · 2026-10-17 17:2xZ 更新 · Q11 轮）

> # ⚠⚠ 历史快照 · 非现行（组长 2026-10-18 23:19Z 裁定四十六 §五.2 令）
> 本文件是 **Q11 轮（2026-10-17 17:2xZ）的快照**，**已降级为历史留痕，不作现行口径**。
> 快照里 §一 表格写「现行件 = M2 v26 / drv1 v15 / drv2 v14」，与同文件后文的
> v27/v17/v16 自相矛盾，也与**现役（mix v31 / drv1 v20 / drv2 v20）**全不对；
> 其中「lib13g2 v2.1 vs v1 分歧」告警**已过期**（现钉 **v2.3 sha 3ab35cde…**）。
> **现行口径请以本文件末尾 §七「2026-10-19 现行件速查」为准**（已补）。
> —— 教训：文件名叫「交付清单」却长期当快照用 ⇒ 谁照它取件谁拿错版本；
> 本组律「取件请认准版本号」对**清单本身**同样适用。

> **本目录下的 `gen_*.py` 就是全部现行交付件，一件不多一件不少。**
> 历史稿全部归档在 `_obsolete/`（勿代跑，原因逐件列在那里）。上级目录另有
> `gen_M3_drv*_设计稿_*.md` / `M2_mix级版图设计稿_*.md` 等多版设计稿，**以本清单
> 指定的版本为准**，旧版设计稿是推导过程留痕，不是现行规格。

## 一、现行三件（组长代跑取件只认这三个路径）

| 模块 | 生成脚本 | 设计稿 | 本机自检结果 |
|---|---|---|---|
| M2 · gilbert_mix 混频器 | `gen_M2_mix_v26.py` | `M2_mix级版图设计稿_v2.4_2026-10-17.md` | **19 项 PASS** · 29/29 网名 · 器件 82 · 标注 66（/1 与 /25 各 66 对齐） |
| M3-a · drv1 级驱动 | `gen_M3_drv1_v15.py` | `M3_drv级版图设计稿_v1.3_2026-10-17.md` | **19 项 PASS** · 13/13 网名 · 器件 32 · 标注 32（/1 对齐） |
| M3-b · drv2 级驱动 | `gen_M3_drv2_v14.py` | `M3_drv级版图设计稿_v1.3_2026-10-17.md` | **19 项 PASS** · 19/19 网名 · 器件 71 · 标注 53（/1 对齐） |

三件共同成立：⓪ 库版本闸对齐（lib13g2 **v2.2** sha 02ecbfb95b3b…，canonical = 8510
`design/sow6/lib13g2.py`，539 行 / 27592B）、零跨层短路、零过孔柱压异网、
网名全闭合（幽灵网名 0 / 漏标 0）、**每个网名同时落在官方 label purpose `/1` 与次级 `/25`**
（R-ANNO-01 ②）、**HBT 两两边缘净距 ≥0.70µm**（真值表 v1.1 勘误的 DRC 二分实测口径）。
非阻塞 WARN 两类（无标注金属柱下 5/3/14 处、via_stack 阵列外接外推）——待 PDK 实测确认，
不是缺陷，不阻塞代跑。

> ⚠ **取件请认准版本号**：现行件是 **M2 v26 / drv1 v15 / drv2 v14**。
> 作废链（勿代跑）：v25/v14/v13（Q8 轮，TopVia1 未钉档）、v24/v13/v12（Q8 前）、
> v23/v12/v11 … 直至 v0.1，历史稿全部在 `_obsolete/`（原因逐件列在那里）。
> 文件名只差末位版本号是这套脚本最容易出事的地方 —— 取件后请核对本表 sha。

## 二、组长侧代跑步骤

```bash
. /data/workspace/pdk/kl_env030.sh          # PDK 环境
python /data/workspace/design/sow6/gen_M2_mix_v24.py
python /data/workspace/design/sow6/gen_M3_drv1_v13.py
python /data/workspace/design/sow6/gen_M3_drv2_v12.py
```

**交件前硬纪律**（SOW-2 血泪，写在 BOOT.md 里）：本机先跑
`python /data/workspace/design/sow6/dryrun/preflight.py <件>`（三件可同跑，0.5s），
自检不过不投。自检 **22 项 + ⓪ 库版本闸**覆盖：层名、引脚落点、器件间距、岛框越界、
标注短路/悬空、引脚金属覆盖、网表↔版图器件逐只核对、网名闭合、网名分裂、跨层短路、
过孔柱压异网、嵌套网名层次、引脚极性几何取证、**label 层合规**、**HBT 实例间距与护环净距**、
**官方 DRC 宽度/网格/间距族 ⑯⑰⑱**、**裁③ 轴向族**、**⑲ TopVia1 端点平台**、
**⑳ 并集相向平行边**、**㉑ via_stack 两端落点**、**㉒ 邻件 C/B 带金属投影互压**
（末五项为自侧量测，量不到 PCell 内部 ⇒ **全绿 ≠ 官方 DRC 全绿**，见 preflight 头注）。

⓪ **库版本闸**（2026-10-17 补，最要紧的一条）：自检 `import lib13g2` 走的是**本地副本**，
组长代跑解析的是**他那一份**。库升 v2.1（520 行，`net_check` 改用 `Polygon.touches` 精判）
而我副本还是 v1（221 行）时，三件瞬间全挂 —— 说明此前那些「全 PASS」验的不是同一份库。
现钉住 sha256，不符即判**结论无效**（不是警告）。组长升库后先跑：

```bash
python3 /data/workspace/design/sow6/dryrun/sync_lib.py     # 取回+安装+回填闸
```

> ⚠ **上游现存版本分歧（待组长确认）**：8510 `top/lib13g2.py` = v2.1（520 行 / 26221B /
> sha b0583f69…），而 `phys/top/lib13g2.py` 仍是 v1（221 行 / 10418B / sha 0422fe2d…）。
> 我按 v2.1 自检。**若代跑时 `import lib13g2` 解析到的是 `phys/top/` 那份 v1，结果会不同**
> ——请代跑前确认走的是哪一份，或把 `phys/top/` 同步到 v2.1。

## 三、本机辅助工具（都不产出交付件）

| 脚本 | 用途 |
|---|---|
| `dryrun/preflight.py` | **22 项 + ⓪ 库版本闸**前置自检台（交件前必跑） |
| `dryrun/hbtgeom.py` | 第 ⑮ 项量测内核：HBT 两两边缘净距 ≥0.70µm（真值表 v1.1 勘误口径） |
| `sow6/hbtgeom.py` | **C/B 带金属半宽真值表**（B=0.925×NX+0.05 / C=0.925×NX，五档实测残差 0）——gen 侧 `_qr_l_assert` 与第 ㉒ 项**共用这一份**，口径不许各写一份 |
| `dryrun/bandproj.py` | 第 ㉒ 项量测内核：邻件 C/B 带金属投影互压（mix v29 真短案，PCell 内部金属，二十项量不到） |
| `dryrun/band_measure.py` | 从真 GDS 量带金属宽度（layer 8 长条聚类，**平移无关**）——补真值表用 |
| `dryrun/sync_lib.py` | 把本地 lib13g2 副本同步到组长当前那份 + 回填版本闸（**开工先跑**） |
| `dryrun/probe_hbtgeom.py` | 单件间距探针（不入自检台，先看实况用） |
| `dryrun/teeth_hbt/run_teeth_hbt.py` | 有牙验证：第 ⑮ 项 1 处注入 1 处真 FAIL（净距 0.35µm） |
| `dryrun/netaudit.py` | 网级审计，含第 ⑫ 项引脚极性几何取证 |
| `dryrun/inspect.py` | 几何取证器（`--vias` / `--shapes M2` 看图形） |
| `dryrun/teeth_v11.py` | 有牙验证：11 处注入 11 处真 FAIL（跨层短路/过孔柱面） |
| `dryrun/teeth_label/gen_teeth.py` | 有牙验证：第 ⑭ 项 3 处注入 3 处真 FAIL（label 层面） |
| `dryrun/pya.py` | 无 klayout 时的 pya 仿真层；`m1_lib/lib13g2.py` 为**组长 v2.1** 库副本 |
| `emitpath.py` | Rsheet 三档对表自动重算（**Rsheet 真值回填后必跑**） |
| `resgeom.py` | 版图几何核算（单一真值源，见 CHANGELOG ②） |
| `design/chain_top_tb_v015_1.sp` | 网表锚（真值源，脚本内 `SP_ANCHOR` + `DEV_NETS` 逐只核对） |

## 四、七个问题（Q1–Q7）状态：**裁决已全部到手并落地**

| 问题 | 裁决来源 | 落地状态 |
|---|---|---|
| Q1 via_stack 焊盘口径 | reply_v9 定案 + `probe_viastack_truth` 实测 | ✓ 三件全用单颗 via_stack（逐层铺栈已废） |
| Q2 层次网名与分隔符 | reply_v9/v10（`/` 分隔、展平名=实例路径） | ✓ 网名 29/13/19 全闭合 |
| Q3 块级 bondpad | reply_v9 | ✓ pad 撤岛 |
| Q4 注释层号 | reply_v12 Q4 + R-ANNO-01 | ✓ 网名双打 /1+/25；金属 /0 零文本 |
| Q5 Rsheet 真值 | reply_v10/v11/v12 + R-RES-01 | ✓ 三件电阻几何已按 cornerRES 三档重算 |
| Q6 cmim 真件 | reply_v12 + R-RES-01 + 07:45Z 裁定② | ✓ 已改用库原语 `b.mim_cap`（W/L + 相位 snap 交给库），六只端子按 M5/TOPM1 引脚锚定接网 |
| Q7 guard 环归属 | reply_v12 Q7（ptap 环标 gnd、不许悬空、不推 M4） | ✓ 已接 gnd 真网；ptap 8 只几何未本地验证 |

**结账状态（07:45Z 裁定后）**：① `CMIM_FALLBACK`/`PTAP_SKIPPED` 三件计数 **0/0/0**（已结账）；
② cmim 引脚真值已取得（M5 pin 67/2 + TOPM1 pin 126/2，同心于 (11.83,11.83)）并按 `mim_cap`
落地（已结账）；③ 官方 DRC 对 guard 环/tap = **零真几何违规**（已结账）。

> **2026-10-17 15:3xZ 补**（组长 `top/` 段三件已到本地）：② 的口径已从纪要取得 ——
> PCell 名 `"cmim"`、参数 `{"Calculate":"w&l","w":"23.660u","l":"23.660u"}`、
> 实测 bbox **24.86×24.86**、引脚 **M5 pin 1 / TOPM1 pin 1**、名义 C=839.7 fF；
> 且 **lib13g2 v2.1 已带库原语 `b.mim_cap(name, c_fF, (x,y))`**（自动解 W/L + 相位 snap）。
> 待办随之从「等坐标」变成「改用 `mim_cap` 原语落件 + 按 M5/TOPM1 pin1 实坐标接落线」。
> 真值表 §3 尚未收录 cmim（纪要注明 v1.2 补列），故我的判据仍按纪要转述执行。

---

## 2026-10-17 06:56Z 更新：Q5/Q6/Q7 落地版已投件（**已被下节升版取代**）

当时的七件 sha 表见 `CHANGELOG_2026-10-17_Q5Q6Q7.md`；那三件（gen_M2_mix_v23 /
gen_M3_drv1_v12 / gen_M3_drv2_v11）**已作废**，勿按本节取件。

---

## 2026-10-17 07:0xZ 更新：⑭ 官方 label purpose `/1` 补打（本节为现行件）

**这一版的唯一改动**：三件各加一个 `relabel_official(b)` 收尾 —— 把每个 `<金属>/25`
的网名文本，在**同层** `<金属>/1` 再打一份（Metal1.label=8/1、Metal2.label=10/1…）。

**为什么现在才改**：组长 R-ANNO-01 ② + reply_v9 §五 + probe 三处同口径要求「网名 label
一律打官方 label purpose /1，禁止打 drawing /0」；reply_v9 还点名「自检台加一项
label 层合规」。我此前的 12 项里没有这一项，三件网名一直只落在 `/25`，缺口就这么
静悄悄溜过去 —— **自检台没有的项，等于没人查**。

**为什么写在 gen 脚本里、不改 `lib13g2.label()`**：三件 `import lib13g2`，组长代跑时解析到
的是**他那一份** `phys/top/lib13g2.py`；我改自己 `m1_lib/` 下的副本对代跑毫无作用，
只会制造「我这边已经改了」的假象。口径必须长在交付件里。

**`/25` 为什么保留**：官方 LVS deck `connect(metal*_con, metal*_text)`（reply_v10 §57-63）
把 `/25` 接进金属网 = 次级 label 通道；两处同名 label 指向同一金属簇只是同名合并，
不会多出网、不会短路，且 `/25` 上全是纯网名本就不生幽灵网。双打是「满足硬条款 + 保留
既有读法」的两全，不是妥协。

### 本轮投件 sha（逐件 GET 回读比对，见交付信）

| 文件 | bytes | sha256 |
|---|---|---|
| gen_M2_mix_v24.py | 54263 | bc5cf43fe7cfe4d00d4d5ad392ee18a144a552bf890747c6ee692c223bf37e72 |
| gen_M3_drv1_v13.py | 28790 | 7a72290a9ed3545f541c8d2226b7a40bb87e279e16416cc26c773a86d6386e62 |
| gen_M3_drv2_v12.py | 31185 | 059ac75dcd8d79144c37134e1c7dca33a8b1d5126de2c7621b1f4bd086f50363 |
| dryrun_v24.tar.gz | 85573 | bba08f2bf0b79b258c1085d51ad1311c36c3987cf2204fe71359d58285f84a74 |

### 自检台第 ⑭ 项与它的牙

- ⑭ 三条判据：每条 `/25` 网名必须有同层 `/1` label；金属 `/0` 零文本；`/1` 不得出现
  `/25` 没有的文本（凭空网名=幽灵网）。
- **有牙已证**（`dryrun/teeth_label/gen_teeth.py`，exit=0 才算过）：三处注入三处真 FAIL
  —— A 撤掉补打（= 修复前状态）被抓、B 往金属 `/0` 落文本被抓、C 往 `/1` 塞凭空网名被抓；
  同时真件必须仍 PASS。

### 顺手修掉的两个真缺陷

1. **`preflight.py` 换目录就崩**：gen 脚本 `import resgeom/emitpath/lib13g2` 是同目录模块，
   自检台没把**脚本所在目录**加进 `sys.path` —— 换个 cwd 或把脚本放子目录就
   `ModuleNotFoundError`，结论变成「脚本执行异常」而非真正的自检项失败。
   （牙齿验证时当场踩到，已修。）
2. 旧 `dryrun_v23.tar.gz` 里混进了 `__pycache__` 与 `tmp_probes/`（牙齿注入残留）；
   `dryrun_v24.tar.gz` 已排除。

### 代跑前仍必读的三条「别把它当真」的声明

1. **cmim 两端落线未接**：真件已放（PCell `cmim` / w&l / 23.66µm 见方），引脚层运行时自适应；
   落线坐标要等代跑回读真实引脚后才接。日志里的 `CMIM_REAL` 行会打印两端坐标与端子层。
2. **ptap 几何未本地验证**：以 PDK 默认参数落 8 只，`TAP_ENABLE=True` 可一键关；
   PDK 若不认 `ptap` 只打 `PTAP_SKIPPED` 并跳过，不掐断全链。
3. **仿真层不建未知 PCell**：cmim/ptap 在本机一律走占位回落，
   自检台的 PASS **不覆盖**这两类器件的真实几何 —— 它们的账在真 DRC/LVS 上结。

---

## Q8 版（2026-10-17 07:5xZ）· **现行件**

| 件 | 文件 | 字节 | sha256 前16 |
|---|---|---|---|
| M2 | `gen_M2_mix_v25.py` | 69573 | 1a6f91f42756cfa8 |
| drv1 | `gen_M3_drv1_v14.py` | 33118 | eea75ca2fd0986d0 |
| drv2 | `gen_M3_drv2_v13.py` | 35842 | 6144b91b08750852 |
| kit | `dryrun_v26.tar.gz` | （打包时含本清单，故其自身 sha 以投件回执为准） | — |
| 变更 | `CHANGELOG_2026-10-17_Q8.md` | 5446 | fe6d7f8d47fc7a28 |

**作废件**：`gen_M2_mix_v24.py` / `gen_M3_drv1_v13.py` / `gen_M3_drv2_v12.py`（勿再代跑）。

**三件自检**（子进程隔离，结论只认新鲜解释器）：

    gen_M2_mix_v25.py    -> PASS  器件=82 标注=66  ⑯⑰⑱=0/0/0
    gen_M3_drv1_v14.py   -> PASS  器件=32 标注=32  ⑯⑰⑱=0/0/0
    gen_M3_drv2_v13.py   -> PASS  器件=71 标注=53  ⑯⑰⑱=0/0/0
    teeth 11/11 全部有牙

**七问状态**：Q5/Q6/Q7 已在 v25/v14/v13 落地；Q8 = 官方 DRC 两族（Offgrid / TM1.a /
TM2.a / Slt.c.M1）已按纪要规则值处理；**Q9 三问待组长裁定**（CHANGELOG §五）：
via_stack 顶层焊盘尺寸真值、逐规则 DRC 坐标明细、`phys/top/lib13g2.py` 版本分歧。

---

## Q9 版（2026-10-17 15:5xZ）· **现行件**（执行组长 07:45Z 四裁 + lib v2.2）

| 件 | 文件 | 字节 | sha256 前16 |
|---|---|---|---|
| M2 | `gen_M2_mix_v26.py` | 76128 | 7ce845c36ab340b5 |
| drv1 | `gen_M3_drv1_v15.py` | 35538 | b666586ea90e48d0 |
| drv2 | `gen_M3_drv2_v14.py` | 39042 | 52bc061ed453bbfc |
| kit | `dryrun_v27.tar.gz` | 148593 | 80f73f2a121f838a |
| 设计稿 | `M2_mix级版图设计稿_v2.4_2026-10-17.md` | 15725 | 3ab41750b6423d90 |
| 设计稿 | `M3_drv级版图设计稿_v1.3_2026-10-17.md` | 9380 | 4682a926d038a841 |
| 变更 | `CHANGELOG_2026-10-17_Q9.md` | — | 以投件回执为准 |
| 本清单 | `README_交付清单.md` | — | 以投件回执为准 |

**作废件**：`gen_M2_mix_v25.py` / `gen_M3_drv1_v14.py` / `gen_M3_drv2_v13.py`（勿再代跑；
原因是 v2.2 起 TopVia1 阵列档位会继承 cols/rows，未钉 1×1 的几何不再是已验过的那份）。

**三件自检**（子进程隔离，结论只认新鲜解释器）：

    gen_M2_mix_v26.py    -> PASS  器件=82 标注=66  ⑯⑰⑱=0/0/0  ⑲=0
    gen_M3_drv1_v15.py   -> PASS  器件=32 标注=32  ⑯⑰⑱=0/0/0  ⑲=0
    gen_M3_drv2_v14.py   -> PASS  器件=71 标注=53  ⑯⑰⑱=0/0/0  ⑲=0
    ⓪ 库版本闸 = lib13g2 v2.2（sha 02ecbfb95b3b…）✓ 对齐
    teeth 11/11 全部有牙

**本轮要点**（逐条理由见 `CHANGELOG_2026-10-17_Q9.md`）：
① `sync_lib.py` 的 CAND 改为 canonical 段 `design/sow6/lib13g2.py`；② 六只 cmim 改走库原语
`Board.mim_cap`；③ 三件所有 TopVia1 栈**显式钉 vt1=1×1**（几何与已代跑那份逐位相同）；
④ 自检台新增第 **⑲** 项（TopVia1 端点平台 vs 我画金属，只用实测档）；
⑤ 更正旧账：顶层焊盘 1.64 见方不违规，我上轮的三问之一**关闭**。

**待裁定**：① drv2 的 vcc 馈电桶要不要从 1 颗 TopVia1 提到 3×2=6 颗（4.0Ω→0.67Ω，
自检实测放得下，等你点头）；② 2×2 / 37×1 的 TM1 平台真值（如实坚持要这两个档）；
③ Slt.c.M1 口径（最窄边 vs 任一边，上一轮遗留）。

---

---

## Q11 轮（2026-10-17 09:3xZ）—— 现行件 = **v27 / v17 / v16**

触发：补读上口漏读的**四封**组长来信（inbox.jsonl 第 **60**、**61** 行 = Q9 代跑判读 +
lib v2.3 投盘；第 **62**、**63** 行 = Q10 判读与定版收讫）+ 新投盘
`判读纪要_Q9代跑v26轮`（5735B sha aa85cecd）、`判读纪要_Q10代跑v27轮`（5868B sha 6327a8e3）、
`判读纪要_Q10代跑v27轮_增补_定版收讫`（3621B sha b1227227）、`单元几何真值表_TopVia2_v1.0`
（2334B sha 2766b088）。逐条理由见 **`CHANGELOG_2026-10-17_Q11.md`**。

| 件 | 文件 | 字节 | sha256(前16) |
|---|---|---|---|
| M2 | `gen_M2_mix_v27.py` | 81586 | f2e058079dca3212 |
| drv1 | `gen_M3_drv1_v17.py` | 53006 | c1110b989deaaa85 |
| drv2 | `gen_M3_drv2_v16.py` | 49601 | 7837b6fba2d78c89 |
| kit | `dryrun_v30.tar.gz` | 139409 | ddfdca8e349d203a |
| 设计稿 | `M3_drv级版图设计稿_v1.5_2026-10-17.md` |15963|1c5548182e29b6c6|
| 变更 | `CHANGELOG_2026-10-17_Q11.md` |14835|a448ed8b903f1182|
| 本清单 | `README_交付清单.md` | （自指：写清单会改自己） | 以投件回执为准 |

**作废件**：`gen_M3_drv1_v16.py`（cmim 未拆）、`gen_M3_drv2_v15.py`（落点两端悬空）、
`dryrun_v28.tar.gz`（含 pya.py 的 Trans 合成 bug）、`dryrun_v29.tar.gz`（含过时的 13×3 档位）。

**本轮五件事**

1. **桶档位 = 37×1 单排**（裁定②）。37 × 4.0Ω 并联 ≈ **5.4mΩ**；EM 37 × 1.4mA = 51.8mA
   ≥ ~30mA。落点同时从「浮空」挪到上环中段偏左（−17.25, 212）：偏左是因为 drv2 的
   nbcas M5 立管在 x=0，37×1 的 M5 平台 30.86 宽居中会压到它。
2. **⚠ 抓到结构缺陷并修掉一半**：原落点 `TVY = Y_VCC_HI − VCC_W = 206` 比上环下沿（209）
   低 **2.18µm**、M5 侧全空 ⇒ **整根落柱两端都不落 = 浮岛**，R-VIA-01 的顶层馈电
   从来没接过电。**官方 DRC 不报**（无管浮空的规则），只有 LVS 会炸。
   v16 已修好 **TM1 端**；**M5 端仍悬空** —— drv2 的 vcc 分配全在 TOPM1、那带没有 M5，
   **接哪张网是电路决定，已报你裁**（v16 自检 ㉑ 如实报这 1 条 FAIL）。
3. **裁定① 落地：drv1 cmim 拆分并联 + 专用条带**（v16 → v17）。取 **16 × 0.625p**
   （单只见方 20.41µm，比 30 上限多 32% 余量）；Ct1/Ct2 不拆（0.84p 单只 23.66 已合规，
   再拆会让单只 < 2fF 而官方几何律 `n=fix((side+0.12)/1.26)` 失效）。
   **但拆不动的根因是面积、且不是拆分造成的**：总量守恒 ⇒ 需 **14453µm²**（核的 59%），
   条带按行距要 **237µm** 高，而核顶之上本版留 0µm（**未擅自扩岛**）⇒ **缺 237µm**，
   逐项印在 stdout 的「CMIM 面积台账」里。三选一请裁：扩岛 / 减 Cin / 外置电容区。
4. **裁定③ 落地：平台律分段写成会失败的断言**。`drcgeom.platform_law_check()` 拿七档
   实测值**逐轴**回算（n=1 单孔 1.64/0.62；n≥2 线性 0.84(n−1)+1.26 / +0.62），
   七档全部一致 ✓。口径只写注释拦不住人改表，写成断言才拦得住。
5. **我自己仿真层的一个 bug**：`dryrun/pya.py` 的 `Trans.__mul__` 把位移多套了一次自身
   线性部分（`L_a·L_b·d_b` 应为 `L_a·d_b`）⇒ **镜像器件整体落到错误一侧**（drv2 的 XQ4
   落在 x −44~−20.65、压在 XQ3 身上）。潜伏至今是因为器件间距③与HBT间距⑮走 `b.devs`
   里直接存的 trans、不经合成。**已修；修完三件结论不变**。只影响本机自检台，
   **不影响交付件几何**（真 klayout 一直是对的）。

**自检台新增**：第 **㉑** 项「via_stack 两端落点重叠」+ ⑦b 升级为**前缀族核对**
（拆分行只数必须与拆分表一致，防「只声明一只」蒙过核对）+ 裁③ 平台律断言。
teeth **17/17** 全有牙（含 2 条 ㉑ 的牙 + 1 条拆分行接错网名的牙）。

**自检（子进程隔离，⓪ 闸 = lib13g2 v2.3 558行/29102B/sha 3ab35cde…）**

    gen_M2_mix_v27.py   → PASS  器件=82 标注=66  ⑯⑯b⑰⑱⑲⑳㉑ 全 0
    gen_M3_drv1_v17.py  → PASS  器件=32 标注=32  ⑯⑯b⑰⑱⑲⑳㉑ 全 0
    gen_M3_drv2_v16.py  → FAIL  器件=71 标注=53  ⑯⑯b⑰⑱⑲⑳ 全 0，㉑=1（M5 端，已报备）
    teeth 17/17 · teeth_label 三坏例 exit=1 + 真件 v17 exit=0 · 裁③ 七档一致 ✓

**代跑基线**（09:19Z 确认）：Q10 = **253 / 28 / 162**；Q11 预期桶区与 cmim 区零新增。

---

## Q10 轮（2026-10-17 08:0xZ）—— 现行件 = **v27 / v16 / v15**

触发：组长 inbox 第 59 行「Q8 代跑 v25 轮判读回执 · 战报 + 三问全答 + 可修残留三处」
（2026-10-17T08:04:19Z）+ 新投盘 `DRC逐条坐标明细_v25轮_2026-10-17.md`（464 条全量）
+ `判读纪要_Q8代跑v25轮_2026-10-17.md`（sha 1bbae1d9…）。
逐条理由见 **`CHANGELOG_2026-10-17_Q10.md`**。

| 件 | 文件 | 字节 | sha256(前16) |
|---|---|---|---|
| M2 | `gen_M2_mix_v27.py` | 81586 | f2e058079dca3212 |
| drv1 | `gen_M3_drv1_v16.py` | 44322 | c14894f5eaa373ef |
| drv2 | `gen_M3_drv2_v15.py` | 44801 | cddb2bed944bcc6d |
| kit | `dryrun_v28.tar.gz` | 73819 | 4a5419138306fe9b |
| 设计稿 | `M2_mix级版图设计稿_v2.5_2026-10-17.md` |17703|a5d6dd83a2c3f78d|
| 设计稿 | `M3_drv级版图设计稿_v1.4_2026-10-17.md` |13108|f66ab2f3d5f49ff3|
| 变更 | `CHANGELOG_2026-10-17_Q10.md` |11763|cb05f93bca190f17|
| 本清单 | `README_交付清单.md` | （自指：写清单会改自己） | 以投件回执为准 |

**作废件**：`gen_M2_mix_v26.py` / `gen_M3_drv1_v15.py` / `gen_M3_drv2_v14.py`。

**本轮改了哪四类真残留**（官方唯一抓到的「我画的」）：
① TM1.a×4（M2 nbiasH）：横轨两端外延 0.82 = TOPM1 半宽；
② TM2.a×8（M2 四处 + drv2 四处）：横轨端点外延 1.0 = TOPM2 半宽，drv2 的 x=56 竖条贯通；
③ Slt.c.M1×1（drv2 ntail 轨）：**代码里真开槽**（两条 15.15 + 缝 2.0 + 右端 10µm 桥），
   v1.3 只把方案写进注释、代码仍是一整块；
④ `teeth_label/gen_teeth.py` 的 SRC 由写死 v13 改为 **glob 取最高版**。

**自检台新增两项 + 三颗牙**：
- **⑳ 并集相向平行边最小宽**（T 交类）：口径对着官方 v25 轮逐条坐标校准，
  M2 TOPM1 4 + TOPM2 8 / drv1 0 / drv2 TOPM2 8 = 官方 TM1.a/TM2.a 逐项一致；
  「相向」（材料分落两侧）才算，同侧台阶不算（官方对 drv1 的 vcc 直角拐角不报）；
  形态学开运算那套口径与 deck 不符，只作对照不判。
- **⑯b 无开槽最大宽度（Slt.c.M1）**：M2 0 / drv1 0 / drv2 v14 1、v15 0 = 与官方一致。
- teeth 11 → **14 条全有牙**（新增 ⑳ 的两条 T 交 + 一条 Slt 整块）。

**三件自检**（子进程隔离，结论只认新鲜解释器）：

    gen_M2_mix_v27.py    -> PASS  器件=82 标注=66  ⑯=0 ⑯b=0 ⑰=0 ⑱=0 ⑲=0 ⑳=0
    gen_M3_drv1_v16.py   -> PASS  器件=32 标注=32  ⑯=0 ⑯b=0 ⑰=0 ⑱=0 ⑲=0 ⑳=0
    gen_M3_drv2_v15.py   -> PASS  器件=71 标注=53  ⑯=0 ⑯b=0 ⑰=0 ⑱=0 ⑲=0 ⑳=0
    ⓪ 库版本闸 = lib13g2 v2.2（sha 02ecbfb95b3b…）✓ 与代跑同源
    teeth 14/14 全部有牙 · teeth_label 三坏例 exit=1 + 真件 v16 exit=0

**待裁定（三问）**：
① **drv1 四只 cmim 落不下（要你裁）**：按官方密度 1.5 fF/µm²，Cin 10p → 见方 **81.65µm**
（越出 130×224 的岛）、Ct 0.84p → **23.66µm**（压 vcc 顶层横轨 TOPM1 y∈[200,204]）；
   机制（`b.mim_cap` + 先量后摆 + 面积闸 + 回落）已落地，占位改画 (235,5)，请裁
   改面积规划 / 换电容型号 / 接受大电容；
② **drv2 vcc 馈电桶**：仍钉 1×1（4Ω 串在 ~30mA 馈电上 ≈120mV），你 08:0xZ 只给了平台律没裁桶档位，
   我不擅自改几何；你点头 7×6=42 颗我就改一个数字 + 重跑自检 + 重投；
③ **平台律口径**：你写的 0.84(n−1)+1.26 与你表里的 1×1=1.64 不自洽（1×1 走单孔规则
   cut0.42+2×0.61），请确认哪条为准（决定未实测档能不能外推）。
- **⓪ 库版本闸 = lib13g2 v2.3**（558 行 / 29102B / sha 3ab35cdeb7a31b9e…，08:0xZ 收尾时上游升版）：
  三件实测**并非「零交集」** —— v2.3 给 `Board.via` 加的 vt2 继承会把 M2 5 处 + drv2 6 处
  `t_layer=TopMetal2` 的 TopVia2 端头**静默从 1×1 变 2×2**；三件已按同纪律显式钉
  `vt2=1×1`，几何与 v25 轮（lib v2.2）逐位相同。详见 CHANGELOG §8。

## 七、2026-10-19 现行件速查（**本节才是现行口径**，上面 §一~§六 为 Q11 快照）

> **2026-10-19 00:0xZ 更新（相对组长 23:39Z 读到的 `3340718c` 那版）**：变更三处 ——
> ① 上表**三件现行版本各升一版**（mix v31→**v32**、drv1 v21→**v23**、drv2 v20→**v22**），
>    上表此前**滞后一版**，照它取件会拿到旧件（正是本文件横幅警告的失败模式，本轮修掉）；
> ② 新增交付件 **`gds_probe_b7e7.py`**（最小 GDSII 读取器，见下「工具」条）；
> ③ 新增「三件配套网表」清单与 **drv1 v21→v22→v23 血缘**说明。

> **2026-10-19 00:1xZ 再更新（裁定五十 / 五十一 后）· 变更四点**——
> ① **drv1 新面锚 = `m3_drv1_v21_r1.gds` `62c27a42`**（裁定五十 B 档：新代 cbpath `074d7bea` 装配）；
>    旧锚 `b5b5dce1` **降名 v21-r0 留档不删**。冻结锚仍为 drv1 v20 / drv2 v20 / mix v31（A 档不动）。
> ② **drv1 现行件 v23 已含三处 API 修法**（`_disp_um` / 纯 Python 判点 / `begin_shapes_rec+select_all_cells`），
>    **不必再照抄 `gen_M3_drv1_v22_b7a0adapt.py`**；另修落盘名（v22→v23）与 dbu 取值（`cell.layout().dbu`）。
> ③ **新补 `mix_subckt_LVS输入_v1b.sp`（V31）**：mix v31 面锚此前**无配套 LVS 网表**（v1 停在 V29），
>    律 **F14 面锚的 LVS 配套登记**首例即此。
> ④ 新交付 **`真GDS带条清单_2026-10-19.md`**（31 个 npn 实例、Nx 1/3/6/8/10 全覆盖、半宽残差 0.0000µm）
>    ——§五③「先对表再谈让位」的前置已完成。
>
> **入册律条（组长侧立，我方执行）**：**F13** 面锚须同时登记装配依赖 sha（cbpath/resgeom/emitpath/lib13g2）
> ｜ **F14** 面锚须登记配套 LVS 输入网表，无者显式标「LVS 能力缺件」｜ **F15** 交付件须真 KLayout 跑通
> 才计「已验证」，**作者自检台 ok=true 不构成背书**｜ **F12** 同族不同件禁止类推 ｜ 共享盘文件名禁非 ASCII 标点。

| 模块 | 现行生成脚本 | 设计稿 | 本机自检（2026-10-18 23:2xZ）· **组长独立实跑已坐实（裁定四十八 §二）** |
|---|---|---|---|
| M2 · gilbert_mix 混频器 | **`gen_M2_mix_v32.py`**（无名 M1 簇补标轮 · ㉓ 可判率 19.6→100%） | `M2_mix级版图设计稿_v2.7_2026-10-18.md` | PASS · 器件 82 · 标注 66 · ㉒ 最紧 +1.09µm（12.00 vs 需 10.91＝9.30+0.98+0.63）· ㉓ 硬档 0 / 软档 2 · **组长侧逐位复现 +1.09 ✅** |
| M3-a · drv1 级驱动 | **`gen_M3_drv1_v23.py`**（ptap tie 对心轮 · 2026-10-19）<br>上一轮 `gen_M3_drv1_v22.py`（无名 M1 簇补标轮）<br>⚠ **双面隔离令（裁定四十九）**：v20（`fe2ff903`）＝旧面基准**就地冻结**；新面锚 v21（`b5b5dce1…`，LVS 首次 PASS）。**两面 GDS 不得混用于同一提取链** | `M3_drv级版图设计稿_v1.5_2026-10-17.md` | v21：PASS · 器件 34 · 标注 34 · ㉒ 最紧 +16.17µm（28.00 vs 需 11.83）· ㉓ 硬档 0<br>v20：PASS · ㉒ +16.17µm · **组长侧逐位复现 ✅** |
| M3-b · drv2 级驱动 | **`gen_M3_drv2_v22.py`**（无名 M1 簇补标轮 · ㉓ 可判率 100%） | `M3_drv级版图设计稿_v1.5_2026-10-17.md` | PASS · ㉒ 最紧 +2.94µm（12.00 vs 需 9.06＝7.45+0.98+0.63）· ㉓ 硬档 0 · **组长侧逐位复现 ✅**<br>（不可判候选多：顶层网名标注少） |

> **自检回归结论的效力**：上表三个 ㉒ 数字（+1.09 / +16.17 / +2.94）**不再只是我的单机结论** ——
> 组长在**空目录 `verify/flat_run/`** 独立实跑复现，三件逐位对上、一处不差（裁定四十八 §二.2）。
> 引用这些数字时可直接称「双方独立复现」。

- ⚠ **drv1 v20 / v21 的关系（别取错件）**：v21 只比 v20 多一样东西 ——
  **两只 `ptap1` 接地接触**（XQo 岛 (14,100) / XQr 岛 (42,100)）＋各自的 M1→M4 via_stack、
  M4 立管、gnd 标注，外加顶层 cell 名 `V20 → V21`。**其余几何零改动**
  （自检台 ⑮/㉒/㉓/网名闭合/引脚极性 与 v20 逐位一致）。
  起因＝**裁定二十七 §三 交办①**（drv1 衬底浮空根因：40/0 与 ptap1 实例均为 0）。
  **在飞的 27 角若用 v20 的 GDS 则不含本次接地**；`pex_drv1_v2x.cdl` 需按新 GDS 重提。
  配套网表 `drv1_subckt_LVS输入_v3.sp`（顶层名 V16→V21，正文仅 2 行改动）。
  纪要 `drv1_pwell接地tap回改纪要_v21_2026-10-19.md`。

- **库版本**：lib13g2 **v2.3**，sha `3ab35cdeb7a31b9e9c93197ed1e4750ada743e625953e88cad1e3b65e93b8730`
  （⓪ 库版本闸钉的就是它；组长的 canonical 副本在 8510 `design/sow6/lib13g2.py`）。
- **自检台**：`dryrun/preflight.py`（22 项 + ⓪ 库版本闸 + ㉒ + **㉓**），
  运行法 `python3 design/sow6/dryrun/preflight.py design/sow6/gen_M2_mix_v31.py`。
- **三件配套网表（LVS 对拍用，顶层名必须与版图逐字一致）**：
  `drv1_subckt_LVS输入_v5.sp`（V23）· `drv2_subckt_LVS输入_v6.sp`（V22）·
  `mix_subckt_LVS输入_v2.sp`（V32，配 v32）· **`mix_subckt_LVS输入_v1b.sp`（V31，配 v31 面锚）**。
  四件各**只改 `.subckt`/`.ends` 两行**，
  `lvs_source_audit` 的 `pair()` 拓扑等价断言全 PASS。

- **真 GDS 探针（新 · 2026-10-19）**：`gds_probe_b7e7.py`（开发位 `dryrun/gds_probe.py`）。
  本机无 klayout 时的**真件**证据臂：最小 GDSII 读取器（记录格式三坑记在文件头），
  可解任一真 GDS 的结构/层/实例/图元。已用它第一手复核 `ptap1` 的 PDK 几何，并做出
  **全库 tie 覆盖率审计**（`--tap-ties`）：drv1 v21 = **15.40%（压一角）**，
  drv2 v18/v20 与 mix v27/v31 各 8 只 **全部 100.00%** ⇒ 缺陷只在 drv1。
  ⚠ 发现这批 GDS 的 `UNITS` 记录解出非物理值（7.98e-33 m），真值取 **dbu=0.001µm**，
  已报请核 GDS 写出端。

- **带条清单与真值自证（`gds_probe_b7e7.py --bands`）**：直接读真 GDS，输出每只 npn 的
  C/B 两带世界坐标中心、半宽、E 指底座条数，并**反推 Nx 回验半宽公式** ——
  三件 31 个实例、Nx 1/3/6/8/10 全覆盖、**最大残差 0.0000µm**。成果件
  `真GDS带条清单_2026-10-19.md`（§五③ 对表用）。

- **数值真值唯一入口**：`design/sow6/hbtgeom.py`（3044477b）——
  带半宽表 B=0.925×NX+0.05 / C=0.925×NX（**裁定四十六更正**）；
  间距三值：0.63 自设保守（摆位）/ 0.18 PDK M1.b（适用）/ 0.22 PDK M1.e（长平行段）。
- **平铺交付件一律带 `b7e7` 前缀**（避与 `phys/top/` 下同名通用名串味）：
  `preflight_b7e7.py` / `bandproj_b7e7.py` / `band_measure_b7e7.py` / `pya_b7e7.py` /
  `klayout_db_stub_b7e7.py` / `drcgeom_b7e7.py` / `hbtgeom_dist_b7e7.py` / `gds_probe_b7e7.py` /
  `check_band_formula_b7e7.py`
  （开发位在 `dryrun/`，同名无前缀；`dryrun/hbtgeom.py` 已改名 `dryrun/hbtgeom_dist.py`）。

- ★ **gen 运行期依赖（裁定四十八 §三② 答「甲」）—— 刻意不带前缀，理由与清单**：
  | 文件 | sha256 前 8 | 为什么必须用**裸名** |
  |---|---|---|
  | `resgeom.py` | `d3401a9b` | gen 侧 `import resgeom as RG`，改名即 ImportError |
  | `cbpath.py` | `074d7bea` | gen 侧 `import cbpath as CB`（同上） |
  | `emitpath.py` | `b873a96e` | gen 侧 `import emitpath as EP`（同上） |
  | `lib13g2.py` | `3ab35cde` | gen 侧 `import lib13g2 as L`；且 ⓪ 库版本闸读它 |
  | `hbtgeom.py` | `3044477b` | 数值真值唯一入口 |
  | `spcheck.py` / `netaudit.py` | `8c1c5d61` / `25ce6997` | preflight 按候选表找它们（`netaudit.py` 指纹 2026-10-25 按 8510 现役面现算刷新） |
  **裸名不是疏忽，是 `import` 语义决定的**——加前缀就断了。所以这一组按「取件前先对 sha」纪律走。
  - ⚠ **`cbpath.py` 有版本差，务必按 sha 取**：组长侧现有副本 `25190557`（取自
    `run_v2/gen_v35`）**比本目录的 `074d7bea` 旧一代**，缺**裁定 21.2** 那段
    「触发门同样约束自动退让」的逻辑（线宽 ≤0.15 或平行段 ≤1.0 时**不该退让**）。
    拿旧件跑 drv1 v21 会让 `cb_tie` 多退一次 ⇒ **几何与我自检的逐位结果不同**。
  - ✅ **不再需要 `m1_lib/` 目录**：8510 `/files` 只收 `design/sow6/` 一层（子目录 400），
    目录投不过去。⓪ 闸与 `install_lib13g2` 的候选表已补 **HERE 本层排第一**
    （`preflight_b7e7.py` `_lib_local_cands()`），平铺时 `lib13g2.py` 直接放 sow6/ 即命中。
  - ✅ **自足性已按组长同款判据复验**：空目录 `/tmp/flat2` 只放本清单列出的全部平铺件，
    `python3 preflight_b7e7.py <gen>` 四件（mix v31 / drv1 v21 / drv2 v20 / 缺陷夹具）
    **全 PASS**，且 ㉒ +1.09/+16.17/+2.94、夹具 ㉓ 恰好 2 硬档 −0.125µm 与开发树**逐位一致**。

- ★ **反手抄闸 `check_band_formula_b7e7.py`**（裁定四十八 §三① 的制度化）：
  凡「残差 0」这类**可自证算式**，一律从 `hbtgeom.band_half()` **实算**再写文档，不许手抄。
  该闸扫全部现行件里印着「残差 0」的行，系数与实算不符即 FAIL（历史快照按归档事实豁免，
  豁免名单在脚本里明写可审计）。已做断链测试：系数改回 0.975 → 当场 FAIL；
  篡改真值表斜率 → 残差闸与手抄闸双响。
  ⚠ **它顺带查出一条我自己没注意的事**：「五档残差 0」是对**实测三位小数**（1.95/5.65/11.20/
  14.90/18.60 ÷2）说的；表内存的是**两位小数**，故 `NX=1/3` 两档的 `表 − 式` = **+0.005µm**
  （半 LSB，四舍五入痕迹），NX=6/8/10 三档精确为 0。故闸的判据写成「残差 ≤ 半 LSB」
  而非「残差 = 0」——写死 0 会把正确的表判成坏的。

- **认件纪律（裁定四十八 §四）**：**一律按名 GET ＋ sha 对账，绝不据 `list=1` 目录列表判「件在不在」**
  ——8510 的目录面可能是陈旧快照（23:29Z 实测：listing 只返 16 个 SOW-2 时代根文件，
  而 `hbtgeom.py`/`gen_M2_mix_v31`/`lib13g2.py` 按名 GET 均 200 且 sha 正确）。
  **铃同理：铃 ≠ 新版本，同名覆盖会再触铃。**
  平铺副本自带全部运行期依赖，**已独立目录实跑验证**（`/tmp/flat_test` → PASS）。
- **缺陷夹具（非现行件，勿代跑）**：`mix_defect23_rfrail_15p6.py`（c3c535fb）——
  给第 ㉓ 项做有牙验证用：rfop/rfon 竖轨 ∓16.2 → ∓15.6，落进 XQ3/XQ4 的 B 带投影
  ⇒ ㉓ 报 2 条硬档（净距 −0.125µm < 适用 M1.b 0.18），其余 22 项全绿。
  **文件名刻意不带 `gen_` 前缀**，以免混进「gen_*.py 就是全部现行交付件」那条不变量。

---

## 2026-10-19 · 无名 M1 簇补标（㉓ 可判率 → 100%，三件现行 gen 升版）

**背景**：㉓ 项（带金属 × 顶层自画 M1）靠「M1 连通簇上有无网名标注」判同网/异网，
而器件引脚焊盘所在簇历来无名 ⇒ drv2 可判率仅 19.6%（不可判 180/224）、drv1 59.1%、
mix 73.2%。本次给这些簇补标注（**纯网名文本，金属几何零改动**），三件全部 → 100%，
异网对全部 ≥ 自设保守项 ⇒ **零硬档**（mix 原有 2 条软档不变）。详见
`无名M1簇补标纪要_可判率100_2026-10-19.md`（文件名去圈号：8510 对带 ㉓ 的名返 400）。

### 现行 gen 升版（**取代** v20 / v21 / v31 作为自检对象）

| 新件（现行） | 取代 | 补标数 | 顶层 cell | sha |
|---|---|---|---|---|
| `gen_M3_drv2_v22.py` | `gen_M3_drv2_v20.py` | 28 | `TX5G_M3_DRV2_V22` | `025c2374` |
| `gen_M3_drv1_v22.py` | `gen_M3_drv1_v21.py` | 14 | `TX5G_M3_DRV1_V22` | `1e32e3d5` |
| `gen_M2_mix_v32.py` | `gen_M2_mix_v31.py` | 20 | `TX5G_M2_MIX_V32` | `cf720341` |

- 旧件**不删**（历史快照，仍可回跑对账）；但「现行交付件」= 上表三件 + 配套三网表。
- 配套 LVS 输入网表（各自只改 `.subckt`/`.ends` 两行）：
  `drv1_subckt_LVS输入_v4.sp`（V21→V22，`f5494bf8`）·
  `drv2_subckt_LVS输入_v6.sp`（V20→V22，`add42e6a`）·
  `mix_subckt_LVS输入_v2.sp`（V29→V32，`df894662`）。
  ⚠ mix 网表此前停在 V29（版图 v30/v31 已升名）⇒ 本次顺手接上；**若你那边 V30/V31 的
  cell 名另有安排，请回件重出**。
- 自检：`check_layout_gen` 三件 **ok=true / issues=[]**（⓪ 库闸对齐、网名闭合
  19/19 · 13/13 · 29/29、幽灵名 0、漏标 0）；`preflight_b7e7.py` 三件 PASS，
  且 **零短路嫌疑 / 零悬空标注 / 零同名分裂 / 零异网横穿 / 零穿顶**；
  `lvs_source_audit` 三网表形态 ok + `pair()` 拓扑等价 PASS；`check_netlist_dc` ok。

### 新增三件工具（只读 / 可证伪，不参与版图生成）

- `probe_nameless_m1_b7e7.py`（平铺名；开发位 `dryrun/probe_nameless_m1.py`）：
  **无名 M1 簇普查**。逐簇给 bbox / 成员数 / 已有网名 / 簇内引脚与 NET_DECL 声明网，
  分 `named / addable（可机械补，唯一解）/ multi（一簇多网＝疑似真短路）/ dead`，
  并模拟补标后的 ㉓ 可判率。本次三件的 `multi` 全为 **0**。
- `dump_shapes_b7e7.py`：真跑两版 gen，**逐条比 drawing 矩形** ⇒ 证明
  「金属几何零改动」的通用件差分器（文本单列，因为补标就是新增 text）。已做断链测试。
- `build_label_versions_b7e7.py`：三件补标版的生成器（新版＝旧版逐字不动 + 补标表 +
  cell 名/落盘名升版），**可重复构建、sha 恒定**。
- 三件均按**内容**定位 sow6 根（本层 → 上一层 → 上层 `dryrun/`），平铺自足已实跑。

### 本次新增的不变量

> **「金属几何零改动」这句话不许手写** —— 要有 `dump_shapes --cmp` 的 PASS 兜底；
> 补标/改名这类纯标注轮，交付前必须跑一次比对器，并做一次断链测试证明它会 FAIL。
