oppry12102/WIFI7-TX/06_layout_design_notes/真GDS带条清单_2026-10-19.md

# 真 GDS 带条清单（第一手实测 · 裁定五十一 §六-3 交办项）

b7e7 · 2026-10-19。生成件：`gds_probe_b7e7.py --bands`（本机最小 GDSII 读取器，直接读真 GDS，
不经我的仿真层 ⇒ 是**第一手事实**，不是「我建模出来的」）。

## 口径（先看这段，免得对错口径）

1. **只报图上有什么，不猜哪条是 C 哪条是 B 的电学归属**：判据是几何——
   同一器件内两条**矮而长**（h<1.0µm）的 M1(8/0) 长条即带金属；
   **窄者记 C（半宽 0.925×Nx）、宽者记 B（半宽 0.925×Nx+0.05）**，与 `hbtgeom.py` 唯一入口的表一致。
2. `Nx` **反推**而非声明：两条带**同时**解 Nx（C: 半宽/0.925；B: (半宽−0.05)/0.925）取一致者，
   所以这张表同时是 **hbtgeom 半宽公式的真 GDS 自证**。
3. **E 指底座条数** = 同器件内 h>1.0µm 的 M1 小块数（每只指一条），与 Nx 对照用。
4. 坐标世界系、单位 µm；dbu 取 **0.001**（这批 GDS 的 UNITS 记录解出非物理值 7.98e-33m，见 gds_probe 头注）。
5. 变体名（`npn13G2` / `$1` / `$2` / `$3`）只表示**同一 PCell 的不同 Nx 变体**，不是器件名；
   器件名要看层 63/0 的标注或回我的 gen 台账。

## 三件汇总（残差 = 实测半宽 − 公式值）

### M3-a · drv1（v21 面锚）（`m3_drv1_v21.gds`，4 个 npn 实例）

| 变体 | 原点 | Nx | C 带中心 | C 半宽 | 残差 | B 带中心 | B 半宽 | 残差 | E 底座 |
|---|---|---|---|---|---|---|---|---|---|
| npn13G2 | (-18.625, 150.000) | 6 | (-14.000, 151.240) | 5.550 | -0.0000 | (-14.000, 148.860) | 5.600 | -0.0000 | 6 |
| npn13G2 | (18.625, 150.000) | 6 | (23.250, 151.240) | 5.550 | -0.0000 | (23.250, 148.860) | 5.600 | -0.0000 | 6 |
| npn13G2$1 | (-6.475, 108.000) | 8 | (-0.000, 109.240) | 7.400 | +0.0000 | (0.000, 106.860) | 7.450 | +0.0000 | 8 |
| npn13G2$2 | (34.000, 108.000) | 1 | (34.000, 109.130) | 0.925 | +0.0000 | (34.000, 106.860) | 0.975 | -0.0000 | 1 |

### M3-b · drv2（v20 冻结锚）（`m3_drv2_v20.gds`，12 个 npn 实例）

| 变体 | 原点 | Nx | C 带中心 | C 半宽 | 残差 | B 带中心 | B 半宽 | 残差 | E 底座 |
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
本轮自检 ㉒/㉓ 用的就是这张表。

## 给组长对表用（§五③ 的前置已完成）

请按**坐标逐条**比对你侧的 43/3/38 计数：上面每一行都给了 C/B 两带的世界坐标中心与半宽、
以及 E 指底座条数。若你的多边形口径把某些条合并/拆分（例如把 E 指底座并入带统计），
差异应能由**口径**解释，而不是几何不同 —— 那正是「先对表，再谈让位」要的东西。
**我不动几何**：竖轨 ∓16.2 保持（裁定五十一 §五③ 已确认不改），让位等对完表另立项。
