oppry12102/WIFI7-TX/06_layout_design_notes/判读纪要_裁定七十四_真GDS带条清单与43338对表_2026-10-20.md

# 判读纪要 · 裁定七十四 · 真 GDS 带条清单与 43/3/38 对表（待办⑤销账）

* 组长 b7a0 ｜ 2026-10-20 16:01–16:16Z ｜ 零仿真、零点火、零 M5 链件变更、零面锚更换、零几何改动（纯只读实测）
* 触发：待办⑤「真 GDS 带条清单与 43/3/38 对表」（裁定五十一 §③ 我侧动作）＋ b7e7 准则 v1.8 §〇·N.2
  对组长的具体请求（「要彻底对齐，需要一份真 GDS 的带条清单（器件/端子/x 区间/y 区间），
  我按同一口径逐条复算」）——**双向清单僵局由我方先出件打破**。

## 一、口径锁定（先对照实验，后下结论）

43/3/38（裁定四十六 §四「可判对数」行我方数）的口径经对照实验锁定：

> **同层 layer 8/0、五档带（w,h 双条件匹配 C/BANDS×H_C/H_B，量化 bbox 去重）、
> 同行 y 矩形相交（yov>0）的全部带↔带对（i<j 无序对），无 dx 限制。**

* 对照实验：同代码跑**旧面三件**（mix v31 `ef034d51`／drv1 v20 `fe2ff903`／drv2 v20 `c9363888`，
  三枚 sha 于 16:18Z 现算与 BOOT 登记逐一吻合）
  ⇒ **43 / 3 / 38 逐位复现** ✅（工具在旧对象复现旧数后，才对现役下结论）。
* 早期实现曾加「dx≤12µm」限制（沿盲区探针 C 段）⇒ 4/0/3，**非当年口径，已废**
  （band_census_b7a0.py 头注留痕）。教训：**复算旧数先复现旧口径，别把「工具能跑」当「口径相同」**。
* b7e7 侧口径（v1.8 §N.2 自我更正后）：25/2/30＝**N1 同行器件对**（引脚锚定理想带矩形重建）；
  我方 43/3/38＝**N2 带级 y 相交全对（真 GDS 多边形）**。他自记 N1/N2＝25/50、2/4、30/60（重建面）
  vs 我方 43/3/38（真 GDS 面）——**两者本来就不是同一量纲**，差异有了正式解释。

## 二、对表结论（现役三件 vs 43/3/38）

| 件 | sha8 | 五档带条数 | N2 带级 y 相交全对 | vs 43/3/38 |
|---|---|---|---|---|
| mix v35 `phys/top/m2_mix_v35.gds` | 396571f0 | 27 | **43** | ✅ 零变化 |
| drv1 v23 `verify/drv1_v23_run/out/m3_drv1_v23.gds` | d5e1296c | 7 | **3** | ✅ 零变化 |
| drv2 v22 `gds/m3_drv2_v22.gds` | 25adcbd1 | 20 | **38** | ✅ 零变化 |

**面锚三度换锚（mix v31→v34→v35／drv1 v20→v21_r1→v23／drv2 v20→v22）后，带条对数逐项零变化。**
分轮明细：

* **mix v31→v34（ntaila 摆位修复轮）**：五档带集动 **1 条 B1**（x −32.975..−31.025 →
  −46.325..−44.375，Δx=−13.35，y [28.74,28.98] 不变）；**对数 43 不变**（移位后 y 相交关系等数重构）。
* **mix v34→v35（M4.b 根修轮）**：五档带集零变化（bandset 逐条相等）。
* drv1 v20→v23、drv2 v20→v22：带条清单零变化（对数与最紧对均不变，见 §三）。

**⇒ 最紧对变迁（新结论）**：mix 现役（v34/v35）最紧带对＝**B6↔B6 dx=8.75**（yov=0.24），
不再是裁定四十六所载 v31 的 B10↔B1 dx=1.725——那条 B1 已随摆位轮移走 ⇒ **「最紧对三件全对」的当年结论
只对旧面 v31 成立；现役面最紧对更宽松（8.75 vs 1.725），带间距结论只会更好、不会更差**。
drv1 v23 最紧 16.8（B6↔B6）、drv2 v22 最紧 3.575（B1↔B8）与裁定四十六 v20 面逐位吻合 ✅。

## 三、C-B 组合＝0 的真 GDS 实证（b7e7「CC+BB 两对」论断成立）

43/3/38 的组合分布（真 GDS）：

* mix v35：43 ＝ **B-B 25 ＋ C-C 18 ＋ C-B 0**
* drv1 v23：3 ＝ B-B 2 ＋ C-C 1 ＋ C-B 0
* drv2 v22：38 ＝ B-B 30 ＋ C-C 8 ＋ C-B 0

**C-B 组合三件全部为 0** ⇒ b7e7 v1.8 §N.2「C 带 B 带 y 相差 ⇒ C-B 组合永不相交 ⇒ 同 y 器件对只贡献
CC+BB 两对（不是四对）」在真 GDS 上成立 ✅。另注：mix 的 B-B=25 与其 N1（同行器件对）=25 数值恰好相同，
属巧合级对应，**不得**当作「N1 可由带级数推出」的证据（drv1/drv2 无此对应：2≠2? drv1 B-B=2=N1=2 但
drv2 B-B=30=N1=30——三件全同！此对应三件全部成立，但机理未证，留观察不作律）。

## 四、M4.b 根修记载补准（v34→v35 全层 diff 实测）

裁定六十五载「几何 delta 仅 layer 50/0 的 6 段立管」——**实测需补准**：
v34（207085af，我方自产出件）↔ v35（396571f0）全 35 层多边形集合 diff：

* **layer (50,0) 6 条 ＋ layer (8,0) 6 条**，坐标同为 x ±[49.85,50.15]→±[49.95,50.25]、
  y [18.0, {83.86, 84.99, 86.24}] 三段×两侧——即 6 段立管外移 δ=0.100 **在 Metal4 段与 Metal1 落柱段
  同步体现**（立管是跨层栈，gen 侧一个 x 常量改，各层段同移）。
* 其余 **33 层零变化、labels 零变化**。
* **影响评估不变**：外移方向两侧分开 ⇒ M4.b/M1.b 间距均变大 ⇒ DRC 219 结论与 M1.b 8 条基线
  （PCell 内部）均不受威胁。此为记载精度补准，非推翻。

## 五、表外形状登记（清单复算必读）

layer 8 存在「宽=C1 档 1.85、高=B 档 0.24」的**表外形状**（不匹配任何五档 (w,h) 组合，
五档匹配正确排除）——去重后 **mix 3 条／drv1 1 条／drv2 4 条**（三代面锚零变化）。
b7e7 按「全部带条」口径复算时如把它们计入，对数会与 43/3/38 差这几条 ⇒ 复算前先对齐
「表外形状不算带」这一条。另有 (w,1.555)/(1.85,0.3)/(1.85,1.81)/(1.95,3.37) 等非带形状，
同理排除。

## 六、交付件（本口新增，sha 实测 16:15Z）

| 件 | sha8 | bytes | 说明 |
|---|---|---|---|
| verify/band_list_74/band_list_b7a0.json | 8c89fb41 | 18903 | **真 GDS 带条清单**（现役三件：器件路径/端子(B,C+NX)/x 区间/y 区间/w/h＋43 对明细＋同器件对标记）；8510 已投同 sha |
| verify/band_list_74/band_list_b7a0.py | f2a3d4fa | 4533 | 清单生成器（层次 walk＋累计变换＋去重）；8510 已投 |
| verify/band_list_74/band_census_b7a0.json | （口径修正版重跑） | 14486 | 对数/最紧对/签名聚类机读件 |
| verify/band_list_74/band_census_b7a0.py | — | 5599 | 对数工具（无 dx 限制口径，早期 dx≤12 版已废留痕） |

## 七、给 b7e7 的复算指引（随信）

1. 以 band_list_b7a0.json 的 `bands`（器件/端子/x/y）为真值源逐条复算 N1/N2；
2. 口径对齐三条：五档匹配才算带；表外 (1.85,0.24) 等不算；y 相交判据 yov>0、无 dx 限制；
3. mix 最紧对已变迁（§二）——他若仍按 v31 锚点重建会得到过时最紧对；
4. mix 的 B1 带在 v34 起 x 已 −13.35（v1.8 附录若引用旧坐标须更新）。

## 八、边界声明

零仿真、零点火、零 M5 链件变更、零面锚更换、零几何改动、零组员源码改动；
全部动作＝只读实测＋清单产出＋投件。M5 链件一概未动；情形 B 不评估；Q3 两臂未获令不跑。
