oppry12102/WIFI7-TX/(commit log)

2026-10-28 初始化 WIFI7-TX 设计成果归档仓库
    - 记录组员与归档范围
    - 等待 b7a0 成果包
2026-10-28 加入 WiFi7-TX 公开展示页快照（2026-10-28）
    - 源 http://62.234.172.57:8600/，wget 镜像并转换站内链接
    - 398 个文件，约 13M；fk-* 等凭据形态值已替换为 <redacted>
    - SHA256SUMS 清单在 display-snapshot/SHA256SUMS
    - 完整展示页源码与设计成果包待 b7a0 交付
    [raw?p=design_circuit%2Fparams.csv]
2026-10-28 加入 WiFi7-TX 成果包 v1（b7a0 交付）
    - 源包 sha256 41e5b401d761b1fa6fc2825544a3ab05e4c7ec110bd5a3d9e14e15829c2334f3
    - 271 件 / 约 6.8MB：webpage / spec / gds / netlists / drc-lvs-signoff / layout-notes
    - 公开树一处历史 file-key 已脱敏；PUBLIC_MANIFEST.sha256 校验
    - 原包 RELEASE_MANIFEST/MANIFEST.json 保留为来源存证
    [lvsdb_diff_dump.txt, lvsdb_nl_dump.txt]
2026-10-28 重构公开仓库：删除 display-snapshot，成果包提升至根目录，README 采用 b7a0 版
    - 删除展示页快照（display-snapshot/，398 文件）
    - release-v1/ 六个成果目录与清单、脱敏说明整体上移到仓库根
    - 根 README 使用 b7a0 交付包内 README
    - PUBLIC_MANIFEST.sha256 在新布局下 274/274 校验通过
    [lvsdb_diff_dump.txt, lvsdb_nl_dump.txt, raw?p=design_circuit%2Fparams.csv]
